wongben2333-crypto/26Embedded/README.md

# 基于 FPGA 的实时多音色合成电子乐器引擎「芯弦和鸣」

> **2026 全国大学生嵌入式芯片与系统设计竞赛 · FPGA 创新设计赛道 · 高云半导体 · 选题二**  
> **目标器件**：高云 Arora-V `GW5AST-LV138PG484AC1/I0`（`GW5AST-138C`，Sipeed Tang Mega 138K Dock）  
> **交付位流**：`MODE=3` 整机模式 · 50 MHz 单时钟域 · 纯 HDL · 无 CPU/PCM

> **当前口径（v8.2，2026-11-04）**：138K / MODE=3；TDM32 32×6=192 路（48 路仅对比基线）；钢琴/吉他/小提琴 3 音色；13 键硅胶轻触 + 6 光电 + 双 ToF + 7 寸触控；4 路 EC11 预留；PCB1 输入调理与隔离；整机 2 ms、芯片内部 ≤20.5 µs、TDM32 流水 3.85 µs；4 首公有领域曲目；32 峰必备、192 路由 RTL 状态阵列证明。

---

## 1. 项目概述

本项目的目标是在单颗高云 Arora-V 138K FPGA 上，用纯 HDL 构建一套**不依赖 CPU、不播放预录 PCM** 的实时多音色电子乐器。系统把 13 键硅胶轻触键盘、6 路光电拨弦、双路 ToF 手势与 7 寸电容触控接入统一单拍事件总线，由 **TDM32 引擎**在 97,656.25 Hz 采样网格上逐样本合成 **32 声部 × 6 泛音 = 192 路独立振荡器**，再经 8 模块硬件效果链与 PT8211 I2S DAC 输出。整机物理输入到模拟输出实测 **2 ms**，芯片内部 note event 到数字首样本上界 **20.5 µs**，TDM32 流水内部 **3.85 µs**。

全并行 8 声部 × 6 泛音 = 48 路引擎已验证并保留为低延迟对比基线；为达到 32 复音 192 路，交付位流采用 512 拍周期内 192 拍微时隙的 TDM32 架构：单套 DSP 与 BSRAM 状态表分时服务 32 个声部，避免宽加法树与高扇出分配器带来的布线瓶颈。音色统一为**钢琴 / 吉他 / 小提琴** 3 种，均由真实乐器录音频域反演得到泛音权重与琴体共振参数，在零音频样本 ROM 的前提下完成参数化重构。

---

## 2. 主要特性

- **192 路独立振荡器**：32 声部 × 6 泛音，每路独立 32 位相位累加器、独立频率字、独立 Q32 包络。
- **3 种音色**：钢琴、吉他、小提琴；42 行核心泛音表（TDM32 展开 120 行）+ 非谐性拉伸 + 琴体共振 + 击弦/拨弦瞬态。
- **超低确定性延迟**：整机 2 ms；芯片内部 512 相位全枚举上界 20.5 µs；TDM32 流水 3.85 µs。
- **8 模块硬件效果链**：4 路并联梳状 + 2 级全通 Freeverb、LFO 合唱、环形回声、过载/箱体模拟、双斜率软膝削波。
- **7 寸 800×480 仪器 UI**：3.0 秒双缓冲示波器、32 通道硬件 FFT、X-Y 李萨如、四页触控界面、虚拟琴键演奏。
- **必备取证模式**：`MODE=2` 输出 200 Hz～6,400 Hz 共 32 路等间隔独立谱峰；192 路由 RTL 状态阵列（`mem_ph` / `mem_inc` / `mem_env`）证明。
- **自研物理交互**：13 键硅胶轻触按钮 + 6 路 12V 光电 + 双路 ToF（A 主用/B 热备）+ 7 寸电容触控；4 路 EC11 仅预留，音量由触屏/上位机 CC7 控制。
- **纯硬件合规**：音频链路全部由 FPGA 逐样本生成；无软核/硬核 CPU 参与合成；无预录 PCM、无整段录音触发。

---

## 3. 系统架构

```text
13 键硅胶轻触 ─┐
6 路光电拨弦   ─┤
双路 ToF A/B   ─┼─► 单拍事件总线 ─► 一热声部分配（0 clk）
7 寸电容触控   ─┤                         │
UART / MIDI    ─┤                         ▼
Song ROM（4 首）┘              TDM32：32 声部 × 6 泛音 = 192 振荡器
                                          │
                         8 模块硬件效果链（Freeverb / Chorus / Echo / Cab）
                                          │
                           PT8211 I2S @ 97,656.25 Hz → 耳机 / 2×3W 功放
                                          │
                           7 寸 800×480 UI（示波 / FFT / 李萨如 / 曲目）
```

- 全芯片单一 50 MHz 同步时钟；`sample_tick = 50 MHz ÷ 512 = 97,656.25 Hz`。
- 音符事件采用单拍脉冲 + 数据保持，无 ACK 握手；装载状态机固定 14 拍。
- 模式切换采用“三道清音”：128 拍全关扫描 + `reset_all` 单拍清零 + 488 样本（5 ms）静音窗；防爆音位于 RTL 与 Dock 板载 `PA_EN`，不在自制 PCB 上实现。

---

## 4. 关键指标

| 项目 | 当前值 | 说明 / 证据 |
|---|---|---|
| 复音与振荡器 | **32 声部 × 6 泛音 = 192 路** | 对比基线 48 路；`piano_engine_tdm32.v` |
| 实际采样率 | **97,656.25 Hz** | 50 MHz ÷ 512；PT8211 I2S |
| 整机延迟 | **2 ms**（物理输入→模拟输出） | 示波器实测；含 1.31 ms 数字消抖 |
| 芯片内部延迟 | **≤20.5 µs** | 48 路对比基线 512 相位全枚举 |
| TDM32 流水 | **3.85 µs** | 192～195 clk 扫描/输出 |
| 音高精度 | A4 实测 **440.008 Hz**，-0.29 音分 | 16,384 点 FFT + 抛物线插值 |
| 硬件效果器 | 8 模块 | 4 梳状 + 2 全通 Freeverb、合唱、回声、箱体、软削波 |
| 仪器 UI | 7 寸 800×480 | 示波器 / 32 通道 FFT / 李萨如 / 曲目 |
| 核心资源（MODE=1 终版） | 31,728 LUT / 70 BSRAM / 104.5 DSP | 0 Setup / 0 Hold；WNS **+0.040 ns** |
| 整机资源（MODE=3） | 41,200 LUT / 125 BSRAM / 124.5 DSP | 综合/布局报告；最终 `.tr` 待归档 |
| 代码规模 | 45 个 RTL/头文件、23,012 行 | 含 UI 字库与歌曲头文件 |
| 验证规模 | 10 份 STA 报告、31 套仿真测试台 | 含 200 万例分配器等价性、10,242 点流水线比对 |
| 32 谱峰取证 | 数字域 32/32、0 杂散；真板 32/32 | `MODE=2` 位流 + 外部 FFT/声卡复核 |
| 交付曲目 | 4 首公有领域 | 欢乐颂 / 小星星 / 铃儿响叮当 / 致爱丽丝 |

> 延迟三层口径：**整机 2 ms** 用于赛题 ≤5 ms 判定；**20.5 µs** 为芯片内部数字域上界；**3.85 µs** 为 TDM32 流水内部，不作为整机总延迟。

---

## 5. 硬件方案

- **FPGA 平台**：Sipeed Tang Mega 138K Dock（`GW5AST-138C`）；音频沿用 Dock 板载 PT8211 与 3.5 mm/2×3W 输出，不在自制板上重复设计 DAC/重构滤波。
- **PCB1 输入调理与隔离板**（100×70×1.6 mm，2 层 FR-4）：
  - 13 键：220 Ω 串联 + 100 nF 对地 + FPGA 内部上拉；TS-1117 四脚轻触开关 + 硅胶键帽。
  - 6 路光电：12V 侧 1.2 kΩ 限流，副边 10 kΩ 上拉、220 Ω/100 nF，PC817 5 kVrms 隔离。
  - 双路 ToF：两条独立 I2C（A: A18/D15；B: F14/F13），4.7 kΩ 上拉 + 330 Ω 串联 + 100 µF/100 nF 本地储能。
  - 4 路 EC11：100 Ω / 10 kΩ / 100 nF，**预留**，本版不使用。
  - 电源与地：H3 3.3V 输入 + F1 0.5A PTC；GND12/GND 1.5 mm 隔离，R15 0 Ω 单点桥接。
- **机械结构**：两件式 PETG FDM 外壳；13 键双 Ø2.2 mm 导柱键床（白键 10.50 mm、中心距 11.50 mm）；双路 ToF 两段式导光筒（分件面 Z=22.124 mm、模块顶面以上净深 18.5 mm）。
- **7 寸屏**：ATK-MD0700 800×480，SSD1963 16-bit 8080 + GT911/FT5206 自适应触控；经 **34P FPC→J14 40P 排线**接入，不使用 P34-P40 转接板与 piano6 PCB。

---

## 6. 仓库结构

```text
26Embedded/
│
├── rtl/                         # 纯硬件 Verilog-2001 源码
│   ├── synth/                   # TDM32 192 路、DDS、ADSR、混音、song_rom
│   ├── ui/                      # 7 寸 SSD1963/GT911、FFT、李萨如、四页 UI
│   ├── audio/                   # PT8211 I2S 发送器
│   ├── io/                      # 13 键/6 光电/双 ToF/EC11、MIDI
│   └── effects/                 # Freeverb / Chorus / Echo / Cab / 软削波
│
├── constraints/                 # lcd_test_j14.cst/.sdc
├── bitstream/                   # lcd_test_j14.fs 交付位流
│
├── docs/
│   ├── technical_report/        # 技术文档_v8.2.docx/pdf、作品简介、图表说明
│   ├── evidence/                # 32 谱峰取证、样点、终端日志、2 ms 延迟截图
│   └── figures/                 # 14 张报告图表（仿真/实屏/终端截图）
│
├── hardware/
│   ├── pcb/                     # PCB1 Gerber/BOM/SCH
│   ├── adapter_board/           # 历史 P34-P40 屏幕转接板（归档，整机不使用）
│   └── enclosure/               # 两件式外壳 STEP/ZIP
│
├── tools/                       # 构建、烧录、截图、监测、32 峰校验
├── build_j14.py                 # 一键综合与布局布线
├── burn_lcd_j14.py              # SRAM 调试烧录
├── flash_lcd_j14.py             # SPI Flash 固化烧录
├── lcd_test_j14.gprj            # 高云 EDA 工程
└── README.md
```

---

## 7. 快速开始

### 7.1 环境

- 高云 **Gowin EDA V1.9.12.04**（含 `gw_sh.exe` 与 `programmer_cli.exe`）
- Python 3.8+（构建、烧录与取证脚本）
- Tang Mega 138K Dock + 自研 PCB1 + 7 寸屏 + 13 键/6 光电/双 ToF 外设

### 7.2 编译与烧录

```powershell
# 在仓库根目录
python build_j14.py
python burn_lcd_j14.py      # SRAM 调试
python flash_lcd_j14.py     # SPI Flash 固化
```

### 7.3 上位机

当前精简交付树不包含上位机源码；上位机为独立调试工具，串口参数为 `115200 bps，8N1`，只下发音符/CC 报文，不参与音频合成。板载 13 键/6 光电/双 ToF/触控可脱离上位机独立演奏。

### 7.4 运行模式

| 模式 | 用途 | 说明 |
|---|---|---|
| `MODE=3` | **整机交付** | TDM32 192 路 + 8 模块效果器 + 7 寸 UI + 13 键/6 光电/双 ToF |
| `MODE=1` | PC 控制/回归 | 48 路全并行对比基线 + UART/MIDI |
| `MODE=2` | 32 谱峰取证 | `tone_bank` + `adsr`，200 Hz～6,400 Hz 等间隔 32 峰 |
| `MODE=0` | 脱机放歌 | 4 首公有领域曲目自动播放 |

### 7.5 谱峰取证

```powershell
python tools/verify/check_peaks.py --file docs/evidence/tone_samples_snap.txt --format samples --fs 97656.25 --count 32 --start 200 --step 200
```

---

## 8. 验证与证据

- **32 谱峰**：`MODE=2` 数字样本 32/32 命中、0 杂散；真板录音 32/32 命中，并完成 PT8211 ZOH 镜像与 48 kHz 声卡混叠机理拆解。
- **确定性延迟**：48 路对比基线 512 相位全枚举，Min 516 clk / P50 772 clk / P99 1,021 clk / Max 1,027 clk；整机 2 ms 示波器实测，终端取证见 `docs/evidence/延迟测试_2ms端到端.png`。
- **时序收敛**：10 份归档 `.tr/.rpt`；MODE=1 核心终版 0 Setup / 0 Hold，WNS +0.040 ns；pipeline 构建 +0.186 ns。
- **形式化/回归**：200 万例一热分配器等价性；10,242 点输出级流水线逐值比对；31 套测试台。
- **证据位置**：`docs/evidence/`、`docs/figures/`、`docs/technical_report/技术文档图表与实验数据说明.md`。

---

## 9. 文档索引

| 文档 | 内容 |
|---|---|
| [`docs/technical_report/技术文档_v8.2.docx`](docs/technical_report/技术文档_v8.2.docx) | **交付版技术文档（v8.2，62 页，模板对齐与统一排版）** |
| [`docs/technical_report/技术文档_v8.2.pdf`](docs/technical_report/技术文档_v8.2.pdf) | 同版 PDF 校对稿 |
| [`docs/technical_report/作品简介.md`](docs/technical_report/作品简介.md) | 作品简介与答辩口径 |
| [`docs/technical_report/技术文档图表与实验数据说明.md`](docs/technical_report/技术文档图表与实验数据说明.md) | 图表、延迟分解与谱峰数据说明 |
| [`docs/evidence/32谱峰-取证报告.md`](docs/evidence/32谱峰-取证报告.md) | 32 峰取证方法与历史数据 |
| [`docs/evidence/实测终端数据日志.txt`](docs/evidence/实测终端数据日志.txt) | 实测终端日志 |
| [`docs/evidence/延迟测试_2ms端到端.png`](docs/evidence/延迟测试_2ms端到端.png) | 2 ms 端到端延迟终端取证 |
| [`hardware/pcb/`](hardware/pcb/) | PCB1 Gerber、BOM、原理图 |
| [`hardware/enclosure/`](hardware/enclosure/) | 两件式外壳 STEP/ZIP |
| [`bitstream/lcd_test_j14.fs`](bitstream/lcd_test_j14.fs) | 交付位流 |

> `docs/technical_report/技术文档_v8.docx` 为上一版历史稿；提交以 `技术文档_v8.2.docx` 为准。历史文档中的旧曲目/旧口径仅作记录，不得进入提交物。

---

## 10. 当前状态与已知缺口

- **文档与整机口径**：已收口到 v8.2；主文档、硬件文档与历史稿标记均已同步。
- **待补证据**：整机 2 ms 已有终端截图/日志；示波器 CSV 可按需补充；MODE=3 最终 `.fs` 的 SHA256/User Code 与 `.rpt/.tr` 待归档。
- **源码待清理**：`rtl/synth/song_rom.v` 仍含旧版第 0 首未授权曲目；文档已按 4 首公有领域口径编写，需删除并重生成/重编译。
- **192 峰测试**：当前以 32 峰作为赛题必备取证，192 路由 RTL 状态阵列证明；如需把评分乘数从 32 提升到 192，可后续补 192 峰测试位流。
- **目录页码**：v8.2 的 TOC 已重建并更新页码；修改内容后按 `Ctrl+A` → `F9` 更新域。

---

## 11. 合规与版权

- **纯硬件实时合成**：完整音频通路由 FPGA HDL 逐样本实现，无 CPU/软核参与合成算法。
- **零预录 PCM**：全工程无音频样本 ROM；`piano_rom.v` 存泛音/波表参数，`song_rom.v` 存音符事件，均不是录音。
- **曲目**：交付版为 4 首公有领域曲目（欢乐颂 / 小星星 / 铃儿响叮当 / 致爱丽丝）；频谱标定用参考录音仅离线分析，未写入 RTL。
- **第三方**：Gowin EDA、Sipeed Tang Mega、PT8211、ATK-MD0700、GT911/FT5206、VB22B、E3F-20C1、PC817 等器件与工具链版权归各自厂商所有。
