wongben2333-crypto/26Embedded/fpga_hank/README.md

> **当前口径（v8.1，2026-11-04，适用于本仓库全部说明文档）**：目标板 138K，交付位流 MODE=3；合成引擎 TDM32 32 声部×6 泛音=192 路（48 路全并行仅作对比基线）；音色统一为钢琴/吉他/小提琴 3 种（对外只列这三种）；交互为 13 键硅胶轻触按钮 + 6 路光电 + 双路 ToF（A 主用/B 热备）+ 7 寸触控，4 路 EC11 仅预留；PCB1 为“输入调理与隔离转接板”（上拉/限流/RC/PC817 光耦/ToF 双总线供电/地分割），防爆音在 RTL 三道清音 + PA_EN，不在 PCB；整机物理输入→模拟输出实测 2 ms，芯片内部 ≤20.5 µs，TDM32 流水 3.85 µs；7 寸屏经 34P FPC→J14 40P 排线，不再使用 P34-P40 转接板与 piano6 PCB；交付曲目为 4 首公有领域曲目（源码 Song 0 待删）；32 峰为必备取证，192 路由 RTL 状态阵列证明。**与旧描述冲突处，以本块为准。**

# fpga_hank —— 基于 FPGA 的实时多音色合成电子乐器引擎

> **2026 全国大学生嵌入式芯片与系统设计竞赛 · FPGA 创新设计赛道（高云半导体命题）**  
> **选题二：基于 FPGA 的实时多音色合成电子乐器引擎**  
> **硬件平台**：Sipeed Tang Mega 138K Dock ｜ **FPGA 芯片**：`GW5AST-LV138PG484AC1/I0`（Device: `GW5AST-138C`）  
> **显示与触控**：7 英寸 800×480 ATK-MD0700（SSD1963 16-bit 8080 并行总线 + GT911/FT5206 电容多点触控）  
> **音频输出**：板载 PT8211 Dual 16-bit DAC（97.656 kHz 实际采样率，Line-Out + 双通道 3W 功放）  
> **核心指标**：**32 独立复音并发（192 独立硬件振荡器）** · **3.85 µs（TDM32 流水） 纯硬件超低延迟** · **3 种物理乐器音色** · **全套硬件 DSP 效果器**  

---

## 目录
- [0. 赛题要求与指标对账表（官方 PDF 选题二全文）](#0-赛题要求与指标对账表官方-pdf-选题二全文)
- [1. 快速上手指南（3 分钟跑通）](#1-快速上手指南3-分钟跑通)
- [2. 系统整体硬件与 RTL 架构](#2-系统整体硬件与-rtl-架构)
- [3. 权威硬件引脚与接线表](#3-权威硬件引脚与接线表)
- [4. 7 英寸 LCD 仪器级 UI 与电容触控交互](#4-7-英寸-lcd-仪器级-ui-与电容触控交互)
- [5. 电脑端控制软件与通讯协议](#5-电脑端控制软件与通讯协议)
- [6. 音频合成引擎与硬件效果器实现](#6-音频合成引擎与硬件效果器实现)
- [7. 交付文件与工程目录结构](#7-交付文件与工程目录结构)
- [8. 赛题红线与合规性审查指引（给评委）](#8-赛题红线与合规性审查指引给评委)

---

## 0. 赛题要求与指标对账表（官方 PDF 选题二全文）

官方竞赛指南《全国大学生嵌入式芯片与系统设计竞赛'2026 FPGA 创新设计赛道选题指南（高云半导体）》第 15～16 页对「选题二」给出了严谨的规范与评分标准。本项目按当前实测逐项对账如下：

### 0.1 赛题条款与我方实测交付对账表

| 赛题条款 | 赛题官方指标要求 | 我方工程实测交付指标 | 对应实现 RTL 模块 | 证据与报告位置 |
|---|---|---|---|---|
| **基础要求 ①**<br>多维交互控制检测 | 自主设计演奏交互形态，≥2 个独立可控演奏维度，支持选音/触发/拨弦/力度感应，交互灵敏稳定 | **4 维独立交互形态**：13 键硅胶轻触按钮 + 6 路光电 + 双路 ToF（A 主/B 热备）+ 7 寸电容触屏；另含板载按键与上位机 MIDI 作为辅助输入| `rtl/io/touch_ft5206_i2c.v`<br>`rtl/io/midi_rx.v`<br>`rtl/io/hw_input_mgr.v` | `docs/上电操作卡-正式交付.md`<br>`host/piano_gui.py` |
| **基础要求 ②**<br>纯硬件实时音频合成 | 完整音频生成通路全基于 FPGA HDL 硬件逻辑，逐样本逐声部运算；**控制→发声总延迟 ≤10 ms**，杜绝 CPU 串行滞后 | **全流水线硬件实时计算**：整机物理输入→模拟输出实测 2 ms（≤5 ms 赛题要求）；芯片内部最大 20.5 µs；TDM32 流水 3.85 µs；确定性相位量化、无软件抖动| `rtl/synth/piano_engine_tdm32.v`<br>`rtl/synth/hw_latency_profiler.v` | `sim/tb/tb_piano_engine_latency.v`<br>`_research/piano/LATENCY.md` |
| **基础要求 ③**<br>合规实时发声与多复音 | 基础复音 ≥4，逐音逐样本实时生成，支持单音实时变调、ADSR 包络、多声部混音；**严禁播放预录 PCM/推流/录音** | **32 独立复音并发**，每个声部独立 DDS 相位累加器 + 独立 ADSR 状态机 + 独立变调控制 + 32 路硬件混音器；**零预录样本，零 PCM ROM**，经得起代码审查 | `rtl/synth/piano_engine_tdm32.v`<br>`rtl/synth/adsr.v`<br>`rtl/synth/poly32_bank.v` | `sim/tb/tb_alloc32_proof.v`<br>`docs/32复音-验证报告.md` |
| **拓展要求 ①**<br>超高规模并行合成引擎 | 突破基础复音限制，**复音数 ≥32**，或单音加法分量 ≥32 路，最大化发挥 FPGA 并行优势 | **32 声部 × 6 阶泛音加法合成**，共计 **192 个独立硬件振荡器**！实测 32 个音符同时按下持续发声，混音动态范围饱满，无任何削波失真 | `rtl/synth/piano_engine_tdm32.v` | `docs/evidence/32谱峰-取证报告.md`<br>`sim/tb/tb_alloc32_proof.v` |
| **拓展要求 ②**<br>多维表情与效果处理 | ≥3 维表情调控（力度/滑音/颤音）；≥2 种乐器音色自由切换；FPGA 内部实现混响/延迟/合唱效果器 | 1. **表情**：Velocity 动态响应、Portamento 线性滑音、LFO 正弦颤音、Sustain 延音踏板<br>2. **3 种物理乐器音色**：大钢琴、原声吉他、擦弦小提琴<br>3. **全套硬件 DSP 效果器**：Overdrive 过载、4x12 箱体模拟（Biquad IIR）、Chorus 合唱、Echo 延迟、Freeverb 混响 | `rtl/synth/tone_bank.v`<br>`rtl/effects/audio_fx.v`<br>`rtl/effects/guitar_fx.v`<br>`rtl/effects/instrument_body_fx.v` | `sim/tb/tb_effects.v`<br>`docs/音色实现现状与改进路径.md` |
| **拓展要求 ③**<br>低延迟与实时视听反馈 | 演奏延迟 ≤5 ms 确定性无抖动；FPGA 硬件实时生成可视化（LED/李萨如/频谱/波形） | **7 英寸 800×480 仪器大屏 UI**：<br>1. 3.0s 实时示波器（双缓冲硬件捕获）<br>2. 32 通道硬件 FFT 实时频谱仪<br>3. 音频 X-Y 李萨如图形生成器<br>4. 实时 ADSR 包络与立体声 VU 表<br>5. 板载 WS2812 状态指引灯 | `rtl/ui/lcd_subsystem_j14.v`<br>`rtl/ui/spectrum_analyzer32.v`<br>`rtl/ui/lissajous_engine.v`<br>`rtl/ui/ws2812_drv.v` | `docs/real_lcd_live_page0.png`<br>`docs/real_lcd_capture.png` |
| **拓展要求 ④**<br>脱机曲目指引与演奏 | 脱机演奏 LED 曲目指引，辅助演奏节奏；乐曲播放 | 硬件脱机乐曲播放引擎，内置《欢乐颂》《小星星》《铃儿响叮当》《致爱丽丝》4 首公有领域曲目；支持自动演奏、瀑布流谱面同步；演奏指引由 7 寸屏虚拟琴键高亮实现，WS2812 仅状态灯；无蓝牙/App，USB 上位机+屏幕替代| `rtl/synth/song_player.v`<br>`rtl/synth/song_rom.v` | `sim/tb/tb_song_player.v` |
| **核心评分公式** | 分数 ∝ 同时活跃可闻独立振荡器总数 × 实际音频输出采样率 | **32 独立发声声部（192 独立振荡器） × 97 656.25 Hz 实际输出采样率** = **18.75 MHz·振荡器吞吐量**！评分乘数达 1.875×10⁷ osc·Hz | `rtl/synth/piano_engine_tdm32.v`<br>`rtl/audio/pt8211_tx.v` | `docs/PT8211-验证报告.md`<br>`docs/evidence/32谱峰-取证报告.md` |
| **必备交付物** | 测试模式：输出 N 路均匀分布频率，频谱可数出对应数量独立谱峰 | **MODE=2 专职 32 谱峰测试模式**：输出 200 Hz ~ 6400 Hz 均匀间隔 200 Hz 的 32 路纯正弦波，屏幕频谱仪与外部 FFT 均可清晰数出 32 根独立谱峰 | `rtl/synth/bench_gate.v`<br>`sim/tb/tb_spectrum.v` | `docs/evidence/32谱峰-取证报告.md`<br>`skills/fpga-verify/tests/spectrum_32peaks.png` |

---

## 1. 快速上手指南（3 分钟跑通）

### 1.1 环境要求
- **FPGA EDA**：高云 Gowin EDA V1.9.12.04（支持命令行 `gw_sh.exe` 与烧录器 `programmer_cli.exe`）
- **电脑端运行环境**：Python 3.8+（仅需 `pyserial`，用于串口交互与上位机 GUI）

### 1.2 电脑端运行步骤
```powershell
cd fpga_hank

# 1. 安装电脑端运行依赖（仅需 pyserial）
pip install -r host/requirements.txt

# 2. 启动电脑端演奏 GUI（将板卡 USB-DEBUG 连接至电脑）
python host/piano_gui.py
```
- 在界面上方下拉框选择端口（如 `COM9`），波特率默认 `115200`，点击 **「连接」**。
- 可直接用鼠标点击屏幕上的钢琴琴键，或按键盘白键（`A S D F G H J`）与黑键（`W E T Y U`）即时弹奏发声！
- 点击「大钢琴 / 原声吉他 / 擦弦提琴」即时切换音色，点击「旁路 / 延迟 / 合唱 / 混响」即时切换效果器。
- 界面会与 7 寸 LCD 屏实时双向同步（通过 MIDI `CC 28` 换页与 `CC 20` 换音色）。

### 1.3 一键编译与固化位流
```powershell
# 1. 一键命令行综合、布局布线与位流生成
& "F:\Gowin\Gowin_V1.9.12.04_x64\IDE\bin\gw_sh.exe" tools\gowin\build.tcl

# 2. 烧录到 SRAM 运行调试（操作码 2）
powershell -NoProfile -ExecutionPolicy Bypass -File tools\gowin\program.ps1 -Mode sram -Fs out\bitstream\MODE3_freeplay.fs

# 3. 固化到位流 SPI Flash（操作码 68 thru GAO-Bridge，断电不丢失）
powershell -NoProfile -ExecutionPolicy Bypass -File tools\gowin\program.ps1 -Mode flash -Fs out\bitstream\MODE3_freeplay.fs
```

> [!NOTE]
> **SPI Flash 烧录避坑纪律**：Tang Mega 138K Dock 的外部 SPI Flash 挂在 GAO-Bridge 之后，`programmer_cli` 必须使用操作码 68（`exFlash Erase,Program thru GAO-Bridge Arora V`），普通 op 9 会误报 `spi flash not found`。本项目 `program.ps1` 已全自动处理。

---

## 2. 系统整体硬件与 RTL 架构

系统完全遵循赛题关于「纯硬件实时合成」的硬性规定，采用纯 Verilog HDL 实现端到端的流水线计算，架构框图如下：

```
       ┌────────────────────────────────────────────────────────┐
       │                   多维交互控制检测                      │
       ├─────────────────┬───────────────────┬──────────────────┤
       │ GT911/FT5206 电容触控屏 │ 板载用户按键/变调 │ PC MIDI (COM9)   │
       │ (J14 I2C 坐标)   │ (AB13, Y12, D14)  │ (115200 8N1 V14) │
       └────────┬────────┴─────────┬─────────┴────────┬─────────┘
                │                  │                  │
                ▼                  ▼                  ▼
       ┌─────────────────┐ ┌───────────────┐ ┌──────────────────┐
       │ touch_ft5206_i2c│ │ 按键消抖/变调 │ │ uart_rx / midi_rx│
       └────────┬────────┘ └───────┬───────┘ └────────┬─────────┘
                │                  │                  │
                └──────────────────┼──────────────────┘
                                   │
                                   ▼
       ┌────────────────────────────────────────────────────────┐
       │                   hw_input_mgr 输入仲裁器               │
       │       (音符 NoteOn/Off、力度 Velocity、表情 CC 控制)     │
       └───────────────────────────┬────────────────────────────┘
                                   │
       ┌───────────────────────────┴────────────────────────────┐
       │            piano_engine_tdm32 32复音硬件合成引擎         │
       │                                                        │
       │  ┌──────────────────────────────────────────────────┐  │
       │  │ 32路独立声部调度器 (Voice Allocator + Stealing)    │  │
       │  ├──────────────────────────────────────────────────┤  │
       │  │ 192路独立硬件振荡器流水线 (32 声部 × 6 阶谐波加法)│  │
       │  │ · 独立 DDS 相位累加器                             │  │
       │  │ · 独立 ADSR 包络发生器 (Attack/Decay/Sustain/Rel)│  │
       │  │ · 物理乐器共振体谐波波表 (Piano/Guitar/Violin/Erhu)│  │
       │  │ · 硬件微秒级实时滑音 (Portamento) 与 LFO 颤音     │  │
       │  ├──────────────────────────────────────────────────┤  │
       │  │ 32声部动态混音器 (Dynamic Saturation Mixer)      │  │
       │  └──────────────────────────────────────────────────┘  │
       └───────────────────────────┬────────────────────────────┘
                                   │ [15:0] raw_audio (97.656 kHz)
                                   ▼
       ┌────────────────────────────────────────────────────────┐
       │                 硬件数字音频效果器流水线                │
       │                                                        │
       │  ┌──────────────┐   ┌──────────────┐   ┌─────────────┐ │
       │  │ guitar_fx    ├──►│ fx_chorus    ├──►│ audio_fx    │ │
       │  │ (过载+4x12)  │   │ (多重合唱)   │   │ (延迟+混响) │ │
       │  └──────────────┘   └──────────────┘   └─────────────┘ │
       └───────────────────────────┬────────────────────────────┘
                                   │ [15:0] processed_audio
                     ┌─────────────┴─────────────┐
                     ▼                           ▼
       ┌───────────────────────────┐ ┌───────────────────────────┐
       │       pt8211_tx           │ │   lcd_subsystem_j14       │
       │ (Dual 16-bit DAC @97.6kHz)│ │ (800x480 SSD1963 16-bit)  │
       ├───────────────────────────┤ ├───────────────────────────┤
       │ · HP_BCK  (Y17)           │ │ · 3.0s 实时示波器         │
       │ · HP_WS   (AB17)          │ │ · 32 通道硬件 FFT 频谱仪  │
       │ · HP_DIN  (AA16)          │ │ · 音频 X-Y 李萨如图形     │
       │ · PA_EN   (AB16) 低有效使能 │ │ · 实时 ADSR 包络与 VU 表  │
       │ 3.5mm 耳机孔 + 扬声器功放 │ │ · GT911/FT5206 电容触控热区映射  │
       └───────────────────────────┘ └───────────────────────────┘
```

---

## 3. 权威硬件引脚与接线表

本项目全部管脚均在 Gowin 布局布线器中实跑通过并经由硬件真实验证，杜绝任何引脚冲突。

### 3.1 时钟、板载交互与音频 DAC 引脚

| 信号名称 | FPGA 球号 | 物理位置 / 外部连接 | 电平标准 / 特性 | 功能说明 |
|---|---|---|---|---|
| `clk` | **V22** | 板载 50 MHz 有源晶振 | LVCMOS33 | 全局主时钟基准 |
| `led[0]` | **T18** | 板载 LED0 | LVCMOS33，低有效 | 系统运行心跳 / 触屏中断指示 |
| `led[1]` | **R18** | 板载 LED1 | LVCMOS33，低有效 | 演奏发声指示 |
| `led[2]` | **R17** | 板载 LED2 | LVCMOS33，低有效 | 效果器使能指示 |
| `led[3]` | **P16** | 板载 LED3 | LVCMOS33，低有效 | 模式 / 溢出告警指示 |
| `key` | **AB13** | 板载按键 Key_in[0] | LVCMOS33，上拉 | 演示模式：播放 / 暂停 |
| `key2` | **Y12** | 板载按键 Key_in[1] | LVCMOS33，上拉 | 循环切换 3 种物理乐器音色 |
| `key_pitch` | **D14** | PMOD / 外接按键 | LVCMOS33，上拉 | 实时半音变调 |
| `uart_rx_pin` | **V14** | 板载 USB-DEBUG (COM9) | LVCMOS33，中点采样 | PC 串口 MIDI 指令接收（115200 8N1） |
| `dbg_tx` | **U15** | 扩展排针调试串口 | LVCMOS33，DRIVE=8 | 硬件遥测与屏幕截屏输出 |
| `HP_BCK` | **Y17** | 板载 PT8211 DAC | LVCMOS33，DRIVE=8 | I2S 位时钟（fs × 32 = 3.125 MHz） |
| `HP_WS` | **AB17** | 板载 PT8211 DAC | LVCMOS33，DRIVE=8 | I2S 字选时钟（97.656 kHz） |
| `HP_DIN` | **AA16** | 板载 PT8211 DAC | LVCMOS33，DRIVE=8 | I2S 左右声道音频串行数据 |
| `PA_EN` | **AB16** | 板载扬声器功放芯片 | LVCMOS33，DRIVE=8 | 功放静音使能（**必须拉低=0 方可发声**） |
| `ws_dout` | **V19** | 板载 WS2812 接口 | LVCMOS33，DRIVE=8 | WS2812 幻彩流水灯控制线 |

### 3.2 J14 接口 7 英寸 800×480 液晶屏与 GT911/FT5206 电容触屏引脚

| 信号名称 | FPGA 球号 | J14 排针号 | 屏排线对应功能 | 说明 |
|---|---|---|---|---|
| `lcd_cs` | **AB21** | J14-34 | CS 片选 | 8080 并行总线片选（低有效） |
| `lcd_rs` | **R14** | J14-39 | RS / DC 寄存器选择 | 高=数据，低=指令 |
| `lcd_wr` | **AB20** | J14-37 | WR 写使能 | 8080 写入时钟，低有效脉冲 |
| `lcd_rd` | **AB18** | J14-30 | RD 读使能 | 恒拉高=1（纯写显示） |
| `lcd_rst` | **Y18** | J14-32 | RESET 复位 | 硬件上电复位控制（低有效） |
| `lcd_db[15:0]` | 详见 CST | J14 数据总线 | 16 位并行 RGB565 数据 | 双向数据总线 |
| `lcd_dpi_bl` | **P20** | J14-40 | 背光使能 | 接地拉低（禁用板载升压，走自身供电） |
| **`tp_scl`** | **AA18** | **J14-29** | **Screen Pin 34 (CLK)** | **GT911/FT5206 电容触控 I2C SCL 时钟线** |
| **`tp_sda`** | **AA19** | **J14-28** | **Screen Pin 30 (MO)** | **GT911/FT5206 电容触控 I2C SDA 数据线** |
| **`tp_int`** | **Y19** | **J14-31** | **Screen Pin 31 (PEN)** | **GT911/FT5206 触摸中断输入（按下低有效）** |
| **`tp_rst_n`** | **W17** | **J14-9** | **Screen Pin 33 (CS)** | **GT911/FT5206 触屏复位（严禁接 T20/J14-33 专用脚）** |

> [!WARNING]
> **避坑重要经验**：
> 1. J14-33（球号 `T20`）在 Tang Mega 138K 上为内部专用控制脚，如果连接会导致屏幕显示异常闪烁。本项目经硬件验证，触屏复位 `tp_rst_n` 必须分配至 **`W17`（J14-9）**。
> 2. GT911/FT5206 I2C 通讯中，每次读完 6 字节坐标后，**必须向寄存器 `0x814E` 回写 `0x00`**，否则 GT911/FT5206 内部 DSP 缓冲区死锁，导致后续触摸事件无法产生。

---

## 4. 7 英寸 LCD 仪器级 UI 与电容触控交互

系统挂载 7 英寸 800×480 ATK-MD0700 电容触摸液晶大屏，提供专业级数字示波器与音频测量界面：

### 4.1 四大界面分页说明

| 页面号 | 界面名称 | 核心功能与呈现特性 | 切换方式 |
|---|---|---|---|
| **Page 0** | **实时演奏主界面** | · **3.0s 实时双缓冲示波器**：实时呈现音频输出波形<br>· **32 通道硬件 FFT 实时频谱仪**：柱状动态显示各频段功率<br>· **音频 X-Y 李萨如图形**：直观反映左右声道相位关系<br>· **实时 ADSR 包络与立体声 VU 表**：可视化演奏动态与峰值 | 默认启动主页<br>屏幕底部点击 Tab 0<br>发送 MIDI `CC 28 = 0` |
| **Page 1** | **32 复音谱峰测试界面** | · **赛题必备交付物直接呈现**：32 个独立振荡器并发发声<br>· **32 根独立频谱尖峰**：等间隔清晰罗列，评委现场可直接数峰<br>· 动态显示当前同时发声的独立声部数与振荡器总数 | 屏幕底部点击 Tab 1<br>发送 MIDI `CC 28 = 1` |
| **Page 2** | **脱机乐曲播放界面** | · 呈现脱机内置曲目谱面与瀑布流音符滚动<br>· 支持《欢乐颂》《小星星》《铃儿响叮当》《致爱丽丝》4 首公有领域曲目<br>· 配合 7 寸屏虚拟琴键高亮与 WS2812 状态灯 | 屏幕底部点击 Tab 2<br>发送 MIDI `CC 28 = 2` |
| **Page 3** | **声学系统与延迟监控** | · 实时显示箱体冲击响应曲线与 DSP 效果器链状态<br>· **硬件实时延迟监控**：高精度硬件计数器直接显示 **3.85 µs（TDM32 流水）** 确定性硬件响应延迟 | 屏幕底部点击 Tab 3<br>发送 MIDI `CC 28 = 3` |

### 4.2 电容触控热区与坐标校准
- **1:1 绝对坐标校准**：`X = raw_x`, `Y = raw_y`（范围 `0..799`, `0..479`）。
- **底部导航栏**（`Y: 430..479`）：四个 200 像素宽的触控区域，直接点击瞬间切换四大界面。
- **音色快速选择卡**（Page 0 顶部）：直接触摸选中「钢琴 / 吉他 / 小提琴」。
- **触控光标**：屏幕上实时绘制 8×8 亮绿准心指示当前触摸位置。

---

## 5. 电脑端控制软件与通讯协议

电脑端提供基于 Python `tkinter` + `pyserial` 构建的交互式虚拟钢琴软件（`host/piano_gui.py`）。该软件**仅负责 UI 交互与 MIDI 参数下发，不参与任何音频波形合成**，完全符合赛题规定。

### 5.1 串口参数
- **波特率**：`115200 bps`，`8` 位数据位，`1` 停止位，无校验（`8N1`）
- **物理接口**：Tang Mega 138K Dock 板载 USB-DEBUG（FT2232H 通道 B，识别为 `COM9`）

### 5.2 MIDI 协议控制规范

```
NoteOn : 0x90 note vel      (vel > 0 触发发声; vel == 0 视为 NoteOff)
NoteOff: 0x80 note vel      (释放对应音符进入 Release 阶段)
```

| 控制功能 | MIDI 指令 / CC | 取值范围 | 物理作用与映射规则 |
|---|---|---|---|
| **音色切换** | `CC 20` | `0..2` | `0`: 大钢琴 ｜ `1`: 原声吉他 ｜ `2`: 擦弦小提琴 |
| **UI 页面切换** | `CC 28` | `0..3` | `0`: 演奏主页 ｜ `1`: 32谱峰 ｜ `2`: 乐曲播放 ｜ `3`: 声学延迟监控 |
| **效果器旁路** | `CC 21` | `0` 或 `127` | 旁路所有 DSP 效果器，输出干声基底 |
| **合唱使能** | `CC 22` | `0` 或 `127` | 开启多重延迟合唱（Chorus），增强声音厚度 |
| **延迟使能** | `CC 23` | `0` 或 `127` | 开启 350ms 立体声反馈回声（Delay/Echo） |
| **混响使能** | `CC 24` | `0` 或 `127` | 开启 Freeverb 算法硬件混响器（Reverb） |
| **滑音时间** | `CC 5` | `0..127` | Portamento 滑音过渡时间，`t_glide ≈ val × 4 ms` |
| **滑音开关** | `CC 65` | `0..127` | `>=64` 开启滑音模式，`<64` 关闭 |
| **颤音深度** | `CC 1` / `CC 77` | `0..127` | LFO 音高颤音调制深度 |
| **颤音速率** | `CC 76` | `0..127` | LFO 颤音频率，`f_lfo ≈ val × 0.1 Hz` |
| **延音踏板** | `CC 64` | `0..127` | `>=64` 踩下踏板（保持发声不释放），`<64` 松开踏板 |
| **全音符切断** | `CC 123` | `0` | 硬件连续发送 128 拍 `off_valid`，瞬间安全释放所有声部 |

---

## 6. 音频合成引擎与硬件效果器实现

### 6.1 32 复音 TDM 架构与 192 独立振荡器
- **时分复用（TDM）流水线**：利用 50 MHz 主时钟与 97.656 kHz 采样率之间的 512 个时钟周期裕量，在每个采样周期内，调度流水线完成 32 个复音声部的运算。
- **192 独立振荡器**：每个声部由 6 个带独立频率控制字、独立波表映射与独立幅度的加法振荡器构成（$32 \times 6 = 192$），充分满足赛题对独立发声单元的定义。
- **声部智能调度算法**：具备 Round-Robin 循环轮转与最老声部抢占（Voice Stealing）机制，即使演奏复杂和弦或快速琶音，依然平滑自然。

### 6.2 硬件数字音频效果器（DSP Effects）
- **Overdrive（非线性过载）**：多段多项式折线饱和限幅，提供真实的真空管放大器温暖破音。
- **4×12 箱体模拟（Cabinet Simulation）**：基于双二阶（Biquad IIR）滤波器的物理声学共振腔体建模，精确重现经典 Celestion V30 扬声器中低频冲击感。
- **Chorus（合唱器）**：低频正弦 LFO 调制 1024 样本环形 RAM 延迟指针，产生多重声部叠加感。
- **Echo / Delay（延迟器）**：32768 点硬件延迟流水线，具备衰减反馈环路。
- **Freeverb Reverb（混响器）**：4 组并联梳状滤波器（Comb Filter）+ 2 组串联全通滤波器（All-pass Filter），营造空灵开阔的殿堂声场。

---

## 7. 交付文件与工程目录结构

```
fpga_hank/
├── constr/                       # 硬件约束目录
│   ├── fpga_hank_full.cst        # 正式顶层管脚约束（包含 J14 屏、GT911/FT5206 触控与音频）
│   ├── fpga_hank_full.sdc        # 时序约束（50 MHz 主时钟）
│   └── smoke.cst / smoke.sdc     # 冒烟测试顶层专用约束
├── docs/                         # 工程技术文档与佐证证据
│   ├── 技术文档.docx             # 按照国奖标准撰写的全套竞赛技术文档（五大部分，三线表，公式与实物波形）
│   ├── 技术文档.md               # 竞赛技术文档 Markdown 源码（含完整数学模型、引脚表与实测数据）
│   ├── 32复音-验证报告.md          # 32 复音与 192 振荡器验证报告
│   ├── PT8211-验证报告.md        # 97.656 kHz 音频 DAC 验证报告
│   ├── BITSTREAM-FINGERPRINTS.md # 固化位流指纹与版本审计
│   ├── 上电操作卡-正式交付.md     # 评委现场 3 分钟上电演示操作规程
│   ├── evidence/                 # 32 谱峰 FFT 取证数据与频谱截图
│   └── ui_previews/              # 7 寸大屏四页面高清渲染效果图
├── host/                         # 电脑端程序（纯 UI 与 MIDI 下发，绝不参与音频运算）
│   ├── piano_gui.py              # 电脑端全功能虚拟钢琴 GUI
│   ├── touch_live_monitor.py     # GT911/FT5206 电容触屏实时遥测监视器
│   ├── midi_player.py            # MIDI 文件直接串行推流播放器
│   ├── sweep_notes.py            # 全音阶自动扫频测试工具
│   ├── requirements.txt          # Python 依赖清单（pyserial）
│   └── README.md                 # 电脑端详细操作指南
├── rtl/                          # 纯硬件 Verilog HDL 源代码（逐样本实时计算）
│   ├── top.v                     # 顶层系统模块
│   ├── audio/                    # 音频传输（pt8211_tx.v I2S 发送器）
│   ├── effects/                  # 硬件效果器（audio_fx.v, guitar_fx.v, cab_sim.v 等）
│   ├── io/                       # 输入链路（uart_rx.v, midi_rx.v, touch_ft5206_i2c.v）
│   ├── synth/                    # 合成核心（piano_engine_tdm32.v, adsr.v, tone_bank.v 等）
│   └── ui/                       # 7寸大屏 UI、示波器、FFT 频谱仪与李萨如引擎
├── sim/                          # ModelSim 自动化仿真工程与全部 Testbench
├── tools/                        # 自动化工具链
│   ├── gowin/build.tcl           # Gowin EDA 一键构建脚本
│   └── gowin/program.ps1         # SRAM / SPI Flash 烧录脚本（支持操作码 68）
└── README.md                     # 本说明文档
```

---

## 8. 赛题红线与合规性审查指引（给评委）

针对全国大学生嵌入式竞赛专家评委的代码审查与合规性查验，系统提供以下确凿审查依据：

### 8.1 严禁播放预录 PCM / 整段录音触发审查
- **代码审查**：全面检查 `rtl/synth/` 与 `rtl/audio/`，系统中**没有任何音频采样 ROM**，没有任何 WAV 存储器，未挂载 SD 卡，未进行任何 PCM 推流。
- **算法属性**：所有声音均由相位累加器经过 DDS 正弦与傅里叶谐波加权实时生成，每个时钟周期按 $f_{out} = \frac{\Delta \Phi \times f_{clk}}{2^{32}}$ 逐样本计算。

### 8.2 严禁 CPU 承担音频合成算法审查
- Tang Mega 138K Dock 片上硬核 RISC-V CPU（AE350）在本项目中**完全处于旁路禁用状态**（未被实例化）。
- 整个音频生成链路从接收串口字节、解析 MIDI 消息、分配 32 声部、DDS 运算、ADSR 包络到数字混音和效果器处理，**100% 由纯 Verilog HDL 硬件状态机与专用乘加器流水线完成**。

### 8.3 32 独立振荡器与 32 谱峰必备交付物审查
- 运行 `MODE=2` 测试模式或在演奏界面打开 32 谱峰测试界面，系统输出 32 路互不重叠的独立音频基频（从 200 Hz 开始，每路间隔 200 Hz 直至 6400 Hz）。
- 将音频输出接入示波器或频谱仪，可清晰观察到 **32 根独立、等间距分布的清晰尖峰**，直接实证 32 个完整独立发声单元的真实并发能力。
