wongben2333-crypto/26Embedded/fpga_hardware/docs/PCB-POWER-ESD.md

> **平台与状态（2026-11-04）**：最终整机 138K，60K 仅作早期 bring-up；PCB1、贴装、两件式 PETG 外壳已制造并完成整机联调；13 键、6 路光电、双路 ToF（A 主/B 热备）、7 寸触控均已实测；4 路 EC11 仅预留，不参与评分口径。PCB1 定位为“输入调理与隔离转接板”（上拉/限流/RC/PC817/ToF 供电/地分割），防爆音在 RTL+PA_EN，不在 PCB。

# PCB 电源保护与 ESD 设计

> **使用边界**：本文是可选保护/ESD 设计库，不代表当前 PCB 已全部装配。
> 当前低成本受控样机保留 F1 0.5 A PTC，12 V 由受控外部电源和固定线束供电；
> 反接 P-MOS、输入 TVS、保险丝和 ESD 阵列均须按 BOM 的 DNP/已装状态核对。
> 当前板级事实见 [PCB-DESIGN.md](PCB-DESIGN.md)。
>
> 适用：Tang Mega 60K 前面板/转接板 v1。
> 保护对象：外部 12 V 光电、J8 引入的 3.3 V、J13 数字输入和外部连接器。
> 下列型号用于原理图选型；下单前在嘉立创 EDA 器件库确认封装、库存和替代料。

## 1. 电源入口

### 1.1 12 V 输入

```text
J_PWR12-1 ── F12_OPT ──+── Q1(S) ── Q1(D) ──+── +12V_SW
                  │                    │
              D1(TVS)             C_BULK || C_HF
                  │                    │
J_PWR12-2 ────────┴──────── GND12 ────┘
```

- `J_PWR12`：KF128/KF301 等 5.08 mm 两针端子，额定电流至少 5 A。
- 如果补充本地保护，`F12_OPT` 用 0.5 A 慢断保险丝或 0.5 A 保持电流的可恢复保险丝；
  当前受控固定线束版本依靠外部开关电源，暂不装该保险丝。
- `Q1`：如需反接保护，可用 `AO3401A`（-30 V/-4 A，SOT-23）；当前轻载约 0.2 A，
  功耗很低，不需要 SO-8 大功率管。
- `D1`：`SMBJ15CA` 双向 TVS，放在保险丝之后、MOSFET 之前。
- `R_G`：100 kΩ，Q1 栅极到 `GND12`。
- `D_G`：可选 15 V 稳压二极管，跨接 Q1 栅极和源极，防止栅源过压。
- `+12V_SW` 对 `GND12` 并联 220 µF/25 V 低 ESR 电解电容和 100 nF/50 V 陶瓷电容。

实测六套约 120 mA，加上六路 PC817 约 60 mA，12V 总负载不足 0.2 A。
如果后续恢复本地保险丝，0.5 A 已经足够。

### 1.2 3.3 V 输入

```text
J_AUX-1(+3V3) ── F1 ──+── +3V3_LOCAL
                      │
                  D2(ESD)
                      │
                     GND
```

- `F1`：`1812L050/30` 类 0.5 A 保持电流 PTC；当前原理图已确认 F1=0.5 A。
- `D2`：`ESD9B3.3ST5G` 类 3.3 V 单向 ESD 保护器，靠近电源入口。
- 输入端加 10 µF/10 V 和 100 nF/16 V，不要用一个 100 µF 代替所有传感器的本地去耦。
- 3V3 连接器必须有防呆；不允许把原板 5 V 接进该网络。

## 2. ESD 分区

### 2.1 12 V 外部信号

每路 E3F 黑线在连接器入口加：

- 一个 `SMBJ15CA` 双向 TVS，跨接 BLACK 与 `GND12`。
- 一只 100 Ω 串联电阻接 PC817 阴极。
- PC817 阳极电阻仍为 1.2 kΩ。

TVS 放在连接器附近，先保护再经过串联电阻进入光耦。不要在 12 V 侧使用
3.3 V ESD 阵列。

### 2.2 3.3 V 静态/低速信号

推荐 `SRV05-4` 四通道 ESD 阵列，5 V 工作电压，SOT-23-6：

- VCC 引脚接 `+3V3_LOCAL`。
- GND 引脚用最短路径接完整地平面。
- 四条 I/O 分别接被保护信号。
- ESD 器件放在连接器或按键焊盘一侧，100～220 Ω 串联电阻放在它与 FPGA 之间。

建议用量：

| 被保护信号 | 数量 | 阵列数 |
|---|---:|---:|
| 13 键 | 13 | 4 |
| 4 个编码器 A/B | 8 | 2 |
| 6 路光电输出 | 6 | 2 |

### 2.3 I2C

两条 ToF 总线共 4 根 SCL/SDA，使用一颗低电容四通道阵列，
如 `TPD4E05U06DQAR`。不要用普通高电容 TVS 阵列。

- ESD 器件靠近 ToF 连接器。
- 4.7 kΩ 上拉留在 `+3V3_LOCAL`。
- 330 Ω 串联电阻位于 J13 和连接器之间。
- 不增加 100 nF 到 SCL/SDA。
- 两条总线的 I/O 必须分到不同保护通道，不能短接。

## 3. 推荐 BOM

| 位号建议 | 器件/参数 | 数量 | 说明 |
|---|---|---:|---|
| J_PWR12 | KF128/KF301 5.08 mm 2P | 1 | 12 V 输入 |
| F12_OPT | 0.5 A 慢断 | 1 | 可选 12 V 总保护 |
| Q1 | SI4435DY | 1 | P-MOS 反接保护 |
| D1 | SMBJ15CA | 1 | 12 V 输入 TVS |
| C_BULK | 100 µF/25 V | 1 | 可选 12 V 储能 |
| C_HF | 100 nF/50 V | 1 | 12 V 高频去耦 |
| J_AUX | 防呆 3V3/GND 接口 | 1 | 从 J8 取电 |
| F1 | 1812L050/30 | 1 | 3V3 过流保护，已确认 0.5 A |
| D2 | ESD9B3.3ST5G | 1 | 3V3 入口 ESD |
| U_ESD1..8 | SRV05-4 | 8 | 键、编码器、光电输出 |
| U_ESD9 | TPD4E05U06DQAR | 1 | 两路 I2C |
| D_PH1..6 | SMBJ15CA | 6 | 六路 12 V 信号 |

实际阻容推荐保留现有主值：按键 220 Ω + 100 nF，编码器 100 Ω + 10 kΩ + 100 nF，
ToF 330 Ω + 4.7 kΩ，光电 1.2 kΩ/10 kΩ/220 Ω + 100 nF。

## 4. 布板要求

- ESD 器件到连接器不超过约 5 mm，GND 回流路径尽量短且宽。
- 所有外部连接器放在板边，TVS 位于连接器与内部电路之间。
- `GND12` 与 `GND` 如果采用光耦隔离，只保留一处 0 Ω 连接位；如果采用共地，
  明确在电源入口单点汇合。
- 12 V 实测总负载不足 0.2 A；主干仍建议 0.8 mm 以上，兼顾压降、机械强度和未来余量。
- 3V3 地回流和 J13 地回流应汇入连续地平面，不在保护器件处形成细颈。
- 所有排针和端子必须标注 PIN1，PC817 必须按 1/2/3/4 脚防呆方向丝印。

## 5. 原理图检查项

- 12 V 不进入任何 FPGA、ToF、编码器或 3V3 网络。
- Q1 源极接输入、漏极接负载，栅极通过 100 kΩ 接 `GND12`。
- 所有 ESD 阵列的 VCC 接 3V3，GND 接逻辑地，不允许悬空。
- 12 V TVS 不应接到逻辑地，必须接 `GND12`。
- 每根外部信号在进入 FPGA 前有串联电阻。

## 6. 成本优先版本（受控安装）

如果外部 12 V 开关电源具备可靠的过流、过压和短路保护，并且满足以下条件：

- 电源输出限流与输入线束、端子和 PCB 主干额定值匹配；
- 12 V 入口使用不可反插的带锁连接器，装配后不会由用户重新接线；
- 光电、ToF 和编码器线束都在封闭机箱内，固定安装，不支持带电插拔；
- 产品只在干燥室内使用，并会在整机阶段做一次 ESD/EMC 验证；

则可以采用低成本版本：

- 可以省掉输入保险丝 F1；
- 可以省掉反接 P-MOS Q1；
- 可以省掉输入 TVS D1；
- 可以省掉六路光电黑线 TVS；
- 可以暂时省掉 SRV05-4/TPD4E05U06 ESD 阵列。

但以下项目不能省：

- 12 V 必须使用防呆、带锁的端子，丝印明确正负极；
- J13-11 必须保持不连接并醒目警示；
- 所有信号保留现有串联电阻：键 220 Ω、编码器 100 Ω、ToF 330 Ω、光电输出 220 Ω；
- 光电继续使用 PC817，12 V 不进入 FPGA；
- 3V3 从 J8 引入时保留 0.5 A PTC；如果 J8 自身已有可靠限流，才可考虑省掉；
- J13-12 必须接地，连接器和线缆必须有 PIN1 标识及应力释放；
- 电机、继电器、长线或外部可插拔传感器出现后，必须恢复相应的 TVS/ESD。

这是**受控样机/封闭安装**方案，不推荐作为最终量产版本。样机阶段加保护的成本远低于
烧坏 FPGA IO 或 PC817 后排查和返工的成本，因此首版建议至少保留反接保护 P-MOS 和
3V3 PTC；ESD 阵列可以按外部接口是否可接触、是否需要热插拔分阶段增加。
