wongben2333-crypto/26Embedded/fpga_hardware/docs/PCB-SCHEMATIC-SPEC.md

> **平台与状态（2026-11-04）**：最终整机 138K，60K 仅作早期 bring-up；PCB1、贴装、两件式 PETG 外壳已制造并完成整机联调；13 键、6 路光电、双路 ToF（A 主/B 热备）、7 寸触控均已实测；4 路 EC11 仅预留，不参与评分口径。PCB1 定位为“输入调理与隔离转接板”（上拉/限流/RC/PC817/ToF 供电/地分割），防爆音在 RTL+PA_EN，不在 PCB。

# PCB 原理图设计规格（v1）

> 状态：原理图设计输入，机械约束更新于 2026-10-26。
> 工具：嘉立创 EDA。
> 电气真值：`constr/fpga_hank_60k.cst`、`docs/NETLIST.md`、官方
> `Tang_Mega_NEO_Dock-60K_31004_底板原理图.pdf` 第 19 页。
> 本文描述 PCB v1；标为“规划”的网络尚未进入当前 cst/RTL。
> 板框、装配方向和制造要求见 [PCB-DESIGN.md](PCB-DESIGN.md) 与
> [MANUFACTURING-AND-ACCEPTANCE.md](MANUFACTURING-AND-ACCEPTANCE.md)。
> 实际板级实体见 `../3D_PCB1_2026-10-27.step`。

---

## 1. 已冻结决策

- J13 使用 2x20、2.54 mm 接口；音频仍在底板，不在本板重做。
- 13 键、6 路 12 V 光电、2 只 ToF、4 只预留 EC11；编码器**没有按压功能**。
- ToF 使用两条完全独立的 I2C 总线，两个传感器都保留地址 `0x52`。
- 3V3 从 J8-1/2 引入，不规划从 12 V 做线性稳压。
- 光电输入采用 PC817 光耦，不在 PCB 上继续使用 S9012 射随器。
- J13-11 是 `5V_Peripheral`，必须标记为不连接。

## 2. 原理图分页

| 页 | 名称 | 内容 |
|---:|---|---|
| 1 | FPGA 接口 | J13、全部信号网络、J13-11 NC、测试标记 |
| 2 | 键盘 | 13 个独立按键输入通道 |
| 3 | 光电输入 | H5/H6/H7 固定线束入口和 6 路 PC817 电平转换 |
| 4 | ToF 与编码器 | 两条 ToF I2C、H10/H11 编码器固定线束入口 |
| 5 | 电源 | 外部保护 12V 输入、F1 后 3V3 辅助供电 |

J13 接口使用以下网络：

| J13 针 | 网络 | 状态 |
|---:|---|---|
| 1-10,13-15 | `key_hw[0..12]` | 当前已验证 |
| 11 | `DO_NOT_CONNECT_5V` | 禁止连接 |
| 12 | `GND` | 已连接 |
| 16-21 | `photo_hw[0..5]` | 6 路已在 cst 中约束 |
| 22-23 | `ec1a/ec1b` | 当前已验证 |
| 24-25 | `scl_tof/sda_tof` | 当前已验证 |
| 26-27 | `ec2a/ec2b` | PCB 规划，待 cst/RTL |
| 29-30 | `scl_tof_b/sda_tof_b` | PCB 规划，待 cst/RTL |
| 37-38 | `ec3a/ec3b` | PCB 规划，待 cst/RTL |
| 39-40 | `ec4a/ec4b` | PCB 规划，待 cst/RTL |
| 28,31-36 | `SPARE_*` | 保留，不接 |

`J13-29/30` 在底板上分别是 `SDRAM0_EXIO0/EXIO1`，经 R68/R69 0 Ω 连到
`SDRAM0_DM0/DM1`，对应 FPGA 球 `F14/F13`。装配前确认 R68、R69 已装。

## 3. 分页连接要求

### 3.1 键盘

每个 `key_hw[n]` 使用相同的输入调理与隔离：

```text
KEYn ── 220R ──+── key_hw[n] ── J13
               │
              100nF
               │
              GND
```

- 按键另一端接 GND；FPGA 保持内部上拉，按下为 0。
- ESD 器件放在按键焊盘和串联电阻之间，钳位电压必须低于 FPGA IO 的损坏阈值。
- 13 路网络名必须与 cst 完全一致，不能使用 `KEY0`、`SW1` 等内部名直接代替。

### 3.2 六路光电

PCB 采用固定线束、手工焊接：`H5` 为六路黑线、`H6` 为六路 +12V、`H7` 为六路
GND12，针 1～6 一一对应。每路包含一个 PC817、输入限流电阻、输出上拉、RC 和串联电阻：

```text
J_PHn-1  +12V ── 1.2k ── PC817.1(A)
J_PHn-2  BLACK ───────── PC817.2(K)
J_PHn-3  GND12 ───────── 12V 传感器回流

+3V3 ── 10k ──+── PC817.4(C) ── 220R ── photo_hw[n] ── J13
               │                              │
              PC817.3(E)                    100nF
               │                              │
              GND                            GND
```

- E3F 输出低时 PC817 导通，`photo_hw[n]` 为低；逻辑方向与现有固件一致。
- PC817 的 LED 侧属于 `GND12` 域，输出侧属于逻辑地；两边只在 Power 页单点连接，
  并预留一个 0 Ω 连接位。
- H5/H6/H7 必须丝印 `CH1～CH6`，三根线束分别使用不同颜色并做机械固定。
- 每个 FPGA 输入预留测试点。

### 3.3 ToF

每只 ToF 使用四针连接器，针序按实测模块固定为：

| 连接器针 | 信号 |
|---:|---|
| 1 | SCL |
| 2 | SDA |
| 3 | +3V3 |
| 4 | GND |

总线 A：`scl_tof`/J13-24 ↔ ToF #1 SCL，`sda_tof`/J13-25 ↔ ToF #1 SDA。

总线 B：`scl_tof_b`/J13-29 ↔ ToF #2 SCL，`sda_tof_b`/J13-30 ↔ ToF #2 SDA。

- FPGA 侧每根线串 330 Ω，连接器侧各自用 4.7 kΩ 上拉到 3V3。
- 每条总线在传感器 VCC/GND 之间放 100 µF + 100 nF。
- 两条总线不得共线、不得共用上拉节点。
- I2C TVS 必须低电容，不要加 100 nF 到 SCL/SDA。

### 3.4 EC11（预留）

编码器安装在外部面包板，通过固定线束接入本板。PCB 使用：

- `H11` 八针：四组 A/B；
- `H10` 三针：针 1=`+3V3`，针 2/3=`GND`；
- 四只编码器的 C 均不连接，均无按压。

| 网络 | J13 | 球 |
|---|---|---:|
| `ec1a` | 22 | D17 |
| `ec1b` | 23 | A19 |
| `ec2a`（规划） | 26 | D14 |
| `ec2b`（规划） | 27 | D16 |
| `ec3a`（规划） | 37 | D19 |
| `ec3b`（规划） | 38 | E19 |
| `ec4a`（规划） | 39 | C19 |
| `ec4b`（规划） | 40 | C18 |

- A/B 各串 100 Ω，10 kΩ 上拉到 3V3，100 nF 对地。
- C 不接；模块内部公共端接地。
- VCC 必须是 3.3 V，并在连接器附近加 100 nF 去耦。
- 四个编码器均无按压，不增加 SW 信号。

### 3.5 电源

外部 12 V 开关电源自带保护，当前采用受控固定线束方案，不安装本地保险丝、
TVS 和反接 P-MOS，12 V 从 `CN1` 直接进入 `+12V`：

```text
CN1-1 ── +12V ── H1/H6 ── 六路光电
CN1-2 ── GND12 ─ H7 ── 0Ω(R15) ── GND
```

- 实测 12 V 总负载不足 0.2 A；主干仍建议 ≥0.8 mm。
- 3V3 当前网表由 `H3` 两针座从 J8 引入，经 `F1` 0.5 A 后得到 `+3V3`。
- 注意 `H2` 是三针 `+3V3` 汇流座，不是电源输入；真正需要防呆的是 `H3`。
- 当前 `H3` 为普通 2.54 mm 两针排针，应换成带防呆的连接器或在装配工艺中固定极性。
- 调试串口**不在新板上设接口**，直接使用原板 J9-11（P19）和原板 GND。
- 3V3、12 V、GND、六路光电输出、两条 I2C 的 SCL/SDA 各留测试点；不增加调试 TX。

## 4. 网络命名

当前网络必须保持：

`key_hw[0..12]`、`photo_hw[0..5]`、`ec1a`、`ec1b`、
`scl_tof`、`sda_tof`。

PCB 规划网络统一使用：

`ec2a`、`ec2b`、`ec3a`、`ec3b`、`ec4a`、`ec4b`、
`scl_tof_b`、`sda_tof_b`。

电源网络统一使用：

`+12V`、`GND12`、`+3V3`、`GND`。

## 5. ERC 与原理图验收

- J13-11 必须标为 no-connect，不得存在隐藏网络。
- 六路 `photo_hw[*]` 不得直接连接任何 12 V 网络。
- 两条 I2C 不得短接，且每条只有两个 4.7 kΩ 上拉。
- EC11 网络不得再出现按压信号，也不得占用 J13-24/25。
- 规划网络必须有 `PCB_PLANNED` 标注，不能与当前已验收网络混为一谈。
- 180° 检查所有连接器的 1 脚方向，并在丝印中保留 `PIN1`。

## 6. 机械约束与剩余封装项

已经冻结：

- 板框 100×70×1.6 mm，四角 R3，4 个 Ø3.4 mm 安装孔位于 X=±44、Y=±28。
- 13 个开关的 X/Y 中心、四针 4.5 mm 方形针距和键位排列。
- 壳体 M3 自攻螺丝方案、PCB 顶/底装配方向和主要元件高度分区。
- 两只 ToF 外形 31×15×6.2 mm、四周 0.3 mm 裕度及内侧窄边 12×3.6 mm 出线窗。

仍需核对：

1. 实际四脚开关的正式封装、柱塞截面和键帽锁合位置。
2. CN2/J13 板端实体已提供；还需确认与之相配的 FFC/IDC 线缆插头
   外形和最小弯曲半径。
3. ToF H8/H9 的正式四针封装；电气针序已经固定。
4. 键盘基板的最终锁固方式及其 PCB 禁布/安装点。
5. H5～H11、CN1 的正式线束端子和应力释放件。

机械参考 DXF 为 `enclosure/DXF/board_outline.dxf`；进入 EDA 后，板框、
安装孔、开关禁布区和连接器禁布区必须转换为正式封装和 Keepout Layer。
