wongben2333-crypto/26Embedded/fpga_hardware/docs/NETLIST.md

# 硬件连接网表（Netlist）· Tang Mega 60K 硬件乐器（MODE=3）

> **真值来源**：`constr/fpga_hank_60k.cst`（球号与 IO 属性）、本表 J13 逐针实测、
> `rtl/top.v`（端口方向/语义）、2026-10-24 真板接线。历史接线与故障记录见
> [BREADBOARD-BRINGUP.md](BREADBOARD-BRINGUP.md)。
> **位流**：`MODE3_mode3_60K_20261024-012557.fs`（User Code `0x1A2B0003`）
> **板卡**：Tang Mega 60K Dock，`GW5AT-60B`，IDCODE `0x0001481B`，device_version **B**
>
> 机器可读版本：`netlist.csv`（逐连接一行）；可视化：`netlist.dot`（Graphviz）。
> 图例：**IN** 输入 / **OUT** 输出 / **IO** 双向（开漏）；⚠️ 表示有注意事项。
>
> PCB 规划另新增 `ec2a～ec4b`、`scl_tof_b/sda_tof_b` 八个网络。它们尚未进入当前
> cst/RTL，不能计入“当前位流已验收”范围。

---

## 1. 顶层端口总表（37 个）

| 网络 | FPGA 球 | IO 类型 | 上拉 | 驱动 | 连到 | 方向 | 功能 |
|---|---|---|---|---|---|---|---|
| `clk` | V22 | LVCMOS33 | UP | - | 板载 50 MHz 有源晶振 | IN | 系统时钟（走 EMCCLK，P&R 报 PR1014 属既有现象） |
| `HP_BCK` | Y17 | LVCMOS33 | NONE | 8 | 板载 PT8211 | OUT | I2S 位时钟 3.125 MHz |
| `HP_WS` | AB17 | LVCMOS33 | NONE | 8 | 板载 PT8211 | OUT | I2S 字选（高=左） |
| `HP_DIN` | AA16 | LVCMOS33 | NONE | 8 | 板载 PT8211 | OUT | I2S 数据 |
| `PA_EN` | AB16 | LVCMOS33 | NONE | 8 | 板载功放 | OUT | 功放使能，**低有效**（恒 0） |
| `key` | AB13 | **LVCMOS15** | UP | - | 板载按键 1 | IN | ⚠️ 1.5 V bank；MODE=0/1 用，MODE=3 不用 |
| `key2` | Y12 | **LVCMOS15** | UP | - | 板载按键 2 | IN | ⚠️ 1.5 V bank；MODE=1 切效果器，MODE=3 不用 |
| `key_pitch` | Y22 | LVCMOS33 | UP | - | J8-12 | IN | 变调键（MODE=2），未接 → 内部上拉为 1 |
| `uart_rx_pin` | V14 | LVCMOS33 | UP | - | COM19（FT2232 通道 B） | IN | ⚠️ 不能加 `DRIVE`（CT1108）；MODE=1 MIDI 输入，MODE=3 只收 CC20/21 |
| `key_hw[0..12]` | E14 E13 C15 C14 B13 C13 A14 A13 B16 B15 A16 A15 A20 | LVCMOS33 | UP | - | J13-1..10,13,14,15 | IN | 13 个四脚轻触开关，**按下=0** |
| `photo_hw[0..5]` | B20 A21 B21 B18 B17 C17 | LVCMOS33 | UP | - | J13-16..21 | IN | 6 路光电，**挡光=0**；面包板原型用 S9012，PCB v1 用 PC817 |
| `ec1a` / `ec1b` | D17 / A19 | LVCMOS33 | UP | - | J13-22 / J13-23 | IN | EC11 #1 正交 A/B |
| `scl_tof` | **A18** | LVCMOS33 | UP | **2** | J13-24 | **IO** | ToF I2C SCL（⚠️ DRIVE=2，切勿回 8） |
| `sda_tof` | **D15** | LVCMOS33 | UP | **2** | J13-25 | **IO** | ToF I2C SDA（⚠️ 同上） |
| `dbg_tx` | P19 | LVCMOS33 | NONE | 8 | J9-11 → USB-TTL RX | OUT | 调试遥测 115200（⚠️ CPU 专用脚，需 `-use_cpu_as_gpio 1`） |
| `led[0..3]` | T18 R18 R17 P16 | LVCMOS33 | NONE | 8 | J9-6/5/8/7 | OUT | 低有效；**本板无板载 LED**，需外接 |

---

## 2. J13 逐针表（2×20，2.54 mm；SDRAM0 总线引出座，全部 3.3 V IO）

| J13 针 | FPGA 球 | 顶层网络 | 外部连接 | 说明 |
|---:|---|---|---|---|
| 1 | E14 | `key_hw[0]` | 键 1 一端（另一端共 GND） | 按下=0，note 60 (C4) |
| 2 | E13 | `key_hw[1]` | 键 2 | note 61 (C#4) |
| 3 | C15 | `key_hw[2]` | 键 3 | note 62 (D4) |
| 4 | C14 | `key_hw[3]` | 键 4 | note 63 (D#4) |
| 5 | B13 | `key_hw[4]` | 键 5 | note 64 (E4) |
| 6 | C13 | `key_hw[5]` | 键 6 | note 65 (F4) |
| 7 | A14 | `key_hw[6]` | 键 7 | note 66 (F#4) |
| 8 | A13 | `key_hw[7]` | 键 8 | note 67 (G4) |
| 9 | B16 | `key_hw[8]` | 键 9 | note 68 (G#4) |
| 10 | B15 | `key_hw[9]` | 键 10 | note 69 (A4) |
| **11** | — | — | **`5V_Peripheral`** | 🔴 **绝对不能接**（与 10 脚相邻） |
| **12** | — | — | **GND** | 共地 |
| 13 | A16 | `key_hw[10]` | 键 11 | note 70 (A#4) |
| 14 | A15 | `key_hw[11]` | 键 12 | note 71 (B4) |
| 15 | A20 | `key_hw[12]` | 键 13 | note 72 (C5) |
| 16 | B20 | `photo_hw[0]` | **PC817 输出（光电 #1）** | 挡光=0 → on 40 (E2)，vel 110 |
| 17 | A21 | `photo_hw[1]` | 未接 | 内部上拉=1 |
| 18 | B21 | `photo_hw[2]` | 未接 | 同上 |
| 19 | B18 | `photo_hw[3]` | 未接 | 同上 |
| 20 | B17 | `photo_hw[4]` | 未接 | ⚠️ 该球是 `sdram_clk`，**只可做慢速静态输入** |
| 21 | C17 | `photo_hw[5]` | 未接 | 同上 |
| 22 | D17 | `ec1a` | **EC11 #1 → A** | 正交 A |
| 23 | A19 | `ec1b` | **EC11 #1 → B** | 正交 B |
| 24 | **A18** | `scl_tof` | **ToF #1 → SCL**（4.7k 上拉 + 330Ω 串联） | ⚠️ 2026-10-24 从 J8-10 迁移至此 |
| 25 | **D15** | `sda_tof` | **ToF #1 → SDA**（同上） | ⚠️ 2026-10-24 从 J8-11 迁移至此 |
| 26 | D14 | `ec2a`（PCB 规划） | EC11 #2 → A | 当前 cst/RTL 未接入 |
| 27 | D16 | `ec2b`（PCB 规划） | EC11 #2 → B | 当前 cst/RTL 未接入 |
| 29 | F14 | `scl_tof_b`（PCB 规划） | ToF #2 → SCL | `EXIO0`，经 R68 0 Ω 到 `DM0` |
| 30 | F13 | `sda_tof_b`（PCB 规划） | ToF #2 → SDA | `EXIO1`，经 R69 0 Ω 到 `DM1` |
| 37 | D19 | `ec3a`（PCB 规划） | EC11 #3 → A | 当前 cst/RTL 未接入 |
| 38 | E19 | `ec3b`（PCB 规划） | EC11 #3 → B | 当前 cst/RTL 未接入 |
| 39 | C19 | `ec4a`（PCB 规划） | EC11 #4 → A | 当前 cst/RTL 未接入 |
| 40 | C18 | `ec4b`（PCB 规划） | EC11 #4 → B | 当前 cst/RTL 未接入 |
| 28,31–36 | 见 §7 | — | 空闲 | 7 个 SDRAM0 球留作扩展 |

---

## 3. J8 / J9 逐针表

### J8 = PMOD1（2×6；非标准针序：1/2=3V3、3/4=GND、5–12=IO）

| 针 | 网络 / 球 | 用途 |
|---:|---|---|
| 1, 2 | +3V3 | **传感器供电**（ToF、EC11、4.7k 上拉） |
| 3, 4 | GND | 共地 |
| 5–11 | AA19 / AB20 / AA20 / AA21 / AB21 / AB22 / Y21 | 空闲（⚠️ AB22/Y21 与音频同属 BANK7，**不再用于 I2C**） |
| 12 | Y22 = `key_pitch` | 变调键输入（未接） |

### J9 = PMOD0（2×6；同上非标准针序）

| 针 | 网络 / 球 | 用途 |
|---:|---|---|
| 1, 2 | +3V3 | 备用供电 |
| 3, 4 | GND | 共地 |
| 5 | R18 = `led[1]` | 外接 LED（无板载灯） |
| 6 | T18 = `led[0]` | 心跳 |
| 7 | P16 = `led[3]` | 声部活跃 |
| 8 | R17 = `led[2]` | 有音符 |
| 9 | T21 | 空闲（CPU 脚，需 `-use_cpu_as_gpio 1`） |
| 10 | U21 | ❌ CPU/SSPI 专用，不用 |
| **11** | **P19 = `dbg_tx`** | **调试遥测 → USB-TTL RX（COM12）** |
| 12 | R19 | 空闲（CPU 脚） |

---

## 4. 电源与地

| 域 | 来源 | 负载 | 备注 |
|---|---|---|---|
| 3.3 V | 底板 J8-1/2，经 0.5 A F1 | 两只 ToF、四只 EC11、上拉，预计 <200 mA | 与 FPGA IO 同域，**不要接 5 V** |
| GND | J8-3/4、J9-3/4、J13-12 | — | 单点共地；12 V 侧只从同一点拉一根地到板 |
| **12 V** | 外部电源（保护后） | 6 套 E3F ≈120 mA + 光耦约 60 mA | 🔴 **永不进 FPGA**；棕=+12V，蓝=0V；仅经光耦后进 IO |

## 5. 光电电平转换

以下为已上板验证的面包板 S9012 方案，仅作为历史参考。自研 PCB v1 使用 PC817，
连接见 `PCB-SCHEMATIC-SPEC.md`。

```
             +3V3
               │
             [10k]
               │
 黑线 ─[47k]──┼── E（发射极）──┬── FPGA 输入（J13-16..21）
               │                │
             [47k]           C（集电极）── GND
               │
              GND            （基极 B 接两只 47k 的中点）
```

实测：未遮挡 **3.3 V**（读 1）、挡光 **0.6 V**（读 0，低于 VIL 0.8 V）。
元件（每路）：S9012 ×1、47 kΩ ×2、10 kΩ ×1。

## 6. 器件连接汇总（外部器件视角）

| 器件 | 型号/规格 | 连接 |
|---|---|---|
| 四脚轻触开关 ×13 | 4 脚，一端共 GND，3D 打印键帽 | 键 i → J13 对应针（§2） |
| 光电 ×6（PCB v1） | E3F-20C1 + PC817 | BLACK→PC817 阴极；集电极→10k 上拉/220Ω→J13-16..21 |
| ToF A ×1 | VB22B，I2C 0x52，3.3 V/40 mA | VCC→3V3、GND、SCL→J13-24、SDA→J13-25（4.7k 上拉 + 330Ω 串联）；当前已验证 |
| ToF B ×1 | VB22B，I2C 0x52，3.3 V/40 mA | VCC→3V3、GND、SCL→J13-29、SDA→J13-30（独立总线和上拉）；PCB 已规划、固件待闭环 |
| EC11 ×4（PCB 规划） | 5 脚模块（VCC/GND/A/C/B，**无按键**） | #1：22/23；#2：26/27；#3：37/38；#4：39/40；C 悬空 |
| 调试串口 | USB-TTL（CH340，3.3 V 档） | RX←J9-11(P19)、GND，**不接 VCC** |
| 音频 | 板载 PT8211 + 3.5 mm | 无需外部接线 |
| PC MIDI | FT2232 通道 B（COM19） | V14 ← USB |

## 7. 未使用 / 预留

- **J13 空闲球（7 个）**：`E17 F16 F19 C20 F15 D20 E16`
  （分别是 `cas ras cs ba1 ba0 adr10 adr4`）。
  已使用 `J13-29/30` 的 `dqm0/dqm1`（F14/F13）给 ToF 总线 B。
- J13 逐针映射来自官方 `Tang_Mega_NEO_Dock-60K_31004_底板原理图.pdf` 第 19 页：
  `pin28=A4(E16)`、`pin31=CAS(E17)`、`pin32=RAS(F16)`、`pin33=CS(F19)`、
  `pin34=BA0(F15)`、`pin35=BA1(C20)`、`pin36=A10(D20)`、
  `pin37=A0(D19)`、`pin38=A1(E19)`、`pin39=A2(C19)`、`pin40=A3(C18)`。
- J13-26/27（D14/D16）：3.3 V IO，PCB 规划给 EC11 #2；当前 cst/RTL 未接入。
- J13-37～40（D19/E19/C19/C18）：PCB 规划给 EC11 #3/#4；当前 cst/RTL 未接入。
- J13-20（B17 = `sdram_clk`）：可做慢速静态输入，勿用于高速。
- J8 IO 5–11、J9 的 T21/R19：可用（J9 的两只需 `-use_cpu_as_gpio 1`）。

### 7.1 J5（FPC-40P，LCD 接口）能否当 IO？（2026-10-24 查证）

**部分可以，但不建议用。**

| 事实 | 依据 |
|---|---|
| 官方 60K / 138K 引脚文件里，LCD 段**只定义了 5 个球**：`LCD_CTP[0..3]` = **W16 U16 T16 T15**、`LCD_BL` = **P20**，全部 `LVCMOS33 / BANK_VCCIO=3.3` | 两版 `tang_mega_*_pins.cst` 的 `====== LCD ======` 段 |
| 其余 35 针（RGB 数据 / HS / VS / DE / PCLK）**在引脚文件里没有任何网络名与球号** | 全表前缀统计：`LCD_CTP`×4、`LCD_BL`×1，无 `lcd_r/g/b`、无 `dpi_*` |
| 这 5 个球（W16 U16 T16 T15 P20）**当前 cst 未使用** | `constr/fpga_hank_60k.cst` 中无这些球 |

**结论**
1. 只有 **5 个球（触摸 ×4 + 背光）** 电气上可当 3.3 V GPIO；
2. 另外 35 针**无法从官方文件确定球号** ⇒ 不能可靠约束；真要用必须去 31004 原理图
   J5 页逐针推导，并确认 60K SOM 确实把那些球引到 BTB —— 风险高、收益低；
3. **物理上是 0.5 mm FPC-40P**，必须做转接排线，不能像 J13 那样插杜邦线；
4. J5 是板载 RGB LCD 的专用口（含背光/触摸），以后上屏就会被占。

**扩展 IO 的优先顺序**：J13 剩余 7 球（2.54 mm，最好接）→ J8 剩余 5 球
（`AA19 AB20 AA20 AA21 AB21`）+ J9 的 `T21`/`R19` 与 4 个 LED 球（`T18 R18 R17 P16`，
本板无 LED）= 最多 11 个 2.54 mm 排针脚，但 **J8/J9 与音频同 BANK7，只适合慢速/静态信号**
（键、编码器、光电都可以；不要再做 I²C 或高速）→ J5 的 5 个球只作最后备用。

## 8. 信号流

```
13 键 ─┐
光电 ──┤ 2ms/8ms 去抖 ──┐                           ┌── 音频 (PT8211) ── 耳机
EC11 ──┤ 1kHz 正交解码 ─┤ 事件仲裁  → FIFO16 → 串行化(≥16clk) → 8 声部引擎 ──► audio_fx
ToF ───┘ (I2C 50Hz)     │  弦>键>ToF                                   │
                        └── EC11 → 音量 dB LUT ───────────────────────────┘（混音后增益）
```

## 9. 变更记录

| 日期 | 变更 |
|---|---|
| 2026-10-22 | 初版接线：13 键 + 6 光电 + ToF(J8-10/11) + EC11(J13-22/23) |
| 2026-10-23 | 发现 J8 的 I2C 与音频同属 BANK7，10 kHz 会串扰 → 临时降为 DRIVE=2 + 3.3 kHz |
| **2026-10-24** | **ToF I2C 迁移至 J13-24/25，恢复 10 kHz（DRIVE=2），听感完全干净** |
