wongben2333-crypto/26Embedded/fpga_hardware/enclosure/MODELING-NOTES.md

# FPGA 乐器外壳建模说明

日期：2026-10-27  
单位：mm  
当前状态：2026-10-28 硬件确认版数字模型和打印前检查已完成。受打印条件限制，不单独打印配合样件，
直接以整壳作为首件；尚未进行实物装配验证。
设计意图和当前冻结边界以 [../docs/ENCLOSURE-DESIGN.md](../docs/ENCLOSURE-DESIGN.md)
为准；本文保留参数化建模、原始 STL 测量、脚本检查与 DfAM 细节。
本次硬件确认修改的逐项说明见
[MODIFICATION-2026-10-28.md](MODIFICATION-2026-10-28.md)。
PCB 机械依据：`Gerber_PCB1_2026-10-27.zip`，SHA256
`12E0087CDD879E0BD927E60772B862EF2B89EF3A4BB4B88E95708D26DBFC2A87`；
实际元件依据 `3D_PCB1_2026-10-27.step`，SHA256
`7B84827BBC2F2C9EFB078D1A2C334A1F19FF96B07639DCA9A343151B20EF5833`。

## 1. 已完成内容

- 检查原 STL，不修改原 ZIP、原 STL 或 RTL。
- 重建 8 白键 + 5 黑键的单八度参数化键床。
- 建立 31×15×6.2 mm ToF 的安装、遮光与线缆结构。
- 按“PCB 全内置、壳体承力、上壳可拆”的方案建立上下壳。
- 壳体、PCB 支撑和 PCB 安装统一采用 M3 塑料自攻螺丝，不使用热熔螺母。
- 输出 STEP、STL、3MF、PCB 暂定板框 DXF 和可重复检查。

## 2. 原始 STL 检查

原始 STL 解压到 `references/original_stl/`，源文件保持不变。

| 文件 | 包围盒 X×Y×Z | 三角面 | 自由边 | 非流形边 |
| --- | --- | ---: | ---: | ---: |
| `top shell.stl` | 258.045744×25.399998×129.267013 | 245122 | 0 | 0 |
| `buttom shell.stl` | 172.877998×22.124291×86.590000 | 25710 | 0 | 0 |
| `piano keyboard.stl` | 168.239998×8.800000×55.549999 | 2668 | 0 | 16 |
| `knob.stl` | 16.500000×14.000000×16.500000 | 8772 | 0 | 0 |
| `switch.stl` | 4.337502×20.000000×15.400000 | 760 | 0 | 0 |
| `part1.stl` | 168.239998×6.000000×6.500000 | 536 | 0 | 0 |
| `part2.stl` | 35.000000×4.500000×24.753015 | 1578 | 0 | 0 |

原键盘网格实际包含 11 个白键和 7 个黑键，并有 16 条非流形边，不能直接
作为最终键床的布尔源。根据其顶面轮廓沿用：

- 白键宽 14.24，中心距 15.24，深 47.55，厚度 4.80。
- 黑键宽 7.62，深 29.007，相对白键高 2.00，厚度 6.80。

为满足 PCB 宽度不超过 100 mm 的硬约束，新键床仍保持 C 八度单排
8 白键 + 5 黑键，但采用压缩琴键比例：白键宽 10.50、名义中心距 11.50，
黑键宽 5.62。黑键位于 C#、D#、F#、G#、A# 间隙，实测最小实体间隙
为 0.30 mm。最终 Gerber 将 A4 开关放在 X=+17.00，外壳按实际版图跟随，
因此相邻白键距为 11.25/11.75；其余键位保持 11.50。PCB 相关器件按前后
两带布置，不靠左右扩展板宽解决。

## 3. 开关与键程

- 开关本体按最大包络：8.5×7.8。
- 完整高度：PCB 顶面到开关最高点 5.0，由用户实测确认。
- 当前建模拆分：本体高 3.0、柱塞高 2.0。
- 按压行程：2.0。
- 四脚针距：4.5；引脚 Ø0.7；柱塞 Ø3.5。
- 键床通孔：9.2×8.3；宽度方向名义间隙 0.35、深度方向 0.25，最大
  来料仍有单边至少 0.15。
- 底面焊盘让位：10.6×10.6×深 0.8；A4 与 G4 间的 0.65 薄墙用局部连通
  让位消除，保留 1.2 mm 连续顶板。
- 键帽插座：Ø3.70、深 3.20。
- 键床板：98.00×2.00×53.575；后缘 +26.775、前端 -26.8，PCB 前侧
  保留 8.2 mm 裸露带。
- 全压时键帽底面距键床顶面仍有余量 1.00。
- 每键增加两根 Ø2.20 中央导柱，导柱中心距 24.00；键帽对应
  Ø2.50×2.80 盲孔。静止插入 0.40，全压插入 2.40，孔底仍余 0.40。
- 双导柱把长键帽的理论前后摆动上限从单柱约 3.58° 降至约 0.72°；
  黑键导柱距帽端仍有约 1.40 mm 实体边。
- 键床前端位于 Y=-26.8，PCB 前端位于 Y=-35.0；前侧 8.2 mm 裸露带
  可供朝下排针线束通过。
- H5 的 `X=-37.34..-24.64`、`Y≈-25.02` 顶面残留引脚会在键床覆盖区内；
  不增加键床通窗，装配前必须把朝上脚剪平至 PCB 上表面或更低。
- 键床增加 4 个 Ø1.6 mm 向上定位柱，对应上盖 Ø2.0 mm 盲孔；
  最终实体求交得柱尖 Z=19.000、插入 0.876、孔底余量 0.374、键床/上盖
  干涉 0。不再用 J13 作为止口；定位柱控制 X/Y，垂直上跳仍需实物验证。

仍需实测开关本体肩高、帽底连接结构和回弹时间；当前总高与行程已采用用户值。

## 4. ToF 方案

ToF 外形锁定为 31×15×6.2 mm，两个模块均直接向上：

- 局部 +Z 表示发射方向；装入外壳后两个轴线均平行整机 +Z。
- 模块四周每侧预留 0.30 mm 装配间隙，安装腔按 31.60×15.60 制作。
- 两只中心位于键盘后方 X=-45 和 X=+45、Y=45，中心距 90。
- 模块座、1.5 mm 承托底、下半段筒体和内侧走线窗均并入下壳。
- 上壳只保留 Z=22.124 以上的导光筒上段，因此拆上壳不会牵动 ToF
  模块或线缆。
- 每只模块四周名义配合间隙 0.30。
- 遮光筒为矩形通光孔 29×13，四角 R1，模块顶面以上净深 18.5；模块面四周各保留
  1 mm 止挡边。筒壁打印后应喷哑光黑。
- 四芯线只从模块朝键盘中心一侧的窄端面引出；每只 ToF 的内侧壁开有
  12×3.6 mm 走线窗。对应窄端面尺寸为 15×6.2，窗口上下各保留约 1.3 mm。
- 不设底部或后部出线槽，避免线缆从非预定方向被拉出。
- 两轴与 PCB、键床、键帽和壳体均无干涉，轴向误差为 0.0°。

ToF 模块底部由下壳 1.5 mm 承托座支撑，模块位于 Z=1.5..7.7；
上段导光筒继续到与黑键顶面相同的 Z=26.200。上下筒在 Z=22.124 的
壳体接缝处分件。上壳主盖板从 Z=22.124 开始，键床加强筋向下延伸到
Z=18.124。白键最高面为 24.200，黑键最高面与 ToF 外窗口均为 26.200。
40P 接口处另有一个局部圆角服务拱盖，最高 Z=27.000，不改变键床和
ToF 高度。

线缆出口方向已经锁定为内侧窄边。镜头中心和安装孔/卡槽仍按中心镜头及
底部装入假设处理；29×13 的大光窗为装配偏差保留了较大容错。

## 5. 壳体结构

- 全局坐标原点在下壳最低平面中心，+Z 向上，+Y 向后。
- 下壳外形：130.000×109.000×22.124；后壁外缘与 ToF 最外缘同为 Y=54.5。
- 下壳壁厚 2.5，底板 2.5。
- 上壳主体外形：140.000×109.000×26.200，圆角 R18；后部 40P 接口上方
  有 60×9 mm 的局部服务拱盖，最高 Z=27.000。其余顶面保持连续主平面，
  没有两只 ToF 中间的凹进。
- 上壳、下壳和 ToF 最外缘均位于 Y=54.5；ToF 筒最外侧直接构成后侧
  轮廓基准，外壳轮廓在该处保持整片连续平面。
- 上壳实体体积约 39.0 cm³，下壳实体体积约 67.0 cm³。
- 上壳和键床为可拆件；PCB 完全位于壳体内，不用 PCB 当底壳或承力框。
- PCB 顶面位于 Z=14.4，开关本体直接落座在该基准面。
- 4 个 M3 板支撑柱承托 PCB，另有两根 PCB 下方支承筋。
- 后侧加强筋在 H2 的 `X=-42..-32` 范围折向 `Y=24.8..27.8`；
  H2/H3/H4/H14 的朝下排针位置按本体+引脚包络外扩 0.40 mm 留避让，
  实测本体最近间隙均为 0.400，引脚最近间隙为 H2 0.992、H4 1.030、
  H3 0.541、H14 0.332。
- 4 个 M3 壳体柱连接上下壳。
- 壳体螺丝采用 M3×10 自攻螺丝；PCB 与支撑柱采用 M3×8 自攻螺丝。
  底孔统一为 Ø2.50，建议螺丝头直径不超过 6.0、头高不超过 2.0。
- 上壳键盘开口：97×49.5；键床左右各有 0.5 mm 上盖压边，键帽与开口边
  最小平面净距 0.975。
- J13/CN2 的 Gerber 放置原点为 Y=+32.004；3D 包络为
  58.4×8.91×12.2，实际体中心约 Y=+32.104，向 PCB 后边以外延伸约 1.56。
  上壳已按 3D 实体扩大避让并给 ToF 塔内前角做局部让位。线端 IDC
  插座按公开尺寸 55.4×6.1×10.7 建立包络，PCB 顶面到其顶部为 25.100；
  服务拱盖内顶为 25.600，实际净空 0.500，顶壁厚 1.400。
- PCB 暂定外形：100.0×70.0×1.6，四孔 Ø3.4，孔位 X=±44、Y=±28。

## 6. 线缆出口

下壳后侧（ToF 侧）保留 FPGA 排线口；光电、12V 和编码器线束改由
ToF 对侧的前壁出壳。每个出口两侧有 Ø2.2 压线片螺丝孔：

| 用途 | 所在面/中心 | 开口 | 中心 Z |
| --- | --- | --- | ---: |
| 40P FFC/排线服务口 | 后壁 X=0 | 56.8×12.0 | 14.0 |
| 40P 左侧辅助线窗 | 左壁 Y=+29.5 | 12.0×8.0 | 12.0 |
| 40P 右侧辅助线窗 | 右壁 Y=+29.5 | 12.0×8.0 | 12.0 |
| 6 路光电 + 12V 供电服务口 | 前壁 X=-28 | 44×17 | 11.5 |
| 4 个 EC11 固定线束 | 前壁 X=+28 | 36×14 | 11.0 |

6 路光电共 12 根 Ø3.5 mm 导线，另按 2 根 Ø3.5 mm 的 12V/GND
保守占位计算，合计理论截面积约 134.69 mm²。44×17 mm 服务口面积为
748 mm²，约为该组合截面积的 5.55 倍。两个前侧大开口之间保留 16 mm
实体壁带，前侧压线片孔位在 X=±54；后侧 56.8×12 mm 口可让
55.4×10.7 mm 的成品线 IDC 插头穿过。后侧保留两个 Ø2.2 mm 下部
压线孔，位于 X=±18、Z=4，避开了扩大后的开口。
常见 40P、2.54 mm 间距线端 IDC 插座（如 3M 89140 系列）外形约
55.4×10.7 mm（另有约 6.1 mm 厚度）；Multicomp
MC-254-40-00-00-IDC 的对应总长为 55.48 mm，
排针跨距为 48.26 mm。56.8×12 mm 口对插头宽度留 1.4 mm、对高度
留 1.3 mm，允许两端都已压接的成品排线从开口穿过。
推荐装配顺序：先取下上壳，将外侧插头由内向外通过后侧服务口，接好
盒内 PCB 端插头，再安装压线片并合上上壳。之后插拔盒内端时仍需
取下上壳，不能只通过后侧口隔墙操作。
40P 接口左右两侧各增加一个 12×8 mm 辅助线窗，中心在 Y=+29.5、
Z=12.0；两窗镜像布置，位于 ToF 筒前方并避开 PCB 和四角螺丝柱。
所有开口现按“外壁到内腔完整贯通”探针检查，而不只检查开口表面。
正式端子、防水/防尘等级和应力释放件仍需按实际线束选型确认。

## 7. 检查结果

`checks/shell_checks.py` 当前 PASS：

- 上下壳均为单一、正体积、零自由边、零拓扑问题的实体。
- 上下壳接缝距离 0。
- PCB、键床、J13、ToF 模块均无意外相交。
- PCB 完全位于下壳内，并由 4 个支撑柱接触承托。
- 5.0 总高、2.0 行程、全压余量 1.0 全部通过。
- 开关本体与键床最小净距 0.15；13 个焊盘让位探针重叠均为 0。
- 键盘开口 97×49.5；键床左右各伸入 0.5，键帽到开口最小净距 0.975。
- 4 个键床定位柱完整，最终实体插入 0.876、孔底余量 0.374，
  键床/上盖求交为 0；定位凸台到键帽最小净距 0.625。
- H2/H3/H4/H14 采用板下排针包络检查，本体和引脚对下壳复制体积均为 0。
- ToF 尺寸 31×15×6.2，两轴均向上，无任何光轴遮挡。
- 两只 ToF 均为 29×13 mm 矩形通光孔，孔口探针重叠体积为 0。
- 两只 ToF 内侧均有 12×3.6 mm 窄边走线窗，探针重叠体积为 0。
- ToF 分件面位于 Z=22.124；上壳在分件面以下的 ToF 座区域重叠为
  0 mm³，下壳保留的筒壁参考体积约为 1213.69 mm³/只。
- 光电/12V 前服务口为 44×17 mm，编码器前服务口为 36×14 mm。
- 40P 左右辅助线窗各为 12×8 mm，左右对称且贯通探针重叠为 0。
  - 五个线缆出口按完整壁厚探针检查，重叠体积均为 0 mm³。
  - 六个压线片孔贯穿探针重叠体积均为 0 mm³。
- PCB DXF 校验无问题：100×70，4 个 Ø3.4 孔位正确。

`checks/fit_sample_checks.py` 也通过，除原有 13 键和 ToF 配合外，还检查了
26 个导柱、26 个键帽盲孔、初始/全压插入量及导柱与键帽干涉。

`checks/gerber_alignment_checks.py` 通过：Gerber 板框、4 个 NPTH 孔、
13 个开关中心、CN2/J13、前端连接器位置和 56.8×12 mm 服务口均与外壳一致。

`checks/actual_pcb_checks.py` 通过：真实 3D PCB 回装后，13 个开关、
CN1、CN2 和 H5–H13 与上下壳均无实体干涉；55.4×6.1×10.7 mm 的
线端 IDC 包络与上壳重叠为 0。`keybed_plate` 仍然存在，
位于 PCB 与键帽之间并为 13 个开关预留方孔。

由于当前只能打印整壳，`fit_sample.step/3mf` 仅作为数字检查件保留；首件将直接
打印上下壳并一次性验证键床、ToF、PCB、线缆和五金。整壳首件必须逐项测量，
不能把数字 PASS 当作实物验收。

## 8. DfAM 结果

按 PETG、0.2 mm 层高和 FDM 45° 自支撑规则检查：

- 上壳：水密 1 体，体积约 39.0 cm³，`p05=2.00`、最小采样 0.04
  （尖锐边框采样点）；当前姿态 45° 以下悬垂面积 35.0%，侧立姿态可降到
  约 3.8%，但构建高度增加到 140。
  服务拱盖内顶到外顶为 1.4，满足保守 FDM `p05` 壁厚要求。切片时应将
  可见顶面朝下，并在导光筒内部使用树状支撑；当前轴对齐方向扫描没有
  找到显著更低的低高度姿态。
- 下壳：水密 1 体，`p05=1.70`、最小采样 1.50；当前姿态 45° 以下
  悬垂面积 1.3%，支撑体积粗估 14.9%。ToF 承托底厚 1.5，高于保守
  FDM 最小承托壁厚 1.2。
- 键床单件：水密 1 体，`p05=1.20`、最小采样 0.90；推荐将 PCB 接触面
  朝下、开口朝上平放，构建高 5.4，悬垂面积约 3.8%。DfAM 工具未直接测量
  最小孔径和无支撑桥长，仍需在切片软件中确认 9.2×8.3 方孔和焊盘让位。
- 前侧 44 mm 和 36 mm 开口的顶边会形成较长桥接；切片时应检查桥接下垂，
  必要时对开口上缘添加局部支撑或改用侧立姿态。当前 DfAM 工具没有可测的
  最大无支撑桥长字段，因此这一项不标为已通过。

## 9. 未冻结项

- 原始上壳非矩形外观与曲面细节。
- ToF 镜头中心和安装孔/卡槽；线缆已锁定为内侧窄边引出。
- PCB 使用最终 Gerber 和实际 3D STEP；已按 55.4×6.1×10.7 mm 标准
  IDC 插头包络预留，仍需用实际采购件确认附加护套和线缆最小弯曲半径。
- 键床定位柱与上盖盲孔的实际插拔手感、垂直防上跳和长期磨损。
- EC11 外面板外形、固定方式和线束接头。
- ToF 四芯线的接插件高度、实际走线路径和筒内固定方式。
- 实际线束直径、弯曲半径、应力释放件和防水等级。
- 打印机有效工作区、最终支撑策略和切片验证。

在任何实物装配与安全测试完成前，不把当前版本声称为最终量产外壳。
