wongben2333-crypto/26Embedded/fpga_hardware/docs/INSTRUMENT-MAPPING.md

# 乐器映射与演奏语义（硬件输入 → 音符/表情）

> 版本：v0.2（2026-10-21，ToF 改为 I2C）
> 适用范围：S5 整合阶段。**本文只定义"哪个输入产生什么音乐事件"**，不涉及 RTL 实现。
> 依据：现有引擎上限 **8 声部**、采样率 97 656.25 Hz、MIDI 风格事件总线（0x90/0x80/CC）。

---

## 1. 输入源总览

| 输入 | 数量 | 物理形态 | 音乐角色 |
|---|---:|---|---|
| 硅胶轻触键 | 13 | 4 脚直插，一路到 GND | 主键盘：一个八度半音阶 |
| 对射光电 | 6 | NPN 开集，遮挡 = 拨弦 | 6 根固定音高的"弦" |
| ToF #1 | 1 | VB22B，I2C 0x52，手距 | 音高（特雷门） |
| ToF #2 | 1 | VB22B，I2C 0x52（独立总线） | 音量（连续） |
| EC11 #1 | 1 | A/B 正交 + 按压 | 总音量 |
| EC11 #2 | 1 | A/B 正交 + 按压 | 颤音深度/速率 |

---

## 2. 13 键：C4–C5 半音阶

按钢琴排列，**8 白 + 5 黑**，共 13 个键位（C4 到 C5 含端点）。

| 键位 | 音名 | MIDI | 白/黑 |
|---:|---|---:|---|
| 0 | C4 | 60 | 白 |
| 1 | C#4 | 61 | 黑 |
| 2 | D4 | 62 | 白 |
| 3 | D#4 | 63 | 黑 |
| 4 | E4 | 64 | 白 |
| 5 | F4 | 65 | 白 |
| 6 | F#4 | 66 | 黑 |
| 7 | G4 | 67 | 白 |
| 8 | G#4 | 68 | 黑 |
| 9 | A4 | 69 | 白 |
| 10 | A#4 | 70 | 黑 |
| 11 | B4 | 71 | 白 |
| 12 | C5 | 72 | 白 |

- 映射用**查表**实现（13 项常量），可整体移调 ±N 半音而不改硬件。
- 按下 → `0x90 note vel`；松开 → `0x80 note vel`。
- 力度（vel）：键是开关，没有力度信息，默认 **vel = 100**。

---

## 3. 6 根"弦"：固定音高（吉他标准调弦）

| 弦 | 音名 | MIDI | 频率 |
|---:|---|---:|---:|
| 1（最粗） | E2 | 40 | 82.41 Hz |
| 2 | A2 | 45 | 110.00 Hz |
| 3 | D3 | 50 | 146.83 Hz |
| 4 | G3 | 55 | 196.00 Hz |
| 5 | B3 | 59 | 246.94 Hz |
| 6（最细） | E4 | 64 | 329.63 Hz |

**触发语义**

- 光束被遮挡的**上升沿**（未遮挡 → 遮挡）= 一次拨弦 → `0x90 note vel`，`vel = 110`。
- 遮挡结束 = `0x80 note`，让包络自然衰减。
- **最小重触发间隔 40 ms**（传感器本身 50–60 Hz 上限）。
- 上电后 **250 ms 屏蔽窗** + 首次"全部未遮挡"确认，防止上电抖动产生假拨弦。

---

## 4. ToF #1：音高（特雷门）

**为什么不做"完全连续"**：VB22B 的绝对精度 ±5 cm、重复性 ±30 mm。
若把 60 cm 映射成一整八度，1 个半音只有 5 cm —— 噪声会造成约 ±0.6 半音的抖动。
所以采用**量化音级 + 迟滞 + 滑音**。

| 参数 | 值 | 说明 |
|---|---|---|
| 有效距离 | 10–70 cm | 小于 5 cm 是盲区；大于 70 cm 视为"手离开" |
| 音域 | C4–C6（MIDI 60–84），25 个半音 | 可改 |
| 量化 | 每级 2.4 cm | 60 cm / 25 |
| 迟滞 | ±2 cm | 必须跨过 2 cm 才换音 |
| 滤波 | 5 点中值 + 4 点滑动平均 | 全整数运算，零 DSP |
| 换音方式 | 旧音 `0x80` + 新音 `0x90`，用引擎滑音（CC5）过渡 | 不重触发包络 |
| 手离开 | 距离 > 80 cm 持续 200 ms → 全部 NoteOff | 防误判 |

---

## 5. ToF #2：音量（连续）

| 参数 | 值 |
|---|---|
| 有效距离 | 10–80 cm |
| 映射 | 近 = 响，远 = 轻；线性映射到 **0–127** |
| 滤波 | 8 点滑动平均（≈40 ms） |
| 更新率 | 每 20 ms 更新一次 |
| 落地方式 | **新增 1 个乘法器**，在混音后乘增益 |
| 手离开 | 保持最后音量（不静音） |

> 引擎当前总线没有 CC7。这条通路需要在 `_work_60k` 的 RTL 副本里新增，
> **不改 hank 的 `fpga_hank/rtl` 原文件**。DSP 余量 13.5 个，1 个 16×16 乘法器够用。

---

## 6. EC11 编码器

| 编码器 | 旋钮 | 按压 |
|---|---|---|
| #1 | 总音量（0–127，每档 ±4） | 静音 / 取消静音 |
| #2 | 颤音深度（0–127） | 切换颤音速率档位（4 档） |

- 正交解码：**4 倍频状态机**，每格 4 个计数，天然去抖。
- 上电初值：音量 100、颤音深度 0。

---

## 7. 8 声部仲裁

输入源最多 21 个，引擎只有 **8 声部**：

1. **优先级**：拨弦（瞬态）> 按键（保持）> ToF 音高（连续单声部）。
2. ToF 音高**固定占用 1 个声部**，不参与抢占。
3. 剩下 7 个声部给 13 键 + 6 弦。
4. 声部满时**抢占最久未更新的声部**，先 `0x80` 再 `0x90`。
5. 同一音符重复触发：先 `0x80` 再 `0x90`（retrigger）。
6. 所有音符事件进 **32 深 FIFO**，溢出计数在验收中必须为 0。

---

## 8. 待定 / 后续

- 移调键（`key_pitch`，Y22）保留为"整体移调 +1 半音"。
- 音色切换（CC20）目前靠电脑；离线演奏时映射到某个 EC11 的按压。
- ToF 音高的"连续模式"（分数音高）不在本期范围。

---

## 9. 实施偏差（2026-10-24，以代码 `rtl_integ/io/hw_input_mgr.v` 为准）

本文 v0.2 是设计意图；实际实现经过真板验证后做了以下改动，**读代码时以这张表为准**：

| 项 | 本文方案 | 实际实现 | 原因 |
|---|---|---|---|
| ToF 换音 | 用引擎滑音（CC5）平滑过渡 | **glide=0 重新拨弦**，>=180 ms 限速 | 引擎 glide_on 复用**全局 last_voice**，会偷走正在响的键声部并滑走（实测音高乱窜） |
| ToF 入场 | 直接进入 | 追加 **3 采样驻留**（~60 ms） | 手路过光束会误触发 |
| 光电弦数 | 6 根（E2/A2/D3/G3/B3/E4） | **只用第 1 根 E2=40** | 其余 5 路未接线（面包板已满） |
| ToF #2 音量 | ToF#2 → 音量 | 改为 **EC11 #1 → 音量** | ToF #2 未接线 |
| 音量曲线 | 未明确 | **128 项 dB 感知 LUT**（0=-42 dB 静音 … 127=直通，每格 ~1.3 dB） | 线性曲线每格仅 ±0.3 dB，听不出来 |
| 事件 FIFO | 32 深 | **16 深**（分布式 RAM） | 任务书约束；实测阻塞计数恒 0 |
| 事件间距 | 未明确 | **≥16 clk**（320 ns） | 引擎装载 FSM 需 14 clk 且无输入队列，喂快会丢音 |
| ToF 距离上限 | 10–70 cm | 内部 **12 位钳位**（>800 mm 判离场） | 收窄比较器/时序余量 |
