wongben2333-crypto/26Embedded/fpga_hardware/docs/S5-HANDOFF-AND-HW-DESIGN.md

# S5 移交指南 · 自研 PCB 与 3D 外壳建议

> 依据：2026-10-23/24 的 S5 整合实测（MODE=3 上板验收通过）。
> 配套文档：`S5-INTEGRATION-PLAN.md`（方案+附录 A1–A5 实施结果）、
> `INPUTS-WIRING.md`（逐针接线/字节序/电气动正）、`LOCAL-MACHINE-NOTES.md` §15（本机坑）。

---

## 0. 结论摘要

- **可以交接**，但交付物是"一条跑通的参考实现 + 验收标准 + 明确的扩展点"，不是即插即用的框架。
- 硬件扩到"6 弦 + 2 ToF + 2 EC11 + 第二八度"：LUT/BSRAM 余量充足，
  **唯一紧箍咒是 DSP**（MODE=3 现 79/118，开启颤音/滑音后参考 MODE=1 的 104.5/118）。
- 音色：**现场换 hank 现有三种音色无需改 RTL**（COM19 发 CC20/CC21）；
  **新增音色必须改引擎**，而引擎在只读区 → 要 fork + 与 hank 约定合并。
- 自绘 PCB 的首要原则：**把 I2C 从 J8（BANK7，与音频同组）挪到 J13**，
  并把 12V 光电部分与 3V3/音频彻底分区。

---

## 1. 交接：现状能力边界

### 1.1 可直接复用的资产

| 资产 | 位置 | 用途 |
|---|---|---|
| 可写引擎副本 + MODE=3 通路 | `rtl_integ/`（top.v + io/hw_input_mgr.v） | 扩展基座（fpga_hank 只读） |
| 自检 TB（含 I2C 从机 BFM） | `sim_s5/tb_hw_input_mgr.sv` + `run.ps1` | 回归网，扩来源时同步加场景 |
| 验收清单与证据 | `S5-INTEGRATION-PLAN.md` 附录 A3 | 交接验收标准 |
| 电气/时序坑记录 | 本文 §2.3、`LOCAL-MACHINE-NOTES.md` §15 | 避免重复踩坑 |
| 构建/烧录流程 | `README.md` §4、`build_60k.tcl` | 一键复现 |

### 1.2 必须改的 4 处硬编码

| 扩展项 | 现状 | 要改什么 | 量级 |
|---|---|---|---|
| 光电 6 根弦 | 去抖/遥测覆盖 6 路，**事件只用 photo[0]**（固定 E2=40） | pending 扩 6 位 + 6 项音高表（40/45/50/55/59/64）+ 仲裁扫描 | ~200 LUT |
| ToF #2 | 只例化总线 A；总线 B（AA21/AB21）连约束都没有 | ToF 序列器抽成 `tof_channel.v` 例化两次 + cst 补 4 球 + 第二路仲裁 | ~400 LUT（需重构） |
| EC11 #2 / 按压 | 只接 #1（D17/A19）；#2（A18/D15）、按压（D14/D16）未约束 | 第二个正交解码 → 驱动 `bus_vib_depth/bus_vib_rate`；top.v mux 扩一档。⚠️ 现模块 5 脚无按键，按压要换型号 | ~100 LUT |
| 第二八度 | 键固定 13 → 60..72 | 端口加宽到 26 + 表加 13 项。J13 剩 **13 个空闲球**，刚好够 | ~300 LUT |

> ⚠️ **DSP 预算**：MODE=3 的 79/118 是"颤音/滑音通路被常量折叠"省出来的。
> 一旦 EC11#2 接颤音，参考 MODE=1 的 104.5/118 ⇒ **只剩约 13 个乘法器**。加音色前先查 DSP。

### 1.3 音色扩展的两条路

1. **现场换音色（零 RTL）**：MODE=3 下 COM19 的 MIDI 链路仍然活着（只有音符通路被 mux 掉）。
   发 `CC20` = 0/1/2（钢琴/吉他/二胡）、`CC21` = 弓速。硬件旋钮接这个还没做（见 1.2 EC11#2）。
2. **新增音色（要 fork 引擎）**：音色数据在 `piano_engine.v`（每乐器×每音区泛音表）
   + 生成的 `piano_rom.v` + `wave_rom.v`（4 张基础波形表）。都在只读区 ⇒
   按 S5 同样模式复制再改，并与 hank 约定合并责任，否则分叉。
   - MODE=2 的 `tone_bank`（32 振荡器、4 张波表）与 MODE=3 的 `piano_engine`（8 声部、每声部
     6 泛音）是两套独立系统；"基于硬件开发音色"改的是后者。

### 1.4 交接前建议先做的三件事

1. **拆文件**：`hw_input_mgr.v`（721 行单文件）→ `debounce_edges.v` / `tof_channel.v`
   （可例化两次）/ `event_arbiter_fifo.v` / `telemetry.v`。这是扩展 2 号 ToF、6 弦的前提。
2. **保留 `QUIET` 参数**（1=全冻、2=只冻遥测、3=只冻 I2C）——排查"音频被数字信号污染"
   的唯一有效工具；任何新增高速引脚都应先用它做一次听感对比。
3. **把 `sim_s5` 当回归网**：间距 ≥16 clk、换音限速、迟滞、FIFO 零阻塞——今天所有逻辑 bug 都是它先抓到的。

### 1.5 必须继承的三条红线

1. **电气**：AB22/Y21 与音频 I2S 同属 BANK7；新动态信号一律 `DRIVE≤2`、能慢就慢
   （I2C ≤3.3 kHz 已验证）。总线 B 也在 J8，同样规矩。
2. **永远不要用引擎的 glide 驱动新来源**：`glide_on` 复用**全局 last_voice**，
   会把正在响的声部偷走并滑走（"音高乱窜"的根因）。新来源一律"重新拨弦 + 时间限速"。
3. **串行化 ≥16 clk**：引擎装载一个音符要 14 个时钟节拍，**没有输入队列**，喂快直接丢音。

---

## 2. 自研 PCB 建议

### 2.1 架构选择：先做"扩展板（Shield）"，不要一上来替换底板

| 方案 | 做法 | 评价 |
|---|---|---|
| **A. Shield（推荐 v1）** | 自制一块前面板 PCB，用 2×20 排线接 Tang Mega 底板 **J13**，音频仍用底板的 PT8211/耳机口 | 工作量小、可复用现有位流与引脚表；底板+核心板放盒内或盒旁 |
| B. 替换底板 | 自制载板直接插 SOM 的 BTB 连接器 | 需要 SOM 引脚表与 BTB 型号，风险/成本高，不建议 v1 |

**球号规划（单条 J13 排线就够）**：
13 键 + 6 光电 + EC11×2（4 脚）+ ToF×2（2 条独立 I2C，4 脚）= **27 球 ≤ 38**（J13 还有 11 球余量）。
**把 I2C 从 J8（AB22/Y21）挪到 J13** —— 这是本次最重要的电气改进，**已实测验证**：
在面包板上把 SCL/SDA 改到 **J13-24(A18) / J13-25(D15)** 后，`DRIVE=2` 下
**恢复到 10 kHz 全速，听感完全干净**（位流 `MODE3_..._20261024-012557`）。
即：离开 BANK7（音频组）从根上消除了"数字线搅音频"的耦合路径。
排线上每隔 4 根插一根 GND 作为回流。

### 2.2 12V 与 3V3 必须彻底分区

光电是 12V 器件（6 套 ≈ 1.5–2.4 A）。板上：
- 独立 12V 输入端子（JST-VH 或接线柱）+ **保险丝** + **反接保护（P-MOSFET）**；
- 12V 走 ≥1.5 mm 线宽，**与 3V3/音频区之间开槽**（creepage ≥1.5 mm）；
- 3V3 若从底板取（J8/J9 的 3V3），先确认电流余量；传感器/编码器总量约 <100 mA，通常够；
  不够就在板上从 12V 做 LDO（如 MP1584/AMS1117-3.3），别从底板硬抽。

### 2.3 从这次踩的坑直接推出的电气规则

1. **I2C 远离音频**：不与 I2S 平行走线；中间铺地；必要时走对面层并夹地平面。
2. **I2C 驱动强度**：FPGA 侧 `DRIVE=2`（已验证），外加 **330Ω 串联**（沿用现有做法），
   4.7k 上拉到 3V3；**球号放 J13（远离 BANK7 音频组）时 10 kHz 全速可用**（已实测）；
   若不得不留在 J8，则限制 SCL ≤3.3 kHz。
3. **ToF 连接器处**：VCC 放 **100 µF + 100 nF**（激光测距是脉冲负载，去耦是保险）；
   信号串 33–100Ω。
4. **光电电平转换**：现有方案是 S9012 射极跟随器（0.6V/3.3V，实测可用）。
   做板时建议升级为 **光耦隔离（PC817 + 1k）或比较器（LM339 分压）**：
   把 12V 侧与 3.3V 侧完全隔开，阈值也更干净。
5. **ESD**：键/光电/编码器都是**人手指碰的** → 所有对外 IO 加 TVS 阵列
   （如 4 通道 USBLC6 类），FPGA 侧串 100–220Ω。
6. **按键焊盘**：硅胶键用**梳齿（interdigitated）焊盘** + ENIG、不上阻焊；
   碳粒压下短路。齿距/间隙 0.3–0.5 mm。
7. **编码器**：用裸 EC11（A/B/C + 按压 SW/SW），10k 上拉 + 100 nF 到地（RTL 已有 1 kHz 去抖）。
8. **测试点**：P19 调试 UART、I2C SCL/SDA、3V3、12V、GND 各留一个焊盘；
   再留 2–3 个空闲 J13 球做飞线位。

### 2.4 ⚠️ 上板前必须确认的一件事

J13 是 **SDRAM0 总线引出座**。本次实测 38 路可当 3.3V GPIO，是因为 SDRAM 控制器未启用、
引脚呈高阻；**自绘板前请向 hank/Sipeed 确认该组信号上是否真的没有已焊的 SDRAM 器件**，
否则会有驱动冲突。

### 2.5 交付前自检（板上可做的）

- 逐键短路到 GND，看遥测 `K=` 位翻转（沿用 `hw_bringup` 的 SDRAMPROBE 思路）；
- I2C 扫描（0x08–0x77，只应 0x52 应答）；
- 插上耳机、把 `QUIET` 分别置 0/1/2/3 听一遍——**确认没有数字噪声**再交付。

---

## 3. 3D 打印外壳建议

### 3.1 结构拆分（推荐三件式）

1. **前面板**：键位孔 + ToF 视窗/隧道 + 光电叉架 + 旋钮孔；
2. **机身**：容纳 Tang Mega 底板（或分体时只放接口板）+ 走线槽；
3. **底板**：M3 热熔螺母 ×6、四个橡胶脚。

> **v1 建议做"分体"**：接口板做前面板，用 15–20 cm 排线连到底板（放桌面另一侧）。
> FPGA 底板体积大、发热、还要插 USB，塞进同一个盒子会让键位离手太远。

### 3.2 ToF 的开孔是整个外壳最关键的一处

这是本次实测最大的教训：**人坐在桌前就会进入 10–70 cm 量程 → 一直发声**。

- 把 ToF 装在**侧上方、朝外并上仰 5–10°**，让演奏者的身体落在量程外，只有伸出的手进入；
- 加 **20–30 mm 深的遮光隧道**（内壁哑光黑，喷漆或黑料），既收窄视场又挡杂散反射；
- 视窗用 PMMA/透明件或直接开孔（VB22B 是 940 nm 红外，多数耗材会衰减，开孔最稳）。

### 3.3 光电叉架

- 发射/接收对射，间距 60–80 mm，两只各开 3 mm 孔并做**内壁消光**；
- 12V 线与信号线分开走内部线槽，远离音频线与喇叭；
- 每个叉架留线缆固定点（扎带孔），避免杜邦线被拉脱。

### 3.4 键盘手感

- 硅胶片 2–3 mm + 碳粒，压在 PCB 梳齿焊盘上；行程 1–1.5 mm；
- 前面板键孔与硅胶片之间加 0.5–1 mm 垫圈控制行程；
- 需要更"钢琴"的手感时，改用 3D 打印 TPU 键帽 + 硅胶碗（成本高，先做硅胶片版本）。

### 3.5 装配与维护（容易漏的三点）

1. **DEBUG-USB2（Type-C）必须免拆可达** —— 否则每次烧写都要拆盒；
2. **PWR 键必须可达**（长按 2 秒开机）——开孔或做一个打印推杆；
3. **位流是 SRAM、掉电即失** —— 交付演示前要么每次重烧，要么经用户同意后写 Flash（op 9）。
   外壳上建议留一个"烧写口"盖板。

### 3.6 打印参数与材料

| 项 | 建议 |
|---|---|
| 材料 | PETG（韧性好、不脆）；前面板可选 SLS/MJF 提升键位精度 |
| 层高/壁厚 | 0.2 mm / 4 圈壁（≈1.6 mm），顶底 5 层，填充 25–30% |
| 结构 | 加强筋 + 热熔螺母柱；大平面加 0.2 mm 补偿防翘 |
| 内表面 | 音频腔与 ToF 隧道喷哑光黑，减少反射与共振 |
| 散热 | 核心板上方开 3–4 条 3 mm 槽（本设计负载很低，不需要风扇） |

---

## 4. 建议的里程碑

| 阶段 | 内容 | 判据 |
|---|---|---|
| **v0 面包板（现状）** | 13 键 + 1 光电 + 1 ToF + 1 EC11 | ✅ 已完成（MODE=3 验收通过） |
| **v1 单板 + 分体外壳** | 13 键 + 6 光电 + 2 ToF + 2 EC11 全上板；I2C 走 J13 | 6 弦音高正确、双 ToF 无地址冲突、QUIET 四档听感无噪声 |
| **v2 一体化** | 底板入盒、音频/喇叭内置、Flash 固化 | 上电即演奏、整机无外部飞线 |
