wongben2333-crypto/26Embedded/fpga_spark/lcd_test/docs/hardware/HARDWARE-DESIGN-SPEC.md

> **平台与状态（2026-11-04）**：最终整机 138K，60K 仅作早期 bring-up；PCB1、贴装、两件式 PETG 外壳已制造并完成整机联调；13 键、6 路光电、双路 ToF（A 主/B 热备）、7 寸触控均已实测；4 路 EC11 仅预留，不参与评分口径。PCB1 定位为“输入调理与隔离转接板”（上拉/限流/RC/PC817/ToF 供电/地分割），防爆音在 RTL+PA_EN，不在 PCB。

# 硬件总体设计规格

> 状态：2026-10-28 设计基线  
> 适用对象：面包板验证机、PCB v1、上下分件整壳及首件验收  
> 单位：除特别注明外均为 mm

## 1. 设计目标与边界

本硬件把 13 个琴键、6 路对射光电、2 只 ToF 距离传感器和 4 个预留 EC11 接入
Sipeed Tang Mega 138K Dock（60K 为早期 bring-up），由板上的 GW5AST-138C FPGA 运行 MODE=3 的 hank
TDM32 32 声部合成引擎。成品不依赖电脑即可发声；音频仍使用 Tang Mega Dock 板载
PT8211 与 3.5 mm 输出，不在自制转接板上重复设计音频电路。

设计采用“FPGA 原板 + 自制输入转接板 + 完全内置 PCB 的两件式外壳”：

- FPGA 原板作为主控制器和音频输出端，保留其已验证的电源与时序环境。
- 自制 PCB 只承担输入接口、保护/整形、连接器和机械承载。
- PCB 全部放进外壳，不作为底壳、外露面板或结构承力件。
- 上壳可拆；ToF 模块、承托座和下段导光筒留在下壳，拆上壳不牵动传感器线缆。
- 当前首件只打印整壳，不单独追打数字配合样件；配合件 STEP/STL/3MF 仍保留用于
  数字复核和以后补打。

本文给出整机事实和冻结边界。更细的逐针、逐器件信息分别见
[NETLIST.md](NETLIST.md)、[PCB-DESIGN.md](PCB-DESIGN.md)、
[BREADBOARD-BRINGUP.md](BREADBOARD-BRINGUP.md) 和
[ENCLOSURE-DESIGN.md](ENCLOSURE-DESIGN.md)。

## 2. 系统组成

| 子系统 | 型号或规格 | 数量 | 设计作用 |
|---|---|---:|---|
| FPGA 底板 | Sipeed Tang Mega 138K Dock，GW5AST-138C（60K 为早期 bring-up） | 1 | 合成、I2C、音频、调试与扩展 IO |
| 音频 | 底板 PT8211 + 3.5 mm 输出 | 1 套 | I2S 3.125 MHz，采样率 97 656.25 Hz |
| 主键盘 | 四脚直插轻触开关，8.5×7.8 mm 最大本体包络，针距 4.5 mm | 13 | C4–C5 单八度、8 白键 + 5 黑键 |
| 对射光电 | E3F-20C1，12 V，棕/蓝/黑三线 | 6 | 六根固定音高“弦”；6 路光电均已实测 |
| 光电隔离 | PC817 | 6 | PCB v1 将 12 V 黑线隔离到 3.3 V 逻辑域 |
| ToF | VB22B，31×15×6.2 mm，3.3 V、约 40 mA、I2C 地址 0x52 | 2 | 双轴向上；ToF A 主用音高，ToF B 热备用，双路已实测 |
| 旋转编码器 | EC11，5 脚，A/B 正交，无按压 | 4（预留） | 本版不使用；音量由触屏/上位机 CC7 控制 |
| 自制 PCB | 100×70×1.6 mm，2 层，FR-4 | 1 | 13 键、6 光电、2 ToF、4 预留 EC11 的接口与保护 |
| 外壳 | 下壳 + 上壳/键床，PETG FDM | 1 套 | 琴键导向、ToF 遮光、PCB 承载和线缆出口 |
| FPGA 排线 | 40 位、2.54 mm、成品预压接 IDC | 1 条 | J13/CN2 到 FPGA；标准插头包络约 55.4×6.1×10.7 mm |

### 2.1 琴键

- 排列为一个半音阶八度：C4、C#4、D4、D#4、E4、F4、F#4、G4、G#4、
  A4、A#4、B4、C5，MIDI 60–72。
- 开关完整高度从 PCB 顶面算起 5.0 mm，按压行程约 2.0 mm。
- 开关本体按 8.5×7.8 mm 包络，柱塞约 Ø3.5 mm，四针按 4.5 mm 方阵布置。
- 键帽由 3D 打印件提供杠杆外观；每键前后双 Ø2.2 mm 导柱，键帽对应
  Ø2.5×2.8 mm 盲孔，用于抑制前后倾斜与上跳。
- 按键按下为低，FPGA 内部上拉；每路在 PCB 上串 220 Ω、对逻辑地并
  100 nF。串联电阻与电容放在 PCB 底面，避免侵入键床覆盖区。

### 2.2 光电“弦”

- E3F-20C1 由独立 12 V 电源供电。棕线为 +12 V，蓝线为 0 V，黑线为
  传感器输出。
- 黑线不是纯开集：模块内部存在约 15.6 kΩ 上拉，摆幅可从 0 V 到 12 V，
  **绝不能直接接 FPGA**。
- 面包板阶段使用 S9012 射极跟随器验证逻辑；PCB v1 改用 PC817。
- PCB 输入侧每路用 1.2 kΩ 限制 PC817 LED 电流；输出侧用 10 kΩ 上拉、
  220 Ω 串联和 100 nF 对地。
- 12 V 侧使用 `GND12`，逻辑侧使用 `GND`。两者只通过 `R15=0 Ω` 单点连接。
- 六路总电流实测远低于 0.3 A；12 V 主干仍按 ≥0.8 mm 和固定线束设计。

### 2.3 ToF

- 实物包络固定为 31×15×6.2 mm，外壳安装腔每侧留 0.30 mm，即
  31.60×15.60 mm。
- 两只模块均为 3.3 V、约 40 mA、地址 0x52，器件 ID 寄存器 0x03 回读 0x4A。
- 两只不能挂同一条总线；计划使用两条独立 I2C，各自 4.7 kΩ 上拉和
  330 Ω 串联。
- 模块四针顺序固定为 SCL、SDA、+3V3、GND。线从模块窄边引出，外壳在
  朝向键盘中心的一侧留 12×3.6 mm 走线窗。
- 两只模块装入后轴线都朝整机 +Z，不采用一横一上的旧方案。
- 下壳承担 1.5 mm 承托底、模块座、下段导光筒和线缆；上壳只承担
  Z=22.124 mm 以上的上段遮光筒。

### 2.4 EC11（预留）

- 四只 EC11 均为 5 脚模块：VCC、GND、A、公共端 C、B；没有按压开关。
- VCC 必须为 3.3 V。A/B 每路串 100 Ω、用 10 kΩ 上拉到 3.3 V，并对地放
  100 nF。公共端 C 按实测模块内部接法处理，PCB 当前不引入 SW 网络。
- EC1 已接入音量；EC2–EC4 的 PCB 网络与 J13 球号已经规划，但当前 cst/RTL
  尚未全部闭环，不能把“PCB 有走线”误写成“固件已验收”。

## 3. 电气架构

### 3.1 电源域

| 电源域 | 来源 | 主要负载 | 边界 |
|---|---|---|---|
| `+12V` | 外部 12 V 开关电源，经 CN1 | 6 组 E3F 与 6 只 PC817 LED | 绝不进入 FPGA IO 或 3.3 V 网络 |
| `GND12` | 12 V 电源回流 | 光电和 PC817 输入侧 | 只在 12 V 入口经 R15 与逻辑地单点连接 |
| `+3V3` | 底板 J8-1/2 经 J13/CN1 侧 H3 和 F1 | ToF、EC11、上拉及保护器件 | 来自 FPGA 板，不在自制板上从 12 V 稳压 |
| `GND` | FPGA J8/J9/J13-12 | FPGA IO、ToF、编码器和输入调理与隔离 | 连续逻辑地 |

F1 为 0.5 A 保持电流 PTC，原理图位号 F1。当前低成本受控样机不装输入反接
P-MOS、12 V 保险丝和 ESD 阵列；这些增强方案保留在
[PCB-POWER-ESD.md](PCB-POWER-ESD.md)，装配前不能把“建议 BOM”误当成已贴器件。

### 3.2 FPGA 接口

- 所有自制板输入经 2×20、2.54 mm 的 J13/CN2 返回 FPGA。
- J13-11 是底板 `5V_Peripheral`，必须 NC 并在板上有醒目的
  `DO NOT CONNECT 5V` 标记。
- J13-12 是 GND。
- 13 键占 J13-1–10、13–15；6 光电占 16–21；EC1 占 22–23；
  ToF A 占 24–25；EC2 占 26–27；ToF B 占 29–30；EC3 占 37–38；
  EC4 占 39–40；28、31–36 为备用。
- J13-29/30 在底板上经 R68/R69 0 Ω 连到 SDRAM0 的 DQM0/DQM1，
  使用前确认这两个 0 Ω 已装。

完整球号、网络名和方向见 [NETLIST.md](NETLIST.md)。任何改线必须先对照该表和
`constr/fpga_hank_60k.cst`，不能按排针外观猜脚位。

### 3.3 信号完整性约束

- ToF 总线 A 已从 J8 的 AB22/Y21 迁移到 J13-24/25。J8 旧位置与 I2S
  同属 BANK7，曾导致音频出现尖噪声；PCB 必须保持新位置。
- I2C 使用双向 `inout` 与三态，不能拆成独立输入端口。
- 两路 I2C 不并线、不共享上拉节点；I2C 保护器件必须低电容，且不能在
  SCL/SDA 上直接加大电容。
- 所有外部低速输入进入 FPGA 前保留串联电阻。
- 12 V/GND12 与 3.3 V/逻辑区域之间保留至少 1.5 mm 间距或隔离带。

## 4. 机械与装配意图

- PCB 顶面 Z=14.4 mm，底面 Z=12.8 mm；板完全位于下壳内。
- 下壳外形 130×109×22.124 mm；上壳主平面 140×109×26.2 mm，
  40P 服务拱盖局部最高 Z=27.0 mm。
- 上壳、下壳和 ToF 最外缘统一落在后侧 Y=54.5 mm；两只 ToF 之间不凹进，
  前侧以 ToF 最外侧为基准形成连续大平面。
- 13 键放在 PCB 前中部；ToF 在琴键后方左右各一只；J13/40P 在后部中央。
- 键床板 98×53.575×2 mm，后缘 +26.775、前缘 -26.8，位于 PCB 与键帽之间。
  13 个通孔为 9.2×8.3 mm，底面另有焊盘让位；PCB 前侧保留 8.2 mm 裸露带。
- 上盖键盘开口 97×49.5 mm；键床左右各有 0.5 mm 上盖压边，前后完全覆盖。
  键床用 4 个 Ø1.6 mm 定位柱与上盖 Ø2.0 mm 盲孔配合，限制水平位移。
- 壳体与 PCB 固定均用 M3 塑料自攻螺丝，不使用热熔螺母。上下壳 M3×10，
  PCB M3×8，底孔统一 Ø2.5 mm。

外壳的完整尺寸、出口和打印检查见 [ENCLOSURE-DESIGN.md](ENCLOSURE-DESIGN.md)
与 [../enclosure/MODELING-NOTES.md](../enclosure/MODELING-NOTES.md)。

## 5. 演奏语义与固件边界

已上真板验证的 MODE=3 行为：

- 13 键产生 MIDI 60–72，vel=100，按下/松开对应 note-on/off。
- 6 路光电挡光产生 note 40（E2），vel=110，松开产生 off；
  2 ms/8 ms 非对称去抖。
- ToF A 在有效距离内按 24 mm/半音量化到 60–84，5 点中值、±20 mm 迟滞，
  入场驻留 3 次采样，换音间隔至少 180 ms；超过 800 mm 持续 200 ms 或
  NACK 500 ms 后离场。
- EC1 每格 4 步改变 0–127 音量，采用 dB 感知 LUT；127 为直通。
- 事件 FIFO 深 16、串行化间隔至少 16 clk，避免引擎无输入队列时丢音。
- ToF 禁用引擎全局 glide，防止它复用其他声部的 `last_voice`。

PCB 已规划、但当前 cst/RTL 尚未全部验证的输入是光电 2–6、EC2–EC4 和
ToF B。设计目标仍是六弦、双 ToF、四编码器；首版上电时必须把“硬件能力”
和“固件闭环”分开记录。

演奏意图和当前实施偏差详见 [INSTRUMENT-MAPPING.md](INSTRUMENT-MAPPING.md)。

## 6. 当前已验证状态

| 项目 | 状态 |
|---|---|
| 13 键完整音符与 32 声部和弦 | 已上真板验收 |
| 6 路光电 | 已上真板验收 |
| ToF A 音高链路 | 已上真板验收 |
| EC11（预留） | 预留接口 |
| 双 ToF、六光电 | 已实测（A 主/B 热备） |
| 100×70 板框及实际 3D 回装 | 数字检查通过 |
| 两件式整壳、键床、ToF 分件、线缆窗口 | 数字几何与 DfAM 检查通过 |
| 实体 PCB、实体外壳和线束装配 | 已制造并装配 |

## 7. 不能违反的硬约束

1. J13-11 永远悬空，J13-12 必须接地。
2. 12 V 不直接进入任何 FPGA IO、ToF、EC11 或 3.3 V 网络。
3. ToF 总线 A 保持在 J13-24/25，不在 J8 的 AB22/Y21 恢复 I2C。
4. 两只 ToF 必须使用独立的 I2C 总线。
5. PCB 保持 100×70×1.6 mm、R3 外形和 X=±44、Y=±28 的 Ø3.4 孔。
6. PCB 完全内置；壳体承力，不能用 PCB 外露当底壳。
7. 键床覆盖区顶面不得放高器件、裸露测试点或导柱接触铜。
8. 拆上壳不能牵动 ToF 模块、承托座或四芯线。
9. 40P 后侧通道必须容纳两端已压接的成品 IDC 插头。
10. 任何实物首件问题都必须先修改设计；不能把数字检查 PASS 直接当作可交付结论。
11. 安装键床前必须把 H5（X=-37.34..-24.64、Y≈-25.02）朝上残留引脚剪平至
    PCB 上表面或更低；键床在该区域不设通窗。

## 8. 尚未闭环、会阻断生产的项目

- 13 个开关的真实正式封装、柱塞截面和键帽垂直锁紧结构。
- 键床定位柱与上盖盲孔的实际插拔手感；当前结构限制 X/Y，但仍需实物验证垂直松动。
- 实际采购 IDC 插头若带应变释放套，是否仍能通过 56.8×12 mm 后口。
- 40P 排线最小弯曲半径、盒内固定和压线片结构。
- ToF 镜头中心、安装孔/卡槽以及四芯线在 12×3.6 mm 窗口内的弯曲半径。
- EC11 外面板、固定耳、端子形式与应力释放。
- PCB 的 ERC/DRC、BOM、贴片坐标、Gerber 双钻孔去重。
- 实体首件的按键行程、回弹、壳体错边、螺丝咬合和整机干涉。

这些不是“文档整理遗留”，而是真正影响下单、打印或首件验收的工程输入。

## 9. 文档阅读顺序

1. 想知道整机为什么这样设计：本文。
2. 要复现面包板：`BREADBOARD-BRINGUP.md`。
3. 要检查或修改 PCB：`PCB-DESIGN.md` → `NETLIST.md` →
   `PCB-SCHEMATIC-SPEC.md`。
4. 要打开 CAD 或打印：`ENCLOSURE-DESIGN.md` →
   `../enclosure/MODELING-NOTES.md`。
5. 要下单、装配或验收：`MANUFACTURING-AND-ACCEPTANCE.md`。
6. 要追溯旧方案：`archive/README.md`。
