wongben2333-crypto/26Embedded/fpga_spark/lcd_test/docs/hardware/ENCLOSURE-DESIGN.md

# 整机外壳与键床设计

> 状态：2026-10-28 硬件确认版数字模型、实际 PCB 回装和 DfAM 检查完成；尚无实体首件  
> 当前打印策略：只打印上下整壳，不单独追打配合样件  
> 单位：mm

## 1. 设计意图

外壳把 Tang Mega 60K、输入 PCB、13 键、两个 ToF、六路光电线束和四组编码器线束
整合成一台可直接摆放、无需电脑的乐器。设计遵循以下原则：

- **整体美观**：前面以 ToF 筒最外侧为基准形成连续大平面，两筒之间不凹进；
  上盖主平面连续，只在 40P 接口上方做必要的局部拱盖。
- **实用**：PCB 完全内置，壳体承力；上壳可拆；拆上壳时 ToF 模块和线缆不移动；
  所有线束都有明确出口和压线位置。
- **节约**：保留 Tang Mega 原板音频，采用 2 层转接板和 PETG FDM；统一 M3
  自攻螺丝；只在必要处增加局部避让和拱盖。

该版本不再使用旧的三件式外壳、热熔螺母、硅胶片琴键或“一横一上”的 ToF 布局。
旧内容只保留在 `docs/archive/` 和中国 STD 原文件参考目录。

## 2. 坐标与整体尺寸

全局坐标原点在下壳最低平面中心：

- `+X`：面向整机时向右。
- `+Y`：指向 ToF/FPGA/J13 所在后侧。
- `+Z`：向上。

| 部件 | 包络或关键基准 |
|---|---|
| 下壳 | 130.000×109.000×22.124 |
| 上壳主平面 | 140.000×109.000×26.200，圆角 R18 |
| 40P 局部服务拱盖 | 60×9，最高 Z=27.000 |
| 下壳底板 | 厚 2.5 |
| 下壳壁厚 | 2.5 |
| PCB | 100×70×1.6，顶面 Z=14.4、底面 Z=12.8 |
| 键床板 | 98×53.575×2 |
| 白键最高面 | Z=24.200 |
| 黑键最高面 | Z=26.200 |
| ToF 外光窗 | Z=26.200 |
| 上/下壳和 ToF 最外缘 | 后侧统一为 Y=54.5 |

ToF 筒最外侧是整机后侧基准。上壳、下壳和两个 ToF 筒都延伸到同一 Y=54.5，
两筒中间不再向内凹。前侧壳体也以 ToF 最外基准形成一整片连续平面，扩大内部空间。

## 3. 两件式结构

### 3.1 下壳

下壳承担：

- 底板和四周侧壁；
- 4 个 PCB 支撑柱和 2 条 PCB 下方支承筋；
- 4 个上下壳固定柱；
- 两个 ToF 的 1.5 mm 承托底、模块座、下段导光筒和内侧走线窗；
- 后侧 40P 服务口、左右辅助线窗、前侧光电/12V 与编码器窗口；
- 对应压线片螺丝孔。

### 3.2 上壳

上壳承担：

- 上盖主平面和琴键开口；
- 键床板、13 个键帽和每键双导柱；
- Z=22.124 mm 以上的 ToF 上段导光筒、光窗上段；
- 40P 上方的局部服务拱盖；
- 四角螺丝沉孔。

上壳和键床为可拆件。PCB 始终位于壳体内，不以 PCB 充当底板或侧壁。

## 4. 琴键和键床

### 4.1 开关

- 四脚直插轻触开关，本体按最大方向取 8.5×7.8 mm。
- PCB 顶面到开关最高点 5.0 mm，按压行程约 2.0 mm。
- 脚距 4.5 mm，柱塞约 Ø3.5 mm。
- 键床通孔 9.2×8.3 mm，宽度方向名义 0.35 mm、深度方向 0.25 mm 间隙；
  对 8.7×8.0 mm 最大来料仍有单边至少 0.15 mm。
- 底面增加 10.6×10.6×0.8 mm 焊盘/焊锡让位。A4 与 G4 之间唯一 11.25 mm
  键距会在两个 10.6 mm 让位之间留下 0.65 mm 薄墙，因此局部连通两者，消除
  该薄墙但保留 1.2 mm 连续顶板。
- 键帽插孔 Ø3.70 mm、深 3.20 mm；全压时帽底距键床顶面仍余 1.0 mm。

### 4.2 琴键布局

13 键为 C4–C5 单八度，8 白键 + 5 黑键。键床没有改变成两组左右分键，
而是保持一排钢琴布局，以适配 100 mm PCB。

白键中心 X：

```text
C4   D4   E4   F4   G4   A4   B4   C5
-40.25 -28.75 -17.25 -5.75 +5.75 +17.00 +28.75 +40.25
```

黑键中心 X：

```text
C#4  D#4  F#4  G#4  A#4
-34.50 -23.00 0.00 +11.50 +23.00
```

所有开关中心 Y：

- 白键：0。
- 黑键：+9.2715。

原键盘 STL 包含 11 白键 + 7 黑键并有 16 条非流形边，不能直接布尔成最终键床。
新键床沿用其外观比例，但缩放为白键宽 10.50、名义中心距 11.50、黑键宽
5.62 mm。实际 A4 为 X=+17.00，因此相邻白键距为 11.25/11.75 mm。

### 4.3 防倾斜和前悬伸

每键增加前后两根 Ø2.20 mm 导柱，中心距 24.00 mm，直接落在 PCB 顶面。
键帽对应 Ø2.50×2.80 mm 盲孔：

- 静止插入约 0.40 mm。
- 全压插入约 2.40 mm。
- 孔底仍余约 0.40 mm。

双导柱把长键帽前后摆动理论上限从单柱约 3.58° 降到约 0.72°。黑键导柱到帽端
仍有约 1.40 mm 实体边。当前判断前后平衡和按压倾斜在几何上可接受，但必须用
实体键帽、真实回弹开关和 2 mm 行程验证。

键床后缘保持在 Y=+26.775，前端延伸到 Y=-26.800，总深 53.575 mm。
上壳开口为 97×49.5 mm，因此键床左右各伸入上盖下缘 0.5 mm，前后分别
覆盖开口约 2.05/2.03 mm。PCB 前端 Y=-35.000 至键床前端 Y=-26.800
保留 8.2 mm 裸露带，供朝下排针的线缆通过。

### 4.4 锁固

取消“止口直接抵住 J13”的方案，避免把键床冲击力传给连接器焊点。键床增加
4 个 Ø1.6 mm 向上定位柱，分别位于
`(-25,-25.7)`、`(+25,-25.7)`、`(-35,+25.7)`、`(+35,+25.7)`。
上盖前/后加强筋下各有对应的 3.4×2.9 mm 局部凸台和 Ø2.0×1.25 mm
盲孔。最终实体测量：柱尖 Z=19.000，实际插入 **0.876 mm**，孔底余量
**0.374 mm**，键床与上盖求交体积 **0 mm³**。定位柱与键帽的最小水平净距
为 0.625 mm。

该结构限制 X/Y 位移，但不等同于垂直锁紧。首件仍必须检查：

- 定位柱是否能顺畅进入盲孔；
- 键床是否仍有可感知的前后/左右位移；
- 键帽上跳和键床垂直松动；
- 导柱磨损；
- 开关孔与壳体的长期对齐；
- 是否需要增加卡扣或单独垂直压紧结构。

## 5. PCB 承载

- 四个 M3 支撑柱支撑 PCB 四角安装孔，位置与 PCB `X=±44、Y=±28` 一致。
- 两条宽 3.0 mm 的横向支承筋用于限制 PCB 中部下沉。前侧筋仍在 Y=-28；
  后侧筋在 H2 的 X=-42..-32 范围内向 Y=24.8..27.8 局部折转，避开
  已翻到板下的排针。
- H2/H3/H4/H14 朝下焊接后，下壳对应支撑柱/筋按本体+引脚包络让位；
  局部包络外扩 0.40 mm，以保证曲面支撑柱处的实际最近间隙不低于 0.30 mm。
  实测本体最小间隙均为 0.400；引脚最小间隙分别为 H2 0.992、H4 1.030、
  H3 0.541、H14 0.332。
  四角 M3 柱位 `X=±44、Y=±28` 不变。
- PCB 安装用 M3×8 塑料自攻螺丝，下壳底孔 Ø2.5。
- 上下壳用 M3×10 塑料自攻螺丝，上壳孔 Ø3.4，沉孔 Ø6.2×2.0。
- 不使用热熔螺母。
- 螺丝头建议不超过 Ø6.0、头高不超过 2.0。

键床覆盖区现为 `X=-49..+49`、`Y=-26.8..+26.775`。该范围内 PCB 顶面除
13 个开关和导柱接触点外不得有高器件或裸露铜；当前 Gerber 的朝下排针位于
板底，不占该区间高度。

H5 位于 `X=-37.34..-24.64`、`Y≈-25.02`，其焊盘突出物会进入键床前伸区。
最终方案不做键床通窗，而是在装配前把 H5 朝上残留引脚剪平至 PCB 上表面或更低。
该操作列为强制装配步骤，不满足时不得安装键床。
导柱接触点至少保留 Ø3.0 mm 无铜区，防止磨穿阻焊后短路。

## 6. ToF 安装和上下分件

### 6.1 模块与位置

- 模块实物：31×15×6.2 mm。
- 安装腔：31.60×15.60 mm，即每侧 0.30 mm 间隙。
- 两只中心：`X=-45、Y=45` 和 `X=+45、Y=45`，中心距 90。
- 两只模块均以 +Z 为发射方向。
- 下壳承托底厚 1.5，模块位于 Z=1.5..7.7。
- 模块顶面以上导光净深 18.5。

### 6.2 上下分件

分件面为上下壳共同接缝 Z=22.124 mm：

- 下壳保留模块承托底、模块座、下段导光筒、内侧走线窗和线缆通道。
- 上壳只保留 Z=22.124..26.200 的上段导光筒和光窗。
- 拆上壳时，ToF 模块、四芯线和 PCB 侧连接器都留在下壳，不会拉扯走线。
- 四角 M3 螺丝同时提供上下壳和上下筒的对齐基准；当前没有额外卡扣。

### 6.3 光窗和出线

- 每只光窗为 29×13 mm，四角 R1。
- 模块四周保留约 1 mm 止挡边，光窗比模块包络大，以吸收镜头和装配偏差。
- 每只模块的内侧窄边开 12×3.6 mm 走线窗，窗口上下各保留约 1.3 mm。
- 四芯线只能从内侧窄边引出；不设底部或后部备用出线槽。
- 筒内和光窗建议喷哑光黑，减少串光和反光。

## 7. 线缆出口

| 用途 | 所在面/中心 | 开口 | 中心 Z | 说明 |
|---|---|---|---:|---|
| 40P FFC/IDC 服务口 | 后壁 X=0 | 56.8×12.0 | 14.0 | 允许两端预压接的 IDC 插头通过 |
| 40P 左辅助窗 | 左壁 Y=+29.5 | 12.0×8.0 | 12.0 | 后侧分支/维护 |
| 40P 右辅助窗 | 右壁 Y=+29.5 | 12.0×8.0 | 12.0 | 镜像布置 |
| 光电 + 12 V | 前壁 X=-28 | 44×17 | 11.5 | 6 路光电、12 V 及其回流 |
| 四路编码器 | 前壁 X=+28 | 36×14 | 11.0 | EC1–EC4 固定线束 |

### 7.1 40P 接口

J13/CN2 实际包络 58.4×8.91×12.2 mm。线端采用标准 40P IDC 预压接插头，
参考包络 55.4×6.1×10.7 mm；Multicomp MC-254-40-00-00-IDC 对应总长约
55.48 mm，排针跨距 48.26 mm。

后侧 56.8×12 mm 口给标准插头宽度留 1.4 mm、高度留 1.3 mm。上壳局部服务拱盖：

- 内避让顶面 Z=25.6。
- 插头顶部 Z=25.1。
- 净空 0.5。
- 拱盖顶壁 1.4，最高 Z=27.0。

这解决了插头在盒内向上顶壳的问题，同时保留键床和 ToF 高度。插头两端都已压接时，
装配顺序为：

1. 取下上壳。
2. 将外侧插头从盒内穿出后侧服务口。
3. 固定 PCB，并把盒内插头接到 J13。
4. 安装压线片/应力释放件。
5. 合上上壳并锁四角 M3。

### 7.2 前侧线束

6 路光电共 12 根直径约 3.5 mm 导线，再按 2 根 Ø3.5 mm 的 12 V/GND 保守占位，
理论总截面积约 134.69 mm²。44×17 mm 口面积 748 mm²，约为其 5.55 倍。

前侧两个大开口之间保留 16 mm 实体壁带。每个窗口附近保留压线片孔，当前孔径
Ø2.2；后侧 40P 口的下部压线孔为 X=±18、Z=4，避开主开口。所有开口按完整壁厚
做贯通检查，不只检查表面图形。

正式端子、线缆弯曲半径、护套和防水/防尘等级尚未选型，首件必须用实际线束复核。

## 8. 装配顺序

1. 检查下壳 ToF 承托座、1.5 mm 底、下段筒和内侧走线窗。
2. 将两只 ToF 从上方放入下壳，落到底，四芯线经内侧窄边引出。
3. 安装 PCB，接好 ToF A/B、光电、12 V 和 EC 线束。
4. 从盒内穿出后侧 40P 外侧 IDC 插头，接到 PCB 端并固定压线片。
5. 安装四个角部的 PCB M3×8 自攻螺丝。
6. 再次确认 H5 朝上脚已剪平至 PCB 上表面或更低。该步骤为强制要求。
7. 安装键床、13 个键帽和前后导柱，检查静止/全压行程和上跳。
8. 合上上壳，使 ToF 上下筒和壳体接缝对齐，锁四角 M3×10。
9. 先做机械检查，再通 3.3 V、12 V 和 FPGA。

任何情况下都不通过拉动线束来拆卸上壳或 ToF。

## 9. 数字检查结果

`enclosure/checks/` 下的当前检查全部通过：

- 上下壳是单一、正体积、零自由边、零非流形拓扑实体。
- 上下壳接缝距离为 0。
- PCB、键床、J13、真实 3D PCB、ToF 模块无意外相交。
- PCB 完全位于下壳内，由四个支撑柱接触承托。
- 5.0 mm 总高、2.0 mm 行程、全压余量 1.0 通过。
- 两轴均 +Z，光路无遮挡。
- 两个 29×13 mm 光窗和两个 12×3.6 mm 走线窗贯通探针重叠为 0。
- ToF 分件后上壳在 Z=22.124 以下与下壳 ToF 座区域重叠 0。
- 五个主出口和六个压线片孔均为完整壁厚贯通。
- PCB DXF 的 100×70 板框与四个 Ø3.4 孔位正确。
- Gerber 板框、开关中心、CN2/J13、前端连接器与外壳对齐。
- 55.4×6.1×10.7 mm IDC 包络与上壳无重叠。

这些是数字几何结论，不是对到货开关、镜头位置、线材弯曲或打印精度的验收。

## 10. FDM 和嘉立创服务

按 PETG、0.2 mm 层高、45° 自支撑规则：

| 部件 | 体积/壁厚 | 悬垂和支撑 |
|---|---|---|
| 上壳 | 约 39.0 cm³；`p05=2.00`，最小采样 0.04（尖锐边框采样点） | 当前姿态悬垂约 35%；翻面约 34.8%；侧立可降至约 3.8% |
| 下壳 | 约 67.0 cm³；`p05=1.70`，最小采样 1.50 | 当前姿态悬垂约 1.3%，支撑估算约 14.9% |
| 键床板 | 约 8.5 cm³；`p05=1.20`，最小采样 0.90 | 反转到开口向上的平放姿态，构建高 5.4，悬垂约 3.8% |

建议下壳维持当前开口向上的姿态；键床板将 PCB 接触面朝下、开口朝上平放。
上壳若以可见顶面朝下打印，需要较多支撑；若打印机高度允许，侧立姿态能明显
减少支撑，但 140 mm 构建高与表面纹理会变差，应在切片中比较后选择。前侧
44 mm 和 36 mm 开口的顶边会有较长桥接，切片时检查下垂。

当前外壳不能依赖嘉立创免费 3D 打印券：上壳 140 mm、下壳 130 mm 均超过常见的
单轴 100 mm 免费门槛，且下壳 67.0 cm³ 也接近常见 70 cm³ 上限。应按付费打印或
更大幅面设备评估；下单纯前再次确认当期活动规则、材料和最大成型尺寸。

原 STL、ZIP 和参数化源文件不互相覆盖。生成模型使用锁定版本的 `cadgen`，
详见 [../enclosure/src/README.md](../enclosure/src/README.md)。

## 11. 打印前仍要确认

1. 开关真实封装、柱塞截面、键帽锁合与回弹。
2. 四个键床定位柱与上盖盲孔的实际插拔手感、长期松动和垂直压紧。
3. ToF 镜头中心、安装孔/卡槽和实际出线弯曲半径。
4. IDC 线端是否带额外护套/锁扣，是否仍能通过 56.8×12 mm 口。
5. 40P 排线最小弯曲半径和压线片形式。
6. EC11 外面板、端子、固定耳和线缆应力释放。
7. 打印机有效工作区、上壳支撑拆除工艺和首件错边。

当前版本可以作为整壳首件打印候选，但还不能标记为“最终量产外壳”。
