wongben2333-crypto/26Embedded/fpga_spark/lcd_test/docs/hardware/PCB-DESIGN.md

# 主输入 PCB 设计

> 状态：Gerber 与 3D 已收到，机械回装通过；制造包仍需闭环  
> 设计日期：2026-10-27  
> 板级器件依据：`../3D_PCB1_2026-10-27.step`  
> 制造依据：`../Gerber_PCB1_2026-10-27.zip`

## 1. 设计意图

本板不是新的 FPGA 核心板，而是一块把演奏输入集中到 Tang Mega 60K Dock
J13 的固定安装转接板。其目标是：

1. 把 13 键、6 路 12 V 光电、2 只 ToF 和 4 只 EC11 连接到已验收的 FPGA 工程。
2. 在有限板宽 100 mm 内维持 C4–C5 的单八度键位，不用横向扩展板来换空间。
3. 对 12 V 光电提供明确隔离，对慢速外部信号提供串联电阻和必要滤波。
4. PCB 完全藏入壳内，由下壳支撑柱承力，前面板不依赖 PCB。
5. 连接器集中在 PCB 前后边缘，线束可从壳体大窗口出入并做应力释放。

音频合成、PT8211 和 3.5 mm 接口继续使用 Tang Mega 原板；本板不重做音频。

## 2. 文件基线和追溯

| 文件 | 作用 | SHA-256 |
|---|---|---|
| `Gerber_PCB1_2026-10-27.zip` | 板框、铜层、阻焊、丝印、钻孔 | `12E0087CDD879E0BD927E60772B862EF2B89EF3A4BB4B88E95708D26DBFC2A87` |
| `3D_PCB1_2026-10-27.step` | 真实板级 3D 与装配复核 | `7B84827BBC2F2C9EFB078D1A2C334A1F19FF96B07639DCA9A343151B20EF5833` |
| `Netlist_Schematic1_2026-10-24.tel` | 原理图导出的 Telesis 网表 | `A48C1DF446CAD5ECF2BB7769867A8C253D325A8BD0F67FACFFC00F3A8E661195` |

`3D_PCB1` 中可识别 13 个 `SW`、31 个 `C`、57 个 `R`、6 个 `U`、14 个
`H`、`CN1`、`CN2`、`F1` 和 `LED1`。这些是 3D 标签计数，不等于完整可下单
BOM；元件值、封装、DNP 状态和替代料仍须由 EDA BOM 确认。

按逐通道电路可解释的阻容数量如下：

| 功能 | 电阻 | 电容 | 有源/器件 |
|---|---:|---:|---|
| 13 键 | 13×220 Ω | 13×100 nF | 13×四脚开关 |
| 6 路光电 | 6×1.2 kΩ、6×10 kΩ、6×220 Ω | 6×100 nF | 6×PC817 |
| ToF A/B | 4×4.7 kΩ、4×330 Ω | 2×100 µF、2×100 nF | 2×四针接口 |
| 4 路 EC11 | 8×100 Ω、8×10 kΩ | 8×100 nF | 8 路 A/B 输入 |

以上已解释 55 个电阻、29 个电容；3D 总计为 57 个电阻、31 个电容。
差出的 2 个电阻和 2 个电容必须在正式 BOM 中标明用途（例如电源指示/测试网络），
当前文档不凭标签猜值。

## 3. 板框和装配基准

| 项目 | 冻结值 |
|---|---|
| 外形 | 100.0×70.0 mm，四角 R3.0 |
| 板厚 | 1.6 mm |
| 层数 | 2 层，FR-4，Tg 130 或以上 |
| 铜厚 | 外层 1 oz |
| 坐标原点 | PCB 几何中心 |
| `+X` | 面向顶面时的右侧 |
| `+Y` | 指向 ToF/FPGA/J13 的壳后侧 |
| `-Y` | 光电、12 V 和编码器的壳前侧 |
| 安装孔 | 4×Ø3.4 mm NPTH，`(-44,±28)`、`(+44,±28)` |
| 整机 Z | PCB 顶面 14.4 mm，底面 12.8 mm |
| 固定 | M3×8 塑料自攻螺丝，壳体底孔 Ø2.5 |

四个安装孔周围保留 Ø8 mm 无元件、无铜、无通孔区。PCB 建议绿色阻焊、白色字符、
无铅喷锡，普通信号最小 0.20/0.20 mm，3V3 主干 ≥0.50 mm，12 V 主干 ≥0.80 mm。
12 V/GND12 与逻辑区间距至少 1.5 mm。

## 4. FPGA 接口 J13/CN2

J13/CN2 为 2×20、2.54 mm。Gerber 放置原点为 `(0,+32.004)`，实际 3D 包络
58.4×8.91×12.2 mm，中心约 `(0,+32.104)`，向板后边外延伸约 1.56 mm。

| J13 针 | FPGA 球 | 网络 | 状态 |
|---:|---|---|---|
| 1 | E14 | `key_hw[0]` | 已验证 |
| 2 | E13 | `key_hw[1]` | 已验证 |
| 3 | C15 | `key_hw[2]` | 已验证 |
| 4 | C14 | `key_hw[3]` | 已验证 |
| 5 | B13 | `key_hw[4]` | 已验证 |
| 6 | C13 | `key_hw[5]` | 已验证 |
| 7 | A14 | `key_hw[6]` | 已验证 |
| 8 | A13 | `key_hw[7]` | 已验证 |
| 9 | B16 | `key_hw[8]` | 已验证 |
| 10 | B15 | `key_hw[9]` | 已验证 |
| 11 | — | `5V_Peripheral` | **禁止连接** |
| 12 | — | `GND` | 必须接地 |
| 13 | A16 | `key_hw[10]` | 已验证 |
| 14 | A15 | `key_hw[11]` | 已验证 |
| 15 | A20 | `key_hw[12]` | 已验证 |
| 16 | B20 | `photo_hw[0]` | 音乐链路已验证 |
| 17 | A21 | `photo_hw[1]` | cst 已有，待接线闭环 |
| 18 | B21 | `photo_hw[2]` | cst 已有，待接线闭环 |
| 19 | B18 | `photo_hw[3]` | cst 已有，待接线闭环 |
| 20 | B17 | `photo_hw[4]` | SDRAM clk 球，只可慢速静态输入 |
| 21 | C17 | `photo_hw[5]` | cst 已有，待接线闭环 |
| 22 | D17 | `ec1a` | 已验证 |
| 23 | A19 | `ec1b` | 已验证 |
| 24 | A18 | `scl_tof` | 已验证；`DRIVE=2` |
| 25 | D15 | `sda_tof` | 已验证；`DRIVE=2` |
| 26 | D14 | `ec2a` | PCB 规划，待 cst/RTL |
| 27 | D16 | `ec2b` | PCB 规划，待 cst/RTL |
| 28 | — | 备用 | 保留 |
| 29 | F14 | `scl_tof_b` | 经底板 R68 0 Ω，待固件闭环 |
| 30 | F13 | `sda_tof_b` | 经底板 R69 0 Ω，待固件闭环 |
| 31–36 | — | 备用 | 保留 |
| 37 | D19 | `ec3a` | PCB 规划，待 cst/RTL |
| 38 | E19 | `ec3b` | PCB 规划，待 cst/RTL |
| 39 | C19 | `ec4a` | PCB 规划，待 cst/RTL |
| 40 | C18 | `ec4b` | PCB 规划，待 cst/RTL |

完整 FPGA 顶层端口、J8/J9 和备用球见 [NETLIST.md](NETLIST.md)。

## 5. 按键阵列

每个开关四脚按 4.5 mm 方阵放置。开关本体按 8.5×7.8 mm 最大包络，从 PCB 顶面到最高点
5.0 mm，柱塞行程约 2.0 mm。当前 PCB 使用 Ø1.0 mm 金属化孔、焊盘外径至少
1.8 mm 的设计前提，最终封装必须逐项对照到货开关。

白键中心：

| 音名 | X | Y |
|---|---:|---:|
| C4 | -40.25 | 0 |
| D4 | -28.75 | 0 |
| E4 | -17.25 | 0 |
| F4 | -5.75 | 0 |
| G4 | +5.75 | 0 |
| A4 | +17.00 | 0 |
| B4 | +28.75 | 0 |
| C5 | +40.25 | 0 |

黑键中心：

| 音名 | X | Y |
|---|---:|---:|
| C#4 | -34.50 | +9.2715 |
| D#4 | -23.00 | +9.2715 |
| F#4 | 0.00 | +9.2715 |
| G#4 | +11.50 | +9.2715 |
| A#4 | +23.00 | +9.2715 |

A4 在最终 Gerber 中为 X=+17.00，因此相邻白键距为 11.25/11.75 mm，其余为
11.50 mm。外壳键床必须跟随实际开关中心，不应另用一组理想等距坐标。

每路按键电路：

```text
KEYn ── 220R ──+── key_hw[n] ── J13
               |
              100nF
               |
              GND
```

按键按下时把网络拉低。RC 位于 PCB 底面，靠近对应开关，以减少键床覆盖区的高度。
FPGA 内部上拉保持不变。

当前已能从原理/外壳联合约束确认的 H 位号是：

| 位号 | 用途 |
|---|---|
| H3 | J8 的 3.3 V/GND 输入，F1 前 |
| H2 | 3.3 V 三针汇流/测试座，不是外部电源输入 |
| H5/H6/H7 | 六路 BLACK、+12 V、GND12 固定线束入口 |
| H8/H9 | ToF A/B 四针接口 |
| H10/H11 | EC11 电源与 A/B 固定线束入口 |

真实 3D 中还存在 H1/H4/H12–H14；它们必须在正式 EDA BOM/装配图中补齐功能、
极性或标为 DNP，不能仅凭 3D 标签推断可接性。

## 6. 六路光电接口和 PC817

固定线束入口使用 H5/H6/H7，三个 1×6 逻辑通道一一对应：H5 为六根 BLACK，
H6 为 +12 V，H7 为 GND12。丝印必须区分 CH1–CH6。

每路：

```text
CN1-1 +12V ── 1.2k ── PC817 pin1(A)
H5 BLACKn ─────────── PC817 pin2(K)
H7 GND12 ──────────── 12V 传感器回流

+3V3 ── 10k ──+── PC817 pin4(C) ── 220R ── photo_hw[n] ── J13
               |
             pin3(E)
               |
              GND
```

传感器黑线为低时光耦导通，FPGA 输入为低。PC817 的 LED 侧属于 `GND12`，
输出侧属于逻辑 `GND`。CN1 两针为外部 12 V 输入：pin1=`+12V`，pin2=`GND12`。
R15=0 Ω 是两地的单点连接。

实测 12 V 总负载不足 0.2 A。连接器附近保留测试点，但外接线不能直接由焊盘承受拉力。
固定线束版的优化方向是合并成单排焊接焊盘；当前板仍可见 H5/H6/H7 的分组结构，
首件装配时应以实际丝印和 Gerber 网络核对。

## 7. 两条 ToF 总线和四个编码器

### 7.1 ToF

两个四针接口 H8/H9 的针序固定：

| 针 | 信号 |
|---:|---|
| 1 | SCL |
| 2 | SDA |
| 3 | +3V3 |
| 4 | GND |

- 总线 A：J13-24/25 ↔ ToF #1，已验证。
- 总线 B：J13-29/30 ↔ ToF #2，PCB 已有网络，固件待闭环。
- 每条 SCL/SDA 从 FPGA 侧串 330 Ω，连接器侧各 4.7 kΩ 上拉到 3.3 V。
- 每只传感器 VCC/GND 之间放 100 µF + 100 nF 本地储能。
- 两条总线不得共线、不得共享上拉；I2C 不增加 100 nF 到信号线。
- ToF 线从模块朝向键盘中心的窄边进入 12×3.6 mm 外壳走线窗，再回到板后侧。

### 7.2 EC11

| 信号组 | J13 |
|---|---|
| EC1 A/B | 22/23 |
| EC2 A/B | 26/27 |
| EC3 A/B | 37/38 |
| EC4 A/B | 39/40 |

每条 A/B 串 100 Ω、10 kΩ 上拉到 3.3 V、100 nF 对地。四只编码器均无按压、
不接 SW。H11 为八针 A/B 固定入口，H10 为三针 3.3 V/GND 入口；连接器附近
加 100 nF 去耦。

## 8. 电源和保护

当前低成本受控样机的实际电源路径：

```text
外部 12V 电源 → CN1-1/+12V → 六路光电与 PC817 LED
                 CN1-2/GND12 → R15 0Ω → 逻辑 GND

Tang Mega J8 3V3 → H3 → F1 0.5A PTC → +3V3_LOCAL
```

- H2 是三针 3.3 V 汇流座，不是外部电源入口。
- H3 是真正的 3.3 V 输入，首版为 2.54 mm 两针排针，必须防呆或在装配中固定极性。
- 12 V 总负载不足 0.2 A，但主干仍按 ≥0.8 mm 设计。
- 当前板没有完整的反接保护、12 V 保险、TVS 和 ESD 阵列；增强方案是可选 BOM，
  不能根据 `PCB-POWER-ESD.md` 假定已装配。
- J13-11 在任何原理图页都必须显式 NC；J13-12 直接接逻辑地。

## 9. 布局和禁布区

### 9.1 键床覆盖区

- 范围约 `X=-49..+49`、`Y=-26.8..+26.775`。
- 顶面只允许 13 个开关本体、开关焊盘和 26 个导柱接触点。
- 导柱接触点保持至少 Ø3.0 mm 无裸露铜。
- 其余阻容放底面，紧邻相应开关。

### 9.2 前侧服务带

- 原 `Y=-23.775..-15.225` 低净空带现在被加长键床覆盖到 Y=-26.8；
  新板顶面该区域不能放高器件。当前板的前侧排针改为朝下焊。
- `Y=-35..-26.8` 保留 8.2 mm 裸露带，用于前侧线束从 PCB 下方进入壳体窗口。
- H5 位于 `X=-37.34..-24.64`、`Y≈-25.02`。键床不设通窗；装配时必须
  把 H5 朝上残留引脚剪平至 PCB 上表面或更低，再安装键床。
- 下壳有两条宽 3.0 mm 支撑筋，中心 Y=±28；底面元件与通孔脚避开
  `Y=26.5..29.5` 和 `Y=-29.5..-26.5`。

### 9.3 后侧接口带

`Y=+26.775..+35` 用于 J13、ToF H8/H9、3.3 V 输入和 F1。J13 实体向 PCB
后边外延伸约 1.56 mm，外壳已做局部上壳避让。

### 9.4 布线原则

- 底层保留尽量完整的逻辑 GND；顶层空余处补地并做缝合。
- 普通信号 0.25 mm，最小 0.20/0.20 mm；过孔 0.3 mm 钻孔/0.6 mm 焊盘。
- 高速/阻抗控制不适用，所有信号为低速或静态输入。
- 12 V 不穿过板中心逻辑区，光电输入从左侧前区进入，输出向右汇入 J13。

## 10. 实际 3D 回装结论

`actual_pcb_checks.py` 使用真实 3D PCB 包络复核，当前结果：

- 13 个开关、CN1、CN2 和 H5–H13 与上下壳无实体干涉。
- PCB 落在四个支撑柱上，完全位于下壳内。
- J13 与上壳已局部避让。
- 55.4×6.1×10.7 mm 标准 IDC 线端包络与上壳重叠 0 mm³。
- PCB 下方支承筋与底面元件禁布已核对。

数字检查成功不等于实际焊点、封装或线缆弯曲半径通过；首件仍要裸板测量和整机装配。

## 11. 制造包现状

当前 Gerber 包包含：

- Gerber RS-274X：板框、顶/底层铜、阻焊、丝印；
- Excellon：PTH、NPTH、Via 钻孔；
- 飞针测试 JSON；
- 嘉立创下单说明文本；
- 实际 PCB 3D STEP。

已确认：

- 板框 100×70 mm、R3，四个 Ø3.4 mm NPTH 位置正确。
- 13 个开关中心、J13/CN2、前端连接器和外壳开口对齐。
- 装配后用真实 PCB 3D 回装无明显干涉。

仍未通过制造前门槛：

1. 两条钻孔文件中存在 479 个重复坐标。必须去重，或取得板厂明确接受意见。
2. 包内没有 ERC=0、DRC=0 的正式报告。
3. 包内没有可下单 BOM、贴片坐标、顶/底装配图或 DNP 清单。
4. 没有说明板厂是否按实际 Gerber 的孔属性自动识别 NPTH/PTH。
5. 尚未完成裸板到货后的通断、电压和逐通道验收。

因此当前文件足以做机械数字复核，不应在未完成上述闭环前直接当作“已确认可量产”的
制造包。

## 12. 打样后首件测试顺序

1. 不接 FPGA、不接传感器，检查 12 V 与 3.3 V 对地是否短路。
2. 只加 3.3 V，确认 F1 后的电压、电流和上拉状态。
3. 12 V 限流供电，逐路检查 PC817 输入/输出和 `GND12`。
4. 从 J13 端逐键短接 GND，核对 13 个网络与球号。
5. 逐路转动 EC1–EC4，确认 A/B 不串、上拉与 RC 正常。
6. 两条 ToF 总线分别做 I2C 扫描，确认各自应答 0x52，禁止把两只并联测试。
7. 裸板通过后再装键床、PCB 和下壳，确认支撑、行程和线束出口。
8. 最后接 FPGA，运行遥测、音频静音和完整演奏验收。

## 13. 打样前必须关闭的事项

- 开关、J13、ToF 连接器、固定线束和 12 V/3V3 连接器均有实物尺寸。
- 13 个开关封装过孔、柱塞和键帽位置与实物一致。
- 键床最终锁固已改为上盖定位柱/盲孔，不需要新增 PCB 安装孔。
- Gerber 钻孔去重完成，ERC/DRC=0，BOM/坐标/DNP 齐全。
- 两条 I2C、六路 PC817、四个 EC11 的网络与 [NETLIST.md](NETLIST.md) 一致。
- 实际 PCB 3D 和外壳 STEP 仍无干涉，前/后线缆最小弯曲半径可满足。
