wongben2333-crypto/26Embedded/fpga_spark/lcd_test/hardware/enclosure/MODIFICATION-2026-10-28.md

# 2026-10-28 硬件确认版外壳修改说明

> 基线：`Gerber_PCB1_2026-10-27.zip` 与 `3D_PCB1_2026-10-27.step`  
> 范围：下壳、上盖、键床；ToF 光路和 22.124 mm 分件面保持不变  
> 原始 STL/ZIP 未覆盖

## 1. 完成的硬件修改

### 开关与键床

- 开关本体参考包络由旧的 7.8×7.8 改为实际 **8.5×7.8**，总高仍为 5.0，
  柱塞 Ø3.5×2.0。
- 键床通孔改为 **9.2×8.3 mm**。宽度名义间隙 0.35，深度名义间隙 0.25；
  对 8.7×8.0 的最大来料仍有单边 0.15。原正方形 9.2 孔会在 A4/A#4
  附近留下 0.071 mm 薄墙，因此拆成宽、深两个独立尺寸。
- 底面增加 **10.6×10.6×0.8 mm** 焊盘/焊锡让位。A4 与 G4 的 11.25 mm
  键距会在两个让位之间留下 0.65 mm 薄墙，故只在该局部把两浅让位连通；
  其余位置保持独立的 10.6 mm 让位。
- 原有 Ø2.2 mm 双导柱、24 mm 间距、0.4→2.4 mm 插入量及 1.0 mm
  全压余量全部不变。导柱起点提高到 PCB 上方 0.9 mm，避免进入底部焊盘
  让位后形成薄片。

### 键床与开口

- 键床由 98×42×2 改为 **98×53.575×2 mm**。
- 后缘保持 **Y=+26.775**，前缘为 **Y=-26.800**。
- PCB 前端到键床前端保留 **8.2 mm** 裸露带，供朝下排针线束使用。
- H5 位于 `X=-37.34..-24.64`、`Y≈-25.02`。最终选择保留完整键床，
  不增加通窗；装配前必须把 H5 朝上残留引脚剪平至 PCB 上表面或更低。
- 上盖开口由 100×59 改为 **97×49.5 mm**。
- 键床左右各伸入上盖投影下缘 **0.5 mm**；键帽到开口平面边缘最小
  **0.975 mm**。

### 键床定位

- 不再把止口直接压在 J13 上。
- 键床增加 4 个 Ø1.6 mm 向上定位柱：
  `(-25,-25.7)`、`(+25,-25.7)`、`(-35,+25.7)`、`(+35,+25.7)`。
- 上盖前/后加强筋各有 3.4×2.9 mm 局部凸台和 Ø2.0×1.25 mm 盲孔；
  按最终实体求交，柱尖 Z=19.000、实际插入 0.876 mm、孔底余量 0.374 mm。
- 定位凸台到键帽最小净距 0.625 mm；键床与上盖实体求交 0 mm³。
- 该结构锁定 X/Y，不承担垂直锁紧；垂直上跳仍需首件验证。

### 朝下排针

- 当前 `3D_PCB1_2026-10-27.step` 仍显示 H1–H14 朝上。检查脚本保留其
  X/Y 位置，并按新装配状态使用：
  - 塑料本体：Z=10.3..12.8；
  - 引脚：Z=4.3..10.3。
- H2 附近的 Y=+28 加强筋在 `X=-42..-32` 折向
  `Y=24.8..27.8`，到 H2 最小边 Y=29.464 留有 1.664 mm。
- H2/H3/H4/H14 与四角支撑柱上方区域按本体+引脚包络加 0.40 mm 局部退让，
  实测本体最近间隙均为 0.400 mm；引脚最近间隙为 H2 0.992、H4 1.030、
  H3 0.541、H14 0.332 mm；
  四个 M3 柱位仍为 `X=±44、Y=±28`。
- 上盖删除原先仅为朝上排针设置的局部凹槽；J13/40P、IDC 插头和 ToF
  的必要避让保持不变。

## 2. 保持不变

- 开关总高 5.0、行程 2.0；本体顶 3.0、柱塞尖 5.0。
- 键床顶 2.0、键帽底 5.0，全压帽底距键床 1.0。
- Ø3.7×3.2 键帽柱塞孔不作为咬合结构。
- 黑键顶面、ToF 外窗口和上盖主平面仍为 Z=26.2。
- ToF 模块 31×15×6.2、双轴向上、29×13 光窗、12×3.6 走线窗、
  Z=22.124 分件面均不变。
- 40P 后口 56.8×12、IDC 55.4×6.1×10.7 包络及 Z=27.0 服务拱盖不变。
- 下壳外形 130×109×22.124；上盖主平面 140×109×26.2。

## 3. 几何检查结果

已重跑并保存：

- `reports/2026-10-28/shell_checks.json`：PASS
- `reports/2026-10-28/fit_sample_checks.json`：PASS
- `reports/2026-10-28/actual_pcb_checks.json`：PASS
- `reports/2026-10-28/gerber_alignment_checks.json`：PASS
- `reports/2026-10-28/*_dfam.json`、`*_orientations.json`：DfAM 原始测量
- STEP ACL：非提升权限执行 `publish-access.ps1` 成功，目录和四个关键 STEP 的
  `icacls` 均可列出 `Authenticated Users` 读权限

报告索引和复现命令见 [reports/2026-10-28/README.md](reports/2026-10-28/README.md)。
本轮导出文件的时间戳、大小和 SHA-256 清单见
[reports/2026-10-28/artifact_manifest.json](reports/2026-10-28/artifact_manifest.json)。
三组网格一致性报告见
[reports/2026-10-28/mesh_consistency_checks.json](reports/2026-10-28/mesh_consistency_checks.json)。

关键结果：

| 检查 | 结果 |
|---|---|
| 上/下壳接缝 | 0 mm |
| 上下壳、PCB、键床意外重叠 | 0 |
| 13 开关与键床重叠 | 0 |
| 开关与键床最小净距 | 0.15 mm |
| 键床焊盘让位探针重叠 | 全部 0 |
| 键帽与上盖重叠 | 0 |
| 键帽到开口最小净距 | 0.975 mm |
| 键床左右压边 | 0.5 mm/侧 |
| 四个定位柱/上盖盲孔 | 插入 0.876 mm，键床/上盖求交 0 mm³ |
| H2/H3/H4/H14 朝下本体及引脚对下壳 | 干涉 0 |
| 排针实际最近间隙 | 本体均 0.400；引脚 H2 0.992 / H4 1.030 / H3 0.541 / H14 0.332 |
| STEP/STL/3MF 三组文件 | 三角形数一致；包络差 ≤7.63e-7 mm；体积相对差 ≤0.00453% |
| ToF 轴线误差 | 0° |
| ToF 光窗/走线窗探针重叠 | 0 |
| IDC 包络对上盖重叠 | 0 |
| 40P 服务口通过性 | PASS |
| 四个 PCB 柱位 `±44, ±28` | 保持 |

## 4. DfAM 复核

按 PETG、0.2 mm 层高、45° 阈值：

| 零件 | 水密 | p05 壁厚 | 最小采样 | 建议姿态 |
|---|---:|---:|---:|---|
| 上壳 | 是 | 2.00 | 0.04（尖锐边框采样） | 顶面朝下需较多支撑；侧立约 3.8% 悬垂但高 140 |
| 下壳 | 是 | 1.70 | 1.50 | 当前开口向上姿态，悬垂约 1.3% |
| 键床板 | 是 | 1.20 | 0.90 | PCB 接触面朝下、开口朝上平放，构建高 5.4，悬垂约 3.8% |

`keybed.stl` 包含 1 个键床板和 13 个独立键帽，因此整体 `body_count=14`；
板件本体单独检查为水密。DfAM 工具未测量最小孔径、无支撑桥长和局部支撑
归类，所有这些仍需在切片软件中确认，尤其是 44/36 mm 前侧开口的顶部桥接。

## 5. 输出

以下文件已按原文件名和原坐标原点重生成：

- `STEP/bottom_shell.step`
- `STEP/top_shell.step`
- `STEP/keybed.step`
- `STL/bottom_shell.stl`
- `STL/top_shell.stl`
- `STL/keybed.stl`
- `3MF/bottom_shell.3mf`
- `3MF/top_shell.3mf`
- `3MF/keybed.3mf`

对应的总装和数字配合件也已重建：

- `STEP/assembly.step`
- `STEP/fit_assembly.step`
- `STEP/fit_sample.step`
- `STL/fit_sample.stl`
- `3MF/fit_sample.3mf`

`STEP/assembly_with_pcb.step` 没有用旧的朝上排针 STEP 重新覆盖；最终实体 PCB
装配前应先把实际排针翻到板下，或由 PCB 侧重新导出对应 3D。

## 6. 仍需首件确认

1. 四个键床定位柱的实际松紧、插拔力和长期磨损。
2. 键床是否需要额外的垂直防上跳卡扣。
3. 实际开关本体、柱塞和焊锡高度与数字包络的偏差。
4. 排针局部避让的 CAD 实测最小引脚间隙为 H14 0.332 mm；打印后仍需复测。
5. 上壳支撑拆除、前侧开口桥接下垂和 ToF 筒内表面质量。
6. 实际 IDC 附件、线缆弯曲半径和压线片。
7. H5 朝上脚剪平后不得高于 PCB 上表面。

## 7. 嘉立创键床上传修正

嘉立创会把 `keybed.3mf` 识别为一个整体对象，无法直接保持“键床板 + 13 个键帽”。已从参数化源逐个导出：

- `exports/jlc_2026-10-28/keybed_parts.zip`
- `exports/jlc_2026-10-28/keybed_parts/` 下的 14 个独立 STL
- `exports/jlc_2026-10-28/keybed_parts.json`

14 个零件均通过水密、绕序一致和正体积检查，并已按打印方向居中、底面置于 Z=0。不要再使用平台从组合 STEP 自动拆分出的单键 STEP。
