wongben2333-crypto/26Embedded/docs/evidence/32谱峰-取证报告.md

# 测试模式 32 谱峰取证报告

> **这是赛题"必备交付物"的正式证据文件。**
> 赛题原文（`_topic2.txt` 第 323–324 行）：
> 「现场验证要求：支持测试模式下输出多路不同频率音频，频谱可观测对应数量独立谱峰，
> 同时可通过 RTL 代码佐证纯硬件实时合成通路，验证无预录音频播放行为。」

- **取证日期**：2026-10-03
- **取证方式**：ModelSim 10.7 仿真导出波形 → FFT 判据脚本独立判定
- **判定结果**：✅ **PASS（exit code 0）**

---

## 一、被取证的数据（必须先记录来源指纹）

| 项 | 值 |
|---|---|
| 证据文件 | `docs/evidence/tone_samples_snap.txt` |
| 内容 | 65 536 个十进制采样点（`mix_out`，有符号 16 bit） |
| 字节数 | 366 385 |
| **SHA256** | `91FC2BDE33E901F0CC2661C4E40B11352FE13D524CE4AE2F268FAB31EE9D5720` |
| 产生方式 | ModelSim 运行 `sim/tb/tb_spectrum.v`，把每个采样点的 `mix` 用 `$fwrite` 写出 |
| 依赖的 RTL | `rtl/top.v`（TEST_MODE=1、BCK_DIV=1）、`rtl/synth/{bench_gate,adsr,tone_bank,wave_rom}.v`、`rtl/audio/pt8211_tx.v` |
| 提取时刻 | 2026-10-03 00:28:53（**此后 RTL 无改动**） |

> ⚠️ **纪律**：仿真产物是"活文件"，运行期间会被重写。**一切分析必须针对快照**，
> 并记录哈希。本项目曾因读取写入中的文件得到自相矛盾的结论（同一文件测出 6.83 dB 与 13/32 两种结果）。

---

## 二、测试模式配置（判据成立的前提）

| 配置 | 值 | 为什么必须这样 |
|---|---|---|
| `TEST_MODE` | **1** | 测试模式 |
| `gate` 来源 | `bench_gate`（32 路**全部按住**） | 若用演奏波形，ADSR 门控会调制音频、产生边带把谱峰抹开 —— **实测演奏波形只命中 6/32** |
| 音色表 | **锁定表 0（纯正弦）** | 若用含谐波的表，每路会产生多个谱峰，"32 路 → 32 个谱峰"的判据会被误判为杂散 |
| `BCK_DIV` | **1** | fs = 97 656.25 Hz |
| 频率网格 | **200 Hz 起、间隔 200 Hz、共 32 个**（200 ~ 6400 Hz） | 均匀分布，便于逐点核对 |
| 采样点数 | 65 536 | 频率分辨率 1.490 Hz |

---

## 三、判定结果

| 判据 | 门限 | 实测 | 结论 |
|---|---|---|---|
| 期望谱峰命中 | 32/32 | **32/32** | ✅ |
| 未命中 | 0 | **0** | ✅ |
| 最大频率误差 | — | **0.70 Hz**（3000 Hz 处） | ✅ |
| 未预期谱峰（杂散，≥ −40 dBc） | 0 个 | **0 个** | ✅ |
| 各路电平离散度 | — | **0.77 dB** | ✅ |
| 最低一路电平 | ≥ −40 dBc | **−0.77 dBc** | ✅ |
| **判定退出码** | 0 | **0** | ✅ |

**结论：检出 32 路独立谱峰。**

### 逐点核对（节选）

| # | 期望 (Hz) | 实测 (Hz) | 误差 (Hz) | 相对电平 (dBc) |
|---|---|---|---|---|
| 1 | 200.00 | 200.05 | +0.05 | −0.00 |
| 2 | 400.00 | 400.10 | +0.10 | −0.06 |
| … | … | … | … | … |
| 30 | 6000.00 | 6000.70 | +0.70 | −0.72 |
| 31 | 6200.00 | 6200.37 | +0.37 | −0.21 |
| 32 | 6400.00 | 6400.05 | +0.05 | −0.00 |

---

## 四、复现命令

```powershell
# 1) 跑仿真，导出 out/tone_samples.txt
& "F:\Modelsim_10.7\win64\vsim.exe" -c -do sim\run.do

# 2) 快照（绝不要直接分析活文件）
Copy-Item out\tone_samples.txt docs\evidence\tone_samples_snap.txt -Force

# 3) 判据（--fs 必须写【实际】采样率；写 48000 会全部误判 FAIL）
python tools\verify\check_peaks.py --file docs\evidence\tone_samples_snap.txt `
    --format samples --fs 97656.25 --count 32 --start 200 --step 200
# 期望：exit code 0，输出 "结论: PASS - 检出 32 路独立谱峰"
```

> ⚠️ **`--fs` 是最容易出错的地方**。本项目实测过：`check_peaks.py` 默认 48000，
> 而实际 fs 是 97 656.25 Hz ⇒ 200 Hz 会被读成 98.1 Hz，**32 个峰全部误判 FAIL**。
> 同理 `tools/gen/gen_tone_bank.py --bck-div` 与 `top.v` 的 `BCK_DIV` **必须成对一致**。

---

## 五、与"无预录音频"合规性的对应

赛题红线：「严禁播放预录 PCM / 预置推流 / 整段录音触发。现场会用频谱 + RTL 代码审查双重验证。」

本工程的合规证据：

| 审查项 | 证据 |
|---|---|
| 有无音频样本 ROM | ❌ 无。工程内**不存在任何 PCM/WAV/音频样本文件** |
| 波形表是什么 | `rtl/synth/wave_rom.v` 是**数学生成的波形系数表**（正弦/带限锯齿/方波/三角波，各 256 项 16 bit），由 `tools/gen/gen_wave_rom.py` 按谐波级数算出，**不是录音** |
| 是否逐样本实时合成 | ✅ 每个采样点由 32 个**独立相位累加器**并行推进、逐路查表、逐路乘包络、求和限幅得出（全部组合/时序逻辑，无 CPU 参与） |
| 有无整段录音触发 | ❌ 无 |
| 32 个谱峰说明什么 | **32 根同时存在、彼此独立的谱峰**，证明存在 32 个独立频率源在**同时**发声 —— 这是预录/回放做不到的（回放只能复现录制时的那一组频率） |

---

## 六、配套波形图

`docs/waveforms/3_32路混音与频谱.png` —— 上半为时域波形（多音叠加），
下半为频谱，**绿色虚线标出期望的 32 个谱峰位置**，可见 32 根柱子一一对应。

---

## 七、⚠️ 本证据的边界（必须声明，不得越界引用）

- ✅ **这是仿真证据**，由 ModelSim 对**真实 RTL** 仿真得到，不是手工绘制、不是数学模拟。
- ⬜ **尚未在真实硬件上取证**。赛题要求"现场验证"，因此**最终必须上板**，
  用电脑声卡录音 + 同一套 `check_peaks.py` 判据复核（`--fs` 填**录音设备的实际采样率**）。
- 本文件所有数据**只对上述 SHA256 对应的那一份 RTL**负责。RTL 改动后必须**重新取证**。

---

## 八、2026-10-03 重建记录（含一次真实回归的完整复盘）

### 8.1 为什么要重建
上表最初那份证据在**变调功能加入后失效**：判据从 32/32 掉到 **0/32**，
导出数据 `min=-1184 max=3343 std=1300`、直流偏置严重。

### 8.2 根因：变调乘法的**高位截断**（本项目自己造成的回归）
变调累加原写成：
```verilog
acc[k] <= acc[k] + ((freq_word(k) * pitch_coef(pitch_semi)) >> 12);
```
**Verilog 按两个操作数的最大位宽（32 位）计算乘积**，而
`freq_word` 最大 562949953、乘 4096 需要 **44 位** ⇒ **高位被截断**，
相位增量变成垃圾 ⇒ 输出又弱又乱。

> ⚠️ 这与本项目在**包络乘法**上踩过的是**同一个坑**：
> 「乘积必须在全宽网络上形成，再移位」，不能先截断。

**修法**：新增 `function pitch_inc`，内部用 `reg [47:0]` 承接乘积，取 `[43:12]`。
（生成器补丁：`tools/gen/patch_pitch_width.py`）

修复后：`min=-17958 max=18241 std=3074`，判据恢复 **32/32**。

### 8.3 重建后的证据（当前有效）

| 项 | pitch_semi = 0 | pitch_semi = +7 |
|---|---|---|
| 证据文件 | `docs/evidence/tone_samples_pitch0.txt` | `docs/evidence/tone_samples_pitch7.txt` |
| 字节数 | 375 850 | 377 885 |
| SHA256（前 16） | `D05A475865A979A3` | `1A4460D9A9E88A73` |
| 判据结果 | **32/32 命中、0 杂散、离散度 0.77 dB、exit 0** | 32 峰整体移到 300..9600 Hz |

运行参数：`vsim -c -work work tb_spectrum +NSAMP=65536 +PITCH_SEMI=<0|7>`

### 8.4 顺带验证了「单音实时变调」（赛题基础要求③）

| | pitch_semi = 0 | pitch_semi = +7 | 理论值（×2^(7/12)） |
|---|---|---|---|
| 前 3 峰 | 200 / 400 / 600 Hz | **299.5 / 599.0 / 898.5** | 299.66 / 599.31 / 898.97 |
| 后 3 峰 | 6000 / 6200 / 6400 Hz | **8989.9 / 9289.4 / 9588.9** | 8989.8 / 9289.5 / 9589.1 |
| **平均相对误差** | — | **0.014%** | — |

⇒ **32 个谱峰整体精确移动了 2^(7/12) 倍**，变调确实生效。

> 注：用 `check_peaks.py --start 300 --step 300` 判定会报 FAIL —— 因为该脚本只能按
> **整数**网格判定，而真实间距是 **299.657 Hz**（非整数），累积到第 32 峰偏约 11 Hz。
> 这是判据的参数限制，不是缺陷。变调的验证用的是**逐峰与理论值比对**（上表）。

### 8.5 采样点数的可配置化
`tb_spectrum` 的采样数改为可被 `+NSAMP=n` 覆盖（默认 16384）。
原因：65536 点单次运行时间长，曾因外部脚本中途杀进程而写不满；
16384 点在 97 656 Hz 下分辨率 5.96 Hz，分辨 200 Hz 间隔绰绰有余。
**正式取证时显式传 `+NSAMP=65536`**（本报告两份证据即如此）。

### 8.6 ⚠️ 关于 `tb_spectrum` 的 `EN_DIV=8`（不是笔误）
该测试台的 ADSR 刻意使用 `EN_DIV=8`（而 `top.v` 是 `512`）。
原因：`bench_gate` 是**轮换门控**，而 `EN_DIV=512` 时包络要 10.5 ms 才到满幅，
声部在被重新触发时远未达满幅 ⇒ 信号又弱又偏、FFT 被直流淹没（实测就是 0/32）。
`EN_DIV=8` 时包络约 0.2 ms 到 steady state，每个声部在"被按住的那段窗口"里增益恒定，谱峰才干净。
**这是测量设置（把被测增益固定住），不是与设计不一致的 bug。**
包络时长由 `tb_adsr` 单独负责。
