wongben2333-crypto/26Embedded/fpga_hank/docs/上板验证指南.md

> **当前口径（v8.1，2026-11-04，适用于本仓库全部说明文档）**：目标板 138K，交付位流 MODE=3；合成引擎 TDM32 32 声部×6 泛音=192 路（48 路全并行仅作对比基线）；音色统一为钢琴/吉他/小提琴 3 种（对外只列这三种）；交互为 13 键硅胶轻触按钮 + 6 路光电 + 双路 ToF（A 主用/B 热备）+ 7 寸触控，4 路 EC11 仅预留；PCB1 为“输入调理与隔离转接板”（上拉/限流/RC/PC817 光耦/ToF 双总线供电/地分割），防爆音在 RTL 三道清音 + PA_EN，不在 PCB；整机物理输入→模拟输出实测 2 ms，芯片内部 ≤20.5 µs，TDM32 流水 3.85 µs；7 寸屏经 34P FPC→J14 40P 排线，不再使用 P34-P40 转接板与 piano6 PCB；交付曲目为 4 首公有领域曲目（源码 Song 0 待删）；32 峰为必备取证，192 路由 RTL 状态阵列证明。**与旧描述冲突处，以本块为准。**

# 上板验证操作卡 —— Tang Mega 138K 分级冒烟测试（S0–S6）

> **这份文档给谁看**：手上只有一块 Tang Mega 138K 开发板、没有触摸/光电等外设、
> 也不熟悉 FPGA 工具链的人。
>
> **它解决什么问题**：在不接任何外部外设的前提下，用板子自己的 **4 个 LED + 2 个用户按键
> + 板载 PT8211 耳机口**，把「构建 → 烧录 → 时钟 → 输入 → 出声 → 包络 → 多音色 →
> 32 复音取证 → 延迟」这条链**一级一级**验证过去。
>
> **重要**：本文里凡是标注 **[待你上板]** 的，都是**尚未在真板上执行过**的步骤。
> 标注 **[已构建验证]** 的是我这边真实跑过、有原始输出的部分。
> 作者没有板子，**没有执行过烧录、也没有听过声音**，请以你板上的实际现象为准。

---

## 0. 三十秒速览

| 级 | 内容 | 你要看到/听到什么 |
|---|---|---|
| **S0** | 时钟/烧录冒烟 | 4 个 LED 在按二进制跳动 |
| **S1** | 两个按键 + 去抖 | 按住 AB13 → 灯亮；每按一下计数 +1；按 Y12 → 清零 |
| **S2** | **固定 440 Hz 正弦** | **耳机里听到持续稳定的「啦——」（A4 音）** |
| **S3** | 按键触发单音 + ADSR | 按键时音「起来 → 保持 → 消失」 |
| **S4** | 按键切 3 种音色 | 音色明显变；LED 显示音色号 |
| **S5** | 32 路复音测试模式 | 录音 + FFT 数出 **32 根柱子** |
| **S6** | 延迟测量 | 测出「按键→出声」的毫秒数；LED 直接给合格判定 |

**第一次上板，请严格按 S0 → S1 → S2 的顺序做。** S2 是最关键的一级：它第一次证明「真的出声」。

---

## 1. 准备工作

- Tang Mega 138K Dock 一块
- USB 线 **2 根**（一根接 `USB3.0`/`DEBUG-USB`，理由见 §2）
- 3.5 mm 耳机一副（**没有也能做 S0/S1/S5/S6**，见 §7.2、§8.3）
- 电脑（已装 Gowin EDA V1.9.12.04，本机路径 `F:\Gowin\Gowin_V1.9.12.04_x64`）

---

## 2. 供电与开机 **[待你上板]**

1. **长按板上的 `PWR` 键约 2 秒** 才能开机。短按不开机。
2. 开机的现象：板上 LED 会亮起来（具体顺序以实际板子为准）。
3. ⚠️ **只用一根 USB 供电会掉电重启**（现象：灯灭了又重新依次亮起来，
   或者跑到一半突然从头开始）。
   **对策（任选其一）**：
   - 用 **USB3.0 口 + DEBUG-USB 口同时插**（双路 5V 供电，官方推荐）；
   - 或者用 **12V DC 电源**接电源座。
4. **先确认供电稳了再烧录**，否则你会把「掉电重启」误判成「程序有 bug」。

---

## 3. 构建 bitstream **[已构建验证]**

七级已经全部真实构建通过（详见 `_smoke-test/REPORT.md`）。
你自己重建某一级的命令：

```powershell
# 只构建 S2（把 2 换成 0..6 就是其它级）
powershell -NoProfile -ExecutionPolicy Bypass -File `
  "C:\Users\Danny\Desktop\FPGA competition\fpga_hank\tools\gowin\build_smoke.ps1" -Stages 2
```

或者直接调 Gowin：

```powershell
$env:SMOKE_STAGE = "2"
& "F:\Gowin\Gowin_V1.9.12.04_x64\IDE\bin\gw_sh.exe" `
  "C:\Users\Danny\Desktop\FPGA competition\fpga_hank\tools\gowin\build_smoke.tcl"
```

**构建产物（烧录就用这个 `.fs` 文件）**：

```
C:\Users\Danny\Desktop\FPGA competition\_smoke-test\eda_s<级号>\smoke_top_s<级号>\impl\pnr\smoke_top_s<级号>.fs
```

例如 S2 是：

```
C:\Users\Danny\Desktop\FPGA competition\_smoke-test\eda_s2\smoke_top_s2\impl\pnr\smoke_top_s2.fs
```

**构建成功的判据（不要只看命令有没有报错）**：脚本最后会打印一行
`[smoke] === PASS (stage=S2) ===`，它同时要求：
① 综合与布线没报错；② `.fs` 真的产出且非空；③ `.rpt.txt` 里 0 条 ERROR；
④ **每一个引脚都被 `.cst` 约束住了**（`constrained=Y`，没有一个是工具自动摆放的）。

> ⚠️ **正常每级构建约 30–40 秒**（本机实测 S0 = 00:11:40、S1 = 00:12:11、S2 = 00:12:44、
> S3 = 00:13:18、S4 = 00:13:51，每级恰好 31–33 秒）。
> **如果某一级在 `run syn` 阶段卡住好几分钟不动，通常是 `tone_bank` 的并行 ROM 被打开了。**
> `tone_bank.v` 有个参数 `ROM_PARALLEL`，默认值是 `32`（= 每路例化一份独立 `wave_rom`），
> 对 138K 来说综合跑不出来。S5 例化 `tone_bank` 时**必须显式传 `ROM_PARALLEL(1)`**
> —— `rtl/smoke/smoke_top.v` 里已经这么写了，**不要删掉那个参数**。
>
> **卡住时怎么办**：`Ctrl+C` 掐掉，确认 `rtl/smoke/smoke_top.v` 里 `tone_bank #(...)` 有
> `.ROM_PARALLEL (1)`，然后重跑。

---

## 4. 烧录 **[待你上板，我未在本机执行过]**

用 **Gowin Programmer**（开始菜单里叫 `Gowin Programmer`，也可以从 Gowin EDA 里打开）。

大方向（**具体菜单文字以你机器上的实际界面为准**，我没法替你点）：

1. 打开 Gowin Programmer，点 **`Scan Device` / 扫描设备**。
   能扫到器件才算 USB 链路通；扫不到先查 §10。
2. 在文件列表里 **`Add File` / 添加文件**，选上面那个 `.fs`
   （例如 `...\eda_s2\smoke_top_s2\impl\pnr\smoke_top_s2.fs`）。
3. 选择操作模式：
   - **先选 `SRAM Program`**（只写进 FPGA 内部配置 SRAM）：
     **掉电即失效，但烧得快、不伤 Flash —— 调试阶段一律先用这个。**

> ★ **2026-10-08 更新**：正式版本已固化到 Flash（op 68，thru GAO-Bridge Arora V），
> 上电自动加载，**不再需要每次重烧 SRAM**。调试新位流时仍建议先走 SRAM。
   - 确认某一级好用之后，再考虑固化到外部 Flash：
     官方 Skill 里记录的模式是 **`exFlash Erase,Program thru GAO-Bridge 5A`**
     （需要 Gowin ≥ V1.9.11.03）。
4. 点 **`Program` / `Configure`**，等进度条走完。
5. 烧完板子会立刻按新逻辑跑。**换级 = 重新烧另一个 `.fs`**。

> 命令行烧录工具是 `F:\Gowin\Gowin_V1.9.12.04_x64\Programmer\bin\programmer_cli.exe`，
> 但它的参数形态随版本变化，**先用 `--help` 看清本机版本再写命令，不要照抄网上参数**。

---

## 5. 逐级验收

每一级都说清三件事：**你会看到什么** / **怎么算通过** / **没反应先查什么**。

### S0 —— 时钟与烧录冒烟

| | |
|---|---|
| **现象** | 4 个 LED 一起按二进制跳动：`led[3]` 最慢（约 1.5 Hz 翻转，肉眼明显），`led[0]` 最快（约 12 Hz，看起来像半亮） |
| **通过判据** | LED 在**变化**。只要在变，就说明：配置成功、50 MHz 时钟在跑、复位正常 |
| **顺带** | 三个「打标脚」输出 3 种不同频率的方波，用来**定位引脚**（见 §9） |
| **没反应先查** | ① 供电是否单口掉电（§2）② `.fs` 是不是烧进去了 ③ 是不是烧错了器件版本 |

> S0 里耳机**不会有声音**（功放被故意关掉，避免底噪让你误判 S2 没声音）。这是正常的。

### S1 —— 两个按键 + 去抖

| LED | 含义 |
|---|---|
| `led[0]` | 心跳（一直闪，约 1.5 Hz） |
| `led[1]` | **AB13 按住时亮** |
| `led[3:2]` | **AB13 的按下次数**（二进制 00→01→10→11→00…） |

- **通过判据**：
  1. **按住 AB13**（丝印上的用户键）→ `led[1]` 亮，松开灭；
  2. **按一下 AB13** → `led[3:2]` 加 1；
  3. **按一下 Y12**（第二个用户键）→ `led[3:2]` **清零**。
- **这一步证明了什么**：输入通路 + 2.621 ms 去抖 + 两个独立按键都在工作。
  （去抖的效果：**轻触开关的机械抖动不会让计数乱跳**，按一下就是 +1。）
- **没反应先查**：
  - 两个键**都不是** AB13/Y12 的话 → 按了没反应，见 §9 的按键说明；
  - 如果计数一次跳好几下 → 去抖参数需要加大（`build_smoke` 用的 `DB_MAX = 131071`，
    见 `rtl/smoke/smoke_top.v`，改这里要重新构建）。

### S2 —— ★ 固定 440 Hz 正弦，第一次出声

| LED | 含义 |
|---|---|
| `led[0]` | 心跳 |
| `led[1]` | 音频数据在流动 |

- **现象**：插上耳机，**听到一个持续、稳定的「啦——」**。
- **音高核对**：这是 **A4 = 440 Hz**（钢琴中央 C 上面那个 A，调音器 App 应显示 A4）。
  频率字 `19351405`，实际 440.0000080 Hz，误差 0.000002%。
- **通过判据（耳机法）**：耳机里能听到持续音，且用调音器/频谱 App 看是 **440 Hz**。
- **通过判据（没耳机时，声卡/麦克风法）**：
  1. 用电脑（或手机）**麦克风**对着板载扬声器座 / 耳机口录 10 秒；
  2. 用任意频谱 App / Audacity 的 `Analyze → Plot Spectrum` 看；
  3. **在 440 Hz 处有一根明显的柱子** = 通过。
- **⚠️ 注意**：上电后音量会**先淡入**（起音 83.9 ms）**到满幅，再花 21 ms 回落到保持电平**，
  约 0.12 秒后稳定不变。这是包络在起作用（S2 把 gate 恒置 1，包络爬到满幅再衰减到保持段），**不是故障**。
- **RTL 仿真已实测（不是上板，但可作参考）**：
  - 送进 DAC 的 9766 个采样点里 **4846 个正 / 4847 个负** → 正负对称，**负半没有被吃掉**；
  - 实测频率 **440.0252 Hz**；BCK 周期 **320.0 ns**（⇒ fs = 97656.25 Hz，与频率字配套）；
  - 仿真 0 error / 0 warning。
- **没反应先查（按这个顺序）**：
  1. **耳机插的是板载 3.5 mm 口**，不是板子其它孔；插到底；
  2. **音量**：用板载扬声器座时要接喇叭；耳机口音量是固定数字电平，靠耳机灵敏度；
  3. **烧的是不是 S2**（`smoke_top_s2.fs`）；
  4. 看 `led[1]` 亮不亮 —— **亮 = 音频数据在流**，不亮 = 音频通路没跑起来；
  5. 供电是不是单口掉电重启（§2）。

### S3 —— 按键触发单音 + 听得出 ADSR

- **现象**：不按键时**静音**；按住 AB13，音会**「起来」（约 84 ms 淡入）→ 保持**；
  松手后**约 63 ms 内「消失」（淡出）**。
- **LED**：`led[0]` 心跳、`led[1]` 按住、`led[2]` 包络非零（按住后会亮，松手后过一会儿灭）。
- **通过判据**：**耳朵能明确分辨「起音」和「释放」两段过渡**，而不是「啪」地一下开关。
- **没反应先查**：如果听起来是硬开硬关（没有淡入淡出），说明你烧的不是 S3
  —— 生产版 `top.v` 的包络参数起音只有 40.96 µs，**耳朵是听不出包络的**
  （这是本项目已确认的一处注释/参数错误，见 `_smoke-test/REPORT.md`）。

### S4 —— 按键切 3 种音色

| 音色号（`led[3:2]`） | 波形 |
|---|---|
| `00` | 纯正弦（柔和，像 S2/S3） |
| `01` | 带限锯齿（明亮） |
| `10` | 带限方波（中空） |
| `11` | 带限三角波（更柔和但有厚度） |

- **操作**：**按一下 AB13 换下一个音色**，**按一下 Y12 换上一个音色**（0↔3 循环）。
- **通过判据**：音色**明显**变化，而且 `led[3:2]` 显示的号数与听到的音色对得上。
- **这一步证明了什么**：音色是**用户可控**的，不是定时器自动轮换
  （生产版 `top.v` 用的是计数器自动轮换，不可控）。

### S5 —— ★ 32 路复音测试模式（赛题必备取证）

| LED | 含义 |
|---|---|
| `led[3:1]` | 常亮（表示 32 路全部在发声） |
| `led[0]` | 心跳 |

- **现象**：耳机里是**一个很厚的和弦式嗡鸣**（32 个音同时响，200 Hz 间隔，从 200 Hz 到 6400 Hz）。
- **通过判据**：**录音 + FFT 能数出 32 根独立谱峰**。完整步骤见 §7。
- **快速定性检查（零设备）**：用手机上的频谱 App 对着耳机/喇叭，
  应该看到**间隔均匀的梳状谱峰**（每 200 Hz 一根）。能看出梳状就说明是多音同时发声。

### S6 —— 延迟测量

| LED | 含义 |
|---|---|
| `led[0]` | 心跳 |
| `led[1]` | 按住 AB13 |
| `led[2]` | **本次测量「按键→出声」< 10 ms**（赛题基础要求②的硬指标） |
| `led[3]` | **本次测量「按键→出声」< 5 ms**（拓展要求③） |

- **零仪器自测法（推荐先做这个）**：
  1. 按一下 AB13 再松开；
  2. 看 `led[3]` / `led[2]`：**`led[3]` 亮 = < 5 ms（优秀）；只有 `led[2]` 亮 = < 10 ms（达标）；
     两个都不亮 = 超过 10 ms（不达标，要查）**。
  3. 注意：**必须先按过一次键**再判读（没按过之前两个灯都不亮）。
- **⚠️ 这是 FPGA 自测**，不是独立测量。它数的是芯片内部从按键引脚第一次被拉低，
  到音频样本幅度越过阈值之间的 50 MHz 时钟数，**包含去抖窗口**。
  独立测量（示波器 / 声卡）应当复现同一量级；**两者不一致时，先怀疑测量方法，而不是直接信这个灯**。
- **定量测量（示波器 / 声卡）见 §8。**
- **理论延迟预算**（按 RTL 参数算出来的，不是实测）：

  | 环节 | 时间 | 说明 |
  |---|---|---|
  | 按键输入两级同步 | 0.04 µs | 2 个 50 MHz 时钟 |
  | 按键去抖 | **2.621 ms** | 2^17 = 131072 个 50 MHz 时钟，**主要贡献项** |
  | 包络爬到可闻阈值 | 0.035 ms | 实测 34.8 µs（3 个采样点 @ 97.656 kHz） |
  | **合计（到 DAC 收到非零样本）** | **2.656 ms** | 确定性，无软件调度抖动 |
  | DAC 转换 + 功放 + 耳机 | < 1 ms | 器件级，未实测 |

  ⇒ **< 5 ms**，满足赛题「基础要求② ≤10 ms」，也够拓展③的「≤5 ms」。
  **必须由你的实测确认**（可用 §8.1 示波器法或 §8.2 声卡法）。

- **RTL 仿真已实测（ModelSim，不是上板）**：`sim/tb/tb_smoke.v` 的 `tb_smoke_s6` 测出
  **物理接触 → 出声 = 2.656 ms**（去抖窗口 2.621 ms + 音频通路 34.8 µs），
  并且 **FPGA 内部自测计数器 `lat_val` = 132812 clk = 2.6560 ms，与外部边沿测量差 < 0.001 ms**
  —— 说明 LED 上那套「<5 ms / <10 ms」判定灯的口径是可信的。
  **但这是仿真值**：上板后请把示波器/声卡测到的数字填进报告。

---

## 6. 换级操作速查

| 想看的级 | 构建 | 烧这个文件 |
|---|---|---|
| S0 | `-Stages 0` | `_smoke-test\eda_s0\smoke_top_s0\impl\pnr\smoke_top_s0.fs` |
| S1 | `-Stages 1` | `_smoke-test\eda_s1\smoke_top_s1\impl\pnr\smoke_top_s1.fs` |
| S2 | `-Stages 2` | `_smoke-test\eda_s2\smoke_top_s2\impl\pnr\smoke_top_s2.fs` |
| S3 | `-Stages 3` | `_smoke-test\eda_s3\smoke_top_s3\impl\pnr\smoke_top_s3.fs` |
| S4 | `-Stages 4` | `_smoke-test\eda_s4\smoke_top_s4\impl\pnr\smoke_top_s4.fs` |
| S5 | `-Stages 5` | `_smoke-test\eda_s5\smoke_top_s5\impl\pnr\smoke_top_s5.fs` |
| S6 | `-Stages 6` | `_smoke-test\eda_s6\smoke_top_s6\impl\pnr\smoke_top_s6.fs` |

**七级用的是同一个 `rtl/smoke/smoke_top.v`**，只是构建时选不同的顶层封装模块。
所以「换了级再烧」不会引入新的 RTL 差异，排错时可以先排除这一项。

---

## 7. S5 频谱取证：数出 32 根谱峰

### 7.1 先确认工具本身没坏（不需要硬件，30 秒）

```powershell
& "C:\Users\Danny\Desktop\FPGA competition\fpga_hank\_tools\venv\Scripts\python.exe" `
  "C:\Users\Danny\Desktop\FPGA competition\fpga_hank\tools\verify\check_peaks.py" --selftest
```

最后一行应该是 `SELFTEST: PASS`。
（**已在本机实测通过**，见 `_smoke-test/REPORT.md`。这一步跑不过，后面的数谱峰就没有意义。）

### 7.2 录音

**方案 A：电脑声卡 + 3.5 mm 线（最准）**
1. 一根 3.5 mm 公对公线，从板子的耳机口接到电脑的 **Line-in**（线路输入）；
2. 用 **Audacity**（免费）录音：采样率选 **48000 Hz**（或 96000 Hz），录 **5~10 秒**；
3. 导出成 **无文件头的裸 PCM**：
   `文件 → 导出 → 导出为其它非压缩格式 → 格式：其它非压缩文件 / 头部：RAW (header-less) / 编码：Signed 16-bit PCM`
   例如存成 `C:\Users\Danny\Desktop\FPGA competition\_smoke-test\s5_rec.raw`
   （⚠️ check_peaks.py **不认 WAV 文件头**，必须导出成 header-less RAW。）

**方案 B：麦克风录（没有线也能做）**
1. 电脑或手机麦克风对着板载扬声器座/耳机口，录 5~10 秒；
2. 同样导出成 RAW signed 16-bit PCM。
   （麦克风录会引入环境噪声，可能让杂散变多，但 32 根主峰仍然应该清楚。）

**方案 C：手机频谱 App（零成本定性）**
对着耳机/喇叭看频谱，应该看到间隔 200 Hz 的梳状谱峰。

### 7.3 跑检查

```powershell
& "C:\Users\Danny\Desktop\FPGA competition\fpga_hank\_tools\venv\Scripts\python.exe" `
  "C:\Users\Danny\Desktop\FPGA competition\fpga_hank\tools\verify\check_peaks.py" `
  --file "C:\Users\Danny\Desktop\FPGA competition\_smoke-test\s5_rec.raw" `
  --format pcm16 `
  --fs 48000 `
  --count 32 --start 200 --step 200 `
  --plot "C:\Users\Danny\Desktop\FPGA competition\_smoke-test\s5_fft.png"
```

**`--fs` 填多少？**
> **填你录音时用的采样率**（Audacity 里选的那个），**不是**填 FPGA 的采样率 97656.25。
> 因为 FFT 要的是「这段录音每秒有多少个采样点」。
> 我们要找的谱峰频率（200、400、…、6400 Hz）是**绝对频率**，
> 只要录音采样率 ≥ 12800 Hz（6400 的 2 倍）就一定能看到。
> **常见写法：Audacity 选 48000 → `--fs 48000`。选 96000 → `--fs 96000`。写错了峰的位置会整体错。**

期望输出：
```
结论: PASS - 检出 32 路独立谱峰
```
`--plot` 生成的 PNG 就是可以直接放进报告的频谱截图。

**如果 FAIL，按这个顺序查**：
1. `--fs` 是不是填成了 97656.25（最常见的错）？
2. 录音是不是削波（Audacity 里波形顶到 ±1.0 了）→ 调低电脑输入音量重录；
3. 是不是没导出成 RAW（带 WAV 头会让前 44 字节变成杂散）；
4. 录音里有没有环境噪声/说话声 → 安静环境重录；
5. 是不是烧成了 S3/S4（那只有单音，不会出现 32 根柱子）。

---

## 8. S6 延迟测量：三种方法

**要测的定义**：从**按键被物理按下（电接触第一次闭合）** 到**音频通路输出第一个可闻样本**的时间差。

### 8.1 方法 A —— 示波器（最准，推荐）

**接线**（3 个打标脚都在板子同一组排针上，见 §9）：

| 示波器 | 接板子 | 信号含义 |
|---|---|---|
| CH1 | `DBG_KEY` (Y22) | 按键**原始**电平，未去抖。按下瞬间就变高 |
| CH2 | `DBG_AUDIO` (AB22) | 音频通路**已经送出可闻样本**，变高 |
| （可选 CH3）| `DBG_GATE` (AB21) | 去抖**之后**决定了「应该发声」 |

**怎么读**：
1. 触发设成 **CH1 上升沿**、单次（Single）模式；
2. 按一下 AB13；
3. 读 **CH1 上升沿 → CH2 上升沿** 的时间差 = **「按下→出声」延迟**；
4. 读 **CH1 → CH3** 的时间差 ≈ **去抖窗口**（应该约 2.62 ms）；
5. 多按几次（≥20 次），记下最小/最大/平均，一起写进报告。

**预期**：CH1→CH2 约 **2.6~2.7 ms**。
**注意**：如果按键抖动时间长，CH3 的边沿会后移，这是真实存在的机械抖动，不是设计问题。

### 8.2 方法 B —— 声卡双声道（没有示波器）

思路：把**音频**送进声卡的**左声道**，把**打标信号**送进**右声道**；
两个信号走**同一个 ADC**，所以声卡自己的延迟会**互相抵消**，剩下的是我们要测的时间差。

**需要**：
- 3.5 mm 立体声（TRS）插头一个 + 两根细线（或一根公对公线剪开用）；
- 电阻：**10 kΩ 和 1 kΩ 各一只**。

**接线**：

```
TRS 插头（插电脑 Line-in）
  Tip    (左) ─── 从板子耳机口的输出 ──────────────── 音频
  Ring   (右) ──[10kΩ]── DBG_AUDIO (AB22) ──[1kΩ]── GND(板子)
  Sleeve (地) ─── 板子 GND
```

- 分压后 DBG_AUDIO 的 3.3 V 变成约 **0.3 V**，对 Line-in 是安全电平。
- ⚠️ **优先插 Line-in（线路输入）**。如果只有 **Mic-in**（麦克风口），
  有些机器会给麦克风供偏置电压，**务必确认接口类型后再接**，不确定就不要接。
- ⚠️ **不要**把 3.3 V 直接接进声卡输入。

**怎么读**：
1. Audacity 录**立体声**，采样率 48000 Hz；
2. 按一下 AB13；
3. 放大波形，找**右声道的台阶上升沿**（= 按键按下）和**左声道波形开始振荡的位置**（= 出声）；
4. 两个位置的时间差 = 延迟。Audacity 里把时间轴单位切到毫秒就能直接读。

**精度局限**：
- 采样点间隔 = 1/48000 s = **20.8 µs**，所以量化误差 ≤ ±21 µs；
- 声卡是**交流耦合**的，所以右声道那个「台阶」会变成「跳上去再慢慢回落」——
  **边沿位置仍然准确**，读边沿即可；
- 主要误差来自「怎么判断音频开始」：建议把判据定为**左声道幅度超过满幅 1%** 的第一个点。
- 综合误差量级：**±0.1 ms 以内**，对 10 ms 的指标足够了。

### 8.3 方法 C —— 零仪器（FPGA 自测 + 耳朵）

1. **S6 的 LED 自测**（§5 S6）：`led[3]`/`led[2]` 给「<5 ms / <10 ms」的合格判定。
   这是**真实的计数器**（不是估算）：ModelSim 仿真实测内部计数器与外部边沿测量
   **吻合到 0.001 ms 以内**（`_smoke-test/REPORT.md` §5.2）。
   **但它测的是芯片内部，属于"自测"** —— 写报告时建议至少再用方法 A 或 B 独立复核一次。
2. **耳朵判定**：按住再松开，如果听不出任何「延迟感」——这**只能排除上百毫秒级的延迟**，
   **不能证明 ≤10 ms**。写报告时**不要**把这一条当成 10 ms 的证据。

---

## 9. 打标脚与按键怎么找（不用看原理图）

S0 里三个打标脚会各自输出**不同频率**的方波，用它来认脚：

| 引脚 | S0 输出的频率 | 用途 |
|---|---|---|
| **Y22** | 1.49 Hz | `DBG_KEY` |
| **AB21** | 2.98 Hz | `DBG_GATE` |
| **AB22** | 5.96 Hz | `DBG_AUDIO` |

**认脚方法**（任选）：
- **万用表**：打到频率档（Hz），黑表笔接板子 GND，红表笔挨个碰排针，
  读到 1.5 / 3.0 / 6.0 Hz 的三个脚就是它们；
- **示波器**：探头接地夹接 GND，逐个碰排针看波形；
- **一只 LED + 1 kΩ 电阻**：LED 长脚经电阻接排针、短脚接 GND，
  看闪烁快慢也能分辨（快的 = AB22）。

**按键**：官方引脚文件 `tang_mega_138K_pins.cst` 的 `====== Keys ======` 段里**只有两个键**：

| 按键 | 引脚 | 电平 |
|---|---|---|
| `Key_in[0]` | **AB13** | LVCMOS33 / 3.3 V / 内部上拉 |
| `Key_in[1]` | **Y12** | LVCMOS33 / 3.3 V / 内部上拉 |

板上丝印/位置的对应关系我没有实物，**请先跑 S1**：按哪个键 `led[1]` 亮，
哪个就是 AB13；按哪个键 `led[3:2]` 清零，哪个就是 Y12。
（如果按遍所有键都没反应，请把现象告诉 `liaison`。）

> ⚠️ `F4` 这个脚在别的例程里被当复位键用过，但它在 **1.5 V bank**，
> 和本设计其它所有 3.3 V 脚不同域，**本设计故意没用它**。

---

## 10. 故障速查

| 现象 | 最可能的原因 | 怎么办 |
|---|---|---|
| 灯闪一下又重来 / 跑到一半复位 | **单口 USB 供电掉电重启** | 双路 USB（USB3.0 + DEBUG-USB）或 12 V DC |
| 上电后什么都不亮 | 没长按 PWR 2 秒；或没烧进去 | 长按 PWR；重烧 S0 确认链路 |
| S0 的灯**完全不闪** | 时钟没跑 / 烧错器件版本 / 烧的是空码流 | 重新构建 S0 并核对构建输出里的 `PASS`；重烧 |
| S1 按键无反应 | 按的不是 AB13/Y12；或按键本身接触问题 | 见 §9；先跑 S0 确认板子活着 |
| S1 计数一次跳好几下 | 去抖窗口偏小 | 加大 `rtl/smoke/smoke_top.v` 里的 `DB_MAX` 并重建 |
| S2 没声音 | ① 耳机没插对孔 ② 烧的不是 S2 ③ 功放/供电问题 | 逐个排除；看 `led[1]` 是否亮 |
| S2 有声音但音高不对 | 采样率与频率字不匹配 | 本设计用 `BCK_DIV=1`（fs=97656.25 Hz）与 `tone_bank.v` 的频率字是配套的，别单独改其中一个 |
| S3 听不出包络（硬开硬关） | 烧的不是 S3 | 重烧 `smoke_top_s3.fs` |
| S4 音色不变 | 烧的不是 S4；或按的是同一个键 | 重烧；两个键都试试 |
| S5 数不出 32 根柱子 | `--fs` 填错 / 录音削波 / 导出成了 WAV / 烧成了单音级 | 见 §7.3 的五步排查 |
| 录音里有嗡嗡低频干扰 | 地环路 / 供电噪声 | 用电池供电的笔记本、或加隔离；麦克风录 |
| 某个打标脚测不到信号 | 认错脚了 | 跑 S0 按 §9 用频率认脚 |

---

## 11. 附录 A：完整引脚表（本次构建实测落位）

| 端口 | 球号 | 方向 | 电平 | 说明 |
|---|---|---|---|---|
| `clk` | V22 | in | LVCMOS33 / 3.3 V | 50 MHz 有源晶振（也是 EMCCLK，P&R 会报 PR1014 告警，已知且可接受） |
| `key` | AB13 | in | LVCMOS33 / 3.3 V / UP | 用户按键 Key_in[0]，按下 = 0 |
| `key2` | Y12 | in | LVCMOS33 / 3.3 V / UP | 用户按键 Key_in[1]，按下 = 0 |
| `led[0]` | T18 | out | LVCMOS33 | 板载 LED，**低有效** |
| `led[1]` | R18 | out | LVCMOS33 | 板载 LED，低有效 |
| `led[2]` | R17 | out | LVCMOS33 | 板载 LED，低有效 |
| `led[3]` | P16 | out | LVCMOS33 | 板载 LED，低有效 |
| `HP_BCK` | Y17 | out | LVCMOS33 | PT8211 I2S 位时钟 |
| `HP_WS` | AB17 | out | LVCMOS33 | PT8211 I2S 字选 |
| `HP_DIN` | AA16 | out | LVCMOS33 | PT8211 I2S 数据 |
| `PA_EN` | AB16 | out | LVCMOS33 | 功放使能，**低有效**（S0/S1 故意拉高关掉） |
| `DBG_KEY` | Y22 | out | LVCMOS33 | 打标脚（S6 / S0 认脚用） |
| `DBG_GATE` | AB21 | out | LVCMOS33 | 打标脚 |
| `DBG_AUDIO` | AB22 | out | LVCMOS33 | 打标脚 |

> ⚠️ **以下引脚在本板（GW5AST-138C）上是 CPU/SSPI 专用脚，布局器会直接拒绝，不要用**
> （一次 14 脚 P&R 探针实测，原始输出见 `_smoke-test/REPORT.md`）：
> `Y21`(SSPI)、`U21`(CPU/SSPI)、`T21`(CPU)、`R19`(CPU/SSPI)、`P19`(CPU/SSPI)。
> 网上有些官方例程（`dock.cst`、`Joycon.cst`）把 `U21` 当 LED 用 —— 那些工程是
> **device version B** 的，**不能直接搬到本板上**。

## 12. 附录 B：产物与日志在哪

| 东西 | 路径 |
|---|---|
| 分级构建脚本 | `fpga_hank\tools\gowin\build_smoke.tcl` / `build_smoke.ps1` |
| 冒烟 RTL | `fpga_hank\rtl\smoke\smoke_top.v` |
| 冒烟约束 | `fpga_hank\constr\smoke.cst`、`fpga_hank\constr\smoke.sdc` |
| bitstream | `_smoke-test\eda_s<级>\smoke_top_s<级>\impl\pnr\smoke_top_s<级>.fs` |
| 每级构建日志 | `_smoke-test\logs\build_s<级>.log` |
| 引脚报告 | `_smoke-test\eda_s<级>\smoke_top_s<级>\impl\pnr\smoke_top_s<级>.pin.html` |
| 资源/时序报告 | 同目录下的 `.rpt.txt`（资源）与 `.tr.html`（时序） |
| 我的构建记录与结论 | `_smoke-test\REPORT.md` |
| 频谱检查工具 | `fpga_hank\tools\verify\check_peaks.py` |

## 13. 附录 C：不用板子也能先跑的两个仿真

上板之前，可以先在电脑上把 S2 和 S6 跑一遍 —— **不需要板子、不需要耳机、不需要示波器**。

```powershell
# 在 fpga_hank 目录下执行（注意先 cd）
Set-Location "C:\Users\Danny\Desktop\FPGA competition\fpga_hank"

# S2：440 Hz 正弦 + I2S 波形自检
$env:SIM_TOP = "tb_smoke_s2"
& "F:\Modelsim_10.7\win64\vsim.exe" -c -do sim\run.do

# S6：按键→出声 延迟自检
$env:SIM_TOP = "tb_smoke_s6"
& "F:\Modelsim_10.7\win64\vsim.exe" -c -do sim\run.do
```

期望输出（本机实测，见 `_smoke-test/REPORT.md` 原文）：

- `tb_smoke_s2`：正负样本数接近相等、频率 440.0 Hz、BCK 周期 320.0 ns，三项全 PASS；
- `tb_smoke_s6`：物理接触→出声 **2.656 ms**，内部自测计数器 132812 clk，两项都 PASS。

> ⚠️ 这是 **RTL 行为级**仿真，验证的是源码语义。
> 它**不能**替代上板，也**不能**证明 Gowin 综合出来的门级网表与 RTL 完全等价。
> 它的价值是：在没有板子的时候先把"设计对不对"和"板子/接线对不对"这两类问题分开。

## 14. 附录 D：哪些是「已构建验证」、哪些是「未验证」

**已构建验证（我真实跑过，有原始输出）**
- S0–S6 七级的 `syn` + `pnr` 全部通过，每级都产出 `.fs`（见 `REPORT.md` 的资源表）
- 每级引脚报告里**所有端口 `constrained=Y`**（没有任何一个被工具静默自动摆放）
- S6 时序 **0 setup / 0 hold 违例**，实际 Fmax 103.7 MHz（约束 50 MHz）
- **S2 的 RTL 仿真**：440.0252 Hz、正负样本对称、BCK 周期 320.0 ns —— 三项全 PASS
- **S6 的 RTL 仿真**：物理接触→出声 **2.656 ms**，内部自测计数器与外部边沿测量吻合到 0.001 ms
- `check_peaks.py --selftest` = PASS
- 「冒烟文件不会被正式 `build.tcl` 收进去」—— 已用脚本复刻 `build.tcl` 的收集逻辑证实
- 14 个候选引脚的可用性探针（哪些能布、哪些是 CPU/SSPI 专用）

**未验证（必须你上板）**
- 烧录流程本身（我没执行过 Gowin Programmer）
- 所有「看到 / 听到」的现象（LED 是否闪、耳机是否有声、音色是否变）
- **S6 的板上实际延迟**：2.656 ms 是 **RTL 仿真值**，不含 DAC/功放/耳机的物理时间，
  必须用 §8.1 或 §8.2 在真板上复测
- S5 的真板录音频谱（仿真侧已有 32/32 谱峰的验证，见 `fpga_hank/docs/32复音-验证报告.md`）
- 「长按 PWR 2 秒开机」「单口 USB 掉电重启」这两条来自官方 Wiki 与团队调研，**我本人没有板子可验证**
- 三个打标脚在物理排针上的**具体位置**（只知道球号，不知道实物丝印）
- 门级网表与 RTL 是否完全等价（只做了 RTL 行为级仿真，没做 post-PnR 门级仿真）
