wongben2333-crypto/26Embedded/fpga_hank/docs/波形截图-照做卡.md

> **当前口径（v8.1，2026-11-04，适用于本仓库全部说明文档）**：目标板 138K，交付位流 MODE=3；合成引擎 TDM32 32 声部×6 泛音=192 路（48 路全并行仅作对比基线）；音色统一为钢琴/吉他/小提琴 3 种（对外只列这三种）；交互为 13 键硅胶轻触按钮 + 6 路光电 + 双路 ToF（A 主用/B 热备）+ 7 寸触控，4 路 EC11 仅预留；PCB1 为“输入调理与隔离转接板”（上拉/限流/RC/PC817 光耦/ToF 双总线供电/地分割），防爆音在 RTL 三道清音 + PA_EN，不在 PCB；整机物理输入→模拟输出实测 2 ms，芯片内部 ≤20.5 µs，TDM32 流水 3.85 µs；7 寸屏经 34P FPC→J14 40P 排线，不再使用 P34-P40 转接板与 piano6 PCB；交付曲目为 4 首公有领域曲目（源码 Song 0 待删）；32 峰为必备取证，192 路由 RTL 状态阵列证明。**与旧描述冲突处，以本块为准。**

# 波形图产出说明（内部）— 用户不再需要自己截屏

> **状态变更**：用户看到我们能自己截屏后，已免除他的截屏分工：
> 「你既然能自己截屏那就不需要我截屏了，你截屏完自己分析把」
>
> ⇒ 本文件**不再是"给用户的照做卡"**，只保留"怎么复现"的部分。
> **交付物在 `fpga_hank/docs/waveforms/real/`**，索引见该目录的 `README.md`。

---

## 交付物（5 张 ModelSim 真窗口截图）

| # | 文件 | 在证什么 |
|---|---|---|
| 1 | `docs/waveforms/real/1_pt8211_位序与声道边界.png` | I2S 位序与左右声道边界正确 |
| 2 | `docs/waveforms/real/2_ADSR_起音与释放.png` | 包络按斜率升降，不是瞬时开关 |
| 3 | `docs/waveforms/real/3_tone_bank_32路混音.png` | 32 路分时查表 + 实时混音输出 |
| 4 | `docs/waveforms/real/4_按键到出声_因果链.png` | 按键 → 同步 → 去抖 → gate → 包络 → 出声 |
| 5 | `docs/waveforms/real/5_按键去抖_抖动边界用例.png` | 抖动 16 次通断，去抖后只认 1 次 |

**采集方式**：真仿真 → `.wlf` 数据集 → `vsim -gui -view <wlf> -do <do>` 打开工具窗口
→ `PrintWindow` 抓窗口自身（不受遮挡影响）→ 两项像素自检（菜单栏 + 波形区有绿色波形）通过才算成功。
**不是脚本绘图**（脚本绘图已被用户否决）。

## 复现

```powershell
cd "C:\Users\Danny\Desktop\FPGA competition\fpga_hank"

# 1) 生成 .wlf（已生成好，在 sim\wlf\；重跑约 1 分钟）
foreach ($t in "tb_wave_pt8211","tb_wave_adsr","tb_wave_tonebank","tb_wave_chain","tb_wave_bounce") {
  $env:SIM_TOP=$t; & "F:\Modelsim_10.7\win64\vsim.exe" -c -do sim\make_wlf.do
}
Remove-Item Env:\SIM_TOP

# 2) 打开窗口看（一条命令一张图）
& "F:\Modelsim_10.7\win64\vsim.exe" -gui -view "sim\wlf\tb_wave_pt8211.wlf" -do "sim\wave_pt8211.do"

# 3) 自动截图（带自检）
powershell -NoProfile -ExecutionPolicy Bypass -File `
  "..\_smoke-test\cap_window.ps1" -Wlf "sim\wlf\tb_wave_pt8211.wlf" -Do "sim\wave_pt8211.do" `
  -Out "docs\waveforms\real\1_pt8211_位序与声道边界.png"
```

## 如果窗口打开不对

| 现象 | 原因 | 怎么办 |
|---|---|---|
| 波形区一片灰、只有组名 | `add wave -group` 的分组默认收起 | 已改用 `add wave -divider`（本仓库已修） |
| 抓到的图不是 ModelSim | 用了全屏 `CopyFromScreen` 被别的窗口遮挡 | 用 `cap_window.ps1` 的 `PrintWindow` |
| 自检报 `greenRight` 太低 | 波形区没画出波形 | 看 `sim\wave_*.do` 的信号路径是否与 testbench 实例名一致 |
| 报 `缺少 ...\wlf\xxx.wlf` | 数据集没了 | 跑上面第 1 步 |
