wongben2333-crypto/26Embedded/fpga_hank/skills/probe-flat.md

---
name: probe-flat
description: Discovery probe for a flat <name>.md skill file at the project root; delete after the probe.
---

# probe-flat

Discovery probe for the flat-file form `$projectRoot/.dsh/skills/<name>.md`.
