wongben2333-crypto/26Embedded/fpga_spark/docs/60K_硬件资源与引脚核对.md

# Tang Mega 60K 硬件资源与引脚核对

> 依据：Sipeed 官方原理图 3 份 + 官方 60K 管脚约束文件交叉验证。
> 目的：为 `fpga_spark` 的交互/音频外设接线与约束提供**可追溯的引脚依据**，并标出当前 `constraints/tang_mega_60k_pins.cst` 中与硬件不符的条目。
> 核对日期：2026-10-18

---

## 0. 结论摘要

| 结论 | 说明 |
|---|---|
| ✅ 时钟 `V22` 正确 | SOM 板载 50MHz 有源晶振 → `BANK7_V22_EMCCLK_50Mhz` |
| ❌ 两个按键约束错位 | `AA13` 是**系统复位**，`AB13`/`Y12` 才是用户键；且三者都在 **1.5V BANK9** |
| ❌ I2S 四个引脚全部错误 | `G15/G16/H15/J15` 实际是 **HDMI TMDS 差分对**；音频应为 `Y17/AB17/AA16` |
| ❌ MCLK 不存在 | 板载 PT8211 **无 MCLK 引脚**，`J15` 也不是音频脚 |
| ❌ LED 约束不可用 | 现约束中的 `W18` 在 60K SOM 上不存在，`V17/AA19/AA18` 是专用配置/PLL 脚 |
| ⚠️ 音频格式不匹配 | PT8211 是 **LSB-justified、无 MCLK**；当前 RTL 是标准 Philips I2S + MCLK |
| ⚠️ 采样率偏高 1.7% | BCLK=50MHz/16=3.125MHz → Fs≈48.83kHz（音高约 +29 cent） |

---

## 1. 板卡构成

### 1.1 Tang Mega 60K 核心板（SOM）

来源：`tang_mega_60k_30353_schematics.pdf`、`tang_mega_60k_30354_schematics..pdf`
（两份均为 `Siped_TANG_MEGA_60K` Rev 1.0，2025-06-27，7 页，内容基本一致）

| 页 | 内容 |
|---|---|
| 1 | BTB 连接器：C2399/C2400 `DF40C-100DP-0.4V`、BTB900 `DF40C-80DP-0.4V` |
| 2 | MSPI Flash（W25Q64）、JTAG（8P 1.0mm）、按键、LED、50MHz 晶振 |
| 3 | 2 × DDR3 |
| 4 | BANK 1/2/5 |
| 5 | BANK 3/4/6/7/8/12/GT/ADC |
| 6 | POWER / FPGA |
| 7 | Board Power |

关键事实：

- 板载 50MHz 晶振 `Y1100` → 网络 `BANK7_V22_EMCCLK_50Mhz` → **FPGA ball V22**。
- 系统按键两个：`BANK3_N12_RECONFIG`、`BANK11_F4_CPU_RESET`。
- 状态 LED 三颗：`BANK3_G11_DONE`、`BANK3_U12_READY`（不可当用户 LED 任意驱动）。
- 配置 Flash：W25Q64（MSPI）。
- JTAG：`V12/U13/R13/T13`（TCK/TDO/TDI/TMS）。

### 1.2 Tang Mega NEO Dock 60K（31004，Rev 1.4，2025-03-31，21 页）

| 页 | 功能 |
|---|---|
| 1–2 | 系统框图 / 电源树 |
| 3–4 | PMIC、5V→3V3/1V8、DC-DC、12V/PCIe/USB-C ORING |
| 6–7 | SOM BTB0 / BTB1&2（含 DIP 开关、按键上下拉） |
| 8 | USB-JTAG / UART |
| 9 | 外设：按键、WS2812、USB-A、FAN |
| 10 | **FPGA-Audio：PT8211 DAC + NS4263 功放 + 3.5mm** |
| 11 | RGMII 以太网 |
| 12 | RGB LCD（DPI） |
| 13 | PCIe x4 |
| 14 | JoyCon |
| 15 | DVI/HDMI（TMDS） |
| 16 | SDIO / M.2 |
| 17 | DVP 摄像头 |
| 18 | 时钟：MS5351M，USR_CLK_IN |
| 19 | 扩展接口：2×40P、2×6P、FPC10、ADC |
| 20–21 | USB-C / USB3 PHY |

供电：12V DC（DC5521）或 USB-C PD；板载 PT8211 + NS4263（3W 双喇叭）+ 3.5mm 耳机。

---

## 2. 关键引脚（原理图 + 官方 cst 双份确认）

来源：31004 原理图 P7/P9/P10/P18 + 官方 `tang_mega_60K_pins.cst`（仓库
`Tang_Mega_60K_138K硬件资料/04_管脚约束与走线_Pinout_Constraints/`）。

| 功能 | 信号 | FPGA ball | 电平 / BANK | 网络名 | 备注 |
|---|---|---|---|---|---|
| 系统时钟 | `sys_clk` | **V22** | 3.3V / BANK7 | `BANK7_V22_EMCCLK_50Mhz` | SOM 50MHz 晶振 |
| 系统复位 | `sys_rst_n` | **AA13** | **1.5V / BANK9** | `EX_KEY.0` | 内部上拉到 1.5V，低有效 |
| 用户键 0 | `Key_in[0]` | **AB13** | **1.5V / BANK9** | `EX_KEY.1` | 内部上拉 |
| 用户键 1 | `Key_in[1]` | **Y12** | **1.5V / BANK9** | `EX_KEY.2` | 内部上拉 |
| 音频位时钟 | `HP_BCK` | **Y17** | 3.3V / BANK7 | `I2S_BCLK` | PT8211 BCK |
| 音频帧时钟 | `HP_WS` | **AB17** | 3.3V / BANK7 | `I2S_LRCK` | PT8211 WS |
| 音频数据 | `HP_DIN` | **AA16** | 3.3V / BANK7 | `I2S_DIN` | PT8211 DIN |
| 功放使能 | `PA_EN` | **AB16** | 3.3V / BANK7 | `PA_EN` | **低有效**（0=开功放） |
| WS2812 | `WS2812` | **J16** | 3.3V / BANK1 | `WS2812` | 单线灯带 |
| 外部时钟 | `USR_CLK_IN` | **AB12** | **1.5V / BANK9** | `USR_CLK_IN` | MS5351M 输出；必须约束 1V5 |
| 串口 TX | `txp` | **U15** | — | `FPGA_UART.TX` | 与 BL616 调试器共用 |
| 串口 RX | `rxp` | **V14** | — | `FPGA_UART.RX` | 31004 及以后版本 |
| ADC 正端（V） | `ADCV_P` | **L10** | 模拟 | `L10_ADCVP` | 0–1V 差分 |
| ADC 负端（V） | `ADCV_N` | **M9** | 模拟 | `M9_ADCVN` | |
| ADC 正端（T） | `ADCT_P` | **N10** | 模拟 | `N10_ADCTP` | |
| ADC 负端（T） | `ADCT_N` | **N9** | 模拟 | `N9_ADCTN` | |
| HDMI TMDS0 | `tmds_d_p_0[0]` | **J14/H14** | 3.3V / BANK4 | — | 差分对，勿挪用 |
| HDMI TMDS1 | `tmds_d_p_0[1]` | **J15/H15** | 3.3V / BANK4 | — | 差分对 |
| HDMI TMDS2 | `tmds_d_p_0[2]` | **K17/J17** | 3.3V / BANK5 | — | 差分对 |
| HDMI CLK | `tmds_clk_p_0` | **G15/G16** | 3.3V / BANK4 | — | 差分对 |

### 2.1 扩展口 PMOD1（31004 P7 行对齐核对，3.3V）

| 信号 | ball |
|---|---|
| `PMOD1_IO0` | V20 |
| `PMOD1_IO1` | W21 |
| `PMOD1_IO2` | M17 |
| `PMOD1_IO3` | U20 |
| `PMOD1_IO4` | N17 |
| `PMOD1_IO5` | P17 |
| `PMOD1_IO6` | M15 |
| `PMOD1_IO7` | M16 |

> `PMOD0_IO0..7` 只出现在 40P 排针页（31004 P19），未在 SOM BTB 页找到对应 ball，需按实物/网表二次确认（可能与 SDRAM1/DVP 复用）。

### 2.2 FPC10（31004 P19）

`FPC10P_IO0..4` 位于 **BANK9（1.5V）**，不可直接接 3.3V 传感器。

---

## 3. 现有 `constraints/tang_mega_60k_pins.cst` 勘误

| # | 现有约束 | 原理图/官方约束 | 判定 | 风险 |
|---|---|---|---|---|
| 1 | `clk_50m V22` | `sys_clk V22` | ✅ 正确 | — |
| 2 | `btn_rst_n AB13` | `AB13 = Key_in[0]`，复位是 `AA13` | ❌ 错位 | 按"复位"接线实际读到用户键；真正的复位键无效 |
| 3 | `btn_demo_en AA13` | `AA13 = sys_rst_n` | ❌ 错位 | 按复位会切换演示模式 |
| 4 | 两按键 `IO_TYPE=LVCMOS33` | BANK9 = **1.5V**，官方用 `LVCMOS15 PULL_MODE=UP` | ❌ 电平错 | 3.3V 约束驱动 1.5V bank，行为不确定/有损伤风险 |
| 5 | `i2s_bclk G15` | `G15/G16` 是 HDMI TMDS CLK 差分对；BCLK 应为 `Y17` | ❌ 错脚 | 与 HDMI 冲突，DAC 无时钟 |
| 6 | `i2s_lrck G16` | 同上；LRCK 应为 `AB17` | ❌ 错脚 | 同上 |
| 7 | `i2s_sdata H15` | `H15/J15` 是 HDMI TMDS 数据对；DIN 应为 `AA16` | ❌ 错脚 | 同上 |
| 8 | `i2s_mclk J15` | PT8211 无 MCLK；`J15` 属 HDMI TMDS | ❌ 应删除 | 无用且占用 HDMI |
| 9 | `led_voices[0] U18` | 官方参考按 `T18`（但 NEO 原理图未布该组 LED） | ⚠️ 不可用 | 需按实物确认 |
| 10 | `led_voices[1] V17` | `V17:CSI_B`，配置专用脚 | ❌ 禁用 | 可能导致配置异常 |
| 11 | `led_voices[2] W17` | 60K SOM 网络为 `BANK8_W17`，但 NEO 未布 LED | ⚠️ 不可用 | 无对应 LED |
| 12 | `led_voices[3] W18` | 60K SOM 未列出 `W18` | ❌ 无效 ball | 综合/布局直接报错 |
| 13 | `led_voices[4] AA19` | `AA19:RDWR_B`，配置专用脚 | ❌ 禁用 | 配置/启动异常 |
| 14 | `led_voices[5] AA18` | `AA18:BPLL1_T_IN2/BPLL1_T_FB0`，PLL 专用 | ❌ 禁用 | PLL/时钟资源异常 |
| 15 | 缺少 `PA_EN` | 板载功放使能 `AB16`，低有效 | ❌ 缺失 | 功放可能常关/常开 |
| 16 | 缺少 `WS2812` | `J16` | ⚠️ 缺失 | 无法做灯带可视化 |

**结论：当前 12 条约束（时钟 1 + 按键 2 + LED 6 + I2S 4）中只有 `clk_50m` 一条与板卡一致，其余 11 条需要重写；另缺 `PA_EN` 与 `WS2812`。** 在修正前不建议烧板验证。

---

## 4. 音频链路注意事项

### 4.1 PT8211 时序（31004 P10）

- 型号：`PT8211-S`，引脚 `BCK / WS / DIN / GND / VDD / LCH / NC / RCH`。
- **LSB-justified（日本格式）**，**无 MCLK**。
- 后级 `NS4263` 功放，`PA_EN=0` 开启，`PA_EN=1` 关闭；3.5mm 耳机插入时 `HP-IN=1`。

### 4.2 当前 RTL 的偏差

`rtl/audio_out/i2s_transmitter.v`：

1. 实现的是**标准 Philips I2S**（MSB 延迟 1 BCLK），而 PT8211 要求 **LSB-justified** → 位对齐/声道可能整体错位。
2. 输出了 `i2s_mclk`，但硬件无此引脚 → 白占一个 HDMI TMDS 脚（当前约束在 `J15`）。
3. BCLK = 50MHz / 16 = **3.125MHz**，帧长 64 BCLK → **Fs ≈ 48.83kHz**，比 48kHz 高 1.7%（约 +29 cent）。建议：
   - 用 MS5351M 输出 12.288MHz 作为音频主时钟，再分频得到 3.072MHz/48kHz；或
   - 用小数分频/相位累加器生成 3.072MHz；或
   - 明确接受 48.83kHz 并在文档中标注音高偏差。

### 4.3 建议的最小改动

- 把发送状态机改为 **16-bit LSB-justified**（WS 翻转后先补 16 个 0，再发 16 位数据）。
- 删除 `i2s_mclk` 端口与约束。
- 新增 `pa_en` 输出（`AB16`），复位默认拉高（关功放），播放时拉低。

---

## 5. 电平与供电规则

| 区域 | 电压 | 涉及信号 |
|---|---|---|
| BANK9 | **1.5V** | `AA13`、`AB13`、`Y12`、`AB12`、FPC10、麦克风阵列、`FAN_EN` |
| 其他用户 IO | 3.3V | 音频、WS2812、PMOD1、HDMI、SDRAM、以太网 |
| ADC | 0–1V 差分 | `L10/M9`、`N10/N9` |
| 供电 | 12V DC（DC5521）或 USB-C PD | 双喇叭 3W |

- **禁止**把 3.3V 信号直接接到 BANK9 / FPC10；需要电平转换。
- 5V 传感器（如 HC-SR04 Echo）必须分压到 3.3V。
- 按键为内部上拉到 1.5V、按下接地 → **低有效**，约束需 `PULL_MODE=UP`。

---

## 6. 对交互硬件方案的直接结论

结合 `fpga_ben/硬件方案规划书-交互与传感器硬件.docx`：

| 交互件 | 建议接法 | 引脚依据 |
|---|---|---|
| 钢琴琴键（25/37 键） | 优先 **40P J13/J14 的 PMOD1**（3.3V）；不要接 FPC10（1.5V） | 2.1 节 |
| 红外 ToF（I2C） | PMOD1 任取 2 路（如 V20/W21）软件 I2C | 2.1 节 |
| 槽型光电拨弦 | PMOD1 任取 1 路（如 M17），外部 4.7–10k 上拉 | 2.1 节 |
| EC11 编码器 | PMOD1 取 A/B 两相 + 按键 | 2.1 节 |
| WS2812 灯带 | **J16**，注意 5V 数据电平（必要时加电平转换/串联电阻） | 2 节 |
| 用户按键 | `AB13`（Key0）、`Y12`（Key1），**1.5V** | 2 节 |
| 复位 | `AA13`，**1.5V** | 2 节 |

> 若琴键数量超过 PMOD1 的 8 路，可再用 2×6P（J8/J9）或第二组 40P；每增加一组都要重新核对 SOM BTB 页的 bank/电压。

---

## 7. 待确认项

1. **实物是 31002 还是 31004/更新版本**：`rxp` 在 31002 为 `Y14`，31004+ 为 `V14`。
2. 官方 cst 的 `LEDs[0..7]`（T18/R18/R17/P16/U21/T21/R19/P19）在 **NEO 31004 原理图中未找到对应网络**，可能是旧版 Dock 的 LED；上板前需实测确认。
3. `PMOD0_IO0..7` 的 SOM 侧 ball 未在 BTB 页找到，需查完整网表。
4. 按键/复位极性以实测为准（原理图为内部上拉、按下接地）。
5. WS2812 数据是否经过电平转换，需看实物（P9 仅给出 `WS2812_DOUT`）。

---

## 8. 来源与复现

| 文件 | 版本 | 用途 |
|---|---|---|
| `tang_mega_60k_30353_schematics.pdf` | Rev 1.0 / 2025-06-27 | SOM：BTB、DDR3、BANK、电源 |
| `tang_mega_60k_30354_schematics..pdf` | Rev 1.0 / 2025-06-27 | SOM 另一份导出（内容基本一致） |
| `Tang_Mega_NEO_Dock-60K_31004_Schematics.pdf` | Rev 1.4 / 2025-03-31 | Dock：音频、按键、扩展口、时钟 |
| `Tang_Mega_60K_138K硬件资料/04_管脚约束与走线_Pinout_Constraints/tang_mega_60K_pins.cst` | 官方 | 权威 ball 映射与 IO 标准 |

复现方法：用 PyMuPDF 提取 PDF 文本与坐标，按"同一行 + 水平最近"把网络标签与 `BANKx_<ball>_<tile>` 标签配对；音频/按键/时钟均已用官方 cst 二次核对。
