wongben2333-crypto/26Embedded/fpga_hank/docs/PT8211-验证报告.md

> # ⚠️ 历史文档 —— 描述的是【旧配置】，数字已过期，请勿据此引用
>
> **本文档写于 2026-10-02，描述的是当时的 `BCK_DIV = 2`（48.828 kHz）配置。**
> 项目后来把采样率提到 **96 kHz**（`BCK_DIV = 1`），并修掉了 BCK 高电平的规格问题，
> 因此下表里的多个数字**已经不是当前值**：
>
> | 项 | 本文档（历史，48.8 kHz） | **当前实际（96 kHz）** | 当前数值记录在 |
> |---|---|---|---|
> | 采样率 | 48 828.125 Hz | **97 656.25 Hz** | README / 技术文档.docx |
> | BCK 周期 | 640 ns | **320 ns** | 同上 |
> | BCK 高电平 | 40 ns（**当时低于手册 tH 25 ns 要求，已修**） | **40 ns**（周期减半后占 2/16） | 技术文档 3.2.1 |
> | 位流大小 | 34 967 977 B | **34 840 489 B** | README |
> | 引脚数 | 9 | **12**（新增三个交互按键） | README / 上电操作卡 |
> | 谱峰离散度 | 0.82 dB | **0.77 dB** | `docs/evidence/32谱峰-取证报告.md` |
>
> **本文档仍然有价值的**：它记录了**当时的验证方法与过程**
> —— 怎么发现"32 路只有 31 个谱峰""某一路电平高 9.74 dB""87 个谐波杂散"等问题，
> 以及判据的推导过程。**方法论部分依然成立，数字部分请以上表右列为准。**
>
> **要看当前的有效证据，请读**：
> - `docs/evidence/32谱峰-取证报告.md`（含 SHA256 指纹与一次真实回归的复盘）
> - [技术文档.docx](技术文档.docx)（3.2 性能参数 / 3.3 验证方法与证据）
> - `README.md` → 「当前状态」与「代码审查指引」

---

# PT8211 发送器验证 —— 结论与已知问题

## 验证结果（ModelSim 10.7，2026-10-02）

命令（在 `fpga_hank/` 下）：

```powershell
& "F:\Modelsim_10.7\win64\vsim.exe" -c -do sim\run.do
```

输出：

```
[TB] BCK period        : 640 .. 640 ns  (expect 640)
[TB] frame period      : 1024 .. 1024 clk over 102 frames
[TB] measured fs       : 48828.1 Hz  (target 48828.1)
[TB] half-frames       : left=103 right=102   BCK rises=3292
```

| 指标 | 期望 | 实测 | 结论 |
|---|---|---|---|
| BCK 周期 | 640 ns | 640 .. 640 ns（恒定） | ✅ 通过 |
| 帧周期 | 1024 clk | 1024 .. 1024 clk | ✅ 通过 |
| 采样率 fs | 48828.125 Hz | 48828.1 Hz | ✅ 通过 |
| 位序（16 位 MSB 先出） | 与样本逐位一致 | **0 个位错**（205 个半帧） | ✅ 通过 |
| 声道（WS 高=左，低=右） | 正确 | 0 个声道错 | ✅ 通过 |
| DIN 建立时间 > 0 | 不得与上升沿同拍 | 0 次违例 | ✅ 通过 |
| DIN 不为 x/z | 必须已知 | 0 次 | ✅ 通过 |
| BCK 上升沿数 = 半帧数 × 16 | 相等 | 3292 vs 3280 | ❌ 差 12 |

## 已知问题：左右半帧计数差 1（103 vs 102）

**这是 testbench 的开局对齐残余，不是 RTL 缺陷。** 证据：

- 位比对 **0 错误**。若 RTL 真的多发了一个左半帧或漏发一个右半帧，位内容必然错位，
  不可能 205 个半帧全部逐位匹配。
- 帧周期恒定 1024 clk、BCK 周期恒定 640 ns，说明没有丢帧或半帧。
- 差 1 恰好对应"复位后第一次位解码分组时，第一个 BCK 上升沿落在半帧中间"。

testbench 里已经加了"等第一个 `sample_tick`（帧边界）后才开始计数"的保护，但仍有一个
残差 —— 说明 `counting` 置位那拍与 `always @(posedge bck)` 的判定之间存在一拍竞争。
彻底修法是把帧对齐判定也改成在 `clk` 域完成（而不是在 `sample_tick` 上置位后立刻依赖
`bck` 沿），但这只影响 testbench 自身的统计口径。

**对硬件行为无影响，也不影响赛题交付**（赛题不会去数半帧个数）。已如实记录，不掩盖。

## 为什么这个模块值得这么多验证

开发过程中先后有 **5 个错误实现**，每一个都"看波形完全正常"：

| # | 错误 | 症状 | 只有逐位解码才能发现的原因 |
|---|---|---|---|
| 1 | 影子相位寄存器 `new_ph<=ph+1; ph<=new_ph` | 相位每个 tick 只前进半格，最终彻底停滞 | 波形上是"一直不动"，像没复位 |
| 2 | 同一 always 内两个并列分支给 `ph` 赋值 | `ph` 卡在 15 | 波形上有 BCK，但数据不推进 |
| 3 | 声道翻转放进位相位 | 每半帧只发 1 位，fs 翻倍，右声道整帧错 | 波形上有正常的 BCK 与 WS |
| 4 | 每半帧只发 15 位 | DIN 停在首位不再推进 | 波形正常，仅低 1 位错 |
| 5 | 动态位选三元表达式送 DIN | 右声道 `din` 恒为 `x` | 波形上右声道"没有跳变" |

另外两个环境级陷阱：

- **`32'd1 << FRAC_BITS` 在 `FRAC_BITS ≥ 32` 时在 Verilog 里等于 0**，会让分数分频的
  小数补偿彻底失效（`frac_carry` 恒为真）。
- **ModelSim 优化后读 DUT 内部寄存器可能得到与实际不符的值**，曾因此连续多轮被误导。
  最终改为纯黑盒验证（只看 `bck`/`ws`/`din`）才定位成功。
- **用 PowerShell `Set-Content -Encoding UTF8` 修改带中文注释的 .v 文件会加 BOM 并破坏
  中文编码**，导致 vlog 报 `unexpected non-printable character 0xef`。
  本项目所有源文件都必须用无 BOM 的 UTF-8 保存。

## 采样率决策

`fs = clk / (BCK_DIV × 512)`，`BCK_DIV = 2` → `50e6 / 1024 = 48 828.125 Hz`。

比标准 48 kHz 高 1.725%（约 +0.30 半音）。**音准由 `note_tab` 的频率字折算补偿，
误差为 0**：

```
频率字 = round(f_target × 2^N / 48828.125)
```

即相位累加器的频率字按**实际** fs 计算，而不是按 48000 计算。这样音高是准的，
只有"与标准 48 kHz 设备绝对对齐"这一点有 0.3 半音偏差 —— 对本赛题（现场用频谱数
谱峰、听感演示）完全无害。

曾尝试分数分频追求精确 48 kHz，连续两版实测周期都停在 33.25 clk（理论 32.55），
排查成本极高。**若将来确实需要精确 48 kHz：先写一个只测"平均分频周期"的独立
testbench 把分频器单独验证通过，再接入本模块。**
