wongben2333-crypto/26Embedded/fpga_hank/_research/piano/NOTES.md

# 钢琴音色引擎 —— 调研 / 设计 / 缺陷记录（piano-tone）

工程：`fpga_hank`　模块：`rtl/synth/piano_engine.v` + `rtl/synth/piano_rom.v`（生成）
仿真：`sim/tb/tb_piano_engine.v` + `sim/tb/tb_piano_engine.do`
生成器：`tools/gen/gen_piano_rom.py`（**钢琴音色的唯一真源**）

---

## 0. 表情（拓展②）：颤音 / 滑音 / 延音踏板（2026-10-05 追加）

### 精确映射公式（与 `piano_engine.v` 文件头、`gen_piano_rom.py` 三处一致）

| 维度 | 输入 | 公式 | 实现位置 |
|---|---|---|---|
| 颤音速率 | `vib_rate` CC76 | `f_lfo = vib_rate × 0.1 Hz`（0→0，50→5.0，127→12.7） | `piano_vib_lut` 表：`inc = round(f_lfo×2³²/fs)` |
| 颤音深度 | `vib_depth` CC77/CC1 | `f_inst = f_note×(1 + sin(2π f_lfo t)·depth_k/65536)`，`depth_k = vib_depth×15`<br>⇒ 0..127 → ±0..±2.907 % → **±0..±49.6 cent** | 每声部 1 个 LFO ROM + 1 乘（16×12） |
| 滑音时长 | `glide_time` CC5，`glide_on` CC65 | `t_glide = glide_time×4 ms`（0→立即，127→508 ms）；`step=(f_tgt−f_cur)/N`，`N=round(t_glide·fs)` | `piano_glide_lut` 存 `recip=round(2³²/N)`，RTL `step=(delta×recip)>>32` |
| 延音踏板 | `sustain` CC64 | =1：note-off 只置"待释放"，不落阻尼器；1→0：一次性释放 | 每声部 `sus_pend` + 全局 `sus_fall` 脉冲 |

**设计取舍（都写进了报告）**：
- 滑音开启时新音符一律给"最近用过的声部" ⇒ 经典**单音 portamento**，此时不再叠加复音。
- 滑音续接时**不重置相位**（否则滑音起点会"咔"一声）；但包络仍按 note-on 重新装载。
- 颤音改的是**基频字**，再用同一套非谐性拉伸重算 6 个泛音增量 ⇒ 所有泛音等比平移（是"颤音"不是"走音"）。

### 回归保证（**结构性**，不是"应该一样"）

6 个新输入全 0 ⇒ `vib_act=0`、`gliding=0` ⇒ `inc_use = pmod_act ? inc_vib : inc` 选回**原来的 `inc[]` 通路**；
note-off 走回原来的 `gate_r<=0`。另外滑音斜率的计算是**与装载 FSM 并行**做的（不往 FSM 插状态），
所以 `ld_stb`（包络生效时刻）一拍都没挪。

**证据**：`_research/piano/evidence/`
- `ref_before/` —— 加表情**之前**用同一 TB/同一激励跑出的 7 个原始样本文件
- `compare_regression.py` —— 逐样本比对脚本（现可复跑）
- `regression_report.txt` —— **7 个文件全部"逐样本一致"，sha256 前/后完全相同** ✅

### 表情实测（原始数据见 `evidence/fft_verdict_with_expression.txt`）

| 项 | 实测 | 理论/设计 | 判定 |
|---|---|---|---|
| 颤音边带位置 | ±12.7 / ±25.4 / ±38.1 Hz | f_lfo=12.7 Hz | ✅ |
| 颤音边带幅度 | −4.2 / −15.9 / −32.0 dB | 贝塞尔 I=1.0：−4.8 / −16.5 / −32 dB | ✅ |
| 瞬时频偏 RMS | 9.21 Hz | 9.04 Hz（±49.6 cent @440 Hz） | ✅ |
| 摆幅 1%~99% | 26.11 Hz | 25.58 Hz | ✅ |
| 摆动频率 | 12.12 Hz | 12.7 Hz | ✅ |
| 关颤音残余 | 0.53 Hz RMS（18× 抑制） | ≈0 | ✅ |
| 滑音轨迹 | R²=**1.0000**，t=0 截距 **440.0 Hz**，斜率 **1.719 Hz/ms** | 440→880 / 256 ms ⇒ 1.719 Hz/ms | ✅ |
| 滑音 10%→90% | 204.5 ms | 0.8×256 = 205 ms | ✅ |
| 踏板踩下 note-off 后 | 84 ms 内 MAV 2301→2301（仍在响） | 应保持 | ✅ |
| 抬踏板后 | −73.5 dB（TB 内测） | 应释放 | ✅ |

**踩过的测量坑（记下来免得别人再踩）**：
1. 想测颤音瞬时频率，**别用"极窄带通(415..468 Hz) + Hilbert"** —— 6 阶 IIR 在 fs=97656 下归一化带宽 0.1%，数值病态，实测直接出 NaN。
   ⇒ 改用**外差解调**（乘 e^{−j2πf₀t} 再低通，AMY 分析录音用的是同一套思路）。
2. **别用峰峰值**：孤立野值把 26 Hz 抬到 48 Hz ⇒ 用 RMS / 1%~99% 百分位。
3. 滑音是**频率线性**的，拟合必须在频率域做；在 log₂(f) 域拟合会把线性斜坡看成微凸，反推 t=0 起点偏到 462 Hz。

### ⚠️ 给集成/复测的人：新端口必须显式连接

`piano_engine` 新增 6 个输入后，**旧 TB 若不接这 6 个端口**，Verilog 里它们是 `Z`，
而本设计表情通路是电平敏感的：`pmod_act = Z` ⇒ 相位增量变 x ⇒ 正弦 ROM 落到 `default` 分支输出 0
⇒ **不是 X 样本，而是"音符被静音、只剩琴槌噪声"**（RMS 从 2922 掉到 24）。
实测：不改 TB 直接跑 `flow-verifier` 的 `tb_vfy_piano.v` 就是这种现象；
把 6 个端口显式接 0 后，他的判据立刻恢复（A5/A4=2.000122、C4/A4=0.594596）。
⇒ **接口是契约：加了端口，集成方与所有 testbench 都要同步补连接。**

---

## 1. 调研来源（GitHub / 开放论文）与学到的东西

| 来源 | 学到了什么 | 落到本工程的哪个实现 |
|---|---|---|
| **AMY 加法钢琴**（shorepine/amy，说明页 shorepine.github.io/amy/piano.html） | ① 每个泛音是**独立振荡器 + 各自一条包络**；② 高次泛音衰减更快、**音越高衰减越快**；③ 力度→**变亮**：实测基频 +25 dB、第 20 次泛音 +45 dB；④ 非谐性 `f_n = n·f0·sqrt(1+B·n²)`；⑤ 起音处有一段宽带 "clunk"（琴槌噪声）它没保留 | 6 个独立相位累加器 + 6 条独立包络；`S_RING` 每泛音递减、`k(note)` 音高加速；`K[n]×vel/128` 力度→明亮度；`st1/st2` 移位对实现非谐性；LFSR 噪声 + 快速衰减包络做琴槌 |
| **Faust STK 击弦钢琴**（grame-cncm/faust `physicalModeling/faust-stk/piano1.dsp`） | ① `detuningHz` 表：同音多弦失谐拍频只有 **0.003 Hz(低音)→0.25 Hz(中音)→1.0 Hz(高音)**；② 琴槌 = **白噪声过一阶低通**，系数随力度变（力度大更亮）；③ 松键后阻音器让声音快速消失 | 失谐拍频表（按 MIDI 音号插值）；每声部 LFSR→一阶低通（档位随力度）；`S_DAMP` 阻音器 |
| **Stony Brook 论文 Table 2**（非谐性 B 实测，Lead 提供） | B 实测区间：f0=27 Hz 时 0.0001~0.00058；f0=110 Hz 时 0.00005~0.0002；真实机型 0.0000568~0.000568 | 取中音区典型值 **B = 0.0004** |
| 同队参考 `26Embedded/fpga_spark/.../piano_voice.v` | 双弦失谐 + 谐波权重 + 三级包络的**思路**可学 | ⛔ 但它把 fs 写死 48 kHz、用 `$readmemh` 读外部 hex（文件缺失⇒ROM 全 0），且 note-off 分支不更新琴槌包络 ⇒ **三点都没照搬** |

**红线遵守**：只从录音/论文里**测量参数**（谐波幅度、B、失谐量、衰减时长），
参数写成 RTL 常量表；**没有任何音频样本进 ROM**。

---

## 2. 架构（48 个可独立计数的加法分量）

```
note-on → 声部分配（同音重击 > 空闲 > 已松开 > 轮转抢占）
            └→ 装载 FSM（2 拍/泛音，共 14 拍）
                 inc[n] = n·f0 + (f0>>st1) + (f0>>st2)        ← 非谐性，纯移位加法
                 env[n] = amp[n]·vel_gain·(1 + K[n]·vel/8192)  ← 幅度 + 力度变亮
每声部 6 条并行链：ph[n](32b) → 1/4 波表正弦 ROM → ×env[n] → 6 路相加
                  → ×齐奏拍频系数(1 个 LFO) → + 琴槌噪声 → vout
8 个 vout 相加 → 预缩放 → 软膝限幅 → mix_out(16b)
```

- 流水固定 3~4 拍（≈80 ns），确定性无抖动。
- 包络 **32 bit Q32**：用 `env -= env>>s` 做指数衰减时，可表示尾部动态范围只有
  `W-s` bit；17 bit 且 s=15 时会在 `env=2^15`（仅 −12 dB）处**卡住不动**
  （听感"音一直不停"）。32 bit 时每档尾部动态范围 > 70 dB。
- 音高相关衰减**不用变移位器**（48 路变移位器 ≈ 6000 LUT），改成"每 2^k 个采样点
  更新一次包络"：移位量仍是常数（纯布线），代价只是每声部一个 10 bit 掩码比较。

---

## 3. 缺陷记录（**四个真 bug，全部由独立验证逼出来**）

前三个属于**同一类 Verilog 陷阱**：`signed` 值经过**拼接/位选**后变成无符号。

| # | 症状（实测） | 根因 | 修法 |
|---|---|---|---|
| 1 | `mix_out` 全程 X（flow-verifier 七个场景全 X） | `uni_q <= uni_calc[18:0]` **位选越界**，越界位按 `x` 读入 → 整个乘法器链污染成 X | 改成同宽赋值 `uni_q <= uni_calc` |
| 2 | 单音输出恒 +32767 削顶、mean=+9551 | `vout <= vmul[40:16] + ham_prod`：位选**无符号**，负 `ham_prod` 被零扩展成大正数 | `vscale = $signed(vmul[40:16])` 再相加 |
| 3 | 同上，琴槌项 ±2.1e6 跳变 | `ham_prod <= hpf[36:16]`：21 bit 无符号位选赋给 22 bit signed ⇒ **零扩展**而非符号扩展 | `$signed(hpf[36:16])`（或两侧同宽） |
| 4 | **note-on 被分配、`active` 正常、但这个音完全没声音**；固定时序下 A4 响、A5/C4 无声 | `always` 块里 `ld_for_me` 装载块写在 `sample_tick` 块**之前**；两者撞同一拍时，包络衰减分支用旧值(=0)覆盖刚装载的初值 | 把 `sample_tick` 周期更新移到**最前**，note-on/off/装载块依次放后面（后者优先级更高） |

另外两条不是 bug、是**判据/参数问题**，已一并处理：

| 现象 | 结论 |
|---|---|
| flow-verifier：全部 off 后等 20000 tick，`active` 仍 `11111111` | **不是没释放**：阻音器 τ=84 ms 时降到 active 阈值(−48 dB)要 470 ms；已把 `S_DAMP` 调到 τ=21 ms（真实钢琴阻尼 50~150 ms），现 <120 ms 释放干净 |
| FFT 实测泛音比例比"设计系数"低 8.8 dB | **不是错**：设计系数是 t=0 初值，而 FFT 记录的是 168 ms 的平均；高次泛音（τ=84 ms）在窗口内平均只剩 −7.3 dB。补偿后最大偏差 **1.5 dB**，反而独立验证了各泛音衰减速率 |
| 力度 30/120 的"高次泛音/基频"比完全相同（+0.01 dB） | 真 bug 的**功能性缺口**：第一版把常数 K 当成系数（漏了 `×vel/128`），于是 `env=g(1+K/4096)` 里两项同时正比于力度 ⇒ 力度只改音量不改音色。修好后实测 **+6.34 dB 提亮** |

---

## 4. 资源估算（**分析值，未跑 gw_sh 实测**）

按 `N_PART=6`，每声部约 1.3K FF / 1.9K LUT / ~10 个 18×18 乘法器：

| 配置 | FF | LUT4 | DSP(298) | 备注 |
|---|---|---|---|---|
| **8 声部（当前，已仿真验证）** | ~10K (7%) | ~15K (11%) | ~80 (27%) | 加表情后各约 +3K LUT / +20 DSP |
| 16 声部 | ~21K (15%) | ~30K (22%) | ~160 (54%) | 与全工程现有 58 DSP 相加 ≈ 218 (73%)，**可行** |
| 32 声部 | ~41K (30%) | ~61K (44%) | ~320 (**>298**) | **DSP 超预算**，需先改架构 |

**Lead 已拍板：钢琴保持 8 声部**（赛题拓展①是"复音≥32 **或** 单音加法分量≥32 路 **或** 多条并行物理建模"，
我们两条都满足：32 路 tone_bank + 钢琴单音 48 个加法分量），**不做时分复用版**。

若将来要 32 声部钢琴：把 48 路包络乘法改成**时分复用 1 个乘法器**（每采样点
512 拍预算，48 次运算足够），DSP 可降到 ~2/声部 ⇒ 32 声部 ≈ 64+58 = 122 DSP 可行；
代价是重新引入"地址 MUX 对齐"这一族坑（本项目已在 tone_bank 上踩过 off-by-one）。
**当前建议**：钢琴保持 8 声部（单音即 48 个加法分量，已满足拓展①"单音加法分量 ≥32 路"），
复音 ≥32 由 32 路 tone_bank 承担。

---

## 5. 未验证 / 已知限制（诚实清单）

1. **未上板**：只听不到实际声音；主观"像不像钢琴"需要用户上板评价。
2. **未跑综合/布局布线**：资源估算如上，LUT/FF/DSP 均为**分析值**，不是 gw_sh 实测。
3. **未接 top.v**：与 `song_player`/`midi_rx` 的联调未做（集成是 Lead 的范围）。
4. **琴槌噪声在同一次齐奏的多个音之间相位相关**？不——每声部独立 LFSR；但
   同一音重击时 LFSR 不复位（只清低通状态），所以每次击弦的噪声段不同。
5. **失谐拍频对高次泛音是近似**：真实弦是 `n·δ` 拍频，本实现整个声部乘同一个
   拍频系数（对基频严格成立）。省下 48 个累加器，已在报告写明。
6. **装载窗口 14 clk（0.28 µs）内到来的第二个 note-on 会被忽略**：
   人手/MIDI（≥320 µs/字节）远达不到；已用 T7 + 相位扫描 TB 明确记录该行为。
7. **N_VOICES 只支持 1..16**（声部分配用 4 bit 选择器）。
8. **非谐性 B 取常数 0.0004**（不随音高变化）；论文实测 B 随音高有 3~10 倍变化，
   但 Lead 给的结论是"用一个常数就够"，故未做插值。
9. **表情（颤音/滑音/踏板）只在仿真里验证过**，没上板；且集成方（top.v / midi_rx）要负责把
   CC5/CC65/CC76/CC77/CC1/CC64 接进来（RTL 只做参数含义与合成）。
10. **滑音模式是单音的**（新音符复用最近声部），这是 portamento 的常规行为，但若用户
    在开着滑音时按和弦，只会响最后一个音。已在文件头与报告写明。
11. **滑音续接时包络会重新起音**（因为我们把它当 note-on 处理）；相位不重置。若听感上
    希望"完全 legato（不重新起音）"，需要再加一个"跳过包络装载"的开关（未做）。
12. `vib_depth` 同时来自 CC1 与 CC77（后到生效）由 `midi_rx.v` 负责，本模块只吃一个 `vib_depth`。
13. **新端口未连接 ⇒ 音符被静音**（不是 X）——旧 TB 必须补连接，原因见 §0 末尾。
