wongben2333-crypto/26Embedded/fpga_spark/lcd_test/docs/hardware/netlist.csv

net | ball | io_type | pull | drive | header | header_pin | device | device_pin | dir | function | notes
clk | V22 | LVCMOS33 | UP |  | 板载 |  | 晶振 | Y50M | IN | 系统时钟50MHz | 板载有源晶振50MHz
HP_BCK | Y17 | LVCMOS33 | NONE | 8 | 板载 |  | PT8211 | BCK | OUT | I2S位时钟3.125MHz | 板载DAC
HP_WS | AB17 | LVCMOS33 | NONE | 8 | 板载 |  | PT8211 | WS | OUT | I2S字选 | 高=左声道
HP_DIN | AA16 | LVCMOS33 | NONE | 8 | 板载 |  | PT8211 | DIN | OUT | I2S数据 | 16bit补码MSB先出
PA_EN | AB16 | LVCMOS33 | NONE | 8 | 板载 |  | 功放 | EN | OUT | 低有效恒0 | 必须为0才出声
key | AB13 | LVCMOS15 | UP |  | 板载 | 按键1 |  |  | IN | 1.5Vbank | MODE=3不用
key2 | Y12 | LVCMOS15 | UP |  | 板载 | 按键2 |  |  | IN | 1.5Vbank | MODE=3不用
key_pitch | Y22 | LVCMOS33 | UP |  | J8 | 12 | 变调键 |  | IN | 未接内部上拉为1 | MODE=2变调
uart_rx_pin | V14 | LVCMOS33 | UP |  | COM19 |  | FT2232 | UART_RX | IN | 115200MIDI | MODE=3只收CC20/21;不能加DRIVE;MODE=3只收CC20/21
key_hw[0] | E14 | LVCMOS33 | UP |  | J13 | 1 | 四脚轻触开关1 | 一端 | IN | note60C4 | 另一端共GND;按下=0
key_hw[1] | E13 | LVCMOS33 | UP |  | J13 | 2 | 四脚轻触开关2 | 一端 | IN | note61C#4 | 另一端共GND
key_hw[2] | C15 | LVCMOS33 | UP |  | J13 | 3 | 四脚轻触开关3 | 一端 | IN | note62D4 | 另一端共GND
key_hw[3] | C14 | LVCMOS33 | UP |  | J13 | 4 | 四脚轻触开关4 | 一端 | IN | note63D#4 | 另一端共GND
key_hw[4] | B13 | LVCMOS33 | UP |  | J13 | 5 | 四脚轻触开关5 | 一端 | IN | note64E4 | 另一端共GND
key_hw[5] | C13 | LVCMOS33 | UP |  | J13 | 6 | 四脚轻触开关6 | 一端 | IN | note65F4 | 另一端共GND
key_hw[6] | A14 | LVCMOS33 | UP |  | J13 | 7 | 四脚轻触开关7 | 一端 | IN | note66F#4 | 另一端共GND
key_hw[7] | A13 | LVCMOS33 | UP |  | J13 | 8 | 四脚轻触开关8 | 一端 | IN | note67G4 | 另一端共GND
key_hw[8] | B16 | LVCMOS33 | UP |  | J13 | 9 | 四脚轻触开关9 | 一端 | IN | note68G#4 | 另一端共GND
key_hw[9] | B15 | LVCMOS33 | UP |  | J13 | 10 | 四脚轻触开关10 | 一端 | IN | note69A4 | 另一端共GND
key_hw[10] | A16 | LVCMOS33 | UP |  | J13 | 13 | 四脚轻触开关11 | 一端 | IN | note70A#4 | 另一端共GND
key_hw[11] | A15 | LVCMOS33 | UP |  | J13 | 14 | 四脚轻触开关12 | 一端 | IN | note71B4 | 另一端共GND
key_hw[12] | A20 | LVCMOS33 | UP |  | J13 | 15 | 四脚轻触开关13 | 一端 | IN | note72C5 | 另一端共GND
photo_hw[0] | B20 | LVCMOS33 | UP |  | J13 | 16 | 光电1PC817 | 集电极 | IN | 挡光=0on40E2 | 面包板原型S9012;PCBv1PC817
photo_hw[1] | A21 | LVCMOS33 | UP |  | J13 | 17 |  |  | IN | 未接 | 内部上拉为1
photo_hw[2] | B21 | LVCMOS33 | UP |  | J13 | 18 |  |  | IN | 未接 | 内部上拉为1
photo_hw[3] | B18 | LVCMOS33 | UP |  | J13 | 19 |  |  | IN | 未接 | 内部上拉为1
photo_hw[4] | B17 | LVCMOS33 | UP |  | J13 | 20 |  |  | IN | 未接 | 该球为sdram_clk只可慢速静态输入
photo_hw[5] | C17 | LVCMOS33 | UP |  | J13 | 21 |  |  | IN | 未接 | 内部上拉为1
ec1a | D17 | LVCMOS33 | UP |  | J13 | 22 | EC11#1 | A | IN | 正交A | 1kHz邻接解码
ec1b | A19 | LVCMOS33 | UP |  | J13 | 23 | EC11#1 | B | IN | 正交B | 1kHz邻接解码
scl_tof | A18 | LVCMOS33 | UP | 2 | J13 | 24 | ToF#1 | SCL | IO | I2CSCL10kHz | 4.7k上拉+330欧;DRIVE=2不可改回8
sda_tof | D15 | LVCMOS33 | UP | 2 | J13 | 25 | ToF#1 | SDA | IO | I2CSDA10kHz | 4.7k上拉+330欧;DRIVE=2
dbg_tx | P19 | LVCMOS33 | NONE | 8 | J9 | 11 | USB-TTL | RX | OUT | 遥测115200 | CPU脚需-use_cpu_as_gpio1
POWER_3V3 |  |  |  |  | J8 | 1-2 | 传感器 | + | PWR | 3.3V供电 | 来自底板;总电流<100mA
GND |  |  |  |  | J8/J9/J13 | 3-4/3-4/12 | 全部 |  | PWR | 共地 | 12V侧只从一点拉地到板
+12V |  |  |  | 外部电源 |  |  | 光电6套 | 棕 | PWR | 12V供电 | 永不进FPGA;蓝=0V;实测约0.2A
DO_NOT_CONNECT_5V |  |  |  |  | J13 | 11 |  |  | DO_NOT_CONNECT | 5V_Peripheral | 绝对不能接
