wongben2333-crypto/26Embedded/sim/前期算法模拟-完整说明.md

# 高云选题二 · 前期算法模拟完整说明（Golden Model）

> 赛题：基于 FPGA 的实时多音色合成电子乐器引擎（2026 嵌赛 · 高云半导体赛道）
> 本文档说明「动 Verilog 之前」的算法模拟：目标、方案、实现、实测结果、对 RTL 的指导、风险与下一步。
> 代码：`E:\26Embedded\sim\` ｜ 结果：`E:\26Embedded\sim\out\` ｜ 一键复现：`python scripts\run_all.py`
> 整理日期：2026-09-30

---

## 0. 一页读懂

- **为什么不直接写 Verilog**：赛题唯一进入评分公式的是「**同时活跃可闻独立振荡器总数 × 实际音频输出采样率**」。分子要堆到 32，分母受 GW5AST-138 的 298 个 DSP / 138K LUT 约束。**32 路怎么映射到位宽、波表要不要抗混叠、混音怎么不溢出**——这些在 RTL 里改一版要几小时，在 Python 里改一行只要一秒。于是把 RTL 的试错全部前移到软件。
- **我们做了什么**：一套与 RTL 结构一一对应的 **Python 黄金参考模型（16 个模块）** + 一键集成脚本，产出音频、频谱、位宽曲线、资源账、延迟预算、以及**可直接被 Verilog 读取的参数头文件与波表数据**。
- **最重要的三条结论**：
  1. **32 复音在 138K 上资源极充裕**：LUT 5.9% / DSP 10.7% / BSRAM 0.3%。
  2. **延迟 0.354 ms（48k）/ 0.177 ms（96k）**，远低于 ≤5 ms；唯一能撑爆预算的是 I2S FIFO 深度，必须保持浅。
  3. **测试模式 32 路独立谱峰已跑通**（200–6400 Hz，间隔 200 Hz，检测 32/32）——这是评分规则③要求的现场证据，已提前拿到"预演图"。

---

## 1. 背景：为什么先做算法模拟

### 1.1 评分公式决定设计方向

| 规则 | 原文要点 | 对我们的含义 |
|---|---|---|
| ① 振荡器统计 | 一个"振荡器"必须含**独立相位累加器 + 频率调控 + 包络控制** | 想拿分必须**真实堆振荡器数量**，不能靠"一个复杂波形"充数 |
| ② 吞吐量指标 | **活跃独立振荡器总数 × 实际输出采样率**（过采样不叠加） | 两条提分路径：**复音 4→32** 与 **采样率 48k→96k**，相乘 |
| ③ 现场验证 | 测试模式输出多路不同频率 → 频谱可见**对应数量独立谱峰** + RTL 佐证无预录 | 必须做"测试模式"，并准备 32 谱峰证据 |

### 1.2 必须在写 RTL 前定死的三件事

1. **算法结构**：波表 / 加法 / FM / 物理建模怎么选、复音怎么分配、效果链怎么排。
2. **定点位宽**：相位、波表、包络、乘法器、混音累加每一级的最小可行位宽——直接决定 LUT/DSP 用量。
3. **资源与延迟账**：32 路到底占多少资源、全链路延迟能不能进 5 ms。

这三件事用软件定死，RTL 才能一次成型、少走弯路。

---

## 2. 总体方案

### 2.1 信号链（与 RTL 模块一一对应）

```
交互传感器 → 声部分配器 → N×振荡器 → ADSR → 混音/饱和 → 效果器 → I2S 量化输出
                              ↑
                  波表(mipmap) / 加法 / FM / 物理建模  任选
```

### 2.2 软件要回答的 7 个问题 → 交付物

| # | 问题 | 交付物 |
|---|---|---|
| 1 | 音高准不准？相位截断噪声多大？ | 音高误差（cents）、THD |
| 2 | 高音会不会混叠？ | 带限 mipmap 方案 + 频谱 |
| 3 | 每级最小可行位宽？ | **定点位宽扫描表（SNR/ENOB vs bit）** |
| 4 | 32 路相加会溢出吗？ | 混音 headroom 计算 + 饱和 |
| 5 | 32 复音资源够不够？ | **资源估算表（LUT/DSP/BSRAM）** |
| 6 | 延迟能否 ≤5 ms 无抖动？ | 全链路延迟预算表 |
| 7 | 测试模式能否看到 32 个谱峰？ | **32 谱峰 PNG（现场证据预演）** |

### 2.3 技术选型决定

| 决策 | 选择 | 理由 |
|---|---|---|
| 主线合成算法 | **波表为主 + 加法冲 32** | 波表资源最省、音色可控；加法合成 32 分量满足拓展①路径B，且贴合"按运算分量计数"的评分口径 |
| 目标采样率 | **分阶段：先 48k 锁结构，再 96k 冲分** | 96k 分数翻倍，但每样本运算预算减半；两档都要验证资源余量 |
| 模拟技术栈 | **Python 浮点黄金模型 + 定点量化分析** | 算法探索快；同时输出 RTL 参数，兼顾"定死位宽"的目标 |
| 目标器件 | Sipeed Tang Mega 138K Dock（GW5AST-LV138PG484A） | 138,240 LUT / 298 DSP / 6120 Kb BSRAM，余量最大 |

---

## 3. 目录结构与模块清单

```
E:\26Embedded\sim\
├─ synthsim\                     # 黄金模型包
│  ├─ params.py                  # ★全局参数（冻结，RTL 参数唯一来源）
│  ├─ CONTRACT.md                # ★接口契约（冻结，并行开发的唯一真相）
│  ├─ wavetable.py               # 带限波表生成 + mipmap + .mem 导出
│  ├─ dds.py                     # 相位累加器 / 频率字 / 查表插值 / DDSOsc
│  ├─ additive.py                # 加法合成（32 分量）
│  ├─ fm.py                      # FM（2-op / 多算子）
│  ├─ karplus.py                 # Karplus-Strong 物理建模
│  ├─ adsr.py                    # ADSR 包络（一次性 + 流式状态机）
│  ├─ voice.py                   # 单声部 = 振荡器 × 包络 × 力度
│  ├─ allocator.py               # 声部分配器（oldest/weakest 抢占）
│  ├─ mixer.py                   # 定点混音 / 饱和 / 余量计算
│  ├─ fixedpoint.py              # 位宽量化 / SNR / ENOB / THD / 扫描
│  ├─ resource_est.py            # LUT/DSP/FF/BSRAM 资源估算
│  ├─ latency.py                 # 全链路延迟预算
│  ├─ effects.py                 # 延迟 / 合唱 / 混响(Schroeder)
│  ├─ testmode.py                # 测试模式：N 路音 + 谱峰检测 + 绘图
│  ├─ render.py                  # WAV 读写
│  └─ export_params.py           # 导出 synth_params.vh + 波表 .mem
├─ scripts\
│  └─ run_all.py                 # ★一键集成，产出全部证据
└─ out\                          # 全部产物（音频/图/报告/vh/mem）
```

**16 个模块自检全部通过**（各自 `python -m synthsim.<模块名>` 退出码 0）。

---

## 4. 接口契约（冻结）

`CONTRACT.md` 是并行开发的唯一接口真相，`params.py` 已冻结。核心约定：

- Python **3.8** 兼容；numpy 1.22 / scipy 1.10 / matplotlib 3.7。
- **浮点音频**：`float64`，范围 `[-1,1]`，单声道 `shape=(n,)`。
- **波表/定点**：`int64`，满幅 `2**(bits-1)-1`。
- 绘图一律 `Agg` 后端、英文标签（避免中文字形缺失）。
- 所有输出只写 `E:\26Embedded\sim\out\`。

> 该契约的价值：4 个模块组（振荡器 / 声部链 / 分析 / 输出）可**并行开发**而不互相打断，接口零返工。

---

## 5. 关键设计决策与坑

### 5.1 带限波表 + mipmap 抗混叠
- 直接查"理想锯齿表"，高音会因谐波超过奈奎斯特而混叠。
- 方案：每个波形生成 **8 级带限表**，第 k 级只保留 `max(1, 512>>k)` 次谐波；演奏时按基频选层（`select_mip`）。
- 实测：440 Hz 落在 L4；每级 DC 严格为 0；`wavetable_saw.mem` 已导出。

### 5.2 定点位宽 —— 最省资源的一步
- 用 `fixedpoint.sweep_requant` 扫描 4→20 bit，SNR 呈现标准 **~6.02 dB/bit** 斜率。
- 结论：**16-bit 足够**（SNR ≈ 98 dB），再高的位宽收益递减却增加 LUT/DSP 压力。

### 5.3 混音余量 —— 防爆音
- 32 路满幅相加最坏可达 +30 dB。做法：**每声部先右移 `voice_gain_shift=5` 位（÷32）再相加**，最后饱和限幅。
- 实测：最坏情况总线电平 ≈ 0.003 dBFS（刚好贴满不过冲），32 路实际混音峰值 -11.3 dBFS。

### 5.4 力度（velocity）只应用一次
- 契约中 `Voice.step = osc × env × velocity`，而 `ADSREnv.note_on(velocity)` 也会设峰值——**若两处都乘会变成 velocity²**。
- 决策：**Envelope 在 Voice 内保持归一化（peak=1.0），velocity 只在 Voice 输出乘一次**，与 RTL 的"三个独立乘法器"结构一致。此决策写进了模块 docstring。

### 5.5 I2S FIFO 必须浅 —— 延迟的唯一杀手
- 48 kHz 下 1 个样本 = 20.8 µs。深度 512 的 FIFO 单独就引入 **10.7 ms**，直接超标。
- 决策：`i2s_fifo_depth = 4`。延迟预算脚本内置"深 FIFO 反事实"对比，佐证这一点。

### 5.6 波表多端口访问（社区踩坑）
- 多声部同时读同一张 BSRAM 波表会串行冲突。缓解手段：**复制多份波表**（16 KB 占用对 6120 Kb 可忽略）或**内部时分复用**（TDM）。
- 资源估算中已把波表按"共享 ROM、全部 mip 层驻留"计（仅 16 KB）。

---

## 6. 全流程与运行复现

目前的软件模拟是一条**"一键触发、十步产出"**的流水线，分**执行流程**（脚本跑什么）与**数据流**（一个音怎么被算出来）两条线。

### 6.1 总览

```
python scripts\run_all.py
        │
        ├─ 载入骨架 params.py（全局参数） + 导入 16 个模块
        ├─ 依次执行 10 个步骤（每步 = 一个算法问题 + 一个产物）
        └─ write_report() → out\report.md（结论速览 + 分步日志 + 交付物清单）
```

### 6.2 执行流程（`scripts\run_all.py` 的 10 步）

| 步 | 步骤名 | 调用 | 产出 |
|---|---|---|---|
| 1 | 波表/抗混叠 | `wavetable.build_mipmap("saw")` → `select_mip(440)` | `wavetable_mipmap.png` |
| 2 | 单音音高 | `DDSOsc.set_freq(440)` → `step()` → FFT 测音高 | `single_note.wav`、`spectrum_single.png` |
| 3 | ADSR 包络 | `adsr.adsr_envelope(...)` | `adsr.png` |
| 4 | 复音 4→32 | `VoiceAllocator` × 2（4 音 / 32 音） | `poly4.wav`、`poly32.wav`、`spectrum_poly32.png` |
| 5 | 定点位宽 | `fixedpoint.sweep_requant(4..20bit)` | `fixedpoint_snr.png` |
| 6 | 资源估算 | `resource_est.estimate_voice(4/8/16/32)` | 控制台表格 + 汇总 |
| 7 | 延迟预算 | `latency.budget(48k)` / `budget(96k)` | 控制台表格 + 汇总 |
| 8 | **测试模式** | `testmode.synth_test_tones()` → `analyze_peaks()` | `testmode_32peaks.wav` + `.png` |
| 9 | 备选合成+效果 | `additive` / `fm` / `karplus` / `effects` | 控制台数字 |
| 10 | RTL 导出 | `export_params.export_verilog_header()` / `export_wavetables()` | `synth_params.vh` + `wavetables\*.mem` |

每步都包在 `try/except` 中，任一步失败会记入报告并以非 0 退出；全通过则打印 `OK`。

### 6.3 数据流 —— 一个音怎么被算出来（算法全流程）

以「按下 MIDI 69（A4=440Hz），力度 0.8」为例：

```
① note_on(69, 0.8)
   └─ allocator 找一个空闲声部（没有则按 oldest / weakest 抢占）
   └─ voice.note_on(freq=440, vel=0.8)
        ├─ DDSOsc.set_freq(440)  → 频率字 FWORD = round(440/48000 × 2³²)
        └─ ADSREnv.note_on(1.0)  → 进入 ATTACK

② allocator.render(n) 每渲染 n 个样本：
   for 每个活跃声部 v:
       v.step(n) =  osc.step(n)  ×  env.step(n)  ×  velocity
                     │                │              │
             DDS: 相位累加→查表   ADSR 状态机    力度增益
                  →线性插值        ATTACK→DECAY
                                   →SUSTAIN→RELEASE
   mixer.mix_sum(signals, shift=5, saturate=True)
        └─ 各声部相加 → 整体 ×2⁻⁵（余量）→ 限幅到 [-1,1]

③ （可选）effects.delay / chorus / reverb 叠加效果
④ render.write_wav(...) → 16-bit PCM 单声道 WAV
```

**四个关键约定**（都对应 RTL 结构，便于日后逐个对齐）：

1. `Voice.step = osc × env × velocity` —— **力度只乘一次**（env 在 Voice 内保持归一化 [0,1]）。
2. **混音先移位再相加**（`shift=5`）：32 路最坏情况刚好贴满 0 dBFS，靠饱和兜底。
3. 波表查表走 `freq_word → 相位序列 → 插值`，`dds.phase_sequence` 返回**步进前**的相位，方便 RTL 逐周期复现。
4. 高音通过 `select_mip` 自动选低谐波段，避免混叠。

### 6.4 测试模式流程（评分规则③的合规证据）

```
synth_test_tones(params)
  └─ 生成 32 个独立振荡器，频率 200,400,...,6400 Hz
     └─ 每个配一个独立 ADSR（默认 5ms/120ms/0.7/180ms）
     └─ 求和 ×2⁻⁵ → 限幅 → 2 秒 float64 信号
        ├─ render.write_wav → testmode_32peaks.wav
        └─ analyze_peaks: Hann 窗 FFT → find_peaks
             └─ 与 32 个期望频点逐一匹配（±40Hz）
                  → {detected:32, expected:32, ok:True}
        └─ plot_spectrum → testmode_32peaks.png（现场证据预演图）
```

### 6.5 产物 / 文件流向

```
params.py ──────────────► export_params ──► synth_params.vh   （RTL 参数宏）
wavetable ──────────────► export_wavetables ─► wavetables\*.mem（$readmemh 载入）
音频合成 ───────────────► render.write_wav ──► *.wav          （听感黄金参考）
分析(FFT/位宽/资源/延迟)► matplotlib ───────► *.png           （答辩/报告图）
全部日志 ───────────────► write_report ─────► report.md       （汇总）
```

### 6.6 运行与复现

```powershell
cd E:\26Embedded\sim

# 一键跑全部（产出 out\ 下所有证据，退出码 0 即成功）
python scripts\run_all.py

# 单模块自检（每个都会打印可验证的数字）
python -m synthsim.dds
python -m synthsim.allocator
python -m synthsim.testmode
# ...
```

**验证判据**：`run_all.py` 退出 0；`testmode_32peaks` 报 `detected ≥ 32`；每个模块自检退出 0。目前 16 个模块 + 集成脚本**全部通过**。

> 一句话总结：这条流程把"一个 FPGA 合成器"先在软件里跑一遍——从「按键事件 → 声部分配 → 振荡器 → 包络 → 混音 → 效果 → WAV」，同时并行算出「位宽、资源、延迟、谱峰」四份结论，最后把参数与波表导出成 Verilog 可直接读取的文件。下一步的 RTL，就是照着这条数据流一层层用硬件复刻。

---

## 7. 实测结果

### 7.1 结论速览（即 `out\report.md` 首页）

| 项目 | 结果 |
|---|---|
| 抗混叠 (mipmap) | 8 级带限波表；DC=0；440Hz→L4；高音自动降谐波 |
| 音高精度 (DDS) | 440.000Hz 实测 440.000Hz，误差 **0.00 cents** |
| ADSR 包络 | peak=1.00 / sustain=0.70 / tail=0.000（四段可调） |
| 复音 (4→32) | 4/32 声部并发 OK；32 路混音峰值 -11.3 dBFS，无溢出 |
| 最小可行位宽 | 16-bit → SNR **98.5 dB** / ENOB 16.06；~6 dB/bit |
| 资源账 (138K) | 32 声部 LUT **5.9%** / DSP **10.7%** / BSRAM **0.3%** → 可行 |
| 延迟预算 | 48k **0.354ms** / 96k **0.177ms**（≤5ms 达标） |
| 测试模式谱峰 (规则③) | detected **32** / expected **32** → **PASS** |
| 备选合成 + 效果器 | 加法 32 分量 / FM / Karplus-Strong / 延迟·合唱·混响 全部跑通 |
| RTL 导出 | synth_params.vh + 4 个波表 .mem，Verilog 可直接 include |

### 7.2 模块级实测数字

| 模块 | 关键结果 |
|---|---|
| wavetable | 8 级；每级 peak=32767、DC=+0.00000；`select_mip(440Hz,48k)=L4` |
| dds | 440.000 Hz 误差 0.00 Hz；正弦表 THD **-97.9 dB**；DDS 输出 THD **-111.6 dB**；freq_word(440)=`0x0258BF26` |
| additive | 32 分量 → FFT **32/32** 谱峰匹配 |
| fm | mod_index 0 → 1 边带、质心 440Hz；mod_index 3 → 7 边带、质心 1059.6Hz |
| karplus | 220Hz 实测 220.18Hz（误差 **0.08%**），包络单调衰减 |
| adsr | 一次性与流式一致；peak==1.0、sustain 平台==0.70、release→0 |
| mixer | 4/8/16/32 声部余量表；最坏相干预峰值 ≤1.0（不削波） |
| allocator | 4 音与 32 音和弦 active 正确；额外 32 音被正确抢占 |
| effects | 延迟首回声 80.0ms（符合预期）；混响 4 梳状 [29.7,37.1,41.1,43.7]ms + 2 全通 [5.0,1.7]ms |
| render | WAV 往返相关系数 **1.000**（>0.99） |
| testmode | 32 音 @48k → 检测 32/32，谱峰 200–6400Hz |
| export_params | 生成 `synth_params.vh` + sine/saw/square/triangle 四个 `.mem` |

### 7.3 定点位宽扫描（节选，完整见 `out\fixedpoint_snr.png`）

| bits | 8 | 10 | 12 | 14 | **16** | 18 | 20 |
|---|---|---|---|---|---|---|---|
| SNR (dB) | 49.1 | 61.4 | 74.0 | 86.1 | **98.5** | 110.2 | 122.3 |
| ENOB | 7.9 | 9.9 | 12.0 | 14.0 | **16.1** | 18.0 | 20.0 |

### 7.4 资源估算（GW5AST-LV138PG484A）

| 声部数 | LUT | LUT% | DSP | DSP% | FF% | BSRAM |
|---|---|---|---|---|---|---|
| 4 | 1,152 | 0.8% | 4 | 1.3% | 0.5% | 16 KB |
| 8 | 2,144 | 1.6% | 8 | 2.7% | 0.9% | 16 KB |
| 16 | 4,128 | 3.0% | 16 | 5.4% | 1.9% | 16 KB |
| **32** | **8,096** | **5.9%** | **32** | **10.7%** | **3.7%** | **0.3%** |

> 单声部基准（假设，已写进源码注释）：约 **200 LUT + 124 FF + 1 DSP**。结论：**32 复音余量充足，最坏资源占用仅 DSP 的 10.7%。**

### 7.5 延迟预算

| 阶段 | 样本数 | 48k (ms) | 96k (ms) |
|---|---|---|---|
| 输入扫描/消抖 | 3 | 0.062 | 0.031 |
| 合成流水线 | 5 | 0.104 | 0.052 |
| 波表读取 | 1 | 0.021 | 0.010 |
| 包络更新 | 1 | 0.021 | 0.010 |
| 混音 | 2 | 0.042 | 0.021 |
| **I2S FIFO** | **4** | **0.083** | **0.042** |
| DAC/串行化 | 1 | 0.021 | 0.010 |
| **合计** | **17** | **0.354** | **0.177** |

> 反事实：若 I2S FIFO 深度取 256，则 48k 下为 **5.33 ms**——单独就撑爆 5 ms 预算。**结论：FIFO 必须浅。**

---

## 8. 对 RTL 实现的直接指导

1. **参数以 `out\synth_params.vh` 为准**：位宽、深度、采样率、器件资源全部宏定义，Verilog 直接 `` `include "synth_params.vh" ``，杜绝手算频率字。
2. **波表数据用 `out\wavetables\*.mem`**：`$readmemh` 直接载入；四波形（sine/saw/square/triangle）各 8 级 mipmap。
3. **振荡器实例清单要"可数"**：报告与代码需清晰标出每路的**相位累加器 / 频率字寄存器 / 包络模块**（评分规则①三要素），方便评委对照 RTL 数出 32 路。
4. **测试模式必备**：一键进入、输出 32 路等间隔频率；用 `out\testmode_32peaks.png` 作为预期效果基准。
5. **延迟测量方法**：GPIO 打标法——触发瞬间拉高一个 IO，示波器看"触发沿→音频起音点"，报 **P50/P95/P99/最大值**。
6. **合规自证**：RTL 中不得存在音频样本 ROM / SD 卡播 wav 逻辑；代码命名遵循官方建议（信号小写、参数大写）。

---

## 9. 赛题要求 → 证据 对照表

| 类别 | 要求 | 本模型提供的证据 |
|---|---|---|
| 基础 | 纯硬件逐样本合成 | 全通路算法模型 + `synth_params.vh`（供 RTL 对齐） |
| 基础 | 延迟 ≤10ms | 0.354ms(48k) 预算表 |
| 基础 | 复音 ≥4 | `poly4.wav` + active=4 |
| 基础 | ADSR / 实时变调 / 混音 | `adsr.png`；mixer 无溢出验证 |
| 拓展① | 复音 ≥32 / 加法分量 ≥32 | `poly32.wav` + 加法 32 分量 + 资源表 |
| 拓展② | ≥2 音色 / 效果器 | 4 波形波表 + 延迟/合唱/混响 |
| 拓展③ | 延迟 ≤5ms | 0.177ms(96k) 预算表 |
| 拓展④ | 测试模式自证 | **`testmode_32peaks.png` 32/32 谱峰** |
| 红线 | 无预录 | 模型本身即"逐样本合成"，无 PCM 播放逻辑 |

---

## 10. 假设、边界与风险

1. **资源/延迟为"单位点估算"**：单声部 200 LUT + 1 DSP 等均为工程假设（已注释在源码），真实数字须待 RTL 综合后对齐；但量级与余量足以支撑方案决策。
2. **48k 与 96k 均已覆盖**：96k 下 32 声部核心占空比约 100%（脚本给"50% 余量"下为 16 声部）；若要 96k 跑 32 声部，需更激进的流水线/TDM 优化。
3. **效果器/混响为纯算法模型**：未含定点/延迟线资源细算，落地时需按 BSRAM 重新评估。
4. **未涉及交互传感器**：自研琴键（电容/光电/压力）属硬件工作，不在本模型范围。

---

## 11. 下一步计划（RTL 里程碑）

| 优先级 | 事项 | 判据 |
|---|---|---|
| P0 | 跑通 Sipeed PT8211 音频例程，板子出声 | 耳机口可闻 |
| P0 | 单音 DDS + 波表 + I2S，对齐 `dds.py` 相位序列 | 频谱音高正确 |
| P0 | ADSR → 4 复音 → 32 复音（对齐 allocator/mixer） | 32 路并发无爆音 |
| P0 | 测试模式（32 谱峰）+ 资源/时序收敛 | 频谱 32 峰、综合通过 |
| P1 | 96k 档 + ≥2 维自研交互 + 力度 | 分阶段验证 |
| P2 | 效果器（延迟/合唱/混响）+ 可视化 | 听感/显示可辨 |

---

## 附录 A · 交付物清单（`E:\26Embedded\sim\out\`）

| 文件 | 说明 |
|---|---|
| `single_note.wav` | 单音 440Hz 黄金音频 |
| `poly4.wav` / `poly32.wav` | 4 / 32 声部和弦（基础 & 拓展①） |
| `spectrum_single.png` / `spectrum_poly32.png` | 单音 / 32 声部频谱 |
| `testmode_32peaks.wav` + `.png` | **测试模式 32 路谱峰（规则③核心证据）** |
| `wavetable_mipmap.png` | 带限波表抗混叠 |
| `adsr.png` | ADSR 四段包络 |
| `fixedpoint_snr.png` | SNR vs 位宽 |
| `synth_params.vh` | RTL 参数头文件 |
| `wavetables\*.mem` | 波表 ROM 数据（`$readmemh`） |
| `render_selftest_440.wav` | WAV 读写自检 |
| `report.md` | 自动生成的汇总报告（含结论速览表） |

## 附录 B · 关键参数（摘自 `synth_params.vh`）

| 参数 | 值 | 参数 | 值 |
|---|---|---|---|
| SR | 48000 | PHASE_BITS | 32 |
| TABLE_SIZE × BITS | 1024 × 16 | INTERP | linear |
| ENV_BITS | 16 | ADSR A/D/S/R | 5 / 120 / 0.70 / 180 (ms) |
| MAX_VOICES | 32 | VOICE_GAIN_SHIFT | 5 |
| MIP_OCTAVES | 8 | I2S_FIFO_DEPTH | 4 |
| TEST_TONES | 32 | TEST f0 / 间隔 | 200 / 200 Hz |
| DEVICE | GW5AST-LV138 | LUT / DSP / BSRAM | 138240 / 298 / 6120Kb |

---

*本文档随 `scripts/run_all.py` 结果同步；如参数或结果变动，以 `out\report.md` 与源码为准。*
