wongben2333-crypto/26Embedded/fpga_hank/docs/BITSTREAM-FINGERPRINTS.md

> **当前口径（v8.1，2026-11-04，适用于本仓库全部说明文档）**：目标板 138K，交付位流 MODE=3；合成引擎 TDM32 32 声部×6 泛音=192 路（48 路全并行仅作对比基线）；音色统一为钢琴/吉他/小提琴 3 种（对外只列这三种）；交互为 13 键硅胶轻触按钮 + 6 路光电 + 双路 ToF（A 主用/B 热备）+ 7 寸触控，4 路 EC11 仅预留；PCB1 为“输入调理与隔离转接板”（上拉/限流/RC/PC817 光耦/ToF 双总线供电/地分割），防爆音在 RTL 三道清音 + PA_EN，不在 PCB；整机物理输入→模拟输出实测 2 ms，芯片内部 ≤20.5 µs，TDM32 流水 3.85 µs；7 寸屏经 34P FPC→J14 40P 排线，不再使用 P34-P40 转接板与 piano6 PCB；交付曲目为 4 首公有领域曲目（源码 Song 0 待删）；32 峰为必备取证，192 路由 RTL 状态阵列证明。**与旧描述冲突处，以本块为准。**

> **当前交付（2026-11-04）**：整机交付为 MODE=3；下表/下文中的 MODE=0/1/2 位流为历史构建；最终 MODE=3 `.fs` 的 SHA256 与 User Code 待补。

# 位流指纹表

> ⭐⭐ **历史固化版本（2026-10-08）；当前交付 MODE=3，最终指纹待补**

| 项 | 值 |
|---|---|
| 文件 | `out/bitstream/MODE1_current.fs`（= `MODE1_H4校准_0违例.fs`）|
| 大小 | 39,518,465 B |
| sha256(前16) | `0252733213DB8AB9` |
| 完整 sha256 | `0252733213DB8AB91F9BC5BC70DEAF409175940F85DA63A486091AC855C1A1E3` |
| **User Code** | **`0x1A2B0001`**（烧录时板卡回读，可复核）|
| MODE | **1**（电脑控制 + 运行期演奏形态切换）|
| SRAM 烧录 | 2026-10-08 12:29 ｜ op 2 ｜ 22.95 s ｜ 退出码 0 |
| **Flash 固化** | **2026-10-08 12:34 ｜ op 68（thru GAO-Bridge Arora V）｜ 87.43 s ｜ 退出码 0** |
| 上电行为 | **自动加载** → 默认自由演奏；按 `key2` 进曲目模式自动放歌 |

**⇒ 操作码实测对照（本板 GW5AST-138C，同一份位流）**

| op | 操作 | 结果 |
|---|---|---|
| 2 | SRAM Program | ✅ 成功（调试用，掉电即失）|
| 9 | exFlash Erase,Program,Verify | ✗ `Error: spi flash not found`（退出码 64）|
| 6 | embFlash Erase,Program,Verify | ✗ `Error: Erase Failed!`（退出码 32）|
| **68** | ⭐ **exFlash Erase,Program thru GAO-Bridge Arora V** | ✅ **成功 100%** |

---

# 位流指纹表（BITSTREAM FINGERPRINTS）

> **为什么要有这张表**：AGENTS.md §8.1 定的纪律是「**结论必须带版本指纹**」（时间 + `.fs` 名 + `User Code` + 资源占用）。
> 但本项目实测发现：**指纹此前只散落在对话和注释里、没有落盘**，而且**位流文件本身也没归档**。
> **⇒ 本表就是"把指纹落盘"的第一次尝试。**

> ⚠️ **本文件放在 `docs/` 而不是 `out/bitstream/`**：因为 **`out/` 整目录被 gitignore**（实测 `git check-ignore --no-index` = IGNORED），
> 放在那里的记录**队友永远看不到**。本表必须进库才有意义。

---

## 1. 指纹表

| 模式 | 位流文件名 | 大小 (B) | 构建时间 | `sha256`(前16) | **`User Code`** | 烧录时间 | 真板结果 | **证据强度** |
|---|---|---|---|---|---|---|---|---|
| **MODE=0** 演示（放歌） | `MODE0_演示模式_放歌.fs` | **38 814 719** | 2026-10-05 16:50:36 | **`8C6A0208320009F8`** | **`0x0000C7B0`** | 2026-10-05 | ✅ 放歌成功；**用户确认 4 首公有领域曲目旋律正确** | ⚠️ **凭证不足**（见 §2.2） |
| **MODE=1** 电脑控制（钢琴） | `MODE1_电脑控制.fs` | **40 089 599** | 2026-10-05 17:49:45 | **`DC5E68AAC44D364F`** | **`0x0000F2CB`** | 2026-10-05 | ✅ **用户成功用电脑弹琴** | ✅ **日志实测** |
| **MODE=2** 32峰测试<br>（**原证据版**） | ⚠️ **文件已丢失** | — | 2026-10-05 ~16:30 | — | **`0x0000BB21`** | 2026-10-05 | ✅ **真板 32/32 谱峰**（赛题必备交付物） | ⚠️ **产物已丢失**（见 §2.1） |
| **MODE=2** 32峰测试<br>（**重建版**） | **`MODE2_测试模式_32谱峰.fs`** | **34 840 489** | **2026-10-05 18:37:18** | **`68F7FFD22A9B1B18`** | （重建，未记录） | — | （**RTL 与 MODE=2 未变 ⇒ 功能等价**） | ✅ **现有产物** |
| 串口链路 | `uart_V14.fs`（`_smoke-test/`） | — | 2026-10-05 16:03:34 | — | **`0x00003907`** | 2026-10-05 | ✅ COM9 / 引脚 `rxp=V14` / 双向通 | ✅ 日志留档（`_smoke-test/uart-probe/flash_V14_op2.log`） |

**`sha256` 与大小已由我（`liaison`）用 `Get-FileHash` / `Get-Item` 在磁盘上实测复核过，与 `Lead` 提供的数字完全一致**
（`MODE2_测试模式_32谱峰.fs` = 34,840,489 B / `68F7FFD22A9B1B18` / 18:37:18 —— 已实测核对）。

> ⚠️ **原证据版 与 重建版【不是同一份文件】**：P&R 非确定性 + `User Code` 是逐次构建的随机量（见 §2.3）。
> **但 MODE=2 的 RTL 未变 ⇒ 功能等价** —— 这一点必须写清楚，否则读者会以为"重建 = 原证据"。

### 1.1 历史 `User Code`（来自 `tools/gowin/program.ps1` L170-171 的注释，作为"User Code 会变"的佐证）
| 位流 | `User Code` |
|---|---|
| 测试模式位流（早期） | `0x0000A86D` |
| 演奏模式位流（早期） | `0x00005093` |

---

## 2. 🔴 三条必须一起读的"证据强度"说明

### 2.1 ⚠️ **MODE=2 的【原证据版】位流已丢失（已重建，但两者不是同一份文件）**
- `Lead` 的烧录记录说原份是"**16:30 构建的 `.fs`**"
- **但我在磁盘上找不到那个文件**：当时 `out/bitstream/` 里**没有 16:30 的产物**（实测该目录 7 个文件，时间为 14:30 / 15:04 / 15:18 / 15:22 / 16:46 / 16:50 / 17:49）
- **根因**：工程里的 `eda_proj/.../impl/pnr/fpga_hank.fs` **每次构建都被覆盖**，而**归档到 `out/bitstream/<模式名>.fs` 是【人工做的、没有脚本】**
  （实测：`tools/` 下**没有**任何自动归档脚本；`build.tcl` 只**报告**产物路径，不复制归档）
- **⇒ 后果**：`0x0000BB21` 这个指纹**指向一个已经丢失的产物** ⇒ **无法再烧回"产生 32 谱峰证据的那一份位流"**
- ✅ **补救（`Lead` 2026-10-05 18:37 已做）**：重建并归档为 **`MODE2_测试模式_32谱峰.fs`**（34,840,489 B / `68F7FFD22A9B1B18` / 18:37:18）
  - 资源：Logic 4 160 (3%) / Register 1 602 / BSRAM 1 / DSP 58；**时序 0 setup / 0 hold**
  - ⚠️ **它不是原证据版**：P&R 非确定性 + `User Code` 逐次随机（§2.3）⇒ **指纹不同是正常的**
  - ✅ **但 MODE=2 的 RTL 未变 ⇒ 功能等价**（可重新产出 32 谱峰）
- **⇒ 建议（已批准、待实现）**：**给 `build.tcl` 加一步自动归档**（构建后按 `MODE` 把 `.fs` 复制成 `out/bitstream/MODE<n>_<名字>_<时间戳>.fs`），**并在归档时把 `User Code` / 大小 / sha256 追加进本表**

### 2.2 ⚠️ **MODE=0 的 `User Code` 无法证明"绑到具体文件"**
- `Lead` 记录了 `0x0000C7B0`，也记录了它对应 `MODE0_演示模式_放歌.fs`（16:50:36）
- **但本项目没有"逐次烧录日志"**（`program.ps1` 不落盘 `User Code`）⇒ **无法从文件层面证明那次烧录烧的就是这一份**
- **⇒ 证据强度标为「凭证不足」**：**结论可信，但不可独立复核**
- **⇒ 建议**：让 `program.ps1` **把每次烧录的 `User Code` + 时间 + `.fs` 名 + sha256 追加到一个日志文件**（一行一条）

### 2.3 🔴 **`User Code` 不是设计标识，而是【逐次构建的随机量】**
- **实测**：`tools/gowin/program.ps1` L170-171 记着**早期**的 `0x0000A86D`（测试）/ `0x00005093`（演奏）；
  而 `Lead` 后来构建的**同类模式**得到的是 `0x0000BB21` / `0x0000C7B0` —— **同一个模式、不同次构建，值不同**
- **实测**：`tools/gowin/build.tcl`、`eda_proj/**/*.gprj`、`*.gprj.user` 里 **都没有 `user_code` 设置** ⇒ **是工具自动生成的**
- **⇒ 三条推论**：
  1. **重建同一份 RTL，会得到不同的 `User Code`** ⇒ **不能用它核对"重建结果是否等于历史产物"**
  2. **它唯一可靠的用途**：**烧录当场确认"我烧的就是我要烧的那个文件"**（配合大小/sha256）
  3. **⇒ 本表的 `User Code` 列只能标识【历史产物】，不能标识【设计】**
     判"是不是同一版设计"要**比对 RTL 源码**（见 README 附录 B：位流 SHA256 不能当修订标识）

---

## 3. 本表的维护方式（**给下一个人**）

```powershell
# 每次烧录后，追加一行（示例）
$fs = "fpga_hank\out\bitstream\MODE1_current.fs"   # = MODE1_H4校准_0违例.fs
$f  = Get-Item $fs
$h  = (Get-FileHash $fs -Algorithm SHA256).Hash.Substring(0,16)
"{0} | {1} | {2} | {3} | {4} | <User Code> | <烧录时间> | <真板结果> | <证据强度>" -f `
   "MODE=1", $f.Name, $f.Length, $f.LastWriteTime.ToString('yyyy-MM-dd HH:mm:ss'), $h
# 然后手动补 User Code / 烧录时间 / 真板结果 / 证据强度
```

**⚠️ 三条纪律**（来自本项目多次踩坑）：
1. **位流必须【归档】，否则指纹指向空气**（MODE=2 就是这么丢的）
2. **文件是否被 git 忽略必须双判据实测**：`git check-ignore --no-index` + `git ls-files -o --exclude-standard`
   （本表之所以放 `docs/` 就是因为 `out/` 被忽略）
3. **证据强度要标出来**：`日志实测` / `凭证不足` / `产物已丢失` —— **不要把"某人说"写成"已验证"**
