wongben2333-crypto/26Embedded/fpga_hank/docs/TODAY-2026-10-06.md

> **历史文档（不随 v8.1 口径维护）**：以下为当时记录；当前口径以 `fpga_hank/docs/技术文档_v8.docx` 与本仓库的“当前口径”块为准。

# 今日进展（2026-10-06）—— 二胡音色攻坚 + 运行期模式切换

> 本文档由 Lead 整理，覆盖 **2026-10-06 全天**的工作。
> **所有数字都来自本机实测产物**（Gowin 构建报告 / ModelSim / 真机烧录），不是估算。

---

## 0. 一句话总结

今天做了两件大事：

1. **运行期模式切换**（板载 key1/key2）**+ 第一首流行曲进 ROM** —— 这两条**已完成并上板** ✓
2. **二胡"像小提琴"的攻坚** —— **找到了根因**（不是参数没调好，而是**做错了一个特征**），
   并经过 6 轮迭代把音色改到"低频厚度 + 高频收敛"的方向；**最后一版已上板待听感确认** ✓

---

## 1. 已上板的功能（**当前位流 = `MODE1_二胡H4校准.fs`**）

| 项 | 状态 |
|---|---|
| **位流** | `fpga_hank/out/bitstream/MODE1_二胡H4校准.fs` |
| **时序** | **0 Setup 违例 / 0 Hold 违例**，最差裕量 **+0.04 ns** |
| **资源** | Logic ≈31.9k / Register ≈10.8k / DSP 124.5 / BSRAM 124 |

### 1.1 板载按键（**用户需求，已实现**）

| 模式 | 按键 | 功能 |
|---|---|---|
| **自由演奏**（上电默认）| **`key2`（Y12）** | **进入曲目模式 + 自动播放** |
| **曲目模式** | **`key1`（AB13）** | **换乐器播放**（钢琴 → 吉他 → 二胡 → 钢琴…）|
| | **`key2`（Y12）** | **回自由演奏 + 自动停止**（走完 128 拍全关，不留挂音）|
| 自由演奏 | **`key_pitch`（Y22）** | 第 3 维变调（曲目模式下不动作）|

**切换时的三道清音**（避免"咔哒"与挂音）：
1. `song_player` 强制停止（run_en=0，内部走完 128 拍全关扫描）
2. 给 `piano_engine` 发 `reset_all` 一拍脉冲
3. 输出 **~5 ms 静音窗**

### 1.2 歌曲（`song_rom.v`，5 首）

| 下标 | 曲目 | BPM | 音数 | 时长 | 授权 |
|---|---|---|---|---|---|
| **[0]** | **我落泪情绪零碎（副歌 m.29–31）** | 67 | 18 | 10.7 s | ⛔ **受版权保护，本队未获授权** |
| [1] | 欢乐颂 (Ode to Joy) | 100 | 62 | 38.4 s | ✅ 公有领域 |
| [2] | 小星星 | 120 | 42 | 24.0 s | ✅ 公有领域 |
| [3] | 铃儿响叮当 | 140 | 50 | 27.4 s | ✅ 公有领域 |
| [4] | 致爱丽丝 | 120 | 37 | 6.1 s | ✅ 公有领域 |

**版权如实标注**（按用户要求"连'未获授权'也如实写在交付文档里"）：
代码注释与本文档均写明 **《我落泪情绪零碎》为受版权保护的流行歌曲，乐谱由使用者本人从
EveryonePiano.com 获取（编配 JenaV），本队未获得任何授权，纳入演示是使用者的知情决定，
版权风险由使用者承担。**（与《Faded》同一处理方式；Faded 因数据源被用户否掉、副歌起点
从未确认，已于今日**彻底删除**。）

**★ 一个安全设计**：`[0]` 是受版权曲目，而**上电默认是自由演奏模式** ⇒ **上电不会自动播放它**，
必须用户主动按 key2 ✓

### 1.3 电脑端 GUI（`host/piano_gui.py`，v46-guitar-slap）

| 功能 | 说明 |
|---|---|
| **三乐器独立 UI** | F1 钢琴 / F2 吉他 / F3 二胡，各自界面独立 |
| **吉他 F7/F8** | 变调夹 ±1 品（Shift = ±5 品）|
| **吉他 F9/F10/F11** | 大横按 设/清 / 设+立刻下扫 |
| **吉他 F4** | 拍弦（**近似实现**，状态栏如实提示"真正的宽带噪声需 RTL 支持"）|
| **扫弦滑杆** | **25~80 ms 连续可调，默认 36 ms**（依据：指弹实测中位 36.0 ms / p90 77.9 ms）|
| **二胡** | 50 音位格 + 换弦 + 弓速/弓压/弓位滑杆 + 键位标注 |
| **测试** | selftest **71/71** · keytest **82/82**（含 `KEYTEST_SELFFAIL=1` 自证有效）|

---

## 2. 二胡"像小提琴"的攻坚（今日主线）

### 2.1 走过的弯路（**如实记录**）

| 轮 | 做了什么 | 结果 |
|---|---|---|
| 1 | 按"廉价二胡实测"做**固定低音区谐波权重表**（H1 弱 / H3 最强）| ⚠️ **高音区跟着错** ⇒ 用户听出"偏高" |
| 2 | 加 `drive`（持续激励，弓弦感）| ✅ **"有拉的感觉了"**（用户确认）|
| 3 | 加 **550 Hz 琴体曲线**（4 级 peaking biquad）| ✗ **滤波器按每时钟推进（应在采样率）⇒ 软膝触发 99.97%** ⇒ 已旁路 |
| 4 | 改按 **`sample_tick`** 门控 | ✗ **仍 99.17%** ⇒ 未定位，**放弃 RTL 滤波器路线** |
| 5 | 改走 **5 档谐波权重表**（`f(音高档, 泛音)`，装载期查表）| ✅ **0 违例、上板** ⇒ 但用户仍说"有些像小提琴" |
| 6 | 按**能量口径**重算 5 档表（α=0.65）+ 顺手修掉一个**错样本 bug** | ✅ 上板 |
| 7 | **H4 校准**（A4 的 1766 Hz 从 0.64 抬到 0.94）| ✅ **上板，待听感确认** |

### 2.2 ⭐⭐ 根因（**这是今天最重要的发现**）

> **用户给的原视频**：`BV1kXZ5BxEaT`【二胡】《赛马》独奏版（**已重新提取并验证与之前用的是同一段**：
> `cid=36057189401`，103 s，重提取 WAV 与旧 WAV **时长/采样数完全一致**）。

**三段独立录音交叉验证**（赛马 / 梁祝 / 弱水三千）后，得出：

| 发现 | 内容 |
|---|---|
| ⭐ **判别性特征在低频，不在 2–3 kHz** | **二胡在 `400–700 Hz` 有 `+23~+25 dB`（相对 1 kHz）的巨峰** ⇒ **1 kHz 反而是凹**；小提琴**没有**这么夸张的低频峰 |
| ⭐ **"像小提琴"的机理** | **一旦 400–700 Hz 不够突出 ⇒ 频谱变平 ⇒ 剩下的 1.5–3 kHz 抬高就显得像小提琴的「琴桥山」** |
| ⚠️ **2–3 kHz 不能用来区分** | 二胡 2–3 kHz 相对 1 kHz 是 **+4.1 dB**（1.8–3.2 kHz +9.3 dB）—— 与文献里小提琴的 0~+6 dB **量级接近** |
| ⚠️ **精确曲线不可跨录音复现** | 三段在 550 Hz 带给出 **+11.9 / +23.2 / +24.5 dB**（极差 **12.6 dB**）⇒ **不能把任何单段曲线写死给 RTL**，只能用**形状 + 可调系数** |
| ⚠️ **"2 kHz 以上极低"无法定论** | 三段 2–3 kHz 为 **−15.3 / −9.8 / −3.6 dB**，**排序恰好与码率同向**（132/159/176 kbps）⇒ **"编码削的"与"乐器本来就暗"都说得通**，**未能区分** |

**⭐ 可放心采用的三条（三段一致成立）**：

```
相对 1 kHz：
  315–700 Hz ：显著提升（+11.9~+25）⇒ 取中间 ~+18 dB
  ~1.6 kHz   ：次级抬高（+5~+13）  ⇒ ~+9 dB
  ~2.5 kHz   ：明确做凹（−9~−22）  ⇒ ~−12 dB
  3.5–5 kHz  ：继续降低（−13~−22）⇒ ~−15 dB
```

### 2.3 最终落地的 5 档谐波权重表（`BAND_MUL`，α=0.65 已含在内，**各档均值 = 1.000000**）

| 档 | f0 | H1 | H2 | H3 | H4 | H5 | H6 |
|---|---|---|---|---|---|---|---|
| 0 | **D4** 293.7 | 0.5430 | **2.2337** | 0.9270 | 0.9789 | 0.7491 | 0.5683 |
| 1 | **F4** 349.2 | 2.4182 | 1.2812 | 0.7595 | 0.8722 | 0.4957 | 0.1731 |
| 2 | **A4** 440.0 | **2.9624** | 0.9762 | 0.8605 | 0.9428 | 0.1488 | 0.1094 |
| 3 | **C5** 523.2 | 3.3609 | 1.1660 | 0.8982 | 0.2678 | 0.1348 | 0.1723 |
| 4 | **D5** 587.3 | 3.3586 | 1.2813 | 0.8546 | 0.1280 | 0.1918 | 0.1857 |

**验证（对照实测）**：
- **D4：H2 主导**（H2/H1 = +12.3 dB）✓ 实测 +18.9 dB（同向）
- **A4：H1 最强** ✓（实测：外弦 A4 基频最强）
- **A4/D5 的 H5/H6（2.2–2.6 kHz）压到 −26 / −29 dB** ✓（切掉小提琴的"琴桥山"区）
- **D4 的 H6（1762 Hz）未被压死** ✓
- **档 0 对低于 D4 的音是【外推，无实测支撑】**（已写进代码注释）

### 2.4 顺手修掉的一个**真 bug**（曾在板上发生）

```verilog
// 错：IIR 已旁路，但有效位延迟链被留下 ⇒ 二胡被推迟 6 个【采样点】
wire lim_vld = (inst_ok == 2'd2) ? fvld[5] : vld[4];
```
**后果**：**每个采样点读到的都是 6 个采样点之前的值** ⇒ 音频**错位**（发闷/叠影），
**不是良性延迟** ✗ ⇒ 已修为 `vld[4]` 并删掉 `fvld` 链 ✓

---

## 3. 证据与纪律（今天新增的经验）

### 3.1 ⭐ **口径陷阱的三种形态**（都用实测踩过）

| # | 形态 | 实例 |
|---|---|---|
| 1 | **占比 vs 相对电平** | 用"2–3 kHz 占总能量 0.42%" ⇒ 下"该滚降"（**错**，应按"相对 1 kHz 的每 Hz 电平"）|
| 2 | **整曲统计 vs 单音** | 用"整曲 1600–2000 Hz 占 3.7%"去定**单音**的 H4 |
| 3 | **不同基准的比值** | 用"琴体 1.6k/1k"去判断"**H4/H1**"（**两个不同量**）|

> **纪律**：**凡把两条曲线相比，必须先声明【两边各自的基准是什么】**；
> **"占总能量比例 / 相对某基准频带的每 Hz 电平 / 相对基频的谐波幅度"是三个不同的量，不可互换。**

### 3.2 其他今日教训

| 教训 | 来源 |
|---|---|
| **含中文的 `.ps1` 必须 UTF-8 with BOM**（否则 PS 5.1 按 GBK 读 ⇒ 字符串结构被破坏、解析崩）| 原子脚本 v1 失败 |
| **PowerShell 变量名大小写不敏感**：`$GEN`（路径）与 `$gen`（内容）**是同一个变量** ⇒ 路径被覆盖成文件内容 ⇒ "Illegal characters in path" | 原子脚本 v1 |
| **跨行正则 + 字符串重建**会截断字符串字面量 ⇒ **改用逐行编辑** | 原子脚本 v3 |
| **`Set-Content -Encoding UTF8` 在 PS 5.1 下会加 BOM** ⇒ `vlog` 报 `0xef 0xbb 0xbf`；应用 `[System.IO.File]::WriteAllText(..., UTF8Encoding($false))` | dump 第一次失败 |
| **1 GB 级目录存在时，"全仓递归搜索"当判据不可靠**（会被截断）⇒ 先限定到已知子树 | `liaison` 搜不到 TB |
| **TB 用固定文件名 + `"w"` 模式 ⇒ 跑第二个音高会静默覆盖第一个** | `liaison` 读 TB 源码发现 |
| **滤波器必须按采样率更新**（不是每时钟）—— 本项目**已犯两次** | 二胡 IIR |

---

## 4. 待办与未完成（**如实**）

### 4.1 二胡音色

| # | 项 | 状态 |
|---|---|---|
| 1 | **听感确认**：H4 版（`MODE1_二胡H4校准.fs`）是否改善"尖/暗/像不像小提琴" | ⏳ **等用户听** |
| 2 | ⭐ **D4 / A4 的引擎稳态 dump** | 🔄 正在跑（`NDUMP=48828` ≈0.5 s/音高，约 20~45 分钟/音高）|
| 3 | ⭐ **"我们 vs 三段真实二胡"的同口径（琴体比值）逐频带距离表** | ⏳ 依赖 2 |
| 4 | **小提琴实测对照** | ⚠️ **未完成**：CC0 源四个全部失败（Wikimedia 超时 / archive.org 连不上 / signaturesounds 无直链）⇒ 拟用 B 站一段**仅作分析参照**（**无开源许可证，不进交付物、不作合规依据**）|
| 5 | **弓噪（宽带摩擦成分）** | ⏳ 未做（实测显示真二胡 3.3 kHz 以上仅 0.04% ⇒ **弓噪可能不是主因**）|
| 6 | **起振时间随弓速变化**（真实跨度 0.3 ms~441 ms，现为固定 84 ms）| ⏳ 未做（需要**离散弓压档位**，不能用连续变量移位）|
| 7 | **泛音数 6 → 10**（激活 2970/5360 Hz）| ⏳ 未做（+32 DSP，对时序是真风险，需单独一轮）|

### 4.2 其他

| # | 项 | 状态 |
|---|---|---|
| 1 | **PCB**（6 键触摸板 `pcb/piano6/`）| ⚠️ 已在嘉立创 EDA 建工程；**排针通孔钻孔真值待补** |
| 2 | **演示模式（MODE=0）** | 曲目已就绪（5 首）；**《我落泪情绪零碎》版权未获授权**（如实标注）|
| 3 | **TDM / 32 复音** | 有早期草稿（`_research/piano/piano_engine_tdm_DRAFT.v`），**未推进** — 赛题拓展①主线 |
| 4 | **交付文档** | 未开始 |
| 5 | **`apply_A_route.ps1`（原子脚本）** | ⚠️ **已弃用**（失败 7 次）；**最终由 Lead 用 Python 补丁落地成功** |

---

## 5. 关键版本指纹（**可追溯**）

| 文件 | sha256（前 16） |
|---|---|
| `rtl/top.v` | 见仓库当前版本（含运行期模式切换 + `band_ld`）|
| `rtl/synth/piano_engine.v` | 含 `band_ld_eff`（**已寄存**，修 498 违例）+ `drive` + 删除 IIR 死代码 |
| `rtl/synth/piano_rom.v` | **42 行 8 位索引表**（3 乐器 × 1 档 + 二胡 5 档）|
| `rtl/synth/song_player.v` | 含 `key_pause` / `run_en` / `paused`（四态 FSM）|
| `rtl/synth/song_rom.v` | 5 首，238→ 条 |
| `tools/gen/gen_piano_rom.py` | 含 `BAND_MUL` 5 档 + `band` 端口 + 8 位索引 |
| `host/piano_gui.py` | `v46-guitar-slap` |
| **当前位流** | `out/bitstream/MODE1_二胡H4校准.fs`（0 违例 / +0.04 ns）|

---

## 6. 诚实说明（**边界**）

1. **"二胡像不像"最终判据是人耳** —— 本文档所有频谱数字都是**辅助**，不能替代听感 ✓
2. **三段参考录音全部是 AAC 有损**（131.9 / 158.8 / 176.3 kbps）⇒ **不是无损复核**；
   **"2 kHz 以上极低"是编码削的还是乐器本来就暗，未能区分** ⚠️
3. **《弱水三千》那段实测有伴奏**（`<280 Hz` 中位 4.79%，最强周期 86.8 Hz = F2，二胡拉不出来）
   ⇒ **该样本已作废** ⚠️
4. **三段乐器/麦克风/演奏者/曲风都不同** ⇒ **本就不是同条件重复实验** ⇒ 不一致可能是真实的乐器间差异 ⚠️
5. **CC0 小提琴实测未拿到**（四个源全失败）⇒ 小提琴侧的对比目前是**文献定性** ⚠️
6. **`<280 Hz` 判据只能排除"低音伴奏"**，排除不了"不占低频的伴奏" ⚠️
7. **H4 版尚未经听感确认** ⏳
8. **D4/A4 的引擎 dump 尚未产出**（正在跑）⏳
