wongben2333-crypto/26Embedded/fpga_hank/docs/工程能力与工具链说明.md

> **当前口径（v8.1，2026-11-04，适用于本仓库全部说明文档）**：目标板 138K，交付位流 MODE=3；合成引擎 TDM32 32 声部×6 泛音=192 路（48 路全并行仅作对比基线）；音色统一为钢琴/吉他/小提琴 3 种（对外只列这三种）；交互为 13 键硅胶轻触按钮 + 6 路光电 + 双路 ToF（A 主用/B 热备）+ 7 寸触控，4 路 EC11 仅预留；PCB1 为“输入调理与隔离转接板”（上拉/限流/RC/PC817 光耦/ToF 双总线供电/地分割），防爆音在 RTL 三道清音 + PA_EN，不在 PCB；整机物理输入→模拟输出实测 2 ms，芯片内部 ≤20.5 µs，TDM32 流水 3.85 µs；7 寸屏经 34P FPC→J14 40P 排线，不再使用 P34-P40 转接板与 piano6 PCB；交付曲目为 4 首公有领域曲目（源码 Song 0 待删）；32 峰为必备取证，192 路由 RTL 状态阵列证明。**与旧描述冲突处，以本块为准。**

# 工程能力与工具链配置说明

> 本文件对应赛题工程要求的「开发环境与能力准备」，逐项说明**本工程实际用到了什么、装在哪、
> 版本与许可证、能不能用**。
>
> **编写原则**：只写**实测过**的。未验证的一律标注「未验证」，不写推断。
> 更新日期：2026-10-03

---

## 一、FPGA 工具链（本工程的核心依赖）

| 项 | 值 | 验证方式 |
|---|---|---|
| 高云 Gowin EDA | **V1.9.12.04**，装于 `F:\Gowin\Gowin_V1.9.12.04_x64` | 实跑构建 |
| License | 商业版 **STD**，node-locked（`HOST_ID` = 本机 WLAN MAC `F4:3B:D8:1C:9E:81`），有效期 **2027-09-24** | 构建成功即证明有效 |
| Tcl 命令行 | `IDE\bin\gw_sh.exe` | ✅ 本工程全部构建走它 |
| 器件库 | `IDE\data\device\GW5AST-138C` 存在 | 构建目标 `gw5ast138c-007` |
| Tcl 官方文档 | `IDE\doc\CN\SUG1220-2.1_Gowin云源软件Tcl命令用户指南.pdf` | 查阅 |

### 仿真器

| 项 | 值 | 验证方式 |
|---|---|---|
| ModelSim | **SE-64 10.7**，装于 `F:\Modelsim_10.7` | ✅ 本工程全部仿真走它 |
| 高云预编译库 | **`F:\Modelsim_10.7\GW5AT`** 存在 | ✅ 已确认；`run.do` 里显式映射 |
| License | `MGLS_LICENSE_FILE = F:\Modelsim_10.7\LICENSE.TXT` | ✅ 仿真跑通 |

> ⚠️ **ModelSim 10.7 的 `-pli` 不认路径里的空格**。本仓库路径 `...\FPGA competition\...` 含空格，
> 一旦挂任何 VPI/PLI 库（例如 cocotb）就会报 `vsim-3193` 并退出码 12。本设计是纯 RTL，
> 不涉及；但**将来要用 VPI 就必须先解决路径空格**（用 8.3 短路径或换无空格目录）。

### 构建命令（唯一权威入口）

```powershell
& "F:\Gowin\Gowin_V1.9.12.04_x64\IDE\bin\gw_sh.exe" `
  "C:\Users\Danny\Desktop\FPGA competition\fpga_hank\tools\gowin\build.tcl"
```

实测：**72 秒**完成 `syn → pnr → bitstream`，产出 `eda_proj\fpga_hank\impl\pnr\fpga_hank.fs`。

**全链路实测结论**

| 阶段 | 状态 | 备注 |
|---|---|---|
| RTL → 综合 | ✅ | `gwsynthesis` |
| 布局布线 | ✅ | 11 引脚全部按 `.cst` 分配（`constrained=Y`） |
| 时序分析 | ✅ | Setup 违例 0 / Hold 违例 0 |
| bitstream | ✅ | 34 840 489 B |
| 烧录 | ⬜ **未验证** | 属"上电之后"的工作，由用户执行 |

---

## 二、项目级 Skill（自建，本工程的"踩坑知识库"）

位于 `.dsh\skills\`，三个 skill 全部是**本项目实测结论的沉淀**：

| Skill | 内容 | 关键价值 |
|---|---|---|
| `gowin-flow` | Gowin 命令行全链路规范 + **13 组实测坑位** | 含"`-synthesis_tool` 只认小写"（**官方 PDF 示例是错的**）、`.tcl` 不能带 BOM、顶层不能放 `rtl/` 根、`ROM_PARALLEL` 默认值导致综合卡死等 |
| `verilog-review` | RTL 审查清单 | 含本项目 5 个"波形正常但实际错误"的案例复盘 |
| `fpga-verify` | 取证纪律 + 判据脚本 + 形式验证模板 | **实际存在**的判据脚本：`tools\verify\check_peaks.py`（32 谱峰判据）、`tools\verify\check_pitch_shift.py`（半音变调判据，逐峰对理论值）、`tools\verify\run_acceptance.ps1`（端到端验收，打印 PASS/FAIL 汇总） |

> ⚠️ **兼容性说明（实测）**：本会话里 `skill` 工具加载项目级 skill 会报 "unknown"——
> provider `dsh-skill-filesystem` 未生效。**兜底方式完全等效：直接 `read .dsh/skills/<name>/SKILL.md`**。
> 所有 skill 正文都是普通 Markdown，不依赖任何加载器。

---

## 三、DSH 插件与 Claude Code 插件

**结论：本工程【没有安装】任何 DSH Cordis 插件或 Claude Code 插件。** 这是有意为之：

| 类别 | 调研结论 | 决定 |
|---|---|---|
| **DSH Cordis 插件** | 调研两轮，npm 生态**不存在**可用于本场景的第三方插件 | 不装 |
| **Claude Code 插件** | DSH 无 `commands/`、`agents/`、`hooks/`、LSP 装载器，这些形态**用不了** | 不装 |
| **第三方 skill（纯 Markdown）** | 找到 6 个许可证为 MIT 的候选，但与本工程已有的自建 skill **功能高度重叠** | 暂不装 |
| `anthropics/skills` 的 docx/pdf/pptx/xlsx | 许可证 **Proprietary**（专有） | ⛔ **排除** |

⚠️ **安装第三方 skill 的两个硬门槛（实测/文档确认）**：
1. frontmatter **只认 `name` + `description`**（可选 `whenToUse`/`metadata`/`disable-model-invocation`/`user-invocable`）。
   Claude skill 常见的 `tools:` / `allowed-tools:` **不认** ⇒ **整个 skill 会被静默丢弃且无诊断**。
2. DSH 的 skill 发现深度**只有一层**（`<root>/<name>/SKILL.md`），**刻意不支持嵌套 `**/SKILL.md`**。
   ⇒ 把 skill 放进 `fpga_hank/team-resources/skills/` 这类子目录**会静默失效**。

> **向前兼容约定**：本工程若将来要引入第三方 skill，应保持 `.dsh/skills/` 为**唯一权威源**，
> 任何其他位置的副本都必须是**可再生的派生物**（单向 源 → 副本），禁止反向手改副本。

---

## 四、参考工程代码库

全部放在 `_refs/`（已在 `.gitignore` 中排除，属只读参考资料，**不作为交付物**）。

| 参考库 | 用途 | 许可证 | 能否复制代码 |
|---|---|---|---|
| `sipeed-138k`（github.com/sipeed/TangMega-138K-example） | **引脚事实来源**（全部引脚按它核对） | ✅ **Apache-2.0**（实读 LICENSE 全文） | ✅ 可以（需保留版权声明 + 附 LICENSE 副本 + 注明修改） |
| `tangmega-138k-full`（vdalex/tangmega-138k-fpga-projects） | **设计思路参考**（PT8211 时序、分频策略、Python 行为模型 `music_model.py`） | ❌ **仓库无 LICENSE 文件** | ⛔ **不能复制代码**；但**事实不受版权保护**，引脚号、采样率推导、datasheet 引文可引用并注明出处 |
| `stnolting/captouch` | 电容触摸控制器设计参考（**BSD-3-Clause**） | ✅ BSD-3-Clause | 参考其设计要点（全局阈值、输出滤波、单时钟域+分频使能） |

> **本工程的实际做法**：`pt8211_tx.v`、`tone_bank.v`、`adsr.v`、`wave_rom.v` 等
> **全部为独立实现**，只借鉴设计决策，未复制任何第三方代码。因此**不涉及许可证传染问题**。

---

## 五、本工程【刻意未安装】的东西

| 项 | 为什么没装 |
|---|---|
| `oss-cad-suite`（573 MB，含 verilator/yosys/gtkwave） | 用户明确要求"验收只能走高云软件 + ModelSim"；且 apicula 对 `GW5AST-138C` 只有器件级支持、**无板级时序支持**，无法替代官方工具链 |
| `cocotb` | 曾试装并跑通（引擎仍是 ModelSim），但用户判定"Python 驱动不算用 ModelSim 跑" ⇒ **不作验收依据**，仅保留技术归档 |
| `gh` CLI / GitHub PR 扩展 | 非必需 |
| 所有需要全局配置修改的工具 | 用户要求"不要自己想办法瞎测"；且改全局配置需用户授权 |

---

## 六、验证方式（本工程的验收口径）

按用户明确要求，**验收只认**：

1. **构建**：`gw_sh.exe` + `tools\gowin\build.tcl` → 必须产出 `.fs`，且引脚全部 `constrained=Y`
2. **仿真**：**ModelSim** + `sim\run.do` → 0 error，结果符合预期
3. **波形图**：`docs\waveforms\real\*.png` —— 共 6 张，**全部是 ModelSim 真窗口截图**（用 `PrintWindow(hwnd, hdc, 2)` 抓的真实窗口，不是脚本画出来的图）。
   > ⚠️ **本项目明确禁止"自己绘图"**（用户原话："不要自己绘图，可能自己骗自己"）。
   > 早先尝试过"testbench `$fwrite` → CSV → matplotlib 渲染"的路线，
   > **已废弃**，所有自绘草稿移到 `_smoke-test/matplotlib-drafts/`，不进交付物。
   > 理由：渲染图是"用我们自己的数据、我们自己的假设画的图"，
   > 一旦渲染逻辑或假设错了，图会**自证其说**；
   > 真窗口截图则是 ModelSim 自己的显示结果，**不给我们在中间做手脚的机会**。

其它手段（Python 脚本、形式验证、隔离基准实验）**只作辅助排查，不得作为验收依据**。

### 一键复核

```powershell
powershell -NoProfile -ExecutionPolicy Bypass -File tools\verify\run_acceptance.ps1
```

跑完 前置检查 → 构建 → 全部仿真 → 32 谱峰判据 → 变调判据 → 波形数据集 →
真窗口截图 → 烧录链路（SVF）→ 交付物清单，并打印 PASS/FAIL 汇总。
最近一次：**PASS = 9，FAIL = 0**。

> ⚠️ **注意**：这个脚本自己也曾有过一个"假 PASS"（变调那段用 PowerShell
> here-string 内嵌 Python，结束标记没顶格 ⇒ 代码没执行却报 PASS）。
> 已改为调用独立 `.py` 文件。**判据脚本自己也会错**，这一点请一并注意。
