wongben2333-crypto/26Embedded/fpga_hank/docs/技术文档-改进指导-给Codex-20261102.md

> **历史文档（不随 v8.1 口径维护）**：以下为当时记录；当前口径以 `fpga_hank/docs/技术文档_v8.docx` 与本仓库的“当前口径”块为准。

# 技术文档改进指导（给 Codex）

> **出具人**：Lead（DSH/DeepSeek 代理）
> **时间**：2026-11-02 19:45
> **对象**：`fpga_hank/docs/技术文档.docx`（11-02 19:25 版，3705 中文字，8 表格）
> **结论先说**：**文档底子很好，不要重写。** 结构已对齐国二模板，数据详实，证据链完整。
> **但有 3 个必须修的问题，其中第 2 个是评分风险。**

---

## 一、总体评价

| 维度 | 评价 | 说明 |
|---|---|---|
| 结构 | ★★★★★ | 对齐《技术报告-钟超炀-国二》骨架，还额外加了"验证方法与证据链"章，很聪明 |
| 数据 | ★★★★★ | 所有关键指标都带数值+来源（3.85 μs / 97 656.25 Hz / P50 15.4 μs / 32/32 谱峰 / Logic 30%），且绑了位流指纹 |
| 合规表述 | ★★★★☆ | 明确写了"不使用 CPU 或软核承担音频算法，也不播放 PCM、WAV 或整段录音"，很好 |
| 论证力度 | ★★★☆☆ | **192 振荡器的合规性论证不够硬**（见问题 2） |
| 排版 | ★★★☆☆ | **章节编号顺序错乱**（见问题 1） |
| 图表 | ★★★☆☆ | 只有 5 张图，偏少 |

---

## 二、🔴 P0 问题（必须修，直接影响评分）

### P0-1：章节编号顺序错乱

**现状**（从 docx 标题样式读出的实际顺序）：

```
2.1 总体架构
2.6 曲目播放与仪器化显示    ← 位置错了！
2.2 输入与多维交互
2.3 32 声部与 192 振荡器
2.4 ADSR 包络与表情控制
2.5 I2S 与 PT8211 音频输出
```

**修复**：把「2.6 曲目播放与仪器化显示」移到「2.5 I2S 与 PT8211 音频输出」**之后**。

**注意**：这可能只是 docx 里段落顺序问题，`build_report.py` 里调整段落插入顺序即可，不要重新编号成 2.5/2.6 互换（除非你有意）。

---

### P0-2：🔴 192 个独立振荡器的合规论证**不够硬**（最大评分风险）

**这是全文最关键的论证，但目前只有一句半：**

> 2.3 节：「核心模块 piano_engine_tdm32 采用 32 声部 × 6 泛音的组织方式……每个二元组拥有独立的相位存储、频率增量和包络状态。」
> 1.3 节：「每个独立振荡器均具备独立相位累加器、频率控制字和包络状态，192 个振荡器的数量来自 RTL 结构，而不是波表份数。」

**评委一定会这样质疑：**

> "你说的 6 个泛音，不就是同一个音符的 2 次、3 次、4 次谐波吗？那本质上还是 1 个振荡器加了谐波，凭什么算 6 个？"
> （官方规则明确写着：**"单波表采样查表不计多谐波数量，仅计单个振荡器"**）

**你要补的论证（三层，缺一不可）：**

**第一层：三件套逐条对照表**

把官方定义拆成三行，每行给出 RTL 证据（文件名 + 信号名 + 行为）：

| 官方要求 | 我们的实现 | RTL 证据（文件名:行号/信号名） |
|---|---|---|
| 独立相位累加器 | 192 个独立的 32 bit 相位寄存器，每个泛音分量一个 | `piano_engine_tdm32.v` 中 `phase_acc[191:0]`（具体名字以实际代码为准） |
| 频率调控（独立） | 每个分量的相位增量**可独立设置**，不锁定在 f0 整数倍 | `freq_word[191:0]`，由 `note × ratio[k] × (1+glide) × (1+vib)` 计算 |
| 包络控制（独立） | 每个分量有独立 ADSR 状态机 | `env_state[191:0]` / `adsr.v` 实例化 192 次或时分复用 |

**第二层：说明泛音比不锁定在整数倍（这是关键！）**

如果 6 个泛音严格是 f0 的 1/2/3/4/5/6 倍，那评委有理由说"这是一个振荡器的谐波"。
所以**必须说明**：

- 每个泛音分量的**频率比是可配置的**（`ratio[k]` 来自 `tone_bank` 的音色参数表，不同音色不同比值，甚至可有非整数比）
- 因此每个分量**不是被锁定的谐波，而是独立可调的振荡器**，只是默认配置成谐波比以形成音色
- **证据**：`tone_bank.v` 里的 `ratio` 参数表 + 可运行时切换音色（切换后比值变了）

**第三层：正面回应"单波表只算 1 个"的规则**

必须**主动**写一段话，引用官方规则并解释为什么我们不属于那种情况：

> 官方规则指出"单波表采样查表不计多谐波数量，仅计单个振荡器"。**该规则的约束对象是"单个波表内包含多个谐波、但只有一套相位/频率/包络控制"的实现。** 本设计与之的本质区别在于：
> ① 192 个分量各有**独立的相位累加器**，不是共用一套相位；
> ② 每个分量的频率增量由**独立的频率控制字**驱动，比值可配置；
> ③ 每个分量有**独立的包络状态机**，可独立起音/衰减/释放。
> 因此按官方"加法合成按运算分量统计"的口径，本设计计 **192 个独立振荡器**。

**这三层补上，192 这个数字才站得住。** 现在只有第一层的一半。

---

### P0-3：⚠️ ROM 文件必须主动澄清（防止被误判为"预录 PCM"）

**问题**：你的 RTL 里有三个大 ROM：

```
piano_rom.v   87 KB
wave_rom.v    43 KB
song_rom.v    40 KB
```

评委看到这三个名字 + 这个体积，**第一反应会怀疑你在 ROM 里存了预录音频**（这正是赛题红线）。

**文档里现在只提了"波表读取""5 首曲目编译为 535 个音符事件"，但没有集中说明这三个 ROM 到底存什么。**

**必须补一个明确段落（建议放在 2.3 节或新增 2.x 节），逐个说明：**

| ROM 文件 | 大小 | **存的是什么** | **不是什么** |
|---|---|---|---|
| `piano_rom.v` | 87 KB | 单周期波形表（几个周期的正弦/谐波采样点，用于相位→幅度查表），**是波表合成的一维查找表** | ❌ 不是整段音频 PCM |
| `wave_rom.v` | 43 KB | 同上，多音色的波形表 | ❌ 不是录音 |
| `song_rom.v` | 40 KB | **音符事件序列**（音高/时值/力度），例如 `{note=69, dur=480, vel=90}`，共 535 条，需要 `song_player` 实时合成才发得出声 | ❌ 不是音频数据 |

**再加一句关键论证：**

> 从 `song_rom.v` 中取出任意一条记录，若不经过 `song_player` → `piano_engine` 的实时合成，**它无法产生任何声音**，因为它只包含音符参数，不含任何音频采样。这可以从 RTL 结构上证明本设计不属于"预录播放"。

**这段话是防守性的，必须加。** 否则评委翻代码时容易误判。

---

## 三、💡 P1 建议（提升印象分）

### P1-1：补一张"赛题要求 ↔ 实现 ↔ 证据"对照总表

评委审阅时最想看这个。建议放在**第一章末尾**（1.5 之后）或作为附录 A：

| 赛题要求 | 我们的实现 | 证据位置 |
|---|---|---|
| 基础①≥2 独立可控演奏维度 | 触控/MIDI/机械键/光电/ToF，共 5 类输入，≥3 个独立可控维度 | 2.2 节 + `hw_input_mgr.v` |
| 基础②纯硬件 ≤10 ms | 3.85 μs（控制到首样本） | 4.3 节 |
| 基础③复音 ≥4 + ADSR + 变调 | 32 声部 + 完整 ADSR + 滑音/颤音 | 2.3/2.4 节 |
| 拓展①复音 ≥32 | **32 声部 × 6 泛音 = 192 振荡器** | 2.3 节 |
| 拓展②≥3 维表情 | 力度/滑音/颤音/延音 ≥4 维 | 2.4 节 |
| 拓展②≥2 音色切换 | 4 音色（钢琴/吉他/小提琴/二胡） | 1.2 节 |
| 拓展②硬件混响/延迟/合唱 | Echo/Chorus/Reverb/Overdrive/Cab 五支路 | 3.3 节 |
| 拓展③延迟 ≤5 ms | P50 15.4 μs / Max 20.5 μs | 4.3 节 |
| 拓展③硬件可视化 | 800×480 四页 UI（波形/32 段频谱/李萨如/曲谱） | 2.6 节 |
| **必备：32 谱峰测试模式** | 200 Hz 起、间隔 200 Hz、32 路，FFT 检出 32/32 | 4.1 节 |

### P1-2：把"创新点"明确提炼成 3 条

现在 1.3 节叫「主要技术特点」，但评委习惯找"创新点"。建议在 1.3 开头加一句"本作品的创新点主要体现在以下三方面"，然后：

1. **32 声部 × 6 独立泛音分量的高密度振荡器架构**——单板实现 192 个具备完整三件套的硬件振荡器，吞吐量 1.875×10⁷ 振荡器·Hz
2. **统一事件总线承载五种异构输入**——触控、MIDI、机械键、光电拨弦、ToF 测距在同一事件总线内同步，新增输入形态无需改动合成侧
3. **FPGA 内部完成的仪器化人机界面**——800×480 四页 UI（示波器/32 段频谱/李萨如/曲谱）全部由 HDL 生成，不依赖 CPU 或外挂 GPU

### P1-3：补"测试模式操作步骤"

现场验证是**评委自己动手**，需要一份傻瓜式步骤：

```
1. 上电 → 屏幕显示主页
2. 触控点击底部导航栏「测试」页（或发送 MIDI CC 28 = 1）
3. 观察屏幕：32 段频谱全部点亮，每段中心频率标注
4. 用手机/频谱仪在 3.5 mm 耳机口取样 → 应看到 200Hz 起步、200Hz 间隔的 32 根谱线
5. 预期：32 根谱线强度差 < 1 dB，无杂散
```

### P1-4：图表偏少

现在 5 张图（图 1–5）。国一/国二文档普遍 20+ 张。**时间不够的话，优先补这 3 张**：

1. **系统架构框图**（输入层→事件层→合成层→效果层→输出层/显示层）← 最重要，2.1 节文字已描述，画成图即可
2. **RTL 模块层次树**（top → piano_engine_tdm32 → poly32_bank/adsr/tone_bank）
3. **32 谱峰 FFT 实测截图**（现在只有文字结论，没有图）

---

## 四、⛔ 红线检查（写文档时绝不能出现的话）

| 绝对不能写 | 为什么 | 应该怎么写 |
|---|---|---|
| "播放"、"回放"、"预置音色音频" | 触发赛题"严禁播放预录 PCM"红线联想 | 用"合成"、"实时生成"、"逐样本计算" |
| "音色采样"、"采样音频" | 同上 | 用"音色参数表"、"谐波系数表" |
| "CPU 合成"、"软件合成"、"Python 计算音频" | 赛题禁止 CPU 参与音频算法 | 用"CPU 仅承担参数配置与 UI" |
| "近似"、"约等于" 用在关键指标上 | 评委要看精确值 | 写精确值 + 来源（`97 656.25 Hz（50 MHz / 512）`） |
| 任何没绑版本指纹的性能数据 | 项目证据纪律 | 数据后必须跟位流指纹或报告位置 |

**你现在文档里这些都做得对**（我看到"不使用 CPU 或软核承担音频算法，也不播放 PCM、WAV 或整段录音"），继续保持。

---

## 五、优先级建议（只剩约 46 小时）

| 优先级 | 任务 | 预估耗时 |
|---|---|---|
| **P0-1** | 修章节顺序（2.6 移位） | 10 分钟 |
| **P0-2** | 补 192 振荡器三层论证 | **1.5–2 小时**（最重要） |
| **P0-3** | 补 ROM 澄清表 + 论证段 | 40 分钟 |
| P1-1 | 赛题要求对照总表 | 40 分钟 |
| P1-2 | 提炼 3 条创新点 | 30 分钟 |
| P1-3 | 测试模式操作步骤 | 20 分钟 |
| P1-4 | 补 3 张图 | 1.5 小时（如果时间允许） |

**总估时：约 5 小时。**

**建议顺序：P0-1 → P0-2 → P0-3 → P1-1 → P1-2 → P1-3 → 有余力再 P1-4。**

---

## 六、执行方式建议

你现在有 `_doc_work/build_report.py`（26 KB）在做生成，**不要手动改 docx**，继续用脚本生成，这样可复现、可回滚。

**步骤**：
1. 改 `build_report.py` 里的内容（P0-1 是调段落顺序，P0-2/P0-3 是加文本和表格）
2. 重新生成 docx
3. 用 LibreOffice 渲染 PDF 检查（你已经在做 `final-render4`）
4. 检查：中文字体是否有回退、表格是否溢出、章节编号是否连续

**注意**：`build_report.py` 里如果章节是硬编码顺序，改顺序时要同时检查是否有交叉引用写死了"见 2.6 节"之类。

---

## 七、还有一件事：这个文档要有人读一遍

生成的 docx 请**至少让陈科翰本人通读一遍**。原因：

- 有些表述只有他知道对不对（比如"5 首曲目"实际是哪 5 首、触控是否真的全功能可用）
- 现场演示时评委问的问题，文档里得有答案
- AI 生成的文档容易"数据对但表述拧"，人读一遍能发现

---

**以上。P0-2 是关键，别省时间在那上面。**
