wongben2333-crypto/26Embedded/fpga_hank/docs/预先构建的位流.md

# 位流速查表（三个模式）

> ⚠️ **本文档 2026-10-05 重写**。旧版用的是已废弃的参数名 `TEST_MODE = 0/1` 与**磁盘上已不存在的位流文件名**，
> 照旧版走会一路找不到文件。**现在以本文档 + [../README.md](../README.md) §2 为准。**

---

## 1. 三个模式与对应位流

| MODE | 位流文件 | 大小 (B) | `sha256`(前16) | **`User Code`** | 按键操作 | 应该听到什么 |
|---|---|---|---|---|---|---|
| **0** | `MODE0_演示模式_放歌.fs` | **38 814 719** | **`8C6A0208320009F8`** | **`0x0000C7B0`** | **按键1**(`AB13`)=播放/停止；**按键2**(`Y12`)=切歌 | **音乐** |
| **1** | `MODE1_电脑控制.fs` | **40 089 599** | **`DC5E68AAC44D364F`** | **`0x0000F2CB`** | 电脑跑 `host/piano_gui.py`（见 [../README.md](../README.md) §3） | **弹琴声** |
| **2** | `MODE2_测试模式_32谱峰.fs` | **34 840 489** | **`68F7FFD22A9B1B18`** | （重建版，见 §4） | **无需按键**（32 路恒发声） | **32 路正弦同时响 = 嗡嗡声** ⚠️ **这是取证声，不是故障** |

**⇒ 完整指纹（含证据强度）见 [BITSTREAM-FINGERPRINTS.md](BITSTREAM-FINGERPRINTS.md)。**

### ⚠️ 位流文件名里的编号 = `rtl/top.v` 的 `MODE` 参数值
（**以前两套编号不一致导致烧错位流**，现已统一；历史位流统一加了 `OLD_` 前缀。）

---

## 2. 🔴 **位流不进版本库 —— 你要自己构建**
`fpga_hank/out/` **整目录被 gitignore**（双判据实测：`git check-ignore --no-index` = IGNORED、`git ls-files fpga_hank/out/*` = **0**）。
**⇒ 队友克隆后【没有任何位流】。** 完整构建步骤见 [../README.md](../README.md) §2.1，要点：

```powershell
cd fpga_hank
# ① 改模式：编辑 rtl/top.v 第 40 行的 MODE 参数（0=放歌  1=电脑钢琴  2=32峰测试）
# ② 构建
& "F:\Gowin\Gowin_V1.9.12.04_x64\IDE\bin\gw_sh.exe" "tools\gowin\build.tcl"
# ③ 产物（★ 每次构建都会覆盖同名文件）
#      eda_proj\fpga_hank\impl\pnr\fpga_hank.fs
# ④ ★★ 立刻归档，否则下次构建就把它覆盖了
Copy-Item eda_proj\fpga_hank\impl\pnr\fpga_hank.fs `
          out\bitstream\MODE1_电脑控制.fs -Force
```

---

## 3. 烧录（**命令的确切用法**）

```powershell
# 三个模式都是同一条命令，只换 -Fs 指向的文件
powershell -NoProfile -ExecutionPolicy Bypass -File tools\gowin\program.ps1 -Mode sram `
    -Fs out\bitstream\MODE1_电脑控制.fs
```

### ⚠️ 三个必须知道的点
1. **脚本参数是 `-Mode`，没有 `-Op`**。
   `op 2` 是**脚本内部**传给 `programmer_cli` 的：`-Mode sram` → `op 2`（L176）、`-Mode flash` → `op 9`（L181）。
   **写 `-Op 2` 会直接报"找不到参数"。**
2. **别用操作码 4**（"SRAM Program **and Verify**"）。
   脚本源码注释实测记录：**本板（Tang Mega 138K + 板载 FT2232H）的【回读校验通路不可用】**，
   用 op 4 **必然报 `Error: Verify failed of at 0`**，**但位流其实已经正确写入**。
   ⇒ **这是假失败**，Sipeed 官方文档用的也正是**不带 Verify 的操作码 2**；耗时也从 ~106 s 降到 ~21 s。
3. **第一次上板一律用 `-Mode sram`**（易失、掉电即丢、**不动 Flash**），确认无误再考虑 `-Mode flash`。

| `-Mode` | 内部操作码 | 作用 |
|---|---|---|
| `scan` | — | 只扫描，确认缆线与器件被识别 |
| **`sram`**（默认） | **2** | **SRAM Program，易失** ⇒ 反复调试用这个 |
| `verify` | 2 + `--svfcreate` | **不需要板子**！解析位流并生成 JTAG 向量文件 |
| `flash` | **68** | **exFlash Erase,Program thru GAO-Bridge Arora V**（**会改写板上 Flash**，上电自动运行）|

---

## 4. ⚠️ 关于位流哈希与 `User Code`（**重要，别误判**）

### 4.1 **不要用 `.fs` 的 SHA256 判断"两个位流是不是同一版设计"**
实测：**同一份 RTL 连续构建两次，哈希就不同**（高云的时序驱动 P&R **是非确定性的**）。
**⇒ 判断修订要哈希【RTL 源码】，不是位流。** 详见 [../README.md](../README.md) 附录 B。

### 4.2 **`User Code` 也不是设计标识，而是【逐次构建的随机量】**
实测证据：
- `tools/gowin/program.ps1` 自己注释里记着**同模式的另外两个值**（测试模式 `0x0000A86D`、演奏模式 `0x00005093`）
- 后来构建的同类模式得到 `0x0000BB21` / `0x0000C7B0` ⇒ **同模式、不同次构建，值不同**
- `build.tcl` / `*.gprj` / `*.gprj.user` 里**都没有 `user_code` 设置**

**⇒ 它唯一可靠的用途**：烧录当场确认"我烧的就是我要烧的那个文件"（配合大小 / sha256）。
**⇒ 不能用它核对"重建结果是否等于历史产物"。**

### 4.3 ⚠️ **MODE=2 的原证据版位流已丢失**
`MODE2`（赛题必备交付物）**原来那份位流**（`User Code 0x0000BB21`）**没有归档**，
被后续构建覆盖了（工程里的 `impl/pnr/fpga_hank.fs` 每次构建都覆盖，而**没有自动归档脚本**）。
**⇒ 现在有的是【重建版】**（`68F7FFD22A9B1B18` / 18:37:18），
**两者不是同一份文件**（P&R 非确定性 + User Code 随机），**但 MODE=2 的 RTL 未变 ⇒ 功能等价**。

> ✅ **已批准、待实现的修法**：给 `build.tcl` 加**自动归档**（见 [../README.md](../README.md) §7）。
> **⇒ 在它实现之前，请务必【手动归档】**（见本文档 §2 第 ④ 步）。

---

## 5. 三个模式的构建结果（实测）

| 项 | MODE=2 重建版 | 说明 |
|---|---|---|
| 位流大小 | **34 840 489 B** | |
| Logic | **4 160** / 138 240（3%） | |
| Register | **1 602** | |
| BSRAM | **1** / 340 | 时分查表共用一份 ROM |
| DSP | **58** / 298 | |
| **时序违例** | **Setup 0 / Hold 0** ✅ | |

**历史数据**（旧 `TEST_MODE` 命名时期的两次构建，仅供参考）：
| 项 | 演奏模式 | 测试模式 |
|---|---|---|
| Logic | 5 986 | 5 920 |
| Register | 1 745 | 1 699 |
| 时序违例 | 0 / 0 | 0 / 0 |
| 引脚 constrained | 12 / 12 | 12 / 12 |

**差异说明**：演奏模式多出 **66 LUT + 46 FF** —— 那是三个按键的**两级同步器 + 去抖计数器**
（测试模式下按键不参与 gate，会被优化掉）。其余资源相同 ⇒ **各模式共用同一条音频通路**。
