wongben2333-crypto/26Embedded/fpga_hank/pcb/README-怎么打开.md

# 怎么打开这些 PCB 工程（傻瓜版）

> 给用户看的。**不需要懂任何技术**，照做即可。

---

## 一、先手动启动立创EDA（**重要**）

**不要双击工程文件**，先启动软件：

1. 点 **开始菜单** → 找到 **嘉立创EDA(专业版)** → 点开
2. **等它完全打开**（第一次可能要登录账号）
3. ⚠️ 如果它开了一下就自己关了 —— **那是它需要你先登录**，登录后再来一次

> 背景：我们试过用命令直接启动它，**12 秒后进程自己消失了**（没有报错日志）。
> 这通常是**单实例锁**或**需要登录**。所以请**手动从开始菜单启动**。

---

## 二、用软件打开工程

软件打开后：

1. 左上角 **文件** → **打开** → **工程**
   （有的版本是 **文件 → 打开工程**）
2. 在弹出的框里，**定位到**：
   ```
   C:\Users\Danny\Desktop\FPGA competition\fpga_hank\pcb\minimal\
   ```
3. **先选 `V1_outline` 这个文件夹**，点确定

**如果 V1 能打开** ⇒ 再打开 `V2_outline_pad`（这个多一个焊盘）

---

## 三、⚠️ 如果你打开的是 `project.json`

**看到一串代码 = 正常的，那不是"坏文件"。**
`project.json` 是给**软件**读的索引文件，不是给人看的。

**⇒ 正确做法是"用立创EDA 打开这个文件夹"，而不是双击 `project.json`。**

---

## 四、打开后你应该看到什么

| 工程 | 应该看到 |
|---|---|
| **V1_outline** | 一块 **40 × 30 毫米的空白方板**（只有板框） |
| **V2_outline_pad** | 同样的方板，中间多一个 **13 × 13 毫米的方形焊盘**，下面写着 `TOUCHPAD` |

**如果看到的和上面一致** ⇒ 说明"我们用程序生成的工程能被立创EDA 打开"这件事**验证成功**，
我们就可以开始画真正的钢琴键盘板了。

---

## 五、如果打不开 / 报错 / 什么都没有

**请把下面三件事随便记一件告诉我们就行**（不用懂原理）：

1. **有没有弹错误框？** 弹框里写的什么字（拍个照最好）
2. **软件里是空白、还是根本打不开？**
3. **板子有没有显示出来？显示成什么样子？**

有这些信息我们就能定位问题。**别自己反复试**，报给我们即可。

---

## 六、为什么会有这么多"版本"

我们用程序生成文件，而立创EDA 的历史上有**两代完全不同的文件格式**：

| 代号 | 长什么样 |
|---|---|
| **旧（V2）** | 文件里是 `["DOCTYPE","PCB","1.7"]` 这种**方括号数组** |
| **新（V3）** | 文件里是 `{"type":"DOCHEAD",...}\|\|{...}\|` 这种**带 `type` 的对象** |

**你电脑上现成的那个"有源滤波器"工程是旧格式**，我们第一版"照着它做"的也是旧格式。
**如果立创EDA 只认新格式，我们就得改成新格式重做** —— 这正是要靠你这次试打开来确认的事。

我们已经把**官方的新格式规范**（嘉立创官方 GitHub）下载并读完了，
**所以不管结果如何，我们都有下一手。**
