wongben2333-crypto/26Embedded/fpga_hank/docs/waveforms/注意-本目录是脚本自绘图.md

# 注意：本目录里剩下的 PNG 是【脚本自绘图】，不是工具原图

用户已明确否决「我们自己画图当证据」：

> 「**你不要这样生成，直接截屏你用我电脑上 modelsim 跑出来的结果……不要自己绘图，可能自己骗自己**」

## 当前状态

| 文件 | 谁产出 | 定性 |
|---|---|---|
| `1_pt8211_I2S时序.png` | 另一位 teammate（脚本渲染） | ⚠️ **不是工具原图，不应作为交付证据** |
| `2_ADSR包络曲线.png` | 同上 | ⚠️ 同上 |
| `3_32路混音与频谱.png` | 同上 | ⚠️ 同上 |
| `4_按键到包络因果链.png` | 同上 | ⚠️ 同上 |

> 我（`board-smoke`）自己脚本渲染的那 5 张（`pt8211_bit_order` / `adsr_attack_release` /
> `tone_bank_mix_32voice` / `key_to_env_causality` / `key_debounce_bounce`，含 SVG）
> **已按用户要求从本目录移走**，现在放在 `_smoke-test/matplotlib-drafts/`，只作内部参考。
> （这些文件曾由 commit `12af207` 提交过，需要旧版可从那里取；我不执行 `git checkout`。）
>
> 上面那 4 张中文命名的**不是我的文件**，我没有动 —— **请 Lead 决定是移走还是删除**。

## 该怎么出"真图"

走 ModelSim 原生窗口 + 用户 `Win+Shift+S`，见 **`fpga_hank/docs/波形截图-照做卡.md`**。
`.wlf` 数据集已生成在 `fpga_hank/sim/wlf/`，配套 `sim/wave_*.do` 五个"打开即完美"脚本。
