wongben2333-crypto/26Embedded/docs/figures/08_7寸LCD实机截屏_Page1示波界面_32频段FFT与李萨如图形.png

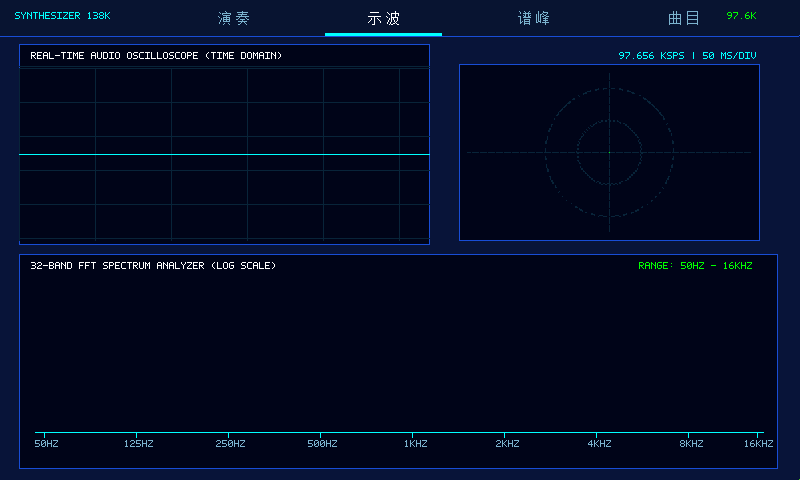
docs/figures/08_7寸LCD实机截屏_Page1示波界面_32频段FFT与李萨如图形.png
