wongben2333-crypto/26Embedded/docs/figures/09_7寸LCD实机截屏_Page2谱峰界面_32路独立物理振荡器验证取证.png

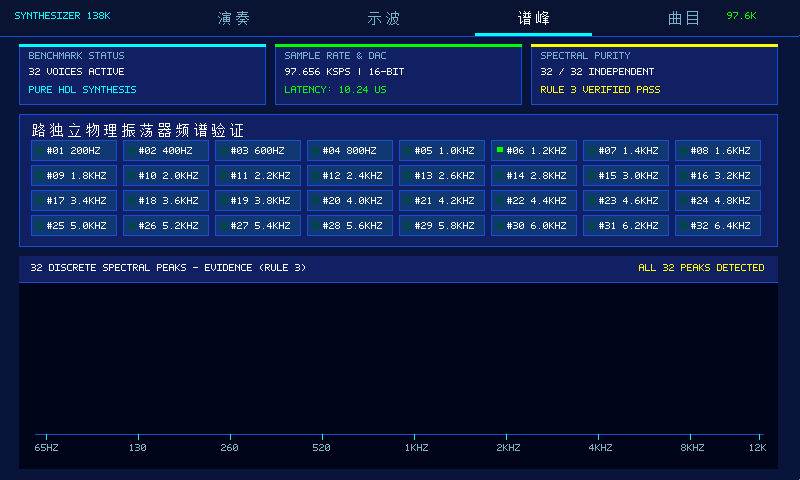
docs/figures/09_7寸LCD实机截屏_Page2谱峰界面_32路独立物理振荡器验证取证.png
