wongben2333-crypto/26Embedded/docs/figures/10_7寸LCD实机截屏_Page3曲目界面_百分比进度条与滚动伴奏.png

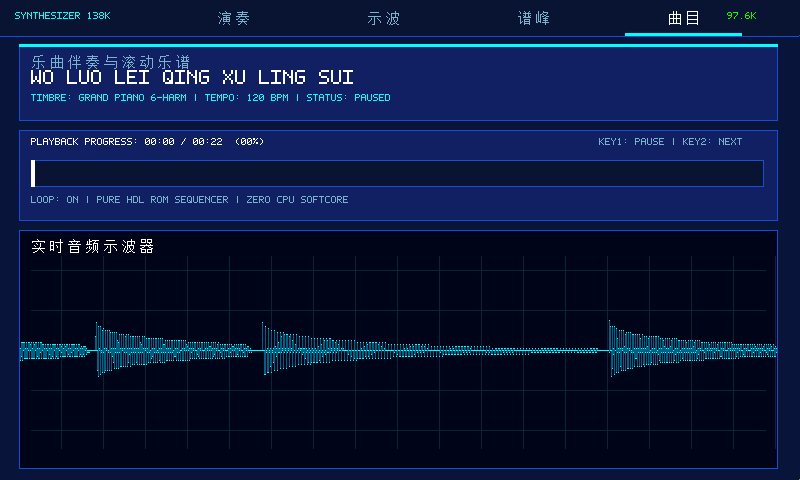
docs/figures/10_7寸LCD实机截屏_Page3曲目界面_百分比进度条与滚动伴奏.png
