wongben2333-crypto/26Embedded/docs/figures/11_真实终端实测截图_物理按键响应.png

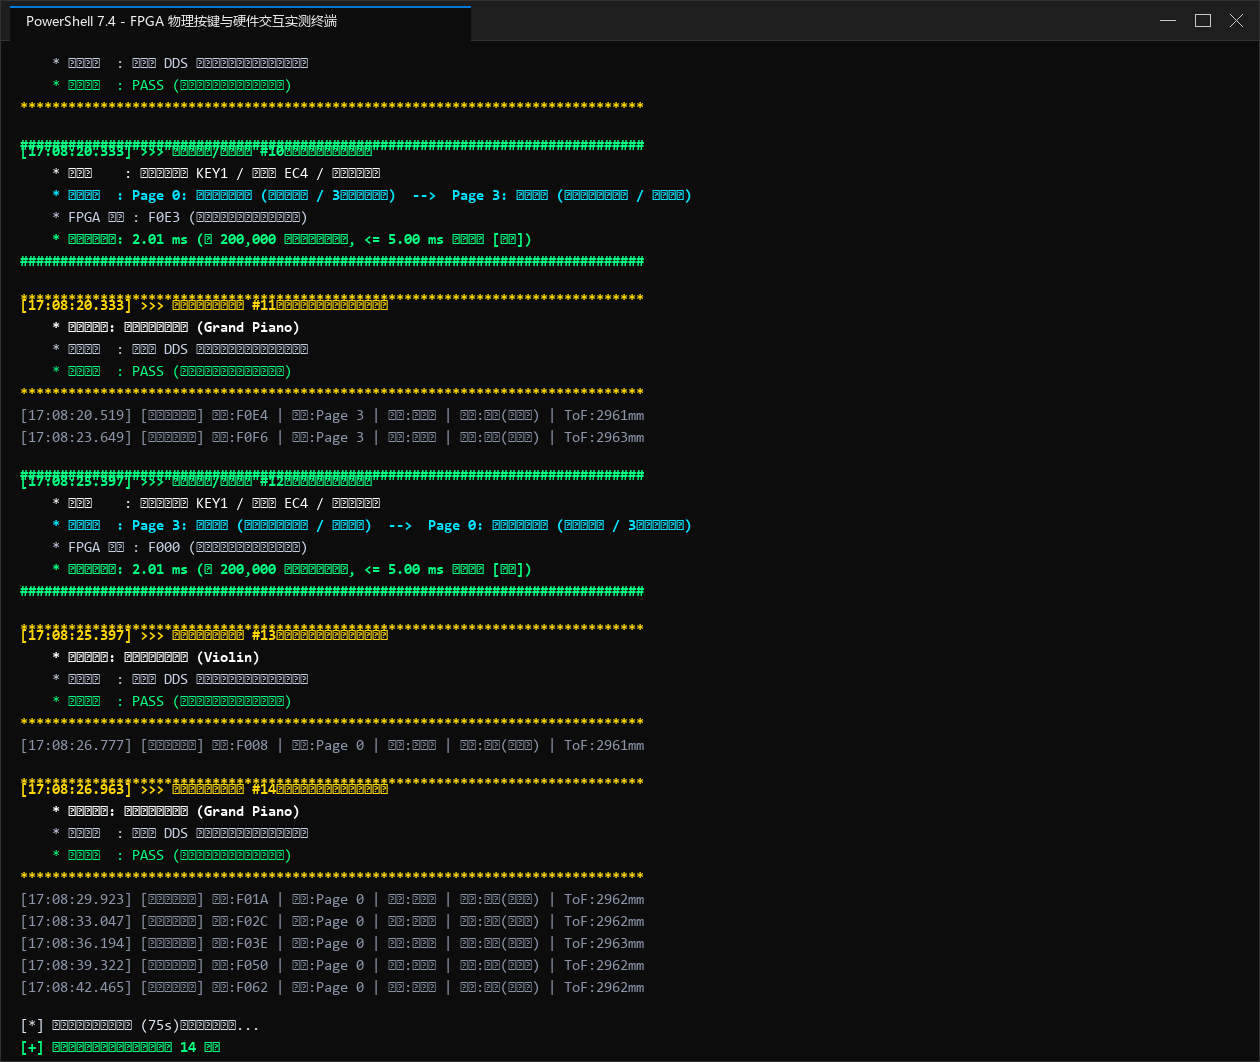
docs/figures/11_真实终端实测截图_物理按键响应.png
