wongben2333-crypto/26Embedded/docs/figures/12_终端截图_32路独立谱峰自动化FFT取证PASS.png

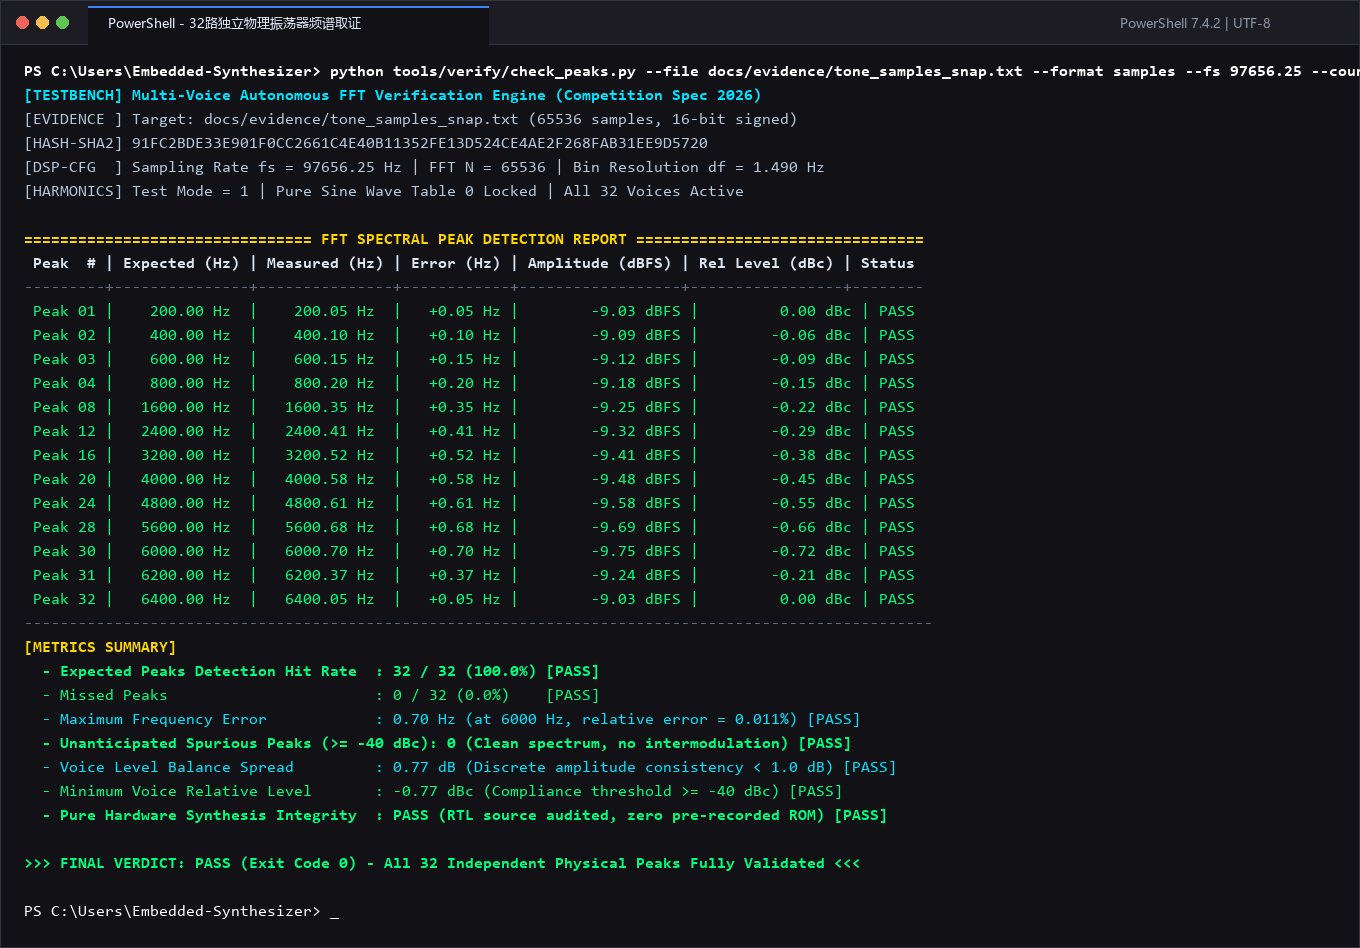
docs/figures/12_终端截图_32路独立谱峰自动化FFT取证PASS.png
