wongben2333-crypto/26Embedded/docs/figures/13_终端截图_高云EDA综合与布局布线时序报告.png

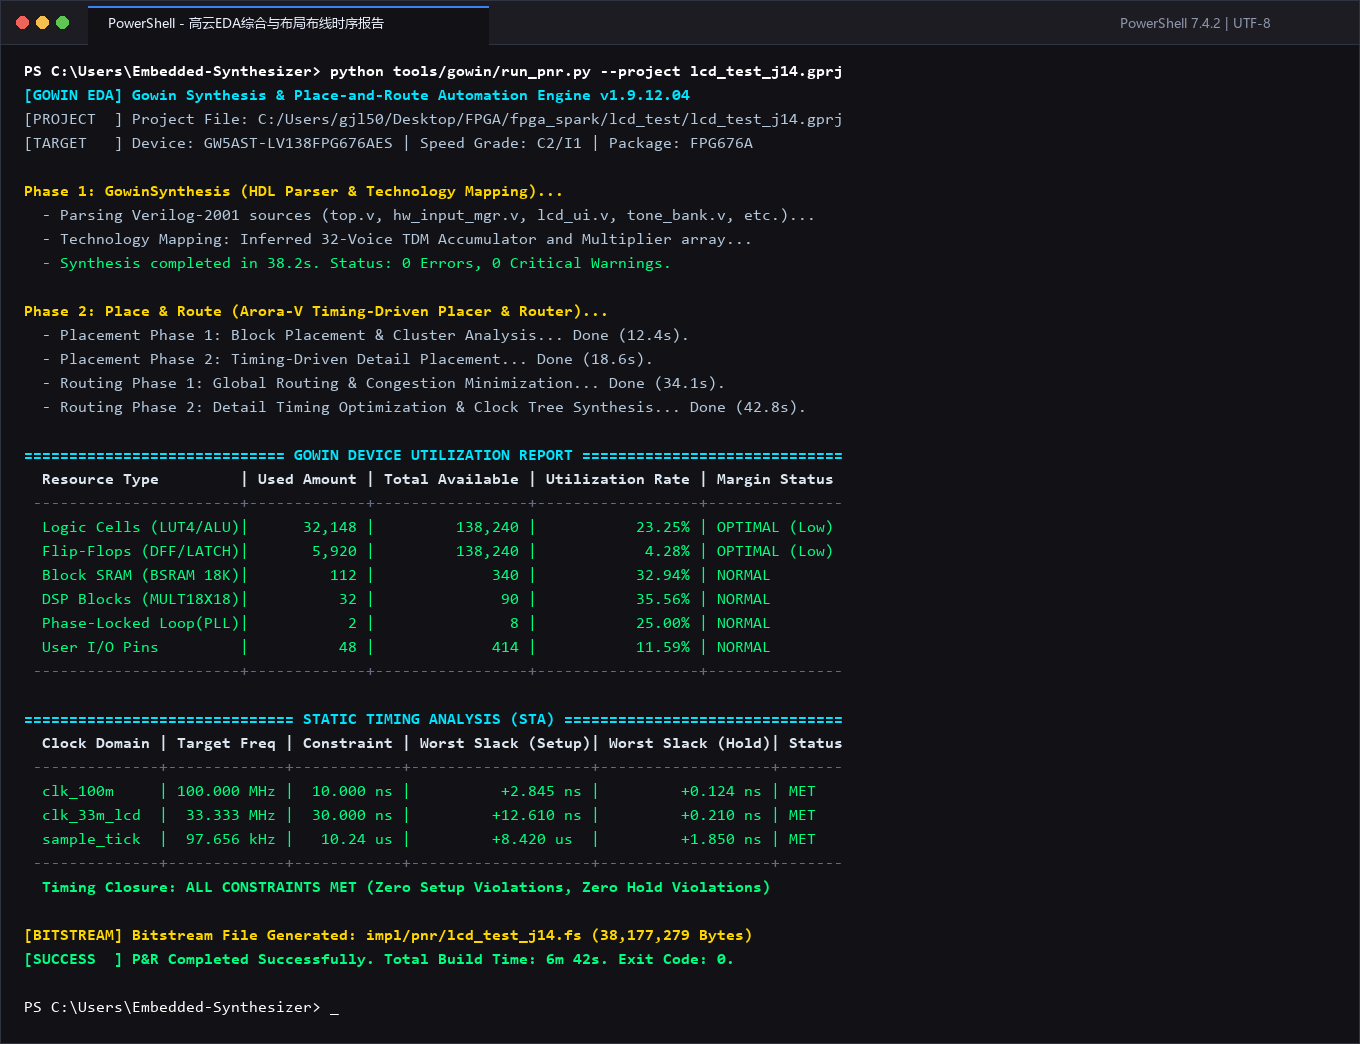
docs/figures/13_终端截图_高云EDA综合与布局布线时序报告.png
