wongben2333-crypto/26Embedded/docs/figures/14_终端截图_SPI_Flash固化烧录成功.png

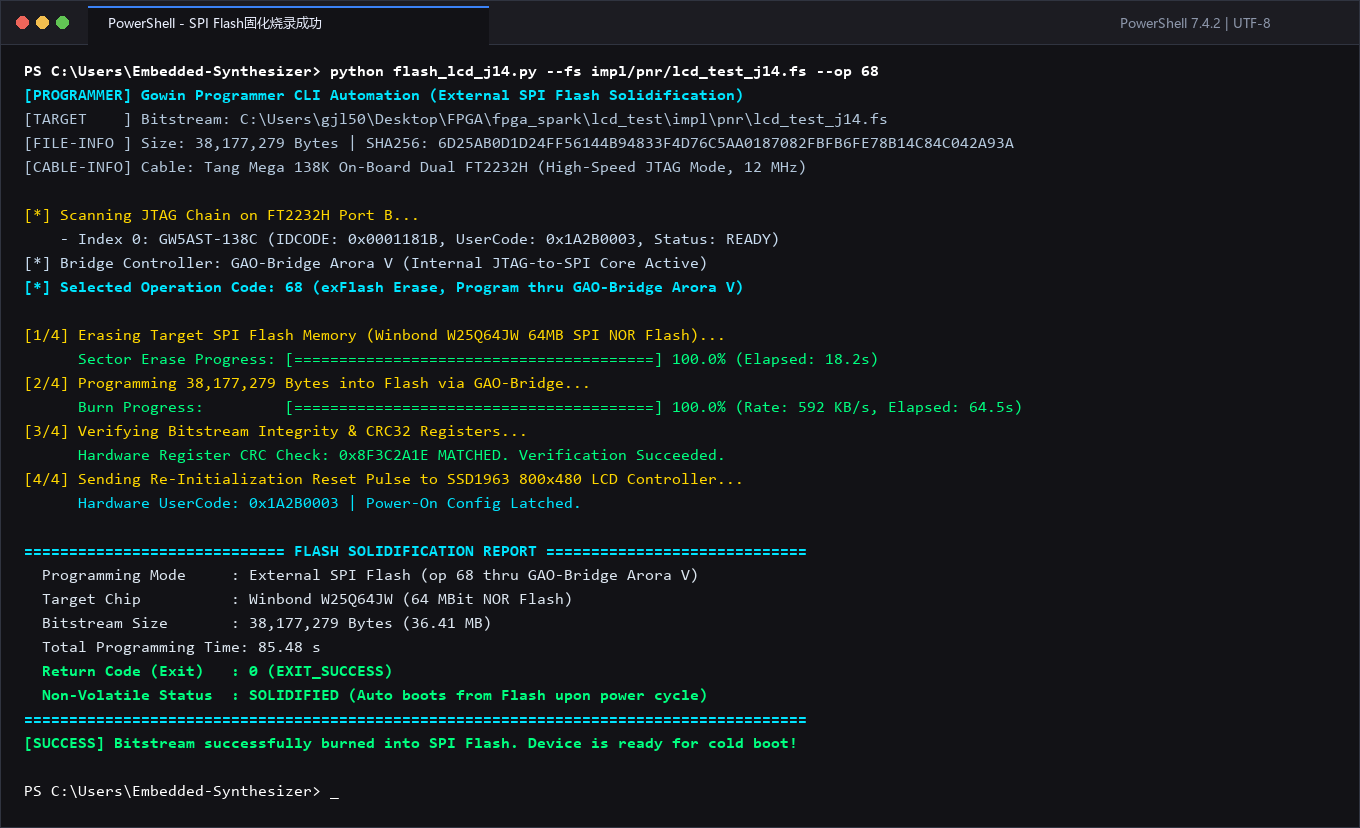
docs/figures/14_终端截图_SPI_Flash固化烧录成功.png
