wongben2333-crypto/26Embedded/docs/figures/pcb正面实拍.jpg

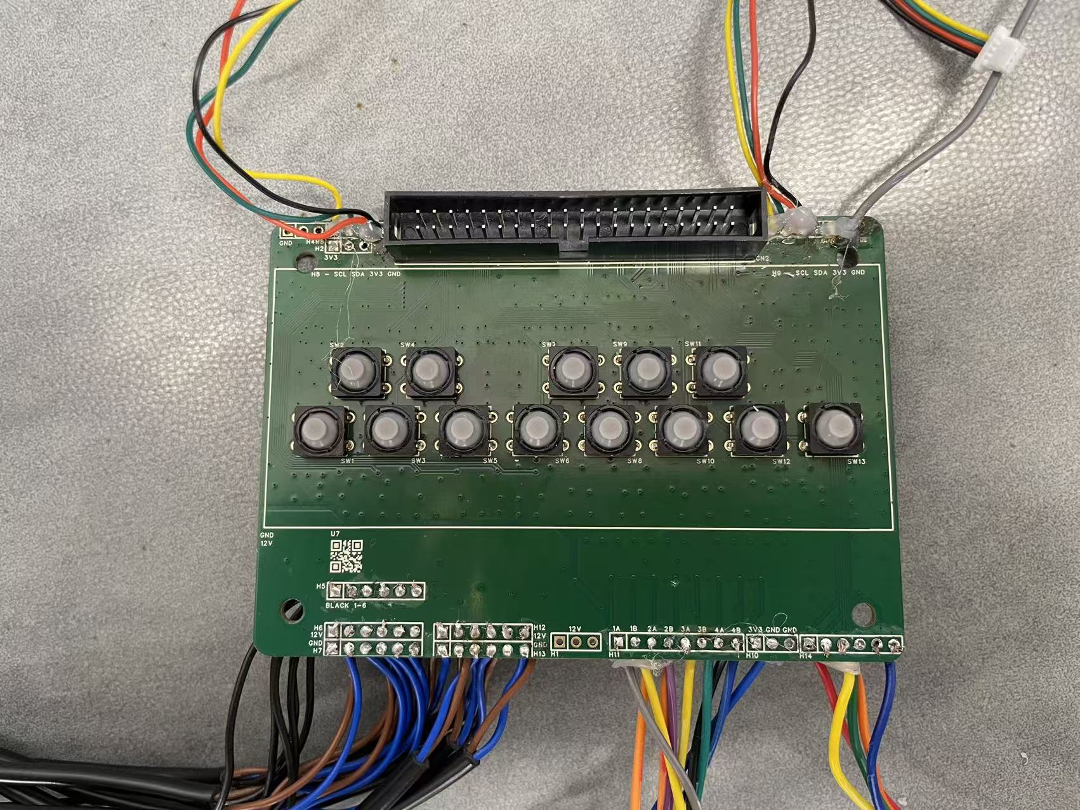
docs/figures/pcb正面实拍.jpg
