wongben2333-crypto/26Embedded/docs/figures/pcb背面实拍.jpg

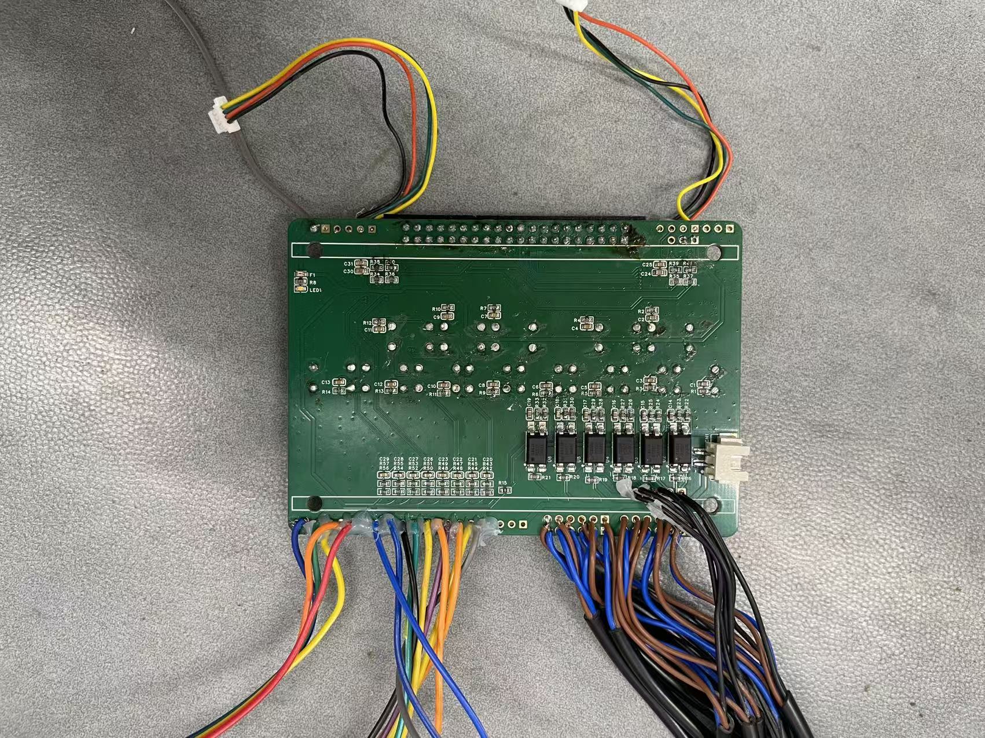
docs/figures/pcb背面实拍.jpg
