wongben2333-crypto/26Embedded/docs/figures/pcb背面裸板实拍.jpg

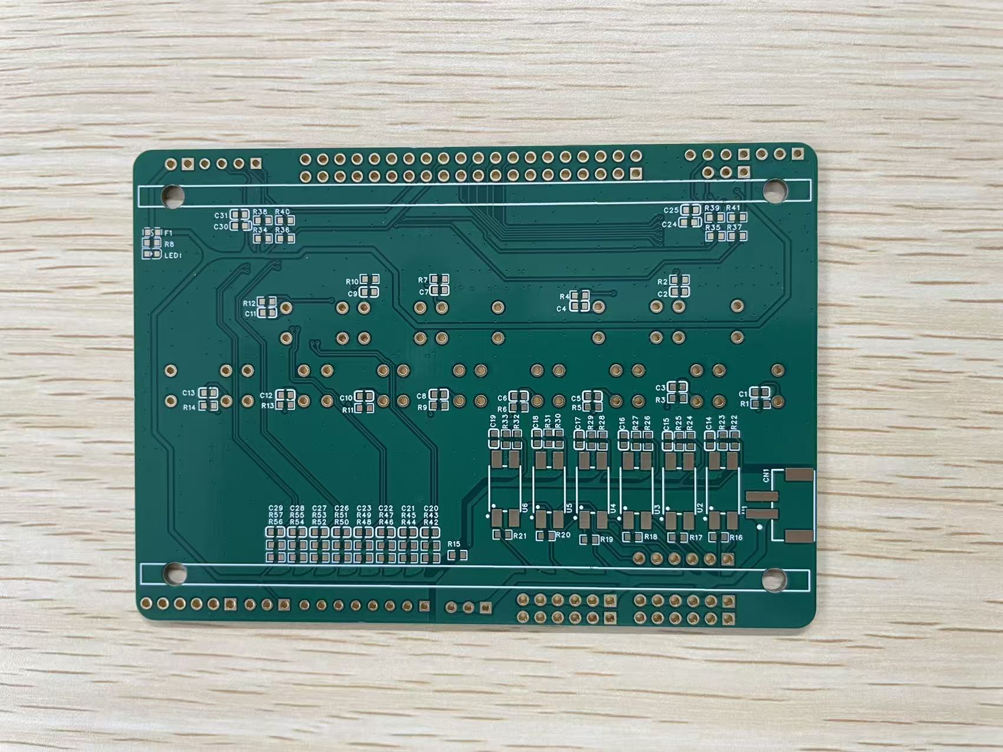
docs/figures/pcb背面裸板实拍.jpg
