wongben2333-crypto/26Embedded/fpga_ben/题目/2026嵌赛FPGA赛道-选题全景与选型建议-轻量版.png

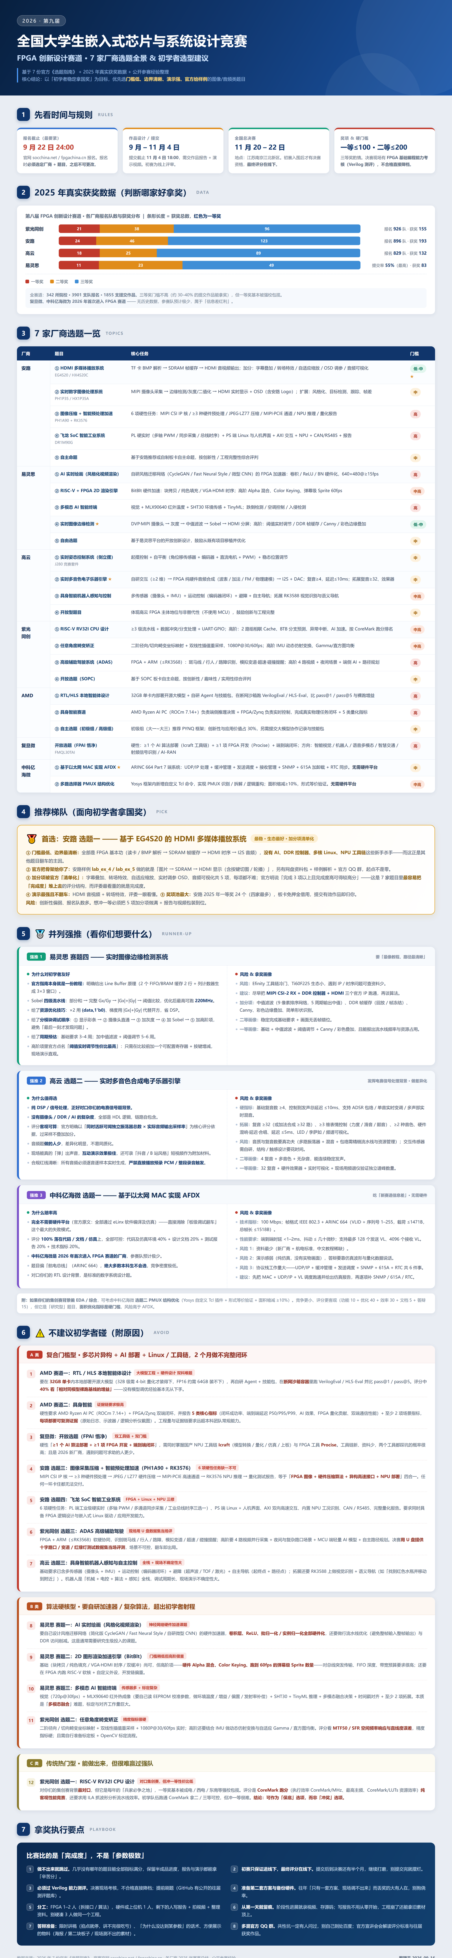
fpga_ben/题目/2026嵌赛FPGA赛道-选题全景与选型建议-轻量版.png
