wongben2333-crypto/26Embedded/fpga_ben/题目/选题对比-安路HDMI播放vs高云电子乐器-轻量版.png

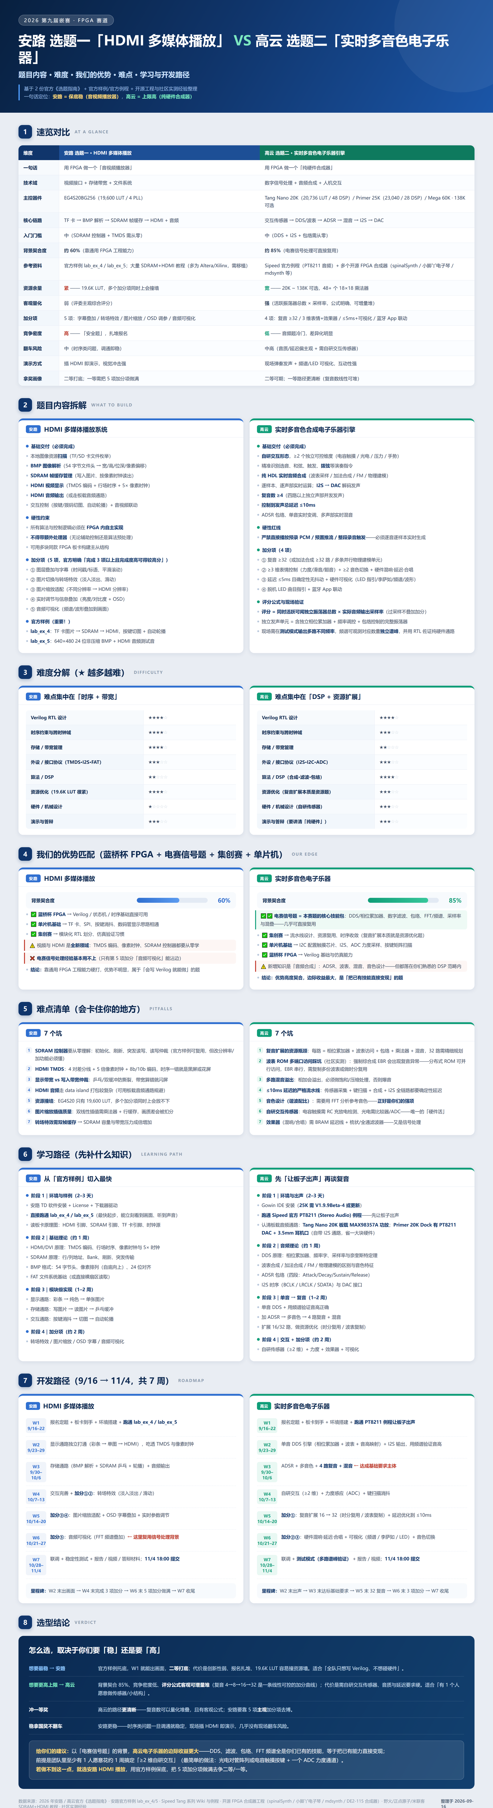
fpga_ben/题目/选题对比-安路HDMI播放vs高云电子乐器-轻量版.png
