wongben2333-crypto/26Embedded/fpga_ben/题目/高云选题二-赛题逐条精解-轻量版.png

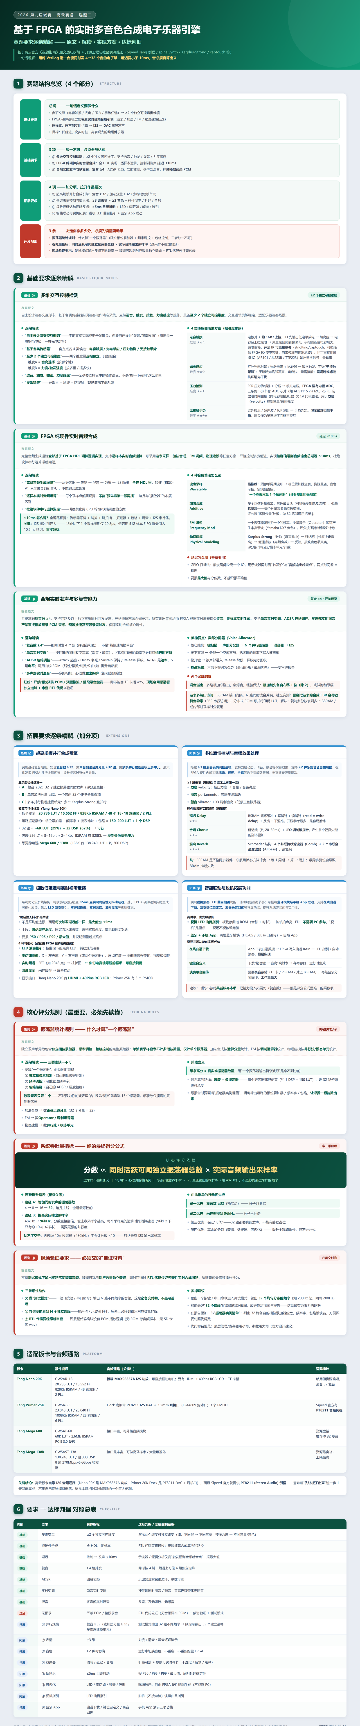
fpga_ben/题目/高云选题二-赛题逐条精解-轻量版.png
