wongben2333-crypto/26Embedded/fpga_hank/docs/ui_previews/host_ui_guitar.png

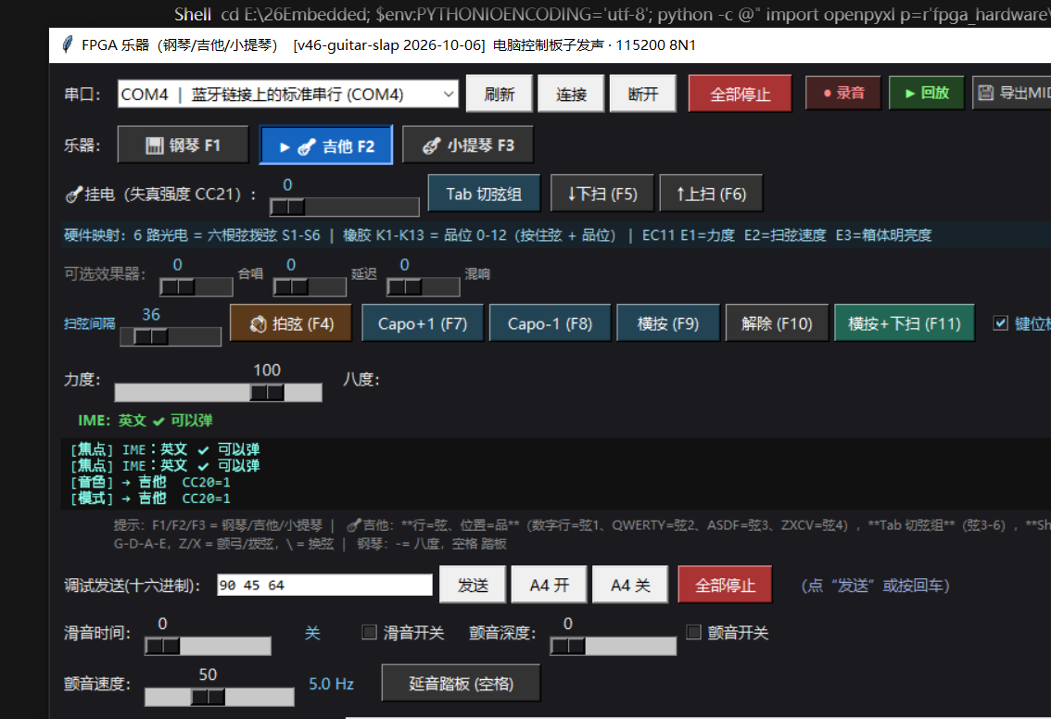
fpga_hank/docs/ui_previews/host_ui_guitar.png
