wongben2333-crypto/26Embedded/fpga_hank/docs/ui_previews/host_ui_piano.png

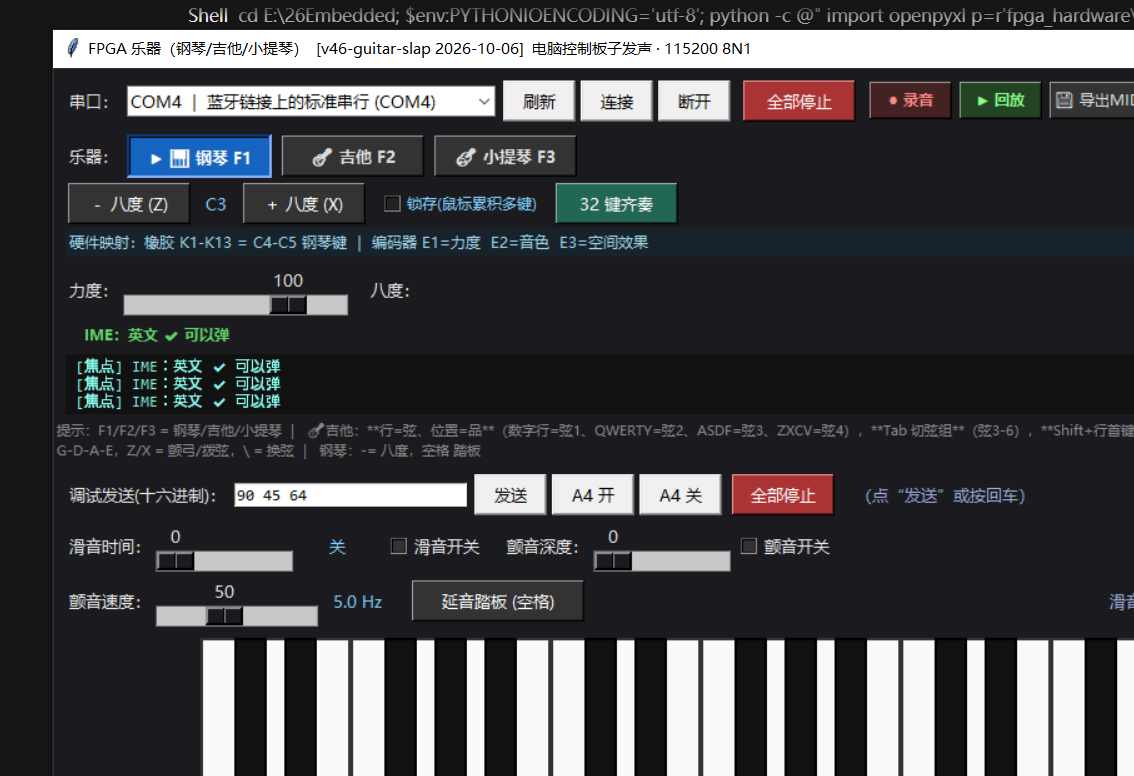
fpga_hank/docs/ui_previews/host_ui_piano.png
