wongben2333-crypto/26Embedded/fpga_hank/docs/ui_previews/ui_preview_0_piano.png

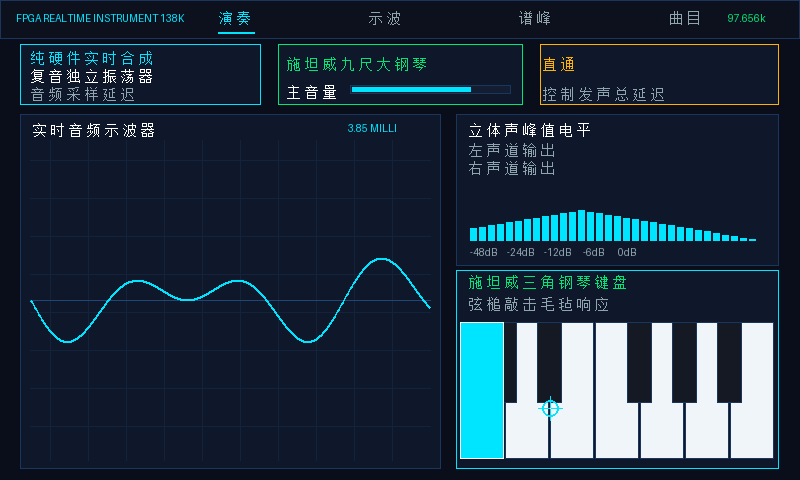
fpga_hank/docs/ui_previews/ui_preview_0_piano.png
