wongben2333-crypto/26Embedded/fpga_hank/docs/ui_previews/ui_preview_2_violin.png

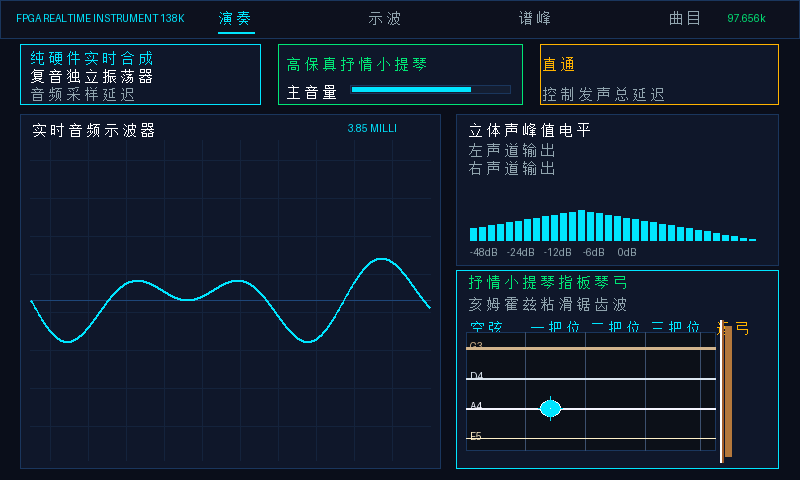
fpga_hank/docs/ui_previews/ui_preview_2_violin.png
