wongben2333-crypto/26Embedded/fpga_hank/docs/waveforms/real/3_tone_bank_32路混音.png

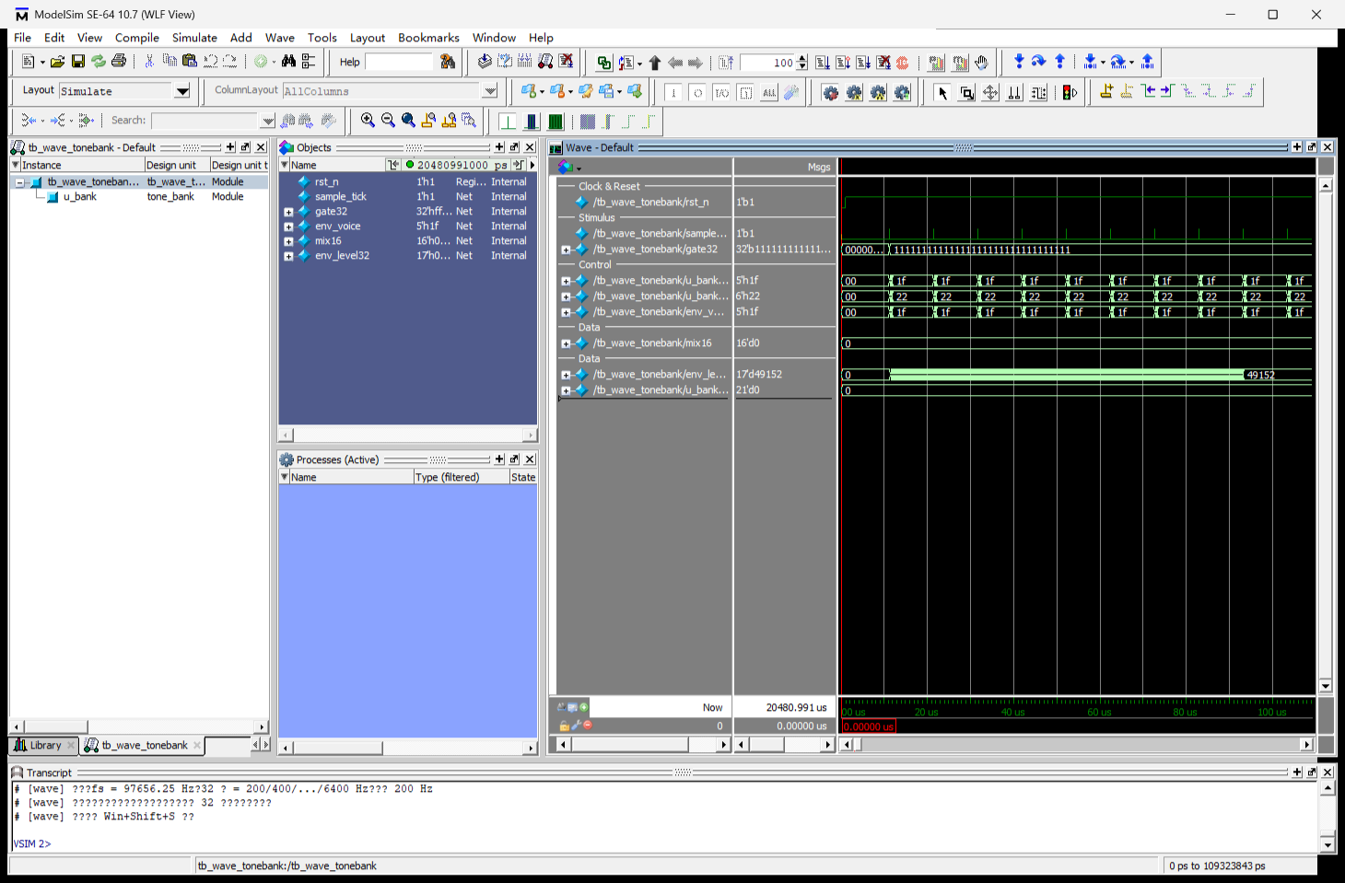
fpga_hank/docs/waveforms/real/3_tone_bank_32路混音.png
