wongben2333-crypto/26Embedded/fpga_hank/docs/waveforms/real/5_按键去抖_抖动边界用例.png

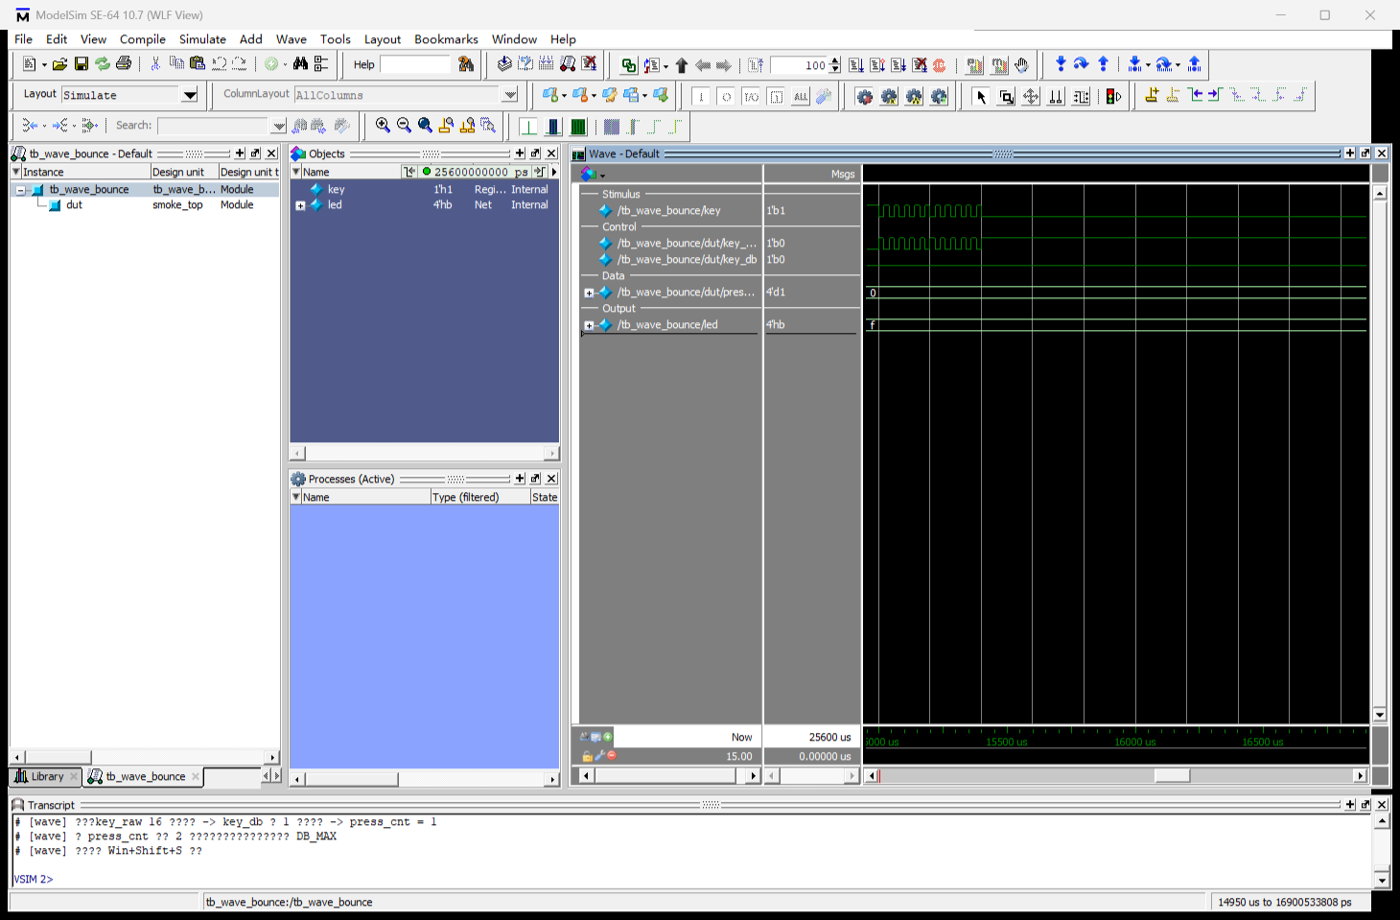
fpga_hank/docs/waveforms/real/5_按键去抖_抖动边界用例.png
