wongben2333-crypto/26Embedded/fpga_hank/pcb/minimal/preview_V1_outline.png

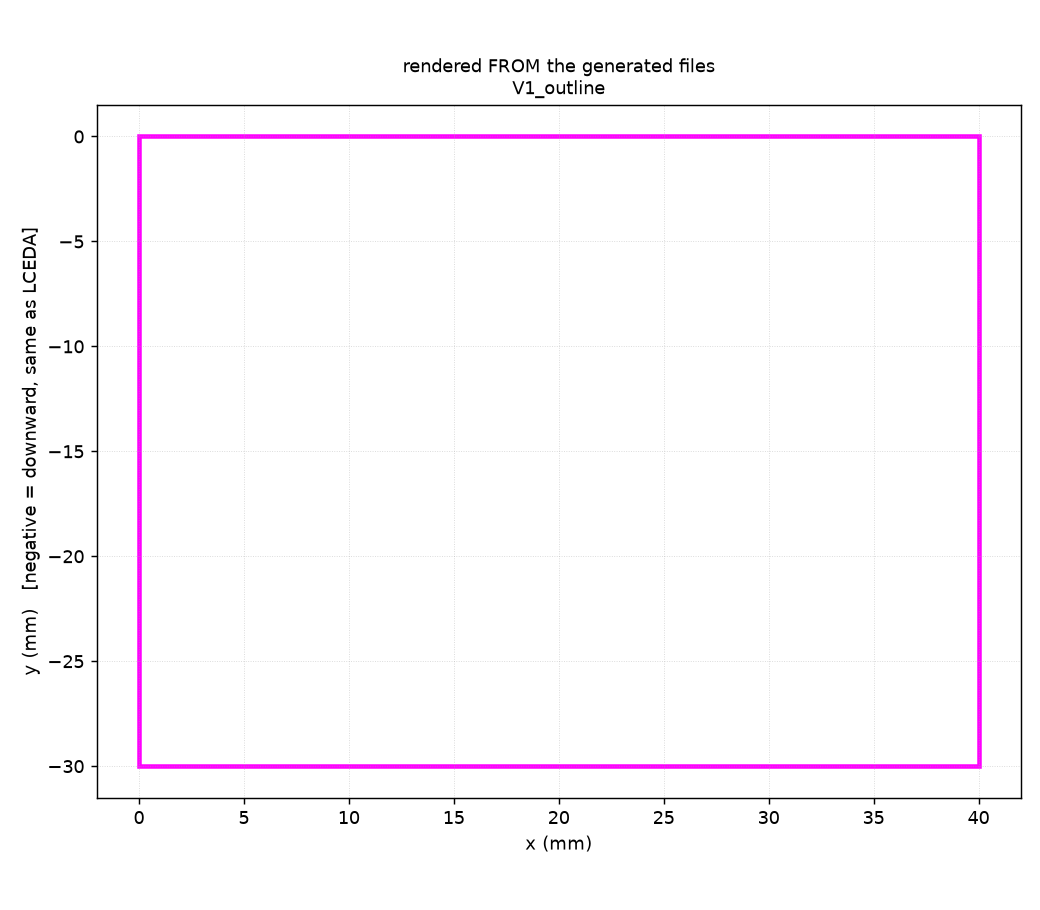
fpga_hank/pcb/minimal/preview_V1_outline.png
