wongben2333-crypto/26Embedded/fpga_spark/P34-P40转接板/board_cropped.png

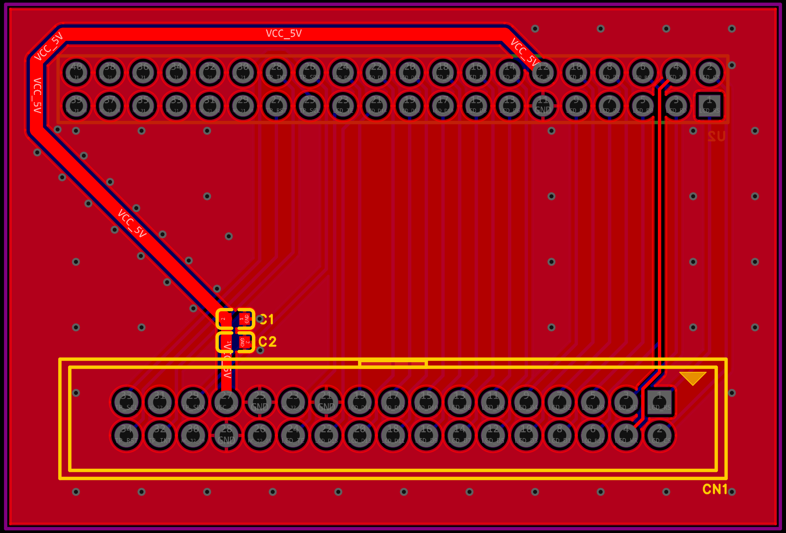
fpga_spark/P34-P40转接板/board_cropped.png
