wongben2333-crypto/26Embedded/fpga_spark/P34-P40转接板/hires_page_4.png

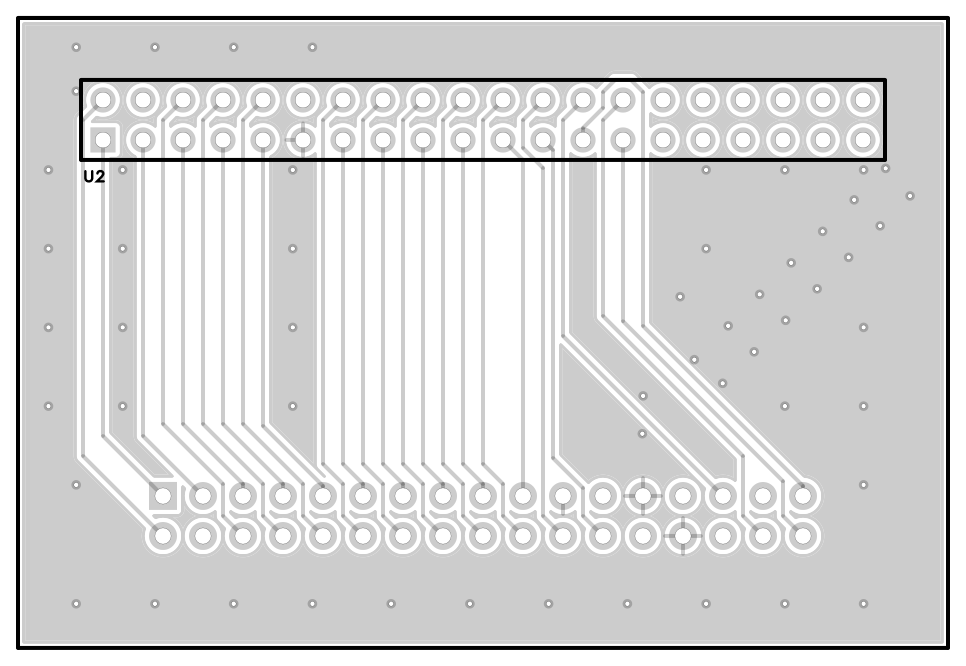
fpga_spark/P34-P40转接板/hires_page_4.png
