wongben2333-crypto/26Embedded/fpga_spark/P34-P40转接板/j5_crop.png

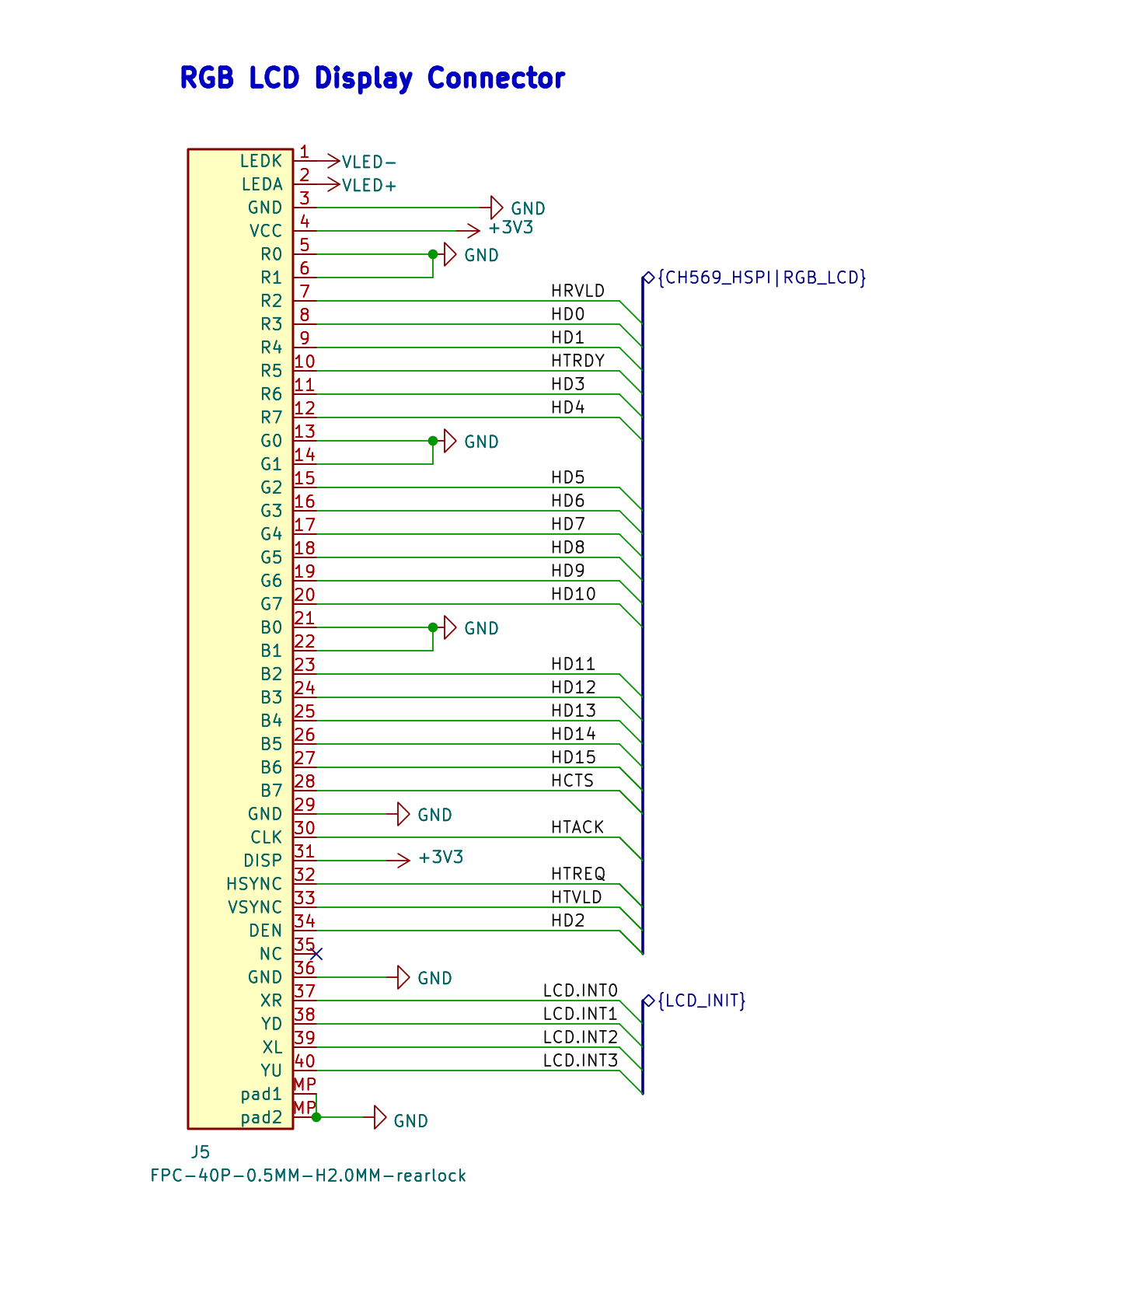
fpga_spark/P34-P40转接板/j5_crop.png
