wongben2333-crypto/26Embedded/fpga_spark/P34-P40转接板/PCB_PCB1_2026-10-24底层.png

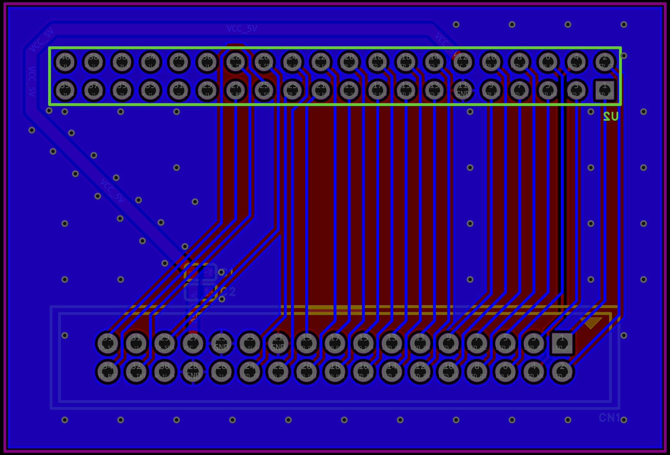
fpga_spark/P34-P40转接板/PCB_PCB1_2026-10-24底层.png
