wongben2333-crypto/26Embedded/fpga_spark/P34-P40转接板/pwr_led_crop.png

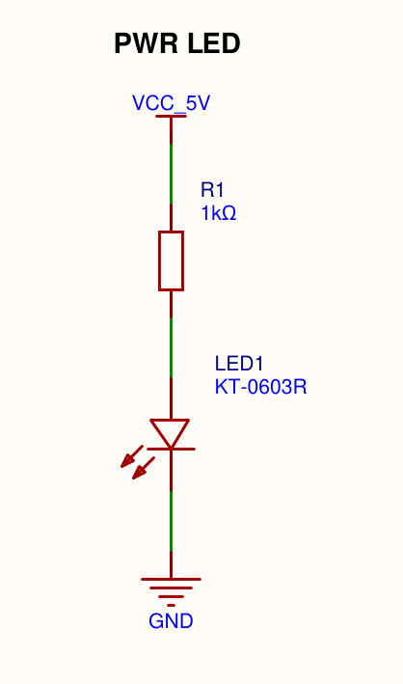
fpga_spark/P34-P40转接板/pwr_led_crop.png
