wongben2333-crypto/26Embedded/fpga_spark/P34-P40转接板/SCH_Schematic1_1-P1_2026-10-24.png

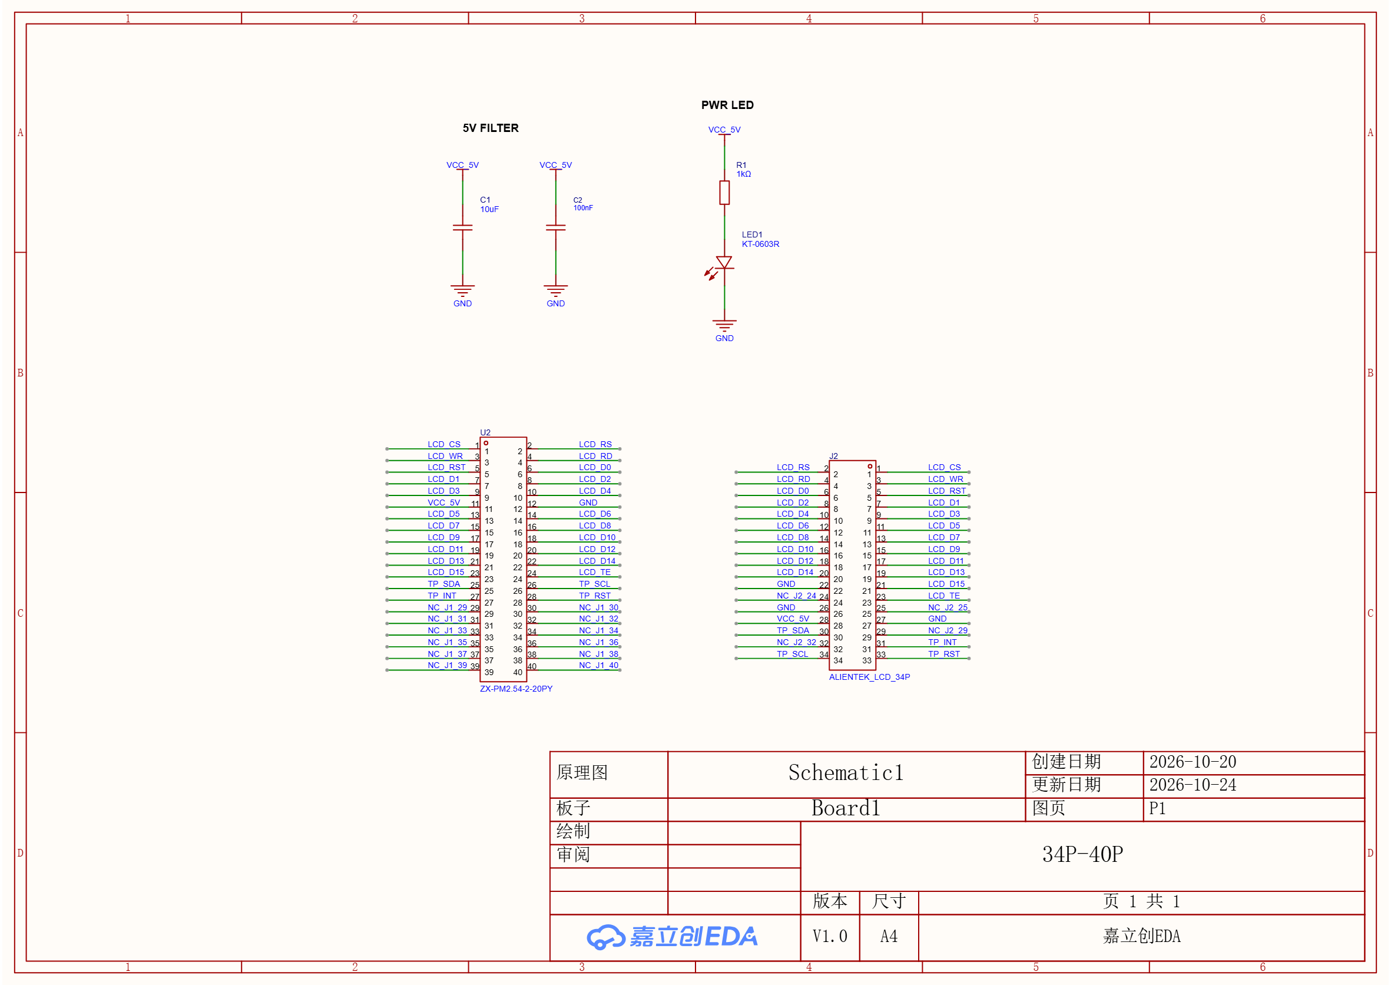
fpga_spark/P34-P40转接板/SCH_Schematic1_1-P1_2026-10-24.png
