wongben2333-crypto/26Embedded/fpga_spark/screenshot/screenshot_20261023_134750.png

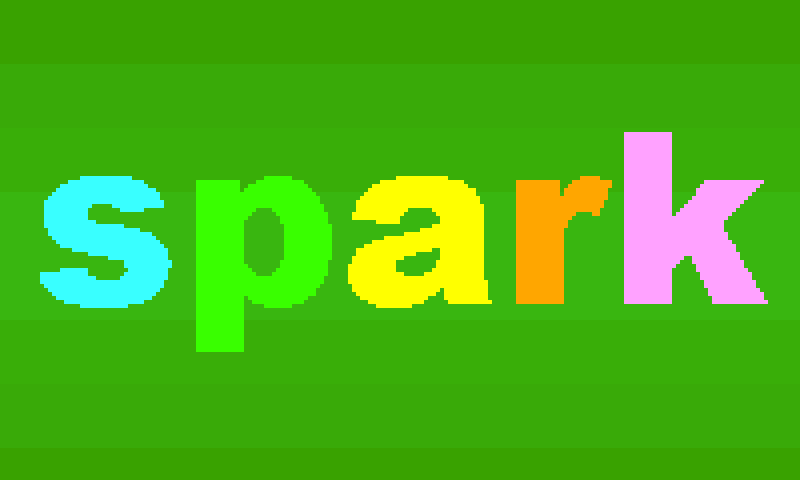
fpga_spark/screenshot/screenshot_20261023_134750.png
