wongben2333-crypto/26Embedded/fpga_spark/screenshot/screenshot_20261026_223338.png

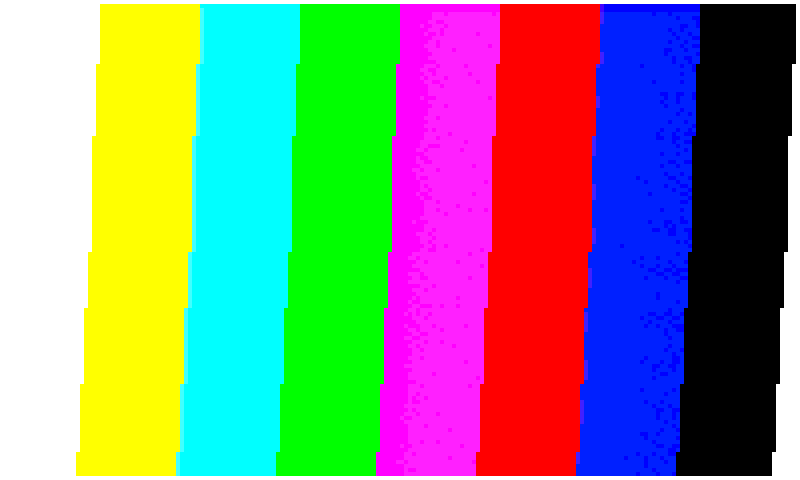
fpga_spark/screenshot/screenshot_20261026_223338.png
