wongben2333-crypto/26Embedded/fpga_spark/screenshot/screenshot_20261027_141630.png

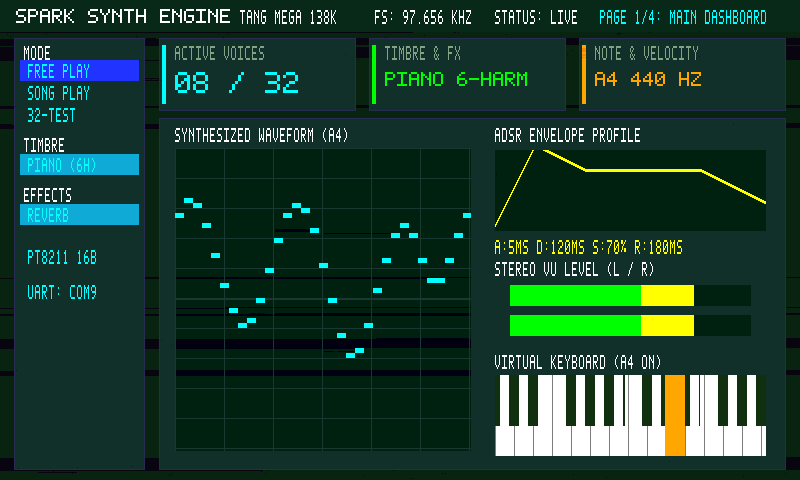
fpga_spark/screenshot/screenshot_20261027_141630.png
