wongben2333-crypto/26Embedded/fpga_spark/screenshot/screenshot_20261027_224241.png

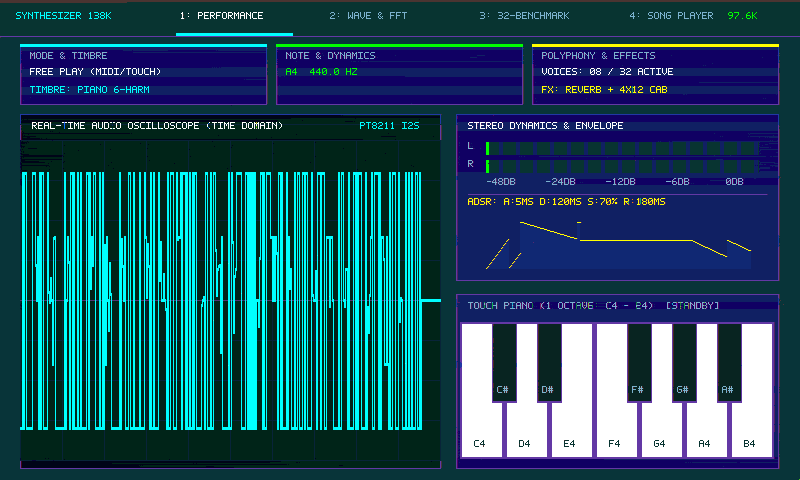
fpga_spark/screenshot/screenshot_20261027_224241.png
