wongben2333-crypto/26Embedded/fpga_spark/screenshot/screenshot_20261028_092356.png

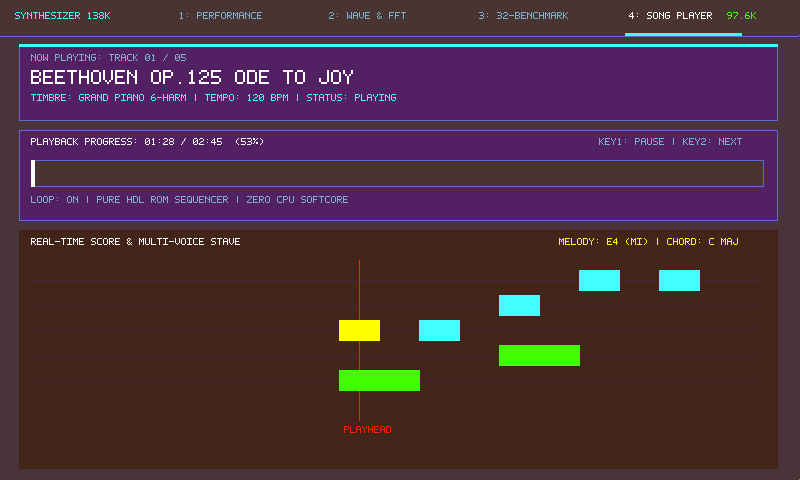
fpga_spark/screenshot/screenshot_20261028_092356.png
