wongben2333-crypto/26Embedded/fpga_spark/screenshot/screenshot_20261028_120434.png

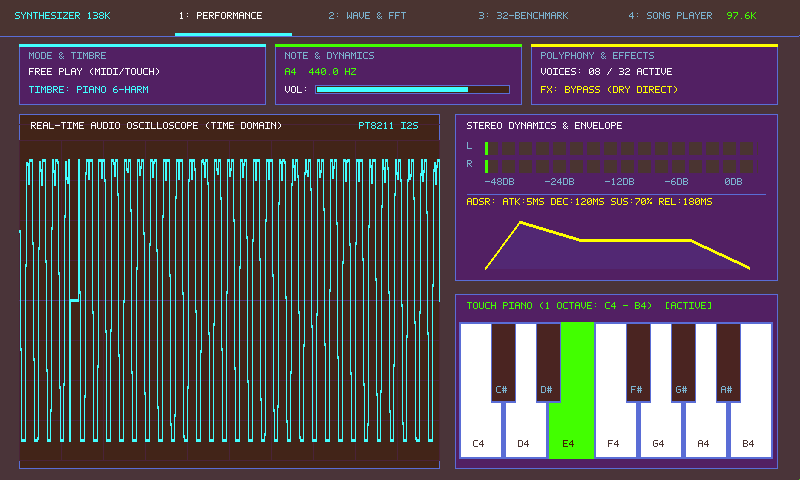
fpga_spark/screenshot/screenshot_20261028_120434.png
