wongben2333-crypto/26Embedded/fpga_spark/screenshot/screenshot_20261029_002118.png

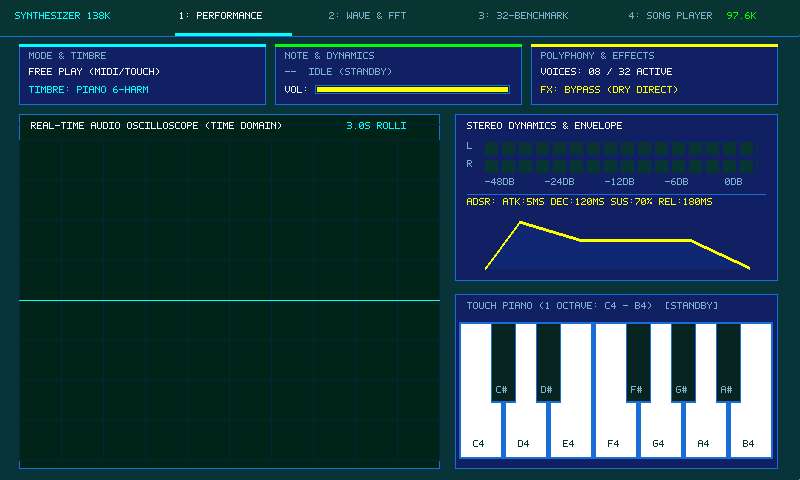
fpga_spark/screenshot/screenshot_20261029_002118.png
