wongben2333-crypto/26Embedded/fpga_spark/screenshot/screenshot_20261104_072408.png

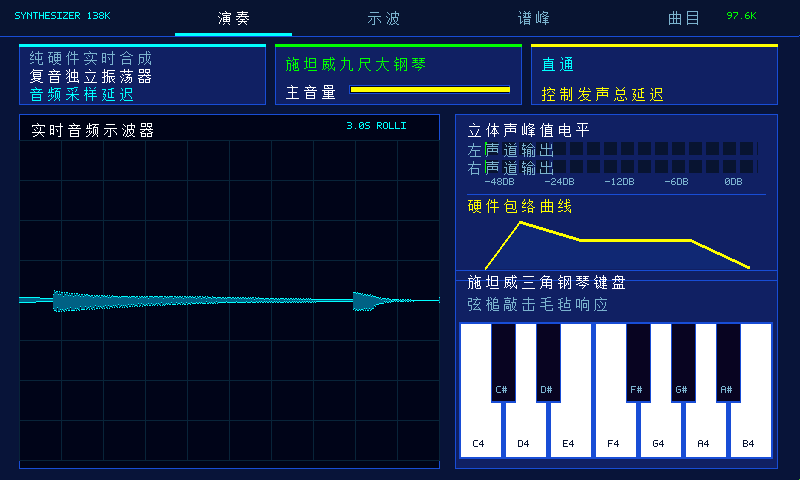
fpga_spark/screenshot/screenshot_20261104_072408.png
