wongben2333-crypto/26Embedded/fpga_spark/screenshot/screenshot_20261104_080705.png

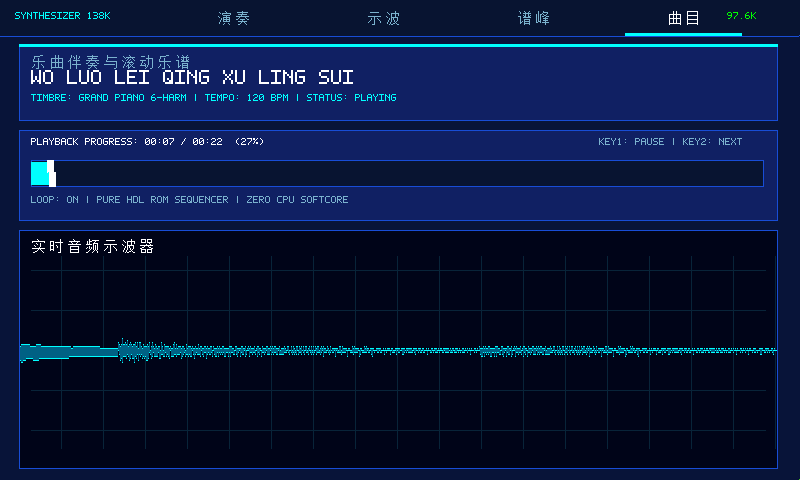
fpga_spark/screenshot/screenshot_20261104_080705.png
