wongben2333-crypto/26Embedded/fpga_spark/screenshot/screenshot_20261104_081107.png

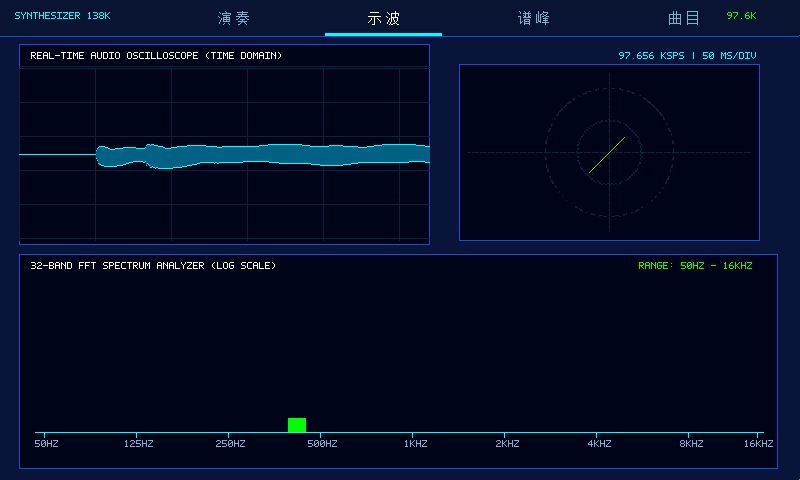
fpga_spark/screenshot/screenshot_20261104_081107.png
