wongben2333-crypto/26Embedded/fpga_spark/screenshot/ui_audio_feedback_20261027_final.png

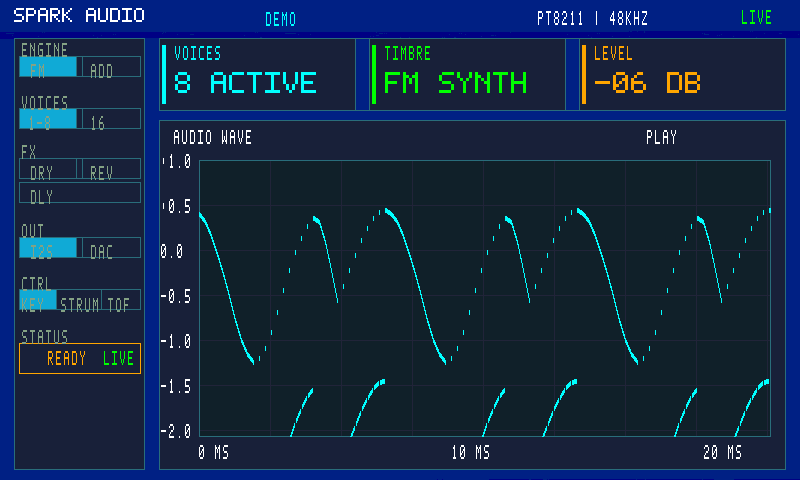
fpga_spark/screenshot/ui_audio_feedback_20261027_final.png
