wongben2333-crypto/26Embedded/fpga_spark/screenshot/ui_audio_feedback_20261027_v1.png

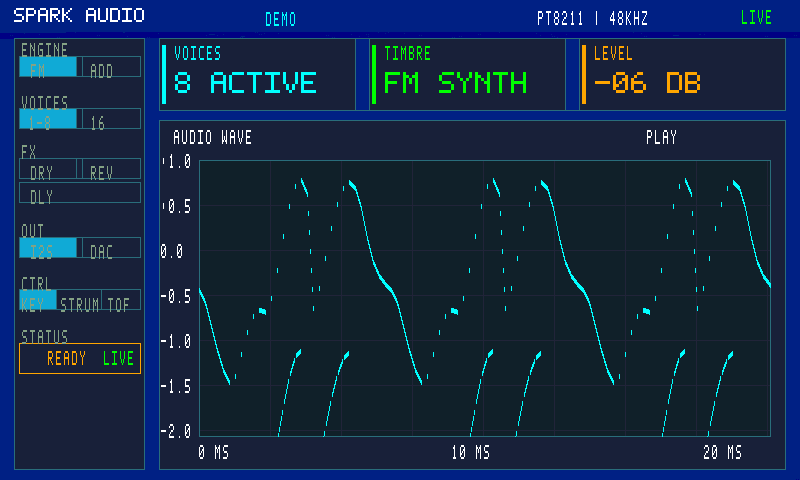
fpga_spark/screenshot/ui_audio_feedback_20261027_v1.png
