wongben2333-crypto/26Embedded/fpga_spark/screenshot/ui_feedback_20261027.png

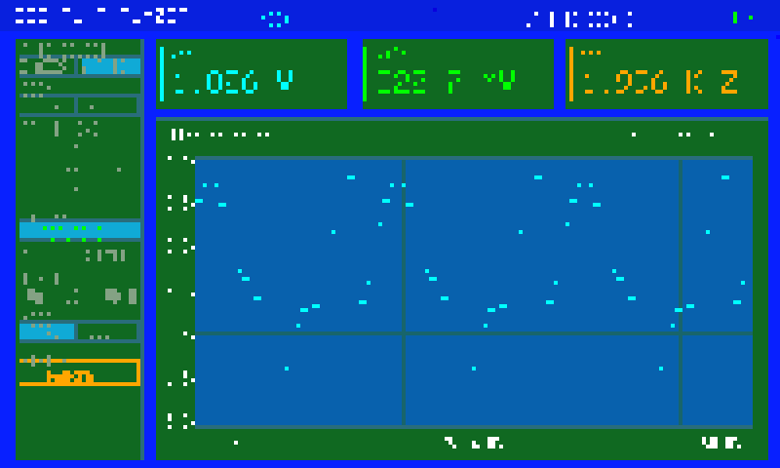
fpga_spark/screenshot/ui_feedback_20261027.png
