wongben2333-crypto/26Embedded/fpga_spark/screenshot/ui_feedback_full_20261027_v2.png

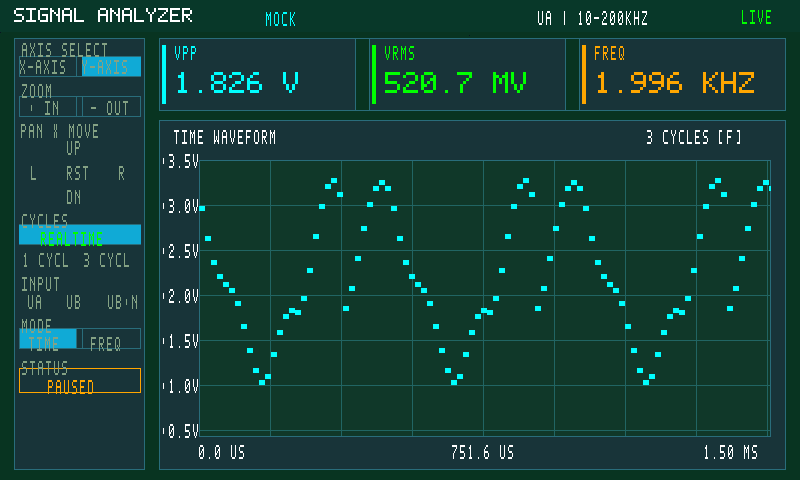
fpga_spark/screenshot/ui_feedback_full_20261027_v2.png
