wongben2333-crypto/26Embedded/fpga_spark/tools/conn_bot.png

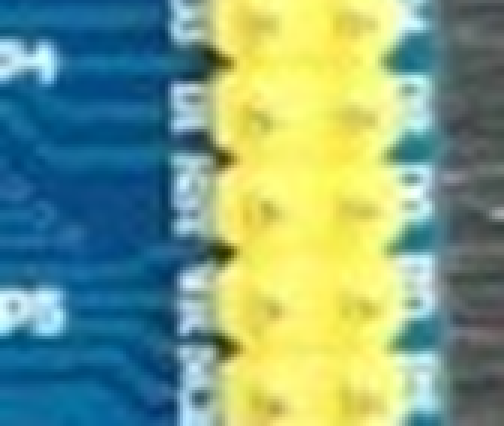
fpga_spark/tools/conn_bot.png
