wongben2333-crypto/26Embedded/fpga_spark/tools/rows/row_10_mag.png

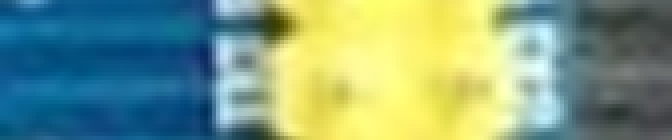
fpga_spark/tools/rows/row_10_mag.png
