wongben2333-crypto/26Embedded/fpga_spark/tools/rows/row_16_mag.png

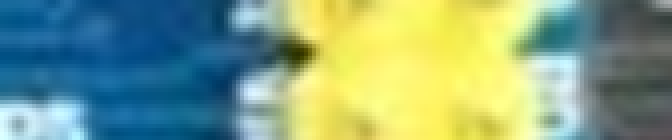
fpga_spark/tools/rows/row_16_mag.png
