wongben2333-crypto/26Embedded/hardware/adapter_board/crop_cn1_pins27_28.png

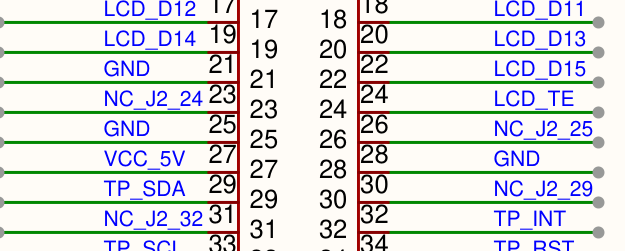
hardware/adapter_board/crop_cn1_pins27_28.png
