wongben2333-crypto/26Embedded/hardware/adapter_board/crop_u2_bot.png

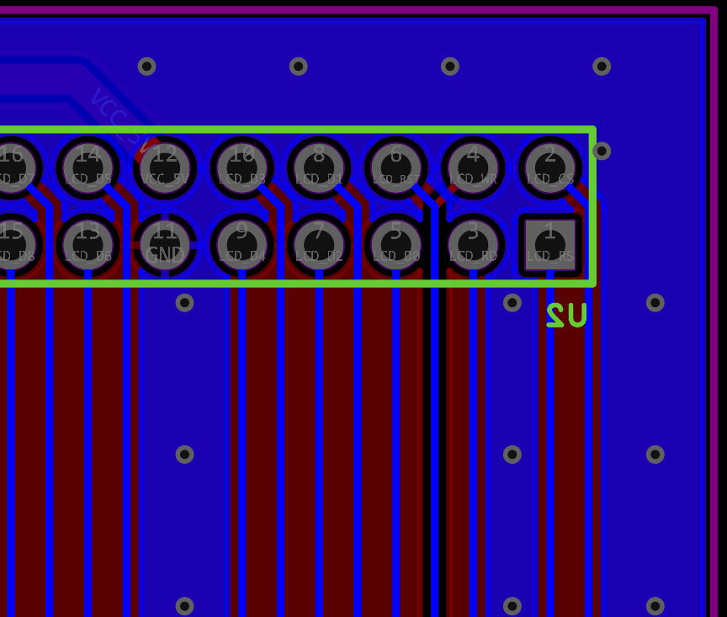
hardware/adapter_board/crop_u2_bot.png
