wongben2333-crypto/26Embedded/hardware/adapter_board/crop_u2_pins11_12.png

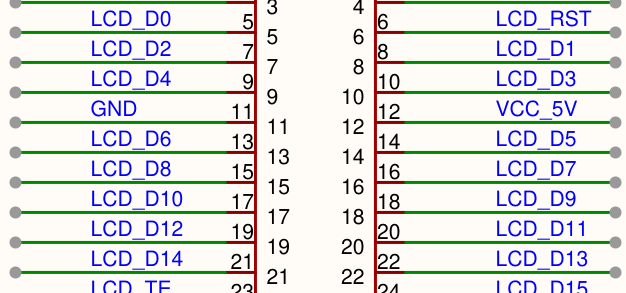
hardware/adapter_board/crop_u2_pins11_12.png
