wongben2333-crypto/26Embedded/hardware/adapter_board/hires_page_0.png

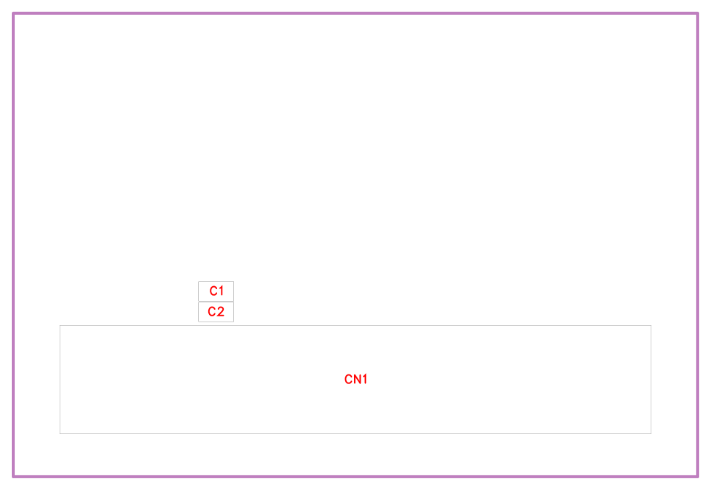
hardware/adapter_board/hires_page_0.png
