wongben2333-crypto/26Embedded/hardware/adapter_board/j2_sch_crop.png

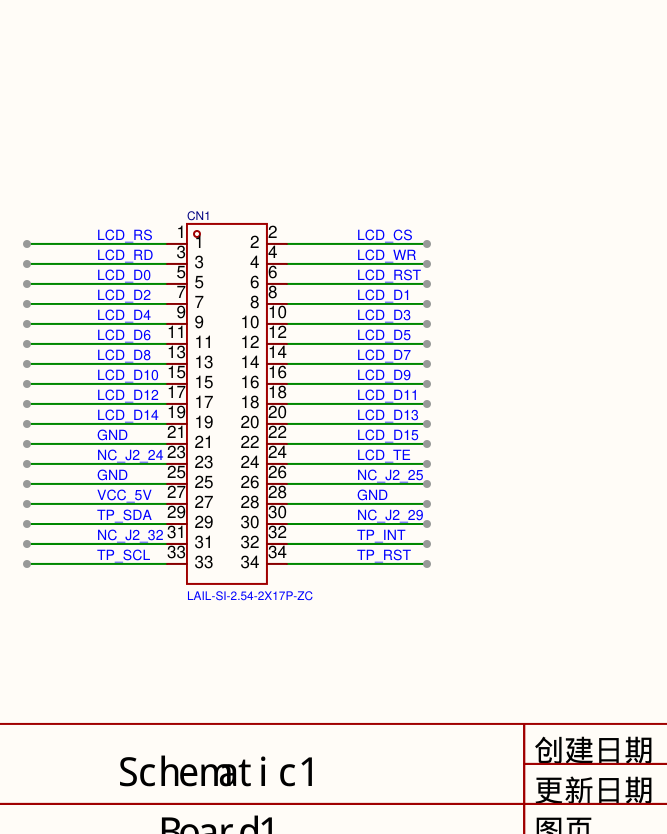
hardware/adapter_board/j2_sch_crop.png
