wongben2333-crypto/26Embedded/hardware/adapter_board/pdf_page_5.png

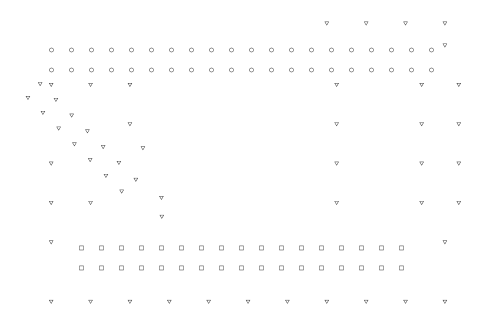
hardware/adapter_board/pdf_page_5.png
