wongben2333-crypto/26Embedded/hardware/adapter_board/SCH_Schematic1_1-P1_2026-10-24.png

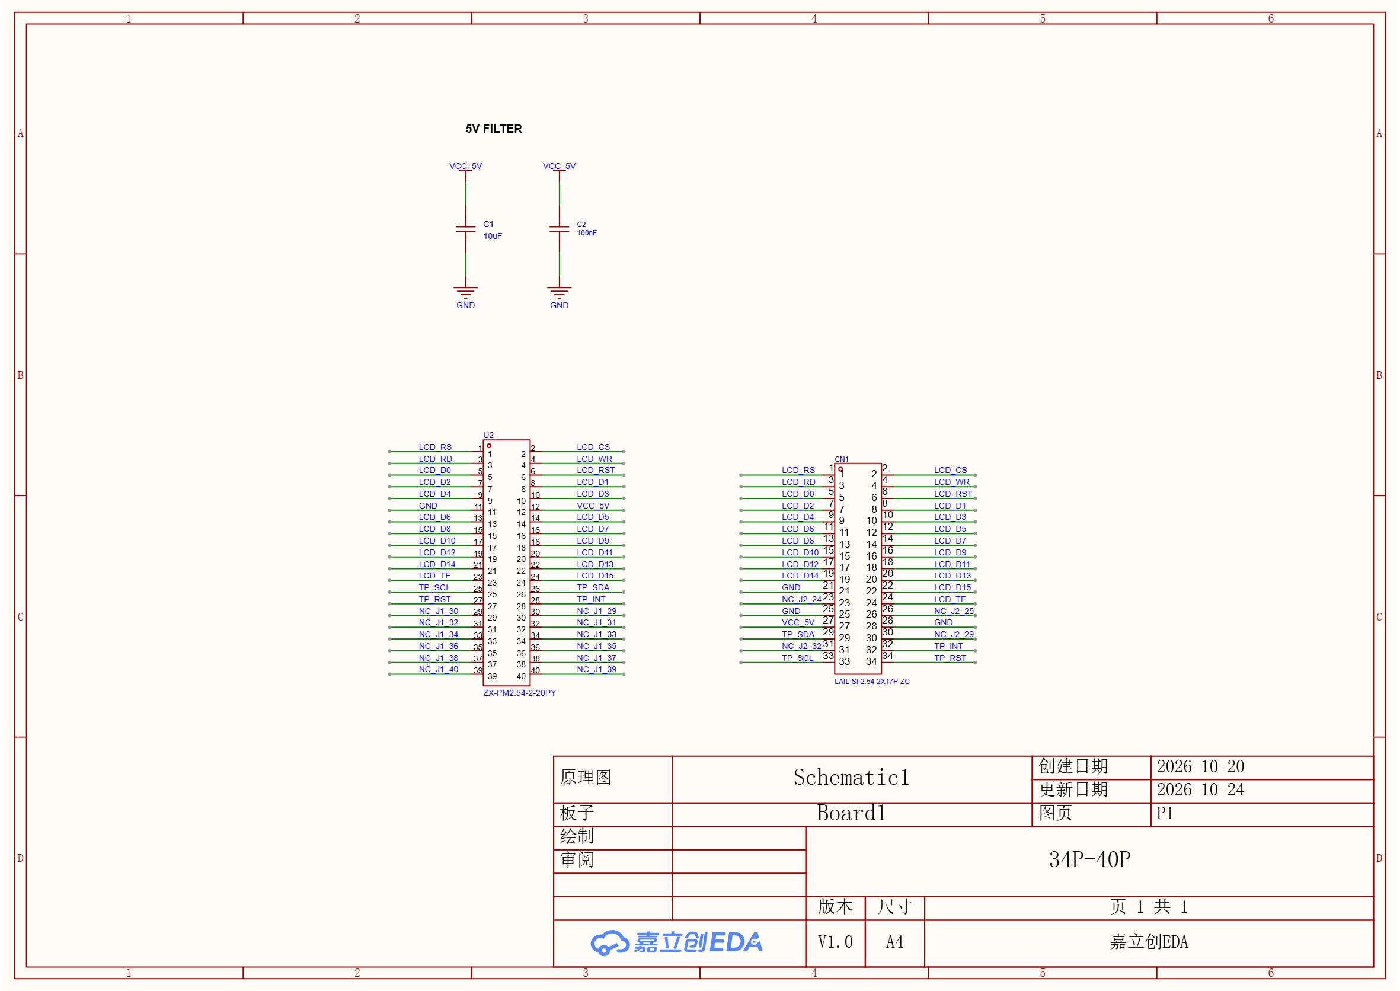
hardware/adapter_board/SCH_Schematic1_1-P1_2026-10-24.png
