wongben2333-crypto/26Embedded/hardware/adapter_board/u2_sch_crop.png

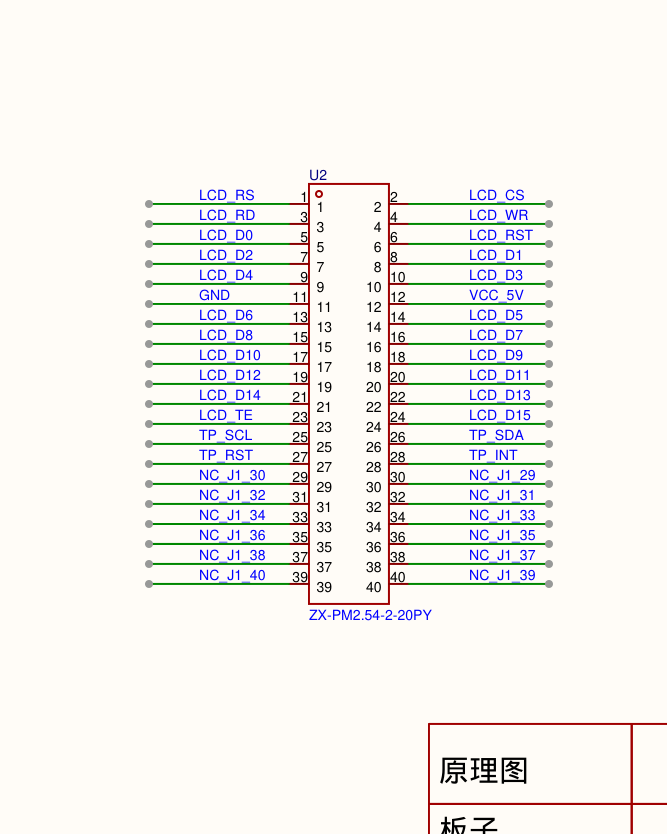
hardware/adapter_board/u2_sch_crop.png
