wongben2333-crypto/26Embedded/hardware/pcb/PCB_PCB1_2026-11-04b.png

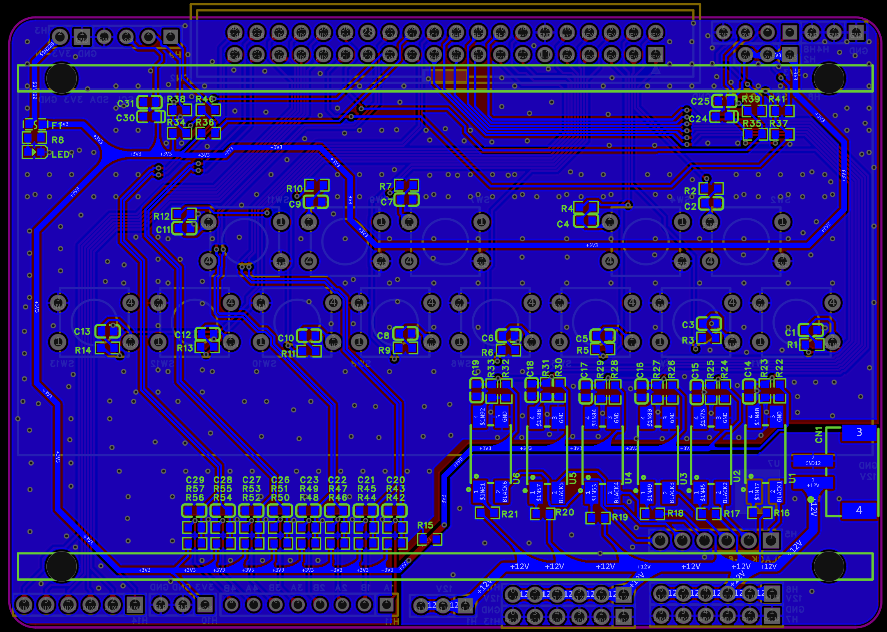
hardware/pcb/PCB_PCB1_2026-11-04b.png
