wongben2333-crypto/26Embedded/fpga_spark/硬件采购清单与店家沟通指南.md

# 2026 嵌赛 FPGA 电子乐器引擎 · 传感器与交互硬件采购清单及店家沟通指南

> **主控平台**：Sipeed Tang Mega 60K Dock / 138K Dock（高云 GW5AST-LV138PG484A）  
> **赛题选题**：选题二 · 基于 FPGA 的实时多音色合成电子乐器引擎  
> **配套文档**：[`硬件方案规划书-交互与传感器硬件.pdf`](file:///C:/Users/gjl50/Desktop/嵌赛/fpga_spark/硬件方案规划书-交互与传感器硬件.pdf)（已更新附录及表格内直达超链接）  
> **更新日期**：2026-10-11

---

## 一、推荐店铺及开票资质总览

参赛硬件采购必须兼顾**元器件电气参数匹配**与**高校财务报销合规性**。以下精选的 4 家店铺均支持开具正规发票，且在高校嵌入式/电赛圈内信誉良好：

| 店铺名称 | 平台 / 渠道 | 适合采购物料 | 开票资质与报销特点 | 店铺直达链接 |
|---|---|---|---|---|
| **优信电子**<br>（深圳市优信电子科技有限公司） | 淘宝金牌企业店 | 槽型光电、EC11编码器、轻触按键、导电铜箔、面包板、杜邦线、12V电源 | **首推集中采购店**。品类最全、现货现发。支持开具【增值税电子普通发票】，可开高校抬头+税号，发票类目为正规的 `*电子元器件*`、`*传感器*`。 | [优信电子店铺主页](https://yourcee.taobao.com) |
| **微雪电子**<br>（Waveshare 官方旗舰店） | 天猫 / 官网商城 | 高品质激光 ToF 测距模块、电平转换模块、工业级传感器 | 创客与高校名店，产品工业级做工，提供详尽的原理图与例程 Wiki，开票规范，带明细清单。 | [微雪电子天猫店](https://waveshare.taobao.com)<br>[微雪官方商城](https://www.waveshare.net) |
| **立创商城**<br>（深圳市立创电子商务有限公司） | 自营元器件商城 | ALPS原装EC11编码器、进口槽型光耦（ITR9608）、电阻电容插件 | 嘉立创旗下自营，100% 正品原装，无假货。系统自动开具电子发票与销售对账单，高校财务 100% 认可。 | [立创商城官网](https://www.szlcsc.com) |
| **DFRobot 旗舰店**<br>（上海智位机器人） | 淘宝 / 官网 | Fermion 系列 VL53L4CD 激光测距模块、高集成传感器 | 知名开源硬件厂商，模块集成度极高，适合购买高精度 ToF 测距板，开票合规。 | [DFRobot天猫旗舰店](https://dfrobot.taobao.com) |

---

## 二、采购清单与商品直达链接

本清单严格对照《硬件方案规划书》第六章物料清单，针对 Tang Mega 60K/138K Dock 的 3.3V LVCMOS 电平与赛题指标进行核验：

| 序号 | 物料名称 | 推荐规格型号 | 关键技术参数核验（赛题/平台要求） | 推荐店铺 | 购买 / 搜索直达链接 | 参考单价与数量 | 赛题考核对应 |
|:---:|---|---|---|:---:|---|:---:|---|
| **1** | **特雷门红外测距<br>（主推）** | **VL53L4CD 激光 ToF 模块** | • **3.3V I2C 接口**（直连 FPGA，严禁 5V）<br>• 测距刷新率最高 **100Hz（10ms）**<br>• 量程 1mm~1200mm，抗环境光，手势连续变调 | 淘宝 / DFRobot / 优信 | [淘宝VL53L4CD搜索直达](https://s.taobao.com/search?q=VL53L4CD%E6%A8%A1%E5%9D%97)<br>[DFRobot VL53L4CD](https://dfrobot.taobao.com/search.htm?q=VL53L4CD) | 25~45 元<br>（1~2 个） | 基础① 选音<br>拓展② 滑音表情 |
| **2** | **特雷门超声波<br>（备选兜底）** | **RCWL-1601 / HC-SR04P<br>（3.3V 宽压版）** | • **必须认准 3.3V 宽压版**（Echo 直接输出 3.3V，免电阻分压，保护 FPGA）<br>• 周期 20~60ms，仅作降级备选 | 优信电子 | [优信电子 HC-SR04P 直达](https://yourcee.taobao.com/search.htm?q=HC-SR04P) | 8~10 元<br>（1 个） | 测距备选方案 |
| **3** | **吉他拨弦光电对管** | **LM393 槽型光电开关模块<br>（5mm / 10mm 槽宽）** | • **板载 LM393 迟滞电压比较器**（杜绝临界遮挡重复抖动）<br>• 3.3V 供电，**数字量 DO 输出**（响应时间 $< 20\mu\text{s}$）<br>• 完美契合起音链路 $< 5\text{ms}$ 赛题要求 | 优信电子 / 立创商城 | [优信电子槽型光电直达](https://yourcee.taobao.com/search.htm?q=%B2%DB%D0%CD%B9%E2%B5%E7)<br>[立创商城槽型光电开关](https://so.szlcsc.com/global.html?k=%E6%A7%BD%E5%9E%8B%E5%85%89%E7%94%B5%E5%BC%80%E5%85%B3) | 3.5 元/个<br>（建议买 8~10 个） | 基础① 拨弦触发<br>维度② 力度感应 |
| **4** | **表情旋转编码器** | **EC11 旋转编码器模块<br>（带按键，配铝合金旋钮帽）** | • 15/20 脉冲，30 档位，360° 无限旋转<br>• 正交 A/B 相输出 + 独立轻触开关 SW<br>• 模块版板载 $10\text{k}\Omega$ 上拉电阻，3.3V 直连 FPGA IO<br>• 映射音量、颤音、滑音、延音 4 维参数 | 优信电子 | [优信电子 EC11 编码器直达](https://yourcee.taobao.com/search.htm?q=EC11+%B1%E0%C2%EB%C6%F7) | 4.5 元/个<br>（建议买 4 个） | 拓展② $\ge 3$ 维表情参数调节 |
| **5** | **钢琴琴键按键<br>（前期保底）** | **12×12×7.3mm 轻触开关<br>（配彩色方孔/圆孔键帽）** | • 4 脚直插微动轻触按键，寿命长<br>• 独立接入 40P 排针（每键 1 路 IO，免矩阵扫描）<br>• 配合 $10\text{k}\Omega$ 上拉，按下即时响（0 延时锁存） | 优信电子 | [优信电子 12×12 轻触按键直达](https://yourcee.taobao.com/search.htm?q=12*12+%C7%E1%B4%A5%BF%AA%B9%D8) | 12 元/包<br>（50只带帽） | 基础① 选音<br>基础② $\le 5\text{ms}$ 起音 |
| **6** | **电容触摸升级电极<br>（后期琴键）** | **双面导电铜箔胶带<br>（宽 20mm，长 20m）** | • 纯度 $>99.95\%$，双面导电胶，厚度 0.06mm<br>• 贴在 3D 打印黑白键表面做电容感应极板<br>• 机械结构不变，实现无机械杂音平滑触控 | 优信电子 | [优信电子铜箔胶带直达](https://yourcee.taobao.com/search.htm?q=%CD%AD%B1%40%BD%BA%B4%F8) | 15 元/卷 | 基础① 触摸选音 |
| **7** | **电容检测上拉电阻** | **1MΩ 金属膜电阻<br>（1/4W，精度 1%）** | • 阻值 $1\text{M}\Omega \pm 1\%$，温漂低<br>• 与铜箔电极组成 RC 充放电回路，由 FPGA IO 测充电时间 | 优信电子 | [优信电子 1MΩ 电阻直达](https://yourcee.taobao.com/search.htm?q=1M+%B5%E7%D7%E8) | 4 元/包<br>（100只装） | 电容感应充放电 |
| **8** | **可视化反馈灯带** | **WS2812B 5V 幻彩灯带<br>（60 灯/米，1 米，IP30 裸板）** | • 5050 RGB 内置驱动 IC，单线归零码驱动<br>• 5V 供电（板载引出），3.3V 数据线直驱<br>• 60 灯/米间距契合琴键，用于演奏与曲目指引 | 优信电子 | [优信电子 WS2812B 直达](https://yourcee.taobao.com/search.htm?q=WS2812B) | 20 元/米<br>（买 1 米） | 拓展③ 可视化<br>拓展④ 脱机曲目指引 |
| **9** | **面包板搭建套件** | **MB-102 830孔无焊面包板<br>（2 块）** | • 标准 2.54mm 间距，带电源正负极导轨，可左右卡扣拼接<br>• 支撑前期 25 键按键 + 光电 + 编码器连线调试 | 优信电子 | [优信电子 MB-102 面包板直达](https://yourcee.taobao.com/search.htm?q=MB-102+%C3%E6%B0%FC%B0%E5) | 9 元/块<br>（买 2 块） | 原型系统搭接 |
| **10** | **连线与排针排母** | **40P 彩虹杜邦线 + 2.54 排针排母** | • 20cm 40P 公对母 2 排、母对母 1 排、公对公 1 排<br>• 2.54mm 40P 单排直针 5 根 + 单排圆孔母座 5 根 | 优信电子 | [优信电子杜邦线直达](https://yourcee.taobao.com/search.htm?q=%B6%C3%B0%EE%CF%DF) | 16 元/套 | 稳固接线防脱落 |
| **11** | **主板供电电源** | **12V 2A DC5521 电源适配器** | • 输入 100-240V AC，输出 12V 2A DC<br>• 5.5×2.1mm 标准接口，内正外负<br>• 为 Tang Mega 底板及喇叭功放提供充足电流 | 优信电子 | [优信电子 12V 2A 电源直达](https://yourcee.taobao.com/search.htm?q=12V+2A+%B5%E7%D4%B4) | 22 元<br>（1 个） | 底板稳定供电 |
| **12** | **模拟力度采样<br>（备选）** | **ADS1115 16位超低功耗 ADC** | • I2C 接口，16 位分辨率，最高 860 SPS<br>• 3.3V 供电，用作备选慢速模拟力度信号采集 | 优信电子 | [优信电子 ADS1115 直达](https://yourcee.taobao.com/search.htm?q=ADS1115) | 16 元<br>（1 个） | 备选模拟力度 |

> **预算预估**：上述物料在【优信电子】合并下单（除 ToF 测距外），总计约 **180~260 元**，完全在方案规划书预算（250~400 元）内。

---

## 三、向店家客服咨询的话术模板（可直接复制）

在下单前，请在淘宝旺旺或商城客服窗口发送以下两套话术，确保技术参数与发票万无一失：

### 话术一：确认技术参数（确保 3.3V 逻辑安全与赛题指标）
```text
你好！我们正在参加全国大学生嵌入式系统与芯片设计竞赛（FPGA 赛道），主控板（高云 FPGA）GPIO 电平为严格的 3.3V LVCMOS。想向您确认一下这几款模块的具体参数：

1. 【供电与输出电平】：模块在 3.3V 供电下能否正常稳定工作？输出信号（DO/I2C/Echo）的逻辑高电平是 3.3V 吗？（因为是直接接入 3.3V FPGA IO，不能输出 5V）。
2. 【槽型光电开关】：板载是否集成了 LM393 电压比较器？输出是否有滞回（迟滞）整形电路，防止手指在遮挡临界点发生高频电平跳变抖动？
3. 【ToF/测距传感器】：请问这款激光测距模块芯片型号是 VL53L4CD 还是 VL53L0X？其最高刷新率是否支持 100Hz（10ms更新周期）？
4. 【EC11 旋转编码器】：模块是否自带轻触按键开关？引脚板载是否带有上拉电阻？旋转一圈是多少个脉冲/定位档位？
5. 【WS2812B 灯带】：在 5V 供电下，DIN 数据输入端是否可以直接兼容 3.3V 的控制器逻辑电平驱动？

麻烦客服帮忙核对确认下，非常感谢！
```

### 话术二：确认开具高校报销发票（增值税电子普通发票）
```text
你好！我们是高校实验室参赛团队采购，需要在下单后开具报销发票，请问：

1. 店铺能否开具正规的【增值税电子普通发票】？
2. 发票抬头可以填写我们【学校全称】与【统一社会信用代码（税号）】吗？是否支持在备注栏填写项目组或竞赛信息？
3. 发票商品类目名称是什么？（最好是 *电子元器件*、*传感器*、*集成电路* 等规范类目，以便学校财务入账审核）。
4. 开票是否需要加收额外税点？一般确认收货后多久能开出电子发票并发送到邮箱？

如果可以正常开具发票，我们核对好型号就直接从贵店集中下单，谢谢！
```

---

## 四、硬件连接与避坑提醒（Tang Mega 60K / 138K 专属）

1. **绝对电平红线（3.3V LVCMOS）**：
   - Tang Mega 60K / 138K Dock 底板排针的 IO 均直连 FPGA 核心芯片，内部没有 5V 耐受保护。
   - 所有传感器的输出信号（DO、SDA、SCL、Echo）**必须是 3.3V**。如果使用外部 5V 传感器（如老款 HC-SR04），必须使用电阻分压（如 $1\text{k}\Omega : 2\text{k}\Omega$）将 5V 降至 3.3V 后才能接入 FPGA！
2. **40P 排针引脚选择**：
   - 138K Dock 板上有 2 个 40P 排针（J1 与 J2）。其中一个与 PMOD 和摄像头 DVP 复用，另一个为独立排针。
   - 琴键与传感器接线请优先接在**独立 40P 排针**上，避免与板载外设引脚冲突。
3. **起音链路延迟（$\le 5\text{ms}$ 保证）**：
   - 琴键与拨弦光电直接接入 FPGA：FPGA 内部采用「两级同步器防亚稳态 $\rightarrow$ 首边沿锁存立即发声 $\rightarrow$ 启动 1~2ms 锁定窗口 $\rightarrow$ 松开沿再消抖」。
   - 此机制在按下瞬间的延迟仅为 2 个系统时钟（$< 40\text{ns}$），合成到 DAC 约 $0.35\text{ms}$，全链路端到端延迟 $< 0.5\text{ms}$，远优于赛题要求的 $\le 10\text{ms}$！
4. **ToF 测距定位为“表情链路”**：
   - VL53L4CD 刷新周期为 10ms（100Hz），它负责特雷门琴手势的连续滑音、颤音和音量表情调节，不属于触发击键的起音链路，答辩时向评委阐明两者分开统计即可。
