wongben2333-crypto/26Embedded/hardware/pcb/BOM_Board1_Schematic1_2026-10-29.xlsx

No. | Quantity | Comment | Designator | Footprint | Value | Manufacturer Part | Manufacturer | Supplier Part | Supplier
1 | 29 | 100nF | C1,C2,C3,C4,C5,C6,C7,C8,C9,C10,C11,C12,C13,C14,C15,C16,C17,C18,C19,C20,C21,C22,C23,C25,C26,C27,C28,C29,C31 | C0603 | 100nF | FCC0603B104K500CT | FOJAN(富捷) | C5137636 | LCSC
2 | 2 | 100uF | C24,C30 | CAP-SMD_L1.6-W0.8-1 | 100uF | 298W107X0004M2T | VISHAY(威世) | C6663208 | LCSC
3 | 1 | LAIL-PHC2.54-2P-01-XH-LT | CN1 | CONN-SMD_LAIL-PHC2.54-2P-01-XH-LT |  | LAIL-PHC2.54-2P-01-XH-LT | LAILAN(莱联) | C54905885 | LCSC
4 | 1 | BH254V-40P | CN2 | CONN-TH_40P-P2.54_LX_XDFH-0254-2X20P |  | BH254V-40P | XFCN(兴飞) | C48687632 | LCSC
5 | 1 | SMD0603-050-16 | F1 | F0603 |  | SMD0603-050-16 | R+O(宏嘉诚) | C46640964 | LCSC
6 | 4 | PZ254V-11-03P | H1,H2,H4,H10 | HDR-TH_3P-P2.54-V-M_PZ254V-11-03P |  | PZ254V-11-03P | XFCN(兴飞) | C2937625 | LCSC
7 | 1 | B-2100S02P-A110 | H3 | HDR-TH_2P-P2.54-V-M-1 |  | B-2100S02P-A110 | Ckmtw(灿科盟) | C124375 | LCSC
8 | 6 | 2.54-1x6P直针 | H5,H6,H7,H12,H13,H14 | HDR-TH_6P-P2.54-V-M-1 |  | 2.54-1x6P直针 | BOOMELE(博穆精密) | C37208 | LCSC
9 | 2 | LAIL-PZ2.54-4P-L | H8,H9 | CONN-TH_LAIL-PZ2.54-4P-L |  | LAIL-PZ2.54-4P-L | LAILAN(莱联) | C54950602 | LCSC
10 | 1 | B-2100S08P-A110 | H11 | HDR-TH_8P-P2.54-V-M |  | B-2100S08P-A110 | Ckmtw(灿科盟) | C124381 | LCSC
11 | 1 | GL0603UG01 | LED1 | LED0603-RD |  | GL0603UG01 | Guiguang light(桂光光电) | C51933293 | LCSC
12 | 19 | 220Ω | R1,R2,R3,R4,R5,R6,R7,R9,R10,R11,R12,R13,R14,R23,R25,R27,R29,R31,R33 | R0603 | 220Ω | 0603WAF2200T5E | UNI-ROYAL(厚声) | C22962 | LCSC
13 | 1 | 1kΩ | R8 | R0603 | 1kΩ | 0603WAF1001T5E | UNI-ROYAL(厚声) | C21190 | LCSC
14 | 1 | 0Ω | R15 | R0603 | 0Ω | 0603WAF0000T5E | UNI-ROYAL(厚声) | C21189 | LCSC
15 | 6 | 1.2kΩ | R16,R17,R18,R19,R20,R21 | R0603 | 1.2kΩ | RC0603FR-071K2L | YAGEO(国巨) | C114605 | LCSC
16 | 14 | 10kΩ | R22,R24,R26,R28,R30,R32,R42,R44,R46,R48,R50,R52,R54,R56 | R0603 | 10kΩ | FRC0603F1002TS | FOJAN(富捷) | C2906982 | LCSC
17 | 4 | 4.7kΩ | R34,R35,R36,R37 | R0603 | 4.7kΩ | 0603WAF4701T5E | UNI-ROYAL(厚声) | C23162 | LCSC
18 | 4 | 330Ω | R38,R39,R40,R41 | R0603 | 330Ω | 0603WAF3300T5E | UNI-ROYAL(厚声) | C23138 | LCSC
19 | 8 | 100Ω | R43,R45,R47,R49,R51,R53,R55,R57 | R0603 | 100Ω | 0603WAF1000T5E | UNI-ROYAL(厚声) | C22775 | LCSC
20 | 13 | TS-1117 | SW1,SW2,SW3,SW4,SW5,SW6,SW7,SW8,SW9,SW10,SW11,SW12,SW13 | SW-TH_4P-L7.8-W7.8-P4.50-LS8.5 |  | TS-1117 | SOFNG(硕方) | C127415 | LCSC
21 | 6 | PC817C | U1,U2,U3,U4,U5,U6 | OPTO-SMD-4_L4.6-W6.5-P2.54-LS10.3-TL |  | PC817C | GOODWORK(固得沃克) | C3025164 | LCSC
22 | 1 | 嘉立创二维码5x5 | U7 | JLC-QRCODE-5x5
