wongben2333-crypto/26Embedded/Tang_Mega_60K_138K硬件资料/04_引脚约束与线长_Pinout_Constraints/TANG_138K_60K_PCB_etch_length.csv

Comment: | Groupings: | Total Etch Length
Columns: | Objects | Actual
Comment: | Units: | mil
Comment: | ######################################################################
Net: | BANK2_E13_IOR2A | 511.96
Net: | BANK2_E14_IOR2B | 512.16
Net: | BANK2_D14_IOR4A | 278.39
Net: | BANK2_D15_IOR4B | 280.49
Net: | BANK2_D16_IOR6B | 302.71
Net: | BANK2_E16_IOR6A | 304.63
Net: | BANK2_C14_IOR8A | 521.33
Net: | BANK2_C15_IOR8B | 522.31
Net: | BANK2_F13_IOR11A | 403.77
Net: | BANK2_F14_IOR11B | 402.66
Net: | BANK2_E17_IOR13B | 365
Net: | BANK2_F16_IOR13A | 366.27
Net: | BANK2_A13_IOR15A | 255.82
Net: | BANK2_A14_IOR15B | 254.89
Net: | BANK2_B13_IOR17B | 335.72
Net: | BANK2_C13_IOR17A | 332.04
Net: | BANK2_A15_IOR20A | 243.84
Net: | BANK2_A16_IOR20B | 247.33
Net: | BANK2_B15_IOR22A | 315.56
Net: | BANK2_B16_IOR22B | 315.54
Net: | BANK2_B17_IOR24A | 283.74
Net: | BANK2_B18_IOR24B | 285.47
Net: | BANK2_C17_IOR26B | 361.19
Net: | BANK2_D17_IOR26A | 360.68
Net: | BANK2_D19_IOR29B | 330.27
Net: | BANK2_E19_IOR29A | 332.3
Net: | BANK2_C18_IOR31A | 225.86
Net: | BANK2_C19_IOR31B | 225.78
Net: | BANK2_F19_IOR33A | 261.4
Net: | BANK2_F20_IOR33B | 262.29
Net: | BANK2_E18_IOR35B | 630.27
Net: | BANK2_F18_IOR35A | 631.29
Net: | BANK2_A18_IOR38A | 248.61
Net: | BANK2_A19_IOR38B | 249.63
Net: | BANK2_A20_IOR40B | 291.07
Net: | BANK2_B20_IOR40A | 290.71
Net: | BANK2_B22_IOR42B | 330.27
Net: | BANK2_C22_IOR42A | 330.6
Net: | BANK2_A21_IOR44B | 297.16
Net: | BANK2_B21_IOR44A | 296.7
Net: | BANK2_C20_IOR47B | 289.66
Net: | BANK2_D20_IOR47A | 290.94
Net: | BANK2_D22_IOR49B | 136.87
Net: | BANK2_E22_IOR49A | 137.62
Net: | BANK2_D21_IOR51B | 194.74
Net: | BANK2_E21_IOR51A | 197.83
Net: | BANK2_G21_IOR53A | 304.45
Net: | BANK2_G22_IOR53B | 301.4
Net: | BANK3_L13_IOR56B | 816.64
Net: | BANK3_M13_IOR56A | 814.37
Net: | BANK3_J17_IOR58B | 585.65
Net: | BANK3_K17_IOR58A | 589.6
Net: | BANK3_K13_IOR60A | 768.12
Net: | BANK3_K14_IOR60B | 768.06
Net: | BANK3_L14_IOR62A | 612.3
Net: | BANK3_L15_IOR62B | 608.9
Net: | BANK3_K16_IOR65B | 588.35
Net: | BANK3_L16_IOR65A | 587.65
Net: | BANK3_M15_IOR67A | 845.49
Net: | BANK3_M16_IOR67B | 849.13
Net: | BANK3_G20_IOR69B | 229.35
Net: | BANK3_H20_IOR69A | 229.81
Net: | BANK3_L21_IOR71B | 300.25
Net: | BANK3_M21_IOR71A | 300.77
Net: | BANK3_H22_IOR74B | 325.59
Net: | BANK3_J22_IOR74A | 329.25
Net: | BANK3_K21_IOR76A | 307.25
Net: | BANK3_K22_IOR76B | 303.99
Net: | BANK3_J20_IOR78A | 392.79
Net: | BANK3_J21_IOR78B | 387.95
Net: | BANK3_H19_IOR80B | 269.64
Net: | BANK3_J19_IOR80A | 269.59
Net: | BANK3_K18_IOR83A | 308.29
Net: | BANK3_K19_IOR83B | 306.19
Net: | BANK3_L19_IOR85A | 399.94
Net: | BANK3_L20_IOR85B | 396.24
Net: | BANK3_L18_IOR87B | 309.85
Net: | BANK3_M18_IOR87A | 310.15
Net: | BANK3_M22_IOR89B | 327.35
Net: | BANK3_N22_IOR89A | 322.83
Net: | BANK3_N18_IOR92A | 328.84
Net: | BANK3_N19_IOR92B | 330.11
Net: | BANK3_M20_IOR94B | 255.91
Net: | BANK3_N20_IOR94A | 255.51
Net: | BANK3_H17_IOR96A | 375.2
Net: | BANK3_H18_IOR96B | 377.73
Net: | BANK3_G13_IOR98B | 478.29
Net: | BANK3_H13_IOR98A | 479.76
Net: | BANK3_H15_IOR101B | 535.21
Net: | BANK3_J15_IOR101A | 531.88
Net: | BANK3_H14_IOR103B | 640.31
Net: | BANK3_J14_IOR103A | 639.05
Net: | BANK3_G15_IOR105A | 531.09
Net: | BANK3_G16_IOR105B | 532.79
Net: | BANK3_G17_IOR107A | 699.98
Net: | BANK3_G18_IOR107B | 704.47
Net: | BANK4_T21_IOB97A | 303.22
Net: | BANK4_U21_IOB97B | 299.86
Net: | BANK4_P19_IOB99A | 381.67
Net: | BANK4_R19_IOB99B | 383.09
Net: | BANK4_V17_IOB106A | 311.88
Net: | BANK4_W17_IOB106B | 309.83
Net: | BANK4_AA18_IOB108A | 166.7
Net: | BANK4_AB18_IOB108B | 162.35
Net: | BANK4_AA19_IOB110A | 181.12
Net: | BANK4_AB20_IOB110B | 182.69
Net: | BANK4_U17_IOB112A | 376.46
Net: | BANK4_U18_IOB112B | 380.58
Net: | BANK4_V18_IOB114A | 387.06
Net: | BANK4_V19_IOB114B | 387.47
Net: | BANK4_Y18_IOB116A | 242.48
Net: | BANK4_Y19_IOB116B | 242.67
Net: | BANK4_U20_IOB120A | 728.1
Net: | BANK4_V20_IOB120B | 728.99
Net: | BANK4_W19_IOB122A | 289.66
Net: | BANK4_W20_IOB122B | 289.23
Net: | BANK4_W21_IOB124A | 481.71
Net: | BANK4_W22_IOB124B | 484.96
Net: | BANK4_AA20_IOB126A | 174.38
Net: | BANK4_AA21_IOB126B | 172.96
Net: | BANK4_AB21_IOB129A | 139.14
Net: | BANK4_AB22_IOB129B | 136.06
Net: | BANK4_Y21_IOB131A | 233.15
Net: | BANK4_Y22_IOB131B | 230.61
Net: | BANK4_P14_IOB133A | 502.35
Net: | BANK4_R14_IOB133B | 500.46
Net: | BANK4_N17_IOB135A | 913.95
Net: | BANK4_P17_IOB135B | 915.26
Net: | BANK4_R18_IOB138A | 328.78
Net: | BANK4_T18_IOB138B | 326.56
Net: | BANK4_P15_IOB140A | 521.47
Net: | BANK4_R16_IOB140B | 522.41
Net: | BANK4_N13_IOB142A | 711.28
Net: | BANK4_N14_IOB142B | 710.68
Net: | BANK4_P16_IOB144A | 425.92
Net: | BANK4_R17_IOB144B | 423.69
Net: | BANK2_F15_IOR1A | 363
Net: | BANK2_F21_IOR55A | 242.1
Net: | BANK3_J16_IOR109A | 575.35
Net: | BANK3_M17_IOR73A | 942.17
Net: | BANK4_N15_IOB146A | 799.93
Net: | BANK4_P20_IOB92A | 273.82
Net: | BANK4_P21_MSPI_D02 | 983.34
Net: | BANK4_P22_MSPI_D00 | 949.22
Net: | BANK4_R21_MSPI_D03 | 1007.6
Net: | BANK4_R22_MSPI_D01 | 948.06
Net: | BANK4_T19_MSPI_CS | 1019.88
Net: | BANK4_T20_IOB102B | 343.03
Net: | BANK4_U22_IOB104A_PUDC | 308.94
Net: | BANK4_V22_EMCCLK_50MHZ | 52.92
Net: | BANK5_AA9 | 387.28
Net: | BANK5_AA10 | 425.02
Net: | BANK5_AA11 | 391.81
Net: | BANK5_AA13 | 400.07
Net: | BANK5_AA14 | 426.7
Net: | BANK5_AA15 | 374.37
Net: | BANK5_AA16 | 291.69
Net: | BANK5_AB10 | 309.48
Net: | BANK5_AB11 | 311.33
Net: | BANK5_AB12 | 373.23
Net: | BANK5_AB13 | 383.19
Net: | BANK5_AB15 | 290.92
Net: | BANK5_AB16 | 301.1
Net: | BANK5_AB17 | 244.57
Net: | BANK5_T14 | 799.17
Net: | BANK5_T15 | 396.88
Net: | BANK5_T16 | 422.24
Net: | BANK5_U15 | 1146.18
Net: | BANK5_U16 | 373.85
Net: | BANK5_V10 | 522.08
Net: | BANK5_V13 | 657.69
Net: | BANK5_V14 | 1136.53
Net: | BANK5_V15 | 523.41
Net: | BANK5_W10 | 502.07
Net: | BANK5_W11 | 506.65
Net: | BANK5_W12 | 619.76
Net: | BANK5_W14 | 427.77
Net: | BANK5_W15 | 473.64
Net: | BANK5_W16 | 283.09
Net: | BANK5_Y11 | 445.13
Net: | BANK5_Y12 | 445.27
Net: | BANK5_Y13 | 378.93
Net: | BANK5_Y14 | 378.45
Net: | BANK5_Y16 | 466.85
Net: | BANK5_Y17 | 330.99
Net: | BANK7_A1_IOL2A_SMA_GPION | 44.09
Net: | BANK7_B1_IOL2A_SMA_GPIO_P | 33.67
Net: | BANK7_F4_CPU_RESET | 1308.14
Net: | BANK10_G11_DONE | 1259.86
Net: | BANK10_L12_MSPI_CLK | 1079.13
Net: | BANK10_N12_RECONFIG | 1356.63
Net: | BANK10_R13_JTAG_TDI | 1199.92
Net: | BANK10_T13_JTAG_TMS | 1083.45
Net: | BANK10_U8_CFGBVS | 444.42
Net: | BANK10_U9_MODE2 | 518.33
Net: | BANK10_U10_MODE1 | 457.25
Net: | BANK10_U11_MODE0 | 471.43
Net: | BANK10_U12_READY | 1480.8
Net: | BANK10_U13_JTAG_TDO | 1217.85
Net: | BANK10_V12_JTAG_TCK | 1157.63
Net: | Q0_LN0_RXM_I | 310.45
Net: | Q0_LN0_RXP_I | 310.71
Net: | Q0_LN0_TXM_O | 299.55
Net: | Q0_LN0_TXP_O | 301.78
Net: | Q0_LN1_RXM_I | 280.49
Net: | Q0_LN1_RXP_I | 279.94
Net: | Q0_LN1_TXM_O | 383.8
Net: | Q0_LN1_TXP_O | 382.09
Net: | Q0_LN2_RXM_I | 197.51
Net: | Q0_LN2_RXP_I | 195
Net: | Q0_LN2_TXM_O | 303.87
Net: | Q0_LN2_TXP_O | 303.44
Net: | Q0_LN3_RXM_I | 272.28
Net: | Q0_LN3_RXP_I | 272.1
Net: | Q0_LN3_TXM_O | 379.19
Net: | Q0_LN3_TXP_O | 380.03
Net: | Q0_REFCLKM_0 | 361.37
Net: | Q0_REFCLKP_0 | 362.49
Net: | Q0_REFCLKM_1 | 442.41
Net: | Q0_REFCLKP_1 | 443.91
Net: | DDR3_A0 | 1785.44
Net: | DDR3_A1 | 1848.92
Net: | DDR3_A2 | 1792.89
Net: | DDR3_A3 | 1793.08
Net: | DDR3_A4 | 1876.01
Net: | DDR3_A5 | 1800.09
Net: | DDR3_A6 | 1876.14
Net: | DDR3_A7 | 1815.75
Net: | DDR3_A8 | 1813.67
Net: | DDR3_A9 | 1828.95
Net: | DDR3_A10 | 1836.69
Net: | DDR3_A11 | 1846.95
Net: | DDR3_A12 | 1825.08
Net: | DDR3_A13 | 1989.69
Net: | DDR3_A14 | 1800.33
Net: | DDR3_A15 | 1837.65
Net: | DDR3_BA0 | 1807.62
Net: | DDR3_BA1 | 1842.94
Net: | DDR3_BA2 | 1804.44
Net: | DDR3_CAS# | 1801.41
Net: | DDR3_CKE | 1816.25
Net: | DDR3_CLK0_N | 1831.37
Net: | DDR3_CLK0_P | 1832.78
Net: | DDR3_CS# | 1821.93
Net: | DDR3_ODT | 1858.55
Net: | DDR3_RAS# | 1817.14
Net: | DDR3_RESET | 1889.85
Net: | DDR3_WE# | 1778.26
Net: | DDR3_CLK0_N | 1831.37
Net: | DDR3_CLK0_P | 1832.78
Net: | DDR3_DQ0 | 779.09
Net: | DDR3_DQ1 | 775.31
Net: | DDR3_DQ2 | 775.91
Net: | DDR3_DQ3 | 775.7
Net: | DDR3_DQ4 | 779.84
Net: | DDR3_DQ5 | 775.09
Net: | DDR3_DQ6 | 776.03
Net: | DDR3_DQ7 | 778.22
Net: | DDR3_DM0 | 777.87
Net: | DDR3_DQS0_N | 775.8
Net: | DDR3_DQS0_P | 775.58
Net: | DDR3_DQ8 | 778.39
Net: | DDR3_DQ9 | 776.52
Net: | DDR3_DQ10 | 779.21
Net: | DDR3_DQ11 | 771.72
Net: | DDR3_DQ12 | 775.89
Net: | DDR3_DQ13 | 772.69
Net: | DDR3_DQ14 | 779.93
Net: | DDR3_DQ15 | 776.71
Net: | DDR3_DM1 | 772.21
Net: | DDR3_DQS1_N | 777.21
Net: | DDR3_DQS1_P | 776.38
Net: | DDR3_DQ0_1 | 1168.64
Net: | DDR3_DQ1_1 | 1172.87
Net: | DDR3_DQ2_1 | 1176.33
Net: | DDR3_DQ3_1 | 1170.96
Net: | DDR3_DQ4_1 | 1172.09
Net: | DDR3_DQ5_1 | 1171.12
Net: | DDR3_DQ6_1 | 1171.74
Net: | DDR3_DQ7_1 | 1171.55
Net: | DDR3_DM0_1 | 1171.42
Net: | DDR3_DQS0_N_1 | 1172.02
Net: | DDR3_DQS0_P_1 | 1170.16
Net: | DDR3_DQ8_1 | 789.78
Net: | DDR3_DQ9_1 | 788.56
Net: | DDR3_DQ10_1 | 787.62
Net: | DDR3_DQ11_1 | 790.06
Net: | DDR3_DQ12_1 | 787.58
Net: | DDR3_DQ13_1 | 784.51
Net: | DDR3_DQ14_1 | 789.45
Net: | DDR3_DQ15_1 | 787.47
Net: | DDR3_DM1_1 | 793.55
Net: | DDR3_DQS1_N_1 | 788.92
Net: | DDR3_DQS1_P_1 | 785.51
