wongben2333-crypto/26Embedded/fpga_ben/题目/TangMega138K-外设准备清单-修订版.png

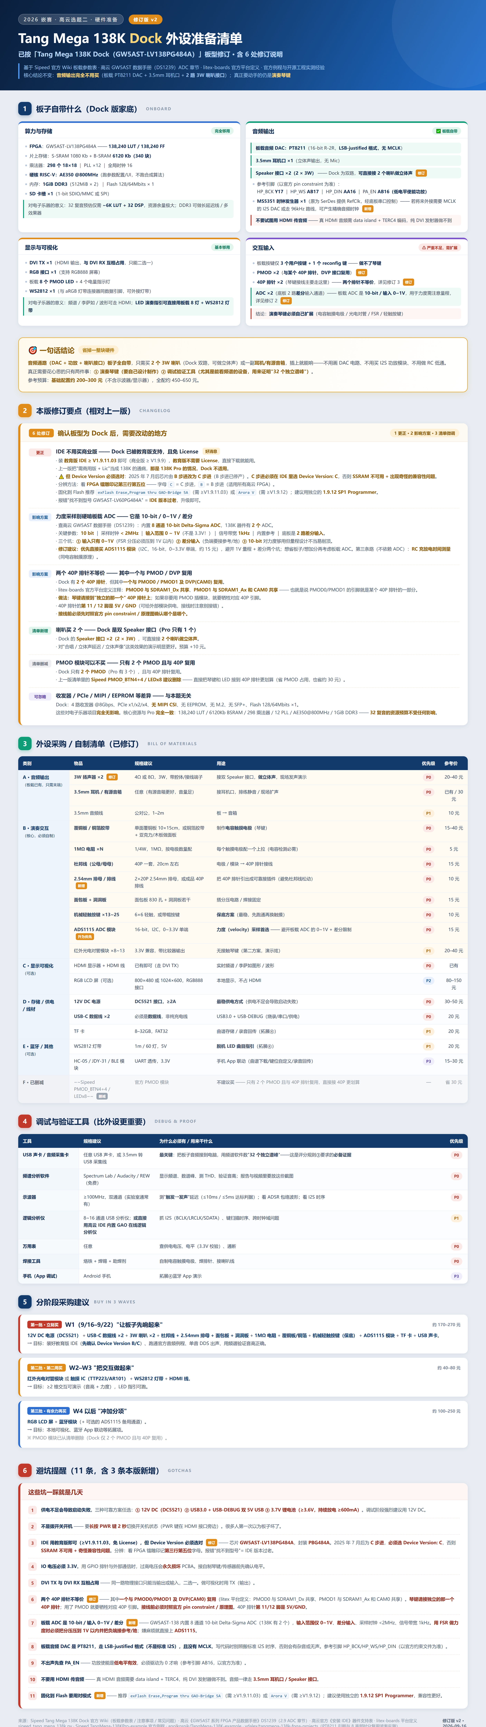
fpga_ben/题目/TangMega138K-外设准备清单-修订版.png
