wongben2333-crypto/26Embedded/fpga_hardware/enclosure/STEP/fit_assembly.step

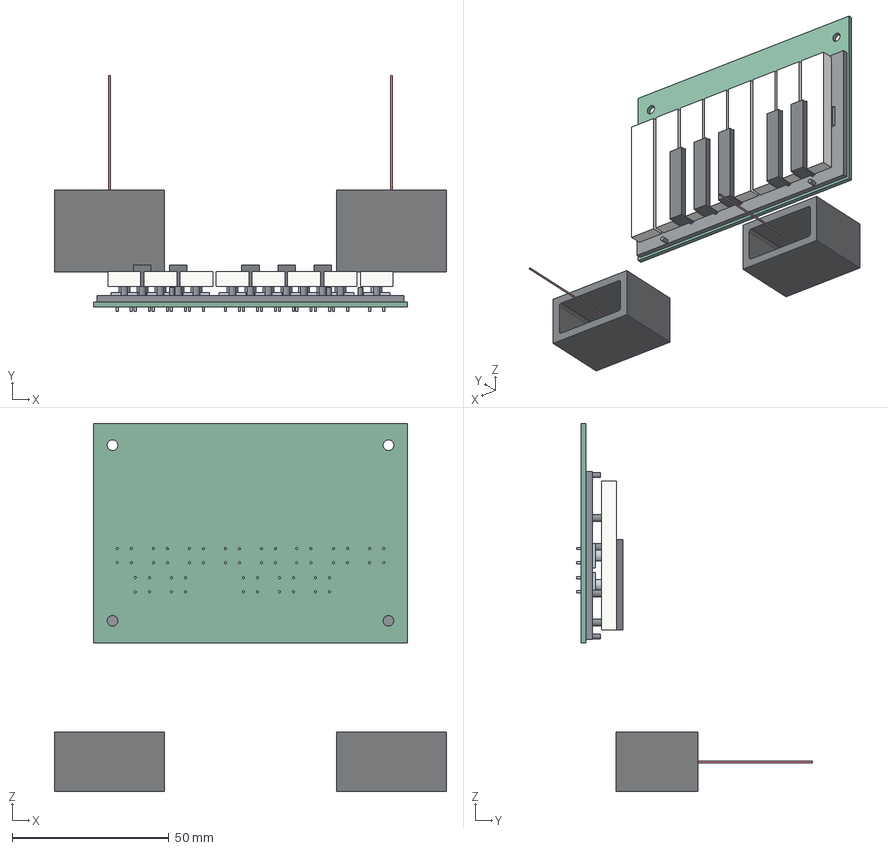
[picture p122: CAD file, 2026-11-01]
fpga_hardware/enclosure/STEP/fit_assembly.step
125.0 x 75.2 x 117.5 mm
keybed_plate
white_key_1
white_key_2
white_key_3
white_key_4
white_key_5
white_key_6
white_key_7
white_key_8
black_key_after_white_1
black_key_after_white_2
black_key_after_white_4
black_key_after_white_5
black_key_after_white_6
tof_right:mount x 2
pcb_placeholder_envelope
switch_black_after_white_6:body x 13
switch_black_after_white_6:plunger x 13
switch_black_after_white_6:pin_4 x 52
tof_right:vb22b_reference x 2
tof_right:detection_axis x 2
