wongben2333-crypto/26Embedded/fpga_hardware/enclosure/STEP/assembly.step

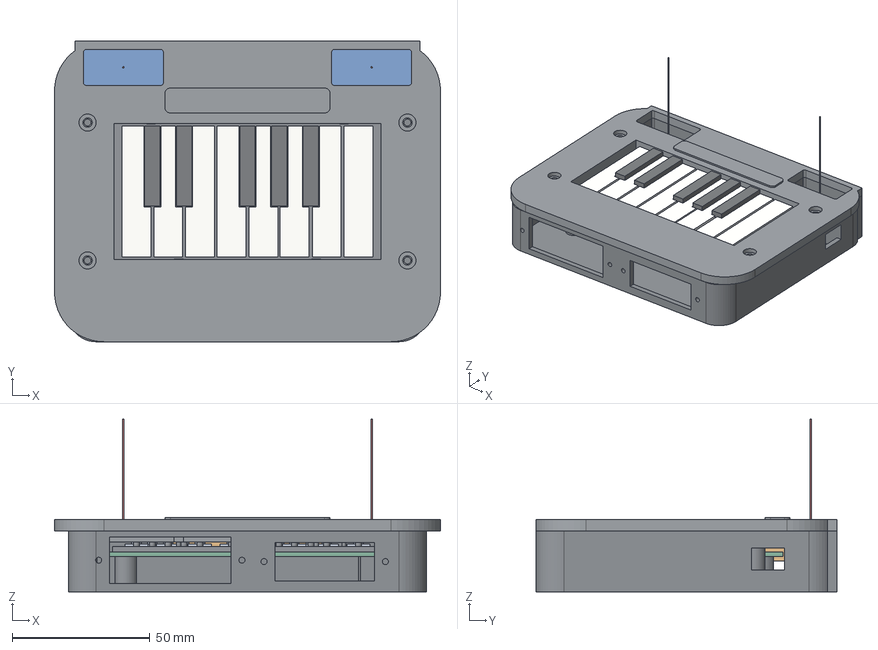
[picture p123: CAD file, 2026-11-01]
fpga_hardware/enclosure/STEP/assembly.step
140.0 x 109.0 x 62.7 mm
bottom_shell_part
top_shell_part
keybed_plate
white_key_1
white_key_2
white_key_3
white_key_4
white_key_5
white_key_6
white_key_7
white_key_8
black_key_after_white_1
black_key_after_white_2
black_key_after_white_4
black_key_after_white_5
black_key_after_white_6
switch_white_1:body
switch_white_1:plunger
switch_white_1:pin_1
switch_white_1:pin_2
switch_white_1:pin_3
switch_white_1:pin_4
switch_white_2:body
switch_white_2:plunger
switch_white_2:pin_1
switch_white_2:pin_2
switch_white_2:pin_3
switch_white_2:pin_4
switch_white_3:body
switch_white_3:plunger
switch_white_3:pin_1
switch_white_3:pin_2
switch_white_3:pin_3
switch_white_3:pin_4
switch_white_4:body
switch_white_4:plunger
switch_white_4:pin_1
switch_white_4:pin_2
switch_white_4:pin_3
switch_white_4:pin_4
switch_white_5:body
switch_white_5:plunger
switch_white_5:pin_1
switch_white_5:pin_2
switch_white_5:pin_3
switch_white_5:pin_4
switch_white_6:body
switch_white_6:plunger
switch_white_6:pin_1
switch_white_6:pin_2
switch_white_6:pin_3
switch_white_6:pin_4
switch_white_7:body
switch_white_7:plunger
switch_white_7:pin_1
switch_white_7:pin_2
switch_white_7:pin_3
switch_white_7:pin_4
switch_white_8:body
switch_white_8:plunger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
