wongben2333-crypto/26Embedded/fpga_hardware/enclosure/3MF/fit_sample.3mf

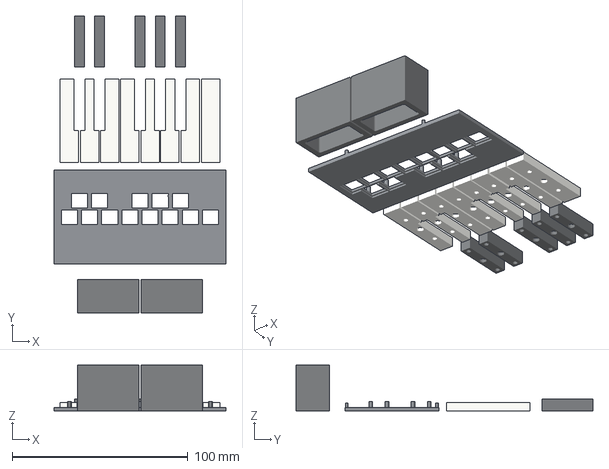
[picture p124: CAD file, 2026-11-01]
fpga_hardware/enclosure/3MF/fit_sample.3mf
98.0 x 169.0 x 26.2 mm
