wongben2333-crypto/26Embedded/fpga_hardware/enclosure/DXF/pcb_layout_floorplan.dxf

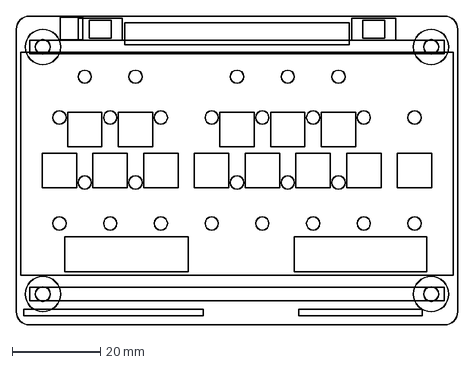
[picture p125: CAD file, 2026-11-01]
fpga_hardware/enclosure/DXF/pcb_layout_floorplan.dxf
100.0 x 70.0 mm
