wongben2333-crypto/26Embedded/fpga_hardware/enclosure/exports/jlc_2026-10-28/keybed_parts/black_key_02_Ds4.stl

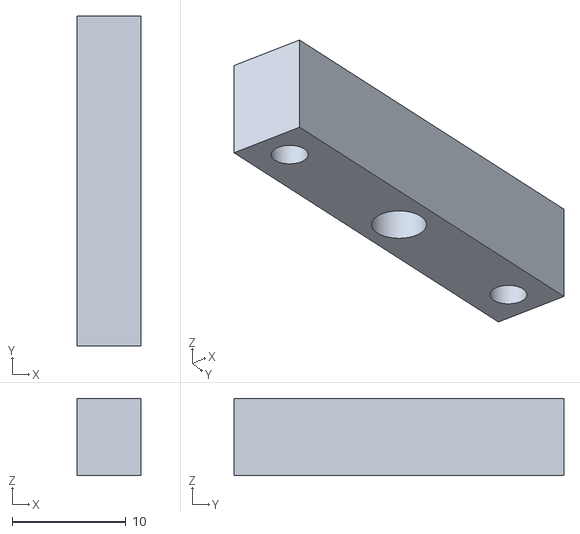
[picture p126: CAD file, 2026-11-01]
fpga_hardware/enclosure/exports/jlc_2026-10-28/keybed_parts/black_key_02_Ds4.stl
5.62 x 29.0 x 6.80
