wongben2333-crypto/26Embedded/fpga_hardware/enclosure/references/original_stl/switch.stl

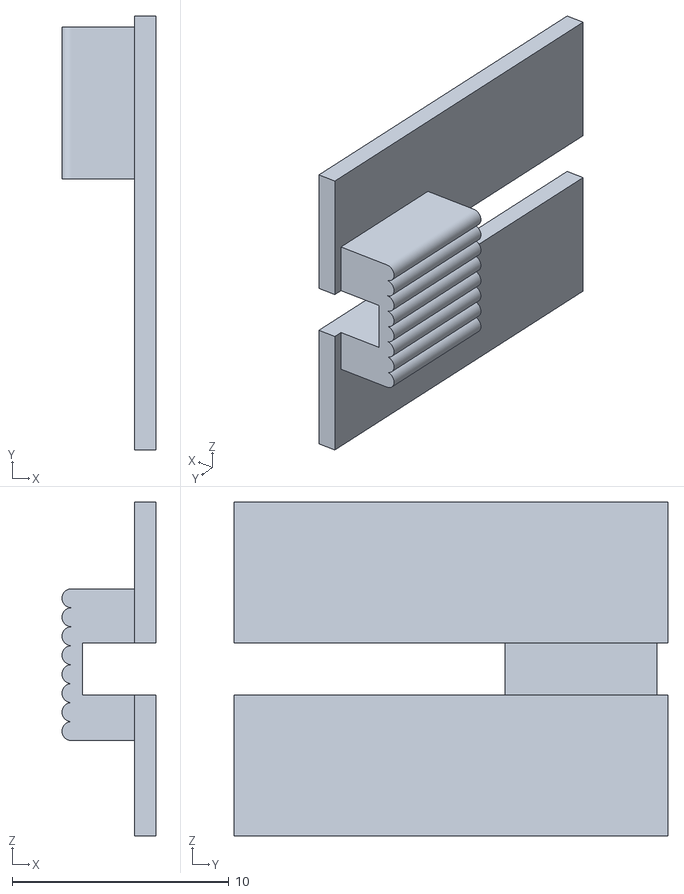
[picture p127: CAD file, 2026-11-01]
fpga_hardware/enclosure/references/original_stl/switch.stl
4.34 x 20.0 x 15.4
