wongben2333-crypto/26Embedded/fpga_spark/lcd_test/hardware/enclosure/DXF/board_outline.dxf

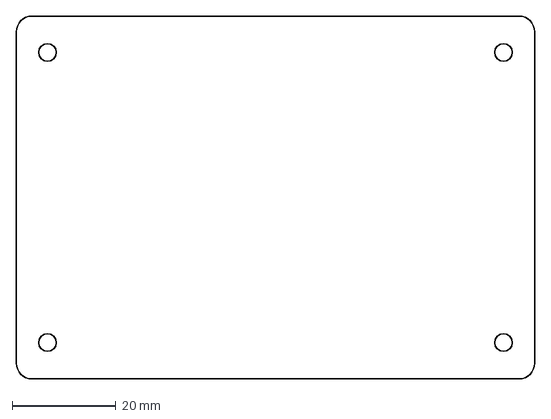
[picture p128: CAD file, 2026-11-03]
fpga_spark/lcd_test/hardware/enclosure/DXF/board_outline.dxf
100.0 x 70.0 mm
