wongben2333-crypto/26Embedded/fpga_spark/lcd_test/hardware/enclosure/exports/jlc_2026-10-28/bottom_shell_single.stl

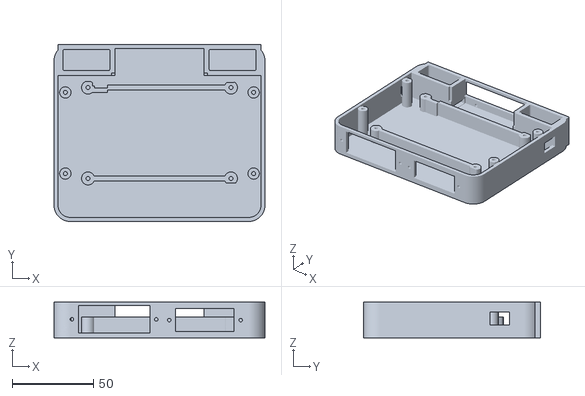
[picture p129: CAD file, 2026-11-03]
fpga_spark/lcd_test/hardware/enclosure/exports/jlc_2026-10-28/bottom_shell_single.stl
130.0 x 109.0 x 22.1
