wongben2333-crypto/26Embedded/fpga_spark/lcd_test/hardware/enclosure/exports/jlc_2026-10-28/keybed_parts/white_key_08_C5.stl

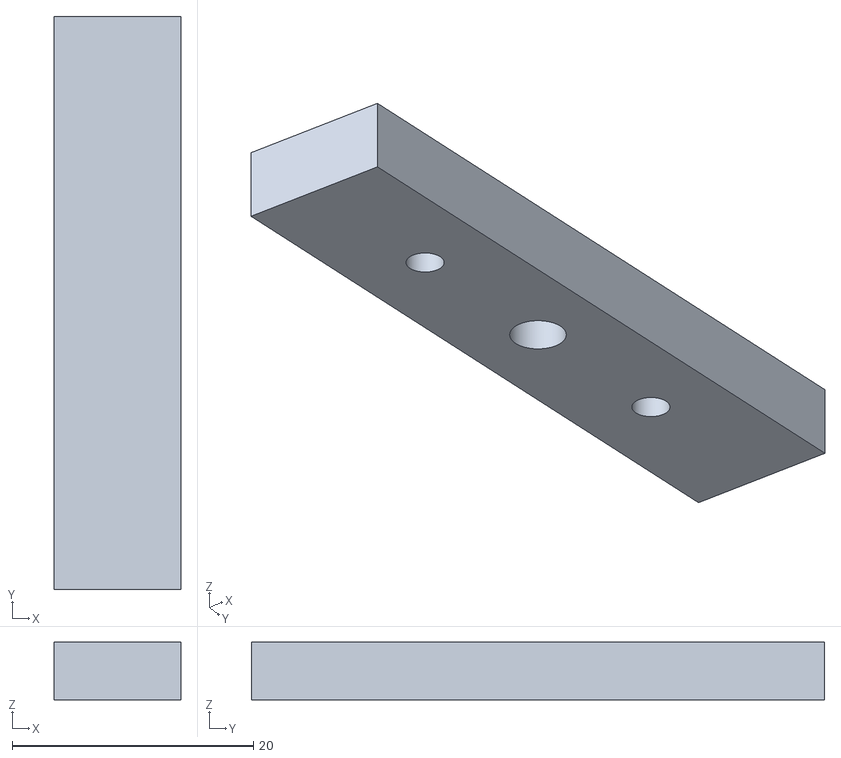
[picture p130: CAD file, 2026-11-03]
fpga_spark/lcd_test/hardware/enclosure/exports/jlc_2026-10-28/keybed_parts/white_key_08_C5.stl
10.5 x 47.5 x 4.80
