wongben2333-crypto/26Embedded/fpga_spark/P34-P40转接板/Schematic1/P1.dxf

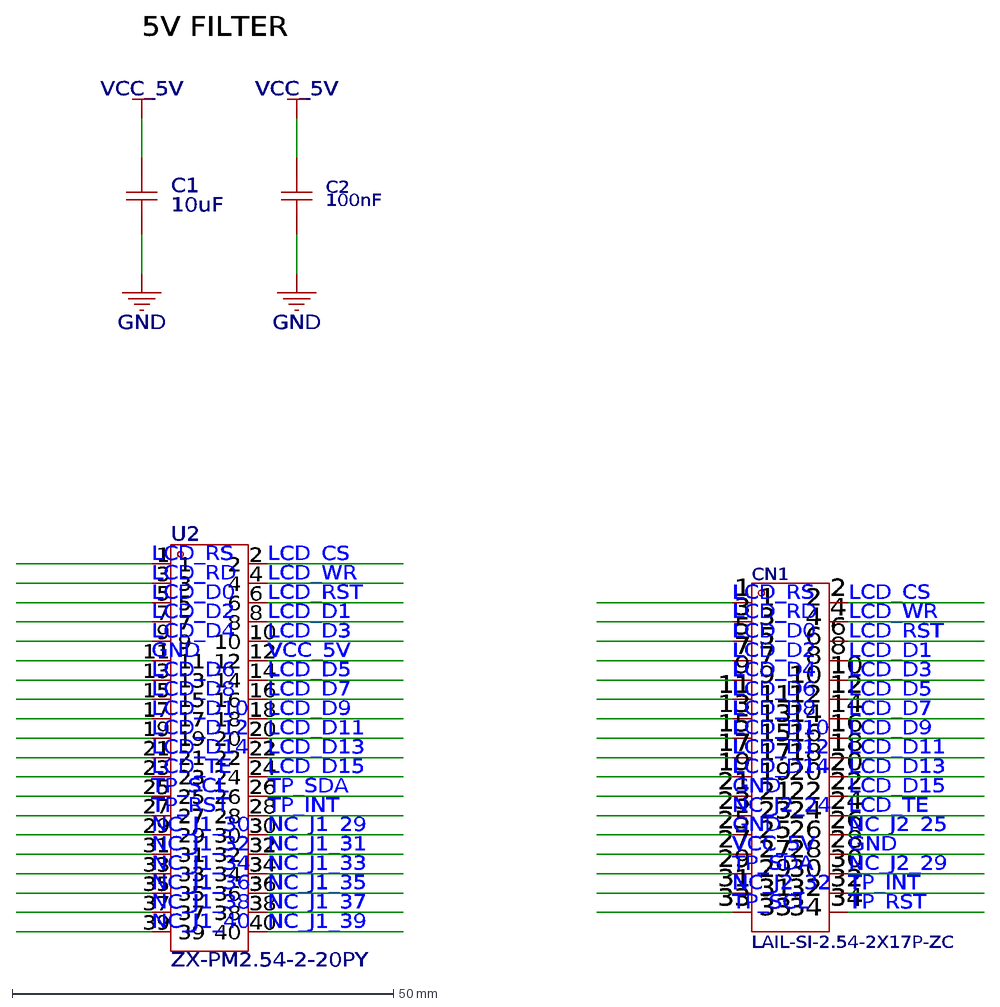
[picture p131: CAD file, 2026-10-26]
fpga_spark/P34-P40转接板/Schematic1/P1.dxf
U2
ZX-PM2.54-2-20PY
1
40
3
38
5
36
7
34
9
32
11
30
13
28
15
26
17
24
19
22
21
20
23
18
25
16
27
14
29
12
31
10
33
8
35
6
37
4
39
2
VCC_5V
GND
100nF
C2
5V FILTER
LAIL-SI-2.54-2X17P-ZC
CN1
C1
10uF
LCD_RS
NC_J1_39
LCD_RD
NC_J1_37
LCD_D0
NC_J1_35
LCD_D2
NC_J1_33
LCD_D4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
