wongben2333-crypto/26Embedded/hardware/enclosure/3D_PCB1_2026-10-27.step

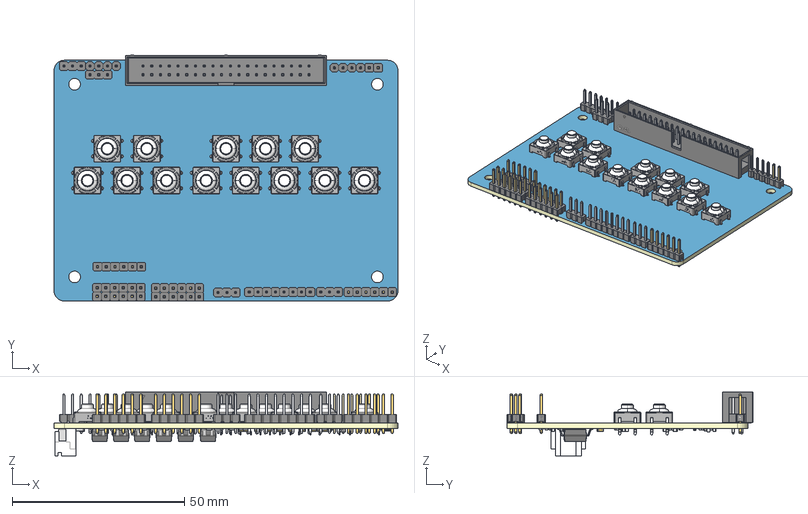
[picture p132: CAD file, 2026-11-04]
hardware/enclosure/3D_PCB1_2026-10-27.step
100.0 x 71.6 x 18.5 mm
Board~s4bF
TopCopper~s4bF
BottomCopper~s4bF
TopSilkscreen~s4bF
BottomSilkscreen~s4bF
TopFpcStiffener~s4bF
BottomFpcStiffener~s4bF
C0603~C0603_L1.6-W0.8-H0.8~eTHU x 29
R0603~R0603~DCkW x 57
OPTO-SMD-4_L4.6-W6.5-P2.54-LS10.3-TL~OPTO-SMD-4_L4.6-W6.5-H3.6-LS10.2-P2.54~9Leq x 6
F0603~F0603_L1.7-W0.9-H0.7~ya3d
HDR-TH_3P-P2.54-V-M_PZ254V-11-03P~HDR-TH_3P-P2.54-V-M_PZ254V-11-03P~j6Zq x 4
CONN-SMD_LAIL-PHC2.54-2P-01-XH-LT~CONN-SMD_LAIL-PHC2.54-2P-01-XH-LT~RpTz
CONN-TH_LAIL-PZ2.54-4P-L~CONN-TH_LAIL-PZ2.54-4P-L~AMew x 2
HDR-TH_2P-P2.54-V-M-1~HDR-M-2.54_1x2~2TJL
SW-TH_4P-L7.8-W7.8-P4.50-LS8.5~SW-TH_4P-L7.8-W7.8-P4.50-LS8.5~KNlX x 13
LED0603-RD~LED0603-RD~zyBL
HDR-TH_6P-P2.54-V-M-1~HDR2.54-M-LI-1X6P~9xaO x 6
HDR-TH_8P-P2.54-V-M~HDR-TH_8P-P2.54-V-M~5GOY
CAP-SMD_L1.6-W0.8-1~CAP-SMD_L1.6-W0.8-1~OCeg x 2
CONN-TH_40P-P2.54_LX_XDFH-0254-2X20P~CONN-TH_40P-P2.54_LX_XDFH-0254-2X20P~e96p
