wongben2333-crypto/26Embedded/fpga_hardware/enclosure/exports/jlc_2026-10-28/keybed_parts/white_key_05_G4.stl

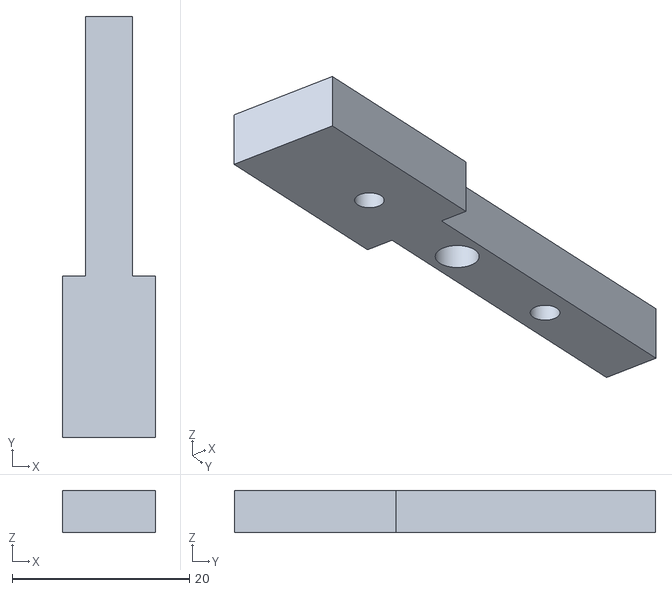
[picture p133: CAD file, 2026-11-01]
fpga_hardware/enclosure/exports/jlc_2026-10-28/keybed_parts/white_key_05_G4.stl
10.5 x 47.5 x 4.80
