wongben2333-crypto/26Embedded/fpga_hardware/enclosure/references/original_stl/piano keyboard.stl

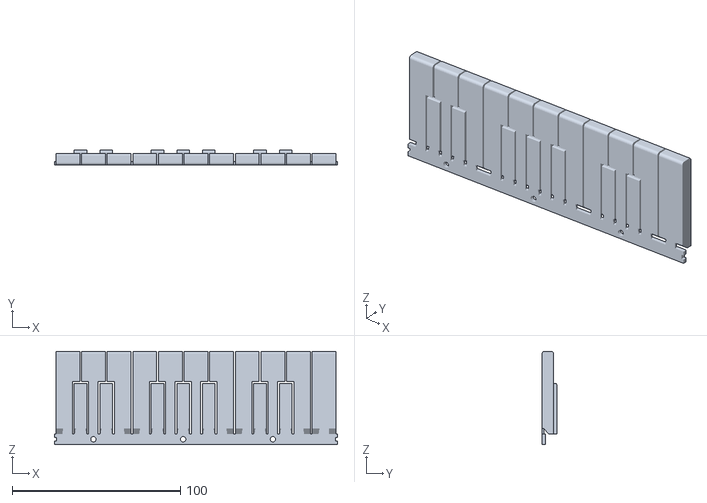
[picture p134: CAD file, 2026-11-01]
fpga_hardware/enclosure/references/original_stl/piano keyboard.stl
168.2 x 8.80 x 55.5
