wongben2333-crypto/26Embedded/fpga_hardware/enclosure/STEP/keybed.step

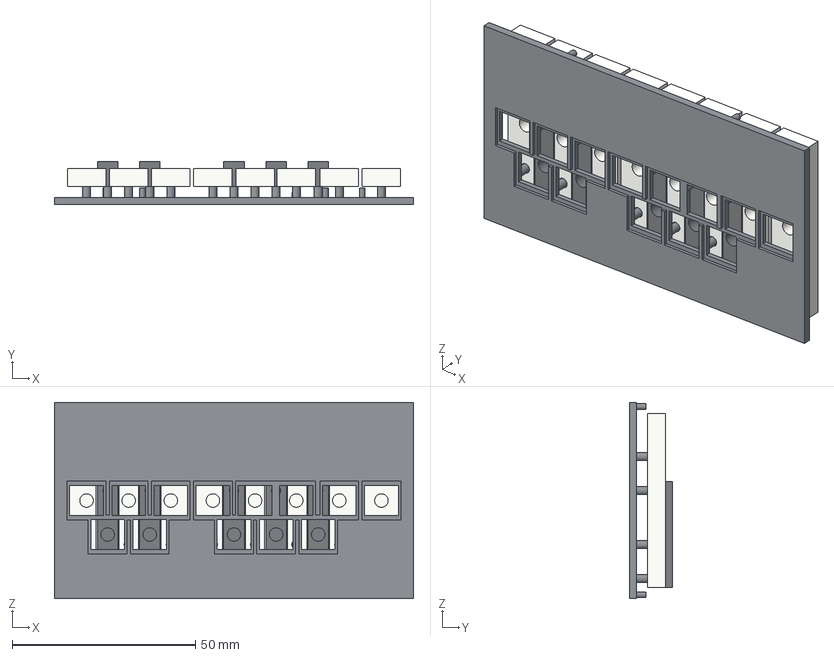
[picture p135: CAD file, 2026-11-01]
fpga_hardware/enclosure/STEP/keybed.step
98.0 x 11.8 x 53.6 mm
keybed_plate
white_key_1
white_key_2
white_key_3
white_key_4
white_key_5
white_key_6
white_key_7
white_key_8
black_key_after_white_1
black_key_after_white_2
black_key_after_white_4
black_key_after_white_5
black_key_after_white_6
