wongben2333-crypto/26Embedded/fpga_spark/lcd_test/hardware/enclosure/exports/jlc_2026-10-28/top_shell_single.stl

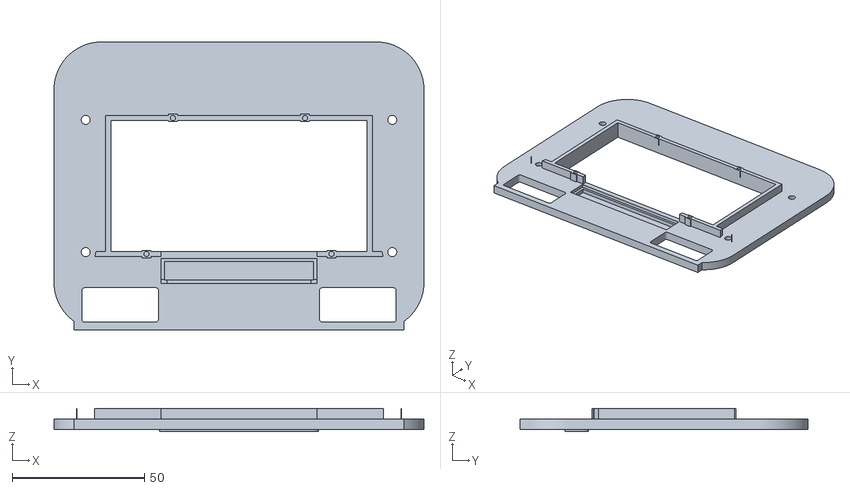
[picture p136: CAD file, 2026-11-03]
fpga_spark/lcd_test/hardware/enclosure/exports/jlc_2026-10-28/top_shell_single.stl
140.0 x 109.0 x 8.88
