wongben2333-crypto/26Embedded/fpga_spark/lcd_test/hardware/enclosure/STEP/tof_mount.step

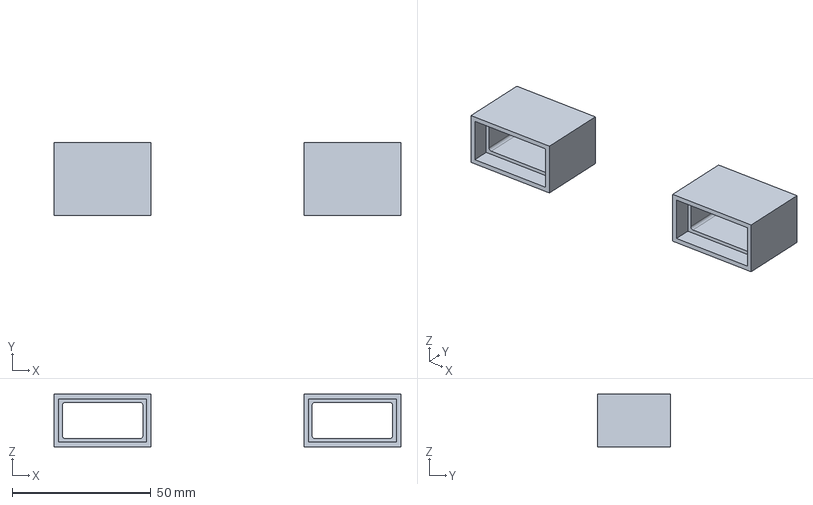
[picture p137: CAD file, 2026-11-03]
fpga_spark/lcd_test/hardware/enclosure/STEP/tof_mount.step
125.0 x 26.2 x 19.0 mm
tof_right:mount x 2
