wongben2333-crypto/26Embedded/fpga_spark/lcd_test/hardware/enclosure/STEP/pcb_envelope.step

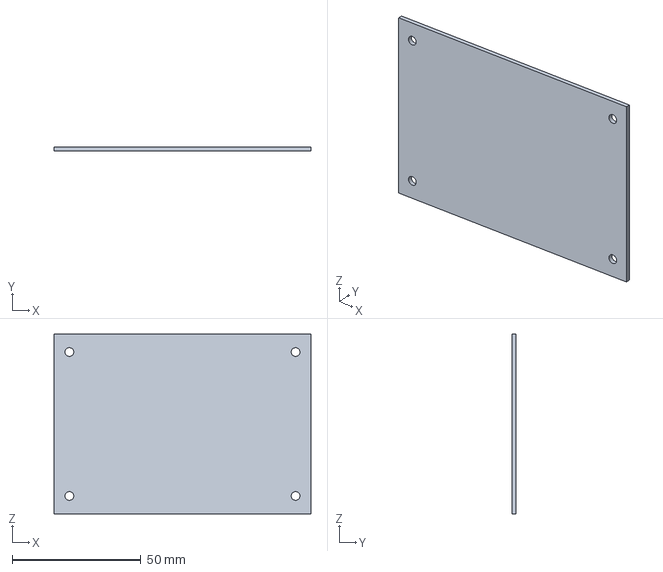
[picture p139: CAD file, 2026-11-03]
fpga_spark/lcd_test/hardware/enclosure/STEP/pcb_envelope.step
100.0 x 1.60 x 70.0 mm
