wongben2333-crypto/26Embedded/fpga_spark/lcd_test/hardware/enclosure/exports/jlc_2026-10-28/keybed_parts/keybed_plate.stl

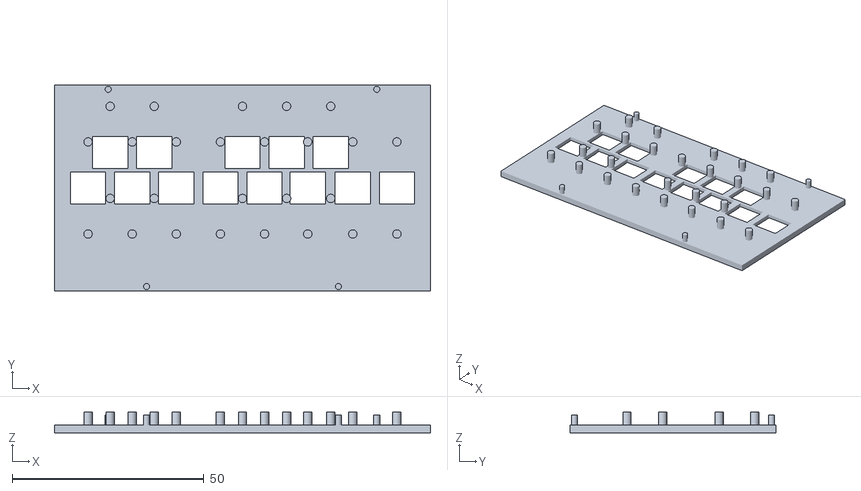
[picture p140: CAD file, 2026-11-03]
fpga_spark/lcd_test/hardware/enclosure/exports/jlc_2026-10-28/keybed_parts/keybed_plate.stl
98.0 x 53.6 x 5.40
