wongben2333-crypto/26Embedded/(list of files, cad)

Other CAD files:
fpga_spark/lcd_test/hardware/enclosure/STEP/fit_sample.step
fpga_spark/lcd_test/hardware/enclosure/exports/jlc_2026-10-28/keybed_parts/white_key_02_D4.stl
fpga_hardware/enclosure/exports/jlc_2026-10-28/keybed_parts/black_key_01_Cs4.stl
fpga_hardware/enclosure/STEP/bottom_shell.step
fpga_spark/lcd_test/hardware/enclosure/exports/jlc_2026-10-28/keybed_parts/black_key_04_Gs4.stl
fpga_spark/lcd_test/hardware/enclosure/STEP/top_shell.step
fpga_spark/lcd_test/hardware/enclosure/exports/jlc_2026-10-28/keybed_parts/white_key_04_F4.stl
fpga_hardware/enclosure/exports/jlc_2026-10-28/keybed_parts/white_key_03_E4.stl
fpga_spark/lcd_test/hardware/enclosure/exports/jlc_2026-10-28/keybed_parts/white_key_01_C4.stl
fpga_hardware/enclosure/exports/jlc_2026-10-28/keybed_parts/white_key_06_A4.stl
fpga_spark/lcd_test/hardware/enclosure/exports/jlc_2026-10-28/keybed_parts/black_key_03_Fs4.stl
fpga_hardware/enclosure/3MF/bottom_shell.3mf
fpga_hardware/enclosure/3MF/keybed.3mf
fpga_hardware/enclosure/STL/bottom_shell.stl
fpga_hardware/enclosure/STL/fit_sample.stl
fpga_hardware/enclosure/STL/keybed.stl
fpga_spark/lcd_test/hardware/enclosure/3MF/tof_mount.3mf
fpga_spark/lcd_test/hardware/enclosure/3MF/top_shell.3mf
fpga_spark/lcd_test/hardware/enclosure/STL/tof_mount.stl
fpga_spark/lcd_test/hardware/enclosure/STL/top_shell.stl
