wongben2333-crypto/26Embedded/fpga_hardware/docs/INPUTS-WIRING.md

# 整合固件接线与验收（`INPUTS_60K_*`）

> 当前位流：`INPUTS_60K_20261022-211920.fs`，User Code **`0x1A2B00B7`**
> 固件源：`hw_bringup/rtl/inputs_top.v`，约束：`hw_bringup/constr/hw_inputs.cst`
> 内容：**13 键 + 6 光电 + 2 只 ToF + 2 只 EC11** 全部读出来，串口 115200。
> 已实测：13 键 ✅、光电 1 路 ✅、ToF A ✅、EC11 #1 ✅（其余路未接线）

---

## 1. 串口输出格式

每 ~40 ms 一行（60 字节，含 CRLF）：

```
K=1FFF P=3F A=037B B=FFFF E1=0000 E2=0000 S=F @000002CAAB
```

| 字段 | 含义 | 空闲值 | 触发时 |
|---|---|---|---|
| `K=` | 13 位键状态，bit n = 键 n | `1FFF` | 按下 → 对应位变 **0** |
| `P=` | 6 位光电状态，bit n = 光电 n | `3F` | 挡光 → 对应位变 **0** |
| `A=` | ToF #1 距离，毫米（十六进制） | 实测值 | 手移近 → 变小 |
| `B=` | ToF #2 距离 | `FFFF`（未接） | — |
| `E1=` | EC11 #1 累计计数，16 位有符号（补码） | `0000` | 正转增加、反转减少（每格 ±4） |
| `E2=` | EC11 #2 累计计数（未接） | `0000` | — |
| `S=` | **诊断字段**：4 位 = `A1 B1 A2 B2`（两路编码器的 A/B 原始电平） | `F` | 转动时在 `F/7/3/B` 之间变化 |

`A`/`B` 显示 `FFFF` = 那一路 I2C 没有应答。

---

## 2. J13 逐针表（2×20，2.54 mm）

### 2.1 13 个键（第 1–10、13、14、15 脚）

| 键 | J13 针 | 球号 | K 的位 |
|---:|---:|---|---:|
| 1 | 1 | E14 | bit0 |
| 2 | 2 | E13 | bit1 |
| 3 | 3 | C15 | bit2 |
| 4 | 4 | C14 | bit3 |
| 5 | 5 | B13 | bit4 |
| 6 | 6 | C13 | bit5 |
| 7 | 7 | A14 | bit6 |
| 8 | 8 | A13 | bit7 |
| 9 | 9 | B16 | bit8 |
| 10 | 10 | B15 | bit9 |
| 11 | 13 | A16 | bit10 |
| 12 | 14 | A15 | bit11 |
| 13 | 15 | A20 | bit12 |

- 每键**一端接对应 J13 脚，另一端全部并到 GND**
- FPGA 内部上拉，不需要外接电阻；空闲读 1，按下读 0

### 2.2 6 路光电（第 16–21 脚）

| 光电 | J13 针 | 球号 | P 的位 |
|---:|---:|---|---:|
| 1 | 16 | B20 | bit0 |
| 2 | 17 | A21 | bit1 |
| 3 | 18 | B21 | bit2 |
| 4 | 19 | B18 | bit3 |
| 5 | 20 | B17 | bit4 |
| 6 | 21 | C17 | bit5 |

### 2.3 EC11 编码器（第 22–27 脚）

| 信号 | J13 针 | 球号 |
|---|---:|---|
| EC11 #1 A | 22 | D17 |
| EC11 #1 B | 23 | A19 |
| EC11 #2 A | 24 | A18 |
| EC11 #2 B | 25 | D15 |
| EC11 #1 按键 | 26 | D14 |
| EC11 #2 按键 | 27 | D16 |

**实测这只模块是 5 脚：`VCC GND A C B`，其中 C 是公共端（内部已接 GND），没有按键。**

接法：`VCC → +3.3V`、`GND → GND`、`A → J13-22`、`B → J13-23`、`C → 不接`。

> ⚠️ **VCC 必须 3.3V**；若模块内部是 5V 上拉，A/B 高电平会到 5V，接 FPGA 前必须先量。

---

## 3. 光电电平转换电路（每路一份，已实测）

E3F-20C1 的输出**不是纯开集**：内部还有一个约 **15.6 kΩ 上拉到自己的 +12V**，
所以黑线摆幅是 **0 V ↔ 12 V**，**直接接 FPGA 会烧 IO**。

用 **S9012（PNP）射极跟随器**：

```
              +3V3 (J8-1)
                │
              [10k]
                │
  黑线 ──[47k]──┼──── 发射极 E ────┬──── FPGA 输入（J13-16..21）
                │                  │
              [47k]          集电极 C ──── GND
                │
               GND
          （基极 B 接两个 47k 的中点）
```

**实测**：未遮挡 → 发射极 **3.3 V**（P 位=1）；遮挡 → **0.6 V**（P 位=0）。
0.6 V 低于 FPGA 的 VIL（0.8 V），可用；想留余量可把 10k 换 22k。

**元件（每路）**：S9012 ×1、47 kΩ ×2、10 kΩ ×1。

### 12 V 供电

1. 12 V 正极 → 所有发射器棕线 + 接收器棕线
2. 12 V 负极 → 所有发射器蓝线 + 接收器蓝线
3. 从同一个 0V 点**只拉一根线**到板子 GND

> 6 套 ≈ 1.5–2.4 A，电源需 ≥2 A。

---

## 4. ToF 接线（两只，各一条独立 I2C 总线）

| 总线 | 板子 SCL | 板子 SDA | 传感器 |
|---|---|---|---|
| A（**当前 S5 用，2026-10-24 起**） | **J13-24（A18）** | **J13-25（D15）** | 第 1 只（已接） |
| A（旧位置，仅 3.3 kHz 时可用） | ~~AB22（J8-10）~~ | ~~Y21（J8-11）~~ | — |
| B | AA21（J8-8） | AB21（J8-9） | 第 2 只（未接） |

每只都要：**SCL/SDA 各 4.7 kΩ 上拉到 3V3，各串 330 Ω**；3V3→红，GND→黑。

- 两只都保留出厂地址 **0x52**，靠"各占一条总线"避免地址冲突
- 器件 ID 寄存器 `0x03` = **0x4A**
- 距离寄存器 **`0x00`=低字节、`0x01`=高字节（小端，mm）** —— 与规格书相反

> ⚠️ **2026-10-23 真机实测更正（S5 整合时发现）**：写指针 0x00 后**连续读 2 字节**
> （自动递增突发读）时，**第一字节是高字节、第二字节才是低字节**——与上表的
> 单寄存器读顺序相反。证据：909 mm 的距离在突发读里到达顺序是 `03 8D`。
> 所以突发读的拼装是 `{第一字节, 第二字节}`，写反会得到 `8D03`（36099 mm）。
> `inputs_top.v` 的 `d_lo/d_hi` 捕获有 off-by-one，恰好与这个顺序抵消，
> 所以它当年读数看起来是对的——不要照抄它的捕获时序。

> ⚠️ **I2C 电气注意（2026-10-24，S5 实测）**：SCL/SDA 原来在 **AB22/Y21**（J8），
> 与音频 I2S（Y17/AB17/AA16）**同属 BANK7**。用 `DRIVE=8` + 10 kHz 轮询时，引脚翻转会把
> DAC 输出搅成尖锐噪声（音频完全不可用，与传感器是否供电无关）。
> **已验证的最终方案：把 I2C 挪到 J13-24(A18)/J13-25(D15)**（SDRAM0 组，远离音频）+
> `DRIVE=2`，**恢复到 10 kHz 依然完全干净**（位流 `MODE3_..._20261024-012557`）。
> 折中方案（不挪线）：留在 J8 但 `DRIVE=2` + `SCL ≤ 3.3 kHz` 也干净。
> 排查方法：`QUIET` 参数冻结 I2C/遥测后声音即恢复干净。

---

## 5. 调试串口

| USB-TTL | 板子 |
|---|---|
| GND | J8-3/4 或 J13-12 |
| RX | **P19（J9 第 11 脚）** |
| VCC | **不接** |

115200 8N1，USB-TTL 必须切 **3.3 V** 档。

---

## 6. 验收结果（2026-10-22 实测）

| # | 项目 | 结果 |
|---:|---|---|
| 1 | 13 键逐个按下 | ✅ 每位独立变化，全按 `K=0000` |
| 2 | 光电 1 挡/放 | ✅ `P=3F ↔ 3E` |
| 3 | ToF A 手移 | ✅ `A=037A..037B` 跟随 |
| 4 | EC11 #1 旋转 | ✅ `S` 在 `F/7/3/B` 间变化，`E1` 每格 ±4 |
| 5 | 摇线 | 未出现误触发 |

---

## 7. 故障对照表

| 现象 | 原因 |
|---|---|
| 完全没有 `K=` 行 | 调试串口没接对（P19 → USB-TTL RX，共地） |
| K 恒 `1FFF`，按键无效 | 键没接到对应 J13 脚 / 公共端没接 GND |
| K 某一位恒 0 | 该脚被短到 GND |
| P 恒 `3F`，挡光无反应 | S9012 电路没供电 / E、C 接反 / 黑线没接到 47k |
| P 恒 `00` | 光电输出一直 0V（12V、光束对准） |
| A 或 B = `FFFF` | 该路 I2C 不应答：4.7k 上拉缺失、SDA/SCL 接反、模块没供电 |
| `E1` 只在 ±1 抖动、不累加 | **A/B 只有一根在动** → 看 `S` 哪一位不变，检查那根线 |
| `S` 一直 `F` | A/B 都没信号（VCC 没接 / 线断） |
| `S` 乱跳（不转也跳） | 引脚浮空拾噪声（空脚正常现象） |
