wongben2333-crypto/26Embedded/fpga_spark/lcd_test/docs/hardware/MANUFACTURING-AND-ACCEPTANCE.md

# 制造、装配与验收要求

> 状态：首件准备清单；存在阻断项，尚不能直接宣称可量产  
> 关联 PCB 包：`Gerber_PCB1_2026-10-27.zip`  
> 关联外壳：`enclosure/STEP/assembly.step`、`enclosure/3MF/*.3mf`

## 1. 采购与首件范围

首件应至少采购：

| 部件 | 规格 | 数量 | 备注 |
|---|---|---:|---|
| Tang Mega 60K Dock | GW5AT-60B，device version B | 1 | 使用原板音频与 J13 |
| 输入 PCB | 100×70×1.6 mm，2 层 | 1 | 先打裸板，不建议未审 BOM 直接贴片 |
| 四脚轻触开关 | 8.5×7.8 mm 最大本体包络，4.5 mm 针距，总高 5.0，行程约 2.0 | 13 | 需用实物确认正式封装和柱塞 |
| E3F-20C1 | 12 V 对射光电，三线 | 6 | 棕 +12V、蓝 0V、黑输出 |
| VB22B | 31×15×6.2 mm，3.3 V I2C 0x52 | 2 | 坐标核对手册前先以实物为准 |
| EC11 | 5 脚，A/B 正交，无按压 | 4 | VCC 必须 3.3 V |
| PC817 | DIP/SMD 版本按最终 BOM | 6 | 12 V 输入隔离 |
| 40P IDC 成品排线 | 2.54 mm，两端预压接，线宽约 50.8 mm | 1 | 先复核插头总长/高度/护套 |
| M3 塑料自攻螺丝 | M3×10 上下壳，M3×8 PCB | 8 或以上 | 底孔 Ø2.5，不用热熔螺母 |
| 线束/压线片 | 光电、12 V、四组 EC、ToF 四芯线 | 1 套 | 需按实际线径和弯曲半径选型 |
| 3.3 V/12 V 电源 | 12 V 光电独立电源，3.3 V 来自底板 | 1 套 | 12 V 不得进入 FPGA IO |

首件只打印整壳，不单独追打 `fit_sample`。配合样件仍保留用于以后补打和数字复核，
但首件的机械风险由整壳一次性承担，所以装配前必须做尺寸检查和试装记录。

## 2. PCB 下单要求

### 2.1 基材和工艺

- FR-4，Tg 130 或以上。
- 2 层，1.6 mm，外层 1 oz。
- 外形 100×70 mm，四角 R3。
- 绿色阻焊、白色字符、无铅喷锡；预算允许可选沉金。
- 4 个 Ø3.4 mm NPTH 安装孔，位置 `(-44,±28)`、`(+44,±28)`。
- 普通信号线宽/间距 0.20/0.20 mm，常规信号建议 0.25 mm。
- 3V3 主干 ≥0.50 mm；12 V 主干 ≥0.80 mm。
- 12 V/GND12 与 3V3/逻辑区域至少 1.5 mm 间距或隔离带。
- 连接器附近使用通孔或机械加强焊盘，不允许仅由细走线承受插拔力。

### 2.2 交付文件必须包含

1. 嘉立创 EDA 工程源文件。
2. Gerber RS-274X 和 Excellon 钻孔文件。
3. ERC=0、DRC=0 的设计报告。
4. BOM，明确 DNP、替代料、封装和贴片面。
5. 顶/底贴片坐标、装配图和 3D 装配图。
6. 板框 1:1 DXF。
7. 网表与 [NETLIST.md](NETLIST.md) 的逐网络核对结果。
8. 板级 3D STEP 和整机回装截图/检查结果。

现有 Gerber 包只具备第 2 项的一部分和第 8 项的 STEP；不能把阶段审查报告代替正式
设计输出。

### 2.3 当前制造包阻断项

- Gerber 双钻孔文件仍有 479 个重复坐标；下单前必须去重或让板厂书面确认。
- 缺 ERC/DRC 报告。
- 缺可采购 BOM、贴片坐标、DNP 和顶/底装配图。
- 需要确认实际板厂的 NPTH/PTH 钻孔属性识别。
- 实际 IDC 插头、压线片和线缆弯曲半径未确认。
- 键床已有四个水平定位柱，但垂直防上跳和实际插拔手感仍需首件验证。

在这些项目关闭前，可以继续做机械数字复核，不应把当前包当作“已放行量产板”。

## 3. PCBA 策略

首版建议分两档：

1. **裸板首件**：先只打 PCB，人工焊接 13 键、PC817、阻容、连接器和 F1，便于
   逐通道量测和修改。
2. **小批量 PCBA**：在 BOM、封装、DNP、极性、坐标和首件测试全部闭环后，再交给
   贴片厂。特别核对 PC817 方向、J13 PIN1、J13-11 NC、H3 极性、F1 和所有
   三针/四针连接器。

不把当前未完成 BOM 的 3D STEP 当作可直接 SMT 的装配数据。3D 中的 13 SW、
31 C、57 R、6 U、14 H、CN1、CN2、F1、LED1 只是标签盘点，不是完整可采购清单。

## 4. 外壳打印要求

### 4.1 切片设置基线

- 材料：PETG。
- 层高：0.2 mm。
- 下壳：当前姿态直接打印，悬垂较低；检查前侧大开口上缘桥接。
- 上壳：建议可见顶面朝下，ToF 导光筒内部使用树状支撑。
- 支撑接触面留合理间隙，拆支撑后检查导光筒内壁和光窗边缘。
- 上下壳均需保持水密单实体；打印后检查螺丝柱、支撑筋和 40P 拱盖顶部壁厚。

### 4.2 打印服务

当前模型不应依赖嘉立创免费 3D 打印券：

- 上壳 X 尺寸 140 mm。
- 下壳 X 尺寸 130 mm。
- 两者均超过常见的 100 mm 单轴免费门槛。
- 下壳体积约 67.1 cm³，接近常见的 70 cm³ 免费上限。

下单前应复核当期活动规则、最大成型尺寸、材料、壁厚和支撑政策；如平台自动报价
判定不符合，改为付费打印或分件方案，不要试图通过缩小模型来“套券”。

## 5. 首件装配顺序

1. 清点 PCB、开关、ToF、EC11、光电、IDC 插头、M3 螺丝和壳体。
2. 对 PCB 做外观、板框、四孔、J13 方向和短路检查。
3. 在空壳中试放 PCB、键床、13 个开关和 ToF，不接电。
4. 先将 ToF 放入下壳承托座，走内侧窄边线，不拉紧。
5. 装 PCB 和四角 M3×8 自攻螺丝；检查底部支撑筋和顶面前带净空。
6. **强制步骤**：将 H5 在 `X=-37.34..-24.64`、`Y≈-25.02` 的朝上残留
   引脚剪平至 PCB 上表面或更低；未执行时不得安装键床。
7. 装键床和键帽，逐键按压，记录行程、回弹、倾斜和上跳。
8. 连接 40P 内外插头，穿出后侧口并安装应力释放；合上上壳。
9. 检查 ToF 上下筒接缝、光窗、左右辅助窗和上下壳错边。
10. 机械全部通过后，先加 3.3 V，再加限流 12 V，最后接 FPGA。

## 6. 上电和通道验收

### 6.1 不通电检查

| 项目 | 合格判据 |
|---|---|
| 12 V 对 GND12 | 不短路 |
| 3.3 V 对 GND | 不短路 |
| J13-11 | 与任何网络无连接 |
| J13-12 | 与逻辑 GND 连通 |
| 四个安装孔 | 非金属化、无铜接触 |
| 13 键 | 松开时无短地，按下时对应脚可靠拉低 |
| PC817 | 输入/输出侧不互穿，脚序一致 |
| ToF 连接器 | SCL/SDA/+3V3/GND 不反 |

### 6.2 分电源测试

1. 只接 J8 3.3 V，确认 F1 后为 3.3 V，电流无异常。
2. 用限流 12 V 电源接 CN1，逐路挡光，测 PC817 输出从 3.3 V 到低电平。
3. 确认 `GND12` 只在 R15 处与逻辑地连接，不经过传感器线束形成第二条地回路。
4. 单独接 ToF A，执行 I2C 扫描，确认 0x52；再接 ToF B，确认两条总线互不影响。
5. 逐个转动 EC11，确认 A/B 正交、上拉和 RC 正常。

### 6.3 接 FPGA 后

- 先用 `QUIET` 或只读遥测确认不产生错误音符。
- 13 键逐键检查 MIDI 60–72。
- 光电 #1 检查 E2 起音和松开停音；其余五路按最终固件逐路扩展。
- ToF A 检查 10–70 cm 的单向换音、迟滞和离场；ToF B 作为音量时检查近远方向。
- EC1 检查音量 0–127，EC2–EC4 只在对应 cst/RTL 完成后计入验收。
- FIFO 阻塞计数保持 0，上电 20 次无随机发声。

### 6.4 机械复测

每键至少记录：

- 未按下时帽顶高度。
- 全压时帽顶高度和行程。
- 是否碰键床、PCB、相邻键或上壳。
- 松开回弹时间。
- 用手轻推键帽前端，是否出现明显倾斜或上跳。
- 四个定位柱是否顺畅进入上盖盲孔，键床是否仍有前后/左右位移或垂直松动。

## 7. 整机放行标准

### PCB

- 板框、板厚、孔径、孔位与外壳和 DXF 一致。
- 13 键、6 光电、2 ToF、4 EC11 的电流/电压/网络逐路通过。
- J13-11 无连接，J13-12 接地。
- 12 V 域与逻辑域隔离，R15 单点连接。
- 实测音频无 I2C 噪声；UART 遥测正常。

### 外壳

- 上下壳可重复拆装，螺丝柱不滑牙。
- PCB 四角与支撑筋接触稳妥，无翘曲和异常应力。
- H5 朝上残留引脚不高于 PCB 顶面，键床与其无接触。
- 13 键行程约 2 mm，按键不倾斜、不卡滞、不上跳。
- 两只 ToF 光轴朝上，光窗无遮挡，拆上壳不扯线。
- 40P 成品插头可从后口通过，盒内插头不顶上壳。
- 前侧光电/12V/编码器线束可走线，压线片能承受拉力。

### 固件和演奏

- 当前位流的 13 键、光电 #1、ToF A、EC1 全部可重复。
- 8 声部与事件仲裁正常，FIFO 阻塞为 0。
- 任何 PCB 已规划但固件未实现的通道，在验收表中明确标为“未验收”，不能混算。

## 8. 当前真正的放行阻断

| 阻断 | 影响 | 关闭方式 |
|---|---|---|
| 键床无垂直正锁固 | 长期使用可能上跳 | 首件验证后在定位柱旁增加小卡扣，不占用 PCB |
| Gerber 双钻孔重复 | 板厂可能误钻或多钻 | 删除重复过孔文件坐标并重新导出 |
| 缺 ERC/DRC/BOM/坐标 | 不能安全 PCBA | 从 EDA 导出并人工核对 |
| 实际 IDC 附件未确认 | 可能无法穿口或顶壳 | 采购实物，用卡尺量总包络并回装 |
| ToF 镜头/安装孔未确认 | 光窗和走线可能不匹配 | 以实际模块底面测量并复核筒体 |
| EC11/线束/压线片未确认 | 装配和拉力风险 | 选型后更新窗口与焊盘 |
| 未打印/未装配实体 | 数字 PASS 不能代表实物 | 打整壳首件，按本文件记录 |

## 9. 文档之间的引用关系

- 系统边界和硬约束：[HARDWARE-DESIGN-SPEC.md](HARDWARE-DESIGN-SPEC.md)
- PCB 电气与机械：[PCB-DESIGN.md](PCB-DESIGN.md)
- 逐针网表：[NETLIST.md](NETLIST.md)
- 旧版面包板证据：[BREADBOARD-BRINGUP.md](BREADBOARD-BRINGUP.md)
- 外壳细节：[ENCLOSURE-DESIGN.md](ENCLOSURE-DESIGN.md)
- 可选保护方案：[PCB-POWER-ESD.md](PCB-POWER-ESD.md)
- 历史版本与旧提示词：`archive/README.md`
