wongben2333-crypto/26Embedded/fpga_spark/docs/HARDWARE-BRINGUP-LOG-20261103.md

# 硬件联调与故障排除记录：错焊电阻修复与特雷门琴/ToF全链路闭环

> **记录日期**：2026 年 11 月 3 日  
> **验证目标**：Tang Mega 138K（GW5AST-138C）+ 自研乐器 PCB 扩展板 + 7 寸大屏全模态乐器系统  
> **涉及外设**：13 键键盘（钢琴）、6 路红外光电弦（电吉他）、VB22B 激光 ToF 传感器（特雷门琴）、EC11 旋钮（音量）  
> **关键结论**：**自研 PCB 上 I2C 相关的错焊电阻已更正，ToF 芯片 I2C 通信与测距功能全面恢复，特雷门琴空间手势发声成功闭环！**

---

## 1. 背景与验证拓扑

在项目前期，团队已在面包板（Breadboard）上完成了核心功能验证：
- 13 键四脚轻触开关逐键测试正常，覆盖 C4~C5 音乐事件；
- 6 路光电输入中，光电 #1（E2, 82.41 Hz）成功触发吉他拨弦；
- VB22B 激光 ToF 传感器通过独立 I2C 接口成功读取毫米级距离，并驱动特雷门琴升降调；
- EC11 编码器实现稳定的正交四倍频解码与音量调节。

为提升系统的可靠性、抗振性与整体装配完整度，团队依据面包板验证电路绘制并制备了专用乐器 PCB 扩展板（采用 40-pin 排母直插 Tang Mega 138K 的 J13 排针）。在完成 SMT 贴装并上板运行最新的 32 复音主工程（`lcd_test_j14.fs`）时，启动了真机全链路联调验收。

---

## 2. 故障现象与初始表征

在固件烧录运行并进行实机演奏测试时，出现以下分化现象：

1. **正常功能**：
   - **13 键键盘**：按键灵敏，钢琴音色正常响应单音与多指和弦，无破音与丢音；
   - **6 弦光电吉他**：划过光电传感器时，电吉他过载与 4x12 箱体模拟效果器响应极佳；
   - **7 寸大屏 UI**：800×480 屏幕波形示波器与 32 通道频谱柱动态跳动，触控键盘与推子响应灵敏；
   - **EC11 旋钮**：顺时针/逆时针旋转可平滑增减全局音量。
2. **异常故障（唯一未通链路）**：
   - **空间特雷门琴完全无反应**：手掌置于 ToF 传感器上方靠近、远离，均没有任何声音输出；
   - **遥测状态**：上位机串口诊断数据中，ToF 距离字段恒定为 `A=FFFF`（表示 I2C 无应答 NACK）；
   - **电平测试**：用万用表直流电压档测量 ToF 接口的 SCL 与 SDA 引脚，静态电平接近 3.3V，说明线路未发生对地死短路，但总线无法完成有效数据握手。

---

## 3. 根因分析与排查过程

结合硬件原理图网表（`Netlist_Schematic1_2026-10-24.tel`）、PCB 布局以及 FPGA 逻辑进行了联合排查：

### 3.1 供电轨差异（J13 与 PCB 供电拓扑）
- **母板 J13 特性**：Tang Mega 138K 的 J13 扩展排针直连 FPGA 的 SDRAM0 Bank，40 根针中**没有 3.3V 电源引出**（Pin 11 为 5V，Pin 12 为 GND，其余均为 IO）；
- **PCB 供电设计**：自研 PCB 上的 `+3V3` 供电轨连接了 ToF 接口（H9/H8）、I2C 4.7 kΩ 上拉电阻以及 PC817 光耦输出侧，该网络由 PCB 上的专用端子 **`H3`（经 F1 0.5A PTC 保险丝）** 引入。必须从 Tang Mega 母板 J8 的 3.3V 排针引出一根杜邦线供给 `H3`；
- **为什么钢琴能响而 ToF 不响**：轻触开关属于常开接地结构，依赖 FPGA 芯片内部弱上拉（`PULL_MODE=UP`），即使外部 3.3V 出现异常，按键也能正常工作；但 ToF 作为有源数字芯片，对电源完整性有刚性要求。

### 3.2 阻值错焊（核心物理根因）
- 在全面检查 PCB 贴片元器件时发现：**I2C 信号通路中的上拉电阻与限流串阻在装配焊接时，贴错了电阻阻值（阻值错焊严重偏离了设计参数）**；
- 错误的阻值导致：
  1. 总线上拉强度失常，SDA 在从机释放时电平上升沿迟缓，无法在 SCL 高电平时建立稳定的逻辑 1；
  2. 串联阻抗与杂散电容构成低通滤波，严重畸变了 I2C 的方波时序，导致从机设备在第 9 个时钟周期无法下拉 SDA 发送 ACK 应答。

### 3.3 状态机安全静音设计
- 查看 `hw_input_mgr.v` 中的特雷门琴状态机：固件为了防止手离开或者信号中断时产生高频刺耳噪音，设计了防啸叫保护门限——仅当 ToF 传感器持续稳定返回有效距离（`< 700 mm` 且驻留超过 60 ms）时才允许触发起振；
- 一旦 I2C 发生 NACK，状态机立刻判定为手已离场（`T_OUT`），发送 Note-Off 彻底静音。因此只要硬件 I2C 不通，特雷门琴在逻辑上就绝对不会发出任何声音。

---

## 4. 专属调试工具保障：`tof_debug/`

为了将硬件物理问题与复杂的 32 复音音频合成逻辑彻底解耦，团队专为本次硬件排障开发并交付了轻量级调试工程 [`fpga_spark/tof_debug/`](file:///C:/Users/gjl50/Desktop/FPGA/fpga_spark/tof_debug/)：

1. **极速编译交付**：构建脚本仅需 20 秒即可生成位流，无需等待主工程庞大的 FFT 与音色 ROM 综合；
2. **双总线全地址自动扫描（0x08~0x77）**：FPGA 自动轮询 Bus 1（`A18/D15`）与 Bus 2（`F14/F13`）上的所有可能地址，无论插入 H9 还是 H8，只要有器件响应即可瞬间锁定；
3. **7 寸 800×480 大屏直显**：中央 4 倍超大字体实时刷新距离读数（毫米），下方配备 16×8 I2C 从机应答矩阵看板；
4. **串口 ASCII 遥测与 Python 彩色终端监控**：提供实时条状图监视脚本 `tof_monitor.py`，清晰统计 ACK/NACK 计数。

---

## 5. 故障修复与实测验收

硬件维护人员依据原理图设计规范对 PCB 进行了元器件更正：
1. **电阻重焊**：拆除错焊电阻，精确更换为 **4.7 kΩ 上拉电阻（R34, R36）** 与 **330 Ω 限流电阻（R38, R40）**；
2. **线序核实**：确认 4P 接口针序为 `Pin 1=SCL, Pin 2=SDA, Pin 3=+3.3V, Pin 4=GND`；
3. **重新上电测试**：
   - 烧录 `tof_debug.fs` 后，板载 `LED2` 瞬间常亮，7 寸大屏 I2C 矩阵表中的 **`0x52` 绿色方格点亮**；
   - 屏幕跳出实时距离读数（如 `185 mm`），手掌推拉移动时读数极其线性平滑，串口 NACK 计数归零，ACK 计数飞速递增；
   - 切回主工程 `lcd_test_j14.fs` 后，特雷门琴完美发声，在空间 10~70cm 范围内随手势高低实现丝滑的半音阶爬升与滑音，所有乐器外设协同工作达到设计要求！

---

## 6. 工程复盘与规范

1. **SMT 贴装复核机制**：多路模拟/数字混装 PCB 必须在初次上电前进行阻容丝印与阻值抽测，尤其是 I2C、I2S 等对阻抗敏感的总线；
2. **多模式独立验证原则**：在大型综合设计中，为复杂传感器保留专用的轻量验证工程（如 `tof_debug`），能极大缩短排错迭代周期，是嵌入式系统软硬件协同设计的最佳实践。
