wongben2333-crypto/26Embedded/fpga_hardware/docs/BREADBOARD-BRINGUP.md

# 面包板验证与硬件联调记录

> 状态：历史验证链已通过，记录保留为 PCB 迁移依据  
> 最后关键验收：2026-10-24  
> 适用底板：Sipeed Tang Mega 60K Dock，GW5AT-60B，device version B

## 1. 这一阶段证明了什么

面包板阶段的目的不是做长期可靠的整机，而是先确认 FPGA 球号、电气电平、输入事件和
hank 引擎能够连通。最终确认：

- 13 个四脚轻触开关逐键正确，MIDI 60–72 全部出现。
- 6 路光电输入的网络和 S9012 安全电平转换方案已确定，但为了尽快完成集成，
  面包板实物只接了第 1 路；只有第 1 路在当前固件中产生音乐事件。
- ToF A 可以按 I2C 读取距离，并驱动特雷门式音高。
- EC11 #1 可以正确正交计数并控制音量。
- 串口遥测、8 声部演奏、第 9 声部抢占、上电静音和 MODE=1 回归均可工作。
- 已找到并避开 I2C 与 BANK7 音频之间的干扰、ToF 突发读字节序和引擎事件速率
  三个关键问题。

面包板阶段的电气方案与 PCB 不是一一照搬：光电整形从 S9012 改为 PC817，
ToF A 从 J8 移到 J13，六路光电和四个 EC11 在 PCB 上才获得固定线束入口。

## 2. 面包板拓扑

```text
13 个四脚开关 ───────────────┐
6 路 E3F-20C1 ─ S9012 射随 ──┤
EC11 #1 A/B ────────────────┼─ J13 / J8 → GW5AT-60B
VB22B ToF A ─ 独立 I2C ─────┘

Tang Mega 板载 PT8211 → 3.5 mm → 耳机
P19/J9-11 → USB-TTL → PC 串口遥测
```

当时只有一套执行器输入完成了全链路：

- `inputs_top` 固件覆盖 13 键、6 路光电遥测、ToF A、ToF B 遥测和 EC1/EC2
  原始电平。
- MODE=3 整合固件只把 13 键、光电 #1、ToF A 和 EC1 接入音乐引擎。
- 其余光电只参与遥测或尚未接线，不能把“引脚已约束”理解为“音乐已验收”。

## 3. FPGA 接口与逐针接线

### 3.1 13 键

每个开关一端接对应 J13 针，另一端全部接逻辑 GND。FPGA 脚内部上拉；空闲为 1，
按下为 0。

| 键 | 音名 | MIDI | J13 针 | FPGA 球 | 遥测位 |
|---:|---|---:|---:|---|---:|
| 1 | C4 | 60 | 1 | E14 | bit0 |
| 2 | C#4 | 61 | 2 | E13 | bit1 |
| 3 | D4 | 62 | 3 | C15 | bit2 |
| 4 | D#4 | 63 | 4 | C14 | bit3 |
| 5 | E4 | 64 | 5 | B13 | bit4 |
| 6 | F4 | 65 | 6 | C13 | bit5 |
| 7 | F#4 | 66 | 7 | A14 | bit6 |
| 8 | G4 | 67 | 8 | A13 | bit7 |
| 9 | G#4 | 68 | 9 | B16 | bit8 |
| 10 | A4 | 69 | 10 | B15 | bit9 |
| 11 | A#4 | 70 | 13 | A16 | bit10 |
| 12 | B4 | 71 | 14 | A15 | bit11 |
| 13 | C5 | 72 | 15 | A20 | bit12 |
| 电源风险 | — | — | **11** | **5V_Peripheral** | **禁止连接** |
| 地 | — | — | **12** | GND | 必须连接 |

13 键全部按下时，遥测字段应为 `K=0000`；全松为 `K=1FFF`。

### 3.2 六路光电

| 光电 | J13 针 | FPGA 球 | 遥测位 | 面包板阶段音乐事件 |
|---:|---:|---|---:|---|
| #1 | 16 | B20 | bit0 | 挡光发 note 40、vel 110 |
| #2 | 17 | A21 | bit1 | 未接 |
| #3 | 18 | B21 | bit2 | 未接 |
| #4 | 19 | B18 | bit3 | 未接 |
| #5 | 20 | B17 | bit4 | 未接；该球为 SDRAM clk，只可慢速静态输入 |
| #6 | 21 | C17 | bit5 | 未接 |

未遮挡为 1，挡光为 0；空闲遥测为 `P=3F`。

### 3.3 面包板光电电平转换

E3F-20C1 黑线内部有约 15.6 kΩ 上拉到其 12 V 电源，因此黑线可在 0–12 V
摆动，禁止直接接 FPGA。面包板每路使用：

```text
              +3V3
                |
              [10k]
                |
  黑线 --[47k]--+---- S9012 E ----+---- J13 输入
                |                 |
              [47k]             C -- GND
                |
               GND
```

S9012 为 PNP，两个 47 kΩ 组成基极偏置，10 kΩ 为发射极负载。实测：

- 未遮挡：FPGA 输入约 3.3 V，读 1。
- 挡光：FPGA 输入约 0.6 V，低于 0.8 V 的 `VIL`，读 0。
- 每路元件：S9012×1、47 kΩ×2、10 kΩ×1。

12 V 接法为所有发射器和接收器棕线接 +12 V，蓝线接 12 V 电源 0 V；从同一个
0 V 点只拉一根地线到 FPGA 板 GND。实测单套约 20 mA，六套约 120 mA。

该电路能工作，但阈值和温漂依赖分立器件。PCB 改用 PC817，将 12 V 域和
3.3 V 域明确隔离。

### 3.4 ToF A

最终有效接线：

| ToF 针 | 面包板/底板 | 电气处理 |
|---|---|---|
| SCL，pin1 黄 | J13-24，A18 | 串 330 Ω，4.7 kΩ 上拉到 3.3 V |
| SDA，pin2 绿 | J13-25，D15 | 串 330 Ω，4.7 kΩ 上拉到 3.3 V |
| +3V3，pin3 红 | J8-1/2 或 J9-1/2 | 3.3 V |
| GND，pin4 黑 | J8-3/4、J9-3/4 或 J13-12 | 共地 |

ToF B 在 PCB 上规划到 J13-29/30，即 F14/F13；面包板阶段没有完成其音乐链路。

### 3.5 EC11 #1

| 信号 | J13 针 | FPGA 球 |
|---|---:|---|
| A | 22 | D17 |
| B | 23 | A19 |

模块 VCC 接 3.3 V、GND 接地，公共端 C 不额外接 FPGA。固件按 1 kHz 采样进行
四倍频正交解码。正常旋转时 `E1` 每格变化 ±4，原始状态 `S` 在
`F/7/3/B` 之间变化。

PCB 规划：

- EC2：J13-26/27，D14/D16。
- EC3：J13-37/38，D19/E19。
- EC4：J13-39/40，C19/C18。

### 3.6 调试串口

| USB-TTL | FPGA 板 |
|---|---|
| GND | J8-3/4 或 J13-12 |
| RX | P19，J9-11 |
| VCC | 不接 |

参数为 115200、8N1，USB-TTL 电平必须设为 3.3 V。P19 是 CPU 专用球，构建脚本
必须保留 `set_option -use_cpu_as_gpio 1`。

## 4. 遥测格式

`inputs_top` 每约 40 ms 输出一行，例如：

```text
K=1FFF P=3F A=037B B=FFFF E1=0000 E2=0000 S=F @000002CAAB
```

最终 MODE=3 固件简化为：

```text
K=1FFF P=3F A=0398 V=64 N=000000 O=00 @0000xxxx
```

| 字段 | 含义 | 正常空闲 |
|---|---|---|
| `K` | 13 键电平，1=松开、0=按下 | `1FFF` |
| `P` | 6 光电电平，1=未遮挡、0=挡光 | `3F` |
| `A` | ToF A 距离，十六进制 mm；`FFFF` 表示 NACK | 随实际距离变化 |
| `B` | ToF B 距离 | 面包板未接时 `FFFF` |
| `E1/E2` | EC11 有符号累计计数，每格 ±4 | `0000` |
| `S` | 两路 EC 的 A/B 原始电平 | `F` |
| `V` | 当前音量 0–127 | 100 或应用设定 |
| `N` | 最近一个 MIDI 事件 | `000000` |
| `O` | FIFO 阻塞计数 | `00` |

## 5. 实测验收结果

| 项目 | 结果 | 证据 |
|---|---|---|
| 13 键逐键 | 全部正确 | 遥测 60–72 全出现，用户听感确认 |
| 8 键和弦 | 全响 | 8 个声部同时发声 |
| 第 9 键 | 抢占最旧声部，不卡死 | 连续事件、FIFO 阻塞 `O=00` |
| 光电 #1 | E2 挡光起音、松开停音 | `P=3F ↔ 3E`，事件流符合 |
| ToF A | 10–70 cm 单调换音 | 遥测 note 73–84 成串单调 |
| EC11 #1 | 音量明显变化 | `V` 覆盖 0–127，无爆音 |
| 上电静音 | 20/20 | 另在安静环境 9/9 复测 |
| MODE=1 回归 | 正常 | `90 45 64` 听到 440 Hz；`--selftest` PASS |
| 最终构建时序 | 通过 | Setup +0.033 ns，Hold +0.136 ns |
| 资源 | 满足 | Logic 22 807/59 904、BSRAM 60/118、DSP 79/118 |

最终 MODE=3 位流为：

```text
MODE3_mode3_60K_20261024-012557.fs
User Code: 0x1A2B0003
SHA-256 前 16 位: 882132D453E6E483
```

位流是 SRAM 运行方式，重新上电需要重新烧录；是否固化 Flash 要单独获得确认。

## 6. 三个关键问题和最终处理

### 6.1 I2C 与音频同属 BANK7

最初把 ToF A 的 SCL/SDA 放在 J8-10/11，即 AB22/Y21。该组球与板载 I2S
同属 BANK7。使用 `DRIVE=8`、10 kHz 轮询时，DAC 输出出现尖锐噪声。

排查时冻结 I2C 和遥测后声音恢复干净，确认是电气串扰，不是音频算法。
临时办法是 `DRIVE=2` 和 3.3 kHz；最终把总线移到 J13-24/25 的 A18/D15，
恢复 10 kHz 并保持 `DRIVE=2`，听感完全干净。

PCB 和后续固件必须遵守：I2C 放 J13，不放 J8 的 AB22/Y21。

### 6.2 VB22B 突发读字节序

单寄存器读时 0x00 为距离低字节、0x01 为高字节；从 0x00 开始自动递增连续读
两个字节时，返回顺序却是**高字节在前**。909 mm 返回 `03 8D`，应按
`{first, second}` 拼成 `0x038D`。

写反会得到 36099 mm 一类异常值。正确做法和旧固件 off-by-one 偶合问题见
[TOF-VB22B-PROTOCOL.md](TOF-VB22B-PROTOCOL.md)。

### 6.3 引擎不接受过密事件

`piano_engine` 的 note-on 装载状态机需要 14 个时钟周期，并且没有输入队列。
若事件间隔只有 4 clk，第二个 note-on 会被直接丢弃。最终所有事件共用一个
FIFO16，并至少间隔 16 clk（320 ns）。

引擎的 glide 使用全局 `last_voice`。ToF 换音若开启 glide，会把正在发声的
琴键声部抢走并滑音，所以最终 ToF 用 off+on 重新触发，限制为至少 180 ms，
并增加入场驻留和迟滞。

## 7. 故障对照

| 现象 | 优先检查 |
|---|---|
| 没有任何 `K=` 行 | P19 是否接 USB-TTL RX、是否共地、是否 115200/3.3 V 档 |
| `K` 恒为 `1FFF` | 按键是否接到对应 J13 针、公共端是否接 GND |
| `K` 某一位恒为 0 | 该键网络是否被短到 GND |
| `P` 恒为 `3F` | S9012 是否供电、E/C 是否接反、黑线是否进入 47 kΩ 节点 |
| `P` 恒为 `00` | 光电是否一直挡光、12 V 和光束是否正常 |
| ToF A/B 为 `FFFF` | 4.7 kΩ 上拉、SCL/SDA 方向、3.3 V 供电和 NACK 状态 |
| ToF 读数约 36000 mm | 连续读两字节的拼装顺序错误 |
| EC 计数只在 ±1 抖动 | A/B 只有一路在动；检查 `S` 中不变化的位 |
| `S` 一直为 `F` | EC VCC 缺失、地线断或 A/B 都未接 |
| 不转动时 `S` 乱跳 | 输入浮空或线缆拾噪 |
| 音频有尖噪声 | I2C 是否误放回 J8 BANK7；可先冻结 I2C 做二分 |
| 快速同时按键丢音 | 事件串行化是否保持至少 16 clk、FIFO 计数是否溢出 |
| ToF 换音偷走琴键声部 | 是否误用了引擎全局 glide |

## 8. 从面包板迁移到 PCB 的差异

| 项目 | 面包板 | PCB v1 | 迁移原因 |
|---|---|---|---|
| 光电整形 | S9012 射极跟随器 | 6×PC817 | 明确隔离 12 V 与 3.3 V，降低装配差异 |
| ToF A 引脚 | 曾用 J8-10/11 | J13-24/25 | 避开 BANK7 音频串扰 |
| 光电音乐链路 | 只验证 #1 | 6 路硬件齐备 | 目标为六弦；固件后续扩展 |
| EC11 | 只接 #1 | 4 路连接器与网络 | 目标为四个旋钮；EC2–4 待固件闭环 |
| 输入连接 | 杜邦线/面包板 | 固定线束焊盘或连接器 | 抗振、防松、可装配 |
| 去抖/滤波 | 保存为固件参数 | 硬件 RC + 固件去抖 | 兼顾 ESD/噪声和软件语义 |
| 电源保护 | 外部电源直接供电 | 保留 F1，12 V 受控线束 | 低成本首版；完整保护方案见 ESD 文档 |
| 调试串口 | 外接 USB-TTL | 仍从原板 J9-11 引出 | 自制板不增加调试接口 |

## 9. 这份记录的使用边界

面包板结果证明控制和信号语义，不证明 PCB 已经制造成熟，也不证明外壳可以装配。
改动 PCB 连接器、封装或保护电路后，仍需重新做上电顺序、通道逐项、音频噪声和
整机装配验收。若与 `NETLIST.md` 或最终 Gerber 冲突，以实际 Gerber、实物接线和
[NETLIST.md](NETLIST.md) 为准，并用本文追溯当时的验证依据。
