wongben2333-crypto/26Embedded/fpga_spark/lcd_test/pcb/升级指引-立创EDA升级到CLI版.md

# 升级指引：立创EDA 专业版 升到带命令行/MCP 的版本

> 给用户看的。**你只需要做"下载 → 备份 → 安装 → 验证"四步**，其余我们来做。
>
> 为什么要升级：**我们要在立创EDA 本体里画板**（而不是用脚本硬搓工程文件）。
> 立创EDA 从某个版本起自带**命令行客户端 + 本地桥接服务**，能让我们**驱动真编辑器**画板、
> 跑 DRC、导 Gerber —— 画出来的板子**你能继续在软件里编辑**。
> ⚠️ 而这个功能**要求 v4.1.60 及以上**，**你现在这个版本没有**（我实测确认，见下）。

---

## 一、先确认现状（我们已实测）

| 项 | 你的机器 |
|---|---|
| 程序 | `F:\lceda-pro\lceda-pro.exe` |
| 编辑器版本 | **3.2.149.88089769**（`resources\app\package.json` 里的 `version`）|
| 另一个版本串 | `v41.2.1-jlc-sa-win-x64.2`（`F:\lceda-pro\version` 文件）|
| **CLI 是否存在** | ❌ **不存在**。`resources\app\cli.js` 是**空壳**（只有一行 `"use strict";`）；程序里搜不到 `doctor` / `--mcp` / `bridge` |
| CLI 要求的版本 | **v4.1.60 及以上**（官方文档原文）|

---

## 二、第一步：**先备份你的工程**（重要）

你的 4 个工程在：
```
F:\有源二分频音频放大电路立创工程\
    AD8367_v66_2023-07-06-17-02.zip
    LM1875_v66_2023-07-03-14-50.zip
    OPAgenneral_v58_2023-05-02-15-26.zip
    有源滤波器_v55_2023-06-14-22-21.zip
    有源滤波器_v55_2023-06-14-22-21\   （目录）
```

**请把整个 `F:\有源二分频音频放大电路立创工程\` 文件夹复制一份**（例如复制到 `F:\有源二分频_备份\`）。

> 理由：升级一般不动你的工程数据，但**升级软件前先备份是常识**，而且你的工程是真实成果。
> **⚠️ 特别提醒**：那个目录里的 `有源滤波器_v55_...\` 子目录**已经被我们当只读参考用过**（我们没改过它，
> 但它就是你的真实工程）—— 备份一下最稳。

---

## 三、第二步：下载并安装新版

| 项 | 地址 |
|---|---|
| **下载页** | **https://easyeda.com/page/download** |
| **指定历史版本**（如果下载页给的不是最新）| **https://prodocs.easyeda.com/en/faq/client-version.html** |

选 **Windows x64 桌面客户端**（**必须是桌面版**，网页版**不支持**命令行/桥接功能）。

**安装时注意**：
- 新版可能装到 **`C:\Program Files\EasyEDA-Pro\`**，**和你现在的 `F:\lceda-pro\` 是两个位置**。
  两个可以共存，**但我们后面用新的那个**。
- 安装程序会把安装目录加进系统 `PATH`（官方文档说的），装完 `easyeda-pro` 命令就能直接用。

---

## 四、第三步：验证装好了（**打开一个终端跑这一条**）

按 `Win+R` → 输入 `powershell` → 回车，然后粘贴：

```powershell
easyeda-pro doctor
```

**期望**：返回一段 JSON，里面有 `"ok": true` 之类的字段（说明它找到了编辑器端点）。

**如果报"无法识别 easyeda-pro"** ⇒ 用完整路径试：
```powershell
& "C:\Program Files\EasyEDA-Pro\easyeda-pro.exe" doctor
```

**再确认一下版本**：
```powershell
(Get-Content "C:\Program Files\EasyEDA-Pro\resources\app\package.json" -Raw | ConvertFrom-Json).version
```

**把这三条命令的输出发我们**就行（截图或复制文字都可以）。

---

## 五、第四步（**可选，但强烈建议**）：先拿一个小板子试水

升级成功后，**第一次别直接做钢琴板**。我们会先让你用它打开一个**极小的工程**，
确认"命令行能驱动编辑器"这条路真的通，**再做真正的板子**。

---

## 六、装完之后我们会做什么（你不用管）

1. 用 **`easyeda-pro open --path ...`** 打开/新建工程
2. 用 **`invoke`** 在编辑器里执行 JS，调用**扩展 API** 画板：
   板框、焊盘、走线、丝印、排针、测试点
3. 用官方能力**导 Gerber / BOM / 网表 / 截图**、**跑 DRC**
4. **你在软件里能继续手动改** —— 这是这条路线的最大好处

**⚠️ 我们不会**：替你下单、替你付款、替你买器件（这是你明确保留的权限）。

---

## 七、如果升级后 CLI 还是不存在

**别自己反复折腾**，把下面信息发我们：
1. `easyeda-pro doctor` 的完整输出（或"命令找不到"的报错）
2. `(Get-Content "...\resources\app\package.json" -Raw | ConvertFrom-Json).version` 的输出
3. 安装目录是什么（`C:\Program Files\EasyEDA-Pro\` 还是别处）

我们据此判断下一步。

---

## 附：为什么不能"用脚本生成工程文件"了（你之前那句话是对的）

我们试过用 Python 直接生成 `.epcb` 工程文件，**撞了两代格式墙**：
- 你电脑上旧工程用的是**数组式旧格式**（`["DOCTYPE","PCB","1.7"]`）
- 官方现行的是 **key-value 新格式**（`{"type":"DOCHEAD",...}||{...}|`）

**就算猜对了格式，生成的板子你也没法在 EDA 里继续编辑**（改一个焊盘都要回头改脚本）。
**⇒ 你说"直接在嘉立创EDA上画"是对的路线。** 我们已经把**几何、丝印表、BOM、引脚表**
全部整理好了，**换成驱动真工具之后这些全都能直接复用，不会白费。**
