wongben2333-crypto/26Embedded/fpga_spark/lcd_test/docs/LCD接线表-ATK-MD0700-34P_to-J14-40P.md

# ATK-MD0700 34P -> Tang Mega 138K NEO Dock J14

适用：Tang Mega 138K NEO Dock 31005（GW5AST-138C）+ 正点原子 ATK-MD0700 V2.4（SSD1963，800x480，16-bit 8080）。

J14 是 SDRAM1/DVP_CAM/PMOD 复用接口。LCD 测试时不要同时使用 J8/J9 PMOD、DVP 摄像头或 SDRAM1 外设。LCD 数据位采用重排方式，以避开 GW5AST-138C 的 CPU/SSPI 专用球位；LCD 端必须严格按下表接线。

注意：正点原子手册规定 LCD P1-6 至 P1-21 依次为 D0 至 D15，P1-23 是 TE，不是 D15。

## J14丝印与编号方向

- 板上连接器位号丝印：`J14`。
- 下表中的 `J14-n` 表示 J14 排针的第 n 脚。
- 官方原理图中，J14 为 2×20 排针：奇数脚一列、偶数脚一列，从上到下依次为 `1/2、3/4、...、39/40`。J14-29/J14-30 还经过底板上的 0Ω 配置电阻，对应 FPGA 的 SDRAM1_DM0/DM1。
- 实物若只看见“J14”而看不清脚号，请先确认排针的 1 脚定位，再按上述排列数脚，不要仅凭左右方向猜测。

J14编号示意（按官方原理图排列）：

```
奇数列       偶数列
  1            2
  3            4
  5            6
  ...          ...
 39           40
```

## 接线表

| LCD P1 | 信号 | J14丝印/脚号 | FPGA球号 |
|---:|---|---:|---|
| 28 | +5V | J14-11 | 电源 |
| 22,26,27 | GND | J14-12 | GND |
| 1 | CS | J14-24 | AB21 |
| 2 | RS | J14-39 | R14 |
| 3 | WR | J14-27 | AB20 |
| 4 | RD | J14-30 | AB18 |
| 5 | RST | J14-32 | Y18 |
| 6 | D0 | J14-19 | V20 |
| 7 | D1 | J14-20 | U20 |
| 8 | D2 | J14-21 | Y22 |
| 9 | D3 | J14-26 | AA20 |
| 10 | D4 | J14-34 | N15 |
| 11 | D5 | J14-36 | U17 |
| 12 | D6 | J14-40 | P14 |
| 13 | D7 | J14-38 | P15 |
| 14 | D8 | J14-18 | N13 |
| 15 | D9 | J14-17 | N14 |
| 16 | D10 | J14-25 | AA21 |
| 17 | D11 | J14-15 | P17 |
| 18 | D12 | J14-14 | W21 |
| 19 | D13 | J14-13 | W22 |
| 20 | D14 | J14-10 | V17 |
| 21 | D15 | J14-23 | AB22 |

## 文字接线图

    LCD P1-28 (+5V)  ---------------- J14-11
    LCD P1-22/26/27 (GND) -------- J14-12

    LCD P1-1  CS  ----------------- J14-24
    LCD P1-2  RS  ----------------- J14-39
    LCD P1-3  WR  ----------------- J14-27
    LCD P1-4  RD  ----------------- J14-30
    LCD P1-5  RST ----------------- J14-32

    LCD P1-6  D0  ----------------- J14-19
    LCD P1-7  D1  ----------------- J14-20
    LCD P1-8  D2  ----------------- J14-21
    LCD P1-9  D3  ----------------- J14-26
    LCD P1-10 D4 ----------------- J14-34
    LCD P1-11 D5 ----------------- J14-36
    LCD P1-12 D6 ----------------- J14-40
    LCD P1-13 D7 ----------------- J14-38
    LCD P1-14 D8 ----------------- J14-18
    LCD P1-15 D9 ----------------- J14-17
    LCD P1-16 D10 ---------------- J14-25
    LCD P1-17 D11 ---------------- J14-15
    LCD P1-18 D12 ---------------- J14-14
    LCD P1-19 D13 ---------------- J14-13
    LCD P1-20 D14 ---------------- J14-10
    LCD P1-21 D15 ---------------- J14-23

不要连接 P1-23、P1-24、P1-25、P1-29、P1-30、P1-31、P1-32、P1-33、P1-34。触摸和 TE 本测试不使用。

## 安全注意

- P1-28 必须接 J14-11 的 5V，不能接 3.3V。
- 三个 LCD GND 必须并在一起接 J14-12。
- J14-34、36、38、40 已作为 LCD D4～D7 使用；不要把 J14-37 接线，J14-40 也不能接地。
- J14-22 对应 FPGA Y21，为 SSPI 专用球；本测试不使用 J14-22，LCD D2 必须接 J14-21（Y22）。
- 上电前检查 5V 与 GND 没有短路。
- 确认 J14 排针实物已经焊接。

## 测试代码和位流

RTL：
`C:\Users\gjl50\Desktop\FPGA\fpga_spark\lcd_test\rtl\lcd_test_top.v`

约束：
`C:\Users\gjl50\Desktop\FPGA\fpga_spark\lcd_test\constraints\lcd_test_j14.cst`

构建：
`C:\Users\gjl50\Desktop\FPGA\fpga_spark\lcd_test\build_j14.py`

已通过 Gowin P&R 的位流：
`C:\Users\gjl50\Desktop\FPGA\fpga_spark\lcd_test\bitstream\lcd_test_j14_138c_verified.fs`

测试程序上电后初始化 SSD1963，循环显示白、红、绿、蓝画面；串口 115200 8N1 可查看诊断信息。

构建命令：
    python build_j14.py

注意：LCD 数据位是重排的，不能按 J14 的 SDRAM1_D0、D1 顺序直接接到 LCD D0、D1，必须按本表连接。
