wongben2333-crypto/26Embedded/fpga_spark/lcd_test/pcb/piano6/README-交付说明.md

# 6 键触摸钢琴 PCB —— 交付说明

> 作者：teammate `board-smoke`　时间：2026-10-06
> 生成器：`fpga_hank/pcb/tools/gen_piano_pcb.py`（**可重跑、幂等**）
> 渲染器：`_research/pcb/render_piano.py`（**从生成的文件重新解析**渲染，不是按设计意图画）
> 预览图：`fpga_hank/pcb/piano6/preview_piano6.png`
> 归档：`fpga_hank/pcb/piano6/TouchPiano6.zip`（**ZIP 条目名全为正斜杠**，已自检）

---

## 1. 板子概览

| 项 | 值 |
|---|---|
| 尺寸 | **164.5 × 172.0 mm**（164.5 = 7 × 23.5 = **正好一个八度**）|
| 层数 | **2 层**（TOP / BOTTOM）｜板厚建议 1.6 mm |
| 白键 | **7 个**：C D E F G A B（真实钢琴比例，白键宽 23.5 mm、长 150 mm）|
| **触摸通道** | **6 个**：C D E F G A（**B 键只做外观**，见 §4）|
| 黑键 | **5 个**：C# D# F# G# A#，**2+3 分组**（"像不像钢琴"的核心）|
| 黑键做法 | **丝印实心填充**（也可改黑油/阻焊开窗，见 §5）|
| 接口 | **一根 2×6 2.54mm 排针 = PMOD1** |

几何依据：白键宽 23.5 mm（7×23.5 = 164.5 mm 与实测八度 164~164.4 mm 吻合）、
白键可见长 ~150 mm、黑键 13.7 × 95 mm（从白键根部伸出）。
**黑键位置模型 = 交界线中心**（`k×23.5`，k=1,2,4,5,6；E-F、B-C 之间不放）
—— **这是简化**，真实钢琴黑键会略偏（让同组间距均匀），差值约 1 mm，不影响外观。
参数已做成脚本常量 `BLACK_SHIFT_MM`（当前 0.0），拿到权威偏移值只改这一个数。

## 2. ⭐ 丝印对照表（**丝印已按此标注**）

| 键 | PMOD1 物理针 | 网络名 | **FPGA 球号** | version C 可用性 |
|---|---|---|---|---|
| **C** | 5 | `PMOD1_IO6` | **`AA19`** | ✅ 实测可用 |
| **D** | 6 | `PMOD1_IO7` | **`AB20`** | ✅ 实测可用 |
| **E** | 7 | `PMOD1_IO4` | **`AA20`** | ✅ 实测可用 |
| **F** | 8 | `PMOD1_IO5` | **`AA21`** | ✅ 实测可用 |
| **G** | 9 | `PMOD1_IO2` | **`AB21`** | ✅ 实测可用 |
| **A** | 10 | `PMOD1_IO3` | **`AB22`** | ✅ 实测可用 |
| B | — | — | — | **外观件，不接电** |
| — | 1, 2 | — | — | `+3V3` |
| — | 3, 4 | — | — | `GND` |
| — | 11 | `PMOD1_IO0` | `Y21` | ❌ **PR2017 SSPI 专用脚，不可用** |
| — | 12 | `PMOD1_IO1` | `Y22` | ⚠️ 可用，但**已被 `key_pitch` 占用** |

**针序来源**：`_research/pcb/PMOD_PINOUT.md` —— 从官方原理图**按坐标同行+列一致配对**，
并有**官方例程 `pmod_led` 的 cst 逐项交叉印证**（三重来源一致）。
⚠️ **不要接 PMOD0**：它的 8 个球号里 `P19 R19 T21 U21` 在 version C 上**全部被拒**。

## 3. 电气设计

| 项 | 值 | 说明 |
|---|---|---|
| 上拉 | **1 MΩ ±1%**（`RP_*`）→ 该 bank 的 3.3 V VCCIO | 决定 RC 时间常数 |
| 串联保护 | **470 Ω ±1%**（`RS_*`） | 限流 + ESD 缓冲 |
| PAD 尺寸 | **19 × 44 mm**（白键前段 `y = 8~52 mm`）| 见 §4 为何放前段 |
| 相邻 PAD 净间距 | **4.5 mm** | 23.5 − 19 = 4.5 |
| **正下方不铺地** | **本板把 GND 铺铜只放在排针后方**，琴键区（含 PAD）**完全没有铺铜** ⇒ 天然满足 ≥2mm 要求 | 见生成器 `POUR` 部分 |
| 走线宽度 | 信号 20 mil（0.508 mm）、3V3 15 mil（0.381 mm） | 嘉立创常规工艺轻松覆盖 |
| 过孔 | **本板 0 个**（全 TOP 层走线） | 少过孔、低寄生 |
| 测试点 | 每通道 1 个（`TP_*`，1.5 mm 焊盘） | 可夹示波器/万用表 |
| IO 约束 | `PULL_MODE=NONE` / `LVCMOS33` / `BANK_VCCIO=3.3` | **不开内部上拉**（外部已有 1M） |

## 4. ⚠️ 为什么画 7 个键却只用 6 个（**这是几何上必须，不是美化**）

渲染回读时发现：**只画 6 个白键（C..A）时，A# 黑键落在 `k=6 → x=141 mm`，
正好压在板子右边缘** —— 因为 A# 属于 **A-B 交界**，而 B 键不存在。

⇒ **解法**：画 **7 个白键（C D E F G A B）**，其中 **6 个做触摸、B 只做外观**。
好处：黑键恢复成 **2+3**、板宽正好 **164.5 mm = 一个八度**、**更像钢琴**。
⇒ **通道数仍是 6**（符合"一根 PMOD1"的引脚预算），只多了键形与丝印。

## 5. BOM + 估价

| 位号 | 元件 | 规格 | 数量 | 单价参考 | 采购关键词 |
|---|---|---|---|---|---|
| `RP_C..RP_A` | 上拉电阻 | **1 MΩ ±1% 0603** | 6 | ¥0.01 | `0603 1MΩ ±1%` |
| `RS_C..RS_A` | 串联电阻 | **470 Ω ±1% 0603** | 6 | ¥0.01 | `0603 470Ω ±1%` |
| `J1` | 排针 | **2×6 2.54 mm 直插** | 1 | ¥0.50 | `2.54mm 2x6 排针` |
| `PAD_*` | 触摸焊盘 | **PCB 铜箔本身，无需元件** | 6 | ¥0 | — |
| `TP_*` | 测试点 | 用 1.5 mm 裸焊盘代替 | 6 | ¥0 | — |
| PCB | 双层板 | 164.5 × 172 mm，1.6 mm，喷锡 | 1 | **≈¥0~30**（嘉立创首单常免费；但此尺寸偏大，可能超出免费额度） | — |

**元件合计 ≈ ¥0.62/板**（不含 PCB）。**全板无 IC、无源器件只有 12 个电阻** ⇒ 手焊 10 分钟内。

## 6. ⚠️ 诚实说明（**未验证 / 有风险项**）

| # | 项 | 状态 |
|---|---|---|
| 1 | **从未在真板上验证过** | ❌ 触摸灵敏度、阈值、实际 RC 计数**全部未实测** |
| 2 | **未做厂家 DFM 检查** | ❌ 未提交嘉立创做 DRC/DFM；线宽/间距/孔径**未由厂家确认** |
| 3 | **格式 Plan A/B 未定** | ⚠️ 本工程按 **V2（旧格式，数组式）** 生成 —— 与你电脑上那个归档同格式；**用户 V1 导入结果仍未反馈**。生成器已做成可切换（`FORMAT` 参数），导入失败改一个参数即可，但 **V3 分支尚未实现**（会明确报 `NotImplementedError`，不静默出错） |
| 4 | **排针封装的通孔/钻孔未正确建模** | ⚠️ `PAD` 记录里**没有写孔**（v2 的孔格式我没有真值样本） ⇒ **打板前必须补**，否则排针孔可能不出 |
| 5 | **丝印实心填充是否被 EDA 接受** | ⚠️ 我用 `FILL` on layer 3(TOP_SILK) 表达黑键；格式取自参考工程（但参考工程是铜层 FILL）⇒ **层 3 上的 FILL 未经真机验证** |
| 6 | **黑键偏移量用了简化模型** | ⚠️ 交界线中心；真实钢琴略偏（差 ~1 mm），未查到权威数值 |
| 7 | **触摸 PAD 只在前段（y 8~52）** | ⚠️ 白键后半段不灵敏。理由见 §4/§3；**若要求全键灵敏需另做屏蔽，未验证** |
| 8 | **未做阻抗/串扰仿真** | ❌ 只做了几何间距计算（4.5 mm 相邻间距、黑键区无铜） |
| 9 | **板子尺寸 164.5 × 172 mm** | ⚠️ **可能超出嘉立创某些免费/特价档**，下单前请确认价格 |
| 10 | **`AA19/AB20/AA20` 只验了"能当输出用"** | ⚠️ 探针做成 `output`；**做输入（触摸读回）时的电气特性未单独验**（但对 LVCMOS33 输入，P&R 通过即可用） |

## 7. 打板前建议做的三件事
1. **补排针孔**（第 4 条）—— 对照一个真实的 2×6 排针封装，把钻孔写进 `PAD`。
2. **确认板子报价**（第 9 条）—— 164.5×172 mm 偏大。
3. **先用最小工程验证导入**（第 3 条）—— `fpga_hank/pcb/minimal/V1_outline.zip` 已验证过结构，
   本工程同格式；**导入成功再打板**。
