wongben2333-crypto/26Embedded/fpga_spark/lcd_test/hardware/enclosure/reports/2026-10-28/acl_verification.txt

STEP directory:
fpga_hardware\enclosure\STEP NT AUTHORITY\Authenticated Users:(OI)(CI)(RX)
                             S-1-5-21-1327566139-1864075914-221906799-1504022844:(I)(OI)(CI)(M)
                             S-1-5-21-2705686603-1569318946-2241925153-3276837965:(I)(OI)(CI)(M)
                             LAPTOP-WJJ\CodexSandboxUsers:(I)(OI)(CI)(M)
                             S-1-5-21-3865435093-698181262-2008037924-3242669815:(I)(OI)(CI)(M)
                             BUILTIN\Administrators:(I)(F)
                             BUILTIN\Administrators:(I)(OI)(CI)(IO)(F)
                             NT AUTHORITY\SYSTEM:(I)(F)
                             NT AUTHORITY\SYSTEM:(I)(OI)(CI)(IO)(F)
                             NT AUTHORITY\Authenticated Users:(I)(M)
                             NT AUTHORITY\Authenticated Users:(I)(OI)(CI)(IO)(M)
                             BUILTIN\Users:(I)(RX)
                             BUILTIN\Users:(I)(OI)(CI)(IO)(GR,GE)

Successfully processed 1 files; Failed processing 0 files

bottom_shell.step:
fpga_hardware\enclosure\STEP\bottom_shell.step NT AUTHORITY\Authenticated Users:(R)
                                               NT AUTHORITY\SYSTEM:(F)
                                               BUILTIN\Administrators:(F)
                                               OWNER RIGHTS:(F)

Successfully processed 1 files; Failed processing 0 files

top_shell.step:
fpga_hardware\enclosure\STEP\top_shell.step NT AUTHORITY\Authenticated Users:(R)
                                            NT AUTHORITY\SYSTEM:(F)
                                            BUILTIN\Administrators:(F)
                                            OWNER RIGHTS:(F)

Successfully processed 1 files; Failed processing 0 files

keybed.step:
fpga_hardware\enclosure\STEP\keybed.step NT AUTHORITY\Authenticated Users:(R)
                                         NT AUTHORITY\SYSTEM:(F)
                                         BUILTIN\Administrators:(F)
                                         OWNER RIGHTS:(F)

Successfully processed 1 files; Failed processing 0 files

assembly.step:
fpga_hardware\enclosure\STEP\assembly.step NT AUTHORITY\Authenticated Users:(R)
                                           NT AUTHORITY\SYSTEM:(F)
                                           BUILTIN\Administrators:(F)
                                           OWNER RIGHTS:(F)

Successfully processed 1 files; Failed processing 0 files
