wongben2333-crypto/26Embedded/fpga_hank/skills/tech-doc-writing/references/format-spec-measured.md

# FORMAT-SPEC —— 参照《技术文档-冯若陈-国二.pdf》的写作格式规范

> **面向**：2026 全国大学生嵌入式芯片与系统设计竞赛 · FPGA 创新设计赛道（高云杯）· **选题二**「基于 FPGA 的实时多音色合成电子乐器引擎」技术文档（中文，Word 交付）。
> **撰写人**：`doc-format` 调研员 ｜ **日期**：2026-10-06
> **本文件用途**：让后续撰写者**照着就能排版**，而不是"看着像"。

---

## 0. 证据基础与方法（**先说清楚哪些是实测、哪些没测到**）

### 0.1 证据来源

| # | 来源 | 状态 |
|---|---|---|
| 1 | `技术文档-冯若陈-国二.pdf`（仓库根，**23 259 945 B**，**91 页**，2026-09-17） | ✅ 已通读全文 |
| 2 | `_topic2.txt`（选题指南文字层；**第 15–16 页 = 选题二全文**） | ✅ 已读 |
| 3 | 该 PDF 的**内置文字层**（91 页全部有文字层，**不是扫描件**）—— 提取物落盘为 [`ref-fulltext.txt`](_research/doc-format/ref-fulltext.txt)（56 037 字符 / 2 772 行） | ✅ 全文可检索 |

### 0.2 方法（可复核）

| 方法 | 做了什么 | 产出 |
|---|---|---|
| **A. 文字层提取** | 从 PDF 内已有文字层导全 91 页文本（含页码、目录、公式字符） | `ref-fulltext.txt` |
| **B. 字体表提取** | 解析 PDF 对象表，取全部 `/BaseFont` | 见 §2.2 |
| **C. 精确排版测量** | 解压每页 content stream，解析 `Tf`（字号）、`Tm/Td`（定位）、`cm`（变换矩阵），**在绝对坐标系里算出每行文字的 x/y** | 见 §2.3 / §2.4 |
| **D. 图片对象提取** | 解出 PDF 内嵌图像共 **100 个**（93 个成功还原），落盘 `ref-pages/` | 见 §2.5 |
| **E. 结构普查** | 正则统计图题/表题/参考文献/续表标记/页脚 | 见 §1.4 |

> ⚠️ **本机没有 PDF 渲染器**（`pypdf` / `pypdfium2` / `PyMuPDF` / `pdftoppm` / `mutool` **全部不存在**，见 §6.1）。
> ⇒ 因此**没有"整页截图"**，版面判断全部来自 **content stream 的数值测量（方法 C）**。
> ⇒ `ref-pages/` 里是**图本身**（矢量图/截图），**不是整页快照**。这一点请勿误读。

### 0.3 标了"未确认"的地方（**不许当事实用**）

| 项 | 状态 |
|---|---|
| 页边距的**精确值** | ⚠️ **只有下界**（实测正文最左 x = 70.9 pt ⇒ 左/右 ≥ 2.50 cm）。见 §7.1 |
| 章节**样式的大纲级别**（Word style 名） | ⚠️ **未确认**（无法从 content stream 读出样式名） |
| 行距是"固定 18 pt"还是"1.5 倍行距" | ⚠️ **两者在版面上等价**，无法区分。见 §7.2 |
| 段前/段后间距的**精确值** | ⚠️ 只见 ~36.6 pt 的双倍行距（应为段间距），但**无法分解**。见 §7.2 |
| 封面的**校徽/校名图片** | ⚠️ 未在 93 个导出图中识别出来（可能是另存为矢量或缺失） |
| 参考文档**是否有摘要页** | ✅ **确认没有** —— 见 §1.2 |

---

## 1. 结构提取（参考文档的实际骨架）

### 1.1 章节顺序与层级（**实测**）

```
[封面 1 页]  表格 7 字段（不是大标题式封面）
    报告类型 / 赛道类型 / 参赛题目 / 作品名称 / 队伍编号 / 团队名称 / 团队成员
[目录 2 页]  自动目录（带点线引导 + 页码），**无摘要、无关键词、无 Abstract**
一、设计概述 .......................... P4      （2 页）
    1.1 设计目的
    1.2 应用领域
    1.3 主要技术特点
    1.4 关键性能指标
    1.5 主要创新点                    ← ★ 创新点放在第 1 章，不放文末
二、系统组成及功能说明 ................ P6      （59 页 = 全文 65%）
    2.1 整体介绍                      ← 系统框图 + 逐模块一段话
    2.2 各模块介绍                    （P7–P65）
        2.2.1 … 2.2.8                 （8 个模块）
        每个模块固定三段式：
            (1) 理论/原理
            (2) Simulink 仿真
            (3) Modelsim 仿真          ← ★ 统一"先原理 → 再仿真 → 再上板"
三、完成情况及性能参数 ................ P65     （14 页）
    3.1 完成情况                      （11 页，逐项对赛题要求 + 实物截图）
    3.2 性能参数                      （1 页）
四、作品总结 .......................... P79     （3 页）
    4.1 可扩展之处                    ← ★ 主动列自己的不足（5 条）
    4.2 心得体会                      ← 每位队员各写一段（实名署名）
参考文献 .............................. P82     （2 页，16 条）
附录1：部分核心源代码 ................. P84     （6 页）
附录2：部分 ACG525 原理图 ............. P90     （1 页）
[末页] P91 空白
```

### 1.2 ⚠️ 三条**与直觉相反**的发现（必须知道）

| # | 发现 | 依据 |
|---|---|---|
| **1** | **参考文档没有摘要、没有关键词**。目录之后直接是"一、设计概述"。 | 目录页（P2–P3）列出的一级标题只有"一、二、三、四"+"参考文献"+"附录1/2"（`ref-fulltext.txt` L26–L167） |
| **2** | **图/表编号是全局连续**，不是"章-序"式：**图1 … 图96**、**表1 … 表21**。 | 正则普查：`图` 题 **96** 条，编号 1..96 连续无缺口；`表` 题 **21** 条，1..21 连续 |
| **3** | **一级标题用中文数字**（"一、二、三、四"），二级及以下用阿拉伯数字（`2.2.3.1`），**最深到 4 级**。 | P2 目录逐条；正文 P4/P6/P65/P79 |

> ⇒ **大纲 v1 里写的"图 3-1 / 表 3-1"与参考文档不符**（v1 第 23 行）。
> ⇒ **本文件建议：沿用参考文档的全局连续编号**（若最终选择"章-序"式，**必须全篇统一**，且第五章之后不会再变；混用是硬伤）。

### 1.3 各章页数占比（**实测**，共 91 页）

| 部分 | 页码 | 页数 | 占比 |
|---|---|---|---|
| 封面 | P1 | 1 | 1.1% |
| 目录 | P2–P3 | 2 | 2.2% |
| 一、设计概述 | P4–P5 | 2 | 2.2% |
| **二、系统组成及功能说明** | **P6–P64** | **59** | **64.8%** |
| 三、完成情况及性能参数 | P65–P78 | 14 | 15.4% |
| 四、作品总结 | P79–P81 | 3 | 3.3% |
| 参考文献 | P82–P83 | 2 | 2.2% |
| 附录 | P84–P90 | 7 | 7.7% |
| 空白 | P91 | 1 | 1.1% |

**⇒ 关键结论：正文 65% 的篇幅给了"各模块的实现过程"。** 这是国二作品的真实配比。
（第 2 章里的 8 个模块平均每个 **7.4 页**；较难的"混响/回声"给到 13 页。）

### 1.4 结构量化指标（**实测**，可直接当"内容密度"目标）

| 指标 | 参考文档实测 | 换算 |
|---|---|---|
| 总页数 | **91** | — |
| 图（含截图） | **96 张** | 平均 **1.05 张/页** |
| 表 | **21 张** | 平均 0.23 张/页 |
| 公式 | **27 个**（编号 (1)…(27)） | 集中在第 2 章理论段 |
| 参考文献 | **16 条**，正文引用 **80 处** | 平均每篇引用 5 次 |
| 内嵌图片对象 | **100 个**（8 个 JPEG + 92 个 Flate） | 见 §2.5 |
| 代码呈现 | **不作为代码块排版，全部是截图**（"图29 带通滤波器部分代码"等） | 附录 1（P84–P89）同样是**截图** |
| 续表标记 | **继续下一页** 2 处 + **表N – 续上一页** 2 处 | 跨页表格的两种写法 |
| 页脚 | **"第 N 页共 91 页"**，**91 页全部有** | 无页眉、无页码以外的信息 |

---

## 2. 格式规范表（**可照做**）

> ⚠️ 全部数值来自方法 C 的 absolute-position 测量；**字号是可靠量**，页边距是**下界**。

### 2.1 页面与整体

| 项 | 规范 | 依据 |
|---|---|---|
| 纸张 | **A4 纵向**（MediaBox = `0 0 595.28 841.89` pt = 210 × 297 mm） | PDF `/MediaBox` 实测 |
| 页边距 | **左 = 右 ≈ 2.5 cm**（≥ 70.9 pt）；**上 ≥ 2.54 cm**（正文顶 y ≤ 765 pt）；**下 ≈ 1.34 cm**（页脚基线 y = 38 pt） | ⚠️ 见 §7.1 的三点，**这是下界不是精确值** |
| 正文最右 x | ≤ **522.2 pt**（= 184 mm） | 实测全部页面 max x |
| 单/双面 | 单面（无对称页边距迹象） | — |
| 分栏 | **单栏** | — |

### 2.2 字体（**实测**：PDF 内 `/BaseFont` 直接读出）

| 用途 | 中文字体 | 西文字体 | 依据 |
|---|---|---|---|
| **正文** | **宋体 SimSun** | **Times New Roman** | `KKOXNF+SimSun`、`SGWAFB+TimesNewRomanPSMT` |
| **标题** | **黑体 SimHei** | — | `SLAYQY+SimHei` |
| **图/表题** | **黑体 SimHei 10.5 pt** | Times New Roman | 同上，10.5 pt 分支 |
| **引用/强调** | 楷体 KaiTi、仿宋 FangSong（出现次数很少：14 / 10 次） | Times New Roman *Italic* / **Bold** | `QHCBFP+KaiTi`、`GVSGHK+FangSong` |
| **代码** | — | **LMMono10-Regular**（等宽，LaTeX 系） | `HFINBG+LMMono10-Regular-Identity-H`，**453 次** |
| **公式** | — | **CMR / CMEX / NewTXMI 系列**（Computer Modern + txfonts） | `KNCTBJ+CMR12`、`SJZWEQ+CMR8`、`XYYJWN+NewTXMI` 等 8 种 |

> ⭐ **两条重要判断**：
> 1. **公式字体是 Computer Modern + txfonts + CMEX10** ⇒ 公式**不是 Word 公式编辑器默认输出**，而是 **LaTeX 数学字体**（很可能是 MathType 选用了 `Times New Roman + Euclid` 之外的 LaTeX 字体，或直接由 LaTeX 生成再插入）。
> 2. **代码用的是 `LMMono10`（LaTeX 等宽字体）** ⇒ **附录里的代码截图极可能来自 LaTeX 的 `listings` 宏包**，不是 Word 里敲的。

### 2.3 字号规范（**实测直方图**）

| 元素 | 实测字号 | 对应中文字号名（GB 映射） | 实测出现次数 |
|---|---|---|---|
| **正文**（宋体 + Times） | **12.0 pt** | **小四** | SimSun 12pt **1 814** 次；Times 12pt **1 981** 次 |
| **一级标题**（黑体） | **14.0 pt** | **四号** | SimHei 14pt 出现 **11** 次（≈ 4 个一级标题 + 部分二级） |
| **二/三级标题**（黑体） | **12.0 pt** | **小四（加粗）** | SimHei 12pt **104** 次 |
| **图题/表题**（黑体） | **10.5 pt** | **五号** | SimHei 10.5pt **251** 次 |
| **表格内文字** | **10.5 pt** | **五号** | SimSun 10.5pt **424** 次 + LMMono10 10.5pt **453** 次 |
| **公式内文字** | 12.0 / 8.0 / 6.0 pt | 小四 / 小五 / 小六 | CMR12 202 次、CMR8 200 次、CMR6 10 次（上下标分层） |
| **代码** | **约 8.0 pt** | **小五**（`7.97` 是排版后的实际值） | 见 §7.3 |

### 2.4 行距与段落（**实测**）

| 项 | 规范 | 实测依据 |
|---|---|---|
| **正文行距** | **18.0 pt**（12 pt 字 ⇒ **1.5 倍行距**） | 同页相邻正文行 y 差：**18.0 pt 出现 731 次**（绝对主导）；次多 15.7/15.8 pt（表格内） |
| **段间距** | 存在，表现为 **~36.6 pt**（= 18.0 × 2 + 0.6，即"空一行"或"段前段后各 0.5 行"） | 36.6 / 36.7 / 36.0 pt 合计 **76** 次 |
| **首行缩进** | ⚠️ **未确认**（content stream 无法区分"缩进 2 字符"与"排版后起点"）。**建议按中文惯例设 2 字符** | — |
| **对齐** | 两端对齐（正文右边界整齐到 522 pt 一线） | max x 分布集中在 512/518/521/522 |
| **标题对齐** | **左对齐、不缩进**（一级标题 x 也是 70.9 pt，与正文同起点） | 实测一级标题与正文同 x |
| **页脚位置** | 基线 y = **38 pt**（距下边 ~1.34 cm），**91 页全部命中同一 y** | `ybottom common: (38, 91)` |

### 2.5 图表规范

| 项 | 参考文档做法 | 实测依据 |
|---|---|---|
| **图题位置** | **图下方**，居中 | PDF 中图题 y 恒小于图 | 
| **图题格式** | `图N 中文说明`（**数字与说明之间一个空格**，无冒点、无括号） | 例：`图1 系统硬件架构示意图`、`图23 升采样的Modelsim 仿真波形图` |
| **图编号** | **全局连续** 1..96 | 普查无缺口 |
| **表题位置** | **表上方**，居中 | 例（P8）：表题在数据行之前 |
| **表题格式** | `表N 中文说明` | 例：`表1 4 种异步FIFO`、`表6 不同空间类型的混响时间` |
| **表编号** | **全局连续** 1..21 | 普查 |
| **跨页表** | 续表页重写表题：**`表3 – 续上一页`**（破折号 + "续上一页"），并**重复表头** | `表3`、`表17` 两处；原文还有 `继续下一页` 字样 2 处 |
| **表线** | ⚠️ **无法从文字层判定是否三线表** | 需人工看图。**建议用三线表**（学术规范，且参考文档表内字号 10.5 pt 与"轻表线"风格一致） |
| **图内文字** | 图是**截图/矢量图**，图内文字不参与正文排版 | 96 张图 = 96 个图片对象 |
| **图宽** | 大部分为**通栏**（跨越正文宽度） | 图片对象宽 1600–2000 px 居多，按 300 dpi 折算 ≈ 13–17 cm |

### 2.6 公式规范

| 项 | 规范 | 依据 |
|---|---|---|
| 是否用公式编辑器 | **是**（字体为 LaTeX 数学字体，非纯文本） | §2.2 |
| 公式位置 | **居中** | 实测公式块 x 居中于正文区 |
| 编号位置 | **右顶格**，格式 `(N)` 全局连续 | `(1)` … `(27)`，如 `(1)` 在 P11、`(27)` 在 P51 |
| 编号连续性 | **全局连续**，不按章重排 | 普查 |
| 正文引用方式 | 直接文字提及（"根据式(6)"），**未见"式(2-1)"式编号** | 全文检索 |

### 2.7 参考文献规范

| 项 | 参考文档做法 | 评价 |
|---|---|---|
| 条数 | **16 条** | — |
| 标题 | 一级标题（无编号）：**`参考文献`** | P82 |
| 排列 | **按正文引用顺序**编号 `[1]`…`[16]` | 顺序与首次引用一致 |
| 正文标注 | **方括号上标**：`…得到需要的声音[1]。` | 80 处；含 `[1]`..`[16]` |
| ⚠️ **著录格式** | **不规范** —— 是"CNKI 导出原文"直接粘贴，混入了 `major:` / `download:` / `album:` / `CLC:` / `dbcode:` / `filename:` 等**数据库字段**；`[5]` 出现 `黄玉健and 黄永庆`（未清理的英文连接词） | 见 `ref-fulltext.txt` L2441–L2496 |
| 语言混排 | 中英文混排，英文条目用 `In <会议名>, pages x–y, <月> <年>` 的 **IEEE 风格**（不是 GB/T 7714 的中文式） | — |

> ⚠️ **建议：不要模仿参考文档的参考文献格式。** 那是它最明显的减分项。
> **改用 GB/T 7714-2015**（中文竞赛/学位论文事实标准），并**清理掉数据库字段**。这条不改会显得很业余。

### 2.8 代码规范

| 项 | 参考文档做法 | 建议 |
|---|---|---|
| 呈现方式 | **全部是截图**（`图29 带通滤波器部分代码`、`图32 CSD 编码前的系数代码`…），附录 1 6 页也是截图 | ⚠️ **对本题不利** |
| 代码字体 | 截图内为 `LMMono10`（LaTeX `listings` 风格） | — |
| 是否保留缩进/高亮 | 截图保留了编辑器的语法高亮（部分） | — |

> 🔴 **对选题二的关键分歧（务必看）**：
> 赛题明确要求「**通过 RTL 代码佐证纯硬件实时合成通路，验证无预录音频播放行为**」（`_topic2.txt` L323–324）。
> **评委要"审查代码"，而截图无法被搜索、无法被复制、无法核对**。
> ⇒ **建议：至少关键模块用真正的等宽字体代码块**（Consolas / Courier New / 宋体等宽，**8–9 pt**，可加 5% 灰底），
> **并保留 3–5 行"证据性代码"原文**（相位累加器、`freq_word`、ADSR 状态机、限幅），而不是只放截图。
> **可以两者并存**：主体用代码块，附录用 IDE 截图（带行号）。

### 2.9 页眉页脚

| 项 | 参考文档实测 |
|---|---|
| 页眉 | **无** |
| 页脚 | **`第 N 页共 91 页`**，居中，**91 页 100% 命中**，基线 y = 38 pt |
| 页码起始 | 封面也为"第 1 页"，**连续编号**，无罗马/阿拉伯分段 |
| 总页数 | 写死在页脚（"共 91 页"）⇒ 是**域**或最后手填 |

### 2.10 封面（**实测字段**，P1）

封面**不是大标题式**，而是一个 **7 行 2 列表格**：

| 左列（字段名） | 右列（值） |
|---|---|
| 报告类型 | 设计文档 |
| 赛道类型 | 高云半导体赛道 |
| 参赛题目 | 基于FPGA 的高精度音频处理和效果生成系统 |
| 作品名称 | 声之形 |
| 队伍编号 | 2948 |
| 团队名称 | 上电不烧板 |
| 团队成员 | 王喆 / 冯若陈 / 李光耀 |

> 📌 另有一个**竞赛徽标图**（`图` 对象 `img_obj4_935x195.png` = "共創芯未來" 徽标，见 `ref-pages/`）。
> ⇒ **我们的封面需要一个**：报告类型 / 赛道类型 / 参赛题目 / 作品名称 / 队伍编号 / 团队名称 / 团队成员。
> **⚠️ 我们的队伍信息与作品名尚未提供 ⇒ 标"未确认"，需用户给。**

---

## 3. 参考文档的**写作风格**（以及如何避开"AI 味"）

### 3.1 人称与时态（**实测统计**）

| 特征 | 参考文档实际做法 |
|---|---|
| **人称** | **"我们"** 为主（设计叙述）；**"本系统/本设计"** 用于指标与总结；**几乎不用"本文"**（"本文"只在需要学术腔时零散出现） |
| **时态** | 全篇**现在时/完成时混用**：设计描述用现在时（"I2S 主要有三个信号"），已完成工作用"我们采用了…" |
| **被动语态** | 少 |
| **评价性形容词** | **很少**（"精美"仅在讲 UI 时用过一次）。**结论靠数字，不靠形容词** |

### 3.2 ⭐ **"没有 AI 味"的 7 个具体特征**（参考文档里真实存在的写法，**建议逐条模仿**）

| # | 特征 | 参考文档原例 |
|---|---|---|
| **1** | **大量"为什么选它、不选别的"的对比论证**，且**列出被否方案的理由** | 滤波器：把直接型/级联型/并联型三种都分析，然后"**因此不采用直接型结构[7]**"、"**因此我们选用级联型结构**"（P21–P22） |
| **2** | **承认失败与返工，并写出原因** | `4.1 可扩展之处` 主动列 5 条不足："增益设置精度不够，仅有 ±6dB,±12dB"、"甚至会有破音的情况发生"、**"受比赛时间限制未进行系统以及硬件电路的优化"**（P79） |
| **3** | **心得体会实名到人**，每人一段，含具体卡住的技术细节 | 王喆写"算术移位不加括号，导致表达式右侧直到分号的所有信号运算都被纳入算术移位的作用域…**编译阶段没有任何报错和警报**"（P80）；冯若陈写"串口屏无法与FPGA 通讯…后来引出一个gpio 口作为rx 引脚"（P81） |
| **4** | **引经据典但贴合**（不是装饰） | "纸上得来终觉浅，绝知此事要躬行"（P81）、"'先用后学、学以致用，以赛代学、以学促赛'这十六个字"（P80） |
| **5** | **给具体到小数位的数字**，并且**说明数字怎么来的** | "混响时间设为 0.5s，1.0s"、"取 d = 79.7 − 50 + 6 = 23.7 ms"（P39）、"节省将近 **60%** 的ALU 资源"（P27） |
| **6** | **图表编号被正文反复交叉引用** | "**将图18与图16进行对比**，可以发现采样率有所提升"（P16）、"**与图16所示的输入信号对比**"（P17）—— 每张图都被"用"了，不是摆设 |
| **7** | **小节标题是"动作/问题"，不是名词堆** | "（1）滤波器工作原理"、"（2）带通滤波器fdatool 参数设计"、"（3）量化"、"（4）CSD 编码" —— 是**实现步骤**的顺序，读起来是一条线 |

### 3.3 参考文档的**具体可学手法**（挑 6 条最值钱的）

| # | 手法 | 参考文档怎么用的 | 我们怎么用 |
|---|---|---|---|
| **1** | **"原理 → 仿真 → 上板"三段式** | 每个模块都走：先推公式（式1–式27），再 Simulink 看波形，再 ModelSim 看时序，最后 P65+ 上板对比 | 我们是全 HDL 乐器：**原理 → ModelSim 波形 → 上板录音/频谱**。**同一模块的三种证据并列**，说服力最强 |
| **2** | **输入端 vs 输出端"左右声道并排对比"** | **用 Audition 把原声放左声道、处理后的放右声道，画成一张时频图**（图81/85/86/89/94） | ⭐ **我们有一个更好的版本**：`out/record/faded_ref.wav` 与 `faded_piano.wav`（各 5 760 044 B）⇒ **可做"参考演奏 vs 我们的合成"左右声道对比时频图**。这正是参考文档证明"效果实现"的核心手法 |
| **3** | **用表格承载参数，用图承载结果** | 表 8（19 抽头 FIR 参数）、表 9（6 个梳状滤波器参数）把长参数列进表；图 46/47 放幅频/相频 | 我们的谐波权重表、ADSR 参数、资源占用、延迟分位数**全部进表**；频谱/波形**进图** |
| **4** | **"设计约束 → 参数取值"的算式留痕** | "**取 d = 79.7 − 50 + 6 = 23.7 ms**"（P39）—— 参数不是拍的，是算的 | 我们的 `BCK_DIV=1 ⇒ fs = 50 MHz/512 = 97656.25 Hz`、`MUTE_LEN = 5 ms × 97656.25 = 488` —— **照这个写法把算式写出来** |
| **5** | **实物截图证明"真的跑起来了"** | 图82–图95：LED 点亮的照片 + 数码管显示字符 | 我们需要**真机照片**（板子 + 耳机 + 电脑 GUI）⚠️ 目前**没有** |
| **6** | **代码贴片的"上下文标注"** | `//` 后写"若在此级输出，倍频参数为32"（P84） | 我们的 RTL 注释本来就很详细（`tone_bank.v` 开头的架构说明），**直接引原文注释**，天然不像 AI 写的 |

### 3.4 ⛔ **"AI 味"的来源清单**（对照自查，逐条避免）

| AI 味症状 | 反例（参考文档**从不**这么写） | 我们应该怎么写 |
|---|---|---|
| 排比式空洞小标题 | — | 用"（3）量化"这种**具体动作**，不用"深入探索""全面优化" |
| "不仅…而且…"、"值得注意的是"、"综上所述" | 参考文档几乎没有 | 直接陈述 + 数字 |
| 形容词堆砌（"显著提升""极大改善"） | 参考文档用数字代替 | "**节省将近 60% 的 ALU 资源**"（P27） |
| 每条都正面，无失败 | 参考文档有 §4.1 五条不足 | 单列一节写"未达标/不足"，**写清是哪一条赛题要求没做到** |
| 图表是摆设 | 参考文档每图都被正文引用 | **每张图必须在正文被引用至少 1 次**，并说明"从图里看出了什么" |
| 参数无出处 | 参考文档所有参数都写了来源（fdatool / 论文 / 实测） | 每个数字带**文件路径 + 位流指纹** |
| 统一句长（20–25 字） | 参考文档长短句交错，有"我们"、"因此不采用…" | 允许短句、允许口语化的技术判断 |
| 过度加粗 / emoji | 参考文档**无 emoji、加粗极少** | 交付稿**禁 emoji**；加粗只用于表头与关键数字 |

---

## 4. 加分项与雷区（对照赛题与证据纪律）

### 4.1 评委最看重什么（**从评分公式倒推**）

```
分数 ∝ 同时活跃可闻独立振荡器总数 × 实际音频输出采样率
```

| 优先级 | 要证明的事 | 需要什么证据 | 我们**现有**证据 | 缺口 |
|---|---|---|---|---|
| **P0** | **"一个振荡器"的三要素齐全**（独立相位累加器 + 频率调控 + 包络控制） | **RTL 原文**（相位累加器数组、频率字、ADSR 端口）+ **框图让评委一眼数得出来** | ✅ `tone_bank.v` 32 个独立 acc（L20–L31 注释把三要素逐条对应）<br>✅ `adsr.v` `N_VOICES=32` | 需**画框图**（可自绘，属示意） |
| **P0** | **实际输出采样率** | PT8211 时序实测 / 时钟推导 | ✅ **97 656.25 Hz** = 50 MHz / 512（`top.v` L32、`pt8211_tx.v` L80） | ✅ 有；⚠️ 但**真板反推为 ~96 056 Hz，差 1.6%** —— 见 §5.3 |
| **P0** | **N 路均匀频率 + 频谱数出 N 个谱峰**（必备交付物） | **频谱截图 + 可复现判据** | ✅ **仿真：32/32 命中、0 杂散、exit 0**（`32谱峰-取证报告.md`）<br>✅ 图 `.dsh/skills/fpga-verify/tests/spectrum_32peaks.png`<br>✅ 真板录音 `out/record/board_32peaks.wav`、`perf_32peaks.wav` | 🔴 **真板频谱不干净** —— 见 §5.3 |
| **P1** | **复音数 ≥32**（拓展①） | RTL + 资源/时序报告 | ✅ 测试模式 **32 路真振荡器**<br>✅ 演奏引擎 **8 声部 × 6 泛音 = 48 个独立相位累加器** | ⚠️ **"48 泛音"能否算 48 个振荡器"未确认**（赛题：加法合成按运算分量统计 ⇒ 倾向可算，但**需在文档里正面论证**）<br>🔴 **32 声部演奏目前未达成**（20 声部实测 13203 违例 / −6.774 ns / BSRAM 219/340，已回退） |
| **P1** | **≥3 维表情 + ≥2 音色 + 硬件混响/延迟/合唱** | RTL + 听感/频谱 | ✅ 力度/滑音/颤音（CC1/5/65/76/77）、`inst_sel` 多乐器、`audio_fx.v`（混响/延迟/合唱/失真/箱体） | 需**听感样例 + 频谱对比** |
| **P2** | **延迟 ≤5 ms 且确定性无抖动** | **P50/P95/P99/max** | ✅ `latency_report.txt` 曾记 10.3–20.5 µs（P50 15.4 µs） | 🔴 **⚠️ 该文件当前不存在**（`_research/piano/evidence/` 整个目录不存在）⇒ **必须重新取证** |
| **P3** | 可视化 / 脱机 LED / 蓝牙 App | — | ✅ LED `active`、`audio_fx` | 优先级最低 |

### 4.2 🔴 **会被判"敷衍"或"证据不足"的写法**（本项目纪律 + 赛题双重口径）

| # | 雷区 | 为什么致命 | 正确写法 |
|---|---|---|---|
| **1** | **只写"实现了 32 复音"，不给 RTL 与资源证据** | 赛题明说"**可通过 RTL 代码佐证**"、"现场会用频谱 + RTL 代码审查双重验证" | 写"32 路**独立相位累加器**（`tone_bank.v` L20-L23：32 个 32 bit 寄存器 `acc[0..31]`、每路独立 `freq_word`、逐路包络），**同时**在 200 Hz 起、间隔 200 Hz 上发声，FFT 检出 **32/32** 谱峰" |
| **2** | **拿仿真证据冒充上板证据** | 赛题要求"**现场验证**" | **必须分开写**：明确标"仿真证据（ModelSim）"与"真板证据（录音）"，**各自标边界** |
| **3** | **用形容词代替数字**（"延迟很低"） | 拓展③要求报 **P50/P95/P99/最大值** | 用分位数表，并写明样本数、测量点、位流指纹 |
| **4** | **结论不带版本指纹** | AGENTS.md §8.1：本项目已因此栽过（同脚本两次结论相反，实为重烧位流） | 每个数据表加一行：**时间 + `.fs` 名 + `User Code` + 资源占用** |
| **5** | **证据覆盖范围 < 结论范围** | AGENTS.md §9：本项目 3 次栽过（dry-run 当可用、宏观特征当同一首歌、片段通过当整体通过） | 写清"**这份证据只对哪个版本、覆盖了哪些配置**" |
| **6** | **只报最大值/漂亮值，不报离散度** | 32 谱峰判据里**离散度**与**杂散数**同等重要 | 照 `32谱峰-取证报告.md` §三 的**判据表**写：命中数 / 未命中 / 最大频率误差 / **未预期谱峰数** / 电平离散度 / 退出码 |
| **7** | **把"设计未完成"说成"已设计"** | 评委看 RTL 会对不上 | 参考文档的做法：**单列 `可扩展之处`**，写"受比赛时间限制未…"。**这反而加分**（诚实 + 有规划） |
| **8** | **公式/图表编号混用两套体系** | 排版硬伤 | 全篇统一（建议沿用参考文档的全局连续） |
| **9** | **参考文献带 CNKI 数据库字段** | 参考文档的减分项，别学 | GB/T 7714-2015，清理 `download:`/`CLC:`/`filename:` |
| **10** | **emoji / 大量加粗 / "综上所述"** | 显 AI 味 | 全禁 |

### 4.3 参考文档里**最值得学的 5 个"证据呈现"手法**（**重点**）

| # | 手法 | 原例 | 迁移到我们 |
|---|---|---|---|
| **1** | **"判据 → 门限 → 实测 → 结论"四列表** | 参考文档用"表2 ISO 倍频程标准"这类静态表；**我们的 `32谱峰-取证报告.md` §三 已经是这个形式**（判据/门限/实测/结论 ✅） | ⭐ **直接把这个表搬进正文**，这就是"证据强度对准结论"的最佳呈现 |
| **2** | **左右声道对比时频图** | 图81/85/86/89/94（Audition 时频图，原声左 / 处理后右） | ⭐ 用 `faded_ref.wav` vs `faded_piano.wav` 做同款图 |
| **3** | **实物照片分状态连拍** | 图82→图83→图84：LED1 点亮→熄灭→点亮（三张连续说明状态翻转） | 我们：切换音色/模式时的 LED + 屏幕状态连拍 |
| **4** | **参数表与它对应的"幅频响应图"配对出现** | 表11 前级滤波器参数 + 图68 前级滤波器幅频特性 | 我们：谐波权重表 + 该表对应的频谱图（**成对出现**，可信度立刻上升） |
| **5** | **"跨页续表"规范** | `表17 – 续上一页` + 重复表头 | 我们的长表（如谐波权重 5 档 × 6 泛音）跨页时照此办理 |

---

## 5. ⚠️ **我们文档特有的三个"必须先解决"问题**

> 这三条是本次调研**在核对证据时发现的**，写文档前必须处理，否则会写出**无法自证**的结论。

### 5.1 🔴 **重要：真机 32 谱峰的频谱并不干净（与"仿真 32/32"不是一回事）**

| 证据 | 结果 |
|---|---|
| **仿真**（`docs/evidence/tone_samples_snap.txt`，SHA256 `91FC2BDE…`） | ✅ **32/32 命中、0 杂散、离散度 0.77 dB、exit 0** |
| **真板录音**（`out/record/perf_32peaks.wav`，`_verify-flow/round3/out_perf32.txt`、`cls_perf_32peaks.txt`） | ⚠️ **32 个栅格频率全部命中**（32/32，误差 −0.026 ~ +0.126 Hz）**但**：<br>• `peaks(>=-40 dBc) = 584` ⇒ **杂散 552 个**<br>• **高于最高目标音（6400 Hz）的杂散 488 个**，最强 **−3.65 dBc @ 12800.11 Hz**（比最低的目标音还高）<br>• 非栅格杂散：C 类边带 254 个、D 类其他 117 个<br>• **A+B 可解释比例仅 32.8%** |

**⇒ 后果**：这条证据**不足以支撑"现场频谱可数出 32 个独立谱峰"**（数得出来，但会被 488 根杂散柱淹没）。
**⇒ 必须做**（二选一或都做）：
1. **查根因**：`top.v` L68 的**上电复位只有 2^19/50 MHz ≈ 10.5 ms**，而 `bench_gate` 每 32768 采样轮换一次门控；**以及 `tone_bank` 的 ROM 时分复用 MUX 是否在切换瞬间漏出地址残影** —— 这两个都是"预期外谱线"的合理嫌疑源。
2. **改判据口径**：把"检出 32 个谱峰"改成"**在 32 个预期频点全部检出、且能量占优**"，并**如实报告杂散数量与最强杂散电平**（这才符合 §4.2 第 6 条）。
**⛔ 绝对不要**：只贴仿真图、用仿真的"0 杂散"去描述真板结果。

### 5.2 ⚠️ **证据目录路径已变，早期清单指向的文件不存在**

| 早期文档写的路径 | 实际情况 |
|---|---|
| `_research/piano/evidence/*.tr.txt`、`latency_report.txt`、`regression_report.txt` | 🔴 **`_research/piano/` 目录不存在**（实测）。这些文件现在**只在 `26Embedded/fpga_hank/_research/piano/evidence/`**（队友那份克隆）里 |
| `_research/effects*/` | ✅ 存在（`_research/effects/`、`_research/effects-impl/`） |
| `_research/pc-link/*.md` | ✅ 存在 |

**⇒ 后果**：`PROJECT-FACTS-LEAD.md` §五 列出的"延迟/时序证据文件"**当前在活源里取不到**。
**⇒ 必须做**：**重新生成或从 `26Embedded/` 拷贝并重新核对**；写进文档的每个路径都要**当场 `Test-Path` 一次**。

### 5.3 ⚠️ **采样率在两个口径下不一致（1.6%），文档必须解释而不是回避**

| 口径 | 值 | 来源 |
|---|---|---|
| **设计值（标称）** | **97 656.25 Hz** = 50 MHz / (BCK_DIV 1 × 16 × 32) | `top.v` L32、`pt8211_tx.v` L80 |
| **真板录音反推** | **≈ 96 056 Hz**（96 056.12 / 96 056.13，三次录音一致） | `_verify-flow/round3/out_fs_infer.txt` |

**分析（供撰写者判断，**不是结论**）**：
- 反推方法：利用"B 族杂散 `f + 56.1 Hz` 落在 200 Hz 栅格上"解出真实 fs（`out_fs_infer.txt`）。
- **偏差 +1.67%（标称比实测高）**。若声音卡自报 48 000 Hz 而实际晶振偏高 ~1.6%，则**测得的频率会整体偏低** ⇒ 反推出的 fs 偏低。
- ⚠️ **也可能是 FPGA 侧真实偏差**（如 PLL/分频实现与公式不符）—— **两种解释都能拟合现有数据，仅有这三种录音不足以区分**。
- **⇒ 文档里应写**：标称 fs 的推导式 + 真板反推值 + **"差异的两种可能来源"** + **"需要什么实验才能区分"**（例：用示波器直接测 `HP_WS` 帧频）。
- **⛔ 不要**直接把 97 656.25 写成"实测采样率"，也不要写"实测 96 056 Hz"而不提标称推导 —— 两个数字都要给，并说明口径。

---

## 6. 工具与环境约束（**影响交付方式，照此执行**）

### 6.1 本机可用 / 不可用（实测）

| 能力 | 状态 |
|---|---|
| **python-docx 1.2.0**（生成 Word） | ✅ 内置 Python 有 |
| **LibreOffice 渲染/转 PDF** | ✅ `F:\dsh\resources\app.asar.unpacked\dsh\node_modules\@deepseek-ai\libreoffice-kit\lib\cli.js` 实存 |
| matplotlib / scipy | ❌ 内置 Python **没有**；✅ **用户自己的 Python 3.14.5 有**（`matplotlib 3.11.1`） |
| 中文字体 | ✅ 宋体 `simsun.ttc`、黑体 `simhei.ttf`、微软雅黑 `msyh.ttc`、Times `times.ttf` |
| **PDF 渲染器**（pypdf / fitz / pdftoppm / mutool） | ❌ **全无** |
| ImageMagick / ffmpeg / LaTeX / WaveDrom / drawio | ❌ **全无** |
| ⚠️ 陷阱 | `convert` 指向 `C:\Windows\system32\convert.exe`（**磁盘格式化工具**），**绝不可以用** |

### 6.2 交付流程建议

```
python-docx（生成 .docx，套 §2 的样式）
  → libreoffice-kit render（出 PNG 预览，逐页核对排版）
  → libreoffice-kit convert（出 PDF 送审）
```
- 配图：用**用户自己的 Python 3.14.5**（有 matplotlib）跑，`dpi=300`，中文字体用 `Microsoft YaHei`/`SimHei`，**`axes.unicode_minus=False`**。
- 现有配图脚本可复用：`_research/doc-figures/make_figures.py`（已产出 `fig-erhu-bandmul.png`、`fig-latency.png`、`fig-resources.png`）。
- ⚠️ `python-docx` **不能直接写 OMML 公式**。我们的选题二**几乎不需要公式**（拍号/频率/定时都是算术），
  **建议把"公式"改写成算式文字或表格**，例如 `fs = 50 MHz / 512 = 97656.25 Hz`，避免公式编辑器的兼容风险。

---

## 7. ⚠️ 测量方法学与局限（**读者核对时看这里**）

### 7.1 为什么页边距只能给"下界"

三点原因：
1. **正文左边界 = 70.9 pt**，但**标题/表格/图题可能另有缩进**（实测 x 有 70.9 / 94.9 / 108.7 三个主力值）；
2. **表格与通栏图会超出正文宽**（max x 达 522.2 pt = 184 mm）；
3. `cm`（变换矩阵）存在**嵌套 `q/Q` 未完全配对**的情况 ⇒ 少数文字坐标会发散（实测有 `x = 2.8e10` 的离群值，已用 `|ctm-1|<0.01` 过滤）。

⇒ **结论**：能从 content stream 得到的**最可靠结论**是"**正文左边界 ≥ 70.9 pt**"，
以及"**页脚基线严格在 y = 38 pt**"（91/91 命中，这是最硬的一条）。
**70.9 pt ≈ 2.50 cm 与 Word 默认左边距 2.54 cm 接近**，故建议 **2.5–2.54 cm**。

### 7.2 为什么行距"18 pt / 1.5 倍"分不清

- 18.0 pt ÷ 12.0 pt = **1.5**，这是**1.5 倍行距**的定义。
- 但"固定行距 18 pt"在版面上**完全等价**，PDF 不含这个选择。
- ⇒ **建议直接写"1.5 倍行距"**（Word 里更常见、更省事）。
- 段间距：实测 36.6 pt ≈ 2 × 18 pt，**倾向"段前段后各 0.5 行"或"空一行"**；**无法分解到"段前 x pt、段后 y pt"**。
  ⇒ **建议：段前 0、段后 0.5 行；或按"空一行"处理**，视觉即可对齐。

### 7.3 为什么代码字号写"约 8 pt"

- 字体 `LMMono10` 的字号实测为 **7.9701 pt**（出现 200 次）；
- 但**这是被 `cm` 缩放后的值**（LaTeX 生成的 PDF 常带缩放），**原始字号无法反推**。
- ⇒ **建议：代码用 8–9 pt 等宽**（比正文小一档，视觉上正确）。

### 7.4 无法从文字层判定的事项（**需人工看图/需用户确认**）

| 项 | 状态 |
|---|---|
| 表格是否**三线表** | ⚠️ 未确认（建议直接用三线表） |
| 图题**具体 x 坐标 / 是否精确居中** | ⚠️ 未确认（只能确认"在图下方"） |
| 封面是否有**校徽/校名** | ⚠️ 未在 93 个导出图中识别到 |
| 首行缩进 | ⚠️ 未确认（建议 2 字符） |
| 参考文档各级标题的**Word 样式名与大纲级别** | ⚠️ 未确认 |

---

## 8. 建议大纲（**针对选题二，用我们真实的素材**）

> **篇幅基准**：参考文档 91 页 / 正文 65% 给实现细节。我们**建议 42–55 页**（我们模块更多但每个更薄）：
> 若想对标参考文档的"实现细节占 2/3"，**核心章（第 3 章）应给到 20 页以上**。

### 8.1 章节表

| # | 章节 | 页 | 要点 | **用到的真实素材** |
|---|---|---|---|---|
| **封面** | — | 1 | 7 字段表格（照 §2.10）+ 徽标 | ⚠️ 队伍信息**待用户提供** |
| **目录** | — | 1–2 | 自动生成，带页码 | — |
| **一、设计概述** | | **4** | | |
| | 1.1 设计目的 | 0.7 | 从**评分公式**切入：`振荡器数 × 采样率`；为什么选**加法合成**（三要素天然满足 / 音色=可测量 / 多音色共用硬件）；给出目标一句话 | `_topic2.txt` L273–324 |
| | 1.2 应用领域 | 0.5 | 电子乐器与音乐教育 / 嵌入式音频算法验证平台 / 便携乐器（6 键电容触摸板）/ 教学演示（频谱数峰） | `_research/pcb/piano6/` |
| | 1.3 主要技术特点 | 1.5 | 5 条：①逐泛音独立加法合成（8 声部 × 6 泛音，**独立 32 bit 相位累加器**）②**音色由真实演奏录音标定**③**弓弦持续激励 drive**④运行期模式切换 + 三道清音⑤硬件效果链（混响/延迟/合唱/失真/箱体） | `tone_bank.v` L20–31、`piano_engine.v`、`top.v`、`audio_fx.v` |
| | 1.4 关键性能指标 | 1.0 | ⭐ **指标表**（下表 8.2 直接可用）：复音/采样率/相位位宽/延迟/时序/资源 | `BITSTREAM-FINGERPRINTS.md`、`.rpt`、延迟报告 |
| | 1.5 主要创新点 | 1.3 | **6 条**（见 8.3）—— 每条一段，含"为什么算创新 + 证据" | `_research/pc-link/*.md` |
| **二、系统组成及功能说明** | | **6** | | |
| | 2.1 整体介绍 | 2 | **系统框图**（自绘，示意）+ 数据通路逐模块一段话（照参考文档 P7 的 4 段式写法） | `top.v` L1–35 的架构注释（**本身就很完整，可改写**） |
| | 2.2 时钟与采样率规划 | 1 | ⭐ 算式留痕：`fs = 50 MHz/(BCK_DIV × 16 × 32)`，`BCK_DIV=1 ⇒ 97 656.25 Hz`；`MUTE_LEN = 5 ms × fs = 488`；相位字按**实际 fs**折算（不是 48 000） | `top.v` L32/L74、`pt8211_tx.v` L80、`tone_bank.v` L5 |
| | 2.3 板卡与引脚 | 1.5 | Tang Mega 138K + PT8211；引脚表（clk V22 / HP_BCK Y17 / HP_WS AB17 / HP_DIN AA16 / PA_EN AB16 / key AB13 / key2 Y12 / key_pitch Y22 / uart_rx V14）；**并写明 U21/P19/Y21 在 138C 是 CPU/SSPI 专用脚不可用**（体现踩坑） | `constr/fpga_hank.cst`、`AGENTS.md` §2 |
| | 2.4 工具链 | 0.7 | Gowin EDA V1.9.12.04 + ModelSim 10.7 + Tcl 流程；**三个真实坑**（`-synthesis_tool` 必须小写、`gw_sh` 不切目录、`.tcl` 不能带 BOM） | `.dsh/skills/gowin-flow/`、`_research/fpga-tools/FINDINGS.md` |
| | 2.5 32 声部的探索 | 1.6 | ⭐ **20 声部直例化的失败**：13203 违例 / −6.774 ns / BSRAM 219/340 ⇒ 回退；改用 **TDM 时分复用**方案（含"为什么不能让 32 路轮流只输出一路"⇒ fs/32 扫描边带） | `top.v` L319 注释、`tone_bank.v` L33–34、**时序报告** |
| **三、多音色加法合成引擎**（核心章） | | **20** | | |
| | 3.1 振荡器的定义与我们的对应 | 2 | ⭐ **正面回应赛题三要素**：给出"要素 → RTL 位置"对照表；把"单波表只算 1 个振荡器"的歧义**正面拆解** | `tone_bank.v` L13–31 |
| | 3.2 相位累加器与音高生成 | 2.5 | 32 bit 相位（为什么）；频率字按实际 fs 折算；**变调用 Q12 运行时乘法**（以及那个真实 bug：乘积未全宽承接 ⇒ 高位截断 ⇒ 32/32→0/32） | `piano_engine.v`、`32谱峰-取证报告.md` §8.2 |
| | 3.3 泛音参数表 | 3 | `piano_rom.v` 生成表：每声部 6 泛音（`N_PART=6`），各自的谐波权重 / 衰减 / 非谐性；**表 + 对应频谱图成对出现**（学参考文档表11+图68） | `piano_rom.v`、`_research/pc-link/*` |
| | 3.4 ADSR 与逐路包络 | 2 | `adsr.v`（32 路，`ATK_INC/DEC_INC/REL_INC` 由移位参数化）；包络 32 bit Q32 | `adsr.v` |
| | 3.5 声部分配器 | 2 | 一热分配（one-hot）+ 轮转；**两级树形分配器**（17–32 路）；**分配器等价性穷举证明**（树形 vs 串行逐例相同） | `piano_engine.v` L412–L494、`allocator_equiv.txt` |
| | 3.6 多乐器：钢琴/吉他/二胡 | 3 | `inst_sel`；**二胡 5 档谐波权重表**；三张表的差异对比表 | `piano_rom.v`、`_research/pc-link/ERHU-*.md` |
| | 3.7 弓弦持续激励（drive） | 2 | 拨弦 vs 弓弦的能量学差别；**一阶系统"起振时间常数 = 衰减时间常数"的陷阱**（若复用衰减常数，起振慢到 1.3 s，与实测 40–80 ms 差 20 倍）；双时间常数；**仅对二胡生效，钢琴/吉他逐值不变** | `piano_engine.v`、`tb_erhu_steady.v` |
| | 3.8 输出级 | 1.5 | 混音、**软削波（软膝）**、饱和限幅、**流水线化**（以及"输出级第一次失败 754 违例"的过程） | `piano_engine.v`、`fpga_hank_MODE1_outsweep_754v.tr.txt` |
| | 3.9 硬件效果器 | 2.5 | 混响（Moorer 型：梳状 + 全通 + 延迟线）/ 延迟 / 合唱 / 失真 / 箱体；**纯 HDL 逐样本**；BSRAM 延迟线；**该器件存储纪律**（真双口不支持 32 bit、读路径必须寄存） | `audio_fx.v`、`fx_comb.v`、`fx_allpass.v`、`fx_echo.v`、`fx_chorus.v`、`_research/effects-impl/` |
| **四、交互与控制系统** | | **7** | | |
| | 4.1 多维交互设计 | 2 | ⭐ **正面回应基础要求①**：维度表（音高选择 / 力度 / 变调 / 音色切换 / 效果切换），各自的**独立可控**证明；**自研交互形态**：2 个板载键 + PMOD 外接键 + **6 键电容触摸板（嘉立创自绘 PCB）** + 电脑 GUI | `touch_key.v`、`touch_notes.v`、`pcb/piano6/`、`host/piano_gui.py` |
| | 4.2 串口与 MIDI 协议 | 2 | 115200 8N1 中点采样接收；**MIDI 3 字节解析 + CC 透传**；CC 分配表（CC1/5/65/76/77/64/120/121/123）；**"RTL 只做传输层、原样透传 0..127、换算在下游"的两条约定** | `uart_rx.v`、`midi_rx.v`、`AGENTS.md` §4.1 |
| | 4.3 曲目播放器 | 1.5 | `song_player.v` 四态 FSM（播放/暂停/恢复/停止）；`song_rom.v` 曲目数据；**曲目选择与版权说明**（选公有领域曲目） | `song_player.v`、`song_rom.v`、`_research/songs/` |
| | 4.4 运行期模式切换与三道清音 | 1.5 | `run_mode`（自由演奏 / 指定曲目）热切换；**三道清音**：①停播放器并走完 128 拍全关 ②`reset_all` 一拍脉冲 ③**5 ms 静音窗**（`MUTE_LEN=488`）；为什么三道都要 | `top.v` L139–L170 注释 |
| **五、测试与验证** | | **11** | | |
| | 5.1 验证体系总览 | 1 | **27 个 TB** 的清单表（模块 / 行数 / 验证对象），说明"逐模块 + 端到端"两层 | `fpga_hank/sim/tb/` |
| | 5.2 关键模块验证 | 3 | 选 4–5 个有代表性的 TB，各给**判据 + 结果 + 边界**：`tb_piano_engine`（主回归）、`tb_adsr`（包络）、`tb_alloc32_proof`（32 声部分配证明）、`tb_pt8211_final`（I2S 逐位比对）、`tb_uart_rx`（含 CC 45 项 PASS） | 各 TB + transcript |
| | 5.3 ⭐ **测试模式：N 路均匀频率的谱峰取证** | 3 | **必备交付物**。写成"**判据 → 门限 → 实测 → 结论**"四列表（照 `32谱峰-取证报告.md` §三）；**判据参数必须写全**：`--fs 97656.25 --count 32 --start 200 --step 200`；⚠️ **如实分列"仿真证据"与"真板证据"两个口径**（见 §5.1） | `tone_samples_snap.txt`（SHA256 `91FC2BDE…`）、`spectrum_32peaks.png`、`perf_32peaks.wav` |
| | 5.4 时序与资源 | 2 | P&R 报告：Logic/Register/DSP/BSRAM；**0 setup / 0 hold**、最差裕量；位流指纹表 | `.rpt`、`BITSTREAM-FINGERPRINTS.md` |
| | 5.5 延迟预算与确定性 | 2 | ⭐ 拓展③：**端到端延迟分解表**（去抖 → 事件解析 → 声部分配 → 相位更新 → 输出级流水线 → I2S 帧）＋ **P50/P95/P99/max 分位数**；说明"固定流水线深度 ⇒ 无动态调度 ⇒ 抖动 = 0" | ⚠️ **需重新取证**（见 §5.2） |
| | 5.6 音高与音色实测 | 1.5 | ⭐ A4/A5/C4 的 FFT 音高：**误差 ≤ 0.03 cent**；**比值判据与 fs 无关**（A5/A4=2.000030、C4/A4=0.594603）⇒ 证明相位增量按实际 fs 折算 | `PIANO-RECHECK.md` §1 |
| | 5.7 ⚠️ 未达标项与已知边界 | 1 | ⭐ **主动、如实**：32 声部演奏未达成（20 声部失败证据）；真板谱峰杂散未查清；采样率两口径差异；**仿真口径 ≠ 上板口径** | 见 §5 |
| **六、结论与展望** | | **3** | | |
| | 6.1 已完成工作 | 1 | 对照赛题**逐条打勾表**（基础 3 条 / 拓展 4 条，每条给证据位置） | `_topic2.txt` |
| | 6.2 可扩展之处 | 1 | 照参考文档 §4.1 的写法列 5 条：TDM 32 声部演奏、泛音数 6→10、弓噪与擦弦噪声、效果器参数连续化、蓝牙 App | — |
| | 6.3 心得体会 | 1 | **每位队员一段、实名**（照参考文档 §4.2），写**具体的坑**而不是套话 | ⚠️ **待队员提供** |
| **参考文献** | — | 1–2 | **GB/T 7714-2015**，清理数据库字段；正文 `[n]` 上标引用 | — |
| **附录** | | **5** | | |
| | 附录A 关键模块清单 | 1 | 26 个 `.v` 的表（路径 / 行数 / 职责） | `PROJECT-FACTS-LEAD.md` §一 |
| | 附录B 核心源代码 | 3 | **真代码块（等宽 8–9 pt）**，不是截图；选 5 段：相位累加器、`freq_word`/变调、ADSR、声部分配、限幅。**⚠️ 这是"RTL 代码佐证纯硬件、无预录"的关键** | `tone_bank.v`、`adsr.v`、`piano_engine.v` |
| | 附录C 证据文件索引 | 1 | 每个结论 → 证据文件 → SHA256/位流指纹 | `BITSTREAM-FINGERPRINTS.md` |

**合计 ≈ 46 页**（封面/目录/正文/附录）。

### 8.2 ⭐ 建议的"关键性能指标"表（§1.4 直接用；**数字均已核对，但 3 处需重新取证**）

| 指标 | 本作品 | 赛题要求 | 证据 / 出处 |
|---|---|---|---|
| 演奏引擎复音 | **8 声部 × 6 泛音 = 48 个独立相位累加器** | 基础 ≥4；拓展① ≥32 | `piano_engine.v` L144 `N_VOICES=8`、`N_PART=6` |
| 测试模式振荡器 | **32 路**独立音源（可 +6 泛音） | 必备交付物 | `top.v` L351–352、`tone_bank.v` L47 |
| 音频采样率 | **97 656.25 Hz**（标称，= 50 MHz/512） | —（越高越好）| `top.v` L32；⚠️ 真板反推 ≈96 056 Hz，**需解释**（§5.3） |
| 相位累加器 | **32 bit** | —（"独立相位累加器"是三要素之一）| `piano_engine.v` L183 |
| 包络 | **32 bit Q32**，增益取 `env[31:16]` | ADSR | `piano_engine.v` L184 |
| 音高精度 | A4 440.00 / A5 880.02 / C4 261.63 Hz，**误差 ≤ 0.03 cent** | "单音实时变调" | `PIANO-RECHECK.md` §1 |
| 变调精度 | +7 半音：**平均相对误差 0.014%** | 基础要求③ | `32谱峰-取证报告.md` §8.4 |
| **端到端延迟** | 引擎 **10.3–20.5 µs**（P50 15.4 µs）；含串口路径 ≈0.7 ms | ≤10 ms（基础）/ ≤5 ms（拓展③）| 🔴 **`latency_report.txt` 当前取不到，必须重新取证** |
| 延迟抖动 | 固定流水线 ⇒ **确定性**（max−min 10.2 µs） | "无抖动" | 🔴 同上 |
| 时序 | **0 setup / 0 hold**（最新位流最差裕量 +0.04 ns） | — | `BITSTREAM-FINGERPRINTS.md`、`.tr` |
| 资源占用 | Logic ≈31.9k / 138 240（**23%**）；Register ≈10.8k（8%）；DSP 124.5 / 298；BSRAM 124 / 340 | — | `.rpt`（⚠️ 需以最新位流复核） |
| 测试模式谱峰 | 仿真 **32/32、0 杂散**；真板 **32/32 命中但 552 杂散** | 必备交付物 | `32谱峰-取证报告.md` vs `cls_perf_32peaks.txt`（**如实分列**） |

### 8.3 ⭐ 建议的"主要创新点"6 条（**只写真做过的**）

| # | 创新点 | 为什么算创新（正文要这么论证） | 证据 |
|---|---|---|---|
| **1** | **用专业演奏录音实测反推合成参数**，建立"实测频谱 → 判别性特征 → 谐波权重表"的**可复现标定链路** | 多数加法合成作品靠"听—调—再听"，参数不可解释、换音区就崩。我们把音色设计变成**可测量的工程问题** | `_research/pc-link/ERHU-RESEARCH.md`、`ERHU-CROSSCHECK.md`、`erhu_saima_harmonic_table.csv`、`erhu_crosscheck.png`、三段录音交叉验证（《赛马》《梁祝》等） |
| **2** | **量化定位"音色像小提琴"的根因，并指出一类口径陷阱** | 直觉是"高频太多"，**方向错了**：判别性特征是**低频 400–700 Hz 有 +23~+25 dB 巨峰**（相对 1 kHz），小提琴没有。并发现**"占总能量百分比"与"相对基准频带每 Hz 电平"对同一频带会给出相反结论** | `BRIDGE-HILL.md`、`erhu_saima_harmonic_profile.png`、`erhu_saima_formants_avg.png` |
| **3** | **弓弦"持续激励（drive）"机制与双时间常数** | 弓弦本质是**能量持续输入 ⇒ 稳幅**，不是"敲一下然后衰减"。关键洞察：**一阶系统起振时间常数 = 衰减时间常数**，直接复用会让起振慢到 ~1.3 s（与实测 40–80 ms 差 20 倍）⇒ 起振档与稳态档用**不同移位**，且起振档**同时放大激励与衰减**以保持平衡点不变 | `piano_engine.v`、`tb_erhu_steady.v`、起振 τ 对照 |
| **4** | **把"滤波"改写成"逐泛音乘增益"（装载期查表）** | 信号是 6 个正弦之和 ⇒ **在谐波频率上"滤波" ≡ "逐泛音乘一个增益"** ⇒ 把滤波器正确性风险**彻底移出 RTL**（RTL 里做 IIR 曾失败两次，其中一次软削波触发率飙到 99.97%）。**换路不是回避，是等价且风险低得多的实现** | `gen_piano_rom.py` 的 `BAND_MUL`、`piano_rom.v` |
| **5** | **运行期模式切换 + 三道清音** | 同一套硬件在"自由演奏"与"指定曲目"之间**热切换**；切换瞬间用"停播放器（走完 128 拍全关）→ `reset_all` 一拍 → **5 ms 静音窗**"三道机制同时解决**爆音**与**挂音** | `top.v` L139–L170 |
| **6** | **把"证据纪律"写进工程流程**（**这一条要写成方法论，而不是自夸**） | ①每条性能结论带**位流指纹（User Code）+ 资源 + 时间戳**；②每个结论标注**证据强度边界**；③记录了多起"自己抓到自己错"的案例（软膝触发率 99.97% 抓出滤波器更新率写错；分配器等价性穷举） | `AGENTS.md` §8/§9、`BITSTREAM-FINGERPRINTS.md`、`allocator_equiv.txt`、`window_equiv_proof.txt` |

### 8.4 写作执行清单（**落笔前逐条打勾**）

- [ ] 封面 7 字段齐（⚠️ 队伍信息待用户提供）
- [ ] **不加摘要/关键词**（照参考文档）；若赛方模板要求摘要则另说
- [ ] 一级标题"一、二、三…"；二级 `1.1`；最深 4 级
- [ ] 图/表**全局连续编号**，**全篇只此一套**
- [ ] 图题在下、表题在上，`图N 空格 说明`，**10.5 pt 黑体**
- [ ] 正文宋体 + Times New Roman，**12 pt**，**1.5 倍行距**
- [ ] **每张图表在正文被引用至少一次**，并说明"从图里看出了什么"
- [ ] 每个数字带**出处**（文件路径 / 位流指纹）
- [ ] **仿真证据与真板证据分开写**，各自标边界
- [ ] 参考文献 **GB/T 7714-2015**，无数据库字段
- [ ] 页脚 `第 N 页共 M 页`
- [ ] 单列"未达标项与已知边界"
- [ ] 心得体会**实名到人**
- [ ] **全篇无 emoji**；加粗仅用于表头与关键数字
- [ ] 附录 B 用**真代码块**（等宽 8–9 pt），保 3–5 段关键 RTL

---

## 9. 待用户/团队确认的 7 件事

| # | 事项 | 影响 |
|---|---|---|
| 1 | **队伍信息**（学校 / 队名 / 队员 / 指导教师）与**作品正式名称** | 封面必需，否则无法定稿 |
| 2 | **真机照片**（板卡 + 耳机/音箱 + 电脑 GUI；建议含 LED 状态连拍） | 参考文档 P66–P95 的"实物证明"全靠照片；我们**目前没有** |
| 3 | **心得体会**（每位队员一段、实名、含具体技术细节） | §6.3 必需 |
| 4 | **"复音 ≥32"的口径**：是主张"48 个泛音分量"算 32+，还是必须做到 32 声部独立发声？ | 决定第 2.5 与 5.7 怎么写，以及是否还需要赶 TDM 32 声部 |
| 5 | **是否补做真板 32 谱峰取证**（解决 §5.1 的 552 杂散） | 决定 5.3 是"达标"还是"部分达标 + 待查" |
| 6 | **延迟证据是否重新取证**（§5.2 路径已失效） | 拓展③的唯一支撑，缺了就只能不写 |
| 7 | 图/表编号体系：**沿用参考文档的全局连续**（推荐）还是"章-序"式？ | 一旦选定全篇统一 |

---

## 9.5 与既有 `FORMAT-SPEC-LEAD.md` 的**逐项对齐**（先读这一节再读旧文件）

> 本目录里已有 [`FORMAT-SPEC-LEAD.md`](_research/doc-format/FORMAT-SPEC-LEAD.md)（Lead 用 `pdfplumber` 做的）。
> **两份规格在 6 个数字上不一致。** 下表给出对照与**采纳建议**（本文件的值来自 content-stream 绝对坐标解析，方法见 §0.2-C，可复跑 `_layout*.py`）。

| 项 | `FORMAT-SPEC-LEAD.md` | **本文件（更细的方法）** | 采纳 | 说明 |
|---|---|---|---|---|
| **左边距** | 64.1 pt = **22.6 mm** | **≥ 70.9 pt = 25.0 mm**（正文行起点） | ⭐ **正文 2.5 cm** | ⚠️ 两者不矛盾：实测正文有三个主力 x —— **70.9 pt（正文行）/ 94.9 pt（图题、引用块）/ 108.7 pt（表内容与二级列表）**。64.1 pt 应是**个别最左元素**（如通栏表格左边线）。**建议正文左边距取 2.5 cm** |
| **右边距** | 62.2 pt = **21.9 mm** | 正文最右 x ≤ **522.2 pt = 184 mm** ⇒ 右边距 ≈ 73.1 pt = **25.8 mm**（按正文行右边界 512–522 取） | **2.5 cm** | 同上，通栏图/表会到 522 pt |
| **上边距** | 65.1 pt = **23.0 mm** | 正文最高基线 y ≤ **765 pt** ⇒ 距上边 ≈ 77 pt = **27 mm** | **2.5 cm** | 差异来自"文字**基线** y" vs "文字**框顶** y"，基线比框顶低约一个 ascent（12 pt 字约 10 pt）⇒ **两者实为同一版心** |
| **下边距** | 35.6 pt = **12.6 mm** | ✅ **页脚基线 y = 38 pt**（**91/91 页命中**，本节最硬的一条） | **页脚距下边 ~1.34 cm**；正文下边距按 **2.5 cm** 设，页脚置于页脚区 | 旧文件的 35.6 pt 与我的 38 pt 是**测的同一个东西**（页脚），差 2.4 pt ≈ 舍入/取点差异 |
| **正文主字号** | 12.0 pt（**2 488** 次） | 12.0 pt（SimSun 1 814 + Times 1 981 = **3 795** 次） | ✅ **一致：12 pt 小四** | 计数差异只因提取口径不同（我按 `Tf` 操作计数） |
| **标题字号** | 14.0 pt（3 次）⇒ 疑为"章标题" | 14.0 pt（SimHei 11 次） | ✅ **一级标题 14 pt 四号**；**二/三级标题 12 pt 小四加粗** | ⭐ 本文件补上了旧文件缺的**二级/三级标题字号** |
| **图题/表题字号** | 10.5 pt（23 次） | 10.5 pt（SimHei **251** 次 + SimSun 424 次） | ✅ **10.5 pt 五号** | 旧文件次数偏低 |
| **行距** | 未测 | **18.0 pt = 1.5 倍行距**（731 次主导） | ⭐ **本文件新增**：1.5 倍行距 | — |
| **图/表编号** | ⚠️ "未确认" | ✅ **全局连续**：图 1..96、表 1..21，**不是"图 3-1"** | ⭐ **本文件已确认** | 这条直接影响大纲 v1 的写法 |
| **是否 LaTeX 排版** | 推断"是 LaTeX/CTeX" | ✅ **支持**：`LMMono10`（LaTeX 等宽）+ `CMR/CMEX/NewTXMI`（LaTeX 数学字体） | ✅ 采纳该推断 | ⭐ 本文件补充：**代码也是 LaTeX `listings` 风格（LMMono10）** |
| **摘要/关键词** | "未确认" | ✅ **确认：没有摘要、没有关键词页** | ⭐ **本文件已确认** | — |
| **页眉** | "未确认" | ✅ **确认：无页眉** | ⭐ **本文件已确认** | — |
| **篇幅目标** | 60–90 页 | 建议 **42–55 页**（见 §8.1），但**核心章须 ≥20 页**以对齐参考文档"实现细节占 65%"的配比 | 建议折中 **50–70 页** | 我们模块更多但单个更薄；**信息密度 > 页数** |

### 9.6 两条**必须由用户拍板**的口径（旧文件未涉及）

1. **⚠️ 边距到底写多少**：本文件与旧文件都在 2.2–2.5 cm 区间内，**对观感无差别**。
   ⇒ **建议：Word 里直接设"上下左右 2.5 cm"**，与实测正文行起点 70.9 pt 最接近，也最接近 Word 默认，省事。
2. **⚠️ 篇幅**：91 页是**国二**的量级。若时间紧，**优先保 §8.1 中"核心章 20 页"**，压缩第 4、5 章，
   **绝不压缩"证据表 + 未达标项"** —— 那两节是评委真正会看的。

---

## 99. ⚠️ 顺手发现：`PROJECT-FACTS-LEAD.md` 的**行数与当前 RTL 不符**（请复核）

我在核对素材时**逐文件重数了行数**，发现 [`PROJECT-FACTS-LEAD.md`](_research/doc-facts/PROJECT-FACTS-LEAD.md) §一 的行数表**已经过期**（RTL 在 10-06 当晚仍在改）：

| 文件 | `PROJECT-FACTS-LEAD.md` 写的 | **当前实测** |
|---|---|---|
| `rtl/top.v` | 398 | **460** |
| `rtl/synth/tone_bank.v` | 265 | **374** |
| `rtl/synth/adsr.v` | 135 | **170** |
| `rtl/synth/piano_engine.v` | 1607 | 1607 ✅ 一致 |

**⇒ 建议**：写文档时**凡引用"行数"都当场重数一次**（一条命令即可），或干脆**不写行数**、改为写"模块清单 + 职责"。
**⚠️ 这正好是本项目 §8.1 纪律（结论必须绑版本）的一个实例 —— 事实清单本身也会过期。**

---

## 10. 附：本次调研落盘的文件

| 文件 | 内容 |
|---|---|
| `_research/doc-format/FORMAT-SPEC.md` | 本文件 |
| `_research/doc-format/ref-fulltext.txt` | 参考文档 **91 页全文字层**（56 037 字符），可全文检索 |
| `_research/doc-format/ref-pages/` | 从 PDF 解出的 **93 张内嵌图**（含竞赛徽标、混响脉冲响应、Simulink/ModelSim 截图等） |
| `_research/doc-format/_pdfprobe*.py`、`_layout*.py`、`_census.py`、`_extract_images.py` | 本次全部测量脚本（可复跑复核） |
| `_research/doc-format/_pdfimages.txt` | 100 个图片对象的清单 |
