wongben2333-crypto/26Embedded/fpga_hank/skills/fpga-verify/tests/EVIDENCE-compliance.md

# 赛题红线自审（C:\Users\Danny\Desktop\FPGA competition\fpga_hank）

结论：**PASS**

| 级别 | 规则 | 说明 | 证据 |
|---|---|---|---|
| PASS | R1 预录样本 ROM 入口 | 可综合 RTL 中未出现 $readmemh/$readmemb |  |
| PASS | R2 音频样本文件 | 未发现 .wav/.mp3/.pcm 等样本文件 |  |
| PASS | R3 初始化数据文件 | 无大体积初始化数据文件 |  |
| PASS | R5 CPU 参与音频路径 | RTL 中未发现 CPU/软核标识，音频通路为纯 RTL |  |
| PASS | R6 测试模式 | 发现测试模式/音源模块：rtl\top.v, rtl\synth\sine_rom.v, rtl\synth\tone_bank.v |  |
| INFO | R7 相位累加器 | 发现 7 处相位累加器相关代码；报告里应给出「独立相位累加器 + 频率调控 + 包络控制」的框图对照 |  |
