wongben2333-crypto/26Embedded/fpga_spark/lcd_test/docs/real_lcd_live_page0.png

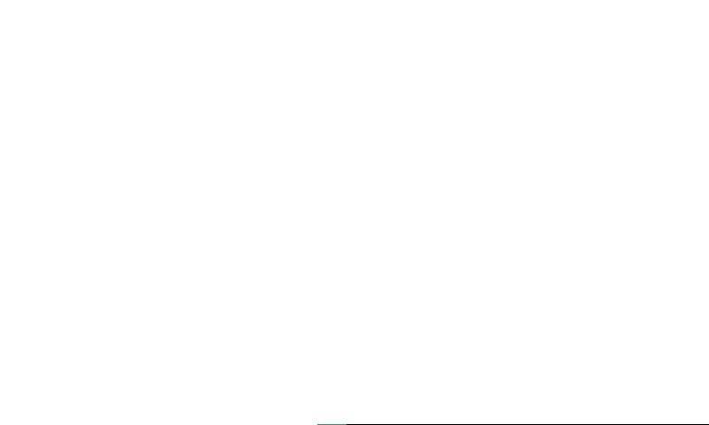
fpga_spark/lcd_test/docs/real_lcd_live_page0.png
