wongben2333-crypto/26Embedded/fpga_spark/lcd_test/docs/ui_previews/ui_preview_1_guitar.png

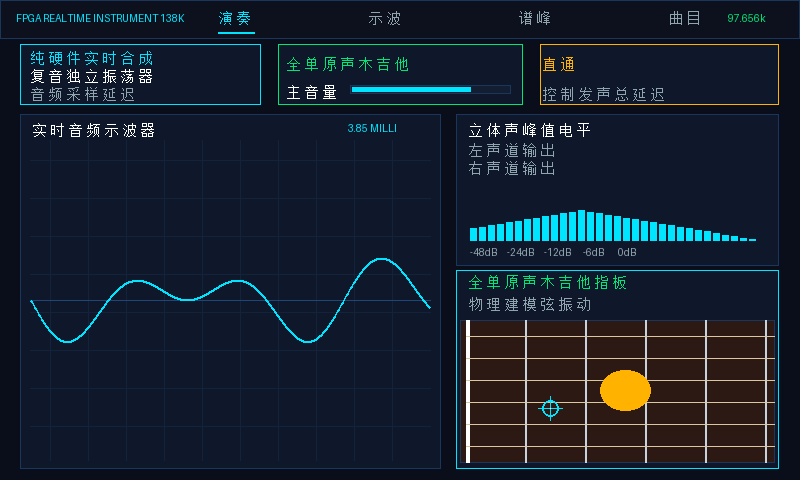
fpga_spark/lcd_test/docs/ui_previews/ui_preview_1_guitar.png
