wongben2333-crypto/26Embedded/fpga_spark/lcd_test/pcb/minimal/preview_V2_outline_pad.png

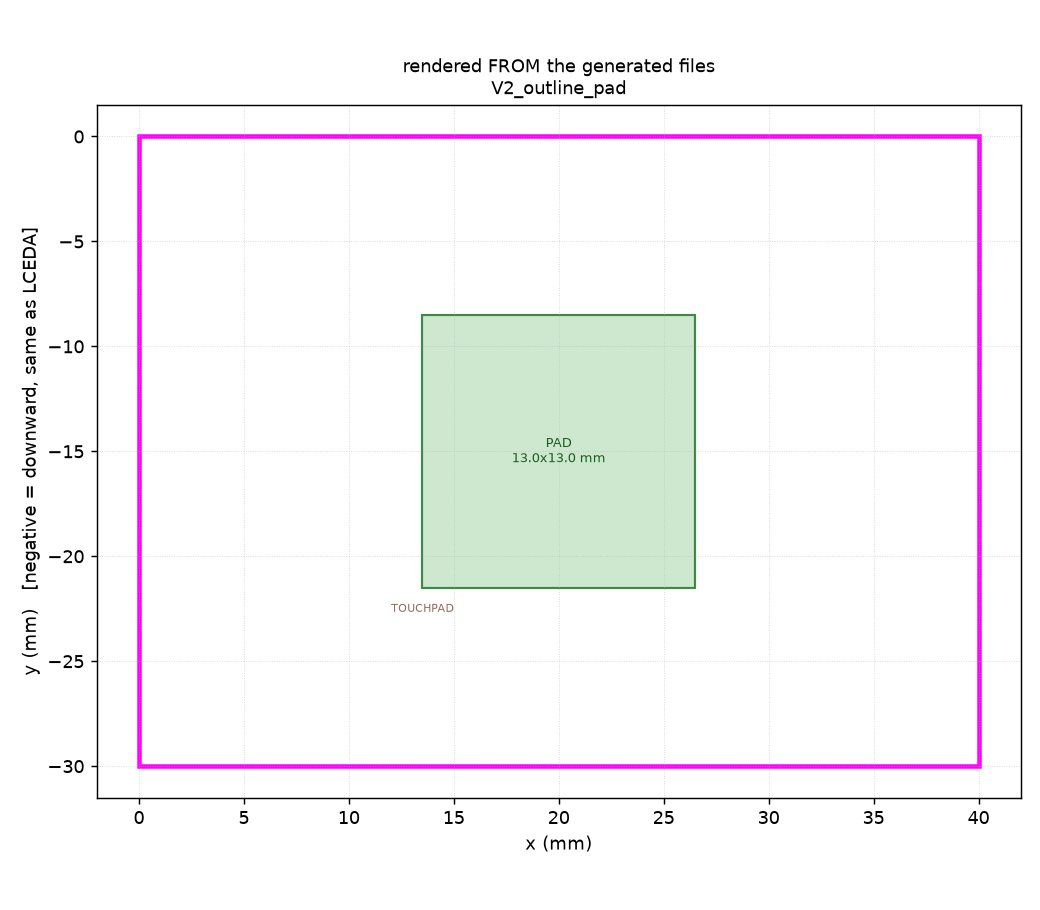
fpga_spark/lcd_test/pcb/minimal/preview_V2_outline_pad.png
