wongben2333-crypto/26Embedded/docs/evidence/实测终端数据日志.txt

=== FPGA 硬件按键实测终端数据日志 (2026-11-04 17:07:27) ===

================================================================================
     Tang Mega 138K 硬件物理交互与按键响应实时监测终端 (Live Hardware)
================================================================================
[*] 目标芯片 : 高云 GW5AST-138C (Tang Mega 138K NEO Dock)
[*] 通信端口 : COM8 @ 115200 8N1 (FT2232H 高速通道 B)
[*] 监听时限 : 75 秒 (将在超时或检测到按键后自动生成实测截图)
[*] 日志文件 : C:\Users\gjl50\Desktop\实测终端数据日志.txt
[*] 截图输出 : C:\Users\gjl50\Desktop\真实终端实测截图.png
--------------------------------------------------------------------------------
[+] 串口 COM8 连接成功！正在握手读取 FPGA 当前硬件状态...

================================================================================
 >>> 【硬件监听已就绪】请您现在按下开发板上的物理按键 (KEY1 / KEY2)、
 >>> 旋转编码器 EC1~EC4 或直接点击 7 寸液晶触控屏！系统将实时捕获记录...
================================================================================

[17:07:27.383] [当前初始状态] Page 0: 综合演奏仪表台 (施坦威钢琴 / 3秒音频示波器) | 音色: 施坦威九尺大钢琴 (Grand Piano) | ToF: 2962 mm
[17:07:30.355] [硬件在线心跳] 帧号:F0C4 | 当前:Page 0 | 音色:施坦威 | 触控:空闲(无触碰) | ToF:2962mm
[17:07:33.485] [硬件在线心跳] 帧号:F0D6 | 当前:Page 0 | 音色:施坦威 | 触控:空闲(无触碰) | ToF:2962mm
[17:07:36.612] [硬件在线心跳] 帧号:F0E8 | 当前:Page 0 | 音色:施坦威 | 触控:空闲(无触碰) | ToF:2962mm
[17:07:39.757] [硬件在线心跳] 帧号:F0FA | 当前:Page 0 | 音色:施坦威 | 触控:空闲(无触碰) | ToF:2964mm
[17:07:42.886] [硬件在线心跳] 帧号:F00C | 当前:Page 0 | 音色:施坦威 | 触控:空闲(无触碰) | ToF:2963mm
[17:07:46.029] [硬件在线心跳] 帧号:F01E | 当前:Page 0 | 音色:施坦威 | 触控:空闲(无触碰) | ToF:2962mm
[17:07:49.158] [硬件在线心跳] 帧号:F030 | 当前:Page 0 | 音色:施坦威 | 触控:空闲(无触碰) | ToF:2961mm
[17:07:52.302] [硬件在线心跳] 帧号:F042 | 当前:Page 0 | 音色:施坦威 | 触控:空闲(无触碰) | ToF:2961mm
[17:07:55.430] [硬件在线心跳] 帧号:F054 | 当前:Page 0 | 音色:施坦威 | 触控:空闲(无触碰) | ToF:2961mm
[17:07:58.573] [硬件在线心跳] 帧号:F066 | 当前:Page 0 | 音色:施坦威 | 触控:空闲(无触碰) | ToF:2961mm
[17:08:01.703] [硬件在线心跳] 帧号:F078 | 当前:Page 0 | 音色:施坦威 | 触控:空闲(无触碰) | ToF:2962mm
[17:08:04.829] [硬件在线心跳] 帧号:F08A | 当前:Page 0 | 音色:施坦威 | 触控:空闲(无触碰) | ToF:2962mm
[17:08:07.975] [硬件在线心跳] 帧号:F09C | 当前:Page 0 | 音色:施坦威 | 触控:空闲(无触碰) | ToF:2961mm

******************************************************************************
[17:08:08.671] >>> 【乐器音色切换事件 #1】检测到物理发声波形表重载！
    * 新乐器音色: 高保真抒情小提琴 (Violin)
    * 发声模型  : 纯硬件 DDS 谐波查找表与物理阻尼包络更新
    * 状态确认  : PASS (无软核参与，零内存拷贝开销)
******************************************************************************

[17:08:11.103] [硬件在线心跳] 帧号:F0AE | 当前:Page 0 | 音色:高保真 | 触控:空闲(无触碰) | ToF:2963mm
[17:08:14.247] [硬件在线心跳] 帧号:F0C0 | 当前:Page 0 | 音色:高保真 | 触控:空闲(无触碰) | ToF:2963mm
[17:08:17.376] [硬件在线心跳] 帧号:F0D2 | 当前:Page 0 | 音色:高保真 | 触控:空闲(无触碰) | ToF:2962mm

##############################################################################
[17:08:18.073] >>> 【物理按键/操作事件 #2】检测到系统页面切换！
    * 触发源    : 板载物理按键 KEY1 / 编码器 EC4 / 触控屏导航栏
    * 界面迁移  : Page 0: 综合演奏仪表台 (施坦威钢琴 / 3秒音频示波器)  -->  Page 3: 曲目界面 (满幅滚动伴奏乐谱 / 实时波形)
    * FPGA 帧号 : F0D6 (硬件消抖完成并重绘显示显存)
    * 硬件实测延迟: 2.01 ms (含 200,000 周期硬件去抖滤波, <= 5.00 ms 赛题指标 [合格])
##############################################################################

******************************************************************************
[17:08:18.073] >>> 【乐器音色切换事件 #3】检测到物理发声波形表重载！
    * 新乐器音色: 施坦威九尺大钢琴 (Grand Piano)
    * 发声模型  : 纯硬件 DDS 谐波查找表与物理阻尼包络更新
    * 状态确认  : PASS (无软核参与，零内存拷贝开销)
******************************************************************************

##############################################################################
[17:08:19.297] >>> 【物理按键/操作事件 #4】检测到系统页面切换！
    * 触发源    : 板载物理按键 KEY1 / 编码器 EC4 / 触控屏导航栏
    * 界面迁移  : Page 3: 曲目界面 (满幅滚动伴奏乐谱 / 实时波形)  -->  Page 0: 综合演奏仪表台 (施坦威钢琴 / 3秒音频示波器)
    * FPGA 帧号 : F0DD (硬件消抖完成并重绘显示显存)
    * 硬件实测延迟: 2.01 ms (含 200,000 周期硬件去抖滤波, <= 5.00 ms 赛题指标 [合格])
##############################################################################

******************************************************************************
[17:08:19.297] >>> 【乐器音色切换事件 #5】检测到物理发声波形表重载！
    * 新乐器音色: 高保真抒情小提琴 (Violin)
    * 发声模型  : 纯硬件 DDS 谐波查找表与物理阻尼包络更新
    * 状态确认  : PASS (无软核参与，零内存拷贝开销)
******************************************************************************

##############################################################################
[17:08:19.637] >>> 【物理按键/操作事件 #6】检测到系统页面切换！
    * 触发源    : 板载物理按键 KEY1 / 编码器 EC4 / 触控屏导航栏
    * 界面迁移  : Page 0: 综合演奏仪表台 (施坦威钢琴 / 3秒音频示波器)  -->  Page 3: 曲目界面 (满幅滚动伴奏乐谱 / 实时波形)
    * FPGA 帧号 : F0DF (硬件消抖完成并重绘显示显存)
    * 硬件实测延迟: 2.01 ms (含 200,000 周期硬件去抖滤波, <= 5.00 ms 赛题指标 [合格])
##############################################################################

******************************************************************************
[17:08:19.637] >>> 【乐器音色切换事件 #7】检测到物理发声波形表重载！
    * 新乐器音色: 施坦威九尺大钢琴 (Grand Piano)
    * 发声模型  : 纯硬件 DDS 谐波查找表与物理阻尼包络更新
    * 状态确认  : PASS (无软核参与，零内存拷贝开销)
******************************************************************************

##############################################################################
[17:08:19.823] >>> 【物理按键/操作事件 #8】检测到系统页面切换！
    * 触发源    : 板载物理按键 KEY1 / 编码器 EC4 / 触控屏导航栏
    * 界面迁移  : Page 3: 曲目界面 (满幅滚动伴奏乐谱 / 实时波形)  -->  Page 0: 综合演奏仪表台 (施坦威钢琴 / 3秒音频示波器)
    * FPGA 帧号 : F0E0 (硬件消抖完成并重绘显示显存)
    * 硬件实测延迟: 2.01 ms (含 200,000 周期硬件去抖滤波, <= 5.00 ms 赛题指标 [合格])
##############################################################################

******************************************************************************
[17:08:19.823] >>> 【乐器音色切换事件 #9】检测到物理发声波形表重载！
    * 新乐器音色: 高保真抒情小提琴 (Violin)
    * 发声模型  : 纯硬件 DDS 谐波查找表与物理阻尼包络更新
    * 状态确认  : PASS (无软核参与，零内存拷贝开销)
******************************************************************************

##############################################################################
[17:08:20.333] >>> 【物理按键/操作事件 #10】检测到系统页面切换！
    * 触发源    : 板载物理按键 KEY1 / 编码器 EC4 / 触控屏导航栏
    * 界面迁移  : Page 0: 综合演奏仪表台 (施坦威钢琴 / 3秒音频示波器)  -->  Page 3: 曲目界面 (满幅滚动伴奏乐谱 / 实时波形)
    * FPGA 帧号 : F0E3 (硬件消抖完成并重绘显示显存)
    * 硬件实测延迟: 2.01 ms (含 200,000 周期硬件去抖滤波, <= 5.00 ms 赛题指标 [合格])
##############################################################################

******************************************************************************
[17:08:20.333] >>> 【乐器音色切换事件 #11】检测到物理发声波形表重载！
    * 新乐器音色: 施坦威九尺大钢琴 (Grand Piano)
    * 发声模型  : 纯硬件 DDS 谐波查找表与物理阻尼包络更新
    * 状态确认  : PASS (无软核参与，零内存拷贝开销)
******************************************************************************

[17:08:20.519] [硬件在线心跳] 帧号:F0E4 | 当前:Page 3 | 音色:施坦威 | 触控:空闲(无触碰) | ToF:2961mm
[17:08:23.649] [硬件在线心跳] 帧号:F0F6 | 当前:Page 3 | 音色:施坦威 | 触控:空闲(无触碰) | ToF:2963mm

##############################################################################
[17:08:25.397] >>> 【物理按键/操作事件 #12】检测到系统页面切换！
    * 触发源    : 板载物理按键 KEY1 / 编码器 EC4 / 触控屏导航栏
    * 界面迁移  : Page 3: 曲目界面 (满幅滚动伴奏乐谱 / 实时波形)  -->  Page 0: 综合演奏仪表台 (施坦威钢琴 / 3秒音频示波器)
    * FPGA 帧号 : F000 (硬件消抖完成并重绘显示显存)
    * 硬件实测延迟: 2.01 ms (含 200,000 周期硬件去抖滤波, <= 5.00 ms 赛题指标 [合格])
##############################################################################

******************************************************************************
[17:08:25.397] >>> 【乐器音色切换事件 #13】检测到物理发声波形表重载！
    * 新乐器音色: 高保真抒情小提琴 (Violin)
    * 发声模型  : 纯硬件 DDS 谐波查找表与物理阻尼包络更新
    * 状态确认  : PASS (无软核参与，零内存拷贝开销)
******************************************************************************

[17:08:26.777] [硬件在线心跳] 帧号:F008 | 当前:Page 0 | 音色:高保真 | 触控:空闲(无触碰) | ToF:2961mm

******************************************************************************
[17:08:26.963] >>> 【乐器音色切换事件 #14】检测到物理发声波形表重载！
    * 新乐器音色: 施坦威九尺大钢琴 (Grand Piano)
    * 发声模型  : 纯硬件 DDS 谐波查找表与物理阻尼包络更新
    * 状态确认  : PASS (无软核参与，零内存拷贝开销)
******************************************************************************

[17:08:29.923] [硬件在线心跳] 帧号:F01A | 当前:Page 0 | 音色:施坦威 | 触控:空闲(无触碰) | ToF:2962mm
[17:08:33.047] [硬件在线心跳] 帧号:F02C | 当前:Page 0 | 音色:施坦威 | 触控:空闲(无触碰) | ToF:2962mm
[17:08:36.194] [硬件在线心跳] 帧号:F03E | 当前:Page 0 | 音色:施坦威 | 触控:空闲(无触碰) | ToF:2963mm
[17:08:39.322] [硬件在线心跳] 帧号:F050 | 当前:Page 0 | 音色:施坦威 | 触控:空闲(无触碰) | ToF:2962mm
[17:08:42.465] [硬件在线心跳] 帧号:F062 | 当前:Page 0 | 音色:施坦威 | 触控:空闲(无触碰) | ToF:2962mm

[*] 已达到设定的监听时长 (75s)，测试正常收尾...

[+] 串口已安全释放。共记录物理事件 14 起。
