wongben2333-crypto/26Embedded/hardware/pcb/SCH_Schematic1_2026-11-04.pdf

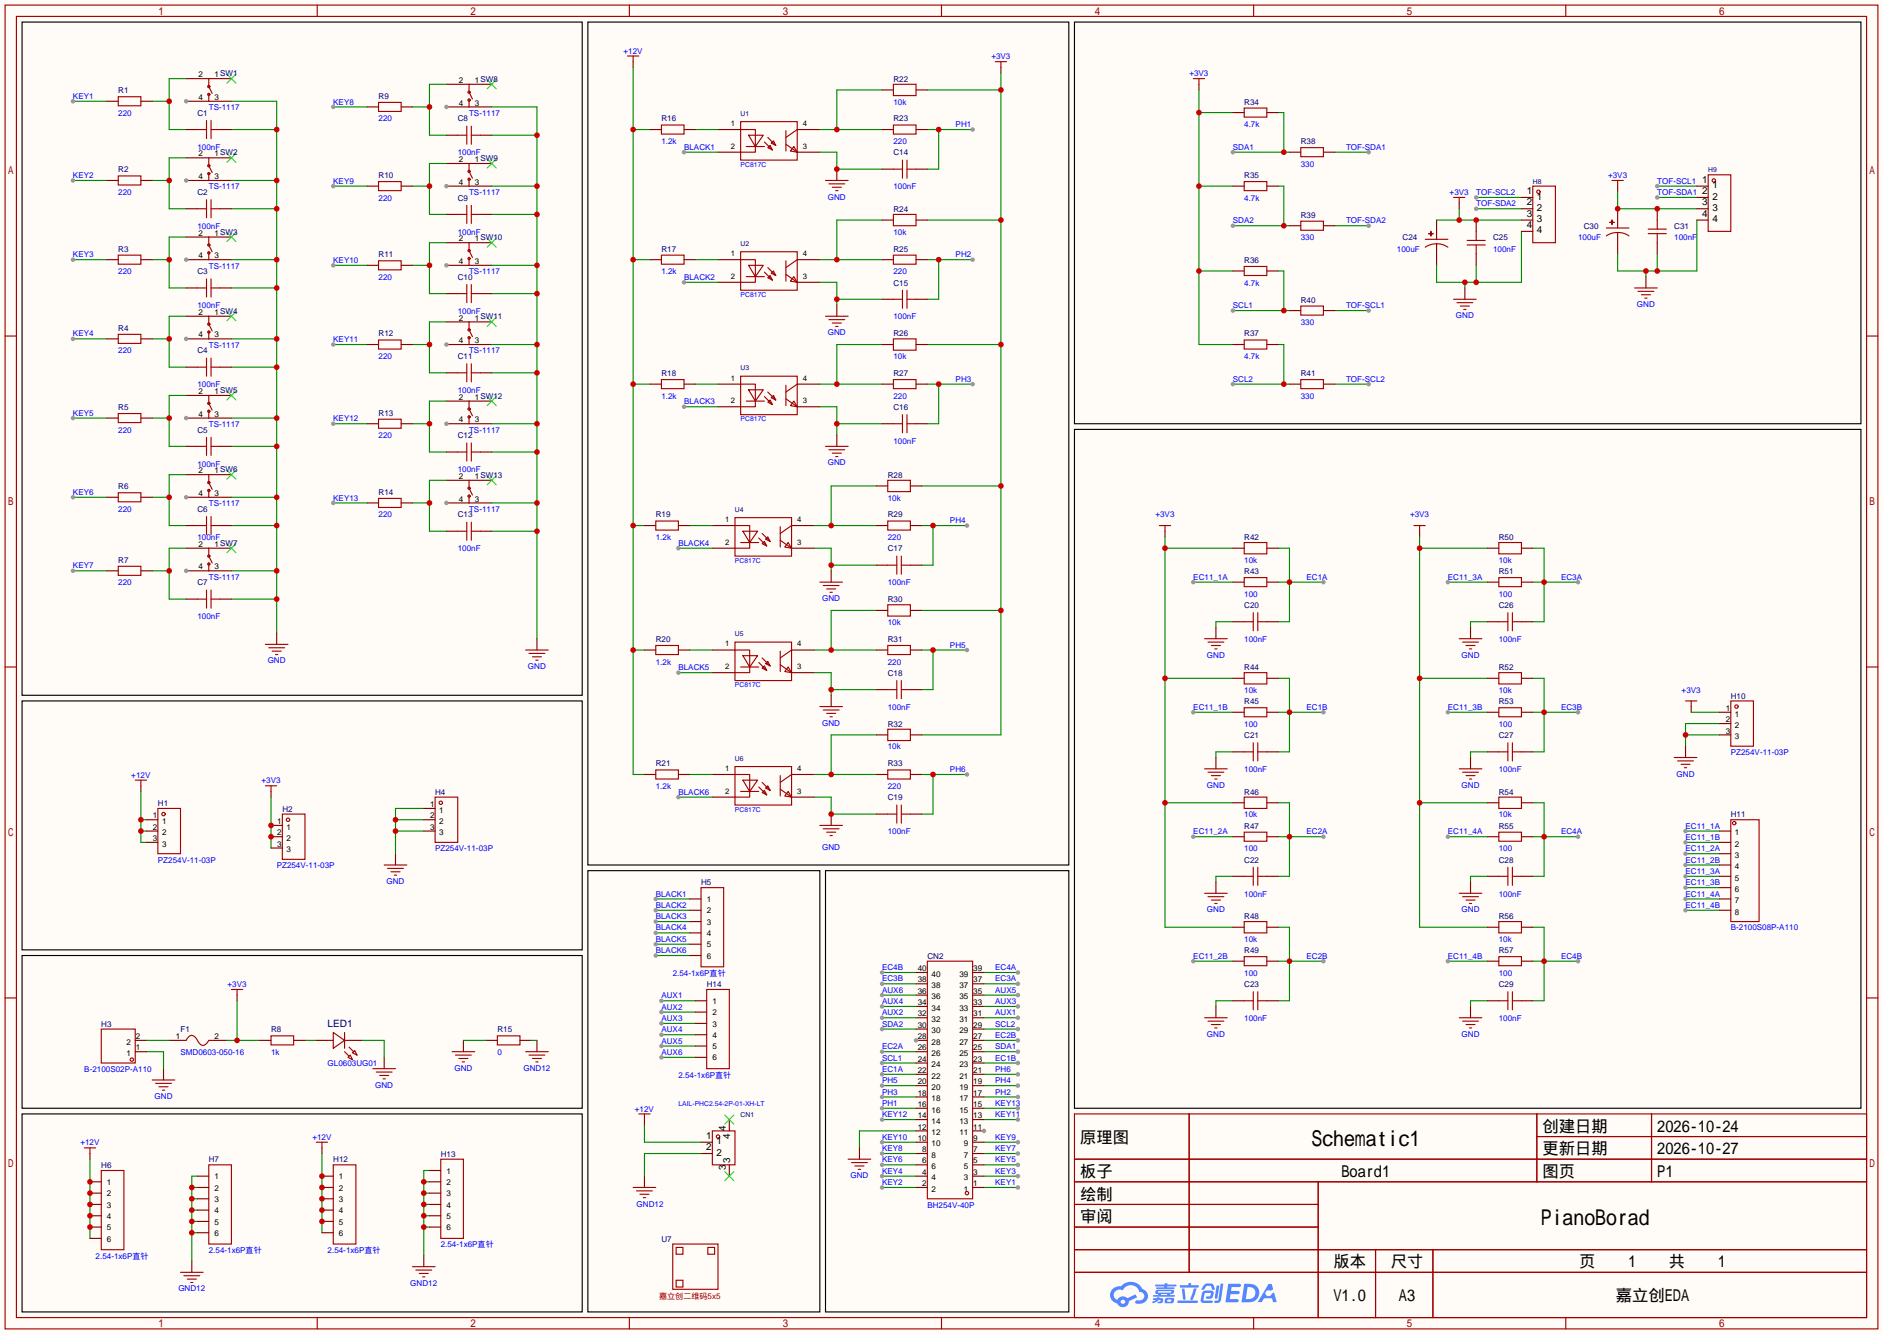
[picture p144: page 1]

原理图 | Schematic1 | 创建日期 | 2026-10-24

更新日期 | 2026-10-27

板子 | Board1 | 图页 | P1
绘制 | | PianoBorad
审阅

V1.0 | A3 | 嘉立创EDA
