wongben2333-crypto/26Embedded/fpga_spark/P34-P40转接板/SCH_Schematic1_2026-10-24.pdf

## 5V FILTER

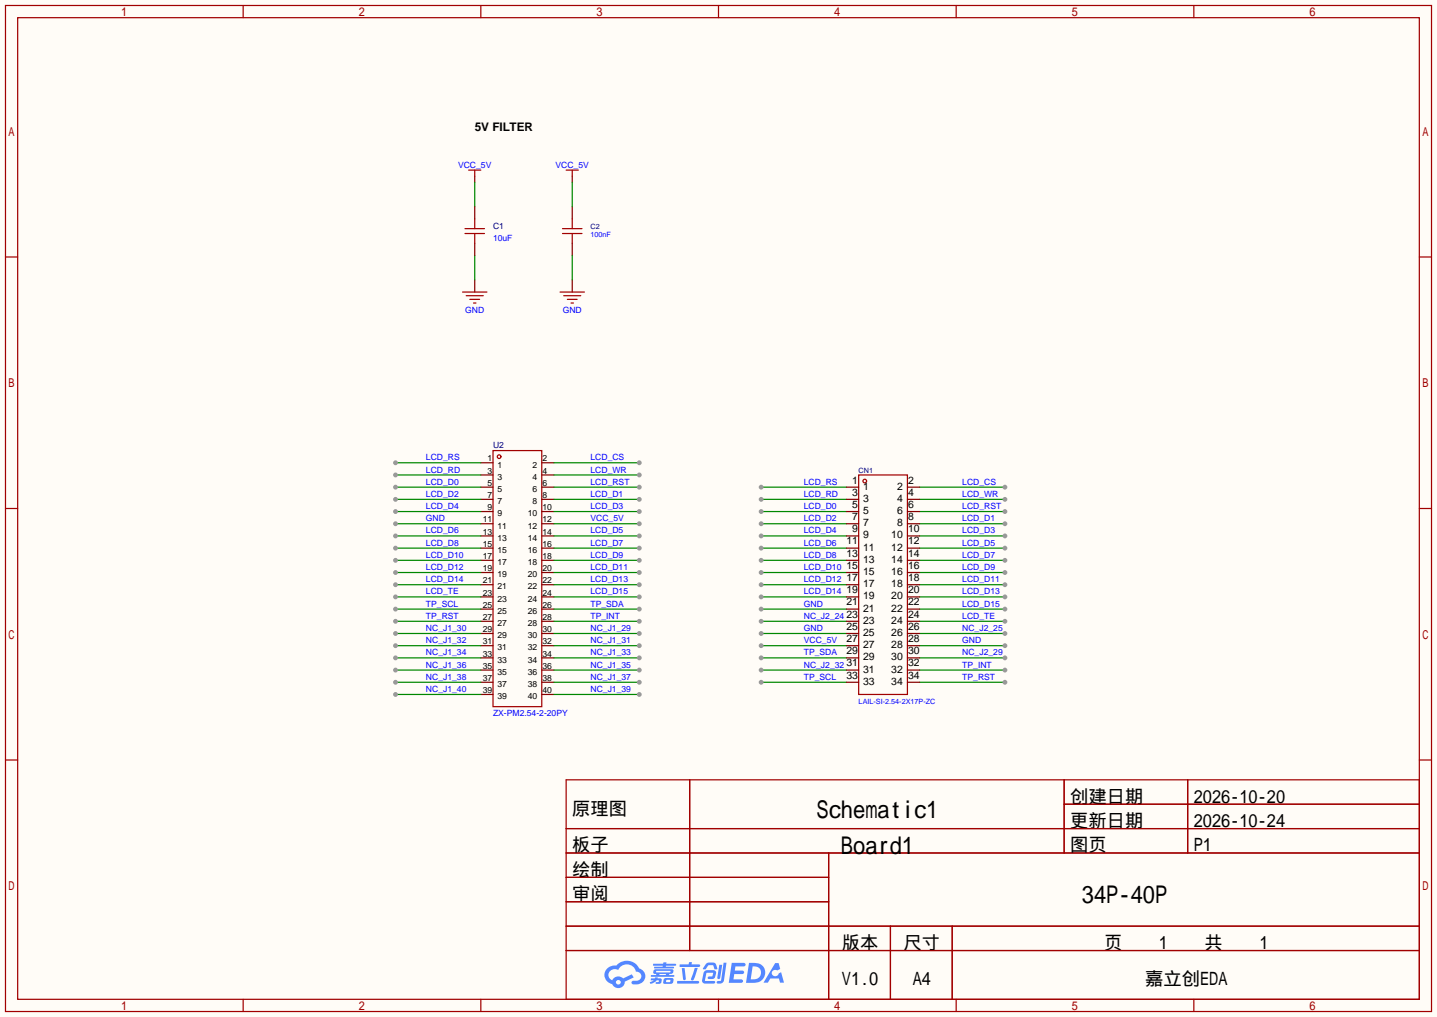
[picture p145: page 1]

原理图 | Schematic1 | 创建日期 | 2026-10-20

更新日期 | 2026-10-24

板子 | Board1 | 图页 | P1
绘制 | | 34P-40P
审阅

V1.0 | A4 | 嘉立创EDA
