wongben2333-crypto/26Embedded/fpga_spark/lcd_test/hardware/pcb/C127415_1503566052111906983.pdf

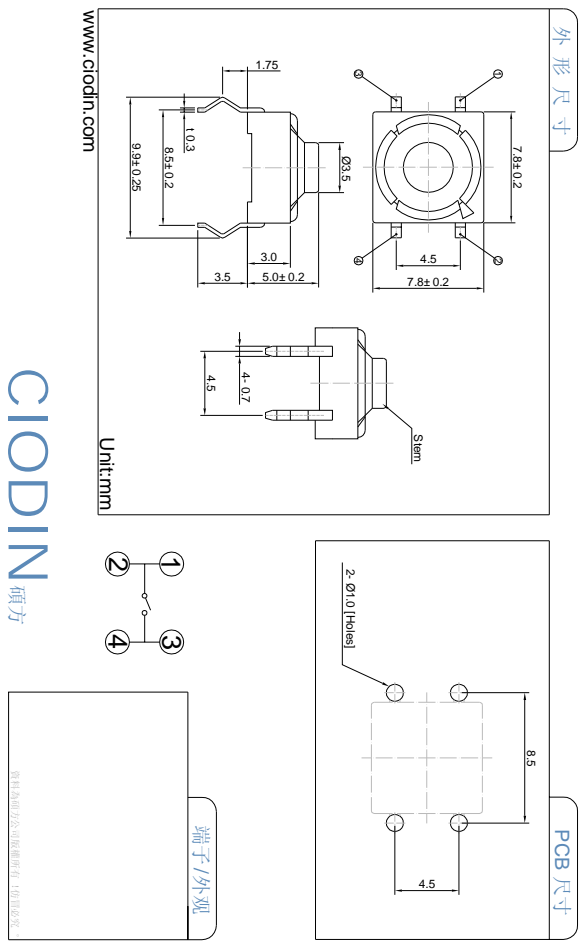
[picture p146: page 1]
外 形 尺 寸 PCB 尺寸; CIODIN; Unit:mm; 資料為碩方公司版權所有！仿冒必究。; Stem; 2- Ø1.0 [Holes]

www.ciodin.com
