wongben2333-crypto/26Embedded/fpga_spark/P34-P40转接板/PCB_PCB1_2026-10-24.pdf

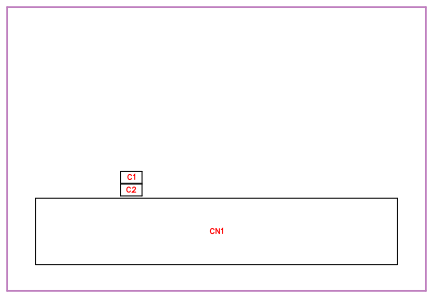
[picture p147: figure]

U2

No. | Quantity | Comment | Designator | Footprint | Value | Manufacturer Part | Manufacturer | Supplier Part | Supplier
1 | 1 | 10uF | C1 | C0603 | 10uF | CGA0603X5 R106K100JT | HRE(芯声 ) | C6119842 | LCSC
2 | 1 | 100nF | C2 | C0603 | 100nF | CC0603KRX 7R9BB104 | YAGEO(国巨 ) | C14663 | LCSC
3 | 1 | LAIL-SI-2.54-2X17P-ZC | CN1 | IDC-TH_34P-P2.54-V-M-R 2-C17-S2.54 | | LAIL-SI-2.54-2X17P-ZC | 莱联 | C55118379 | LCSC
4 | 1 | ZX-PM2.54-2 -20PY | U2 | HDR-TH_40 P-P2.54-V-F-R2-C20-S2.5 4 | | ZX-PM2.54-2 -20PY | Megastar( 兆 星 ) | C7499354 | LCSC

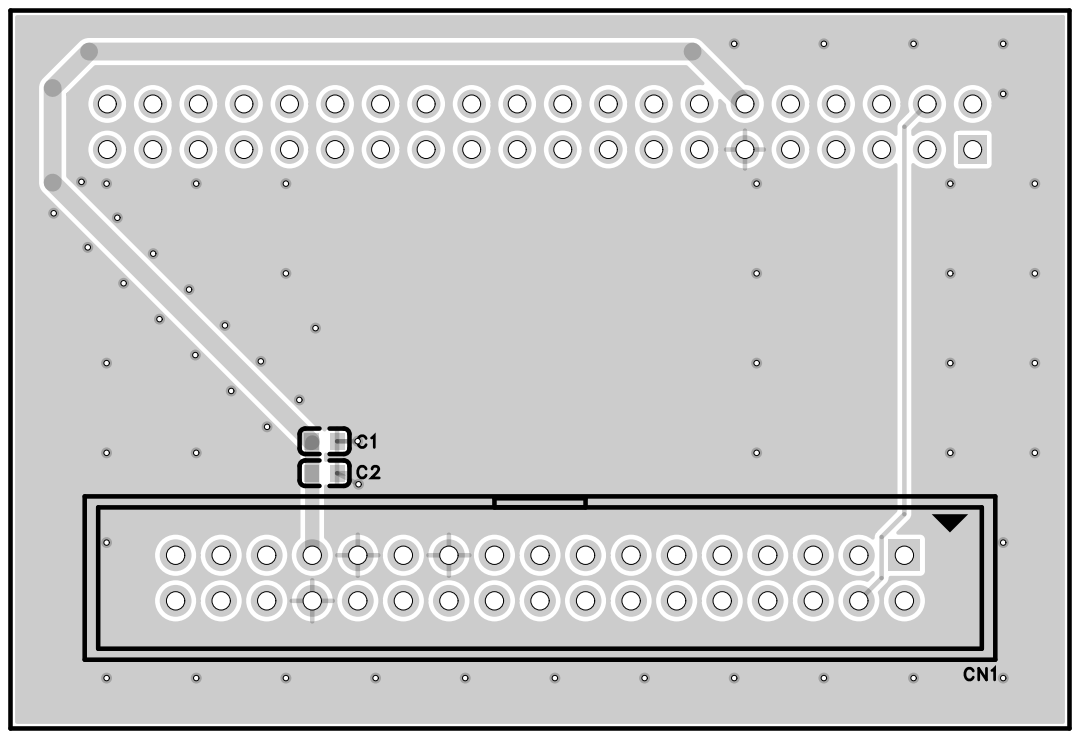
[picture p148: page 4]

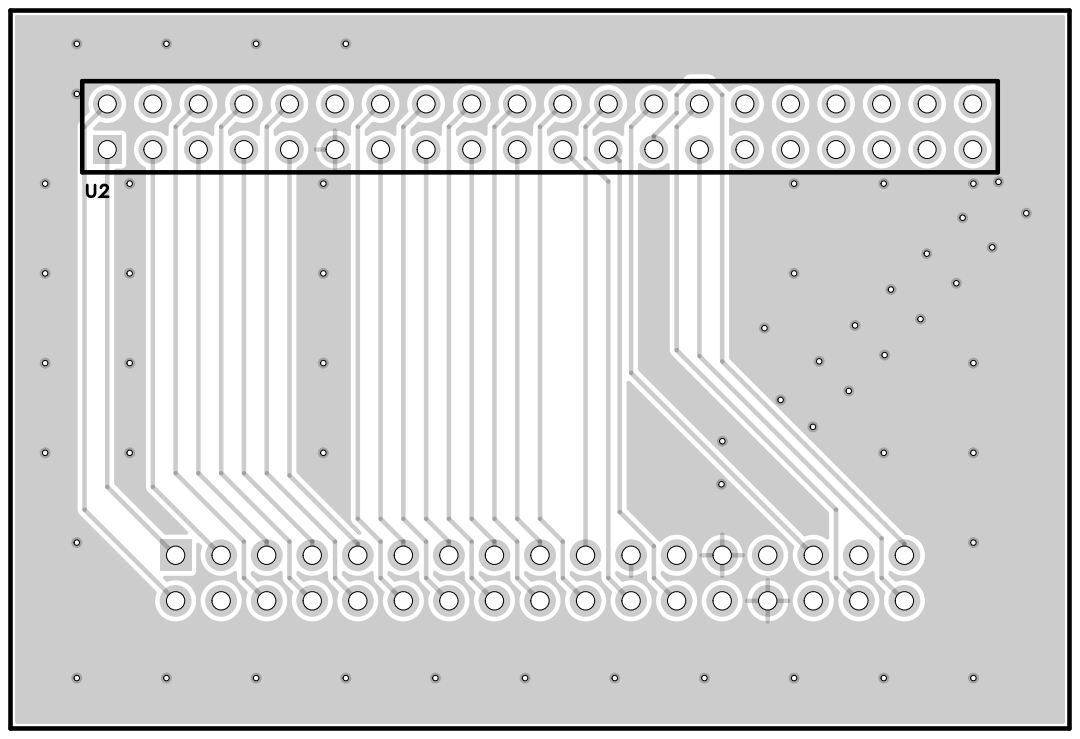
[picture p149: page 5]

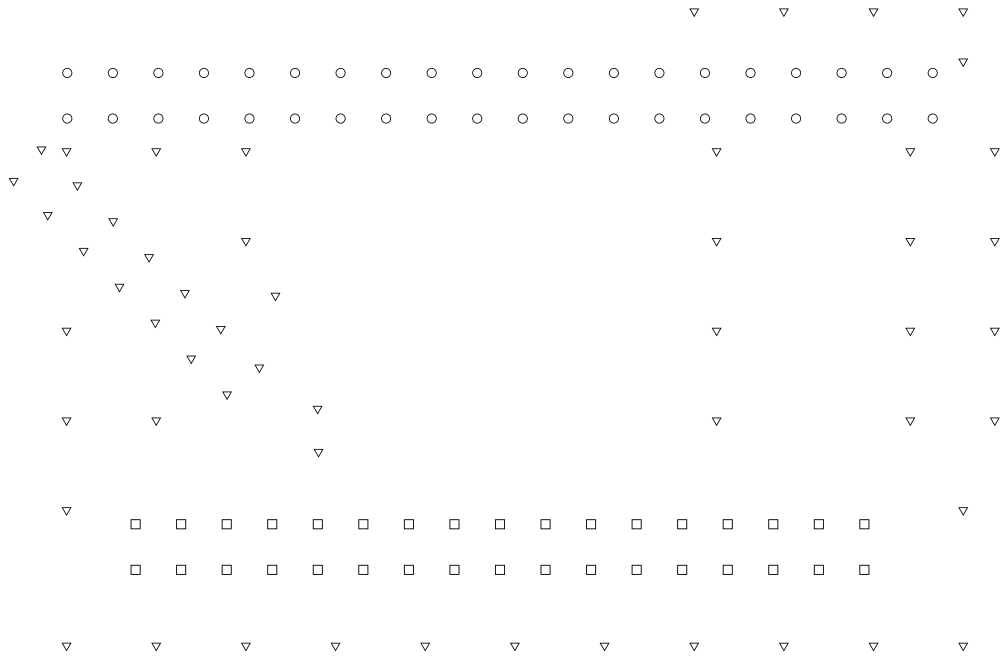
[picture p150: page 6]
