wongben2333-crypto/26Embedded/fpga_spark/【正点原子】7寸TFT LCD电容触摸屏模块V2 800480资料/【正点原子】7寸TFT LCD电容触摸屏模块V2 800480资料（新资料）/2，程序源码/ATK-MD0700模块测试实验（FMC&FSMC）/阿波罗STM32F429开发板/User/main.c

/**
 ****************************************************************************************************
 * @file        main.c
 * @author      正点原子团队(ALIENTEK)
 * @version     V1.0
 * @date        2022-06-21
 * @brief       ATK-MD0700模块测试实验（FMC）
 * @license     Copyright (c) 2020-2032, 广州市星翼电子科技有限公司
 ****************************************************************************************************
 * @attention
 *
 * 实验平台:正点原子 阿波罗 F429开发板
 * 在线视频:www.yuanzige.com
 * 技术论坛:www.openedv.com
 * 公司网址:www.alientek.com
 * 购买地址:openedv.taobao.com
 *
 ****************************************************************************************************
 */

#include "./SYSTEM/sys/sys.h"
#include "./SYSTEM/delay/delay.h"
#include "./SYSTEM/usart/usart.h"
#include "./BSP/LED/led.h"
#include "./BSP/KEY/key.h"
#include "demo.h"

/**
 * @brief       显示实验信息
 * @param       无
 * @retval      无
 */
void show_mesg(void)
{
    /* 串口输出实验信息 */
    printf("\n");
    printf("********************************\r\n");
    printf("STM32\r\n");
    printf("ATK-MD0700\r\n");
    printf("ATOM@ALIENTEK\r\n");
    printf("********************************\r\n");
    printf("\r\n");
}

int main(void)
{
    HAL_Init();                             /* 初始化HAL库 */
    sys_stm32_clock_init(360, 25, 2, 8);    /* 设置时钟,180Mhz */
    delay_init(180);                        /* 延时初始化 */
    usart_init(115200);                     /* 初始化USART */
    led_init();                             /* 初始化LED */
    key_init();                             /* 初始化KEY */
    show_mesg();                            /* 显示实验信息 */
    demo_run();                             /* 运行示例程序 */
}
