wongben2333-crypto/26Embedded/rtl/synth/piano_rom.v

// =============================================================================
//  piano_rom.v —— 钢琴音色引擎常量表（由 tools/gen/gen_piano_rom.py 生成）
//
//  ⚠️ 本文件由脚本生成，请勿手工编辑。改参数请改 tools/gen/gen_piano_rom.py。
//
//  采样率 fs = 97656.2 Hz（= 50 MHz / 512，BCK_DIV=1）。改 BCK_DIV 必须重跑本脚本。
//
//  本文件含 4 个模块：
//    piano_sin_rom      8 bit 相位 → 16 bit 正弦（象限折叠，仅存 65 项 1/4 波表）
//    piano_note_lut     音符 → 基频相位增量(32 bit Q32) + 齐奏拍频增量
//    piano_vel_lut      力度 → Q16 增益 + 琴槌噪声低通档位
//    piano_partial_lut  泛音序号 → 幅度/明亮度/衰减移位/非谐性拉伸移位
//
//  ★ 不用 $readmemh 读外部文件：参考实现 26Embedded/fpga_spark 的 piano_voice.v
//    用 $readmemh("wavetable_sine.hex")，文件不在工作目录时 ROM 全 0（完全静音），
//    极难排查。本工程一律 case 常量表（与 wave_rom.v 一致）。
//
//  ★ 16 bit 有符号常数一律写成 -16'sdNNN；写 16'sd-NNN 在 Verilog 里是非法字面量
//    （本项目实测报过 508 个 Expecting numeric digits）。
// =============================================================================
`default_nettype none

// -----------------------------------------------------------------------------
//  piano_sin_rom —— 1/4 波表 + 象限折叠
//    phase[7:6] = 象限，phase[5:0] = 象限内位置
//    idx = phase[6] ? (64 - pos) : pos   （0..64，含 90° 端点）
//    neg = phase[7]
//  只存 65 项，面积约为 256 项全表的 1/4。
// -----------------------------------------------------------------------------
module piano_sin_rom (
    input  wire               clk,
    input  wire [7:0]         phase,     // 一个整周期 = 256 步
    output reg  signed [15:0] data
);

    wire [6:0] pos = {1'b0, phase[5:0]};
    wire [6:0] idx = phase[6] ? (7'd64 - pos) : pos;
    wire       neg = phase[7];

    reg signed [15:0] q;

    always @(*) begin
        case (idx)
            7'd0: q = 16'sd0;
            7'd1: q = 16'sd804;
            7'd2: q = 16'sd1608;
            7'd3: q = 16'sd2410;
            7'd4: q = 16'sd3212;
            7'd5: q = 16'sd4011;
            7'd6: q = 16'sd4808;
            7'd7: q = 16'sd5602;
            7'd8: q = 16'sd6393;
            7'd9: q = 16'sd7179;
            7'd10: q = 16'sd7962;
            7'd11: q = 16'sd8739;
            7'd12: q = 16'sd9512;
            7'd13: q = 16'sd10278;
            7'd14: q = 16'sd11039;
            7'd15: q = 16'sd11793;
            7'd16: q = 16'sd12539;
            7'd17: q = 16'sd13279;
            7'd18: q = 16'sd14010;
            7'd19: q = 16'sd14732;
            7'd20: q = 16'sd15446;
            7'd21: q = 16'sd16151;
            7'd22: q = 16'sd16846;
            7'd23: q = 16'sd17530;
            7'd24: q = 16'sd18204;
            7'd25: q = 16'sd18868;
            7'd26: q = 16'sd19519;
            7'd27: q = 16'sd20159;
            7'd28: q = 16'sd20787;
            7'd29: q = 16'sd21403;
            7'd30: q = 16'sd22005;
            7'd31: q = 16'sd22594;
            7'd32: q = 16'sd23170;
            7'd33: q = 16'sd23731;
            7'd34: q = 16'sd24279;
            7'd35: q = 16'sd24811;
            7'd36: q = 16'sd25329;
            7'd37: q = 16'sd25832;
            7'd38: q = 16'sd26319;
            7'd39: q = 16'sd26790;
            7'd40: q = 16'sd27245;
            7'd41: q = 16'sd27683;
            7'd42: q = 16'sd28105;
            7'd43: q = 16'sd28510;
            7'd44: q = 16'sd28898;
            7'd45: q = 16'sd29268;
            7'd46: q = 16'sd29621;
            7'd47: q = 16'sd29956;
            7'd48: q = 16'sd30273;
            7'd49: q = 16'sd30571;
            7'd50: q = 16'sd30852;
            7'd51: q = 16'sd31113;
            7'd52: q = 16'sd31356;
            7'd53: q = 16'sd31580;
            7'd54: q = 16'sd31785;
            7'd55: q = 16'sd31971;
            7'd56: q = 16'sd32137;
            7'd57: q = 16'sd32285;
            7'd58: q = 16'sd32412;
            7'd59: q = 16'sd32521;
            7'd60: q = 16'sd32609;
            7'd61: q = 16'sd32678;
            7'd62: q = 16'sd32728;
            7'd63: q = 16'sd32757;
            7'd64: q = 16'sd32767;
            default: q = 16'sd0;
        endcase
    end

    always @(posedge clk)
        data <= neg ? (-q) : q;

endmodule

// -----------------------------------------------------------------------------
//  piano_note_lut —— MIDI 音符 → 频率
//    f0_step  : 等程律 f = 440 × 2^((n-69)/12)，相位增量 = round(f × 2^32 / fs)
//    beat_step: 同音多弦的失谐拍频（Hz → 相位增量）
//               取自 Faust STK piano1.dsp 的 detuningHz 表：
//               低音 0.003 Hz → 中音 0.25 Hz → 高音 1.0 Hz
//               ⚠️ 是【零点几 Hz 的拍频】，不是固定 0.1%% 的频率偏移
//  组合逻辑（只在 note-on 那一拍被读），无寄存器。
// -----------------------------------------------------------------------------
module piano_note_lut (
    input  wire [6:0]  note,
    output reg  [31:0] f0_step,
    output reg  [31:0] beat_step
);

    always @(*) begin
        case (note)
            7'd0: begin f0_step = 32'd359575; beat_step = 32'd132; end // 8.18 Hz, beat 0.0030 Hz
            7'd1: begin f0_step = 32'd380957; beat_step = 32'd132; end // 8.66 Hz, beat 0.0030 Hz
            7'd2: begin f0_step = 32'd403610; beat_step = 32'd132; end // 9.18 Hz, beat 0.0030 Hz
            7'd3: begin f0_step = 32'd427610; beat_step = 32'd132; end // 9.72 Hz, beat 0.0030 Hz
            7'd4: begin f0_step = 32'd453037; beat_step = 32'd132; end // 10.30 Hz, beat 0.0030 Hz
            7'd5: begin f0_step = 32'd479976; beat_step = 32'd132; end // 10.91 Hz, beat 0.0030 Hz
            7'd6: begin f0_step = 32'd508516; beat_step = 32'd132; end // 11.56 Hz, beat 0.0030 Hz
            7'd7: begin f0_step = 32'd538754; beat_step = 32'd132; end // 12.25 Hz, beat 0.0030 Hz
            7'd8: begin f0_step = 32'd570790; beat_step = 32'd132; end // 12.98 Hz, beat 0.0030 Hz
            7'd9: begin f0_step = 32'd604731; beat_step = 32'd132; end // 13.75 Hz, beat 0.0030 Hz
            7'd10: begin f0_step = 32'd640691; beat_step = 32'd132; end // 14.57 Hz, beat 0.0030 Hz
            7'd11: begin f0_step = 32'd678788; beat_step = 32'd132; end // 15.43 Hz, beat 0.0030 Hz
            7'd12: begin f0_step = 32'd719151; beat_step = 32'd132; end // 16.35 Hz, beat 0.0030 Hz
            7'd13: begin f0_step = 32'd761914; beat_step = 32'd132; end // 17.32 Hz, beat 0.0030 Hz
            7'd14: begin f0_step = 32'd807220; beat_step = 32'd132; end // 18.35 Hz, beat 0.0030 Hz
            7'd15: begin f0_step = 32'd855219; beat_step = 32'd132; end // 19.45 Hz, beat 0.0030 Hz
            7'd16: begin f0_step = 32'd906073; beat_step = 32'd132; end // 20.60 Hz, beat 0.0030 Hz
            7'd17: begin f0_step = 32'd959951; beat_step = 32'd132; end // 21.83 Hz, beat 0.0030 Hz
            7'd18: begin f0_step = 32'd1017033; beat_step = 32'd132; end // 23.12 Hz, beat 0.0030 Hz
            7'd19: begin f0_step = 32'd1077509; beat_step = 32'd132; end // 24.50 Hz, beat 0.0030 Hz
            7'd20: begin f0_step = 32'd1141581; beat_step = 32'd132; end // 25.96 Hz, beat 0.0030 Hz
            7'd21: begin f0_step = 32'd1209463; beat_step = 32'd132; end // 27.50 Hz, beat 0.0030 Hz
            7'd22: begin f0_step = 32'd1281381; beat_step = 32'd132; end // 29.14 Hz, beat 0.0030 Hz
            7'd23: begin f0_step = 32'd1357576; beat_step = 32'd132; end // 30.87 Hz, beat 0.0030 Hz
            7'd24: begin f0_step = 32'd1438302; beat_step = 32'd132; end // 32.70 Hz, beat 0.0030 Hz
            7'd25: begin f0_step = 32'd1523828; beat_step = 32'd132; end // 34.65 Hz, beat 0.0030 Hz
            7'd26: begin f0_step = 32'd1614439; beat_step = 32'd132; end // 36.71 Hz, beat 0.0030 Hz
            7'd27: begin f0_step = 32'd1710439; beat_step = 32'd132; end // 38.89 Hz, beat 0.0030 Hz
            7'd28: begin f0_step = 32'd1812147; beat_step = 32'd132; end // 41.20 Hz, beat 0.0030 Hz
            7'd29: begin f0_step = 32'd1919903; beat_step = 32'd2639; end // 43.65 Hz, beat 0.0600 Hz
            7'd30: begin f0_step = 32'd2034066; beat_step = 32'd3518; end // 46.25 Hz, beat 0.0800 Hz
            7'd31: begin f0_step = 32'd2155018; beat_step = 32'd4398; end // 49.00 Hz, beat 0.1000 Hz
            7'd32: begin f0_step = 32'd2283162; beat_step = 32'd4486; end // 51.91 Hz, beat 0.1020 Hz
            7'd33: begin f0_step = 32'd2418926; beat_step = 32'd4574; end // 55.00 Hz, beat 0.1040 Hz
            7'd34: begin f0_step = 32'd2562762; beat_step = 32'd4662; end // 58.27 Hz, beat 0.1060 Hz
            7'd35: begin f0_step = 32'd2715152; beat_step = 32'd4750; end // 61.74 Hz, beat 0.1080 Hz
            7'd36: begin f0_step = 32'd2876604; beat_step = 32'd4838; end // 65.41 Hz, beat 0.1100 Hz
            7'd37: begin f0_step = 32'd3047655; beat_step = 32'd4911; end // 69.30 Hz, beat 0.1117 Hz
            7'd38: begin f0_step = 32'd3228878; beat_step = 32'd4984; end // 73.42 Hz, beat 0.1133 Hz
            7'd39: begin f0_step = 32'd3420877; beat_step = 32'd5058; end // 77.78 Hz, beat 0.1150 Hz
            7'd40: begin f0_step = 32'd3624293; beat_step = 32'd5131; end // 82.41 Hz, beat 0.1167 Hz
            7'd41: begin f0_step = 32'd3839805; beat_step = 32'd5204; end // 87.31 Hz, beat 0.1183 Hz
            7'd42: begin f0_step = 32'd4068132; beat_step = 32'd5278; end // 92.50 Hz, beat 0.1200 Hz
            7'd43: begin f0_step = 32'd4310035; beat_step = 32'd5864; end // 98.00 Hz, beat 0.1333 Hz
            7'd44: begin f0_step = 32'd4566323; beat_step = 32'd6450; end // 103.83 Hz, beat 0.1467 Hz
            7'd45: begin f0_step = 32'd4837851; beat_step = 32'd7037; end // 110.00 Hz, beat 0.1600 Hz
            7'd46: begin f0_step = 32'd5125525; beat_step = 32'd7623; end // 116.54 Hz, beat 0.1733 Hz
            7'd47: begin f0_step = 32'd5430304; beat_step = 32'd8210; end // 123.47 Hz, beat 0.1867 Hz
            7'd48: begin f0_step = 32'd5753207; beat_step = 32'd8796; end // 130.81 Hz, beat 0.2000 Hz
            7'd49: begin f0_step = 32'd6095311; beat_step = 32'd8796; end // 138.59 Hz, beat 0.2000 Hz
            7'd50: begin f0_step = 32'd6457757; beat_step = 32'd8796; end // 146.83 Hz, beat 0.2000 Hz
            7'd51: begin f0_step = 32'd6841755; beat_step = 32'd8796; end // 155.56 Hz, beat 0.2000 Hz
            7'd52: begin f0_step = 32'd7248587; beat_step = 32'd8796; end // 164.81 Hz, beat 0.2000 Hz
            7'd53: begin f0_step = 32'd7679610; beat_step = 32'd8796; end // 174.61 Hz, beat 0.2000 Hz
            7'd54: begin f0_step = 32'd8136263; beat_step = 32'd8796; end // 185.00 Hz, beat 0.2000 Hz
            7'd55: begin f0_step = 32'd8620071; beat_step = 32'd9163; end // 196.00 Hz, beat 0.2083 Hz
            7'd56: begin f0_step = 32'd9132647; beat_step = 32'd9529; end // 207.65 Hz, beat 0.2167 Hz
            7'd57: begin f0_step = 32'd9675702; beat_step = 32'd9896; end // 220.00 Hz, beat 0.2250 Hz
            7'd58: begin f0_step = 32'd10251050; beat_step = 32'd10262; end // 233.08 Hz, beat 0.2333 Hz
            7'd59: begin f0_step = 32'd10860609; beat_step = 32'd10629; end // 246.94 Hz, beat 0.2417 Hz
            7'd60: begin f0_step = 32'd11506414; beat_step = 32'd10995; end // 261.63 Hz, beat 0.2500 Hz
            7'd61: begin f0_step = 32'd12190621; beat_step = 32'd11142; end // 277.18 Hz, beat 0.2533 Hz
            7'd62: begin f0_step = 32'd12915513; beat_step = 32'd11288; end // 293.66 Hz, beat 0.2567 Hz
            7'd63: begin f0_step = 32'd13683509; beat_step = 32'd11435; end // 311.13 Hz, beat 0.2600 Hz
            7'd64: begin f0_step = 32'd14497173; beat_step = 32'd11582; end // 329.63 Hz, beat 0.2633 Hz
            7'd65: begin f0_step = 32'd15359220; beat_step = 32'd11728; end // 349.23 Hz, beat 0.2667 Hz
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
            7'd106: begin f0_step = 32'd164016792; beat_step = 32'd43980; end // 3729.31 Hz, beat 1.0000 Hz
            7'd107: begin f0_step = 32'd173769738; beat_step = 32'd43980; end // 3951.07 Hz, beat 1.0000 Hz
            7'd108: begin f0_step = 32'd184102625; beat_step = 32'd43980; end // 4186.01 Hz, beat 1.0000 Hz
            7'd109: begin f0_step = 32'd195049936; beat_step = 32'd43980; end // 4434.92 Hz, beat 1.0000 Hz
            7'd110: begin f0_step = 32'd206648209; beat_step = 32'd43980; end // 4698.64 Hz, beat 1.0000 Hz
            7'd111: begin f0_step = 32'd218936151; beat_step = 32'd43980; end // 4978.03 Hz, beat 1.0000 Hz
            7'd112: begin f0_step = 32'd231954772; beat_step = 32'd43980; end // 5274.04 Hz, beat 1.0000 Hz
            7'd113: begin f0_step = 32'd245747521; beat_step = 32'd43980; end // 5587.65 Hz, beat 1.0000 Hz
            7'd114: begin f0_step = 32'd260360429; beat_step = 32'd43980; end // 5919.91 Hz, beat 1.0000 Hz
            7'd115: begin f0_step = 32'd275842266; beat_step = 32'd43980; end // 6271.93 Hz, beat 1.0000 Hz
            7'd116: begin f0_step = 32'd292244700; beat_step = 32'd43980; end // 6644.88 Hz, beat 1.0000 Hz
            7'd117: begin f0_step = 32'd309622474; beat_step = 32'd43980; end // 7040.00 Hz, beat 1.0000 Hz
            7'd118: begin f0_step = 32'd328033585; beat_step = 32'd43980; end // 7458.62 Hz, beat 1.0000 Hz
            7'd119: begin f0_step = 32'd347539477; beat_step = 32'd43980; end // 7902.13 Hz, beat 1.0000 Hz
            7'd120: begin f0_step = 32'd368205249; beat_step = 32'd43980; end // 8372.02 Hz, beat 1.0000 Hz
            7'd121: begin f0_step = 32'd390099873; beat_step = 32'd43980; end // 8869.84 Hz, beat 1.0000 Hz
            7'd122: begin f0_step = 32'd413296419; beat_step = 32'd43980; end // 9397.27 Hz, beat 1.0000 Hz
            7'd123: begin f0_step = 32'd437872302; beat_step = 32'd43980; end // 9956.06 Hz, beat 1.0000 Hz
            7'd124: begin f0_step = 32'd463909545; beat_step = 32'd43980; end // 10548.08 Hz, beat 1.0000 Hz
            7'd125: begin f0_step = 32'd491495042; beat_step = 32'd43980; end // 11175.30 Hz, beat 1.0000 Hz
            7'd126: begin f0_step = 32'd520720858; beat_step = 32'd43980; end // 11839.82 Hz, beat 1.0000 Hz
            7'd127: begin f0_step = 32'd551684531; beat_step = 32'd43980; end // 12543.85 Hz, beat 1.0000 Hz
            default: begin f0_step = 32'd0; beat_step = 32'd0; end
        endcase
    end

endmodule

// -----------------------------------------------------------------------------
//  piano_vel_lut —— 力度 → 增益 / 琴槌噪声低通档位
//    gain_q16 : 0.12 .. 1.0（≈ -18 dB 动态），曲线 (v/127)^1.6
//    lp_sh    : 一阶低通右移量，力度越大越小（越亮）
// -----------------------------------------------------------------------------
module piano_vel_lut (
    input  wire [6:0]  vel,
    input  wire [1:0]  inst,          // 0=钢琴 1=电吉他 2=古筝
    output reg  [16:0] gain_q16,
    output reg  [2:0]  lp_sh
);

    always @(*) begin
        case ({inst, vel})
            10'd0: begin gain_q16 = 17'd7864; lp_sh = 3'd3; end
            10'd1: begin gain_q16 = 17'd7889; lp_sh = 3'd3; end
            10'd2: begin gain_q16 = 17'd7940; lp_sh = 3'd3; end
            10'd3: begin gain_q16 = 17'd8008; lp_sh = 3'd3; end
            10'd4: begin gain_q16 = 17'd8092; lp_sh = 3'd3; end
            10'd5: begin gain_q16 = 17'd8190; lp_sh = 3'd3; end
            10'd6: begin gain_q16 = 17'd8301; lp_sh = 3'd3; end
            10'd7: begin gain_q16 = 17'd8423; lp_sh = 3'd3; end
            10'd8: begin gain_q16 = 17'd8556; lp_sh = 3'd3; end
            10'd9: begin gain_q16 = 17'd8699; lp_sh = 3'd3; end
            10'd10: begin gain_q16 = 17'd8853; lp_sh = 3'd3; end
            10'd11: begin gain_q16 = 17'd9015; lp_sh = 3'd3; end
            10'd12: begin gain_q16 = 17'd9187; lp_sh = 3'd3; end
            10'd13: begin gain_q16 = 17'd9368; lp_sh = 3'd3; end
            10'd14: begin gain_q16 = 17'd9557; lp_sh = 3'd3; end
            10'd15: begin gain_q16 = 17'd9755; lp_sh = 3'd3; end
            10'd16: begin gain_q16 = 17'd9961; lp_sh = 3'd3; end
            10'd17: begin gain_q16 = 17'd10174; lp_sh = 3'd3; end
            10'd18: begin gain_q16 = 17'd10395; lp_sh = 3'd3; end
            10'd19: begin gain_q16 = 17'd10624; lp_sh = 3'd3; end
            10'd20: begin gain_q16 = 17'd10860; lp_sh = 3'd3; end
            10'd21: begin gain_q16 = 17'd11103; lp_sh = 3'd3; end
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
            10'd484: begin gain_q16 = 17'd47208; lp_sh = 3'd1; end
            10'd485: begin gain_q16 = 17'd47840; lp_sh = 3'd1; end
            10'd486: begin gain_q16 = 17'd48475; lp_sh = 3'd1; end
            10'd487: begin gain_q16 = 17'd49114; lp_sh = 3'd1; end
            10'd488: begin gain_q16 = 17'd49756; lp_sh = 3'd1; end
            10'd489: begin gain_q16 = 17'd50403; lp_sh = 3'd1; end
            10'd490: begin gain_q16 = 17'd51053; lp_sh = 3'd1; end
            10'd491: begin gain_q16 = 17'd51706; lp_sh = 3'd1; end
            10'd492: begin gain_q16 = 17'd52364; lp_sh = 3'd1; end
            10'd493: begin gain_q16 = 17'd53025; lp_sh = 3'd1; end
            10'd494: begin gain_q16 = 17'd53690; lp_sh = 3'd1; end
            10'd495: begin gain_q16 = 17'd54358; lp_sh = 3'd1; end
            10'd496: begin gain_q16 = 17'd55030; lp_sh = 3'd1; end
            10'd497: begin gain_q16 = 17'd55706; lp_sh = 3'd1; end
            10'd498: begin gain_q16 = 17'd56385; lp_sh = 3'd1; end
            10'd499: begin gain_q16 = 17'd57068; lp_sh = 3'd1; end
            10'd500: begin gain_q16 = 17'd57754; lp_sh = 3'd1; end
            10'd501: begin gain_q16 = 17'd58444; lp_sh = 3'd1; end
            10'd502: begin gain_q16 = 17'd59137; lp_sh = 3'd1; end
            10'd503: begin gain_q16 = 17'd59834; lp_sh = 3'd1; end
            10'd504: begin gain_q16 = 17'd60535; lp_sh = 3'd1; end
            10'd505: begin gain_q16 = 17'd61239; lp_sh = 3'd1; end
            10'd506: begin gain_q16 = 17'd61946; lp_sh = 3'd1; end
            10'd507: begin gain_q16 = 17'd62657; lp_sh = 3'd1; end
            10'd508: begin gain_q16 = 17'd63372; lp_sh = 3'd1; end
            10'd509: begin gain_q16 = 17'd64090; lp_sh = 3'd1; end
            10'd510: begin gain_q16 = 17'd64811; lp_sh = 3'd1; end
            10'd511: begin gain_q16 = 17'd65536; lp_sh = 3'd1; end
            default: begin gain_q16 = 17'd7864; lp_sh = 3'd3; end
        endcase
    end

endmodule

// -----------------------------------------------------------------------------
//  piano_partial_lut —— 第 n 个泛音分量的全部参数（n = 0..5 对应 1..6 次泛音）
//    amp_q16  : 幅度系数（Q16，满幅 = 65536）。6 个之和在最强奏时 ≈ 1.0
//    k_q12    : 力度→明亮度系数（Q12），实际增益 ×(1 + K/4096)
//    s_ring   : 按住时的衰减移位（env -= env >> s_ring）
//    s_damp   : 松开后的衰减移位（阻音器）
//    st1/st2  : 非谐性拉伸（inc = n·f0 + (f0>>st1) + (f0>>st2)），31 = 该项为 0
//  设计依据见 gen_piano_rom.py 头部（AMY / Faust STK）。
// -----------------------------------------------------------------------------
module piano_partial_lut (
    input  wire [2:0]  n,
    input  wire [2:0]  band,
    input  wire [1:0]  inst,          // 0=钢琴 1=电吉他 2=古筝
    output reg  [16:0] amp_q16,
    output reg  [15:0] k_q12,
    output reg  [4:0]  s_ring,
    output reg  [4:0]  s_damp,
    output reg  [4:0]  st1,
    output reg  [4:0]  st2
);

    //  ⚠️ amp/k/st1/st2 随乐器变；**s_ring/s_damp 三个乐器给同一组值**
    //     —— 因为它们在声部里是【常量索引查表 ⇒ 综合时折叠成常数移位】，
    //        一旦随乐器变就会在每采样路径长出桶形移位器（MODE=1 裕量只有 +0.009 ns）。
    //        乐器的衰减差异改由 ksh_ofs（piano_inst_lut）表达。
    always @(*) begin
        case ({inst, band, n})
            8'd0: begin amp_q16 = 17'd20500; k_q12 = 16'd0; s_ring = 5'd17; s_damp = 5'd13; st1 = 5'd13; st2 = 5'd18; end
            8'd1: begin amp_q16 = 17'd11800; k_q12 = 16'd3200; s_ring = 5'd16; s_damp = 5'd12; st1 = 5'd10; st2 = 5'd15; end
            8'd2: begin amp_q16 = 17'd6800; k_q12 = 16'd6800; s_ring = 5'd15; s_damp = 5'd11; st1 = 5'd9; st2 = 5'd10; end
            8'd3: begin amp_q16 = 17'd3600; k_q12 = 16'd11000; s_ring = 5'd14; s_damp = 5'd10; st1 = 5'd7; st2 = 5'd13; end
            8'd4: begin amp_q16 = 17'd1800; k_q12 = 16'd16000; s_ring = 5'd13; s_damp = 5'd9; st1 = 5'd6; st2 = 5'd31; end
            8'd5: begin amp_q16 = 17'd900; k_q12 = 16'd20000; s_ring = 5'd12; s_damp = 5'd8; st1 = 5'd6; st2 = 5'd7; end
            8'd8: begin amp_q16 = 17'd23500; k_q12 = 16'd0; s_ring = 5'd17; s_damp = 5'd13; st1 = 5'd13; st2 = 5'd15; end
            8'd9: begin amp_q16 = 17'd10200; k_q12 = 16'd3200; s_ring = 5'd16; s_damp = 5'd12; st1 = 5'd10; st2 = 5'd12; end
            8'd10: begin amp_q16 = 17'd5000; k_q12 = 16'd6800; s_ring = 5'd15; s_damp = 5'd11; st1 = 5'd8; st2 = 5'd11; end
            8'd11: begin amp_q16 = 17'd2400; k_q12 = 16'd11000; s_ring = 5'd14; s_damp = 5'd10; st1 = 5'd7; st2 = 5'd9; end
            8'd12: begin amp_q16 = 17'd1100; k_q12 = 16'd16000; s_ring = 5'd13; s_damp = 5'd9; st1 = 5'd6; st2 = 5'd8; end
            8'd13: begin amp_q16 = 17'd520; k_q12 = 16'd20000; s_ring = 5'd12; s_damp = 5'd8; st1 = 5'd5; st2 = 5'd8; end
            8'd16: begin amp_q16 = 17'd26500; k_q12 = 16'd0; s_ring = 5'd17; s_damp = 5'd13; st1 = 5'd13; st2 = 5'd14; end
            8'd17: begin amp_q16 = 17'd8600; k_q12 = 16'd3200; s_ring = 5'd16; s_damp = 5'd12; st1 = 5'd10; st2 = 5'd11; end
            8'd18: begin amp_q16 = 17'd3600; k_q12 = 16'd6800; s_ring = 5'd15; s_damp = 5'd11; st1 = 5'd8; st2 = 5'd9; end
            8'd19: begin amp_q16 = 17'd1500; k_q12 = 16'd11000; s_ring = 5'd14; s_damp = 5'd10; st1 = 5'd7; st2 = 5'd8; end
            8'd20: begin amp_q16 = 17'd600; k_q12 = 16'd16000; s_ring = 5'd13; s_damp = 5'd9; st1 = 5'd6; st2 = 5'd7; end
            8'd21: begin amp_q16 = 17'd280; k_q12 = 16'd20000; s_ring = 5'd12; s_damp = 5'd8; st1 = 5'd5; st2 = 5'd6; end
            8'd24: begin amp_q16 = 17'd28500; k_q12 = 16'd0; s_ring = 5'd17; s_damp = 5'd13; st1 = 5'd12; st2 = 5'd15; end
            8'd25: begin amp_q16 = 17'd6800; k_q12 = 16'd3200; s_ring = 5'd16; s_damp = 5'd12; st1 = 5'd9; st2 = 5'd12; end
            8'd26: begin amp_q16 = 17'd2200; k_q12 = 16'd6800; s_ring = 5'd15; s_damp = 5'd11; st1 = 5'd7; st2 = 5'd31; end
            8'd27: begin amp_q16 = 17'd750; k_q12 = 16'd11000; s_ring = 5'd14; s_damp = 5'd10; st1 = 5'd6; st2 = 5'd9; end
            8'd28: begin amp_q16 = 17'd250; k_q12 = 16'd16000; s_ring = 5'd13; s_damp = 5'd9; st1 = 5'd5; st2 = 5'd8; end
            8'd29: begin amp_q16 = 17'd90; k_q12 = 16'd20000; s_ring = 5'd12; s_damp = 5'd8; st1 = 5'd4; st2 = 5'd31; end
            8'd32: begin amp_q16 = 17'd30500; k_q12 = 16'd0; s_ring = 5'd17; s_damp = 5'd13; st1 = 5'd12; st2 = 5'd13; end
            8'd33: begin amp_q16 = 17'd4800; k_q12 = 16'd3200; s_ring = 5'd16; s_damp = 5'd12; st1 = 5'd9; st2 = 5'd10; end
            8'd34: begin amp_q16 = 17'd1100; k_q12 = 16'd6800; s_ring = 5'd15; s_damp = 5'd11; st1 = 5'd7; st2 = 5'd9; end
            8'd35: begin amp_q16 = 17'd280; k_q12 = 16'd11000; s_ring = 5'd14; s_damp = 5'd10; st1 = 5'd6; st2 = 5'd7; end
            8'd36: begin amp_q16 = 17'd70; k_q12 = 16'd16000; s_ring = 5'd13; s_damp = 5'd9; st1 = 5'd5; st2 = 5'd6; end
            8'd37: begin amp_q16 = 17'd0; k_q12 = 16'd20000; s_ring = 5'd12; s_damp = 5'd8; st1 = 5'd4; st2 = 5'd6; end
            8'd64: begin amp_q16 = 17'd17000; k_q12 = 16'd0; s_ring = 5'd16; s_damp = 5'd11; st1 = 5'd15; st2 = 5'd17; end
            8'd65: begin amp_q16 = 17'd16000; k_q12 = 16'd3686; s_ring = 5'd15; s_damp = 5'd10; st1 = 5'd12; st2 = 5'd14; end
            8'd66: begin amp_q16 = 17'd12500; k_q12 = 16'd7200; s_ring = 5'd14; s_damp = 5'd9; st1 = 5'd10; st2 = 5'd13; end
            8'd67: begin amp_q16 = 17'd6500; k_q12 = 16'd11500; s_ring = 5'd12; s_damp = 5'd8; st1 = 5'd9; st2 = 5'd11; end
            8'd68: begin amp_q16 = 17'd3200; k_q12 = 16'd15000; s_ring = 5'd10; s_damp = 5'd7; st1 = 5'd8; st2 = 5'd10; end
            8'd69: begin amp_q16 = 17'd1400; k_q12 = 16'd18000; s_ring = 5'd9; s_damp = 5'd6; st1 = 5'd7; st2 = 5'd10; end
            8'd72: begin amp_q16 = 17'd18000; k_q12 = 16'd0; s_ring = 5'd16; s_damp = 5'd11; st1 = 5'd15; st2 = 5'd16; end
            8'd73: begin amp_q16 = 17'd16000; k_q12 = 16'd3686; s_ring = 5'd15; s_damp = 5'd10; st1 = 5'd12; st2 = 5'd13; end
            8'd74: begin amp_q16 = 17'd12000; k_q12 = 16'd7200; s_ring = 5'd14; s_damp = 5'd9; st1 = 5'd10; st2 = 5'd11; end
            8'd75: begin amp_q16 = 17'd6000; k_q12 = 16'd11500; s_ring = 5'd12; s_damp = 5'd8; st1 = 5'd9; st2 = 5'd10; end
            8'd76: begin amp_q16 = 17'd2800; k_q12 = 16'd15000; s_ring = 5'd10; s_damp = 5'd7; st1 = 5'd8; st2 = 5'd9; end
            8'd77: begin amp_q16 = 17'd1200; k_q12 = 16'd18000; s_ring = 5'd9; s_damp = 5'd6; st1 = 5'd7; st2 = 5'd8; end
            8'd80: begin amp_q16 = 17'd19000; k_q12 = 16'd0; s_ring = 5'd16; s_damp = 5'd11; st1 = 5'd14; st2 = 5'd31; end
            8'd81: begin amp_q16 = 17'd15500; k_q12 = 16'd3686; s_ring = 5'd15; s_damp = 5'd10; st1 = 5'd11; st2 = 5'd31; end
            8'd82: begin amp_q16 = 17'd11500; k_q12 = 16'd7200; s_ring = 5'd14; s_damp = 5'd9; st1 = 5'd10; st2 = 5'd11; end
            8'd83: begin amp_q16 = 17'd5000; k_q12 = 16'd11500; s_ring = 5'd12; s_damp = 5'd8; st1 = 5'd8; st2 = 5'd31; end
            8'd84: begin amp_q16 = 17'd2200; k_q12 = 16'd15000; s_ring = 5'd10; s_damp = 5'd7; st1 = 5'd7; st2 = 5'd31; end
            8'd85: begin amp_q16 = 17'd900; k_q12 = 16'd18000; s_ring = 5'd9; s_damp = 5'd6; st1 = 5'd7; st2 = 5'd8; end
            8'd88: begin amp_q16 = 17'd22000; k_q12 = 16'd0; s_ring = 5'd16; s_damp = 5'd11; st1 = 5'd14; st2 = 5'd16; end
            8'd89: begin amp_q16 = 17'd13000; k_q12 = 16'd3686; s_ring = 5'd15; s_damp = 5'd10; st1 = 5'd11; st2 = 5'd13; end
            8'd90: begin amp_q16 = 17'd8500; k_q12 = 16'd7200; s_ring = 5'd14; s_damp = 5'd9; st1 = 5'd9; st2 = 5'd12; end
            8'd91: begin amp_q16 = 17'd3500; k_q12 = 16'd11500; s_ring = 5'd12; s_damp = 5'd8; st1 = 5'd8; st2 = 5'd10; end
            8'd92: begin amp_q16 = 17'd1400; k_q12 = 16'd15000; s_ring = 5'd10; s_damp = 5'd7; st1 = 5'd7; st2 = 5'd9; end
            8'd93: begin amp_q16 = 17'd500; k_q12 = 16'd18000; s_ring = 5'd9; s_damp = 5'd6; st1 = 5'd6; st2 = 5'd9; end
            8'd96: begin amp_q16 = 17'd25000; k_q12 = 16'd0; s_ring = 5'd16; s_damp = 5'd11; st1 = 5'd13; st2 = 5'd31; end
            8'd97: begin amp_q16 = 17'd10000; k_q12 = 16'd3686; s_ring = 5'd15; s_damp = 5'd10; st1 = 5'd10; st2 = 5'd31; end
            8'd98: begin amp_q16 = 17'd5000; k_q12 = 16'd7200; s_ring = 5'd14; s_damp = 5'd9; st1 = 5'd9; st2 = 5'd10; end
            8'd99: begin amp_q16 = 17'd1800; k_q12 = 16'd11500; s_ring = 5'd12; s_damp = 5'd8; st1 = 5'd7; st2 = 5'd31; end
            8'd100: begin amp_q16 = 17'd600; k_q12 = 16'd15000; s_ring = 5'd10; s_damp = 5'd7; st1 = 5'd6; st2 = 5'd31; end
            8'd101: begin amp_q16 = 17'd200; k_q12 = 16'd18000; s_ring = 5'd9; s_damp = 5'd6; st1 = 5'd6; st2 = 5'd7; end
            8'd128: begin amp_q16 = 17'd18000; k_q12 = 16'd0; s_ring = 5'd17; s_damp = 5'd11; st1 = 5'd15; st2 = 5'd16; end
            8'd129: begin amp_q16 = 17'd15000; k_q12 = 16'd4000; s_ring = 5'd16; s_damp = 5'd10; st1 = 5'd12; st2 = 5'd13; end
            8'd130: begin amp_q16 = 17'd12000; k_q12 = 16'd8000; s_ring = 5'd15; s_damp = 5'd9; st1 = 5'd10; st2 = 5'd11; end
            8'd131: begin amp_q16 = 17'd9500; k_q12 = 16'd12000; s_ring = 5'd14; s_damp = 5'd8; st1 = 5'd9; st2 = 5'd10; end
            8'd132: begin amp_q16 = 17'd8000; k_q12 = 16'd16000; s_ring = 5'd13; s_damp = 5'd7; st1 = 5'd8; st2 = 5'd9; end
            8'd133: begin amp_q16 = 17'd6500; k_q12 = 16'd20000; s_ring = 5'd12; s_damp = 5'd6; st1 = 5'd7; st2 = 5'd8; end
            8'd136: begin amp_q16 = 17'd19000; k_q12 = 16'd0; s_ring = 5'd17; s_damp = 5'd11; st1 = 5'd14; st2 = 5'd31; end
            8'd137: begin amp_q16 = 17'd14500; k_q12 = 16'd4000; s_ring = 5'd16; s_damp = 5'd10; st1 = 5'd11; st2 = 5'd31; end
            8'd138: begin amp_q16 = 17'd11500; k_q12 = 16'd8000; s_ring = 5'd15; s_damp = 5'd9; st1 = 5'd10; st2 = 5'd11; end
            8'd139: begin amp_q16 = 17'd9000; k_q12 = 16'd12000; s_ring = 5'd14; s_damp = 5'd8; st1 = 5'd8; st2 = 5'd31; end
            8'd140: begin amp_q16 = 17'd7500; k_q12 = 16'd16000; s_ring = 5'd13; s_damp = 5'd7; st1 = 5'd7; st2 = 5'd31; end
            8'd141: begin amp_q16 = 17'd6000; k_q12 = 16'd20000; s_ring = 5'd12; s_damp = 5'd6; st1 = 5'd7; st2 = 5'd8; end
            8'd144: begin amp_q16 = 17'd20000; k_q12 = 16'd0; s_ring = 5'd17; s_damp = 5'd11; st1 = 5'd14; st2 = 5'd31; end
            8'd145: begin amp_q16 = 17'd14000; k_q12 = 16'd4000; s_ring = 5'd16; s_damp = 5'd10; st1 = 5'd11; st2 = 5'd31; end
            8'd146: begin amp_q16 = 17'd11000; k_q12 = 16'd8000; s_ring = 5'd15; s_damp = 5'd9; st1 = 5'd10; st2 = 5'd11; end
            8'd147: begin amp_q16 = 17'd8500; k_q12 = 16'd12000; s_ring = 5'd14; s_damp = 5'd8; st1 = 5'd8; st2 = 5'd31; end
            8'd148: begin amp_q16 = 17'd7000; k_q12 = 16'd16000; s_ring = 5'd13; s_damp = 5'd7; st1 = 5'd7; st2 = 5'd31; end
            8'd149: begin amp_q16 = 17'd5500; k_q12 = 16'd20000; s_ring = 5'd12; s_damp = 5'd6; st1 = 5'd7; st2 = 5'd8; end
            8'd152: begin amp_q16 = 17'd21000; k_q12 = 16'd0; s_ring = 5'd17; s_damp = 5'd11; st1 = 5'd14; st2 = 5'd16; end
            8'd153: begin amp_q16 = 17'd13000; k_q12 = 16'd4000; s_ring = 5'd16; s_damp = 5'd10; st1 = 5'd11; st2 = 5'd13; end
            8'd154: begin amp_q16 = 17'd10000; k_q12 = 16'd8000; s_ring = 5'd15; s_damp = 5'd9; st1 = 5'd9; st2 = 5'd14; end
            8'd155: begin amp_q16 = 17'd7500; k_q12 = 16'd12000; s_ring = 5'd14; s_damp = 5'd8; st1 = 5'd8; st2 = 5'd10; end
            8'd156: begin amp_q16 = 17'd6000; k_q12 = 16'd16000; s_ring = 5'd13; s_damp = 5'd7; st1 = 5'd7; st2 = 5'd9; end
            8'd157: begin amp_q16 = 17'd4500; k_q12 = 16'd20000; s_ring = 5'd12; s_damp = 5'd6; st1 = 5'd6; st2 = 5'd11; end
            8'd160: begin amp_q16 = 17'd23000; k_q12 = 16'd0; s_ring = 5'd17; s_damp = 5'd11; st1 = 5'd14; st2 = 5'd15; end
            8'd161: begin amp_q16 = 17'd11500; k_q12 = 16'd4000; s_ring = 5'd16; s_damp = 5'd10; st1 = 5'd11; st2 = 5'd12; end
            8'd162: begin amp_q16 = 17'd8500; k_q12 = 16'd8000; s_ring = 5'd15; s_damp = 5'd9; st1 = 5'd9; st2 = 5'd11; end
            8'd163: begin amp_q16 = 17'd6000; k_q12 = 16'd12000; s_ring = 5'd14; s_damp = 5'd8; st1 = 5'd8; st2 = 5'd9; end
            8'd164: begin amp_q16 = 17'd4000; k_q12 = 16'd16000; s_ring = 5'd13; s_damp = 5'd7; st1 = 5'd7; st2 = 5'd8; end
            8'd165: begin amp_q16 = 17'd2500; k_q12 = 16'd20000; s_ring = 5'd12; s_damp = 5'd6; st1 = 5'd6; st2 = 5'd8; end
            8'd192: begin amp_q16 = 17'd22000; k_q12 = 16'd0; s_ring = 5'd17; s_damp = 5'd11; st1 = 5'd15; st2 = 5'd17; end
            8'd193: begin amp_q16 = 17'd6000; k_q12 = 16'd2000; s_ring = 5'd16; s_damp = 5'd10; st1 = 5'd12; st2 = 5'd14; end
            8'd194: begin amp_q16 = 17'd14000; k_q12 = 16'd5000; s_ring = 5'd15; s_damp = 5'd9; st1 = 5'd10; st2 = 5'd13; end
            8'd195: begin amp_q16 = 17'd3000; k_q12 = 16'd7000; s_ring = 5'd14; s_damp = 5'd8; st1 = 5'd9; st2 = 5'd11; end
            8'd196: begin amp_q16 = 17'd7000; k_q12 = 16'd10000; s_ring = 5'd13; s_damp = 5'd7; st1 = 5'd8; st2 = 5'd10; end
            8'd197: begin amp_q16 = 17'd1500; k_q12 = 16'd12000; s_ring = 5'd12; s_damp = 5'd6; st1 = 5'd7; st2 = 5'd10; end
            8'd200: begin amp_q16 = 17'd23000; k_q12 = 16'd0; s_ring = 5'd17; s_damp = 5'd11; st1 = 5'd15; st2 = 5'd17; end
            8'd201: begin amp_q16 = 17'd5500; k_q12 = 16'd2000; s_ring = 5'd16; s_damp = 5'd10; st1 = 5'd12; st2 = 5'd14; end
            8'd202: begin amp_q16 = 17'd13000; k_q12 = 16'd5000; s_ring = 5'd15; s_damp = 5'd9; st1 = 5'd10; st2 = 5'd13; end
            8'd203: begin amp_q16 = 17'd2800; k_q12 = 16'd7000; s_ring = 5'd14; s_damp = 5'd8; st1 = 5'd9; st2 = 5'd11; end
            8'd204: begin amp_q16 = 17'd6000; k_q12 = 16'd10000; s_ring = 5'd13; s_damp = 5'd7; st1 = 5'd8; st2 = 5'd10; end
            8'd205: begin amp_q16 = 17'd1200; k_q12 = 16'd12000; s_ring = 5'd12; s_damp = 5'd6; st1 = 5'd7; st2 = 5'd10; end
            8'd208: begin amp_q16 = 17'd24000; k_q12 = 16'd0; s_ring = 5'd17; s_damp = 5'd11; st1 = 5'd15; st2 = 5'd16; end
            8'd209: begin amp_q16 = 17'd5000; k_q12 = 16'd2000; s_ring = 5'd16; s_damp = 5'd10; st1 = 5'd12; st2 = 5'd13; end
            8'd210: begin amp_q16 = 17'd12000; k_q12 = 16'd5000; s_ring = 5'd15; s_damp = 5'd9; st1 = 5'd10; st2 = 5'd11; end
            8'd211: begin amp_q16 = 17'd2500; k_q12 = 16'd7000; s_ring = 5'd14; s_damp = 5'd8; st1 = 5'd9; st2 = 5'd10; end
            8'd212: begin amp_q16 = 17'd5000; k_q12 = 16'd10000; s_ring = 5'd13; s_damp = 5'd7; st1 = 5'd8; st2 = 5'd9; end
            8'd213: begin amp_q16 = 17'd1000; k_q12 = 16'd12000; s_ring = 5'd12; s_damp = 5'd6; st1 = 5'd7; st2 = 5'd8; end
            8'd216: begin amp_q16 = 17'd25000; k_q12 = 16'd0; s_ring = 5'd17; s_damp = 5'd11; st1 = 5'd14; st2 = 5'd31; end
            8'd217: begin amp_q16 = 17'd4500; k_q12 = 16'd2000; s_ring = 5'd16; s_damp = 5'd10; st1 = 5'd11; st2 = 5'd31; end
            8'd218: begin amp_q16 = 17'd10000; k_q12 = 16'd5000; s_ring = 5'd15; s_damp = 5'd9; st1 = 5'd10; st2 = 5'd11; end
            8'd219: begin amp_q16 = 17'd2000; k_q12 = 16'd7000; s_ring = 5'd14; s_damp = 5'd8; st1 = 5'd8; st2 = 5'd31; end
            8'd220: begin amp_q16 = 17'd3800; k_q12 = 16'd10000; s_ring = 5'd13; s_damp = 5'd7; st1 = 5'd7; st2 = 5'd31; end
            8'd221: begin amp_q16 = 17'd600; k_q12 = 16'd12000; s_ring = 5'd12; s_damp = 5'd6; st1 = 5'd7; st2 = 5'd8; end
            8'd224: begin amp_q16 = 17'd27000; k_q12 = 16'd0; s_ring = 5'd17; s_damp = 5'd11; st1 = 5'd14; st2 = 5'd16; end
            8'd225: begin amp_q16 = 17'd3500; k_q12 = 16'd2000; s_ring = 5'd16; s_damp = 5'd10; st1 = 5'd11; st2 = 5'd13; end
            8'd226: begin amp_q16 = 17'd7000; k_q12 = 16'd5000; s_ring = 5'd15; s_damp = 5'd9; st1 = 5'd9; st2 = 5'd14; end
            8'd227: begin amp_q16 = 17'd1200; k_q12 = 16'd7000; s_ring = 5'd14; s_damp = 5'd8; st1 = 5'd8; st2 = 5'd10; end
            8'd228: begin amp_q16 = 17'd2000; k_q12 = 16'd10000; s_ring = 5'd13; s_damp = 5'd7; st1 = 5'd7; st2 = 5'd9; end
            8'd229: begin amp_q16 = 17'd200; k_q12 = 16'd12000; s_ring = 5'd12; s_damp = 5'd6; st1 = 5'd6; st2 = 5'd11; end
            default: begin
                amp_q16 = 17'd0; k_q12 = 16'd0;
                s_ring = 5'd18; s_damp = 5'd13; st1 = 5'd31; st2 = 5'd31;
            end
        endcase
    end

endmodule

// -----------------------------------------------------------------------------
//  piano_inst_lut —— 乐器级参数（2026-10-06 多乐器）
//    ham_gain_q16 : 激励（琴槌/拨片/指甲）的初始能量。钢琴 = 原来的 HAM_GAIN_Q16 = 19661
//    ksh_ofs      : 包络更新速率的乐器偏移（2 bit 编码：0→−1, 1→0, 2→+1）
//                   ⇒ 古筝 +1（木共鸣箱衰减更长）、吉他 −1（本体短，延音靠音箱）
//  ⚠️ 钢琴行必须与原值逐位相同（回归要求）
// -----------------------------------------------------------------------------
module piano_inst_lut (
    input  wire [1:0]  inst,
    output reg  [16:0] ham_gain_q16,
    output reg  [1:0]  ksh_ofs_enc
);

    always @(*) begin
        case (inst)
            2'd0: begin ham_gain_q16 = 17'd19661; ksh_ofs_enc = 2'd1; end // piano
            2'd1: begin ham_gain_q16 = 17'd24000; ksh_ofs_enc = 2'd0; end // guitar
            2'd2: begin ham_gain_q16 = 17'd12000; ksh_ofs_enc = 2'd1; end // violin
            2'd3: begin ham_gain_q16 = 17'd14000; ksh_ofs_enc = 2'd2; end // erhu
            default: begin ham_gain_q16 = 17'd19661; ksh_ofs_enc = 2'd1; end
        endcase
    end

endmodule

// -----------------------------------------------------------------------------
//  piano_vib_lut —— 颤音速率（拓展② 表情维度）
//    rate 0..127 → LFO 频率 f_lfo = rate × 0.1 Hz（0 → 0，50 → 5.0 Hz，127 → 12.7 Hz）
//    输出 inc = round(f_lfo × 2^32 / fs)，直接当 32 bit 相位累加增量用
//    调制度公式见 piano_engine.v 文件头（depth → ±49.6 cent 线性）
// -----------------------------------------------------------------------------
module piano_vib_lut (
    input  wire [6:0]  rate,
    output reg  [31:0] inc
);

    always @(*) begin
        case (rate)
            7'd0: inc = 32'd0;   // f_lfo = 0.0 Hz
            7'd1: inc = 32'd4398;   // f_lfo = 0.1 Hz
            7'd2: inc = 32'd8796;   // f_lfo = 0.2 Hz
            7'd3: inc = 32'd13194;   // f_lfo = 0.3 Hz
            7'd4: inc = 32'd17592;   // f_lfo = 0.4 Hz
            7'd5: inc = 32'd21990;   // f_lfo = 0.5 Hz
            7'd6: inc = 32'd26388;   // f_lfo = 0.6 Hz
            7'd7: inc = 32'd30786;   // f_lfo = 0.7 Hz
            7'd8: inc = 32'd35184;   // f_lfo = 0.8 Hz
            7'd9: inc = 32'd39582;   // f_lfo = 0.9 Hz
            7'd10: inc = 32'd43980;   // f_lfo = 1.0 Hz
            7'd11: inc = 32'd48379;   // f_lfo = 1.1 Hz
            7'd12: inc = 32'd52777;   // f_lfo = 1.2 Hz
            7'd13: inc = 32'd57175;   // f_lfo = 1.3 Hz
            7'd14: inc = 32'd61573;   // f_lfo = 1.4 Hz
            7'd15: inc = 32'd65971;   // f_lfo = 1.5 Hz
            7'd16: inc = 32'd70369;   // f_lfo = 1.6 Hz
            7'd17: inc = 32'd74767;   // f_lfo = 1.7 Hz
            7'd18: inc = 32'd79165;   // f_lfo = 1.8 Hz
            7'd19: inc = 32'd83563;   // f_lfo = 1.9 Hz
            7'd20: inc = 32'd87961;   // f_lfo = 2.0 Hz
            7'd21: inc = 32'd92359;   // f_lfo = 2.1 Hz
            7'd22: inc = 32'd96757;   // f_lfo = 2.2 Hz
            7'd23: inc = 32'd101155;   // f_lfo = 2.3 Hz
            7'd24: inc = 32'd105553;   // f_lfo = 2.4 Hz
            7'd25: inc = 32'd109951;   // f_lfo = 2.5 Hz
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
            7'd99: inc = 32'd435407;   // f_lfo = 9.9 Hz
            7'd100: inc = 32'd439805;   // f_lfo = 10.0 Hz
            7'd101: inc = 32'd444203;   // f_lfo = 10.1 Hz
            7'd102: inc = 32'd448601;   // f_lfo = 10.2 Hz
            7'd103: inc = 32'd452999;   // f_lfo = 10.3 Hz
            7'd104: inc = 32'd457397;   // f_lfo = 10.4 Hz
            7'd105: inc = 32'd461795;   // f_lfo = 10.5 Hz
            7'd106: inc = 32'd466193;   // f_lfo = 10.6 Hz
            7'd107: inc = 32'd470591;   // f_lfo = 10.7 Hz
            7'd108: inc = 32'd474989;   // f_lfo = 10.8 Hz
            7'd109: inc = 32'd479387;   // f_lfo = 10.9 Hz
            7'd110: inc = 32'd483785;   // f_lfo = 11.0 Hz
            7'd111: inc = 32'd488183;   // f_lfo = 11.1 Hz
            7'd112: inc = 32'd492581;   // f_lfo = 11.2 Hz
            7'd113: inc = 32'd496979;   // f_lfo = 11.3 Hz
            7'd114: inc = 32'd501377;   // f_lfo = 11.4 Hz
            7'd115: inc = 32'd505775;   // f_lfo = 11.5 Hz
            7'd116: inc = 32'd510173;   // f_lfo = 11.6 Hz
            7'd117: inc = 32'd514571;   // f_lfo = 11.7 Hz
            7'd118: inc = 32'd518969;   // f_lfo = 11.8 Hz
            7'd119: inc = 32'd523368;   // f_lfo = 11.9 Hz
            7'd120: inc = 32'd527766;   // f_lfo = 12.0 Hz
            7'd121: inc = 32'd532164;   // f_lfo = 12.1 Hz
            7'd122: inc = 32'd536562;   // f_lfo = 12.2 Hz
            7'd123: inc = 32'd540960;   // f_lfo = 12.3 Hz
            7'd124: inc = 32'd545358;   // f_lfo = 12.4 Hz
            7'd125: inc = 32'd549756;   // f_lfo = 12.5 Hz
            7'd126: inc = 32'd554154;   // f_lfo = 12.6 Hz
            7'd127: inc = 32'd558552;   // f_lfo = 12.7 Hz
            default: inc = 32'd0;
        endcase
    end

endmodule

// -----------------------------------------------------------------------------
//  piano_glide_lut —— 滑音时长（拓展② 表情维度）
//    t 0..127 → 时长 t_glide = t × 4 ms（127 → 508 ms，0 → 立即跳变）
//    输出 r = round(2^24 / N)，N = 该时长的采样点数（16 bit，误差 ≤ 0.15%）
//    RTL: step = (delta × r) >> 24 ⇒ 每采样点线性推进（一次 17×16 乘法，无除法器）
//    ⚠️ 用 Q24 而不是 Q32：N<2^16 ⇒ 2^24/N 天然只有 16 bit，乘法小一个数量级；
//      用 Q32 会变成 33×33 乘法，单周期收敛不了（MODE=1 时序违例元凶之一）。
// -----------------------------------------------------------------------------
module piano_glide_lut (
    input  wire [6:0]  t,
    output reg  [15:0] recip
);

    always @(*) begin
        case (t)
            7'd0: recip = 16'd65535;  // N = 1 采样 = 0.0 ms
            7'd1: recip = 16'd42908;  // N = 391 采样 = 4.0 ms
            7'd2: recip = 16'd21482;  // N = 781 采样 = 8.0 ms
            7'd3: recip = 16'd14315;  // N = 1172 采样 = 12.0 ms
            7'd4: recip = 16'd10741;  // N = 1562 采样 = 16.0 ms
            7'd5: recip = 16'd8590;  // N = 1953 采样 = 20.0 ms
            7'd6: recip = 16'd7158;  // N = 2344 采样 = 24.0 ms
            7'd7: recip = 16'd6137;  // N = 2734 采样 = 28.0 ms
            7'd8: recip = 16'd5369;  // N = 3125 采样 = 32.0 ms
            7'd9: recip = 16'd4772;  // N = 3516 采样 = 36.0 ms
            7'd10: recip = 16'd4295;  // N = 3906 采样 = 40.0 ms
            7'd11: recip = 16'd3904;  // N = 4297 采样 = 44.0 ms
            7'd12: recip = 16'd3579;  // N = 4688 采样 = 48.0 ms
            7'd13: recip = 16'd3304;  // N = 5078 采样 = 52.0 ms
            7'd14: recip = 16'd3068;  // N = 5469 采样 = 56.0 ms
            7'd15: recip = 16'd2863;  // N = 5859 采样 = 60.0 ms
            7'd16: recip = 16'd2684;  // N = 6250 采样 = 64.0 ms
            7'd17: recip = 16'd2526;  // N = 6641 采样 = 68.0 ms
            7'd18: recip = 16'd2386;  // N = 7031 采样 = 72.0 ms
            7'd19: recip = 16'd2260;  // N = 7422 采样 = 76.0 ms
            7'd20: recip = 16'd2148;  // N = 7812 采样 = 80.0 ms
            7'd21: recip = 16'd2045;  // N = 8203 采样 = 84.0 ms
            7'd22: recip = 16'd1952;  // N = 8594 采样 = 88.0 ms
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
            7'd125: recip = 16'd344;  // N = 48828 采样 = 500.0 ms
            7'd126: recip = 16'd341;  // N = 49219 采样 = 504.0 ms
            7'd127: recip = 16'd338;  // N = 49609 采样 = 508.0 ms
            default: recip = 16'd0;
        endcase
    end

endmodule

`default_nettype wire
