wongben2333-crypto/26Embedded/rtl/synth/wave_rom.v

// =============================================================================
//  wave_rom.v —— 多音色波表（4 张表共用一份 ROM）
//
//  ⚠️ 本文件由 tools/gen/gen_wave_rom.py 生成，请勿手工编辑。
//
//  地址格式：{{table, phase[7:0]}}，即 addr[9:8] = 表号，addr[7:0] = 相位
//  这是参考实现 vdalex/tangmega-138k-fpga-projects 的做法：
//  多张表共用一份 ROM，只用一个地址多路选择器切换音色。
//
//  表内容：
//    table 0 : sine     纯正弦 — 低音 / 测试模式必备
//    table 1 : saw5     5 次谐波带限锯齿 — 明亮
//    table 2 : square9  奇次 9 次谐波方波 — 中空
//    table 3 : tri9     奇次 9 次谐波三角波 — 柔和
//
//  ★ 为什么必须带限（band-limited）：
//    不做带限的锯齿/方波含无限谐波，在高音区会严重混叠。
//    听感是"金属味杂音"，频谱上还会长出本项目测试模式不希望的谱峰。
//    各表的谐波数已按"5 次以内"取（参考实现同为 5），
//    保证常用音域内最高谐波不超过奈奎斯特频率。
//
//  ★ 测试模式必须用 table 0（纯正弦）：
//    测试模式的判据是"每路一个独立谱峰"。若用含谐波的表，
//    每一路会产出多个谱峰，判据会误判为杂散。
//
//  数据格式：16 bit 有符号，量程约 ±32767
// =============================================================================
`default_nettype none

module wave_rom (
    input  wire                clk,
    input  wire [9:0]   addr,      // {{table, phase[7:0]}}
    output reg  signed [15:0]  data
);

    // ⚠️ 用 case 常量而不是 $readmemh：
    //   参考实现记录过"Gowin 对某些大 case ROM 会跳过初始化导致 ROM 全空"，
    //   但那是上千项的 case；本 ROM 共 1024 项，用 case 更可控且不依赖
    //   外部 .vh 文件，交付更简单。若将来表变大，改用
    //   `(* ram_style = "block" *) reg [15:0] rom [0:N-1]; initial $readmemh(...)`。
    always @(posedge clk) begin
        case (addr)
            // ---- table 0 : sine ----
            10'd0: data <= 16'sd0;
            10'd1: data <= 16'sd804;
            10'd2: data <= 16'sd1608;
            10'd3: data <= 16'sd2410;
            10'd4: data <= 16'sd3212;
            10'd5: data <= 16'sd4011;
            10'd6: data <= 16'sd4808;
            10'd7: data <= 16'sd5602;
            10'd8: data <= 16'sd6393;
            10'd9: data <= 16'sd7179;
            10'd10: data <= 16'sd7962;
            10'd11: data <= 16'sd8739;
            10'd12: data <= 16'sd9512;
            10'd13: data <= 16'sd10278;
            10'd14: data <= 16'sd11039;
            10'd15: data <= 16'sd11793;
            10'd16: data <= 16'sd12539;
            10'd17: data <= 16'sd13279;
            10'd18: data <= 16'sd14010;
            10'd19: data <= 16'sd14732;
            10'd20: data <= 16'sd15446;
            10'd21: data <= 16'sd16151;
            10'd22: data <= 16'sd16846;
            10'd23: data <= 16'sd17530;
            10'd24: data <= 16'sd18204;
            10'd25: data <= 16'sd18868;
            10'd26: data <= 16'sd19519;
            10'd27: data <= 16'sd20159;
            10'd28: data <= 16'sd20787;
            10'd29: data <= 16'sd21403;
            10'd30: data <= 16'sd22005;
            10'd31: data <= 16'sd22594;
            10'd32: data <= 16'sd23170;
            10'd33: data <= 16'sd23731;
            10'd34: data <= 16'sd24279;
            10'd35: data <= 16'sd24811;
            10'd36: data <= 16'sd25329;
            10'd37: data <= 16'sd25832;
            10'd38: data <= 16'sd26319;
            10'd39: data <= 16'sd26790;
            10'd40: data <= 16'sd27245;
            10'd41: data <= 16'sd27683;
            10'd42: data <= 16'sd28105;
            10'd43: data <= 16'sd28510;
            10'd44: data <= 16'sd28898;
            10'd45: data <= 16'sd29268;
            10'd46: data <= 16'sd29621;
            10'd47: data <= 16'sd29956;
            10'd48: data <= 16'sd30273;
            10'd49: data <= 16'sd30571;
            10'd50: data <= 16'sd30852;
            10'd51: data <= 16'sd31113;
            10'd52: data <= 16'sd31356;
            10'd53: data <= 16'sd31580;
            10'd54: data <= 16'sd31785;
            10'd55: data <= 16'sd31971;
            10'd56: data <= 16'sd32137;
            10'd57: data <= 16'sd32285;
            10'd58: data <= 16'sd32412;
            10'd59: data <= 16'sd32521;
            10'd60: data <= 16'sd32609;
            10'd61: data <= 16'sd32678;
            10'd62: data <= 16'sd32728;
            10'd63: data <= 16'sd32757;
            10'd64: data <= 16'sd32767;
            10'd65: data <= 16'sd32757;
            10'd66: data <= 16'sd32728;
            10'd67: data <= 16'sd32678;
            10'd68: data <= 16'sd32609;
            10'd69: data <= 16'sd32521;
            10'd70: data <= 16'sd32412;
            10'd71: data <= 16'sd32285;
            10'd72: data <= 16'sd32137;
            10'd73: data <= 16'sd31971;
            10'd74: data <= 16'sd31785;
            10'd75: data <= 16'sd31580;
            10'd76: data <= 16'sd31356;
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
            10'd1020: data <= -16'sd4750;
            10'd1021: data <= -16'sd3597;
            10'd1022: data <= -16'sd2415;
            10'd1023: data <= -16'sd1212;
            default: data <= 16'sd0;
        endcase
    end

endmodule

`default_nettype wire
