wongben2333-crypto/26Embedded/fpga_hank/rtl/synth/piano_engine.v

// =============================================================================
//  piano_engine.v —— 纯硬件钢琴音色引擎（8 声部 × 6 个独立泛音加法分量）
//
//  赛题：2026 高云杯 FPGA 创新设计赛道 · 选题二「实时多音色合成电子乐器引擎」
//        用户要求「要模仿钢琴的音调、音色」。
//
//  ===========================================================================
//  ★ 为什么用「加法合成 + 每泛音独立包络」，而不是查一张钢琴波表
//
//  查一张单周期波表只能得到固定的谐波比例，而且【不可能有非谐性】：
//  周期波形按定义所有分量都是基频的整数倍。真实钢琴最关键的两个特征
//  恰恰不在整数倍上：
//     · 高次泛音比整数倍略高（钢弦刚度 → inharmonicity，"温暖感"来源之一）
//     · 各泛音衰减速度不同（高次先死）；力度越大高次越强（"变亮"）
//  所以本引擎给每个泛音【独立相位累加器 + 独立频率 + 独立包络】——
//  这同时就是赛题【振荡器统计规则】里"一个完整振荡器"的三要素。
//  8 声部 × 6 泛音 = 48 个可独立计数的加法分量（单音即可满足拓展①的"≥32 路"）。
//
//  ---------------------------------------------------------------------------
//  ★ 技术依据（全部来自公开实现，不是拍脑袋）
//
//  1) AMY 的加法钢琴  https://github.com/shorepine/amy
//     说明页 https://shorepine.github.io/amy/piano.html
//     · 每个泛音一个独立振荡器、各自一条包络 —— 本引擎同构
//     · 高次泛音衰减更快；音越高衰减越快
//     · 力度→变亮：实测基频 +25 dB、第 20 次泛音 +45 dB
//       ⇒ 本引擎把 ≈20 dB 的"相对提亮"做成每个泛音自己的 K[n] 系数
//     · 非谐性 f_n = n·f0·sqrt(1+B·n²)，中音区 B≈0.0004
//     · 起音处还有一段宽带 "clunk"（琴槌噪声）—— AMY 没保留，本引擎补上
//
//  2) Faust STK 击弦钢琴  faust/examples/physicalModeling/faust-stk/piano1.dsp
//     · detuningHz 表：同音多弦失谐拍频只有 0.003 Hz(低音) → 0.25 Hz(中音)
//       → 1.0 Hz(高音)。⚠️ 是"零点几 Hz 的拍频"，不是固定 0.1% 频率偏移
//     · 琴槌 = 白噪声过 4 级一阶低通，系数随力度变（力度大→更亮）
//     · releaseLoopGain 0.865..0.997：松键后阻音器让声音快速消失
//
//  3) 同队参考 26Embedded/fpga_spark/.../piano_voice.v
//     · 双弦失谐 + 1:0.5:0.25 谐波权重 + 三级包络的思路可学
//     · ⛔ 但它把采样率写死 48 kHz（我们是 97656.25 Hz），且用 $readmemh 读
//       外部 .hex（文件缺失 ⇒ ROM 全 0、完全静音、极难排查）。
//       本引擎全部改成按真实 fs 生成的 case 常量表，且所有乘法/状态更新都
//       在 sample_tick 门控内（参考实现漏了门控，每 20 ns 白算一次）。
//
//  ---------------------------------------------------------------------------
//  ★ 数据通路（逐样本、逐声部并行；每采样点 512 clk 预算，实际只用 ~14 拍装载）
//
//    note-on ─► 声部分配（同音重击 > 空闲 > 已松开 > 轮转抢占）
//                 │
//                 └─► 装载 FSM（2 拍/泛音，共 14 拍）算 6 个泛音的
//                       inc[n] = n·f0 + (f0>>st1) + (f0>>st2)      ← 非谐性拉伸
//                       env[n] = amp[n]·vel_gain·(1 + K[n]·vel/4096) ← 力度变亮
//
//    每声部 6 条并行链（n = 0..5）：
//        ph[n] (32 bit) ──► piano_sin_rom（1/4 波表 + 象限折叠）──┐
//        env[n] (32 bit Q32，增益 = env[31:16]) ─────────────────►× ─► prod[n]
//                                                                 │
//        6 路相加 ─► × 齐奏拍频系数（1 个 LFO）─► + 琴槌噪声 ─► vout
//                                                                 │
//    8 个 vout 相加 ─► 预缩放 ─► 软膝限幅 ─► mix_out (16 bit)
//
//  ★ 包络形状 =「快起音 + 长衰减，没有 sustain 平台」
//    钢琴按住键也在衰减（阻尼器只在松键时落下）：
//      按住：env -= env >> s_ring[n]，时间常数 τ = 2^(s_ring+k)/fs
//      松开：env -= env >> s_damp[n]，≈ τ/32，模拟阻音器
//      k = clamp((90-note)>>4, 0, 3)：音越高衰减越快
//      ⇒ A4 基频 τ≈5.4 s、高音 C6 τ≈2.7 s、低音 C2 τ≈21 s
//    ⚠️ 包络必须是 32 bit（Q32）而不是 17 bit：用 "env -= env>>s" 做指数衰减时
//      可表示的尾部动态范围只有 W-s bit。若 W=17、s=15（想要 τ≈5 s），
//      衰减会在 env=2^15（仅 -12 dB）处【卡住不动】——听感是"音一直不停"。
//      32 bit 时尾部动态范围 > 72 dB，衰减能真正走到听不见才归零。
//    ⚠️ 音高相关的衰减不用"变移位器"（48 路变移位器 ≈ 6000 LUT），
//      而是用【每 2^k 个采样点更新一次】实现：移位量仍是常数（纯布线），
//      代价只是每声部一个 10 bit 掩码比较。
//
//  ★ 齐奏失谐（detuned unison）：真实钢琴一个音有 1~3 根弦微失调。
//    两根等幅弦 sin(f)+sin(f+δ) 的严格恒等式是 sin(f)·2cos(πδt)，
//    三根弦 ⇒ 幅度按 (2+cos)/3 起伏（拍频取自 Faust 的 detuningHz 表）。
//    ⚠️ 本实现把整个声部乘同一个拍频系数 ⇒ 对【基频】严格成立，
//      对高次泛音是近似（真实弦是 n·δ 的拍频）。这是为省 48 个累加器做的取舍。
//    ⚠️ 取 (2+cos)/4 而不是 /3：只是整体电平换一个常数（已在幅度系数里补偿），
//      但把除法变成 >>2 —— 纯移位，不需要除法器。
//      又因为真实三弦幅度并不相等，所以拍频取不到"全深零点"（1/3..1 ⇒ 这里
//      0.25..0.75），听感是温润的慢起伏，而不是忽大忽小的颤音。
//
//  ★ 琴槌瞬态：每声部一个 32 bit LFSR 噪声 → 一阶低通（档位随力度）
//    → 快速衰减包络（τ≈10.5 ms）。宽带"咔"声正是钢琴起音的特征。
//
//  ===========================================================================
//  ★ 表情（赛题拓展②）：力度 / 颤音 / 滑音 / 延音踏板
//
//  力度已经有（vel30→vel120 高次泛音 +6.34 dB）。另外三维的**精确映射公式**：
//
//  ① 颤音 Vibrato（vib_on / vib_depth=CC77 或 CC1 / vib_rate=CC76）
//       LFO 频率     f_lfo  = vib_rate × 0.1 Hz        （0→0，50→5.0 Hz，127→12.7 Hz）
//       调制度       f_inst = f_note × (1 + sin(2π f_lfo t) × depth_k/65536)
//       深度         depth_k = vib_depth × 15  (Q16 分数)
//                    ⇒ vib_depth 0..127 → ±0 .. ±2.907 % → ±0 .. ±49.6 cent（线性）
//       实现         逐采样点改【基频字】，再用同一套非谐性拉伸重算 6 个泛音增量
//                    ⇒ 所有泛音按同一比例平移，音程关系不变（这是"颤音"不是"走音"）
//       ⚠️ vib_on=0 或 vib_depth=0 ⇒ 完全不调制（相位通路切回原 inc[]，无残余抖动）
//
//  ② 滑音 Glide / Portamento（glide_on=CC65≥64 / glide_time=CC5）
//       时长         t_glide = glide_time × 4 ms       （0→立即跳变，127→508 ms）
//       步进         step = (f_target − f_current) / N，N = round(t_glide × fs)
//                    RTL 里用 recip = round(2^32/N) 查表 ⇒ step = (delta × recip) >> 32
//       ramp         每采样点 f0_cur += step，到位锁死；插值在【相位增量】一侧，
//                    频率连续变化，不会爆音
//       分配         开了滑音后，新音符一律交给"最近用过的声部"
//                    ⇒ 经典单音 portamento；此时不再叠加复音（已在报告写明）
//       ⚠️ 滑音续接时【不】把相位归零（否则滑音起点会"咔"一声）
//       ⚠️ glide_on=0 或 glide_time=0 ⇒ 立即跳变（与加表情前一致）
//
//  ③ 延音踏板 Sustain（CC64）
//       sustain=1 时收到 note-off：只置"待释放"标记，**不落阻尼器**（声部继续响）
//       sustain 由 1→0：把所有"待释放"的声部一次性释放
//       ⚠️ sustain=0 时行为与加踏板之前完全一致
//
//  ★★ 回归保证（加表情不许改变原有声音）★★
//     6 个新输入全 0 时：vib_act=0、gliding=0 ⇒ 相位增量走【原来的 inc[] 通路】
//     （`inc_use = pmod_act ? inc_vib : inc`），note-off 走原来的 gate_r<=0。
//     即：不是"应该一样"，而是**结构上就是同一条通路**。
//     已用"改前/改后同一激励序列逐样本比对"验证（见 sim/tb/tb_piano_engine.v 与
//     _research/piano/evidence/ref_before/）。
//
//  ===========================================================================
//  接口契约（与 song_player / midi_rx 共用同一套语义，签名不可改）
//    on_valid/on_note/on_vel  : note-on 单拍脉冲；⚠️ vel=0 按 MIDI 惯例当 note-off
//    off_valid/off_note       : note-off 单拍脉冲
//    mix_out                  : 16 bit 有符号混音（与 32 路振荡器组相加前）
//    active[N_VOICES-1:0]     : 每个声部是否在发声（LED）
//    表情输入（新增，全默认 0 时行为与之前逐样本一致）
//      glide_on / glide_time[6:0] / vib_on / vib_depth[6:0] / vib_rate[6:0] / sustain
//
//  ⚠️ 采样率：fs = CLK_HZ/512 = 97656.25 Hz（top.v 的 BCK_DIV=1）。
//     所有频率字 / 包络速率 / 拍频都由 tools/gen/gen_piano_rom.py 按该 fs 生成。
//     CLK_HZ 参数仅用于说明；改采样率必须重跑生成脚本。
//  ⚠️ N_VOICES 取 1..16（声部分配用 4 bit 选择器）。
//  ⚠️ 装载期间（14 拍 ≈ 0.28 µs）忽略新的 note-on：人手/串口不可能这么快，
//     这样就不需要"半个包络"的中间态，逻辑最简单也最不会出错。
// =============================================================================
`default_nettype none

module piano_engine #(
    parameter integer N_VOICES  = 8,          // 复音数（1..16）
    parameter integer CLK_HZ    = 50_000_000, // 说明用；频率字按 fs=97656.25 Hz 生成
    parameter integer OUT_SHIFT     = 1,          // 输出预缩放右移（0 更响、和弦更易触限幅）
    parameter integer USE_TDM_VOICE = 1           // 1=声部内6泛音+2LFO时分复用单ROM+单DSP（省56 BSRAM+40 DSP），0=原并行
)(
    input  wire        clk,
    input  wire        rst_n,
    input  wire        sample_tick,   // 音频采样节拍（97 656.25 Hz），别的模块提供

    // ---- 音符命令总线 ----
    input  wire        on_valid,      // note-on 脉冲（1 个 clk）
    input  wire [6:0]  on_note,       // MIDI 音符号 0..127（69 = A4 = 440 Hz）
    input  wire [6:0]  on_vel,        // 力度 0..127
    input  wire        off_valid,     // note-off 脉冲
    input  wire [6:0]  off_note,

    // ---- 表情输入（赛题拓展②：力度已有；这里补颤音/滑音/延音踏板）----
    //  ⚠️ 6 个新输入全为默认（0）时，输出必须与加表情之前【逐样本一致】。
    //     实现上是结构性保证：vib_act/gliding 都为 0 时，相位增量走的是原来的
    //     inc[] 寄存器通路（见 piano_voice 里的 inc_use 选择），没有任何舍入差异。
    input  wire        glide_on,      // CC65 ≥64：开启滑音
    input  wire [6:0]  glide_time,    // CC5  0..127 → t ≈ v×4 ms
    input  wire        vib_on,        // 深度>0 即开
    input  wire [6:0]  vib_depth,     // CC77 或 CC1
    input  wire [6:0]  vib_rate,      // CC76 0..127 → f ≈ v×0.1 Hz
    input  wire        sustain,       // CC64 ≥64：延音踏板
    input  wire [1:0]  inst_sel,      // ★ 多乐器（2026-10-06）：0=钢琴 1=电吉他 2=古筝
    input  wire [6:0]  bow_speed,     // ★ CC21 弓速 0..127（二胡用；0 ⇒ 固定中速兜底 64）
                                      //   全局切换（8 声部同一乐器）；只影响【新的音符】——
                                      //   系数在 note-on 装载期被采样，正在发声的音符保持原音色。
                                      //   ⚠️ 未接时（z/x）会落到 default 分支 = 钢琴，
                                      //      但仿真里 z 会传播 ⇒ TB 与 top.v 都必须显式接 2'd0。

    // ---- 输出 ----
    output reg  signed [15:0]  mix_out,   // 混音输出（与 32 路振荡器组相加前）
    output wire [N_VOICES-1:0] active     // 每个声部是否在发声（给 LED 用）
);

    // ---------------------------------------------------------------- 常量 ----
    localparam integer N_PART  = 6;      // 每声部泛音分量数
    localparam integer PHASE_W = 32;     // 相位累加器位宽
    localparam integer ENV_W   = 32;     // 包络位宽（Q32；增益 = env[31:16]）
    // ⚠️ SEL_W 只在 N_VOICES>16（如 20/32）时才加宽到 5 bit
    //    ⇒ N<=16（含默认 8）时【位宽与逻辑完全不变】，不动已验证的通路
    localparam integer SEL_W   = (N_VOICES > 16) ? 5 : 4;
    localparam integer DIV_W   = 10;     // 包络降速计数器位宽

    // 琴槌：最大增益 0.30(Q16)，包络衰减移位 10 ⇒ τ = 2^10/fs ≈ 10.5 ms
    localparam [16:0]  HAM_GAIN_Q16 = 17'd19661;
    localparam integer HAM_SH       = 10;

    // 输出软膝限幅拐点：|x| > KNEE 后按 1/4 斜率压缩，避免和弦硬削顶（刺耳）
    localparam signed [27:0] KNEE = 28'sd24576;

    // ------------------------------------------------------- 音符/力度查表 ----
    // 组合逻辑，只在 note-on 那一拍被采样（因此没有额外时序代价）
    wire [31:0] f0_bus;
    wire [31:0] beat_bus;
    wire [16:0] vel_gain_bus;
    wire [2:0]  vel_lp_bus;

    // ------------------------------------------------------- 多乐器（2026-10-06）----
    //  乐器级参数：激励增益 + 衰减档位偏移。**全局**（8 声部同乐器）。
    //  ⚠️ 这两个值只在【装载期】被采样 ⇒ 切换乐器只影响新音符（批准的语义）。
    wire [16:0] inst_ham_gain;
    wire [1:0]  inst_ksh_enc;
    // ★ 乐器下标映射（2026-10-06，Lead 批准的最小改法）
    //   语义：0=钢琴、1=电吉他、**2 或 3 = 第三个乐器槽**（原古筝，已由二胡替换）。
    //   ⚠️ 为什么 2 和 3 都映射到 2：
    //     ① GUI 发的是 **CC20=3**（v44-erhu-swap）⇒ 必须接受 3，否则 F3【切到二胡听到钢琴】✗
    //     ② ROM 仍是 3 行（0/1/2），**不必加行**；旧测试用 2、GUI 用 3 都能工作 ⇒ 兼容
    //     ③ 这样【没有任何合法 inst_sel 会落到"意外分支"】（0/1/2/3 全覆盖）
    //   ⚠️ 下标而不是端口语义：`inst_ok` 只用于三个查表实例，改这一处即可。
    wire [1:0]  inst_ok_c = (inst_sel == 2'd1) ? 2'd1 :
                            ((inst_sel == 2'd2) || (inst_sel == 2'd3)) ? 2'd2 : 2'd0;
    // [OPT-2A] Register inst_ok inside piano_engine to break top-level inst_sel_eff_r -> u_ld_lut critical path (+0.061 ns)
    reg  [1:0]  inst_ok;
    always @(posedge clk) begin
        if (!rst_n) inst_ok <= 2'd0;
        else        inst_ok <= inst_ok_c;
    end

    piano_inst_lut u_inst_lut (
        .inst         (inst_ok),
        .ham_gain_q16 (inst_ham_gain),
        .ksh_ofs_enc  (inst_ksh_enc)
    );

    piano_note_lut u_note_lut (
        .note      (on_note),
        .f0_step   (f0_bus),
        .beat_step (beat_bus)
    );

    piano_vel_lut u_vel_lut (
        .vel      (on_vel),
        .inst     (inst_ok),          // ★ 多乐器：拨片/指甲比毛毡琴槌亮 ⇒ lp_sh 更小
        .gain_q16 (vel_gain_bus),
        .lp_sh    (vel_lp_bus)
    );

    // ------------------------------------------------- 表情参数（拓展②）----
    // 颤音速率：f_lfo = vib_rate × 0.1 Hz（0 → 0，50 → 5.0 Hz，127 → 12.7 Hz）
    //           vib_inc = round(f_lfo × 2^32 / fs)，查表（生成脚本算好）
    // 颤音深度：depth_k = vib_depth × 15 (Q16 分数)
    //           f_inst = f_note × (1 + sin(2π f_lfo t) × depth_k / 65536)
    //           ⇒ depth 0..127 → ±0 .. ±2.907 % → ±0 .. ±49.6 cent（线性）
    // 滑音时长：t_glide = glide_time × 4 ms（0 → 立即跳变，127 → 508 ms）
    //           N = round(t_glide × fs)，recip = round(2^32 / N)
    //           step = ((f_target − f_current) × recip) >> 32，逐采样点线性推进
    wire [31:0] vib_inc_bus;
    // ⚠️ 位宽必须与 LUT 端口一致（16 bit）：原来写 32 bit，高 16 位【无驱动】
    //    vopt 会报 "Connection width does not match width of port 'recip'"，
    //    实测探针里该总线读到 Z。虽然 g_r_r 只取低 16 位、功能没错，
    //    但无驱动总线是隐患（X 传播/工具优化都可能咬人）⇒ 按端口宽度声明。
    wire [15:0] glide_recip_bus;

    piano_vib_lut u_vib_lut (
        .rate (vib_rate),
        .inc  (vib_inc_bus)
    );

    piano_glide_lut u_glide_lut (
        .t     (glide_time),
        .recip (glide_recip_bus)
    );

    wire [11:0] vib_depth_k = {5'd0, vib_depth} * 6'd15;   // ≤1905
    wire        vib_act     = vib_on & (vib_depth != 7'd0);
    wire        glide_act   = glide_on & (glide_time != 7'd0);

    // 延音踏板：抬起(pedal up)脉冲 —— 把"待释放"的声部一次性放掉
    reg sus_d;
    always @(posedge clk) begin
        if (!rst_n) sus_d <= 1'b0;
        else        sus_d <= sustain;
    end
    wire sus_fall = sus_d & ~sustain;

    // --------------------------------------------------- 声部状态（回读） ----
    wire [N_VOICES-1:0]     v_active;
    wire [N_VOICES-1:0]     v_gate;
    wire [7*N_VOICES-1:0]   v_note_flat;
    wire signed [24:0]      v_out [0:N_VOICES-1];

    // ------------------------------------------------------- 声部分配 --------
    // 优先级（贴近真实钢琴行为）：
    //   ⓪ 滑音模式：新音符一律给"最近用过的声部"（经典单音 portamento）
    //   ① 同音且仍按住 → 重击同一根弦（不抢别的声部）
    //   ② 空闲声部    → 从轮转指针开始扫，天然均衡磨损
    //   ③ 已松开声部  → 抢（正处在阻音器阶段，听感损失最小）
    //   ④ 任意声部    → 轮转抢占（最坏情况）
    //
    // ★★ 为什么改掉原来"4 个串行 for 循环"的写法 ★★
    //   MODE=0 的 P&R 时序报告里【最差路径】正是它（**不是表情通路**）：
    //     env(voice3) → act_c → 分配器串行链 → on_pulse_sel[0] → voice0 的 ph CE
    //     数据延迟 19.748 ns / 20 ns 周期（slack 仅 +0.010 ns，逻辑级数 15）
    //   原写法用 `!alloc_hit` 把 4 层 × 8 声部串成一条长链；MODE=1 又多一个
    //   滑音分支、布局更拥挤 ⇒ 这条通向 1536 个 ph-CE 终点的路径就成片违例
    //   （flow-verifier 报的 2382 违例里，很大一部分应是这类终点）。
    //   现在：三层候选掩码【并行】算，每层用树形优先级编码（3 级），
    //   最后按优先级做 3 选 1 ⇒ 链深从 ~24 级降到 ~6 级。
    // ⚠️ 语义必须逐例一致：_research/piano/check_allocator_equiv.py 穷举了
    //    (v_active, v_gate, rr) = 2^24 组合 × 12 组音号匹配 + 200 万随机样本，
    //    与串行版本逐例对照结果**完全相同**（evidence/allocator_equiv.txt）。
    // ⚠️ 树形版本支持 1..8 声部；N_VOICES>8 时自动退回原来的串行写法（见 generate）。
    reg  [SEL_W-1:0] alloc_sel;
    // ★ 一热分配结果（2026-10-06 修 362 违例）：让 `on_pulse_sel` 直接用一热位 AND，
    //   省掉原来 `alloc_sel == gp` 那一级 4 bit 相等比较（实测最差路径终点是 ph/CE,D）。
    //   ⚠️【三个 generate 分支都必须驱动它】——只改本分支会让 N>8 的 alloc_oh 悬空(z) ⇒ 静音。
    reg  [N_VOICES-1:0] alloc_oh;
    reg  [SEL_W-1:0] rr;
    reg  [SEL_W-1:0] last_voice;
    reg              last_valid;

    // 各声部当前基频（滑音起点用）。★ 用【已注册的 ld_sel】做 8 选 1（见下面 g_delta_c）：
    // 原来用组合的 alloc_sel，于是"分配器链 → 32 bit 8 选 1 → 33 bit 减法"全在一拍里；
    // 现在起点变成寄存器，路径短得多，而且 delta 值与原来完全一样（同一路声部）。
    wire [32*N_VOICES-1:0] v_f0_flat;

    // 有效声部掩码 + 音号匹配掩码（并行算）
    wire [7:0] valid_mask = (N_VOICES >= 8) ? 8'hFF
                                            : ((8'd1 << N_VOICES[3:0]) - 8'd1);
    reg  [7:0] note_match_mask;
    integer    nm;
    always @(*) begin
        note_match_mask = 8'd0;
        for (nm = 0; nm < 8; nm = nm + 1)
            if (nm < N_VOICES)
                note_match_mask[nm] = (v_note_flat[nm*7 +: 7] == on_note);
    end

    // 树形"最低置位"编码器：8 bit → SEL_W bit，深度 3 级（不是 8 级串行）
    // ⚠️ 返回值必须与 alloc_sel 同宽（SEL_W）：第一版返回 3 bit 却写成 s1[SEL_W-1:0]，
    //    越界位读成 x ⇒ alloc_sel 变成未知 ⇒ 一个声部都分配不到（全部静音）。
    //    这类"位选越界"在本项目已经栽过两次（uni_calc、ham_prod）。
    function [SEL_W-1:0] low8;
        input [7:0] m;
        reg [SEL_W-1:0] q0, q1, q2, q3, h0, h1;
        reg       a0, a1, a2, a3, b0, b1;
        begin
            a0 = m[0] | m[1];
            a1 = m[2] | m[3];
            a2 = m[4] | m[5];
            a3 = m[6] | m[7];
            q0 = m[0] ? {SEL_W{1'b0}}             : {{(SEL_W-1){1'b0}}, 1'b1};
            // ⚠️ 字面量位宽必须够：写 2'd4 会**溢出回绕成 0**（2 bit 装不下 4！）
            //    实测症状：low8(0x10) 返回 0、low8(0x80) 返回 3 ⇒ 高 4 位的声部全分错。
            q1 = m[2] ? {{(SEL_W-3){1'b0}}, 3'd2} : {{(SEL_W-3){1'b0}}, 3'd3};
            q2 = m[4] ? {{(SEL_W-3){1'b0}}, 3'd4} : {{(SEL_W-3){1'b0}}, 3'd5};
            q3 = m[6] ? {{(SEL_W-3){1'b0}}, 3'd6} : {{(SEL_W-3){1'b0}}, 3'd7};
            b0 = a0 | a1;   h0 = a0 ? q0 : q1;
            b1 = a2 | a3;   h1 = a2 ? q2 : q3;
            low8 = b0 ? h0 : h1;
        end
    endfunction

    // ---- 32 声部用：把上面已证的 low8 拼成 16/32 bit 树（深度 4/5 级）----
    //   ⚠️ 只在 N_VOICES>8 的 generate 分支里被引用；N<=8 时综合视作无用逻辑 ⇒
    //      默认 8 声部通路的位宽/逻辑一字未动。
    //   语义已证明：sim/tb/tb_alloc32_proof.v（结构化 32,000 + 随机 200,000 例，0 不一致）
    function [5:0] low16t;
        input [15:0] m;
        reg [5:0] lo, hi;
        begin
            lo = low8(m[7:0]);
            hi = low8(m[15:8]);
            low16t = (|m[7:0]) ? lo : (hi + 6'd8);
        end
    endfunction
    function [5:0] low32t;
        input [31:0] m;
        reg [5:0] lo, hi;
        begin
            lo = low16t(m[15:0]);
            hi = low16t(m[31:16]);
            low32t = (|m[15:0]) ? lo : (hi + 6'd16);
        end
    endfunction

    generate
    if (N_VOICES <= 8) begin : g_alloc_tree
        wire [7:0] m_same = valid_mask & v_gate & note_match_mask;
        wire [7:0] m_idle = valid_mask & ~v_active;
        wire [7:0] m_rel  = valid_mask & ~v_gate;
        // 轮转顺序 = 「>= rr 的位先扫（位内低位优先），否则扫 < rr 的位」
        wire [7:0] ge = valid_mask & (8'hFF << rr);
        wire [7:0] lt = valid_mask & ~(8'hFF << rr);
        wire [SEL_W-1:0] s1 = low8(m_same);
        wire [SEL_W-1:0] s2 = (|(m_idle & ge)) ? low8(m_idle & ge) : low8(m_idle & lt);
        wire [SEL_W-1:0] s3 = (|(m_rel  & ge)) ? low8(m_rel  & ge) : low8(m_rel  & lt);

        always @(*) begin
            if (glide_on && last_valid)  alloc_sel = last_voice;
            else if (|m_same)            alloc_sel = s1;
            else if (|m_idle)            alloc_sel = s2;
            else if (|m_rel)             alloc_sel = s3;
            else                         alloc_sel = rr;
        end

        // ★ 一热版（与上面的二进制版是【同一函数的两种编码】）：
        //   `m & (~m+1)` 直接取"最低置位"的一热 ⇒ 级数 2 级（减+与）
        //   对比原来 3 级树(low8) + 1 级 4bit 相等比较 ⇒ 省 1~2 级
        wire [7:0] oh1 = m_same & (~m_same + 8'd1);
        wire [7:0] m2w = (|(m_idle & ge)) ? (m_idle & ge) : (m_idle & lt);
        wire [7:0] m3w = (|(m_rel  & ge)) ? (m_rel  & ge) : (m_rel  & lt);
        wire [7:0] oh2 = m2w & (~m2w + 8'd1);
        wire [7:0] oh3 = m3w & (~m3w + 8'd1);
        always @(*) begin
            if (glide_on && last_valid) alloc_oh = (8'd1 << last_voice);
            else if (|m_same)           alloc_oh = oh1;
            else if (|m_idle)           alloc_oh = oh2;
            else if (|m_rel)            alloc_oh = oh3;
            else                        alloc_oh = (8'd1 << rr);
        end
    end else if (N_VOICES <= 32) begin : g_alloc_tree32
        // ★ 32 bit 两级树形分配器（N_VOICES = 17..32）。为什么必须换掉串行链：
        //   MODE=1 裕量只有 +0.009 ns，串行链随 N 增长 ⇒ N=20/32 必然违例。
        //   等价性已证：sim/tb/tb_alloc32_proof.v（结构化 32,000 + 随机 200,000 例，
        //   与"4 层串行优先、rr 旋转顺序"的黄金模型逐例一致，0 不一致，种子 0xc0ffee01）
        wire [31:0] vm       = (N_VOICES >= 32) ? 32'hFFFF_FFFF
                                                : ((32'd1 << N_VOICES[5:0]) - 32'd1);
        wire [31:0] vg32     = {32{1'b0}} | v_gate;     // 零扩展到 32（N=32 时也成立）
        wire [31:0] va32     = {32{1'b0}} | v_active;
        wire [31:0] rr32     = {{(32-SEL_W){1'b0}}, rr};
        reg  [31:0] nm32;
        integer     nm2;
        always @(*) begin
            nm32 = 32'd0;
            for (nm2 = 0; nm2 < N_VOICES; nm2 = nm2 + 1)
                nm32[nm2] = (v_note_flat[nm2*7 +: 7] == on_note);
        end
        wire [31:0] m_same32 = vm & vg32 & nm32;
        wire [31:0] m_idle32 = vm & ~va32;
        wire [31:0] m_rel32  = vm & ~vg32;
        wire [31:0] ge32     = vm & (32'hFFFF_FFFF << rr32);
        wire [31:0] lt32     = vm & ~(32'hFFFF_FFFF << rr32);
        wire [5:0]  s1_32 = low32t(m_same32);
        wire [5:0]  s2_32 = (|(m_idle32 & ge32)) ? low32t(m_idle32 & ge32)
                                                 : low32t(m_idle32 & lt32);
        wire [5:0]  s3_32 = (|(m_rel32  & ge32)) ? low32t(m_rel32  & ge32)
                                                 : low32t(m_rel32  & lt32);

        always @(*) begin
            if (glide_on && last_valid)  alloc_sel = last_voice;
            else if (|m_same32)          alloc_sel = s1_32[SEL_W-1:0];
            else if (|m_idle32)          alloc_sel = s2_32[SEL_W-1:0];
            else if (|m_rel32)           alloc_sel = s3_32[SEL_W-1:0];
            else                         alloc_sel = rr;
            // ⚠️ 本分支（N=17..32）也必须驱动 alloc_oh，否则 on_pulse_sel 全 0 ⇒ 静音
            alloc_oh = {N_VOICES{1'b0}};
            alloc_oh[alloc_sel] = 1'b1;
        end
    end else begin : g_alloc_serial
        // 备用路径：N_VOICES>32 时保持原来的串行语义（本项目不用）
        reg              alloc_hit;
        reg  [SEL_W-1:0] idx;
        integer          sai;
        always @(*) begin
            alloc_sel = rr;
            alloc_hit = 1'b0;
            if (glide_on && last_valid) begin
                alloc_sel = last_voice;
                alloc_hit = 1'b1;
            end
            for (sai = 0; sai < N_VOICES; sai = sai + 1) begin
                if (!alloc_hit && v_gate[sai] &&
                    (v_note_flat[sai*7 +: 7] == on_note)) begin
                    alloc_sel = sai[SEL_W-1:0];
                    alloc_hit = 1'b1;
                end
            end
            for (sai = 0; sai < N_VOICES; sai = sai + 1) begin
                idx = rr + sai[SEL_W-1:0];
                if (idx >= N_VOICES[SEL_W-1:0]) idx = idx - N_VOICES[SEL_W-1:0];
                if (!alloc_hit && !v_active[idx]) begin
                    alloc_sel = idx;
                    alloc_hit = 1'b1;
                end
            end
            for (sai = 0; sai < N_VOICES; sai = sai + 1) begin
                idx = rr + sai[SEL_W-1:0];
                if (idx >= N_VOICES[SEL_W-1:0]) idx = idx - N_VOICES[SEL_W-1:0];
                if (!alloc_hit && !v_gate[idx]) begin
                    alloc_sel = idx;
                    alloc_hit = 1'b1;
                end
            end
            for (sai = 0; sai < N_VOICES; sai = sai + 1) begin
                idx = rr + sai[SEL_W-1:0];
                if (idx >= N_VOICES[SEL_W-1:0]) idx = idx - N_VOICES[SEL_W-1:0];
                if (!alloc_hit) begin
                    alloc_sel = idx;
                    alloc_hit = 1'b1;
                end
            end
            // ⚠️ 本分支（N>32）也必须驱动 alloc_oh，否则 on_pulse_sel 全 0 ⇒ 静音
            alloc_oh = {N_VOICES{1'b0}};
            alloc_oh[alloc_sel] = 1'b1;
        end
    end
    endgenerate

    // ---------------------------------------------------- note-on / note-off -
    // ⚠️ MIDI 惯例：note-on 且 vel=0 等价于 note-off（midi_rx 常见写法）
    wire        vel_zero    = (on_vel == 7'd0);
    wire        off_any     = off_valid | (on_valid & vel_zero);
    wire [6:0]  off_any_note = (on_valid & vel_zero) ? on_note : off_note;
    wire        note_on     = on_valid & ~vel_zero;

    // ------------------------------------------------------- 装载 FSM --------
    localparam [1:0] L_IDLE = 2'd0, L_CALC = 2'd1, L_MUL = 2'd2, L_DONE = 2'd3;

    reg  [1:0]  ld_st;
    reg  [2:0]  ld_idx;
    reg         ld_busy;
    reg         ld_stb;                      // 装载有效脉冲（给被选声部）
    reg  [SEL_W-1:0] ld_sel;
    reg  [31:0] ld_f0;
    reg  [16:0] ld_velgain;
    reg  [6:0]  ld_vel;                      // ★ 力度也要锁存：明亮度系数 = K × vel/128
    reg  [16:0] ld_gq;                       // 中间量：amp × velgain >> 16
    reg  [15:0] ld_kq;
    reg  [16:0] ld_env_bus [0:N_PART-1];
    reg  [31:0] ld_inc_bus [0:N_PART-1];

    // 装载用的参数查表（运行时索引，只有这一份）
    wire [16:0] pl_amp;
    wire [15:0] pl_k;
    wire [4:0]  pl_sr, pl_sd, pl_st1, pl_st2;

    // ---------- 滑音斜率（与装载 FSM **并行**算，不占用任何 FSM 状态）----------
    // 为什么要并行：装载完成时刻 ld_stb 决定了包络在哪个采样点生效。
    // 若为了算滑音斜率往 FSM 里插状态，ld_stb 会整体后移 1~2 拍，
    // 输出就不再与"加表情之前"逐样本一致（回归要求会破）。
    // 所以这里把 delta 在 L_IDLE 那一拍锁存，借 L_CALC / L_MUL 两拍做乘法与移位，
    // 到 L_DONE 时早就准备好了（L_DONE 在 12 拍之后）。
    //
    // ★★ 为什么不用 33×33 的一次大乘法 ★★
    //   step = (delta × recip) >> 32 里 recip 是 32 bit，直接乘就是 33×33 = 66 bit
    //   ⇒ 4~6 个 18×18 乘法器 + 宽加法树，单周期很难收敛（这正是 MODE=1 里
    //   我这条表情通路最长的组合路径）。
    //   两条改进：
    //     ① 查表直接给 Q24 倒数：r = round(2^24 / N)。因为 N < 2^16，
    //        r 天然落在 [338, 42902] ⇒ **只有 16 bit**，精度 ≤ 0.15%；
    //        step = (delta × r) >> 24
    //     ② delta 拆成 17 bit 低半 + 16 bit 高半，两拍各做一次 17×16 / 16×16 乘法，
    //        再按位权拼起来 ⇒ 每次乘法只占 1 个 DSP，路径短得多。
    //   step_mag = (hi·r)>>7 + (lo·r)>>24      （由 mag = hi·2^17 + lo 推出）
    reg  signed [32:0] g_delta_r;
    reg               g_sign_r;
    reg  [16:0]       g_mag_lo_r;
    reg  [15:0]       g_mag_hi_r;
    reg  [15:0]       g_r_r;
    reg  [32:0]       g_plo_r;
    reg  [31:0]       g_phi_r;
    reg  signed [31:0] g_step_r;

    // ⚠️ f0_cur_ld 必须写在【装载寄存器声明之后】（ld_sel 在前面才声明）
    wire [31:0]        f0_cur_ld = v_f0_flat[ld_sel*32 +: 32];
    wire signed [32:0] g_delta_c = {1'b0, ld_f0} - {1'b0, f0_cur_ld};
    wire [32:0] g_mag_c    = g_delta_c[32] ? (~g_delta_c + 33'sd1) : g_delta_c;
    wire [32:0] g_plo_n    = g_mag_lo_r * g_r_r;        // 17×16 → 33 bit
    wire [31:0] g_phi_n    = g_mag_hi_r * g_r_r;        // 16×16 → 32 bit
    wire [26:0] g_step_mag = {2'd0, g_phi_r[31:7]} + {18'd0, g_plo_r[32:24]};
    // ⚠️ 位选必须与源等宽或更窄：写 g_step_mag[31:0] 会越界，越界位按 x 读入
    //    （本项目在 uni_calc 上就栽过一次，直接导致 mix_out 全程 X）。
    wire [31:0] g_step_mag32 = {5'd0, g_step_mag};
    wire signed [31:0] g_step_n = g_sign_r ? (-g_step_mag32) : g_step_mag32;

    always @(posedge clk) begin
        if (!rst_n) begin
            g_delta_r  <= 33'sd0;
            g_sign_r   <= 1'b0;
            g_mag_lo_r <= 17'd0;
            g_mag_hi_r <= 16'd0;
            g_r_r      <= 16'd0;
            g_plo_r    <= 33'd0;
            g_phi_r    <= 32'd0;
            g_step_r   <= 32'sd0;
        end else begin
            // 第 0 拍：先把 Q24 倒数锁存（它只跟 glide_time 有关，与音符无关）
            if ((ld_st == L_IDLE) && note_on && !ld_busy)
                g_r_r      <= glide_recip_bus;

            // 第 1 拍（第 0 个泛音的 L_CALC）：此时 ld_f0 / ld_sel 才【刚被 L_IDLE 写入】，
            //   读到的才是本次音符的值。
            //   ⚠️ 千万别在 L_IDLE 那一拍算 delta：非阻塞赋值意味着那时 ld_f0/ld_sel
            //      还是【上一个音符】的值 ⇒ delta=0 ⇒ step=0 ⇒ 滑音变成"瞬间跳变"。
            //      （本项目实测症状：T9 第一个窗口就是 880 Hz。）
            if ((ld_st == L_CALC) && (ld_idx == 3'd0)) begin
                g_delta_r  <= g_delta_c;
                g_sign_r   <= g_delta_c[32];
                g_mag_lo_r <= g_mag_c[16:0];
                g_mag_hi_r <= g_mag_c[32:17];
            end
            // 第 2 拍（第 0 个泛音的 L_MUL）：两次小乘法并行
            if ((ld_st == L_MUL) && (ld_idx == 3'd0)) begin
                g_plo_r <= g_plo_n;
                g_phi_r <= g_phi_n;
            end
            // 第 3 拍（第 1 个泛音的 L_CALC）：拼出 step（远早于 L_DONE）
            if ((ld_st == L_CALC) && (ld_idx == 3'd1))
                g_step_r <= g_step_n;
        end
    end

    always @(posedge clk) begin
        if (!rst_n) begin
            last_voice <= {SEL_W{1'b0}};
            last_valid <= 1'b0;
        end else if (note_on && !ld_busy) begin
            last_voice <= alloc_sel;
            last_valid <= 1'b1;
        end
    end

    // ================= A 路线：二胡 5 档 band_ld（2026-10-06）=================
    //   由 on_note 派生（装载期用，慢变量）；档 0 = D4 及更低（【外推，无实测支撑】）
    //   ⚠️ 钢琴/吉他 ROM 只有 band0 行 ⇒ 必须强制 band=0，否则查到 default ⇒ 静音/垃圾
    wire [2:0] band_ld = (on_note >= 7'd73) ? 3'd4 :
                         (on_note >= 7'd71) ? 3'd3 :
                         (on_note >= 7'd67) ? 3'd2 :
                         (on_note >= 7'd64) ? 3'd1 : 3'd0;
    //   NOTE: band_ld_eff MUST be registered. It combinationally depends on
    //         inst_ok (= derived from inst_sel), and wiring it straight into the
    //         case re-introduces the long inst_sel path (measured: 498 violated
    //         endpoints / -0.536 ns). Same lesson as drv_on_r: any signal from
    //         inst_sel must be registered before it reaches a voice or a LUT.
    reg  [2:0] band_ld_eff;
    always @(posedge clk) begin
        if (!rst_n) band_ld_eff <= 3'd0;
        else        band_ld_eff <= (inst_ok == 2'd2) ? band_ld : 3'd0;
    end

    piano_partial_lut u_ld_lut (
        .n       (ld_idx),
        .band    (band_ld_eff),
        .inst    (inst_ok),           // ★ 多乐器：装载期查表（此处本就是运行时索引，免费）
        .amp_q16 (pl_amp),
        .k_q12   (pl_k),
        .s_ring  (pl_sr),
        .s_damp  (pl_sd),
        .st1     (pl_st1),
        .st2     (pl_st2)
    );

    // ★ 乘积必须在【全宽网络】上形成再移位（本项目踩过"32 位装不下 44 位乘积、
    //   高位被截断成噪声"的大坑）。这里的做法是：声明的线网位宽 >= 操作数位宽之和，
    //   使 Verilog 的上下文宽度足以容纳完整乘积，不做二次截断。
    wire [33:0] ld_gmul   = pl_amp * ld_velgain;   // 17×17 → 34 bit
    wire [16:0] ld_g      = ld_gmul[33:16];        // /65536 ⇒ Q16 幅度
    // ★★ 明亮度必须真的受力度控制 ★★
    //   K 是"最强奏时"的系数（Q12），实际系数 = K × vel/128。
    //   本项目实测教训：第一版直接把 K 当成系数（漏了 ×vel），结果
    //   env = g·(1+K/4096) 里 g 与 K 项同时正比于力度 ⇒ 泛音比例与力度无关，
    //   FFT 实测 vel30 / vel120 的"高次泛音/基频"比完全相同（差 0.01 dB），
    //   即"力度只改变音量、不改变音色"。修好后才是"力度越大越亮"。
    //   ⚠️ 乘法要先在全宽网络里形成：K(16bit) × vel(7bit) = 23bit，
    //      若直接写 (pl_k * ld_vel) >> 7 会按 16 位上下文截断。
    wire [21:0] kvel_prod = pl_k * {15'd0, ld_vel};
    wire [15:0] kvel_q12  = kvel_prod[21:7];       // K × vel / 128
    wire [32:0] ld_bmul   = ld_gq * ld_kq;         // 17×16 → 33 bit（明亮度）
    wire [18:0] ld_envsum = {2'b0, ld_gq} + ld_bmul[30:12];  // ×(1 + K·vel/(128·4096))

    // 非谐性拉伸：inc = n·f0 + (f0>>st1) + (f0>>st2)
    //   用移位加法近似 n·sqrt(1+B·n²)，B=0.0004，误差 < 0.07%（见生成脚本自检）
    //   33 bit 中间宽度：note 127 时 6×f0 ≈ 3.3e9 < 2^32，不会溢出
    reg  [32:0] ld_f0e;
    reg  [2:0]  ld_n;
    always @(*) begin
        ld_n   = ld_idx + 3'd1;
        ld_f0e = {1'b0, ld_f0};
    end

    wire [32:0] ld_nf0 = (ld_n == 3'd1) ?  ld_f0e                    :
                         (ld_n == 3'd2) ? (ld_f0e << 1)              :
                         (ld_n == 3'd3) ? ((ld_f0e << 1) + ld_f0e)   :
                         (ld_n == 3'd4) ? (ld_f0e << 2)              :
                         (ld_n == 3'd5) ? ((ld_f0e << 2) + ld_f0e)   :
                                          ((ld_f0e << 2) + (ld_f0e << 1));
    // [OPT-2B] Split `u_ld_lut -> barrel_shifter -> ld_inc_bus` across L_CALC and L_MUL (0 extra FSM cycles!)
    reg  [32:0] ld_nf0_r;
    reg  [4:0]  pl_st1_r, pl_st2_r;
    wire [32:0] ld_inc_p1 = ld_nf0_r
                          + (ld_f0e >> pl_st1_r)
                          + (ld_f0e >> pl_st2_r);

    // 装载总线 → 平坦向量（Verilog-2001 不支持数组端口，故展平）
    wire [N_PART*17-1:0] ld_env_flat;
    wire [N_PART*32-1:0] ld_inc_flat;
    genvar g2;
    generate
    for (g2 = 0; g2 < N_PART; g2 = g2 + 1) begin : g_flat
        assign ld_env_flat[g2*17 +: 17] = ld_env_bus[g2];
        assign ld_inc_flat[g2*32 +: 32] = ld_inc_bus[g2];
    end
    endgenerate

    // 装载 FSM 的复位循环变量（模块级声明；分配器里的同名变量已在 generate 内改名 sai）
    integer ai;

    always @(posedge clk) begin
        if (!rst_n) begin
            ld_st      <= L_IDLE;
            ld_idx     <= 3'd0;
            ld_busy    <= 1'b0;
            ld_stb     <= 1'b0;
            ld_sel     <= {SEL_W{1'b0}};
            ld_f0      <= 32'd0;
            ld_velgain <= 17'd0;
            ld_vel     <= 7'd0;
            ld_gq      <= 17'd0;
            ld_kq      <= 16'd0;
            ld_nf0_r   <= 33'd0;
            pl_st1_r   <= 5'd31;
            pl_st2_r   <= 5'd31;
            for (ai = 0; ai < N_PART; ai = ai + 1) begin
                ld_env_bus[ai] <= 17'd0;
                ld_inc_bus[ai] <= 32'd0;
            end
        end else begin
            ld_stb <= 1'b0;
            case (ld_st)
                L_IDLE: begin
                    if (note_on && !ld_busy) begin
                        ld_f0      <= f0_bus;
                        ld_velgain <= vel_gain_bus;
                        ld_vel     <= on_vel;          // ★ 明亮度要用到力度
                        ld_sel     <= alloc_sel;
                        ld_idx     <= 3'd0;
                        ld_busy    <= 1'b1;
                        ld_st      <= L_CALC;
                    end
                end
                L_CALC: begin
                    ld_gq    <= ld_g;
                    ld_kq    <= kvel_q12;              // ★ K × vel / 128
                    ld_nf0_r <= ld_nf0;                // [OPT-2B] Stage 1: latch nf0 & shift amounts
                    pl_st1_r <= pl_st1;
                    pl_st2_r <= pl_st2;
                    ld_st    <= L_MUL;
                end
                L_MUL: begin
                    ld_inc_bus[ld_idx] <= ld_inc_p1[31:0]; // [OPT-2B] Stage 2: evaluate shift-add in L_MUL
                    ld_env_bus[ld_idx] <= (ld_envsum > 19'd65536) ? 17'd65536
                                                                 : ld_envsum[16:0];
                    if (ld_idx == N_PART[2:0] - 3'd1) begin
                        ld_st <= L_DONE;
                    end else begin
                        ld_idx <= ld_idx + 3'd1;
                        ld_st  <= L_CALC;
                    end
                end
                L_DONE: begin
                    ld_stb  <= 1'b1;          // 6 个包络/增量同时有效
                    ld_busy <= 1'b0;
                    ld_st   <= L_IDLE;
                end
                default: ld_st <= L_IDLE;
            endcase
        end
    end

    // 轮转指针推进
    always @(posedge clk) begin
        if (!rst_n) rr <= {SEL_W{1'b0}};
        else if (note_on && !ld_busy) begin
            if (alloc_sel == N_VOICES[SEL_W-1:0] - 1'b1) rr <= {SEL_W{1'b0}};
            else                                          rr <= alloc_sel + 1'b1;
        end
    end

    // 被选声部收到 note-on 脉冲（与装载完成脉冲 ld_stb 分开）
    wire [N_VOICES-1:0] on_pulse_sel;
    genvar gp;
    generate
    for (gp = 0; gp < N_VOICES; gp = gp + 1) begin : g_sel
        // ★ 一热分配（2026-10-06）：直接用一热位做 AND，省掉原来 `alloc_sel == gp`
        //   那一级 4 bit 相等比较（实测最差路径 20.034 ns / slack −0.296 ns）。
        assign on_pulse_sel[gp] = note_on & ~ld_busy & alloc_oh[gp];
    end
    endgenerate

    // ------------------------------------------------- 包络降速计数器 --------
    reg [DIV_W-1:0] div_cnt;
    always @(posedge clk) begin
        if (!rst_n)           div_cnt <= {DIV_W{1'b0}};
        else if (sample_tick) div_cnt <= div_cnt + 1'b1;
    end

    // -------------------------------------------------------- 8 个声部 -------
    wire [N_VOICES-1:0]   v_gate_w;
    wire [N_VOICES-1:0]   v_act_w;
    wire [7*N_VOICES-1:0] v_note_w;
    wire [32*N_VOICES-1:0] v_f0_w;

    genvar gv;
    generate
    for (gv = 0; gv < N_VOICES; gv = gv + 1) begin : g_voice
        wire signed [24:0] vo;
        wire               va, vg;
        wire [6:0]         vn;
        wire [31:0]        f0_w;

        piano_voice #(
            .N_PART        (N_PART),
            .PHASE_W       (PHASE_W),
            .ENV_W         (ENV_W),
            .DIV_W         (DIV_W),
            .HAM_SH        (HAM_SH),
            .HAM_GAIN_Q16  (HAM_GAIN_Q16),
            .ID            (gv),
            .USE_TDM_VOICE (USE_TDM_VOICE)
        ) u_voice (
            .clk          (clk),
            .rst_n        (rst_n),
            .sample_tick  (sample_tick),
            .div_cnt      (div_cnt),
            .on_pulse     (on_pulse_sel[gv]),
            .on_note      (on_note),
            .on_velgain   (vel_gain_bus),
            .on_lpsh      (vel_lp_bus),
            // ★ 阶段1b 多乐器：引擎内部连接（不涉及 top.v 端口表）
            .on_ham_gain  (inst_ham_gain),
            .on_ksh_ofs   (inst_ksh_enc),
            .on_pluck_fast(inst_ok == 2'd1),   // 只有电吉他加速激励衰减
            .bow_speed    (bow_speed),         // ★ CC21 弓速
            .drv_on       (inst_ok == 2'd2),   // ★ 只有二胡持续供能 ⇒ 钢琴/吉他逐值不变

            .on_beat      (beat_bus),
            .ld_for_me    (ld_stb & (ld_sel == gv[SEL_W-1:0])),
            .ld_env_flat  (ld_env_flat),
            .ld_inc_flat  (ld_inc_flat),
            .ld_f0        (ld_f0),            // 新音符基频（滑音目标）
            .ld_gstep     (g_step_r),         // 滑音每采样点步进
            .off_pulse    (off_any),
            .off_note     (off_any_note),
            // ---- 表情 ----
            .glide_act    (glide_act),
            .vib_act      (vib_act),
            .vib_inc      (vib_inc_bus),
            .vib_depth_k  (vib_depth_k),
            .sustain      (sustain),
            .sus_fall     (sus_fall),
            .f0_out       (f0_w),
            .vout         (vo),
            .active       (va),
            .gate_out     (vg),
            .note_out     (vn)
        );

        assign v_out[gv]           = vo;
        assign v_act_w[gv]         = va;
        assign v_gate_w[gv]        = vg;
        assign v_note_w[gv*7 +: 7] = vn;
        assign v_f0_w[gv*32 +: 32] = f0_w;
    end
    endgenerate

    assign active      = v_act_w;
    assign v_active    = v_act_w;
    assign v_gate      = v_gate_w;
    assign v_note_flat = v_note_w;
    assign v_f0_flat   = v_f0_w;

    // --------------------------------------------------- 混音 + 软膝限幅 ----
    // ★ 只累加【仍在发声】的声部：
    //   这是一个防御措施。若某个声部的数据通路出现 X（例如将来有人漏掉某个
    //   寄存器的复位），未发声声部的 X 会被累进 mix_out，把整条输出永久污染成 X
    //   —— 本项目被 flow-verifier 独立验证抓到过一次（active 位图正常、波形全 X）。
    //   被排除的声部其电平已低于 -48 dB（active 判定），丢掉不影响听感。
    reg signed [27:0] vsum;
    integer vi;
    always @(*) begin
        vsum = 28'sd0;
        for (vi = 0; vi < N_VOICES; vi = vi + 1)
            vsum = vsum + (v_active[vi] ? v_out[vi] : 25'sd0);
    end

    // 🔴 输出级改动【已撤销】（2026-10-06，构建实测 404 违例 / 最差裕量 −4.71 ns）
    //
    // 🔴 输出级改动【第二次撤销】（2026-10-06）：754 违例 / −4.919 ns
    //
    // 本轮 `.tr`（`evidence/fpga_hank_MODE1_outsweep_754v.tr.txt`）Top 25 给出两类路径：
    //   ① `env_..._s0` → `mix_out_*_s0`  −4.919 ns（15 条）
    //      ⇒ 这是输出链的【输入侧】：包络寄存器 → 8 声部求和 → 增益/膝/阻断 → mix_out
    //   ② `u_midi/on_note_3_s0` → `ph_ph_.../CE`  −4.557 ns（10 条）
    //      ⇒ 就是之前那条 −0.296 ns 的分配器路径，**恶化到 −4.557**
    //
    // ⚠️ 结论修正（我上一条的说法不准确）：
    //    · **HP 递归不在 Top 上** ⇒ "递归包住求和树"不是主因 ✗
    //    · 真因是【我在这条已经临界（基准仅 +0.043 ns）的输出链上又串了几级】
    //      （增益 mux + 阻断 + 膝 mux）⇒ 把它推过界 ✗
    //    · `on_note → ph` 的恶化**不可能**由输出级逻辑造成（两者无逻辑关联）
    //      ⇒ 最可能是 **P&R/布局副作用**（新增 ~90 FF + mux 使该路径走线变差）
    //      ⇒ 判别方法：比对两版 `.tr` 中该路径的 **Logic Levels 与 cell/route 占比**
    //        （级数相同而 route 涨 ⇒ 是布局，不是逻辑）
    //
    // ⚠️ 另一条永久教训（Lead 指出、我认同）：
    //    **`sample_tick` 是【时钟使能 CE】，不是【慢时钟】** ⇒
    //    带 CE 的 always 块里组合逻辑仍须在【一个时钟】内收敛；
    //    "512 拍余量"是错觉，除非显式写多周期约束。
    //    （本项目同型三次：`env_en`→1536 个 CE / `ph/CE` / 本次）
    //
    // ⚠️ 而且对 `env → mix_out` **不能**用多周期约束：
    //    `env` 并不是 512 拍才更新一次（它在 sample_tick 之上还受 env_en 门控，但**输出链每采样点都要算**），
    //    且 `mix_out` 是在 `vld[2]` 捕获 —— 数据到达与捕获之间**只隔 1 个时钟**，不是 512。
    //    ⇒ 放松成多周期会【掩盖真实违例】✗
    //
    // ⇒ 正解只能是【真流水线】（用真实寄存器把链切开），且它必须回答一个产品问题：
    //    **钢琴能不能接受 +1 采样点（10.24 µs）的固定群延迟？**（见 _research/piano 记录）
    // ★★ 真流水线（2026-10-06，Lead 批准）：把输出链切成 3 段，代价 **+2 个时钟 = 40 ns**
    //
    // 为什么能修（`.tr` 给的证据）：最差路径的【起点是 `env`】——
    //   因为混音器逐声部门控 `vsum = Σ(v_active[vi] ? v_out[vi] : 0)`，
    //   而 `v_active` 是 `env` 组合派生的 ⇒ 整条链被包络顶着：
    //     `env → v_active → mux → 8 路求和树 → 增益/膝 → mix_out` = 28 级 / −4.919 ns ✗
    //   ⇒ 正解是【把链切开】，不是"去掉某一段" ✓
    //
    // 三段：
    //   段① `env → v_active → mux → 求和树`                       → 寄存器 `vsum_q`
    //   段② `vsum_q → 增益 mux → 取绝对值 → 软膝 → 符号`            → 寄存器 `magl_q`
    //   段③ `magl_q → 削顶比较 → mix_out`                          （用已有 mix_out 寄存器）
    //
    // ⚠️ 语义零改动：单级流水只是【在组合链中间插寄存器】，不改任何逻辑
    //   ⇒ 输出 = 原信号【平移 2 个时钟（40 ns）】⇒ 回归判据 = "去掉该固定偏移后逐字节一致" ✓
    // ⚠️ 为什么是"2 个时钟"而不是"1 个采样点"：这两级是**时钟级**流水（每拍都刷新、不加 CE）
    //   ⇒ 代价 2×20 ns = **40 ns**，比 Lead 批准的 10.24 µs 小 256 倍 ✓
    // ⚠️ `mix_out` 的有效位从 `vld[2]` 挪到 `vld[4]`（+2 拍）—— 必须同时改，否则整体错位 ✗
    reg signed [27:0] vsum_q;
    always @(posedge clk) begin
        if (!rst_n) vsum_q <= 28'sd0;
        else        vsum_q <= vsum;                       // 段①→② 的界
    end

    // 增益重平衡（门控非钢琴：钢琴数值逐位不变）：-6 dB
    //   实测依据（outsweep TB，8 音和弦）：吉他/二胡 32.37%/39.90% 采样点进软膝、峰值触硬削 32768；
    //   −6 dB 后 7.90%/11.70%，硬削消失 ✓
    // [OPT-5] Dynamic Polyphonic Headroom when N_VOICES > 8 (keeps N_VOICES<=8 100% bit-identical)
    integer ac_i;
    reg [5:0] act_cnt_c, act_cnt_q;
    always @(*) begin
        act_cnt_c = 6'd0;
        for (ac_i = 0; ac_i < N_VOICES; ac_i = ac_i + 1)
            act_cnt_c = act_cnt_c + {5'd0, v_active[ac_i]};
    end
    always @(posedge clk) begin
        if (!rst_n) act_cnt_q <= 6'd0;
        else        act_cnt_q <= act_cnt_c;
    end
    wire [1:0] poly_extra_sh = (N_VOICES <= 8)       ? 2'd0 :
                               (act_cnt_q <= 6'd8)   ? 2'd0 :
                               (act_cnt_q <= 6'd16)  ? 2'd1 : 2'd2;
    wire signed [27:0] norm_old = vsum_q >>> (OUT_SHIFT + poly_extra_sh);
    wire signed [27:0] norm_new = vsum_q >>> (OUT_SHIFT + 1 + poly_extra_sh);
    wire signed [27:0] norm = (inst_ok != 2'd0) ? norm_new : norm_old;

    // ★★ 琴体共振曲线（二胡专用；门控 inst_sel==2 ⇒ 钢琴/吉他【完全旁路】⇒ 逐值不变）
    //   实测（专业《赛马》）：**550 Hz +34.6 dB（宽的低 Q 隆起）**、1635 / 2970 / 5360 Hz 次峰
    //   落地 = 4 级 peaking biquad，Q14 定点。**已与浮点比对：最大误差 0.176 dB、平均 0.016 dB**
    //   ⚠️ 位置：紧接增益、在软膝【之前】 ⇒ 顺带把 `vsum_q → magl_q` 那条 −1.499 长链
    //      切成 5 段（每段 1 乘积组 + 2 加）✓
    //   ⚠️ 位宽链（本项目栽过"32 bit 装不下乘积"⇒ 显式给宽）：
    //      x = 16 bit（低 16 位就是音频域）⇒ 16×16 = 32 bit 乘积 ⇒ 5 项累加 ⇒ **36 bit 累加器**
    //      ⇒ >>>14（常量）⇒ 限幅 ±32767 ⇒ 下一级 16 bit ✓
    //   ⚠️ 每级【一拍】（时钟级流水）⇒ 门控路径 +4 拍 = 80 ns；**钢琴路径一拍不动** ✓
    //   ⚠️ 系数常量 ⇒ 无变量移位 ⇒ 不会像上次那样长出多余桶形移位器（+8833 LUT）✓
    // 🔴 曲线【再次旁路】（2026-10-06）：按采样率门控后**仍然** 99.17%（应 ~1%）✗
    //   ⇒ 说明"更新率"不是（唯一）根因 ⇒ 滤波器还有**未定位的实现错误** ✗
    //   ⇒ 在定位清楚之前保持旁路，**绝不交给构建**（否则=全时软削波 ⇒ "更电子" ✗✗）
    //   ⚠️ 待查清单（下一轮逐条验证）：
    //     ① 输入切片：`norm[15:0]` 是否真的等于音频域（还是被截断/含直流）？
    //     ② 反馈符号/结构：`- a1·y1 - a2·y2` 的定点符号是否与浮点设计一致？
    //     ③ 每级 `>>>14` 后 `sat16` 是否把中间级顶到饱和（级联后放大）？
    //     ④ 用**逐级 dump** 逐个比对浮点参考（而不是只看最终膝触发）✗
    wire signed [27:0] norm_f = norm;

    // 软膝限幅：|x| <= KNEE 完全线性；膝上斜率门控（钢琴 1/4 原样；非钢琴 3/8）
    wire signed [27:0] mag  = norm_f[27] ? (-norm_f) : norm_f;
    wire signed [27:0] magl_old = (mag > KNEE) ? (KNEE + ((mag - KNEE) >>> 2)) : mag;
    wire signed [27:0] magl_new = (mag > KNEE) ? (KNEE + ((3 * (mag - KNEE)) >>> 3)) : mag;
    wire signed [27:0] magl = (inst_ok != 2'd0) ? magl_new : magl_old;

    // 段②→③ 的界：把"幅度 + 符号"一起寄存（符号必须跟着走，否则负半周会被翻正 ✗）
    reg signed [27:0] magl_q;
    reg               sign_q;
    always @(posedge clk) begin
        if (!rst_n) begin
            magl_q <= 28'sd0;
            sign_q <= 1'b0;
        end else begin
            magl_q <= magl;
            sign_q <= norm_f[27];
        end
    end
    wire signed [27:0] lim = sign_q ? (-magl_q) : magl_q;

    // 输出流水有效标记：钢琴/吉他/二胡统一 = vld[4]
    //   ⚠️ 曾有 `fvld` 链把二胡的有效位推迟 6 个采样点（为 6 级 IIR）——
    //      IIR 已弃用 ⇒ 必须删掉，否则二胡会读到【6 个采样点之前】的值（错样本）✗
    reg [11:0] vld;
    always @(posedge clk) begin
        if (!rst_n) vld <= 12'd0;
        else        vld <= {vld[10:0], sample_tick};
    end
    wire lim_vld = (USE_TDM_VOICE != 0) ? vld[10] : vld[4];

    always @(posedge clk) begin
        if (!rst_n) begin
            mix_out <= 16'sd0;
        end else if (lim_vld) begin
            if (lim > 28'sd32767)       mix_out <= 16'sd32767;
            else if (lim < -28'sd32768) mix_out <= -16'sd32768;
            else                        mix_out <= lim[15:0];
        end
    end

endmodule
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
