wongben2333-crypto/26Embedded/fpga_hank/rtl/synth/tone_bank.v

// =============================================================================
//  tone_bank.v —— 32 路逐样本并行正弦振荡器组（测试模式音源）
//
//  ⚠️ 本文件由 tools/gen/gen_tone_bank.py 生成，请勿手工编辑。
//     频率字按【实际采样率】97656.250 Hz 折算，不是按标称 48000。
//
//  用途：赛题【必备交付物】"测试模式" —— 同时输出 32 路均匀分布的不同频率，
//        接声卡/示波器做 FFT 后必须能数出 32 个独立谱峰。
//        取证工具：tools/verify/check_peaks.py（--selftest 已在本机实测 PASS）
//        完整取证流程：_research/fpga-tools/SPECTRUM-VERIFY.md
//
//  ---------------------------------------------------------------------------
//  ★ 架构：为什么这样写才能被认定为 32 个独立振荡器
//
//    赛题：一个"振荡器"必须同时具备
//       (1) 独立相位累加器   (2) 频率调控   (3) 包络控制
//    且"单个波表采样查表不计多谐波数量，仅计单个振荡器"。
//
//    本模块对应关系（报告中要画这个框图，让评委一眼数得出来）：
//       (1) 独立相位累加器：acc[0..31]，32 个独立 32 bit 寄存器
//       (2) 频率调控：freq_word(v) 每路独立频率字，可运行中改写
//       (3) 包络控制：测试模式恒定幅度；演奏模式由 adsr 逐路提供（后续接入）
//
//    每个采样周期（预算 512 clk，实际只用 32+2）：
//       samp_cnt = 0      : 32 路相位累加器并行更新；地址 MUX 指向第 0 路
//       samp_cnt = 1..32 : 每拍地址 MUX 推进一路，rom_val 逐个返回并累加
//       samp_cnt = 32    : 第 31 路的 rom_val 返回，累加完成
//       samp_cnt = 32    : 饱和限幅 + 预缩放 → mix_out
//
//    流水线对齐：rom_addr 在第 k 拍给出第 k 路地址，rom_val 在第 k+1 拍返回，
//    因此累加动作发生在 samp_cnt=1..32，与 samp_cnt-1 路对应。
//
//    ★ 绝不能让 32 路"每采样点只输出其中一路"轮流发声 ——
//      会产生 fs/32 = 3052 Hz 扫描边带，明显杂音。
//
//  ---------------------------------------------------------------------------
//  资源估算
//     相位累加器  32 × 32 bit = 1024 FF
//     加法器      32 × 32 bit（可推断 DSP）
//     sine_rom    256 × 16 bit 分布式 ROM ≈ 256 LUT
//     + 饱和累加器与 MUX
//     相对 138240 LUT / 139095 FF 很宽裕
// =============================================================================
`default_nettype none
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
