wongben2333-crypto/26Embedded/(commit log)

2026-09-30 初始提交：高云选题二「实时多音色合成电子乐器引擎」
    - 选题文档与选型分析（题目/）
    - Python 黄金参考模型 synthsim/：DDS、波表、ADSR、复音分配、混音、效果器、
    定点位宽 / 资源 / 延迟分析、RTL 参数导出
    - 集成脚本 scripts/run_all.py 与《前期算法模拟-完整说明》
    - 实时音色演示 scripts/realtime_demo.py（管风琴 / 八音盒 / 电钢琴）
    - VS Code 解释器配置
2026-09-30 feat: 实现基于 Tang Mega 60K 的 FPGA 实时多音色合成电子乐器硬件工程及音频验证
2026-09-30 refactor: 架构完全物理隔离：划分 fpga_spark (硬件工程) 与 fpga_ben (算法模型) 双独立工作区
2026-09-30 docs: 在根目录 README 中明确团队分工与队友 Ben 的工作范围与协作规范
2026-09-30 docs: 在 README 中明确团队各自独立探索原则及工作区范围说明
2026-09-30 feat(spark): 基于 Karplus-Strong 纯硬件物理建模生成《Faded》吉他指弹演奏音频
2026-10-02 feat(fpga_hank): 新增第三个独立工作区 fpga_hank（32 复音引擎 + 团队资料包）
    与 fpga_ben/、fpga_spark/ 平级，不修改任何队友目录（.agents/rules/workspace_isolation.md 合规）。
    内容：
    - rtl/ 全 HDL 合成引擎（top / pt8211_tx / adsr / tone_bank / wave_rom / sine_rom / bench_gate / touch_pad / smoke_top）
    - constr/ 引脚与时序约束（fpga_hank.cst/.sdc、smoke.cst/.sdc）
    - sim/ ModelSim testbench 与运行脚本（含 tb_spectrum、tb_wave、tb_pitch_fft 等）
    - tools/ Gowin 命令行构建（build.tcl / build_smoke.tcl）、生成器与验证脚本（check_peaks / check_pitch / gen_waveforms）
    - docs/ 验证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
2026-10-02 refactor(fpga_hank): 用当前成果整体刷新工作区，补齐 skills 与上板指南
    【背景】
    `fpga_hank/` 此前是 10-03 之前的旧快照，与源工作区已经脱节：
    · 仍含 `rtl/io/touch_pad.v`、`rtl/synth/sine_rom.v`（已移到 not_integrated/）
    · 缺 `sim/tb/tb_interaction.v`（交互通路验证）、`tools/verify/check_pitch_shift.py`、
    `tools/gowin/program.ps1`（烧录）、`tools/verify/run_acceptance.ps1`（一键验收）
    · 缺 `docs/上电操作卡-正式交付.md`、`docs/预先构建的位流.md`
    · `docs/waveforms/real/2_ADSR_起音与释放.png` 已被拆成两张新图
    本次按源工作区的当前状态**整体刷新**，并补上 skill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
2026-10-05 docs(fpga_hank): 新增《Tang Mega 138K 保姆级上手指南》（Word）+ 生成器
    【为什么加】
    用户（队伍负责人）本身不熟悉 FPGA，此前的《上电操作卡》和《上板验证指南》
    都假设读者已经懂工具链。这份是**真正从零开始**的教程：
    假设读者"从没用过 FPGA、不知道什么叫位流、也没烧过板子"。
    【文档结构：8 章 + 3 附录，12 张表格，47 KB，A4】
    写在前面：假设你什么都不会（含诚实边界声明）
    第一章 先认识这块板子 —— FPGA 一句话解释 / 关键参数 / 板子上要认识的 8 个地方
    第二章 接线与开机（最容易翻车的一步）—— 接线 4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
2026-10-05 feat(fpga_hank): 同步最新成果 —— 钢琴引擎/歌曲播放/串口MIDI/硬件效果器/电脑端
    一次提交，把 fpga_hank 从"只有 32 路正弦测试"推进到"三模式完整电子乐器"。
    全部功能均已在真板上运行过（下方附 User Code 指纹）。
    ═══ 一、新增功能（真板已验证）═══
    【MODE=0 演示模式】按键放歌
    · rtl/synth/song_player.v 播放器 FSM：按键1 播放/停止（边沿触发）、按键2 切歌、
    单曲循环、停止时发 all-notes-off（无挂音）
    · rtl/synth/song_rom.v 5 首曲目 / 220 音符，只存【音符编号+时值】，无 PCM
    · tools/gen/gen_song_r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
2026-10-06 fpga_hank: 2026-10-06 整合 —— 运行期模式切换 + 二胡音色攻坚
    功能（已上板, 位流 MODE1_二胡H4校准.fs, 0 违例 / +0.04 ns）:
    * 运行期模式切换: key2 进出曲目模式, key1 换乐器, 上电默认自由演奏
    * 三道清音: song_player 强制停止(128 拍全关) + reset_all 一拍 + 5ms 静音窗
    * song_rom: 5 首（含《我落泪情绪零碎》副歌 m.29-31, 版权未获授权已如实标注）
    * song_player: 新增 key_pause / run_en / paused（四态 FSM）
    * 吉他: 变调夹 F7/F8, 大横按 F9/F10/F11, 拍弦 F4, 扫弦 25-80ms（默认 36ms 依实测）
    * 二胡: drive（持续激励）+ 5 档谐波权重表 f(音高档,泛音) + H4 校准
    *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
2026-10-08 feat(spark): 增加电脑键盘实时钢琴模拟器 GUI 工具，支持双手机位实时弹奏与示波器显示
2026-10-08 refactor(fpga_spark): 整理音频输出至临时音频目录，添加电脑钢琴GUI启动器
2026-10-10 feat(docs): 补充 Tang Mega 60K/138K 硬件资料与 7 寸 TFT LCD 模块资料
2026-10-10 tools(spark): 添加维基资料提取脚本
2026-10-10 tools(spark): 添加管脚约束对比与硬件文件索引工具
2026-10-17 chore: .gitignore 用 **/sim/out/ 覆盖嵌套仿真产物目录
2026-10-17 test(fpga_ben): 新增赛题定向验证脚本与模型证据对照表
2026-10-17 docs(fpga_ben): 新增交互与传感器硬件方案规划书 v1.1 (docx/pdf)
2026-10-17 docs(fpga_spark): 新增 60K 原理图资源梳理与引脚核对（含 .cst 勘误）
2026-10-23 feat(fpga_hardware): 新增硬件乐器 S5 分支（MODE=3：13键/光电/ToF/EC11 -> 8声部引擎）
    - rtl：fpga_hank/rtl 整份副本，仅 top.v（MODE=3 通路）与 io/ 有改动
    - 新增 io/hw_input_mgr.v：19 路去抖、EC11 正交、ToF 5 点中值+迟滞+限速、16 深 FIFO、>=16clk 串行化、P19 遥测；EC11 音量 dB LUT
    - 实测：Setup +0.033 / Hold +0.136，DSP 79/118；13 键 C4..C5、8 键和弦+第 9 键抢占、E2、ToF 分段滑升、上电 20 次无随机发声、MODE=1 回归 440Hz 均通过
    - 注意：I2C 固定走 J13-24/25（J8 与音频同属 BANK7 会串扰）；ToF 不用引擎滑音
2026-10-24 feat(spark): 提交 P34-P40转接板设计、7寸LCD测试工程及硬件规划文档
2026-10-26 feat(spark): 完成 P34-P40转接板PCB与Gerber设计，重构LCD测试工程支持J13/J14双接口
2026-10-26 chore(spark): 归档最新屏幕回读截图验证日志
2026-10-27 feat(spark): 实现 J14 7寸屏四页乐器仪表 UI 驱动与音频模块集成，完成实机回读验证
2026-10-29 feat(spark): 优化合成器音频动态与示波器引擎，新增上位机交互控制台及自动曲谱时间轴
    - 音频与合成器核心：优化多声部动态裕量与软膝限幅，杜绝破音；新增纯硬件主音量调节与全复位静音；增强半音琴键发声状态检测
    - 示波器与动态渲染：重构 Page 0 / Page 1 双缓冲 3 秒动态波形包络渲染引擎，支持双向无撕裂滚动
    - 自动演奏与乐谱联动：song_player 支持精确分秒计时、百分比进度与音符平滑滚动显示，引入 gen_song_notes.vh
    - 上位机与调试工具：新增 fpga_synth_host.py 智能上位机控制台（支持虚拟琴键、和弦、DSP调节与曲目演示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
2026-11-01 feat(fpga_hardware): 收口硬件方案、PCB 制造包与两件式外壳
    - 文档主线收敛为 HARDWARE-DESIGN-SPEC / BREADBOARD-BRINGUP / PCB-DESIGN /
    ENCLOSURE-DESIGN / MANUFACTURING-AND-ACCEPTANCE；旧交接、输入接线与
    Gerber R1–R5 审查移入 docs/archive/（内容未删，随本提交重命名保留）。
    - 收入 PCB 制造依据：Gerber 包、板级 3D STEP、Telesis 网表与飞针网表，
    以及开关/光耦两份器件手册。
    - 新增 enclosure/ 参数化外壳：下壳、上盖、键床与 13 键帽。按 8.5×7.8×5.0
    开关、9.2×8.3 口袋、10.6×0.8 焊盘让位、97×49.5 键盘开口、剪脚后朝下
    排针重做；含 STEP/STL/3MF/DXF 与嘉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
2026-11-02 feat(fpga_hank): 交付最新验证成果：32复音TDM/97.6k音频/全套效果器/7寸示波器FFT大屏UI/GT911触控与README重构
2026-11-02 docs(fpga_hank): 定稿竞赛技术文档（Word版与Markdown版，严格对齐官方评审模板与去AI规范）
2026-11-02 feat(fpga_hank): 补齐学术写作、去AI化推敲、科技绘图与Word排版技能包（skills/）
2026-11-03 feat(spark): 集成4096点实测FFT与3秒无损滚动波形包络音频可视化引擎
    - 可视化核心：新增 rtl/visualizer 模块（audio_visualizer、fft4096、rolling_waveform），支持 4096 点 Hann 窗 FFT 与 32 对数频带分析
    - 波形渲染：实现 3 秒全幅对称实心动态包络，支持帧同步双缓冲无撕裂切换与冻结控制
    - 音频链路重构：DAC 采样帧保持寄存器锁定，消解视觉抖动与时序毛刺
    - 构建与测试：更新 build_j14/burn_lcd_j14，新增仿真回归脚本与数据表生成工具，重新生成并验证位流
2026-11-03 feat(spark): 优化合成器与UI资源占用以适配GW5AT-60B/138K，新增SDC时钟约束
    - 乐器合成与ADSR优化：adsr.v 引入状态保留+共享步进算术单元节省约2800 LUT；piano_engine.v 泛音流水线时分复用正弦ROM与乘法器，显著削减BSRAM与DSP占用
    - 动态显示与可视化优化：lcd_ui.v 重构为共享字符点阵渲染架构，大幅压缩组合逻辑与时序延迟；audio_visualizer.v 频带电平采用同步SDPB推断Block RAM
    - 算法与时序约束：song_player.v 采用定点乘法消除动态除法链；新增 lcd_test_j14.sdc 50MHz 时钟约束，并修正按键与复位 Bank 1.5V 电平约束
2026-11-03 feat(spark): 归档历史测试工程，全面升级为32复音TDM合成器与7寸屏触控系统（实机验证成功）
    - 历史工程归档：将原 Spark lcd_test 基础测试系统（含全部源码、约束、仿真波形与位流）完整封存至 fpga_spark/archive/，生成清单与备份
    - 32复音TDM合成架构：主工程全面升级为 32 复音 × 6 泛音（192 独立振荡器），支持钢琴/吉他/小提琴/二胡多乐器实时合成，97.656 kHz 采样率与 PT8211 双声道高清输出
    - 纯硬件音效链路：集成 Freeverb 混响、立体声合唱、乒乓延迟、过载失真及 4x12 箱体模拟效果器
    - 7寸屏与触控交互：支持 GT911/FT5206 硬件 I2C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
2026-11-03 docs(spark): 同步硬件故障排查与修复全链路记录，更新系统手册与文档架构
    - 硬件联调与闭环记录：新增 HARDWARE-BRINGUP-LOG-20261103.md，完整复盘自研 PCB 错焊电阻导致 ToF NACK 的排查过程、供电与线序拓扑差异及修复验证结果
    - 全局使用手册更新：USER_MANUAL.md 扩充常见故障排除章节，补充自研 PCB 3.3V 外部引入与双路 ToF 即插即用说明
    - 根目录文档对齐：更新 fpga_spark/README.md 与 lcd_test/README.md，对齐 13 琴键 + 6 光电弦 + ToF 特雷门琴 + 7寸大屏全模态乐器工作流与目录指引
2026-11-03 feat(spark): 完善GT911复位地址锁定与按键光电ToF多乐器硬件联动，实机验证通过
    - GT911电容触摸屏时序修复：重构 RST/INT 协同上电复位时序锁定 0x14 地址（tp_int 设为双向驱动），仅在 buffer_status 最高位有效时清零 0x814E，杜绝触控扫描死锁
    - 物理传感器与多乐器映射：13按键映射钢琴(0)、6路光电拨弦映射吉他(1)、双路 ToF 测距映射小提琴(2)，音符触发当拍零延迟切换音色
    - 旋钮与页面调度：4路 EC11 编码器分别映射滑音时间、颤音深度、主音量及屏幕双向切页
    - 合成引擎参数校准：调整颤音频率偏移位宽（>>>11），小提琴默认揉弦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
2026-11-04 feat(spark): 优化EC11编码器消抖滤波与示波频谱灵敏度，升级四页实机回读截屏工具
    - 物理旋钮与去抖优化：hw_input_mgr.v 引入 4 kHz 采样分频与 750 us 三采样一致性消抖，严格适配 PCB 硬件 RC 滤波，彻底消除 EC11 编码器抖动与跳变
    - 顶层协同与模式联动：top.v 互联 32 复音声部实时扫描总线至 UI 显示；实现曲目页面（Page 3）与自动放歌模式双向自动切换
    - 示波器与频谱增强：lcd_subsystem_j14.v 扩展 Page 0 动态包络高度至 ±130px，Page 1/3 动态放大 4.5 倍；spectrum_analyzer32.v 优化单端口 SDPB 块 RAM 阻尼衰减与谐波响应
    - 调试工具与实机截图：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
2026-11-04 docs(fpga_hank): 技术文档升级至 v7 —— 新增上位机章节 + 删除旋转编码器内容
    一、技术文档 v5 → v7（62 页 → 约 71 页，5.61 MB，MD5 DB34F954）
    1. 新增 2.10 上位机交互软件与多维表情控制系统（含 4 个三级小节）
    2.10.1 软硬分层边界与赛题红线合规性论证
    2.10.2 电脑键盘与鼠标点击的双通道演奏输入
    2.10.3 四维连续表情控制的 CC 映射与量化标定（力度/滑音/颤音/延音）
    2.10.4 吉他拟物化指板：六弦十二品按弦与上下扫弦
    2. 新增 3.8 上位机交互软件功能成果与演奏实测
    3. 新增 表 2-6 上位机交互软件 MIDI 控制映射与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
2026-11-04 docs(v8.1): 统一全仓库交付口径，新增技术文档 v8 与实机取证
    - 技术文档 v8：138K/MODE=3、TDM32 192 路、3 音色、6 光电+双 ToF、EC11 预留、PCB1 输入调理、2 ms/20.5 µs/3.85 µs、4 首公版曲目
    - 根 README 重写为规范仓库说明；主文档/使用手册/硬件文档统一 v8.1 口径
    - 新增 2026-11-04 实机屏显、整机、PCB、原理图与上位机截图；补齐 BOM/PCB/SCH 源文件
    - 历史文档加“不随 v8.1 维护”标记；清理 piano6/P34-P40/电容琴键/未授权曲目旧口径
2026-11-04 refactor: 规范化全仓库统一交付架构，整合三位成员成果并清除过程性文件
2026-11-04 docs(fpga_hank): 新增 2 ms 端到端延迟实测取证图
    Ultraworked with [Sisyphus](https://github.com/code-yeongyu/oh-my-openagent)
2026-11-04 docs(fpga_hank): 技术文档 v8.2 对齐模板并统一排版
    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
2026-11-04 docs(evidence): 归档 2 ms 延迟测试终端取证
    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
2026-11-04 docs(readme): 恢复团队自有 README 并适配统一目录
