wongben2333-crypto/26Embedded/(notices)

Notices in the files:
fpga_spark/【正点原子】7寸TFT LCD电容触摸屏模块V2 800480资料/【正点原子】7寸TFT LCD电容触摸屏模块V2 800480资料（新资料）/2，程序源码/ATK-MD0700模块测试实验（FMC&FSMC）/阿波罗STM32F429开发板/User/main.c:
@license Copyright (c) 2020-2032, ¹ãÖÝÊÐÐÇÒíµç×Ó¿Æ¼¼ÓÐÏÞ¹«Ë¾
